Kageyana/robotrace_v2/doc/path-yaw-feedforward-hardware.md

# 制御版20・旋回FF版2の実機反映

検証済みFF2を書込み、全254564Bを読み戻して凍結ELFと一致確認した。ELFのSHA256は`4c9a376ca9f8788f30481bd3117974df9bbea6451c0957483be44c477bb11c31`。初実走13896と追加の同一一次10走で板外逸脱なしをユーザーが確認した。一方、別一次13897の13898では実際の逸脱があり、原因と対処の物理的効果は未確定で、コースアウト防止の目標完了とはしていない。

最初の起動ではSD0・バッテリーAD180/無効電圧だった。ユーザーのSD挿入・バッテリー電源確認・再起動後に、再書込みせず次を確認した。

- IMU/SD初期化成功、バッテリー7.620595V（AD1944、有効）。
- pattern/start/auto/log/PWM/負荷/IPSR0、TIM2比較出力0、PRIMASK/CFSR/HFSR0。
- TIM6/TIM3/ADC1/ADC2の実優先度48/16/32/32（格納値）。
- 13894の記録設定22項目と一致。直線3.4m/s・加減速20m/s²、先読み40+20v、横/方位ゲイン10/20、位置係数5・追加方位勾配0。
- デバッガ解除・所有サーバー終了。実機へのモーター指令注入とGDB関数直接呼出しは行っていない。

証跡は`build/path-yaw-ff-validation/validation.json`と`boot-20261028T220420Z/hardware_validation.json`。初回の無効電源/SD状態は`boot-20261028T220150Z`へ別に保持した。フォルダ時刻はUTC。

初回はST-Linkを外し、同じ設定で新しい一次走行からPATH_CURVEの動画とログを取得する手順とした。今後の反復も走行後は電源・リセットを保持して停止後にST-Linkへ再接続し、RAMを回収する。カーブ出口の板外張出し、過渡横偏差、周回ずれ、新FFの飽和とIRQ/ADC周期を確認する。撮影高さは直近740mmだが、次の動画も実際の高さを確認して解析する。初回だけで採用や増速を判断しない。

## 初実走13896の確認（初回時点の記録）

一次13895・動画VID_20261029_071042_00_002、高さ740mm。走行後の全Flash/RAM、全CRC・全CSV再変換、RAM/SD終了メタデータの全項目を照合した。ユーザーの実機観察は「はみ出さず完走した」。動画は左カーブ出口の板端でぼけ・小さい余裕があるため、独立動画での断定とユーザー申告を分けて保持している。

最大記録横偏差25.345→17.515mm、5通過の相対Y変位は最終2.775mm（途中最大7.059mm）。PATH_CURVE12777周期、IRQ最大664.833µs、1ms超過0、取得間隔最大1ms、鮮度切れ/スキップ/ADCエラー0。取得/制御設定は前回と一致するが、別一次・低い走行電圧を伴う1走であり、効果の因果や再現性は未確認。5周を5本へ数えず、変更後のPATH_CURVEは1本、反復確認はあと9本以上とする。

詳細は[解析報告](../analysis/path_yaw_ff_20261029_071042/report.md)と同フォルダのvalidation.json。FF2の現設定を維持し、増速・ゲイン追加変更は行わない。走行後RAMを回収してGDB解除・所有サーバー終了まで確認済み。今回は再書込みとSD設定変更を行っていない。

## 追加10走と別一次の逸脱13898

一次13900の13901～13910は全10走通常終了し、ユーザーも全10走はみ出さず完走と確認した。走行時間12.896～12.925秒、最大記録横偏差16.523～18.390mm。依頼した10走の収集は満たしており、未変更の版20へさらに9本を求める状態ではない。700mmで再校正した9対応動画の最終相対Y変位は1.998～6.216mm、途中を含む最大は13.604mm。002～009は13901～13908、011は13910、13909は動画なし、010はユーザー確認済みの別記録として除外した。

リセットなしRAM/全Flash照合は版20/FF2と一致。今回の累積PATH_CURVE129111周期は更新間隔最大1ms・鮮度切れ/ADCエラー0、IRQ最大669.589µs・1ms超過0。ただしこのRAMを以前の13898へ帰属させない。13898は一次13897を使い、8.085秒で未照合150ms・停止7となり、ユーザーは板外逸脱を確認した。動画はない。未照合初期に保存速度目標が1.50→2.31m/sへ増えた事実と、その加速を保留するPC専用12走比較を保持した。対処の物理的効果は未検証で、SD設定・実機像はこの解析中に変更していない。

全14ログのCRC/全CSV/56列、24凍結再生、動画レビューと申告、PC候補の制限は[追加解析報告](../analysis/path_yaw_ff_20261029_repeat9/report.md)とvalidation.jsonに保存した。失敗13898を成功10走から除いて解決扱いにせず、未照合中の再加速を抑える次版を検証する。
