Kageyana/robotrace_v2/analysis/imu_init_runs_12895_12897/report.md

# BMI088初期化修正後の12895～12897

3本ともCW、目標0.5 m/sの一次走行、正常終了。buildTime=21:59:39。校正100サンプル、読出しエラー0、温度異常行0。加速度Z平均0.986～0.996 g。修正済みコードの初期化成功にはIDと設定読戻し照合が必要だが、レジスタの実値や走行中SPIエラー数はログにない。

|ログ|実速度平均[m/s]|Xずれ[mm/周]|Yずれ[mm/周]|閉路残差平均[mm]|IMUとラインの旋回角差[deg/周]|
|---|---:|---:|---:|---:|---:|
|12895|0.420|−4.57|−2.93|6.68|+0.065|
|12896|0.411|−2.76|−1.99|6.87|+0.196|
|12897|0.406|−2.46|−2.45|6.65|+0.098|

6回の独立したラインCROSS検出から、5つの完全な周回区間を比較した。左右累積エンコーダ平均の距離と保存済みimuAngle_Zの中点方位でXYを再構成。各区間の開始点へ座標をリセットせず、累積した位置のずれを示す。旋回角差はラインの通過姿勢変化を差し引いた値であり、真の方位誤差そのものとは断定できない。

SPI速度のみ修正した0.5 m/s走行12891・12894はX平均−3.76 mm/周、閉路残差7.13 mm。今回3本のX平均−3.26 mm/周、閉路残差6.74 mmで、推定ずれは残る。バッテリーも前回7.42～7.49 Vから今回8.20～8.32 Vに変化しており、初期化修正の改善効果は分離できない。

## ログ時刻の折り返しと距離検証

cntlogはlog_schema.hでU16として保存され、65.536秒で折り返す。今回の終了時刻は折り返し補正後65.671、67.185、68.030秒。各1回の折り返しを確認した。解析スクリプトは明示的に65536 msを加算し、補正後の時刻と距離間隔を確認した。生ログは変更していない。

SDcard.c endLog()のcorrectedPulseTotal += correctedPulse * (time - beforeTime)は折り返し時に負の時間差を使う。生ログから再計算した距離検証誤差はメタデータと完全一致する。

|ログ|元の検証誤差[pulse]|時間差を折り返し補正した検証誤差[pulse]|
|---|---:|---:|
|12895|1636020|−2380|
|12896|1503990|−3338|
|12897|1502976|−4352|

補正後誤差は距離の0.15～0.27%で、現行5%許容内。元ログはdistanceScaleVerified=0、closureReason=10で経路元として無効。これはタイヤの距離換算係数の異常を示す結果ではない。XY再構成は累積距離と方位を使うため、この時刻折り返しから独立して評価できる。各ログの距離間隔は4.55～5.45 mm、期待行数一致、全必要値有限、入力SHA256不変。

ファームウェアは今回変更していない。時刻保存の32bit化または全利用箇所の折り返し対応が次の修正対象。走行中の通信成功率・割り込み処理時間、実位置の正解は未測定。

再実行: `python analysis/script/check_imu_init_runs_12895_12897.py`。詳細はper_log.csv、lap_intervals.csv、validation.json、courses.png。
