Kageyana/robotrace_v2/doc/path-confidence-fusion.md

# 白線観測による自己位置補正と信頼度（経路制御版19）

2026-10-27。PATH_CURVEの周回ずれを抑えるための検証実装。変更後の実走行の完走性・制動距離・位置精度は未確認。

## 位置観測と走行地図

左右生エンコーダとジャイロによる1 msの位置伝播を維持する。PATH_CURVEでは、一次走行の車軸付近のXY経路と、前方のラインセンサーが実際に観測した白線位置を分ける。一次の10素子値から背景400を除いた重心を計算し、800以上の明部が1群・幅1～4個・重み合計1200以上の場合だけ、一次の保存方位・位置と素子座標で白線観測点を生成する。一次で白線が不明瞭な点を有効な観測で補完しない。

車軸経路点から20 mm以内の最も近い一次観測を保持する。白線対応は車軸の最近傍位相を基準に後方2点・前方4点に限定し、方位差60 deg以内、白線残差30 mm以内を受理する。車軸経路自体を前方白線の地図とみなすと、小Rカーブで正常な白線にも大きな残差が生じることを実制御の再生で確認した。

一次のCROSS間に300～420 degの旋回があり、間隔2～8個、周期1～10 m、中央値からの差5%以内なら周回周期を決める。一次の1周目だけを使い、50 mm以内の並進閉じずれを弧長へ分配した同じ地図を各周へ繰り返す。車軸経路と白線観測地図に同じ変換を適用する。周期が検証できない一次では元の非周期経路・白線観測を使い、マーカー補正を無効にする。周期は開始時に固定し`pathLoopPeriod_mm`へ保存する。変換に失敗した経路は開始しない。

走行中は白線地図への法線残差を、位置・方位・残留ジャイロずれの4状態の共分散で扱う。位置補正gainを観測方向へ投影し、白線の相関だけで進行位相を動かさない。方位は直接更新せず、推定したずれを次のジャイロ伝播から引く（上限±5 deg/s）。白線・マーカーを合わせた位置補正は毎1 msに0.2 mmまでに制限し、gainの制限を共分散にも反映する。白線分散は5ms基準25/(品質×lineAlpha/5) mm²を1msの観測頻度へ換算して5倍とする。移動距離に対応する伝播分散も同じ5ms基準へ合わせる。従来PATH/SHORTCUTの係数の意味を維持し、PATH_CURVEではlineAlpha=5を基準強度1、0を無効として使用する。スリップ残差は相関した独立位置観測として重ねず、最大リスクの品質重みとして用いる。スリップ診断無効時の重みは0.25。方位補正は既存SD係数を使用し毎回±0.02 degまでとする。係数0は無効のままであり、SDの有効値をコードの既定値で上書きしない。

マーカーは種類、経路点差±8点、方位差±20 deg、接線残差150 mm以内が一致する新規イベントだけ採用する。接線方向の位置観測分散100 mm²で融合し、マーカーではジャイロずれを更新しない。1イベントでも0.2 mm/1 msの合計上限を守る。CROSSを無条件に周回や原点とみなさない。

## 白線未観測と自己位置の信頼度

PATH/SHORTCUT/PATH_CURVEは、新鮮な明部の存在と有効な地図照合を独立に監視する。取得電源ON・更新件数非ゼロ・取得後3 ms未満の値だけを新鮮とする。

|状態|減速の条件（どちらか）|自己位置喪失の条件（どちらか）|
|---|---|---|
|新鮮な800以上の明部なし|20 ms / 40 mm|60 ms / 120 mm|
|有効な白線地図照合なし|60 ms / 120 mm|150 ms / 300 mm|

信頼度0～1000は、上記の停止閾値に対する未観測時間・距離の最大割合から求める運用上の指標であり、正解位置に対する確率や誤差上限ではない。古い明部の保持では回復しない。有効な白線照合が100 ms連続してから通常速度へ復帰する。喪失は走行リセットまで保持する。

減速時の速度上限は1.0 m/sとSDのsearchの低い方とし、SDの加減速度（最大20 m/s²）で目標を変える。減速度0の場合も信頼度低下時は20 m/s²で減速する。曲率FFも減速後の目標速度へ合わせる。照合不成立中に単一白線が見える場合は既存ライン追従へ退避する。喪失時は目標速度・角速度0、既存の`STOP_LOCALIZATION`（emcStop=7）を要求する。

全10素子100未満20 msの完全逸脱停止（emcStop=5）は継続する。20/60/150 msは判定時間で、物理的な停止完了時間ではない。

## 記録と資源

`routeControllerVersion=19`、`pathObservationPolicyVersion=1`、`pathWhiteMapVersion=1`。既存`pathState`へ5（注意・減速）を追加する。2（ライン退避）、3（再合流）でも注意による速度制限が有効な場合がある。0～4の意味は維持する。ログ列・レコード長・CRC契約は変更しない。終端の信頼度と照合経過時間を`pathConfidenceAtEnd`、`pathObservationAgeAtEnd_ms`へ保存する。1 msごとの信頼度履歴・センサー更新時刻はログへ追加していない。

白線観測点と128個のマーカーをPATH側の静的unionへ追加し、既存DISTANCE側より小さいことをstatic assertする。共有RAM総量を増やさず、動的確保を使わない。経路生成は停止中・非記録中・FatFsロック下、制御中は固定長の算術のみとする。地図種別をキャッシュキーに含め、周期化した地図が従来PATHへ流用されないことを確認する。

## 解析と検証の区別

一次13809と動画対応のPATH_CURVE13810～13816を使用し、通常56列全部と詳細時だけの6列を棚卸しした。実際に記録されていない6列を推定して融合しない。9要素のON/OFF全512通り×CF/PI/EKF×抽出3種類×補正強度3段階×地図2種類＝27,648候補を比較する。有限の定義済み候補の全組み合わせであり、任意の推定方式・実数ゲインすべての網羅ではない。

初回モデルの固定候補では映像との相対Y誤差が減ったが、実制御へ移す際に車軸と白線の地図の混同を検出した。旧結果を保全し、白線観測地図に修正した第2版でも全候補を再計算する。第2版の確認用ログは既に結果を参照した系列の再利用であり、新しい未見データではない。解析原本・全候補・監査は`analysis/path_fusion_13810_13816/`、再計算は`white_revision/`へ置く。

`validation/path_observation/run.py`と`validation/path_fusion/run.py`はO0/O2・厳密警告で境界・欠測・補正上限・周期変換を検証する。`validation/log_storage/run.py --converter C:/tool/AutoCopyCsvFromSd/RlogToCsv.exe`は実コードの状態遷移と両保存形式・CRC・PC変換を検証する。原本binの実生成と再生では1 msの入力が未保存のため、保存区間のパルス・積算角度と保持センサー値から再構成した。これは移植と停止条件の感度検証であり、実機の閉ループ挙動を再現するものではない。

位置補正を制御へ入れた同条件10走以上、動画との対応、最初の実ログの版・設定・参照・停止理由、最長TIM6時間とADC更新欠落を確認してから採否を判断する。

### 第2版の完了結果

修正した白線観測地図でも27,648候補×7本の全193,536組を完了し、非有限値・欠落・重複キーなし。最良ID26601の確認用4本の相対Y RMSEは10.3/9.1/15.6/10.5 mm（補正なし52.6/72.7/64.9/66.7 mm）。ただし診断用車輪Yaw換算などを含み、そのまま実機へ採用していない。可搬な観測だけに限定した候補ID24808（EKF、白線位置・bias・マーカー・スリップ品質、背景400、強度1）を実機用の出発点とした。位置補正0.2mm/1ms・観測方向制限・時間換算・実際の最近傍選択がPC比較と異なるため、同じRMSEを実機用へ転記しない。

PC比較は保存済みoptimalIndexを対応探索の種に使う条件付き診断であり、推定器単独の進行位相を保証しない。実制御では独立に最近傍を選び、白線では法線、マーカーでは接線の観測方向へ補正を制限する。1ms再生では全7本の初期カーブを通過し、その後の未観測・照合不成立で停止する。保存操舵を変更しないため、実際の減速後の完走性は検証していない。

既知の±0.2deg/sのジャイロずれと左右旋回を与えた20秒の合成試験では、補正なし約222～241mmに対して位置誤差約11～22mm。推定biasの絶対誤差は約0.079～0.111deg/s残り、当初の0.1deg/s以内という探索的な期待は全件で満たさなかった。この期待を満たしたとせず、位置誤差減少・符号・有限性・上限の検証と、bias自体の精度を分けて記録する。白線のみから真の方位やbiasを厳密に確定したとは扱わない。

pathFusionEstimator=2とpathGyroBiasAtEnd_dps（温度補正後の追加推定ずれ）をメタデータへ保存する。既存のCSV x/yとimuAngle_Zは従来の生エンコーダ・IMUによる再構成のままで、融合後の機体位置そのものではない。新しいpathError/State/操舵診断と動画も併せて評価する。

## 最終ビルド・静止実機確認

Debug/Release/DebugMarkerの全体ビルドと通常・詳細の実ログ保存/CRC/PC変換が成功。既存全体ログとの診断比較で新規warning 0。DebugはRAM79528 B・Flash249152 B、ReleaseはRAM79080 B・Flash163956 B。スタック8 KiBの予約を維持する。

最終Debug ELFのSHA256は280294a6b8eda3cb075d68a4bd87dafff0af273f13f55f45b66e02e8143b1771。Device ID0x421、100kHz・Under Resetで書込み、照合、リセット、起動に成功した。初回は60秒打切り後USB通信エラーがあり、ユーザーのUSB挿し直し後にFlash全248792 Bの一致を読出しで確認した。その後の最終版はダウンロード約40.2秒・照合約31.2秒で正常終了した。

最終版で通常LOG処理を実行し、実SDの一次13829から1181点・周期4758.218750mm・マーカー33個を生成。白線観測の有効点1156/1181。GDBで開始要求0・autoStart0・patternTrace0・PWM/CCR左右0を確認した。純算術の20ms注意・60ms未観測喪失・150ms照合不能喪失と0.2mmの補正上限を確認し、注入値・割込み状態を復元した。

停止中の実経路更新（位置伝播を除く）をDWTで測った1例は21902cycles、180MHzで約122µs。予測11829cycles・補正5607cyclesの単体測定も実施した。デバッガ呼出しの影響を含む単発の静止測定であり、TIM6全体の走行中最大時間を保証しない。3ms経過した白線を無効にし、位置補正0・未観測カウンタ増加を確認した。実ADCの更新count415・age1ms・stale0も観測した（最大age3msはデバッガ停止の影響を分離していない）。最後はマスク0、開始要求0、autoStart0、PWM/CCR左右0、CFSR/HFSR0でdetachし、自分のGDBサーバーを終了した。

開始時設定固定の関数が実制御から呼ばれていなかったため、control.cの走行開始処理でSD有無に関係なく、initLogより前に呼び出すよう接続した。これにより実機の周期メタデータと制御係数を同じ開始状態へ固定する。

実SDには位置補正100・方位補正0が保存されていた。今回の試験用はRAMを位置補正5・方位補正0へ変更し、SDはデバッガから直接書き換えていない。通常の手動走行/自動1走目前に保存される。保存前に電源を切るとSD値100へ戻るので、再起動後はNo.8 ShortcutのLine alphaを画面表示0.005（内部・SD・ログ値5）へ設定し直す。速度表は変更していない（実機の直線設定は3.4m/s）。初回の実走行は低速で確認し、その後に同条件10走の比較を行う。元の高速設定での完走保証・停止距離保証はしていない。

最初の新しい実ログの版19/推定器2、設定5/0、一次参照、周期、emcStop、pathStateと動画の照合が残る。静止検証とコースアウト抑制の採否を区別する。証跡はbuild/path-fusion-stlink/final_validation.json、flash.log、route.log、fullpath.log、analysis/path_fusion_13810_13816/white_revision/report.md。

## 2026-10-27の実走13843～13846

動画VID_20261027_215718_00_002から005を指定順に照合し、旋回タイミングの相関でも全4本の対応を確認。レンズ高さ700mm・床配置据置はユーザー確認済み。一次13842を含む原本bin6本の全CRC・行数・長さ・CSVメタデータ一致と、原本SHAの前後一致を確認した。実機接続・ファーム書込み・SD書換えはこの解析では行っていない。

全4本が版19・推定器2・一次13842・位置補正100（画面0.100）・方位補正0であり、試験候補5（画面0.005）の実走評価ではない。9.458～10.020秒でemcStop7、終端信頼度0・未照合123～148ms。終端未照合期間の生距離は301～303mm、白線明部は残る。実コード再生も補正100で300mm未照合停止にほぼ一致するが、保存されない全1ms入力と鮮度を仮定するため実機の個別判定そのものとは区別する。補正5では記録範囲内でこの停止はない。保存済み運動を固定した感度であり、閉ループ完走の証明ではない。

固定床X400mm・同方向4通過の初回からの外形中心概算Y変位は6.4/14.5/15.7/16.3mm。生XYは逆向きで、保存経路偏差による法線投影の派生値も進行方向位置を欠き、完全な融合自己位置ではない。全16通過と停止前後16枚の原フレームを目視した。13846は白線から板内側へ外れ、ログ終端相当位置から0.6秒後の外形中心変位が約394mm残る。厳密な車軸制動距離・通電状態は未測定。撮影窓内で板外への逸脱は確認していない。

次の比較ではNo.8 ShortcutのLine alphaを表示0.005、Line theta gainを0とし、他の条件は同時変更しない。従来の「5」は内部値だったため表示単位を訂正した。初回ログで保存値5を確認してから同条件の本数を増やす。途中停止4本を成功10本へ数えず、停止閾値は緩和しない。校正と図の再発防止は2026-10-17-video-color-marker-identity.mdの10/27節へ記録。証跡はanalysis/path_fusion_13843_13846/report.mdとvalidation.json。

### 停止要求とモーター出力の時刻は別

追加のコード監査では、TIM6がemcStopを設定する一方、実際の出力はメインloopSystemとemergencyStopで行うことを確認した。emergencyStopは速度目標0、平均エンコーダが5pulse/msを超える間は速度PIDのみの出力、その後ゼロ出力という順序である。走行中のメインループはlogWriteTask→writeLogPuts→f_writeも実行し、SD_WaitReadyには1呼出し500msの待機上限がある。停止要求からメイン処理へ戻るまでの実遅延は今回の記録にはない。500msを実際の待機時間、全停止処理の上限、13846の原因とはしない。

検出・速度目標・PID計算・PWM反映・機体の停止完了を別々の時刻として確認する必要がある。既存ログは減速完了後までの指令履歴を保存せず、終端からの映像移動だけでは通電状態も判断できない。今後の時間検証では停止要求時刻と初回制動/ゼロ出力時刻、停止完了までの左右速度、SD待機、TIM6全体時間を同じ時間基準で測る。停止閾値の緩和や、原因未確定の出力処理変更はこの監査では行っていない。ソースSHA・参照位置・確認済み事項と未確認事項はanalysis/path_fusion_13843_13846/stop_output_audit.jsonへ保存する。

## 同日22時32分以降：候補5の実走13848～13849

動画VID_20261027_223239_00_002と223315_00_003、一次13847を含む原本bin3本・CSV3本を照合した。全CRC・行数・長さ・メタデータ一致、動画2本を含む原本SHAの前後一致を確認。動画は直前のユーザー確認に基づく高さ700mmと同じ床点配置で独立校正し、fit最大4.97mm・留保最大5.67mm。全編追跡し、10直線通過・停止前後8枚・全周代表34枚を原フレームで目視した。13849の2追跡点は床確認誤差3mm超過として棄却し、通過点へ使っていない。

版19・推定器2、Line alpha表示0.005（保存5）・Line theta gain0、直線3.4m/s。2本とも設定経路のゴール後に停止し、板外逸脱は確認しなかった。emcStop0、記録時間12.717/12.706秒、同方向直線5通過の初回→5回目の外形重心概算Y変位は+8.9/+7.2mm。測定線X350/400/450mmの感度でも約6.4～8.9mmであり、以前の補正0系列の約54～85mmより小さい。ただし一次13842→13847に加え、減速度acceleDも8.10→15.00m/s²へ変わっている。補正単独の効果・異なる減速度への一般化とはしない。今回は補正5・減速度15の組合せの2/2完走として数える。

終端信頼度395/394、未照合58/58ms、追加bias-0.812394/-0.755605deg/s。最後の19msがCAUTIONで、照合の低下は残る。白線明部は全保存行で観測されており、白線存在だけを位置信頼度としない。既存生XYは逆方向へ約167/138mm変化する一方、完全な融合位置ではない法線投影は約+5.3/+5.1mm。CSVのXYを制御中自己位置へ読み替えない。

実コード再生では補正5で両走とも記録末尾まで喪失なし、終端biasは実機値と約0.011/0.013deg/sの差。補正0/25/100は同じ記録運動の途中で照合不能となるが、別設定の実走結果の予測とはしない。全56列の監査・状態遷移・メタデータ差分・感度と制約をanalysis/path_fusion_13848_13849/report.mdとvalidation.jsonへ保存した。

今回の通常ゴール後の外形移動は最終走行行から0.6秒まで約277/272mmで、板上に停止した。緊急停止の制動試験ではなく、停止要求→出力の遅延・厳密な車軸制動距離・走行中全TIM6最大時間は未検証のまま。解析中のファーム・SD設定・実機接続は変更していない。次は補正表示0.005・方位0・減速度15.00、その他も同条件で8本以上追加して再現性を確認する。一次変更は別条件として保存する。2本の完走を最終採用・目標完了へ置き換えない。

## 同日23時01分以降：13853～13861、13854は未確定tmp

動画002～010の9本を確認。確定ログ13853と13855～13861の8本は、版19・推定器2、一次13852、補正5・方位0・減速度15・直線3.4m/s。速度表・Shortcut・PID/FFのメタデータは前回13848と一致し、正常ゴールと板上停止を動画でも確認した。初回→5回目の固定床Y変位は概算11.3/10.9/9.0/5.4/7.3/2.7/5.9/4.3mm。13854も動画で5回通過後に板上で停止しているが、終了理由・設定は確定できない。保存失敗を正常保存や正常ゴールへ置換していない。

前回2本と今回8本で補正5・減速度15の正常ログによる完走確認は計10本となった。ただし一次13847の2本と13852の8本、停止保持ビルドの違いを分けて記録し、同一一次10本や補正単独効果とはしない。終了信頼度394～407、未照合57～58msでゴール付近の照合低下は残る。今回8本×0/5/25/100の実コード再生32条件でも、5はすべて記録末尾まで自己位置喪失なし。保存運動固定の感度であり、実走予測ではない。

13854.tmpは2MiB・ゼロヘッダで、内部に過去13599ヘッダと13849の全CRC合格コンテナが残る。隣接一次13852の形式を仮定し、保守的な512B境界除外後の984行・2.703秒を診断用に抽出した。元CRC・期待件数・メタデータは未記録で、完全復旧はしていない。保存53列の再パックが元バイトと一致することだけを検証。元tmpは保全し、部分物はpartial/へ隔離した。保存失敗の原因は未確定で、再発時は次走・再起動前にwriter/FatFs/SPI状態の採取が必要。

停止保持のソースは速度0検出後2秒の速度PID継続版で、現在Debug ELFと確定ログのビルド時刻22:58:50は一致するが、Flash照合・保持中の実指令は未検証。動画では大きな停止後再移動は見られず、13861は長く撮影されているが、多くは最終走行行から約1.1～1.8秒で終わる。既存ログは停止保持中のPWM/電流を保存しないため、実出力2秒継続を映像だけで検証済みとしない。

全9bin（一次含む）のCRC/行数/実長/CSV一致、全原本SHA、9動画の復号・追跡、床点9枚・直線45枚・停止45枚・全周代表73枚を検証した。fit最大5.01mm・留保最大6.13mm、前回確認の高さ700mmを使用。証跡はanalysis/path_fusion_13853_13861/report.md、validation.json。今回の解析ではファーム・SD設定・実機操作を変更していない。保存再現性、実停止出力、全TIM6時間・ADC欠落、別条件への一般化は残る。

## 追加13862～13867と2026-10-28の計測準備

追加6本の元binを全CRC・長さ・CSV一致まで検証した。13864/13866についてユーザーは動画なしと明示。一次13862・補正5のPATH_CURVEでは、直線3.6/減速度20の同一速度表で13864が自己位置喪失停止7、13866は停止なしとなった。直線以外も曲率別12項目を13863より増やした設定であり、高速条件の再現性は未確立。13864ではライン退避・約1m/sへの減速と、終端の未照合150ms・信頼度0を確認。実コード再生も停止時刻10.997秒・未照合距離243.524mmで一致したが、1ms鮮度等の仮定を含む。13863/13867は直線3.4/減速度20で停止なし。13867の曲率速度表は13863とも異なる。動画付き完走確認10本の集計へ追加しない。詳細はanalysis/path_fusion_13853_13861/additional/report.md。

停止・接続済みのユーザー確認後、リセットなしで実機RAM128KiBとFlash249304Bを保存。保存済み停止保持版ELFのSHA976a866b…由来binaryと全バイト一致した。これにより書込み直前の像は確認できたが、過去走行時の像や実出力2秒継続を直接測定したものではない。開始要求・PWM/CCR・PRIMASK・Faultは0。writer失敗フラグ0は13854の原因否定には使用しない。

既存ROBOTRACE_ISR_TIMING=ONを独立構成でビルドしたSHA6cfddb68…の計測版を、Device ID0x421へ100kHzで書込み、照合・起動まで成功。通常setupでIMU/SD初期化成功、開始要求0、PWM/CCR左右0、PRIMASK0、Fault0を確認しdetach、所有サーバーを終了した。通常Debugの計測OFFは維持。実走行はしていない。

計測範囲はInterrupt1msのDWTリセット後から最後の読取までの主要区間で、HAL/IRQ前後・初期前処理・集計を含む全TIM6時間ではない。走行サンプルは全モード0件、ラインセンサー電源OFFで更新0件。バッテリーADC182、電圧有効フラグfalseで走行電圧を確認できていない。RAMの速度表は直線3.4/減速度20で、以前の動画確認群と異なる。設定注入はしていない。実走後に電源・リセットを保ってRAM採取が必要。証跡はbuild/path-timing-validation/hardware_validation.jsonとreport.md。

## 2026-10-28：再接続後の実走統計

再接続のユーザー連絡後、リセット・書込み・注入なしでRAM128KiBとFlash249640Bを保全。計測版ELF由来binaryとFlash全バイト一致。取得時の左右CCR/PWM0、PRIMASK0、CFSR/HFSR0を確認してdetach、所有サーバーを終了した。

一次の集計22,660回は平均172.454µs・最大238.306µs、PATH_CURVE12,798回は平均381.905µs・最大501.061µs、計測区間の1ms超過はともに0回。対象は前節の主要区間であり、全TIM6時間の証明には拡張しない。他方式は0件で未測定。

白線更新19,428回、最大age6ms、StaleCount0、ADC取得要求の棄却66,409、HAL開始/転送エラー・Fault0。棄却は位相・取得窓・占有などによる要求数で、失った制御周期数や白線の完全消失回数ではない。最大ageと棄却は起動後の校正/一次/PATHを分けておらず、6msがPATH中かは不明。StaleCountの操舵使用条件があるため、0でPATH鮮度正常とはしない。既存の位置補正ゲートはage3ms以上を除外する。現在の長時間haltから再開する前のRAMを保存したため、今回detach後の影響は元スナップショットへ含めていない。

最終RAMはログ13870・一次13869、版19/推定器2、補正5/方位0、直線3.4・減速度20、周期4761.213mm。終端信頼度403・未照合57ms・追加bias-0.500444deg/s・emcStop0、終了画面pattern103。保存エラー取得値0、取得時バッテリー7.624V。RAM残留メタデータは回収できたが、SD実ログ全データ/CRC・物理完走・周回変位・停止保持中の2秒実出力は未検証。ログ13869/13870と実走結果・動画を照合する。証跡はbuild/path-timing-validation/after-run-20261028T094441Z/report.md、validation.json。

その後、13870についてユーザーから「完走しました 動画なしです」と直接確認を受けた。コースアウトせず完走したユーザー確認として記録し、未確認としていた物理完走情報を更新する。周回Y変位や停止出力の動画計測はなく、従来の動画付き10本と今回のユーザー確認1本を区別する。SDの13869/13870はまだPCへ取り込まれておらず、全CRC・走行中状態推移の照合は残る。回答原文は同証跡フォルダのuser_confirmation.json。

### 13869/13870取込み後の照合完了

同日19時02分台にPC取込みを確認し、元bin2本の全CRC・実長・4679/4728行・再変換CSV全56列とRAM残留メタデータの一致を検証した。13870は12.797秒、TRACKING12.779秒・CAUTION0.018秒、LINE_FALLBACK/REJOINなし。全保存行に明部800以上がある。終端信頼度403・未照合57ms・bias-0.500444deg/sはRAMと一致。元データと実測処理時間の対応を確定した。CSVの距離基準記録の最大間隔6msと、RAMのセンサー更新age6msを同じ欠測と扱わない。

今回の速度表/PID/Shortcutは13867と一致し、過去動画群13853からは減速度15→20と曲率速度3項目が異なる。実速度最大3.395m/s、走行中平均電圧7.455V・最低7.183V。全56列の範囲/有限性を監査し、原本bin/CSVのSHAを保持した。

実ソースを専用ホスト実行ファイルへ新規ビルドして今回の一次13869で再生した。補正5は末尾まで喪失なし、未照合57ms、上限200µm/1ms。bias-0.590998deg/sは実機との差約0.090554deg/sを残す。補正0/25/100の感度では途中喪失するが、保存運動・保持センサー・平均角速度と仮定した鮮度による結果で、別設定の物理走行予測や補正5の最適性証明には使わない。

ユーザー完走確認1本として追加記録し、動画付き10本の物理Y計測とは分ける。今回の原始XYのCROSS間Y変化約-212.9mmは融合後の位置でも実物のズレでもない。全TIM6時間・ADC最大ageの発生区間・2秒実出力は引き続き未確定。解析では実機接続・ファーム・SD設定変更なし。証跡はanalysis/path_fusion_13869_13870/report.md、validation.json。RAM側のsd_log_followup.jsonからも関連付けた。

## 追加計測の準備：HAL区間とモード別白線更新

既存の計測ON時だけ、TIM6入口/出口フック、連続DWTによる経過時間、モード別の白線更新age/間隔分布/棄却差分を追加した。計測OFFの対象4モジュールは変更前と全命令・参照先が一致。通常3構成と独立計測ONのビルド、実関数O0/O2の時刻周回・モード/電源境界・飽和試験が成功し、新規warning0。計測ONのRAM80376B・Flash250588B、スタック8KiBを維持する。

ST-Link本体は検出したが、MCUはNo device found on targetで接続できず、追加版は未書込み。機体電源/SWDと停止接続状態の連絡を待つ。既存の実測と追加計測のビルド結果を混ぜず、実走IRQ時間・6msのモード別発生区間は未検証のままとする。計測区間にも出口統計・CPU例外入出は含まれない。詳細は[追加計測](path-isr-diagnostics.md)、証跡はbuild/isr-interval-validation/validation.json。

### 追加版の書込み・通常起動確認

ユーザーの停止・電源/接続確認後、リセットなしで旧計測版Flash/RAMを保全し、旧ELFと全バイト一致・開始要求/ログ非記録/PWM0を確認した。追加版SHA0ae5b57a…をDevice ID0x421へ書込み・照合・起動まで成功。setupでIMU初期化成功、pattern/start/autoStart0、PWM/CCR左右0、PRIMASK/CFSR/HFSR0を確認してdetach、所有サーバーを終了した。

取得時のSD初期化とバッテリー電圧有効フラグはfalse。走行前にSDと機体バッテリーで通常起動する必要がある。主要/IRQ時間と白線の走行モード別区分は全て0件で、追加版の実走結果はまだない。停止中区分6の標本20590を走行データへ混ぜない。設定値の注入は行っていない。証跡はbuild/isr-interval-validation/hardware_validation.json、pre-flash-20261028T104701Z/。次はST-Linkを外した一次→PATH_CURVE各1走後、電源・リセットを保ってRAMを採取する。

## 2026-10-28夜：13872～13875の動画確認とRAM消失

一次13871からのPATH_CURVE4本を動画002～005の申告順で照合した。同じ速度表/PID/FF/Shortcut、補正5/1000・方位0・直線3.4m/s・減速度20m/s²。13872/13874/13875は正常終了し、固定床X400mmで初回→5回目の外形中心Y変位は約6.63/8.90/10.90mm。13873は2.931s、約1周後の次の左下コーナーで逸脱しemcStop7、停止時に機体の一部が板左端を越えた。コースアウト防止は未達で、過去の成功10本へ今回の失敗を隠して集計しない。

13873の最後の保存明部800以上は2.873sの右端sensor9。その後58ms・車輪換算約80.1mm、終了noMatch67ms/信頼度0。全10個100未満にはならず、emcStop5ではない。新鮮な明部なし60msと整合するが、1ms状態は未保存。実ソース16条件再生の補正5ではnoLine58msで停止を再現せず、鮮度有効などの再生仮定が残る。原因をADCに断定せず、停止閾値も変更しない。

ユーザーから走行後に電源を切った/リセットしたと回答があり、追加IRQ/ADC計測のRAMは取得不可。保存ログから今回のIRQ時間を復元したり、起動時の0件を実走結果へ転用したりしない。全5binの全CRC/再変換CSV全セル/全56列と原本SHA、4動画の個別床校正、採用16通過・停止前後20・全周代表/不合格35フレームを確認した。撮影高さ700mmは直近条件の仮定で、今回未再確認。正常3本の同期は類似し番号の一意同定はできず、申告順を保持した。

解析のみで実機接続・ファーム/SD設定変更なし。次の計測は走行後の電源/リセットを保って停止接続し、全IRQ区間とモード別ADC鮮度/欠落を回収する。診断の電源断耐性は未実装。詳細はanalysis/path_fusion_13872_13875/report.md・validation.json。

## 2026-10-28 20:30走行：RAM回収と取得鮮度の問題

一次13876とPATH_CURVE13877/13878を全CRCで検証し、ユーザー指定動画203011_00_003＝13878を独立に確認した。走行後RAM/Flashをリセットなしで回収し、計測版0ae5b57a…全Flash一致・SD13878との保持メタデータ全一致を確認。IRQ区間PATH累積40,134標本、最大502.09µs、1ms超過0、次tick保留0。一方、白線更新は最大6ms、鮮度3ms以上23.94%。一次では最大2ms・鮮度切れ0で、6msがPATH走行中に発生したことを初めて区分できた。各走行や停止直前の1ms履歴へは分解できない。

13877/13878とも設定は直前と同じだが一次を取り直している。約4.3/3.2sから減速が継続し、19.691/20.437sに照合なし150msで自己位置喪失停止。13878は約1周後に機体の一部が左端を越え、その後復帰し板上で停止した。固定床X400mmの初回→5回目Y変位は約-8.2mm（X350/450感度-11.6/-4.5mm）。大半が約1m/sで、早期の張出しもあるため高速安定化や完走には数えない。

実関数のO0/O2試験で、3ms新鮮/1ms鮮度切れの繰返しは100ms連続の回復を妨げることを確認した。鮮度有効を仮定する実ソース再生では長時間CAUTIONを再現せず、終端は未照合149/147msと近いが完全一致しない。優先度0のTIM6がTIM3/ADCを阻害して取得窓を失効させる構造は原因候補で、棄却理由別の実測は未了。今回ファーム/設定変更なし。詳細はanalysis/path_fusion_13876_13878/report.md、未解決事例はdoc/失敗事例/2026-10-28-path-sensor-cadence-prevents-recovery.md。

## 取得競合の修正を実装・書込みし静止比較で確認

取得版2としてTIM6の運転時優先度3と、制御中の公開センサーフレーム固定/末尾公開を実装した。平均化・光学タイミング・鮮度3ms・停止/回復条件・PID/速度設定は維持。全4構成・O0/O2のADC/校正/診断/2秒出力保持・保存両プロファイルのCRC/PC変換が成功し、新規warning0。SHA886669cc…の計測版を書込み、通常起動と全Flash一致を確認した。

同一450µsの非走行負荷で0→3→0→3を交互比較し、旧0は2回とも更新0、新3は5119/5106観測中5118/5105更新・最大間隔1ms・age3ms以上0。IRQ区間最大約606µs、1ms超過/次tick保留0。旧の初回公開なしをstale0/gap0の正常値へ置換しない。GDB直接関数呼出し後の例外状態とUSB不安定を切り分け、採用比較ではcallを禁止し、通常UI/単一サーバーで実行した。負荷0・優先度3・凍結0・センサーOFF・出力0・IPSR0への復元、detach/サーバー終了、後続Flash/RAM保全まで成功した。

最終RAMはIMU/SD初期化成功・電圧約7.40V・開始要求/ログ/出力0。実走の計測標本は全0であり、静止比較を走行へ数えない。コースアウト防止の目標は未達。新しい一次とPATH_CURVEの最初の実ログ/動画、実走IRQ/ADC、新条件10本の採否確認が必要。詳細は[取得優先度の修正](line-acquisition-priority.md)、証跡はbuild/adc-priority-validation/hardware_validation.json。

## 取得版2の実走13879～13881：取得改善と物理ずれの分離

新一次13879・PATH_CURVE13880/13881を全CRC/全列・Flash/RAM保持メタデータ全一致で検証した。実PATH累積25,589標本で最大更新間隔1ms、age3ms以上0、取得要求棄却0、IRQ最大652.81µs/1ms以上0。13880/13881は12.718/12.870秒で通常終了し、13881の途中退避も通常追従へ復帰した。取得競合の対策を実走で確認できた。

一方、ユーザー指定動画220117_00_002＝13881は、同じ床位置5通過でY+16.57mm、測定線感度+14.17～+18.02mm。原フレーム1182ではログ約5.514秒に機体の一部が左板端を越える。近似再生自己位置の変位+1.92mmと食い違い、正常終了や小さい内部偏差だけでコースアウト防止と判断できない。

有効観測を使った位置/方位49組×2走＝98感度再生も完了。59条件は喪失状態に入り、動画に対する最小変位差の1/0も保存運動を固定した学習内結果なので未採用。現在の実機設定5/0とファームは維持した。白線地図が無効なゴール延長11点で終端の未照合が生じることも4走の実C再生で確認した。補正モデルの物理整合・延長地図の修正と実走確認を次の対象とし、単純な停止緩和は行わない。詳細は[13879～13881実走報告](../analysis/path_acquisition_220117/report.md)。
