Kageyana/robotrace_v2/doc/video-slip-marker-geometry.md

# スリップ評価動画の実測寸法

2026-10-18のユーザー確認値。動画校正・機体基準点の復元に使用する。

- カメラのレンズ中心から床：**680 mm**。以前の710 mm申告を訂正。
- 機体の赤マーカー：前63 mm、左右0 mm、床上10 mm。
- 機体の黄マーカー：後65 mm、左右0 mm、床上5 mm。
- 赤・黄の中心間：128 mm。赤側が前。
- マーカー直径：18 mm。
- 床マーカーは移動なし。床の実測座標は `analysis/camera_xy/12678/calibration_points.csv`。

高さの訂正は現行13472～13479の動画校正から反映する。今回の再解析前の710 mm結果は `analysis/video_slip_13472_13479_height710` へ保全。過去の別系列は当時の入力条件を保持し、680 mmで再解析していない結果を訂正済みとして扱わない。

以降の解析は上記の高さを明示し、共通関数の旧デフォルト710 mmを暗黙に使わない。撮影条件が変わった場合は実画像の床点対応と床校正をやり直す。高さの変更は機体ログの生距離XY・検出器の記録ON時間を変更しない。動画の位置・速度・同期・品質判定・抽出窓への影響は再計算で確認する。

## 2026-10-26：PATH_CURVEの動画002～008

今回のユーザー確認値はレンズ中心から床まで**700 mm**。対象は訂正後の`VID_20261026_220114_00_002`以降、ログ13810～13816。10/18の680 mmという履歴は変更しない。

各動画で今回の実画像の床点所属を確認し、可視ピンク8点または7点で校正、緑4点で留保検証を行った。床の既存実測座標を使用し、独立の再実測は未実施。fit最大4.83 mm、留保最大4.98 mm。今回画像では機体の赤黄を識別できず、背景差分による機体外形中心を床上0 mmへ投影した。同じ進行方向・同じ床Xでの相対移動だけを概算に使用し、車軸・赤黄中心の絶対位置、真の機体方位、厳密な滑り量には使わない。

全31通過のフレーム指定再復号で、固定背景と機体の所属を確認した。証跡と制約は`analysis/video_path_curve_13810_13816/report.md`、`calibration.json`、`passage_frame_checks.json`。
