Kageyana/robotrace_v2/doc/失敗事例/2026-10-13-line-sensor-periodic-skip-starvation.md

---
type: codex-failure
date: 2026-10-13
task: "ADC位相変更後に実走行でラインを追従しない"
status: resolved
severity: high
tags: [codex/failure, adc, interrupt, regression]
---

# 周期的な取得欠測で平均化を毎回破棄しセンサー公開が停止した

## 確認した事実

ユーザー指定13187/13188（ADC変更版、Oct 13 2026 22:31:29）は、194行/132行の全10センサー値が完全に一定。先頭5msから959ms/654msまで954ms/649msの固定を確認した。校正有効、IMU校正成功、期待行数一致、数値有限。終了理由はemcStop=3（エンコーダ停止）。失敗走行なので完走率・タイム改善の比較には使わない。

変更直前13185/13186は193/196行中188/192種類のセンサーベクトルを持ち、全期間固定ではない。完走した一次走行13172は4684行すべて別のベクトル。電圧・ゲイン・校正が異なるため、13172との性能比較は行わない。

ユーザーが再起動後に再走行してST-Linkへ接続した状態（logFileNumber=13189）をリセットせず回収した。ADC開始/転送エラー0、fault=false、HAL/DMA正常、スキップ1628、公開3507、最大更新停止691ms、停止診断5回。停止後は電源OFFのため現在age=0だった。RAM全体を保存済み。

## 原因と再現

初回のADC修正は、スキップごとに世代を進め、次回完了時に両位相の積算・平均・準備済み状態を全て破棄していた。これでは4取得に1回の欠測が周期的に続くと、2サンプル×2位相が一度も揃わない。取得自体やHALは正常でも、公開配列は永久に更新されなくなる。

PCの実ソーステストにこの条件を追加すると、100周期で公開増分0として失敗した。修正前の実機でも、モーター出力ゼロ・デバッグ停止時TIM3/TIM6/TIM7凍結下で100取得要求に周期的なHALロック競合を注入し、公開増分0、スキップ増分30を再現した。

走行中の欠測の具体的な割込み時間・位相・理由は未測定。TIM6の走行処理で取得窓が失効することは候補だが、実ログには取得診断列がなく、個別欠測原因を断定しない。周期的欠測で平均化が公開不能になる不備自体はPC/実機で確認済み。

## 対処

未完成のON/OFFペアだけを欠測時に破棄し、同じ欠測世代で取得し終えたペアは保持する。完成ペア2組の各位相平均から差分を算出し、従来の整数丸めを維持する。保持できる完成ペアはHAL tickで3ms以内に制限し、電源世代が変わればすべて破棄する。後続要求の欠測は、既に取得済みの完成フレームを無効化しない。

PID・ADC/PWMタイミング・割込み優先度・SD設定・ログ形式・既存停止条件は変更しない。欠測なしは従来の1ms公開。1msに1ペアだけ取得できる欠測条件では、2ペア平均のため約2ms公開となる。これは欠測を隠して1サンプル値を使う処理ではない。

## 再発防止・確認方法

- 単発欠測→完全復帰だけでなく、4スロットすべての周期的欠測を100周期以上継続させ、更新回数に下限を設ける。
- 完成ペアと未完成ペア、電源世代、後続欠測を別々に検証する。期限切れ・電源切替で過去のペアを平均に混ぜない。
- 変更前との4000取得/1000フレームのraw・正規化・PID比較を維持する。
- 取得が正常に動くことと、公開が継続することを区別する。静止の更新周期だけで走行中の更新を保証しない。
- 実機検証では停止中のタイマーを凍結し、モーターゼロで欠測を継続注入して更新停止を再現・防止する。走行要求を解除し、終了時にロック・凍結・電源・出力を復元する。
- 実走行の採用判断は修正版の新ログでセンサー変化と追従を確認し、同条件で最低10本の再現性を見る。

PCのC11 O0/O2・Wall/Wextra/Werror、欠測4位置と期限切れ、既存回帰が成功。Debug/Releaseビルド成功、修正版Debug書込み・Verify成功。実機修正版の比較結果は`doc/line-sensor-adc-freeze-fix.md`へ記録する。実走行の追従回復は未確認のためopen。

## 検証範囲の見落とし

前回の静止検証は未校正・走行分岐外であり、通常1ms更新と一度の長いロック後の復帰は確認したが、周期的欠測の間に平均化が完成するかを確認していなかった。新しい再現テストを同じ修正単位で追加した。

解析: `analysis/script/analyze_line_sensor_freeze_13187_13188.py`。原本SHA256を解析前後で照合し変更なし。Matplotlibの既定ユーザーキャッシュは書込権限がなかったため、MPLCONFIGDIRをanalysis配下へ設定して再実行成功。

## 2026-10-14 実走行での追従再開

ユーザーから追従再開の報告あり。修正版23:32:35の一次13191～13194で、異なる10chベクトルは277/277、274/274、284/284、275/279種類。全期間固定だった13187/13188の症状は再現せず、角速度指令もセンサー変化に追従した。実公開周期・欠測率はCSV未記録のため不明。4本とも約1.2mのカーブで旋回不足・白線消失となり、走行用PID2/0/0を完走参考5/0/12へSD上で変更した。これは別の調査・試行であり、ADC修正による完走改善の証拠として扱わない。最低10本の同条件再現性確認は未完了のため、この記録の採用確認はopenを維持する。詳細は`doc/line-sensor-curve-understeer-13191-13194.md`。

## 追加17走で公開停止の再発なし

続く13195～13211は全17本正常終了し、オートスタート2組も全5走完了。一次6本の全行で10chベクトルが異なり、他モードも多数変化し、以前の全期間固定が再発していない。ユーザーも完走を報告。PC周期欠測試験・実機注入試験・実走行で更新飢餓の修正を検証できたため、本記録のADC公開停止はresolvedとする。実走行の正確な公開周期・欠測率はCSV未記録で未確定。17走はゲイン/モードが混在しており、最新PIDの同条件10本による採用確認とは別。旋回ゲイン調整の再現性は別記録をopenで継続する。
