Kageyana/robotrace_v2/doc/失敗事例/2026-10-11-yaw-fusion-reference-and-convergence.md

---
type: codex-failure
date: 2026-10-11
task: "符号修正後13074～13088によるYaw融合再評価"
status: open
severity: medium
tags: [codex/failure, analysis, sensor-fusion]
---

# Y符号修正後も参照依存と数値最適化の打切りが残る

## 確認した事実

前回固定設定と、新学習13074～13083で校正・参照だけ更新した設定の2条件で、IMU/EKF/CF/PI/MHE/FG/PFを15本ずつ再生した。13084～13088を融合モデル更新に未使用の留保系列として扱った。新校正のCFは平均参照では13084/13086に改善したが、両学習PRIMARYの単独地図でも改善したのは13086だけだった。学習PRIMARY2本の地図差はRMS60.16mm。

MHEは新校正の学習13075/13076/13082/13083で合計7窓、旧固定の13083/13085で各1窓が反復打切り。FGは両条件の13077で反復打切り。有限値・Jacobian・XY/RMS独立検算は成功したが、全件収束ではない。

## 原因・未確定事項

Y修正で前後加速度の符号不一致は解消したが、今回のYaw観測は横Xを使う。X取付方向、接線位置補正、センサー遅れ、距離位相とライン拘束の交絡は未確定。参照地図はgyro由来で独立の位置・姿勢真値ではない。最適化の到着事前と状態制約の影響も残る。

## 対処・確認

- 既存推定器の重み・状態制約・反復条件を変更せず、打切りを暫定曲線として表示。評価結果に合わせて係数や参照を選び直さなかった。
- 同じ保存推定を平均地図と各単独PRIMARY地図で再採点して、参照依存性を保存した。
- 加速度を外したEKF/CF/PIの比較を保存。現在のCFは留保5本全てで加速度なしの地図距離が小さく、加速度の追加効果を確認できなかった。
- 別スクリプトで元CSVからXY・Yaw・地図距離を再計算し、最大差3.11e-15m・7.11e-15rad・9.67e-13mm。接頭辞因果性、保留ラインの残差混入0、原本・旧モデル・ソースのハッシュ不変を確認。
- 図の再作成時、CSV由来の数値が文字列のままで数値フォーマットに失敗した。数値列を明示変換し、ログ番号と地図RMSの型を検査して再描画を完了。CSVを図へ渡す際は、列名・単位だけでなく数値型を境界で確定する。

## 具体的な再発防止・次の検証

1. 学習側の全モードで反復打切りと状態制約到達を集計し、留保側へ進める試行の前提と未解決点を凍結する。固定条件の再生では、失敗を隠さず全ログを残す。
2. 数値検算成功、有限値、ソルバーの終了理由、物理モデルの妥当性を別項目で報告する。反復上限を増やすだけで成立と判断しない。
3. 参照地図の再採点感度を必ず併記し、gyro由来地図への整合を真のYaw精度と呼ばない。
4. X軸方向・接線補正・時間応答を実機または独立測定で確認し、前後距離位相の状態とYaw補正の寄与を分離する。新係数の評価には新しい独立系列を使う。

詳細：analysis/yaw_fusion_13074_13088/report.md。実行・独立検算・集計はanalysis/script/reevaluate_yaw_fusion_13074_13088.py、validate_yaw_fusion_13074_13088.py、summarize_yaw_fusion_13074_13088.py。Xの物理確認と安定した融合の改善が未検証のためopen。

## DXF設計形状での追加確認（2026-10-11）

ユーザー提供のMachine/Course_benchmark.DXFを読み、1図面単位=10mm・白線幅19mm・下側左マーカーから左へ進む条件をユーザーに確認した。中心線1周4,797.115mm、半径100/150/200/300mm。設計形状はgyro由来でないが、敷設された白線の測定真値ではない。

保存済み15本×7方式×2校正条件を、指定原点そのままと学習PRIMARYだけの共通剛体変換で再採点した。新校正CFは留保13084で保存IMUの20.72mmに対して26.80mmへ悪化し、改善が残ったのは13086のみ（48.08→29.49mm）。指定原点そのままでも改善は13086のみ。ログ由来参照での小さな改善を独立精度とみなさない対策の必要性を確認した。DXFは評価専用で、推定器の内部参照をDXFへ置き換えた試行は行っていない。

解析ユーティリティ再利用時、windows()の出力をそのままobservation_masks()へ渡したため、校正角速度encが未設定でKeyErrorとなった。正しい依存順序windows→attach→observation_masksへ修正し、全420採点とYaw/XY再構成・入力ハッシュ・幾何距離検算の完了を確認した。次回は呼出し側で必要キーと校正段階を確認し、この順序を維持する。これは解析コードのデータ契約の問題であり、元ログやファームウェア異常ではない。

再実行：python analysis/script/evaluate_course_benchmark_dxf.py。結果：analysis/course_benchmark_dxf/report.md、validation.json。DXFで参照形状の独立性は改善したが、物理モデルと数値収束は未解決のため全体ステータスはopenを維持する。
