Kageyana/robotrace_v2/analysis/multispeed_width_13006_13044/実機確認条件.md

# 独立した速度×曲率での実機確認案

本解析では新規実機走行を行っていない。既存ログでは速度計画と曲率が強く結び付いているため、下記は物理同定を確認するための収集条件案。既存の安全制約・室内環境・IMU校正・バッテリー運用を維持する。

- 外部動画または別の独立角度計測で機体Yawを記録する。CROSS姿勢は使わない。時計同期用の機体LED等のイベントを併記する。
- 直線区間で複数速度を個別に保持し、左右Encoder平均の距離換算、左右差の速度比例成分、gyro静止バイアスを別々に確認する。
- 同じ曲率を複数速度で、同じ速度を複数曲率で繰り返す。CW/CCWの両方向を含める。既存ログの速度上限約3.1m/sをそのまま全曲率へ適用せず、必要な旋回角速度・接地状態と既存安全制約から実行可能条件を決める。
- 同一条件で複数回繰り返し、電圧・温度・タイヤ・床・走行方式を記録する。係数選定用系列と確認用系列を別にする。
- 可能ならタイムスタンプ付き1msの左右累積Encoder、gyro Z、保存Yaw、加速度XYZ、IMU温度を記録し、全信号の読取時刻とログ蓄積時刻を確認する。現行の距離基準ログだけで1ms波形を復元できたとは扱わない。
- 13031の後半、13033の旋回ピークのような不一致を動画・車輪回転・機体旋回で照合し、滑りか計測側の問題かを判断する。
- ログ形式変更や実機パラメータ変更はこの案では行っていない。実施する場合は対応するAGENTS/Skillのビルド・ログ確認・実機制約に従う。
