Kageyana/robotrace_v2/doc/失敗事例/2026-10-03-yi-cross-anchor-phase-confounding.md

---
type: codex-failure
date: 2026-10-03
task: "12838～12848の自己位置推定yI独立検証"
status: resolved
severity: high
tags:
  - codex/failure
  - odometry
  - analysis
---

# CROSS確定アンカーの位相をIMUオフセットと誤認できる

## 要約

CW/CCWをCROSS確定行で切り、距離比で対応づけて最適化するとyI=-20.5 mmが非常に安定した。しかしこの安定性だけではIMU物理位置・自己位置推定補正を同定できない。アンカーの前後位置と追跡点のレバーアームが交絡する。

## 発生した状況

- タスク: 12838～12842 CW、12844～12848 CCW、各5周比較。
- 前提: GPIO左右反転、右U2のみ・左U1/U2 OR、取り付け位置同じ（ユーザー確認）。
- 既存CSVのx/y等は正解として使わず、左右累積エンコーダとgyroから再積分。

## 結果

- 確定マーカー: -20.5 mm / RMS7.758 mm。
- アンカーを20 mm先へ移す: -0.5 mm / RMS7.773 mm。
- 独立全幅ライン中点: -82.5 mm / RMS10.489 mm。
- STEPの各ライン素子位置を使って車軸中点通過へ補正: +3.5 mm / RMS7.663 mm。
- 台形gyro積分へ変更すると補正後+1 mm / RMS7.674 mm、yI=0でもRMS7.891 mm。

## 原因

連続時間で p_yI=p_0-yI*(f(theta)-f(theta_start)), f=(sin,cos)。yIは追跡点を機体前後にずらす変換でもある。CROSS確定は幅確認・距離遅延があり、ラインセンサーも車軸より前方にある。逆方向の車軸軌跡をイベント時点で直接対応づけると、同じ物理位置を比較していない。

## 対応と再発防止

1. まず独立センサーでイベントを検出し、各素子の機体基準点からの位置と検出遅延を分離する。
2. アンカーを前後に20 mmずらす感度解析を実行し、最適パラメータがほぼ同じ量動くか確認する。
3. coarseなgyroログでは右端/台形積分を比較し、探索刻みと同定精度を混同しない。
4. 端部除外・ペア別・ラップ別の安定性だけで物理定数を採用しない。
5. 物理IMU加速度補正とエンコーダ/gyro自己位置推定の追跡点を別パラメータとする。

解析スクリプト analyze_yi_12838_12848.py に独立イベント・幾何補正・位相感度・積分則感度を実装済み。入力列、6イベント、有限値、時刻/距離単調性、補間範囲も検証する。

## 確認方法とステータス

10ログで元の最小点を再現し、アンカー移動の1対1感度と独立幾何補正を検証した。方法上の誤認はresolved。床上の光学実効中心、微小残差の原因、SHORTCUT走行性能は未確定。今回は自己位置yI=0を推奨し、ファームを変更していない。

## 関連

- analysis/yi_12838_12848/report.md
- analysis/script/analyze_yi_12838_12848.py
- analysis/script/validate_yi_12838_12848.py
