Kageyana/robotrace_v2/doc/失敗事例/2026-08-11-low-voltage-logs-mixed-with-adoption-comparison.md

---
type: codex-failure
date: 2026-08-11
task: "電圧指令化後の走行性能採用判定"
status: open
severity: medium
tags:
  - codex/failure
  - robotrace
  - log-analysis
---

# 低電圧ストレスログを通常性能の採用比較へ混在させた

## 要約
電圧指令化の耐電圧低下性能を確認するため、7.3〜7.5 V付近のログも周回タイム比較へ含めた。低電圧ログは出力余裕の確認には有効だが、現行方針の通常性能採用判定条件`batteryVoltage_V >= 7.6 V`を満たさない。

## 発生した状況
- 11291以降のBOOST_DISTANCEログの平均走行中電圧は約7.47 V。
- 末尾セットでは平均約7.24 Vまで低下した。
- これらを周回タイム、PWM飽和、速度追従の比較に使用した。

## 何を確認したか
1. 低電圧ログを電圧低下時のPWM飽和確認として集計した。
2. 周回タイムが維持されることと、PWM飽和が増えることを確認した。
3. 低電圧ログと通常電圧の採用判定を分離する必要を確認した。

## 結果・エラー

```text
低電圧ログ: 電圧低下時の出力余裕確認には使用可能
採用判定:   batteryVoltage_V >= 7.6 Vの同一条件ログを優先すべき
```

## 原因または仮説
電圧指令化の目的が電圧低下への追従確認であったため、ストレス試験用ログと通常性能評価用ログの用途を明確に分けていなかった。

## 解決・回避策
低電圧ログは「電圧低下時の出力限界・飽和確認」として扱い、通常性能の採用判断には充電後の`batteryVoltage_V >= 7.6 V`ログを使用する。

## 今後の予防策
- 解析スクリプトに通常性能比較と低電圧ストレス比較のモードを分ける。
- 採用判定表に平均電圧、最小電圧、電圧適格フラグを必ず出す。
- 低電圧ログの良いタイムだけを根拠に速度設定を採用しない。

## 関連

- 比較サマリ: `D:\robotrace\robotrace_v2\analysis\log_11273_11371_compare_summary.csv`
