Kageyana/robotrace_v2/doc/path-unmatched-speed-hardware.md

# 版21の書込み・停止起動確認

白線未照合中の再加速を保留する制御版21/保留版1を書込み、全254652Bを読み戻して凍結ELFと一致確認した。SHA256は`bc7a3fca376fe10b9e2e42612812e0eccbf97eedacd9363269056c3a160eef87`。曲率FFは版2のまま、減速・信頼度・停止条件とSD設定を維持した。[実装と検証範囲](path-unmatched-speed.md)を参照する。

実CのO0/O2境界試験、失敗13898を含む12走×O0/O2全24再生、全4ビルド、両保存形式のCRC・PC変換・新メタデータを確認した。新規warning0、RAM増加0。固定運動再生の性質の検査であり、物理的な板外防止や実タイムを証明したものではない。

初回の停止起動ではIMU正常・8.012VだがSD0で、速度/追従設定が既定値となり、前回13910の設定と不一致だった。ユーザーのSD挿入・再起動後、再書込みせず次を確認した。

- IMU/SD初期化成功、7.946102V（AD2025、有効）。
- pattern/start/auto/log/PWM/負荷/IPSR0、TIM2比較出力0、PRIMASK/CFSR/HFSR0。
- IRQ優先度TIM6/TIM3/ADC1/ADC2は48/16/32/32（格納値）。
- 13910の記録設定22項目と一致。直線3.4m/s・加減速20m/s²、先読み40+20v、横/方位ゲイン10/20、位置係数5・追加方位勾配0。
- 新ELFの全Flash一致、RAM配置234項目の対象ELF一致、デバッガ解除・所有サーバー終了。

証跡は`build/path-unmatched-speed-validation/validation.json`、初回SD0は`boot-20261029T145442Z`、SD復帰後は`boot-20261029T145730Z/hardware_validation.json`。フォルダ時刻はUTC。全走行計測はまだ0で、停止起動を1ms実走負荷の測定へ読み替えない。GDB直接関数呼出し・モーター指令注入・実走行は行っていない。

次はST-Linkを外してPATH_CURVEをまず1本実走し、可能なら前回と同じ一次13900を使って、通常のSD設定のまま比較する。走行後は電源を切らず・リセットせず停止してST-Linkへ接続する。ログ/動画番号・撮影高さ・実際の板外有無を確認し、版21メタデータ、加速保留と復帰、タイム、1ms/ADC周期を検証する。版20の一次13900・10走の成功は収集済みで、既知の13898の失敗も保持する。新方針の板内走行は未確認で、目標完了や恒久採用とはしていない。

実装上の既知事項は[未照合中の再加速](失敗事例/2026-10-29-path-unmatched-reacceleration.md)へ記録し、robotrace-tuningとrobotrace-flash-debugの実行前手順も更新した。

## 2026-10-30：初回実走系列の確認

上記は書込み直後の履歴。現在は一次13911、確定二次13913～13922の10走と、保存失敗13912の動画を確認済み。ユーザーは動画002→13912、003→13913、…、012→13922、レンズ高さ700mm、全11走のはみ出しなしと、**13912走行後の電源再起動**を確認した。13912のRAMは今回の回収対象に含めない。

確定10走は全CRC・全CSV再変換・56列の有限性が正常で、版21/保留版1・FF2・一次13911を確認した。停止理由0、終了信頼度1000、未照合0ms、12.841～12.874秒（平均12.8579秒）。速度/制御22項目は前回13910と一致するが、経路元と電圧は前回系列と異なるため、単一変更の因果比較とは扱わない。各動画5通過を確認し、初回に対する相対Y変位は途中最大7.727mm。周回とともに数mm増える例が残り、ずれ解消や長周回の安定は未確認。可視外形の床投影であり、車軸や真方位、全フレームでの接地点包含は証明していない。

13922走行後、リセット/書込みなしでFlash全254652BとRAM全131072Bを回収した。凍結像と全Flash一致、保持メタデータはSD13922と全項目・順序・数値書式一致。停止/出力0/Fault0、IMU/SD正常を確認し、デバッガ解除・所有サーバー終了済み。保持PATH_CURVE集計は115719周期、IRQ平均515.323µs・最大650.272µs、1ms超過0、ADC最大間隔1ms・鮮度切れ/スキップ0。ただし有効計測の連続区間数は9で、再起動後の確定10走128579msに対して115719周期しかない。最後の9走の計115717msに近いが、帰属は未確定で、全10走や各走の最大時間へ転用しない。

13912.tmpはゼロヘッダで、仮定付き部分診断984行・2.711秒までを保持した。古い13900のレコードと13902のCRC合格コンテナが残っており、対象13912の経路元・停止理由・終了情報へ流用しない。動画002は左直線上での早い停止を示し、他10本と同じ5周完走には分類していない。停止の分類はユーザーへ確認中、保存失敗との因果は不明。

証跡と図は[今回の解析報告](../analysis/path_unmatched_20261030_first/report.md)、検証集約は`analysis/path_unmatched_20261030_first/validation.json`と`build/path-unmatched-speed-validation/validation.json`。C20/C21×O0/O2×10走の40固定入力再生も確認した。今回の10走収集要件は満たしており、同版の追加9走は要求しない。残る増加傾向、13912の早期停止・保存失敗、RAM計測範囲の不一致は未解決。旧版13898/13894の物理失敗も保持し、今回の成功のみで防止完了とはしない。解析中はファームウェアとSD設定を変更していない。
