Kageyana/robotrace_v2/analysis/normalized_yaw_20261031/report.md

# 10/31以降のDISTANCE：角速度正規化の検証

作業ブランチ: `codex/normalized-yaw-feedback`。ファームウェア・SD設定・実機への変更は行っていない。

## 判断

速度に応じて操舵指令を弱める案には検証する価値がある。ただし、目標と実測の単純な正規化が発振を解消するとは実ログから証明できない。高速直線では過大な目標振動、追従の位相差、左右輪目標の制限が共存する。目標生成側の速度依存を抑える案を、ジャイロFBの強さを保った候補として先に試す根拠が得られた。これは実機採用判断ではない。

## 対象と品質

- 選定: CSVのLastWriteTimeを日本時間で2026-10-31 00:00以降に限定し、optimalTrace=2かつslipSourceLogNumber=0をDISTANCEとした。ファイル保存日時は実走日時の完全な保証ではなく、buildDateは選定へ使っていない。
- 対象14本、参照一次9本。全23CSVのSHA256、全行幅、有限値、期待行数、cntlogの増加、58019 pulse/mを確認。除外・読込失敗0本。原binはこのフォルダに存在せず、全CRC再検証は未実施。
- 正常ログ終了10本、emcStop=5の停止4本（13936/13940/14025/14037）。正常ログ終了を板内完走確認済みとは扱わない。停止ログは各表で明示し、正常10本へ加えない。
- 実使用ゲインと左右輪目標を保存しているのは14034/14036/14037/14074の4本。その他10本の実ゲイン・輪制限率を終了ヘッダから確定しない。
- 対象期間内にSLIPログは0本。本結果をSLIPの実測検証済みとは扱わない。

## 方法

各二次走行のprimaryLogNumberで一次を特定し、一次の50mmごとのROC中央値を現行readLogDistanceProgressと同じ境界順で参考再構成した。二次optimalIndexの前後2区間が全てR>=2800mmの点を直線内部とし、そのうち実速度3m/s以上を高速直線とした。二次gyroの小ささで選別していない。一次形状は自己推定で、物理的な床上位置の保証ではない。

診断付き4本で再構成一次の先読みROCと保存先読みROCの一致率は97.7～99.7%。使用周期と保存時optimalIndexの差やCSV丸めがあるので全件の実計画再生とは呼ばない。前後1/2/4区間の境界感度をsensitivity.csvへ保存し、主要な高目標振動・実gyro振動・輪制限が残ることを確認した。

RMSと率は次の保存点までの保持による時間重み付き近似。隣接2点とも同じ選別条件を満たし、間隔20ms以内の区間のみ使用する。記録は距離間隔で、未記録の1ms履歴を復元したものではない。

## 全14本：一次形状で選んだ高速直線

|ログ|終了|一次|対象秒|平均速度 m/s|目標角速度RMS deg/s|実角速度RMS deg/s|輪目標制限率|
|---|---|---|---:|---:|---:|---:|---:|
|13935|正常ログ終了|13934|1.472|3.32|373.6|75.7|未記録|
|13936|停止5|13934|1.430|3.33|371.3|74.4|未記録|
|13938|正常ログ終了|13937|1.563|3.34|280.5|56.0|未記録|
|13939|正常ログ終了|13937|1.544|3.33|397.4|87.2|未記録|
|13940|停止5|13937|1.460|3.33|341.5|70.3|未記録|
|13941|正常ログ終了|13937|1.552|3.34|218.1|37.0|未記録|
|14025|停止5|14023|0.484|3.52|930.4|163.2|未記録|
|14027|正常ログ終了|14026|1.483|3.52|963.1|155.4|未記録|
|14029|正常ログ終了|14028|1.258|3.74|1137.3|198.2|未記録|
|14032|正常ログ終了|14031|1.403|3.81|972.4|177.1|未記録|
|14034|正常ログ終了|14033|1.394|3.83|986.2|188.5|40.0%|
|14036|正常ログ終了|14035|1.514|3.75|1242.6|222.7|47.0%|
|14037|停止5|14035|1.348|3.74|1243.6|216.5|47.3%|
|14074|正常ログ終了|14072|1.872|3.50|662.2|136.8|11.1%|

速度設定、参照一次、ゲイン、電圧、制限値が期間内で変わっているため、ログ番号間のRMS差を正規化や単一変更の効果とは解釈しない。14074はbstStraight=3.7m/s、14036は4.2m/sであり、直線の位置も異なる。

## 発振と乖離の実態

- 診断付き4本の高速直線ではセンサー合成差×encCurrentN/512と目標角速度が全対象時間で1deg/s以内に一致。高速直線の目標値増大は現在の速度乗算式に整合する。低速小R向けFFや目標上限制限の影響を、この高速区間の説明に混入しない。
- 14036/14037/14074の高速直線は実記録でP2/D0が100%。14034は約92%がP2/D0、残りがカーブ用P5/D12。計画ROCだけで切り替える版2でも振動は残っており、直線内のゲイン切替だけでは説明できない。
- 14036の最初の一次形状直線内部（約4.66～8.15m）では目標/実gyro/ライン操舵/輪速度差の卓越周波数が約10.75Hz。目標→gyroの相互相関は+24msで最大（r=0.951）、輪目標差→実輪差は+6msで最大（r=0.935）。14074の長い直線でも約13.43Hz、目標→gyroは+21ms（r=0.961）、輪目標差→実輪差は+6ms（r=0.933）。
- 上記は疎な保存点を1ms格子へ線形補間した閉ループ波形の時間対応診断。約20msをIMU単体の遅延、約6msをモーター単体の純遅延と断定しない。周期波形の別ピークや位相折返しもある。
- 目標と実測の同時刻相関は14036で-0.171、14074で-0.281。大きさを揃えるだけでなく、振動と位相の検討が必要。両者を共通固定値で割る操作はゲインの変更に相当し、遅れを補償するものではない。

## 速度正規化の固定入力比較

比較用に rho=min(1, 2/max(v,0.5))（vはm/s）を使用した。2m/sは比較用の任意基準で、最適化・実機採用した設定ではない。2m/s以下では変更しない例である。

```text
現行:             delta = floor(2*(target - trunc(gyro))/32)
目標・実測を共通縮小: delta = floor(2*rho*(target - trunc(gyro))/32)
目標側だけ縮小:     delta = floor(2*(rho*target - trunc(gyro))/32)
```

deltaは片輪へ加算/反対輪から減算する速度差指令[pulse/ms]。実記録P2/D0・非マーカー点・高速直線に限定し、現行deltaとの一致を確認。両輪非飽和または片輪の自由側から使用した平均輪目標を復元し、±290pulse/msで候補制限率を計算した。Dが有効な周期は、未保存1ms差分が必要なので候補計算へ含めていない。

|ログ|方式|対象秒|差分指令RMS pulse/ms|現行比|輪目標制限率|ジャイロP項RMS pulse/ms|
|---|---|---:|---:|---:|---:|---:|
|14034|現行|1.236|59.60|+0.0%|35.0%|9.89|
|14034|両方を縮小|1.236|31.45|-47.2%|13.2%|5.12|
|14034|目標のみ縮小|1.236|32.74|-45.1%|15.8%|9.89|
|14036|現行|1.475|81.68|+0.0%|47.4%|13.98|
|14036|両方を縮小|1.475|45.72|-44.0%|23.7%|7.59|
|14036|目標のみ縮小|1.475|48.13|-41.1%|26.1%|13.98|
|14037（停止）|現行|1.312|80.92|+0.0%|47.1%|13.61|
|14037（停止）|両方を縮小|1.312|45.40|-43.9%|21.8%|7.47|
|14037（停止）|目標のみ縮小|1.312|47.58|-41.2%|23.7%|13.61|
|14074|現行|1.868|44.52|+0.0%|11.1%|8.51|
|14074|両方を縮小|1.868|25.97|-41.7%|1.1%|4.93|
|14074|目標のみ縮小|1.868|27.75|-37.7%|2.1%|8.51|

14036では共通縮小で差分指令RMSが81.68→45.72pulse/ms、候補輪制限率が47.4→23.7%へ低下する。一方、ジャイロからのP項RMSも13.98→7.59pulse/msへ弱まる。目標側だけの縮小では差分指令RMS48.13pulse/ms、候補輪制限率26.1%、ジャイロP項13.98pulse/msを保持する。

**指令が小さくなることは演算上確認できたが、実gyroや蛇行が減ることは確認していない。** 表の候補制限率は元走行の速度・gyro・ライン偏差を固定した指令感度である。変更後は軌跡・センサー偏差・速度・フラグが変わるため、そのまま実走の改善率へ変換できない。

## 次の実装・実機確認の方針

1. 共通固定値による正規化を発振対策として採用しない。倍率調整として扱う。
2. まず直線P2/D0区間の目標生成だけに速度依存の上限/緩和を設け、gyro FB、カーブ制御、輪速度PID、緊急停止を同時に変えない案を試す。速度正規化の全速度域・全モードへの一括適用は未検証。
3. 同じ一次・速度設定で変更前後を比較し、目標とgyroの振動、輪制限、ライン偏差、完走・ラップを評価する。最初の1走でカーブ移行と停止条件を確認後、同条件10本以上で再現性を判定する。
4. SLIPは今回の対象にないので別に実走検証する。候補方式の順位・安全性・最適基準速度は今回の固定入力比較だけでは確定しない。

## 再実行と成果物

```powershell
& 'C:/Users/ucawa/.cache/codex-runtimes/codex-primary-runtime/dependencies/python/python.exe' analysis/script/analyze_normalized_yaw_20261031.py
& 'C:/Users/ucawa/.cache/codex-runtimes/codex-primary-runtime/dependencies/python/python.exe' analysis/script/report_normalized_yaw_20261031.py
```

summary.jsonに全メタデータ・原本SHA・全区間・相互相関候補を保存。inventory.csvは対象期間内全CSVの分類、bands.csvは速度帯、sensitivity.csvは直線境界の感度、candidate_comparison.csvは固定入力候補、各chart_signal.csvは図の全保存点。validation.jsonは再計算と原本不変照合の結果。
