Kageyana/robotrace_v2/doc/失敗事例/2026-10-03-bmi088-initialization-spec-mismatch.md

---
type: codex-failure
date: 2026-10-03
task: BMI088の取得周期・初期化レジスタ・SPI設定のレビュー
status: open
severity: high
tags: [codex/failure, imu]
---

# BMI088の設定意図と実レジスタ状態を区別する

## 確認結果

角速度取得はTIM6の1 ms周期。GYRO_BANDWIDTHへの0x02はODR1000 Hz・帯域116 Hzなので設定意図は一致する。ただし現行コードは初期化書込み成功・読戻しを検証しておらず、実センサーで設定が維持されていることは未確認。以前の解析でODR1 kHzと記載したのはコードの設定意図であり、レジスタ実測ではなかった。

## 仕様とコードの不一致

- BMI088.c:123～126はジャイロのソフトリセット後に10 msで設定を書き込む。Bosch公式APIは30 ms待つ。設定を書き込む時点が早い。
- main.c:487とiocはSPI2をAPB1=45 MHzの4分周、11.25 MHzにする。センサー仕様の最大10 MHzを超過する。SPI Mode 0自体は対応。
- BMI088.c:16の単一レジスタ読出しはアドレス＋1バイトの2バイト転送でrxData[1]を返す。加速度側はアドレス後にダミー1バイトが必要で、CHIP_IDとして採用している値は仕様上ダミーに当たる。連続したダミー読出しを繰り返しても各トランザクション内のダミーは省けない。一方、加速度6軸データ・温度の既存バースト読出しは呼出し側でダミーを除去している。
- 加速度ACC_PWR_CTRL=0x04のみを書込み、ACC_PWR_CONF=0x00を明示していない。公式APIは双方を設定する。電源投入・ウォームリセット条件を含めActive状態を保証する初期化と読戻しが必要。加速度が実際に停止しているとは本レビューから断定しない。
- レジスタ読書きHAL戻り値・設定読戻しの確認がない。CHIP_ID一致だけで初期化成功としており、設定不成立を検出できない。

## 問題を確認していない設定

GYRO_RANGE=0x00は±2000 deg/sでGYROLSB=16.384と整合。ACC_RANGE=0x01は±6 gでACCELELSB=5460と整合。ACC_CONF=0xACは1600 Hz・Normalで、1 kHzポーリングより更新が速い設定として矛盾しない。ただし加速度とジャイロの同時取得は保証しない。ジャイロは6データバイトのバースト読出しでダミー不要。温度読出しは5 ms周期でもセンサー内の新温度更新周期は別。

## 未確定事項

リセット待ち不足が実機でGYRO_BANDWIDTHを初期値へ戻しているか、SPI超過が読出し誤りを起こすか、これらが周回ドリフトを引き起こすかは未測定。正常に走れていることや校正時エラー0だけで仕様適合は確認できない。

## 対処・次の検証

今回の依頼はレビューのためファームウェア・iocを変更していない。修正対象は次の順で具体化する。

1. SPI2の8分周=5.625 MHzへioc・生成コードの双方を揃える。
2. ジャイロリセット後30 ms以上待ってからレンジ・帯域を設定する。
3. 単一加速度レジスタ読出しに追加ダミーを含め、CHIP_IDが正しく取得されることを確認する。
4. ACC_PWR_CONF=0x00とACC_PWR_CTRL=0x04を仕様に沿う待機付きで設定する。
5. 初期化時の通信成否と設定読戻しを検証する。GYRO_BANDWIDTHはbit7が読出し専用で1になるため、下位7bitまたは対象設定bitを比較する。

## 再発防止・確認方法

- BMI088.c、BMI088.h、main.c、iocの周波数・分周・レジスタ・換算をセットでレビューする。
- 初期化成功はID・通信成否・設定読戻しで判断し、ログの設定意図を実レジスタ測定と混同しない。
- 修正後はビルド、実機電源投入、ウォーム再初期化、静止ジャイロ、取得周期、既存校正、最初のログを確認する。
- 実機で少なくともGYRO_RANGE下位設定0、GYRO_BANDWIDTH下位7bit=2、GYRO_LPM1=0、ACC_CONF=0xAC、ACC_RANGE=1、ACC_PWR_CONF=0、ACC_PWR_CTRL=4を検証する。
- 接続していない実機の設定が正しいと報告しない。

## 参照

- [Bosch BMI088 datasheet Rev1.9](https://www.bosch-sensortec.com/media/boschsensortec/downloads/datasheets/bst-bmi088-ds001.pdf)：5.3.20/21、5.5.5/6/8、6.1。
- [Bosch公式ジャイロAPI](https://github.com/boschsensortec/BMI08x_SensorAPI/blob/master/bmi08g.c)：bmi08g_soft_reset。
- [Bosch公式加速度API](https://github.com/boschsensortec/BMI08x_SensorAPI/blob/master/bmi08a.c)：bmi08a_init、bmi08a_set_power_mode、set_get_regs。

仕様不一致はコードと一次資料で確認済み。実装修正・実機確認は未実施のためopen。

## SPI速度の修正

ユーザーの了承を受け、SPI2の分周を8へ変更し、main.cとiocの双方を5.625 MHzへ揃えた。リセット待機・加速度ID読出し・電源設定・読戻しの問題はこの変更には含めていない。実機の通信と割り込み時間は未確認で、全体のステータスはopenを維持する。

`cmake --preset Debug`と`cmake --build --preset Debug`が成功。main.cに新規warningなし。control.cの既存ADCポインタ型・未使用変数warningは残る。差分はSPI分周とiocの表示速度のみで、GPIO・SPIモード・1ms周期は変更していない。CubeMX再生成は未実施だが、対応する生成コードを直接同期した。書き込み・実機での通信と制御時間測定は未実施。

## 変更後の走行確認

ユーザーが12891～12894すべてを変更後の走行と確認。4本とも正常終了、校正読出しエラー0、無効温度なし、必要IMU列有限。距離基準ログ間隔も正常範囲。従来の一貫したX＋ドリフトは今回見られないが、実速度・電圧の差がありSPIだけの因果は未確定。走行中通信エラー数・割り込み時間・実レジスタは未測定。残る初期化問題の修正も未実施でopen維持。詳細はanalysis/spi_runs_12891_12894/report.md。

## 初期化4項目の修正とローカル検証

ユーザーの修正依頼によりBMI088.cとBMI088.hを変更。起動待機30ms、ジャイロリセット後30ms、加速度単一読出しの追加ダミー、ACC_PWR_CONF=0とACC_PWR_CTRL=4、書込み成否とID・設定読戻し照合を実装した。初期化開始時にInitializedを0へ戻し、途中の通信失敗・ID不一致・設定不一致ではfalseのまま終了する。書込み後の1ms待機は初期化専用であり、走行中のバースト読出し処理は変更していない。

`tests/run_bmi088_tests.ps1`は実際のBMI088.cを模擬HALとリンクし、リセット完了前の設定アクセス禁止、加速度ダミーがIDと異なる応答、読出し専用bit7、全19通信箇所の個別失敗、全9読戻し項目の不一致、異常ID、再初期化、既存3軸・温度バースト取得を確認してPASS。Debugビルド成功、BMI088変更箇所に新規warningなし。既存warningは残る。

実機の電源投入・再初期化・最初の校正と走行ログはまだ未検証でありopenを維持する。次の実機確認ではIMU初期化成功、静止Z角速度、温度有効値、校正100サンプル、1ms取得、正常終了を確認する。初期化失敗を無視して走行させない。
