Kageyana/robotrace_v2/doc/self-describing-log.md

# 自己記述RLOG v2

## 2026-11-03 フィルタ済み計画ROC

全形式の末尾に`filteredROC_mm`（U16・mm）を追加する。DISTANCE/SLIPは現在の`optimalIndex`のPPAD半径、PATH系は同じ点のフィルタ済み一次半径とし、一次・計画なし・PATH延長部は0を記録する。既存`ROC`と全既存列の位置・型・意味を維持する。一次/DISTANCE/SLIPは通常65列/168B・詳細71列/177B、PATH系は通常64列/179B・詳細70列/188B。計算版2を維持し、スキーマCRCを自動更新する。機体の解析元には新しい一次ログが必要である。意味と確認は[フィルタ済みROCログ](filtered-roc-log.md)を参照する。以下の列数は変更当時の履歴。

## 2026-11-02 PATH系の停止後XY列

PATH/SHORTCUT/PATH_CURVE/SHORTCUT_CURVEは既存末尾へ`pathPlanX_mm`、`pathPlanY_mm`（F32・mm）の2列を追加する。通常63列/177 B、詳細69列/186 B。ユーザー指定により一次XYの2列と`pathXYFlags`は記録しない。既存`x/y`を含む全既存列の位置と一次/DISTANCE/SLIP形式を維持する。走行中は0の予約欄とし、停止後にRAM上の実計画を`optimalIndex`で参照し、同じtmpの計画XYだけを書き換えてから通常のCRC確定を行う。停止後の一次原本再読込・補間・専用16,000 B配列を削除した。`pathXYVersion=2`で識別する。付属CSVは作成しない。仕様と検証は[停止後XYログ](path-xy-log.md)を参照する。以下の旧列数・列順に関する記述は各変更当時の履歴。

## 2026-11-01 計画ROCによるゲイン切替の識別

`lineGainPolicyVersion=2`をメタデータへ追加する。DISTANCE/SLIPの切替は計画ROCだけとし、`lineGainReason` bit0は予約・常に0、`lineGainRocNow_mm`は観測用の実測ROCとする。列・型・順序・スキーマCRCは維持する。キーのない従来ログと区別し、詳細は[計画ROCによる切替](plan-roc-gain.md)を参照。

## 2026-11-01 走行方式別のライン診断

一次・DISTANCE・SLIPはPATH専用11列を除き、使用周期のラインゲイン・切替判定・P/D項・制限後の左右輪目標など14列を追加した。通常64列/166 B、詳細70列/175 B。PATH/SHORTCUT/PATH_CURVEは従来の通常61列/169 B、詳細67列/178 Bを維持する。開始時に形式を固定し、停止時全件検証と型付き読込は各ファイルの形式を使う。5 mm距離間隔を維持し、1 ms短区間記録は追加しない。列の意味と検証は[ライン制御ログ](line-control-log.md)を参照。以下の全方式共通の列数・経路外ゼロ保存の記述は当時の履歴である。

## 2026-11-01 速度目標の16bit化

`targetSpeed`の保存型をU8からU16へ変更した。列名・順序・単位[pulse/ms]は維持し、通常61列/169 B、詳細67列/178 Bとなる。制御変数と読込側の範囲もuint16_tへ揃え、4.6m/sの266pulse/msと10m/sの580pulse/msを保持する。自己記述スキーマとCRCは自動更新されるため、機体の解析元には新しい一次ログを取得する。過去ログは変更しない。

`validation/target_speed_u16/run.py`は実setter・実writer/reader・SLIP行受入を通常/詳細×O0/O2で検証する。0/255/256/266/580の往復、バッファ境界、全CRC、列順一致を確認する。`build.py`は通常ログのDebug/ReleaseとARMの2byte配置・STRHを確認する。証跡は`build/target-speed-u16-20261101/`。現在の環境にPC変換器が無いため、PC変換器そのものと初回実機ログは未確認である。

> 2026-10-24: 機体側CSV変換API・旧CSV読込・CSV行バッファを削除した。現行bin専用の型付き読込と`validation/log_storage/run.py`を使用する。以下の機体CSV変換や旧テストの説明は当時の履歴。現行仕様は[整理後の構成](main-code-cleanup.md)を参照する。

2026-10-16のユーザー指示により、保存列の追加・削除・順序変更でPC変換器を更新しない自己記述方式へ移行する。旧RLOG v1の固定6形式は読まない。既存CSVの直接取込は維持する。

## mainへの選択統合（2026-10-16時点）

2026-10-16、ユーザーの指示によりログ保存関連の12コミット（12b87dfから682c9a6まで）をmainへ選択統合する。元コミット番号は各取り込みコミットのcherry-pick記録に保持する。スリップ診断・Fast単独化・校正速度変更は対象外とし、mainのログ列は通常43列/108 B、詳細58列/145 Bを維持する。保存メタデータの走行別ライン校正スナップショットと長い列名を切らない処理は、前段コミット6e76ed9に含まれた保存関連部分だけを補完する。旧6形式の定義はmainには追加しない。

統合前mainの同一合成ログと比較し、通常/詳細それぞれでCSV列名・全データ行とDISTANCE/SLIP/PATH/SHORTCUT計画のバイト一致を確認する。配備済みPC変換器を変更せず、mainの43列/58列ログから機体変換処理のホスト出力と同一CSVを生成できることも確認する。結果は`robotrace_v2/build/log-main-integration/validation.json`。以下の72列・実カード10本の記録は元のスリップ診断ブランチでの検証であり、main統合後の実機試験とは区別する。

2026-10-24に`codex/slip-detector-v2`全体をmainへ統合した時点では通常66列/170 B、詳細72列/179 Bだった。2026-10-25のユーザー指定で有効性・無効理由・区間統計16列を削除して通常50列/135 B、詳細56列/144 Bとし、その後の経路診断6列追加時点では通常56列/154 B、詳細62列/163 B。2026-11-01の補正診断5列追加後は通常61列/168 B、詳細67列/177 B。SLIP計画は瞬時フラグの記録件数を使う版3へ変更した。上記の43列/58列維持は選択統合当時の記録である。更新時の旧ログの扱いは[正式採用とSLIP走行](slip-v2-active.md)を参照する。

## 2026-10-25 経路診断6列

PATH/SHORTCUTの調整用として、以下を両プロファイルの末尾へ追加する。既存列の型・順序と派生XY計算版は維持する。PC変換器は更新せず、保存スキーマに従ってCSV化する。

|列名|保存型・単位|意味|
|---|---|---|
|`pathErrorY_mm`|F32、mm|最近傍走行経路接線に対する横偏差。右側が正|
|`pathErrorHeading_cdeg`|S16、0.01deg|最近傍走行経路の接線方位−機体方位。先読み方位との差ではない|
|`pathState`|U8|0無効、1経路追従、2ライン退避、3再合流、4自己位置喪失|
|`pathYawFF_dps`|F32、deg/s|先読み曲率と目標速度から求めた角速度FF|
|`pathYawLateralFB_dps`|F32、deg/s|`-Klateral×横偏差`の符号付き角速度FB|
|`pathYawHeadingFB_dps`|F32、deg/s|`Kheading×最近傍方位偏差`の符号付き角速度FB|

操舵3列は合計を±1800deg/sへ制限する前の成分であり、飽和後の目標は既存`targetAngularvelo`へ記録する。経路制御は1ms更新で、ログは従来の距離間隔による最新値を保持する。ログ周期を1msへ変更しない。経路モード以外は6列すべて0。経路初期化・無効化時は保持値もクリアする。操舵式・横/方位ゲインは維持する。`routeControllerVersion=18`から自己位置積分→経路更新→PIDの順で1msごとに実行する。補正係数と状態遷移時間の扱いは[1ms経路更新](path-follower-1ms.md)を参照する。

最初の新形式実機ログとPATH/SHORTCUTでの追従確認は別途必要。機体は保存スキーマ一致を要求するため、更新後は新しい一次ログを取得する。

## 2026-11-01 白線・マーカー補正の分離記録

PATH/SHORTCUT/PATH_CURVE共通で次の5列を通常・詳細の末尾へ追加する。通常61列/168 B、詳細67列/177 B。既存列の型・順序・意味、位置補正上限と制御演算は維持する。

|列名|保存型・単位|意味|
|---|---|---|
|`pathWhiteCorrectionApplied`|U8、0/1|区間内に白線による非ゼロの位置または方位補正を適用した|
|`pathWhiteCorrection_mm`|F32、mm|白線の各1ms位置補正ベクトル長の和（非負）|
|`pathWhiteCorrectionHeading_deg`|F32、deg|白線の各1ms方位補正の符号付き和。CW正、CCW負|
|`pathMarkerCorrectionApplied`|U8、0/1|区間内にマーカーによる非ゼロの位置補正を適用した|
|`pathMarkerCorrection_mm`|F32、mm|マーカーの各1ms位置補正ベクトル長の和（非負）|

区間は前回のログバッファ保存成功後から今回の保存まで。1msの短いマーカー補正もフラグと量を保持する。最初の行は走行初期化・ログ開始後からの集計。保存成功後だけクリアし、保存失敗・記録しない周期では保持する。再走行・経路無効化でもクリアする。最後の保存行より後で終了した未記録区間は含まれない。経路モード以外の保存値は全5列0。

白線・マーカーが同じ1msに成立した場合は、既存の合成位置上限0.2mmによる共通縮小率をそれぞれの位置寄与へ適用してから集計する。位置2列の和は経路長としての補正量であり、ベクトル和の大きさとは異なるため、1msでも和が0.2mmを超え得る。方位量は位置の縮小率では縮めず、既存の方位上限0.02deg/1msを適用した値を集計する。マーカーは方位/biasを補正しない。白線方位量は符号が相殺して0になる場合もあるため、適用有無はフラグを見る。位置変化なしの方位だけの補正も白線適用1となる。

既存の`pathLogPoseCorrection_um`は白線・マーカー合成後の内部診断値として維持し、新しい列へ流用しない。既存の偏差・操舵6列は最新1ms値であり、新しい5列と集計範囲が異なる。CSVの`x/y`と`imuAngle_Z`は融合後の位置・方位ではない。

PCは自己記述スキーマに従って変換するため、固定列一覧の更新は不要。機体の解析元は現行スキーマ一致が必要なので、更新後は新しい一次から取得する。検証入口は`validation/path_correction_log/run.py`（実Cの補正/保存、通常・詳細、O0/O2、独立復号と全CRC）と`build.py before/after`（全4構成）。実機の最初のbinと配備済みPC変換器でのCSV確認は別途必要。

## ファイル構成

`512 Bヘッダ → バイナリ記録 → 列定義 → 走行メタデータ`とする。記録部の開始位置とビッグエンディアン保存、レコード内の値、CRC32/IEEEは維持する。列定義を各レコードへ繰り返し保存しない。

ヘッダ整数はリトルエンディアン。magicはRLOG、versionは2。従来の番号・profile・recordBytes・rows・metadataBytes・dataCrc・metadataCrc・schemaの位置は同じ。schemaは列定義そのもののCRCへ変更し、offset 44/48/52へschemaBytes/columns/derivedVersionを追加した。offset 40のヘッダCRCは、その4 Bを除く512 B全体を対象にする。実長は512＋recordBytes×rows＋schemaBytes＋metadataBytesと一致させる。

列定義はUTF-8のASCII部分で、1列1行の`種別,型,列名,書式\n`。

```text
S,U16,cntlog,%d
S,F32,gyroVal_Z,%f
D,F32,ROC,%f
```

Sは保存列、Dは計算列。型はU8/U16/S16/U32/S32/F32。列名は63文字以内のC識別子、同名列は禁止。書式は型別の許可リストで制限し、任意printf指定は実行しない。現在の`%d`・`%ld`・`%f`と符号の扱いを保持し、U32の`%u`/`%lu`、F32の`%.0f`～`%.9f`にも対応する。

上限は256列、列定義4095 B、記録2048 B。実機ではログバッファに1記録が収まることをstatic_assertで確認する。上限を超える列追加や新しい保存型の追加は形式・変換器の更新が必要。

## 保存列と計算列

機体は`log_schema.h`から列定義を自動生成してFlashへ置く。保存列を既存の型で追加・削除・並替する際、PCの列一覧やoffset表の編集・再ビルドは不要。

PCはファイルの列定義から保存位置とCSV列順を復元する。計算版はderivedVersion=2で、ROCの処理は維持し、x/yの距離をマーカー補正前の左右生エンコーダ累積値の平均へ変更した。計算に必要なcntlog/encCurrentN/courseMarker/gyroVal_Z/encTotalL/encTotalR/imuAngle_Z、および計算列ROC/x/yは名前・型・S/D種別を検証する。encTotalL/RはS32で、int64の左右和を差分化してから0.5倍し、半パルス・後退を保持する。角度はimuAngle_Zの両端平均を使う。これらの削除や意味・型の変更、未知の計算列は変換を失敗させ、原本を残す。計算列変更時はPC変換器を更新する。

CSVメタデータにもlogDerivedVersion=2、logXYDistance=raw_wheel_averageを記録する。列数・保存レコード配置は変更しない。encTotalOptimalのマーカー補正は走行制御・次走計画に引き続き使用するが、ログXYへ加えない。新規保存時のゴール閉路Xも同じ生エンコーダ距離を使い、閉路Xの許容値・減速区間・制御中自己位置は変更しない。ユーザー指定により旧計算版1の互換処理は追加せず、旧binは原本を保持して拒否する。以下の計算版1での検証・実機確認は過去記録であり、計算版2の初回実機確認とは区別する。

機体の走行間解析は同じビルドのレコード定義を使い、列定義の完全一致を要求する。PC側の汎用変換とは用途が異なる。新しいビルドで過去の異なる列構成を機体解析元として使うことは保証しない。

## 検証

- 通常・詳細とも、変更前後のCSV列名・全データ行、DISTANCE/SLIP/PATH/SHORTCUTの全計画がバイト一致。メタデータのbinarySchemaは列定義CRCへの仕様変更により変わる。
- 同一のPC変換器exeで、保存列の追加・診断列削除・全列逆順・削除と追加と並替の組合せを変換できた。既存の計算列値は一致した。全6保存型の非ゼロ値、符号、丸めも検証した。
- ヘッダ・記録・列定義・メタデータのCRC、短い入力、重複列名、未知型・計算列・危険な書式、必須列欠落、旧v1を拒否した。失敗時に完成CSVを出力しない。
- 保存・故障注入・原本保持・走行計画・自動走行の既存回帰を通常/詳細で確認した。旧6形式の互換テストは対象外。

ローカル検証は`robotrace_v2/build/rlog-v2/validate.py`、結果は`validation.json`、比較前のコード・PC変換器は`baseline/`へ保全する。既存のtests/build管理対象外方針を維持する。

## 配備と実機確認の状態

`C:\tool\AutoCopyCsvFromSd`の変換器をv2へ更新し、監視を再開した。隔離フォルダから実PowerShellスクリプトを実行し、通常・列順変更・列追加のコピー／変換／保存、原本保持オプション、旧v1・破損列定義の拒否と原本保持を確認した。結果は`build/rlog-v2/import-validation.json`。

Debug/Release×通常/詳細とDebugMarkerの全5構成がビルド成功。新規warningはなく、既存warningは残る。ログI/O共有RAMは6144 B、スタック予約8192 Bを維持した。通常Debugの列定義は終端NUL込み1687 BでFlashへ配置される。

初回のCodexによる書込みは未実施。2026-10-16の接続確認でST-LinkのSN/FWと3.24 Vは取得できたが、`Unable to get core ID`／`No STM32 target found`で停止した。Device ID/Core IDを確認できるまで書込みへ進まない。以後のユーザーによる書込み・実走行と新形式の確認結果は以下のとおり。

## 2026-10-16 実走行ログと実カード取込

ユーザーが新ファームを書込み、走行後にSDをPCへ挿入した。G:のRT_LOG（exFAT）から13288～13297の10本を常駐監視が自動変換・保存した。5走×2セットで、各セットの順はPRIMARY/PATH/SHORTCUT/DISTANCE/SLIP。全ログはRLOG v2、通常プロファイル、183 B/記録、72列、列定義1686 B、derivedVersion=1。ヘッダ・記録・列定義・メタデータの全CRC、temp原本SHA256とディレクトリ名、CSVの全行列数・有限値・CRLF、tempと正式CSVの全バイト一致、期待行数一致を独立に確認した。

行数は順に4675/4742/4741/4738/4717、4670/4741/4738/4720/4715。全ログのemcStop=0、両一次ログのclosureValid=1・closureReason=0。build情報はgitCommit=b809f51、Oct 16 2026 01:09:36。後続ログの一次参照番号も各セットに一致する。これは新形式での保存と機体内解析後の5走進行・PC取込の確認であり、ラップタイム改善や経路精度の評価ではない。

正式CSVは`F:\Dropbox\Document\robotrace\Log\v2`へ保存された。SD上の該当bin/CSVは取り込み後に存在せず、tempの原本binとCSVは保持されている。変換器stderrは全10本とも空。確認スクリプトは`robotrace_v2/build/rlog-v2/verify_actual_card.py`、全CRC・ハッシュ・メタデータの結果は同フォルダの`actual-card-import-13288-13297.json`へ保存した。CodexによるSWD照合・再起動復旧と実測速度比較は今回実施していない。
