Kageyana/robotrace_v2/doc/skill-execution-preflight.md

# Skill実行前の共通確認

ロボトレース用Skillの最初のコマンドを組み立てる前に読む。対象分野の事例も検索し、本文の最新追記まで確認する。過去の成功は現在の接続・権限・設定を保証しない。

ツールの呼出し入口も宣言と照合する。`functions.request_user_input_async`等のトップレベル確認ツールは直接呼び、`functions.exec`内の`tools.*`へ推測して送らない。execは公開された入れ子ツールのみを使う。セル途中で失敗した場合は、先行変更を読み戻し、未実行部分だけを再開する。[確認ツールの入口](失敗事例/2026-10-30-orchestration-tool-entrypoint.md)参照。

## 1. パスを確定してから実行する

- リポジトリルートは `D:\robotrace\robotrace_v2`、ファームウェアルートは `D:\robotrace\robotrace_v2\robotrace_v2`。ビルドの `workdir` は後者、文書・fixture生成は前者を明示する。文書更新とビルドは別の呼出しにする。
- ファームと`C:\tool\AutoCopyCsvFromSd`を同時に扱う場合、呼出しのworkdirを確定してからパスを組み立てる。複数リポジトリの読取は絶対パスに限定し、Gitは`git -C <対象ルート>`で対象を明示する。外側のworkdirだけを後からPCツール側へ変えて、ファームの相対パスを残さない。実行前に対象ファイルの`Test-Path -LiteralPath`を確認し、不一致ならその呼出しを開始しない。
- 初回の検索は実在ディレクトリを `Test-Path -LiteralPath ... -PathType Container` で確認し、ディレクトリ＋`-g`へ限定する。未確認のファイル名やディレクトリ（`.agents`等）を検索パスへ指定しない。
- 文書の参照先も名称から構成しない。関連Skillから読む設計文書は先に`rg --files doc -g '*fusion*' -g '*observ*'`等で実在一覧を取得し、選んだ全ファイルに`Test-Path -LiteralPath <path> -PathType Leaf`を通す。1件でも不在ならその検索呼出しを開始せず、実在一覧へ戻る。複数パスのrgは終了コード2以上を直ちに拒否する。2026-11-03の距離補正検討での再発は[コースアウト解析の入口検査](失敗事例/2026-11-02-courseout-analysis-preflight.md)参照。
- VS Codeの設定ファイルもルートとファーム直下で同じ構成と仮定しない。まず `rg --files .vscode robotrace_v2/.vscode -g '*.json'` の実在一覧で所在を確定する。このチェックアウトのtasks.jsonはファーム直下だけにある。PowerShellのErrorActionPreference=Stopだけではnativeコマンドの非0終了を停止できないため、rgの終了コード2以上はその場で例外にし、後続処理へ進まない。
- 外部コマンドのパス引数へ `*`、`?`、Bashの `{a,b}` を渡さない。ファイルを絞るのは `rg --files` または以下の検索結果に実在パスが出てからとする。

```powershell
rg -n 'Interrupt1ms|wheelClick' 'D:\robotrace\robotrace_v2\robotrace_v2\Core\Src' -g '*.c'
powershell.exe -NoProfile -ExecutionPolicy Bypass -File 'D:\robotrace\robotrace_v2\analysis\script\search_failure_notes.ps1' -Pattern '権限|パス|ログ' -FileGlob '*.md'
```

- 日本語を含むWindows PowerShell 5.1用ps1はUTF-8 BOM付き保存を維持し、実行前にEF BB BFを確認する。`search_failure_notes.ps1`だけでなく取込・配布用スクリプトも対象。変更時は実際の `powershell.exe -NoProfile -File` で対象処理を確認する。
- ログの標準パスは `F:\Dropbox\Document\robotrace\Log\v2`。無ければ現在のDropboxルートを確認し、旧ユーザー名の `C:\Users\ucawa\...` を推測で使わない。
- CrossDevice動画は存在・`ffprobe`成功を確認してから抽出する。生成失敗後に古い画像や一時成果物を開かない。

## 2. 権限を初回から選ぶ

ビルドログの出力先もworkdirと同時に絶対パスへ解決してから親の実在を確認する。ファーム直下からリポジトリ直下のbuildへ保存する相対パスは`../build/`であり、`../../build/`ではない。PowerShellのリダイレクト失敗はbuild未実行として扱い、`$ErrorActionPreference='Stop'`とnative終了コードで後続処理を止める。[出力先の階層誤り](失敗事例/2026-11-03-mode-gains-build-output-path.md)参照。

- 現在のセッションのpermission profileを確認する。作業ツリーのwrite許可は、`.git`、`.agents`、個人Skill、リムーバブルSDへのwrite許可を意味しない。
- 対象がreadのみと分かっている場合、承認済み作業は**最初の書込みから** `exec_command(sandbox_permissions="require_escalated")` へ送る。`git add/commit/restore/switch/branch/merge/rm --cached` 等のindex・refs更新を通常権限で試さない。対象パスと操作を限定する。昇格はCodexのサンドボックス権限要求であり、OS管理者実行やACL変更とは別。
- workspace内の`git status/diff/log`の読取は通常権限を使う。管理worktreeがworkspace外に作られた場合は、Gitのread操作もサンドボックスの対象パス制限を受ける。作成先をpermission profileと照合し、対象外なら初回のGit読取から必要権限で実行する。Git更新前は既存差分・対象・ロックの有無を確認し、ステージ成功後に `git diff --cached --check` と対象差分を確認してからコミットする。失敗後に後続commitへ進まない。
- ロック作成のPermission deniedを、残留ロックと決めつけて削除しない。Git内部ファイル、ACL、グローバル設定を変更して権限制限を迂回しない。
- 権限要求が拒否されたら同じ変更を別ツールから強行しない。安全に進められる作業を完了し、拒否された操作と理由をユーザーへ報告する。
- `helper_unknown_error: setup refresh had errors` はソースの診断と分ける。同じ失敗をパス表記やシェルだけ変えて反復せず、必要最小限の同一処理を許可された環境で実行する。編集の代替には一時コピーのunified diffを使い、`git apply --check`、適用後diffを確認する。
- Start-Processの出力リダイレクト先は親フォルダを先に作成する。ErrorActionPreference=Stopで失敗後の成功表示・後続処理を止め、PIDの生存は起動時と同じ権限で確認する。
- 自分で開始した長時間処理は返されたsession_id/PIDを保持して対象だけ停止する。CIM照会の権限を前提にせず、全Python・MATLABプロセスを名前で終了しない。

## 3. ランタイム・引用符・文字コード

- Pythonは `Get-Command python.exe` で実体を確認する。Storeエイリアスなら `load_workspace_dependencies` で取得した絶対パスを使う。必要モジュールを `importlib.util.find_spec` で先に検査し、その後importを確認する。同梱PythonにもMatplotlib/SciPy/PyYAMLがあるとは仮定しない。
- この環境ではGNUツールとGCC生成host exeにDLL再配置エラーが繰り返されている。該当するARM/hostビルド・nm/objdump/size・planner exeは、最初から許可された制限外環境で実行する。環境が変わった場合は版表示等で再確認する。ソース変更やテスト閾値緩和で起動エラーを回避しない。
- 日本語テキストの読書きは `encoding='utf-8'`、BOM混在入力は `utf-8-sig` を明示する。Python標準出力も `PYTHONIOENCODING=utf-8` とする。
- Matplotlibはimport前に `MPLCONFIGDIR` を今回の書込可能な解析出力内へ設定する。
- 複数行Pythonやコード置換を、引用符の複雑な `python -c` に押し込まない。スクリプトか範囲の小さいパッチを使う。`$skill-name` をPowerShellで保存するときは単一引用符または単一引用符here-stringでリテラルを保持し、生成後に読み戻す。
- PowerShellの `foreach` 文は結果を配列に格納してからパイプへ渡す。
- 文字化けコメントをパッチアンカーにしない。ASCIIコード行と関数範囲・出現数を確認して編集し、dot-all＋貪欲な `.*` で関数間を横断しない。
- 複数ファイルの一括編集は、全件の編集案と挿入目印の一意性を検査してから書き込む。同じ条件分岐が複数ある場合は対象の宣言まで含めて位置を特定する。関数宣言の位置は引数と末尾セミコロンまで含め、関数定義との重複を避ける。前回の検証記録だけを現状とみなさず、読込時と書込直前の内容一致を確認する。コメント整理ではコード・マクロ継続行・USER CODE境界の一致を編集前後で確認する。[見出し挿入位置の重複](失敗事例/2026-10-25-core-section-insertion-anchor.md)参照。

## 4. 依存操作の完了を確認する

- `exec_command` の戻り値全体を保持する。session_idが返ったら `write_stdin` で終了コードと最終出力を取得する。待機を呼んだだけでは完了にならない。
- generator→ビルド、書込み→GDB、一時MLAPP生成→起動検証は逐次実行し、前段の成功と新しい成果物を確認してから進む。失敗時はそこで止め、部分成功はdiffで確認する。
- Git履歴変更は実際のHEADと依頼対象を照合する。「今後日本語で」は既存コミットamendの依頼に変換しない。
- 失敗記録の古い36 B上限、電圧7.3/7.6 V、旧ゴール回数、過去のベンチAPIを現行ルールへ戻さない。`AGENTS.md`、現行ソース、ユーザーの最新指定を優先する。未確認の物理原因はopenのままとし、Skill更新だけで解決済みにしない。

複数exec間で共有する一時成果物はworkspace内の明示した作業領域へ保存する。sandboxのTEMPが呼出し間で同じとは仮定せず、次段で存在とハッシュを確認する。

## Git連携と変更範囲

- 通常の`git diff --check`は未追跡ファイルを検査しない。新規ファイルはステージ前に`git diff --no-index --check -- NUL <実在ファイル>`で個別検査し、終了コード0/1かつエラー出力なしを確認する。末尾の余分な空行も対象とし、ステージ後の`git diff --cached --check`を省略しない。[新規ファイルの検査漏れ](失敗事例/2026-10-25-staged-snapshot-whitespace.md)参照。
- 空白検査を集計する補助スクリプトは、LF→CRLFの既知の予告行を実エラーと分けて保存する。stderr全体の空を要求せず、予告以外のstderr・空白診断のstdout・終了コード0/1以外を失敗にする。リポジトリの正規化設定を変えて警告を消さない。
- 作業ツリーの空白検査では既存の改行正規化設定を維持する。`-c core.autocrlf=false`はLF正規化済みの比較用コピーに限り、LF/CRLFの予告警告を抑える目的で作業ツリーへ指定しない。CRLFを保持した未追跡ファイルの個別検査では`git -c core.whitespace=cr-at-eol diff --no-index --check -- NUL <実在ファイル>`でCRを改行として扱い、実際の空白エラー出力と終了コードを確認する。[正規化設定の誤用](失敗事例/2026-10-25-staged-snapshot-whitespace.md)参照。
- 段階的コミットでは、最初のindex更新前に全段階の隣接ソースを`git diff --no-index --check`で比較する。最終状態だけの空白チェックや中間ビルド成功で代用しない。no-indexの終了コード1は通常の差分でも返るため、0/1かつ空白エラー出力なしを成功条件とする。空白エラーがあれば中間ペイロードだけを修正し、全段階の成功を確認してから対象パスを限定してステージする。中間内容の修正後はGitの改行正規化後のオブジェクトを親と比較し、変更のない対象を予定一覧から除く。開始HEAD・元のステージ状態・作業ファイルのハッシュを記録し、失敗後は自分が追加したステージだけを戻す。詳細は[分割スナップショットの空白検証](失敗事例/2026-10-25-staged-snapshot-whitespace.md)。
- pushが依頼されたときはstatus/branch/remoteと送信差分を確認する。既知のsandbox HTTPS制限下では初回から必要なネットワーク権限で実行する。port 443接続失敗と認証拒否を分ける。workflow更新を含む場合は使用認証の権限を確認し、without workflow scope拒否はサンドボックス昇格で直ると仮定しない。認可変更や秘密の提示を自動実行せず、必要な認証の更新を案内する。
- 制御API・ログ・設定を統合するときはmotor/PID/FF/保存形式の境界を照合する。競合で片側を丸ごと採用せず、旧PWM出力APIの残存、ログ既存列の意味・順序、両構成ビルドと初回実ログを確認する。
- 文書・候補調査の依頼を無関係な命名正規化や制御実装へ広げない。ユーザーが別タスクと指定した変更は現在の作業へ含めない。

- 特定コミットだけをmainへ取り込む場合は、対象コミットの親とmainの差を先に確認する。Skill競合で周辺節に未導入機能の説明が含まれても、その節全体を持ち込まない。指定コミットの変更意図だけを反映し、ファームウェアソースの差分がないことを確認する。事例対応表にmain未収録の原本がある場合は、調査元のコミットを明示して参照を保つ。

## 2026-10-27：存在検査の実行点

長い作業やコンテキスト復帰後も、記憶から短縮したフォルダ・失敗記録名をそのまま検索パスへ渡さない。検索コマンドを作る呼出しの直前にTest-Pathで対象ディレクトリを確認し、未知のファイルはrg --files <存在する親> -g '<分類>'の結果から選ぶ。rgへワイルドカードを含むパスは渡さず、-gへ置く。

2026-11-01追記: Test-PathのFalseを表示しただけで後続rgを実行しない。必須パスはFalseならthrow、任意パスは存在するものだけを配列へ集めてから渡す。検索後はrgの終了コード2以上を直ちに拒否する。apply_patchは同じパスへの操作を1つにまとめ、複数hunkで扱う。拒否された場合は差分を確認して部分適用の有無を確定してから再構成する。[補正ログ追加時の事例](失敗事例/2026-11-01-path-correction-log-preflight.md)。
