Kageyana/robotrace_v2/doc/plan-roc-gain.md

# DISTANCE/SLIPの計画ROCによるゲイン切替（版2）

14034では、両計画ROCが3000 mmの箇所でも実測ROCが500 mm以下になるとP2/D0からP5/D12へ切り替わった。機体の揺れをゲイン上昇へ戻す経路を外すため、DISTANCE/SLIPの切替を速度計画`PPAD`のROCだけで判定する。

- 進入は`optimalIndex+4`の計画ROCが500 mm以下。カーブ用の設定ゲインへ切り替える。
- 復帰は`optimalIndex+2`の計画ROCが600 mm以上で、`encChangeGain > encMM(20)`となったとき。直線用P2/D0へ戻す。
- 先読みは配列終端へ制限する。計画なしの動作、ソフトリセット、設定ゲインの保存・復元は従来どおり。
- 閾値、先読み点数、20 mm保持、PID計算後に次周期のゲインを決める順序を維持する。
- 一次の通常/クロス切替、PATH/SHORTCUT/PATH_CURVE、速度計画生成、速度表、PID本体、左右輪上限約5 m/s、緊急停止は変更しない。SLIPは内部的にBOOST_DISTANCE=2なので同じ切替を使う。

実速度そのものでは切り替えない。直線の加減速やSLIP計画による速度低下を、カーブという条件へ変換しないためである。既存の4点先・2点先を保持するので、速度目標が変わる周期と完全に同時の切替ではない。

進入と復帰の計画条件は、参照する位置が違うため同時に成立し得る。今回も既存の保持処理を維持し、この場合の理由bit1/2/3も保存する。実機での進入前後の切替回数は新ログで確認する。

## ログの識別

ヘッダに`lineGainPolicyVersion=2`を追加する。14033/14034など、このキーがない過去ログは旧方式（実測ROCと計画ROCの小さい方）。この版はDISTANCE/SLIPの方式を示し、一次・PATH系の切替変更を意味しない。

- `lineGainReason` bit0は旧実測ROC進入理由として予約し、版2では常に0。
- bit1は計画ROCによる進入条件、bit2～6は従来の保持・復帰・クロス・距離計画なしの意味を維持する。
- `lineGainRocNow_mm`は判定時の実測ROCを観測用に残す。版2の切替判定には使用しない。
- 記録列・型・順序・スキーマCRCは変更しない。一次/DISTANCE/SLIPは通常64列/166 B、PATH系は通常61列/169 B。5 mm距離ログを維持し、短区間1 ms記録を追加しない。

一次の計画生成とバイナリ列定義は同じなので、この変更だけを理由に旧一次の取り直しは要求しない。比較では14034と同じ一次・速度設定を使用し、実使用ゲインと理由、左右目標制限、gyro、速度偏差、完走・再現性を確認する。低速カーブでのD項急増は今回の変更では対処しない。

## 検証

`validation/plan_roc_gain/run.py`は実Cの`changeGain()`を抽出し、O0/O2で500/600 mm、20 mm厳密境界、先読み終端・1点/計画なし、一次クロス・PATH系、ソフトリセットを確認する。旧処理へ十分大きい実測ROCを与えた基準と、任意の実測ROCを与える新版の4万判定を照合する。実測には小値、閾値付近、非有限値も含め、観測ログ以外の切替結果に影響しないことを調べる。

14034で保存された実測単独進入31件は、各判定時入力を独立に与えると旧版はカーブ、新版は直線となる。これは固定入力の判定検証であり、走行全体の再生や物理的な振動低減の証明ではない。通常/詳細の実writer/reader・全CRC・6走行ケースも確認する。

Debug/Releaseの全体ビルド、既存warningとの差分、I/O 6144 B・スタック8192 B、IRQ・PID・速度計画ソースの不変を`finalize.py`で確認し、証跡とELFは`build/plan-roc-gain-20261101/`へ保存する。実機未書込。初回ログの`lineGainPolicyVersion=2`、切替位置・カーブ追従・周期余裕と、同条件10本の再現性は別途確認する。
