Kageyana/robotrace_v2/doc/line-acquisition-priority.md

# 白線取得を制御計算より優先する修正

13877/13878では、TIM6のIRQ区間最大約502µs・1ms超過0でも、白線更新間隔が最大6ms、鮮度3ms以上が23.94%だった。100ms連続の有効照合が回復条件であり、この間欠欠測は減速を解除できなくする条件になり得る。今回は取得側を修正し、鮮度/停止/回復の閾値は緩めていない。

## 変更内容

- `initSystem()`でタイマー開始前にTIM6優先度を3へ変更する。TIM3=1・ADC DMA=2を先に処理し、LED位相/ADC完了を制御計算中にも進める。CubeMXの初期値0・`.ioc`・生成ピン設定・500µs PWM周期は変更しない。運転時の優先度3はアプリ側の明示設定とする。
- 制御/停止判定/ログが読むraw10個・正規化10個・更新件数を1ms処理の入口から末尾まで固定する。ADCは2サンプル×ON/OFF平均化を継続し、最新の完成値と件数を末尾で一括公開する。途中の電源世代変更は保留値を破棄し、重複ONでは保持する。
- 校正の位置判定も短い割込み禁止区間で10個をコピーする。マーカーの1byte公開値をvolatileとし、既存の判定内1回読取りを維持する。
- 保存列56/154B・62/163Bと既存の単位は維持し、メタデータに`lineAcquisitionPolicyVersion=2`と設定上の`lineControlIrqPriority=3`を追加する。保存テストのShortcut境界3ケースは3603～3618B/4096Bに収まった。
- 120µs安定待ち・50µs走査余裕・鮮度3ms未満・全暗100未満20ms停止・白線信頼度の停止/回復・速度0検出後のPID出力2秒保持を維持する。PID/FF・SDの速度表・補正率は変更していない。

## 静止実機比較

計測版SHA256 `886669cced5e53e6d87f3e9bd8ec02ddbb910d101f8a644021cd53d207e80cd2`をSTM32F446へ書込み、CLIの照合と起動、GDBでの全Flash読戻し一致を確認した。計測ON版だけの上限付き負荷（既定0、上限600µs/1ms）を使い、非走行のセンサーテスト画面で同じ450µs負荷を与え、優先度だけを0→3→0→3と交互に変えた。開始要求/autoStart/ログ記録/モーター出力0、各停止点のIPSR0を維持した。

|区間|TIM6優先度|1ms観測標本|完成フレーム更新|更新間隔最大|age3ms以上|IRQ区間最大[µs]|
|---|---:|---:|---:|---|---|---:|
|1|旧0|5133|0|測定不可|初回公開なし|559.73|
|2|新3|5119|5118|1ms|0%|605.94|
|3|旧0|5124|0|測定不可|100%|561.06|
|4|新3|5106|5105|1ms|0%|605.49|

全区間で1ms以上のIRQ区間と次tick保留は0。区間1はvalidSamples0なので、age超過0やmaxGap0を正常と解釈しない。区間3は前の完成値が残り、更新が止まったままageが増えた。旧優先度はCPU処理全体が1ms以内でもLED取得窓を失効させ、新優先度で公開が復旧することを静止条件で実証した。IRQ出口の統計処理・CPU例外入出は区間外であり、実PATH_CURVEの最悪時間や光学追従をこの試験で保証しない。

終了時に負荷0・優先度3・凍結0・センサーOFF・PWM/CCR0・IPSR0へ復元し、開始画面へ戻してdetach、所有サーバーを終了した。その後もリセット/再書込みなしでFlash/RAMを保存し、全Flash一致とIMU/SD初期化成功・開始/ログ/出力0を確認した。実走モードの計測標本は全て0であり、静止試験を走行データへ混ぜない。

GDBの関数直接呼出しを使った初回手順では、setup/mainでIPSR/VECTACTIVE32・NVIC active0となり、負荷投入前の安全ガードで中止した。通常起動へ復旧し、採用した比較ではcallを禁止、通常UI経路と単一サーバーを使用した。USB通信不安定もあったが、ガードを緩めたり失敗値を比較へ混ぜたりしていない。[手順の失敗と復旧](失敗事例/2026-10-28-gdb-call-exception-state.md)参照。

## 確認範囲と次の実走

ADCの4スロット周期欠測100周期、平均化4000取得/1000フレームのraw/正規化/PID一致、保留中の公開固定/件数周回/電源切替、校正のIRQマスク復元、DWT周回/負荷ガードを実関数のO0/O2・Wall/Wextra/Werrorで確認した。通常/緊急停止の0/1999/2000ms・周回・可変PID出力の回帰も成功。保存2プロファイルの全CRC・故障注入・PC再変換・経路解析が成功した。

Debug/Release/DebugMarker/独立PathAcquisitionTimingの4構成が成功し、既存全体ログとの差で新規warning0。計測OFFには試験負荷/統計のシンボルがなく、通常Debug RAM79528Bを維持。計測ONはRAM80408B・Flash251412B、スタック予約8KiB。追加IRQネストの実走最大スタック/時間は未測定。

今後は新しい一次→PATH_CURVEを取得し、取得版2/優先度3のメタデータ、センサー更新と減速解除、コーナーの張出し、周回ずれ、終了理由を動画と照合する。まず1組でログ形式/実走計測を確認し、その後同条件10本で採否を判断する。確認時の電圧は約7.40Vだったため、高速確認前は7.5V以上を運用確認する。コースアウト防止と実2秒保持の出力履歴は未検証のままである。

証跡は`build/adc-priority-validation/validation.json`、`hardware_validation.json`、不変ELF、`installed-source/`、`bench-v3/bench_validation.json`、`after-run-20261028T124541Z/`。次の走行後RAMは電源/リセットを保ち、`hardware.py capture-run`→`analysis/script/read_adc_priority_snapshot.py decode`で回収する。走行中は接続しない。

## 取得版2の初回実走：13879～13881

新しい一次13879とPATH_CURVE13880/13881を全CRC/全CSV値で検証し、取得版2/優先度3を全ログで確認した。電源保持後のRAMと全Flashをリセットなしで回収し、保持メタデータ全内容をSD13881と照合した。実PATH2走累積25,589標本で完成更新25,589回、最大間隔1ms、age3ms以上0、取得要求棄却0、ADC開始/転送/fault0。IRQ区間最大652.81µs、1ms以上/次tick保留0。静止計測だけだった取得改善を実走でも確認できた。

2本は12.718/12.870秒で正常終了し、13881では途中退避後に通常追従へ復帰した。一方、ユーザー指定動画220117_00_002＝13881では約5.514秒に機体の一部が左板端を越え、同じ床位置5通過のY変位は+16.57mmだった。内部近似再生の変位は+1.92mmで、物理ずれが残っている。取得改善をコースアウト防止の達成と同一視しない。末尾の未照合61/62msは延長経路の白線地図不足と再生で一致し、別の修正対象として記録した。

今回ファーム/SD設定は変更していない。詳細は[実走報告](../analysis/path_acquisition_220117/report.md)、証跡は同フォルダのvalidation.json。新条件での正常ログ終了は2本、動画確認は1本だが板外張出しがあり、コースアウトのない再現性10本の条件は未達。
