Kageyana/robotrace_v2/doc/light-log-43-columns.md

# 通常ログを43列へ整理

> この文書は43列整理期間の履歴。2026-10-14のユーザー指示で通常72列・183 Bへ戻した。現行仕様は[通常ログ72列への復帰](log-72-restored.md)。詳細87列と閉路X・減速処理は維持する。

2026-10-13、通常ログから初回SHADOW診断19列と横接線補正候補診断10列を外した。通常は43列・108 B/レコード、詳細は87列・220 B/レコードとする。CSV末尾の空列は列数に含めない。通常の記録部は183 Bから108 Bへ約41%減り、1行目のメタデータとコンテナ512 Bは別途必要となる。

通常ログには従来の43列を型・列順・意味を変えずに残す。左右エンコーダ、加速度XYZ、角速度XYZ、姿勢角XYZ、IMU温度、ラインセンサー10個、マーカー、目標速度・角速度、従来スリップフラグ、電圧電流、距離補正とXYを維持する。DISTANCE／SLIP／PATH／SHORTCUTの次走解析に必要な列は失わない。

新検出器と横補正候補の計算はSHADOWで続ける。IMU・制御・割り込みソースは前回ビルドのSHA256と一致する。判定の制御適用や閾値、ログ間隔、SD実書込みの責務を変更していない。新診断の区間カウンタの更新・保存成功後のリセットも既存どおり。

通常ログには`slipV2*`、`imuYawAlphaFiltered`、`imuLatTangentialApplied`を記録しない。検出器設定がメタデータにあっても、診断結果は「未記録」であり正常値0とは扱わない。新検出器を比較するときだけ`ROBOTRACE_LOG_SCHEMA_PROFILE_LIGHT=0`の詳細ビルドを使用する。

## 読込互換性

|世代|通常 列/B|詳細 列/B|固定列定義|
|---|---:|---:|---|
|診断追加前|43/108|58/145|`log_schema_legacy.h`|
|初回SHADOW|62/157|77/194|`log_schema_shadow_v2.h`|
|横補正候補追加|72/183|87/220|`log_schema_candidate_v1.h`|

これら6形式を現在の通常／詳細いずれのビルドからも読む。現行通常43列は診断追加前の通常、現行詳細87列は候補付き詳細と同一スキーマなので識別CRCも同じ。プロファイル・CRC・レコード長の組で厳密識別し、レコード長だけでは判断しない。読込バッファは通常108 Bのビルドでも最大220 Bを確保する。

保存済み72列ログを43列に変換し直すことはせず、元の列を保持してCSV化する。旧CSVも列名から読む。未知形式・不正サイズ・CRC不正は拒否し、CSV確定まで原本を保持する。

## ローカル確認

- `run_log_schema_tests.ps1`：通常43列/108 B・詳細87列/220 B、ヘッダと数値行・IMU/電流保存を確認。
- `run_slip_log_compat_tests.ps1`：通常／詳細の各読込ビルドで3世代6形式の非ゼロ診断値・元の列数・完全ヘッダ・CSV末尾値、DISTANCE/SLIP/PATH/SHORTCUT解析、CRC/サイズ/未知形式拒否、保存失敗、起動復旧、CSV確定失敗時の原本保持を確認。既存保存テストも内包する。
- 実際の`logBuildColumns()`で全列名と区切りを比較し、通常には新診断列がないことを確認。
- Debug／Release×通常／詳細の4構成ビルド成功。新規warningなし、予約スタック8 KiB、検出器状態1640 Bを維持。

|構成|RAM（予約領域込み）[B]|FLASH [B]|
|---|---:|---:|
|Debug通常|88,056|267,944|
|Debug詳細|88,056|271,600|
|Release通常|87,776|175,376|
|Release詳細|87,776|176,744|

ビルド・警告・ソースSHA256は`analysis/light_log_43_columns/build-validation.json`。DWT計測・書込み・実走行は行っていない。新形式の最初の実機ログでは43列、末尾電流、期待行数、cntlog、overflow、連続走行時の次走解析と終了時CSV変換を確認する。詳細87列の実機確認は詳細ログ取得時に別途行う。

## 2026-10-14 実機CSV確認

ユーザー指定13212～13227の全16本で、正規43列・全行43値・期待行数一致・有限値・cntlog単調・末尾左右電流を確認した。メタデータのスキーマCRC1504213192は43列/108 Bと一致し、5走連続3組の次走解析とCSV生成完了を確認した。元binのCRCと起動時復旧はCSVから独立には再検証できず、overflow診断値もCSVにないため有無を断定しない。詳細は`analysis/runs_13212_13227/report.md`。通常43列の実機形式確認は完了、詳細87列は未取得。
