Kageyana/robotrace_v2/doc/slip-turn-residuals.md

# 旋回時の縦・旋回残差の確認

2026-10-14、ユーザーから`slipV2YawDps`、`slipV2LongFast`、`slipV2LongSlow`が旋回中に変化するとの指摘を受け、13228～13247（各方式4本）を再評価した。ファームウェア・閾値・遅延・IMU補正・制御接続は変更していない。閉路Xと減速区間は対象外。

## 確認結果

DISTANCE4本のログ別RMS平均は以下。旋回区分は疎な記録から近似し、統計的有意差検定や無滑り真値の比較ではない。

|残差|単位|直進|旋回全体|定常旋回に近い区間|旋回過渡|
|---|---|---:|---:|---:|---:|
|LongFast|m/s²|2.73|3.66|2.12|5.29|
|LongSlow|m/s²|0.92|1.88|0.95|2.06|
|YawDps|deg/s|5.77|32.03|4.99|46.50|

- Yawは旋回過渡で増大し、DISTANCE4本の整列角加速度との相関は+0.558～+0.743。固定モデル・8ms整列・センサー内部帯域・タイヤの過渡が調査候補。相関値を遅延の実測としない。
- 縦10msは短い正負ピークへ強く反応し、30msで平滑化・相殺される。窓長・実効時刻が違うため、過渡で両者の波形一致を要求しない。
- DISTANCEの縦30msの符号付き平均は旋回全体約−1.09m/s²、直進約−0.09m/s²。既存のY位置補正は既に適用済みで、現在は`ω²×−0.03168m`。追加補正を新検出器へ重ねない。
- 定常に近い区間はDISTANCE4本合計546msと短い。姿勢変化、入力時間応答、左右車輪平均と機体速度の違い、実滑りを分離できていない。
- 区間ON時間から得る同時ONの境界は、DISTANCEで縦245ms・Yaw4722msのうち同時140～141ms、SLIPで縦114ms・Yaw1706msのうち同時81ms。各残差を同一現象の独立した確証として数えない。

## 評価上の制約

区分は30msへ整列した近似角速度と角加速度絶対値平均を使用し、符号相殺で過渡を定常と分類しない。直進は|ω|<50deg/sかつ活動<20rad/s²、旋回は|ω|>200deg/s、定常に近い区間は旋回かつ活動<20rad/s²、過渡は活動≥100rad/s²。区分は重複あり。無効行と開始・終端150msを除外する。区間ON時間の同時成立境界だけは全記録期間で集計する。

RMS・回帰・分類は疎な瞬時値の近似で、実1ms検出器の再生ではない。多数の相関した行を独立標本とするp値は計算しない。残差にも予測子にも同じセンサーを使うため、回帰だけで原因を確定したり係数を校正値へ転記したりしない。`events.csv`はONを含む隣接記録区間のまとまりで、1msの完全なイベント分割ではない。

Yawの時間整列・帯域と、縦のY位置補正・入力時間整列をそれぞれ確認する価値がある。実滑りとモデル誤差が未分離のためSHADOWを継続する。今回、新たな記録項目・実走行・DWT計測は要求しない。

解析結果は`analysis/turn_residuals_13228_13247/report.md`、図・状態別集計・回帰・イベント・同時ON境界・検証結果も同フォルダ。再実行は`python analysis/script/analyze_turn_residuals_13228_13247.py`。元CSV20本のSHA256は不変。

## 直線上のぶれと加速空転を分けた追加確認

ユーザー仮説は「直線減速時のYaw残差は機体のぶれ」「直線加速時のLongFastは縦滑り」であり、上記3列を同じ現象と見なすものではない。上記の直進区分は実角速度・角加速度が静かな区間を選んでおり、直線上でぶれた区間も旋回・過渡側へ入る。したがって、上記結果だけで物理コースの直線と曲線の原因差を論じない。

一次基準の実C計画ROCと二次ログのoptimalIndexから直線を選び直し、目標速度の増減で加速・減速を分けた。前後50mmの計画点も直線である内部を選んでも、13241の1.832～1.961秒では実角速度と操舵出力が左右へ4回反転、積算Yaw幅5.15deg、Yaw残差最大絶対値261.97deg/sを確認。減速時の車体ぶれを反映するという仮説と整合する。

同ログ7.549～7.567秒の直線加速ではLongFast正ピーク27.86m/s²、LongSlow正ピーク9.30m/s²、縦フラグ0・区間縦ON時間0ms。車輪加速度がIMU前後加速度を上回る短い縦空転候補として、減速Yawとは別に評価する。未記録の対地速度真値がないため滑りを確定せず、Fastだけの現象を現行両窓ANDと区別する。

詳細は`analysis/straight_accel_brake_13228_13247/report.md`。再実行は`python analysis/script/analyze_straight_accel_brake_13228_13247.py`。Windowsの既知DLL配置エラーはGCCで作ったホストexeの起動にも発生し、許可された制限外の同一コマンドで解析できた。今回の解析・分類手順以外の変更は行わない。

## 旋回進入Latと減速LongFastの時期

同じ二次8本でイベント境界へ整列した。初回`slipV2Lat`の進入後60ms／中央60ms／退出後60msの平均RMSは、DISTANCE39旋回で16.60／10.27／2.35m/s²、SLIP39旋回で9.43／7.55／2.06m/s²。走行単位でも8/8本で進入平均が中央・退出より大きい。横接線補正候補では特にSLIPの進入・中央の差が縮み、物理横滑りの確定とは区別する。

LongFastの時期は減速の定義で変わる。指令下降群を3等分すると最後1/3が強く見えるが、指令が平坦でも車輪速度は下がり続け、その後に指令がさらに下がる例がある。車輪平均速度の対称41ms平均から速度低下区間を取り直すと、DISTANCE56減速の開始側／中央／終了側のRMSは3.89／6.32／4.24m/s²、SLIP47減速では3.16／3.73／1.85m/s²。最大絶対ピークはDISTANCEで中盤に34/56、SLIPで開始側22/47・中央20/47に分布する。8/8走行で中央の平均RMSが開始側・終了側より大きい。

したがって「減速終了の瞬間に特に強い」とは扱わず、DISTANCEは減速中盤、SLIPは開始側～中盤を重視する。車輪速度の平滑化31/61msでも平均RMS最大は中央だった。終了時刻は車輪速度包絡による近似で対地減速真値ではなく、短いLongFastの応答窓や位相も含む。減速中の最大ピークは負側が多く、加速時の正側残差とは分ける。

詳細・イベント表・区分感度・原本と計画のハッシュは`analysis/slip_transition_timing_13228_13247/`、再実行は`python analysis/script/analyze_slip_transition_timing_13228_13247.py`。今回は前回生成した一次基準計画を再利用し、元CSV・計画・ファームウェア・閾値を変更していない。

## 低速一次13531～13533の曲線部：接線補正と時間応答

2026-10-18、ユーザー確認の横滑りなし一次3走を使用した。定常円コースは作成できないという条件に従い、既存コースの上側左右2曲線を全5通過、計30区間で比較した。CROSSの保存位置とraw左右平均距離をアンカーにし、一次13531の初回保存XYから共通の幾何窓を固定して前後50mmを含めた。残差・ON・角加速度の小ささで区間を選ばない。位置は推定であり、境界±20mmの感度も確認した。電圧差のみでは除外せず、目標約1m/sの13531/13533と約0.689m/sの13532を別に保持する。

実記録の初回横残差R0と候補残差Rcは同じvω・重力基準・5/30ms窓を使うので、接線項の同窓値Tbar=(R0-Rc)/2、接線補正除去の窓残差Rn=(R0+Rc)/2を代数算出できる。未記録の静止重力基準やバイアスを当てはめていない。これは生ADC値ではなく、浮動小数点加算順の丸めを除く線形関係であり、新しいフラグの1ms履歴を復元したものでもない。

全30区間で、候補補正は接線補正除去より残差RMSが小さく、境界±20mmでも90/90で同じ関係だった。例として13531右上は共通6.680、接線補正除去4.540、候補3.172m/s²（各5通過の時間重み付きRMSの平均）。補正を外すだけの対処は支持されない。一方、大きなXピークは接線項を取り除いた段階でも残る。13531の最大X記録行は41.287m/s²、適用Tは1.597、接線補正前Xは39.690m/s²だった。静止重力基準減算前の瞬時値を30ms残差と直接比較しない。

13531の左右最初の2通過ずつ計4区間で、Rn(t)-Tbar(t+delta)のRMSをdelta=-40～+40msから選び、残る26区間には選定値を固定した。線形近似は+9ms、前値/後値保持は+10msで、確認26/26区間のRMSが低下した。線形近似の平均は2.245→1.669m/s²、約25.7%低下。3補間×3境界×30区間の270/270でも低下した。これは適用接線項が加速度側に対して後ろへずれている可能性を支持するが、先の値を参照する非因果比較であり、そのまま実装できる補正ではない。

シフト後も線形近似の絶対残差最大7.141m/s²、30区間中10区間で6m/s²超が残る。閾値超過を実1msの継続ONとは同一視せず、時間だけで全誤検出が解消したとはしない。9～10msは疎な記録の近似から得た合成応答の診断値で、物理遅延の真値・採用定数ではない。IMU内部応答・取得位相・角加速度LPF・機械応答は未分離である。軸の物理方向も未確認。

ソースでは1ms内にgyro取得→accel取得→calcDegreesでオフセット/回転中心補正→検出器入力の順で、calcVelocityからの補正二重適用はない。αのLPFは0.8/0.2の一次式なので、1ms更新の極からの時定数は約4.48ms、95%応答は約13.4ms。既存ヘッダコメントの「約20ms」を厳密な時定数として使用しない。これを今回の有効な9～10ms差の単独原因とはしない。

元CSVの前回SHA一致、bin3本の全CRC、全ON815msの幾何窓への包含、代数関係、CSV有限値、図を確認。ファームウェア・設定・閾値・窓・遅延定数は変更していない。調査は`analysis/primary_turn_compensation_13531_13533/report.md`、図・表・protocol.json・validation.json・independent-validation.json。再実行は`analysis/script/analyze_primary_turn_compensation_13531_13533.py`と`report_primary_turn_compensation_13531_13533.py`。

### 補正項の遅れの原因別確認

続くユーザー依頼により、Xピークの大きさや閾値超過の解消ではなく、接線補正項の遅れを調査した。補正側はジャイロ内部フィルタ→1ms後退差分→alphaF=0.8*前回+0.2*今回→rY倍、加速度側には同じ追加LPFがない。追加LPF単体の低周波遅れは4ms、後退差分は連続微分に対して0.5ms。10/20HzではLPF単体の位相遅れ3.89/3.60msで、固定遅延ではない。正弦入力の時間領域演算と伝達関数の数値一致を検算した。時定数4.48ms・95%応答13.4msとは別の指標である。

前回と同じ30区間でgyroから接線項を再構成し、追加LPFあり/なしを同じ入力で比較した。線形近似の再構成接線項と実記録分離TbarのRMS誤差は各走0.023～0.026m/s²。最初の4区間で選ぶ必要シフトは、3補間ともLPFあり9ms→追加LPFなし5msとなった。残る26区間は再選定していない。線形近似の確認用平均RMSは時間シフトなしでも2.245→1.831m/s²。これにより観測された遅れの約4ms分を追加LPFへ切り分けられたが、実1ms入力の完全再現や実装修正の採用確認ではない。

現在コードはGYRO_BANDWIDTH=0x02（1000Hz/116Hz）、ACC_CONF=0xAC（1600Hz/Normal、X/Y280Hz）。[Boschデータ同期資料](https://www.bosch-sensortec.com/media/boschsensortec/downloads/application_notes_1/bst-mis-an006.pdf)p.3の典型群遅延は、ジャイロ1000Hzで2.5ms、BMI088加速度1600Hzで1.1ms、差1.4msで補正側が遅れる。個体の実測値ではない。ソフト低周波4.5msとこの典型差を足す約5.9msは目安であり、観測9～10msの厳密な収支ではない。

追加LPFなしでも残る約5msの全内訳は未確定。現行は1msポーリングでDRDY・sensor time同期なしのため、SPI読取完了時刻を内部測定時刻とはしない。共通5/30ms窓の16.5msを相対遅れへ重ねて数えない。同じ周期内の取得・演算経路に余分な1周期待ち・キュー・補正二重呼出しはなく、SPI5.625MHzのワイヤ転送はgyro約9.96µs/accel約11.38µsで、これだけで9ms差は説明しない。HAL実行時間・内部サンプル更新位相は未測定。BMI088のHAL_Delayは初期化経路のみである。

ファームウェア・設定は変更していない。ソース・ioc・メイン基板KiCad U8とBosch一次資料を確認し、入力SHA・全数値表・図・ソフト位相計算を検算した。詳細は`analysis/tangential_delay_sources_13531_13533/report.md`、delay_budget.json、references.json、reconstruction_quality.csv、lag_train_sweep.csv、lag_validation.csv、summary.json、validation.json、independent-validation.json。再実行は`analysis/script/analyze_tangential_delay_sources_13531_13533.py`と`report_tangential_delay_sources_13531_13533.py`。
