Kageyana/robotrace_v2/doc/line-sensor-curve-understeer-13191-13194.md

# センサー更新復旧後の旋回不足とPID試行

2026-10-14。対象ブランチは`codex/line-sensor-adc-phase`。ユーザーから「ラインをトレースするようになったが、カーブで曲がりきれずコースアウト」と報告あり。最新の一次走行13191～13194を診断した。

## 確認結果

| ログ | 行数 | 異なる10chベクトル数 | 電圧[V] | 終了理由 | 最初に全chが100未満となる位置※[mm] |
|---|---:|---:|---:|---|---:|
| 13191 | 277 | 277 | 7.15 | 3: エンコーダ停止 | 1230 |
| 13192 | 274 | 274 | 7.07 | 3: エンコーダ停止 | 1245 |
| 13193 | 284 | 284 | 8.32 | 3: エンコーダ停止 | 1235 |
| 13194 | 279 | 275 | 8.32 | 5: 暗部継続 | 1240 |

※距離1000mm以後の最初の該当サンプル。コースアウトの厳密な瞬間を測定する指標ではない。13194の同一ベクトルの連続は白線消失後の低い値を含む。全期間固定だった13187/13188とは異なる。CSVからADC公開周期や取得スキップ数は判定できない。

すべて一次・手動走行、修正版23:32:35ビルド、ライン/IMU校正有効。43列、行数はlogExpectedRowsと一致、数値有限、時刻と距離単調。距離刻みは4.05～5.48mmで5mm要求の1ms量子化に整合し、停止付近の時間間隔拡大だけを欠落と扱わない。失敗ログは完走性能の採用比較から除外し、診断に使う。

1050～1170mmのカーブ区間の中央値:

| ログ | 走行用P/I/D | 目標角速度[deg/s] | 実角速度[deg/s] | 左右目標速度への差分[pulse/ms] |
|---|---|---:|---:|---:|
| 13172（完走参考） | 5/0/12 | 821.5 | 499.0 | 51.0 |
| 13191 | 2/0/0 | 943.0 | 381.7 | 35.0 |
| 13192 | 2/0/0 | 907.0 | 349.9 | 35.0 |
| 13193 | 2/0/0 | 902.0 | 359.6 | 36.0 |
| 13194 | 2/0/0 | 943.5 | 368.6 | 36.5 |

全ログの目標速度はこの区間で58pulse/ms（約1.00m/s）。最新の実平均速度は約1.03m/s。13193/13194の最大絶対モーター電圧指令はこの区間で2.946/3.017V、ヘッダ電圧8.32V。少なくとも記録サンプル上、電圧指令の上限張り付きで旋回が不足した形ではない。記録間の飽和や物理的なタイヤ限界は否定できない。

約1170～1220mmで白線の最大反応が右端sensor[9]へ移り、その後全chが暗くなる。白線消失に伴い目標角速度も下がり、左右速度が揃う。これはセンサー配列が固定した結果ではなく、白線が受光範囲から抜けたときの現在の制御式の挙動。

13193/13194は満充電でも同じ位置で失敗したため、13191/13192の低電圧だけでは説明できない。旧完走13172は電圧8.29Vだが、校正値とファームウェアが異なる。ゲイン不足を優先調査する根拠はあるが、P/Dだけを原因として確定しない。従来slipFlag/slipFlagLatは最新2本で0。SHADOW診断列は未記録であり、無滑りの証明にはならない。

## SDカードへ反映した試行

ユーザーがSDカードをPCへ接続したと回答。G:/settingの実設定を確認し、走行用`lineomega.txt`だけを変更した。

```text
変更前: 002,000,000
変更後: 005,000,012
```

変更したのはP=2→5、D=0→12の2項目。I=0、開始前PID`line.txt`の14/0/60、速度PID12/0/3、速度表、校正値は維持した。コード既定値のKP6を変えてもSD設定が優先されるため、実機の設定を直接変更した。

変更前ファイルを解析フォルダへバックアップし、変更後を11byte・改行なしで再読込した。setting内の全ファイルをSHA256比較し、lineomega.txt以外の変更がないこととファイル数不変を確認した。SDの未確定ログや他のデータは操作していない。

制御式・割込み・ログ形式・緊急停止条件のコード変更はないため、本作業でのファームウェア再ビルド/書込みは実施していない。解析スクリプトは実行成功、入力CSVの解析前後SHA256一致、図を目視確認した。これは実機の新設定による改善確認ではない。

## 次の確認

SDカードを安全に取り外して機体へ戻し、再起動して設定を読み込む。まず同じ一次・手動走行、約1m/sで1本確認する。P=5/I=0/D=12が適用され、約1.2mのカーブを通過できるか、直線振動が増えないかを次のログで確認する。開始前PIDは調整しない。

まずカーブ通過を確認し、その後同じ条件で最低10本の完走率・停止位置・追従・タイムを比較して採否を判断する。新設定の実走行は未取得であり、完走や再現性の改善はまだ保証しない。

再実行: `python analysis/script/analyze_curve_understeer_13191_13194.py`

出力: `analysis/curve_understeer_13191_13194/`。summary.csv、curve-intervals.csv、validation.json、13193/13194-diagnosis.png、primary-comparison.png、lineomega-before/after.txt、sd-setting-change.json。

## 2026-10-14 完走結果

ユーザーから「現在のゲインで完走できた」と報告。新ログ13195～13211の17本すべてemcStop=0。13195～13199、13207～13211のオートスタート2組はそれぞれ1～5走が揃い、全走正常終了した。43列・期待行数一致・有限・時刻単調を確認。センサーベクトルは全走で多数変化し、一次6本は各行すべて異なる。入力ハッシュは解析前後不変。

一次走行のゲインは途中で変更されているため、17本を同じゲインの再現性検証とは扱わない。

| 一次ログ | P/I/D（終了時ヘッダ） | 記録最終時刻[s] | 電圧[V] | 閉路有効 |
|---|---|---:|---:|---|
| 13195 | 5/0/12 | 22.801 | 8.26 | 1 |
| 13200 | 5/0/0 | 22.863 | 8.05 | 1 |
| 13201 | 10/0/0 | 22.714 | 7.93 | 0（理由8） |
| 13204 | 5/0/5 | 22.813 | 7.80 | 1 |
| 13205 | 5/0/1 | 22.816 | 7.77 | 1 |
| 13207 | 5/0/1 | 22.762 | 7.63 | 1 |

表はCSV最終サンプルのcntlogで、ゴール瞬間の精密計測値とは区別する。13201は正常終了しているが閉路X誤差の判定に失敗し、PATH用経路元としては無効。最新オートスタートの一次13207は閉路有効。

以前失敗した1050～1170mmで、実角速度中央値は13194の368.6deg/sから13195の510.0、13207の513.6へ増え、カーブ通過と全周完走を確認できた。条件差があるのでD=12とD=1の優劣やゲイン単独の効果量は断定しない。

二次DISTANCE/SLIPのヘッダは2/0/0だが、control.cのchangeGain()に直線用P2/D0と保存ゲインへの切替がある。終了時ヘッダだけで全周ゲインが固定2/0/0だったと判断しない。PATH系と一次の角速度制御も同一として比較しない。

DISTANCE/SLIPの補正済みencTotalOptimalには各5回の後退段差がある。全てcourseMarker=0→非0と一致し、最大約48.5mmでCORR_STEP_MAX_MM=200以内。既存マーカー距離補正と整合し、CSV時刻逆行・欠落とは区別した。正方向刻みは現在速度の1ms量子化範囲に整合。SHADOW診断は未記録。

今回、実機設定・コードの追加変更は行わない。追従復旧・カーブ通過・完走は確認できたが、最新5/0/1の一次走行は2本のため、同条件最低10本の再現性確認と最適ゲイン採用は引き続き未完了。電圧が下がっており、タイム差をゲイン差だけに帰属させない。

再実行: `python analysis/script/check_completed_runs_13195_13211.py`。全走表・ハッシュ・XY/速度/角速度/センサー/従来スリップ図は`analysis/completed_runs_13195_13211/`。
