Kageyana/robotrace_v2/doc/失敗事例/2026-11-02-courseout-analysis-preflight.md

# 14061～14066解析での入口と閾値補間の検査

- 対象: コースアウト調査。status: resolved（解析手順）、open（物理原因の切分け）。
- 事実: Skill／過去記録に記載されたanalyze_path_curve_y_drift_detail.py、finalize_heading_002102.py、verify_shortcut_speed_20261101.pyを現在の実在一覧で照合せず読もうとし、不在で失敗した。資料に実在と書かれていても、このチェックアウトでは存在しなかった。ファーム／原ログは未変更。
- 原因: 文書上の過去の成功を現在の所在確認の代用にした。既存の実行前ルールが読み取りコマンドの作成時に適用されなかった再発。
- 対処: 実在するanalysis/scriptをrg --filesで列挙し、今回の独立CSV解析入口を作成した。ファイル不在の後にホスト実行・ビルドへ進んでいない。
- 別の事実: 最初の旋回閾値比較で符号反転した系列へ負の閾値を渡し、補間結果が全て区間先頭の約11202 mmとなった。標本出力の最初の閾値通過距離と矛盾して検出し、最初の交差を挟む2点だけの補間へ修正した。誤値を結論へ使用していない。
- 再発防止: 文書記載名にもPath.is_file/Test-Pathのゲートを適用し、不在なら既知親の実在一覧から選ぶ。閾値補間は単調性や符号を仮定せず、交差両端の不等式と出力範囲をassertする。今回のcrossingは5度/15度の合成入力と実9走で検査する。
- 確認: diagnose_courseout_14061_14066.pyの通常実行とquantifyが終了0。補間後の差は一次比約-9.4～+10.6 mmとなり、大きな共通先行がないという実標本と整合した。inputs.json/entry_metrics.jsonで全原本SHA・行数・実値を保全した。
- record-failures Skillは利用可能一覧および個人/repoのSKILL.md検索で見つからず、指定されたdoc/失敗事例へ直接記録した。ログ解析Skillにも今回の実行前ゲートを追加する。

## 2026-11-03：設計文書の検索先でも再発

- 対象：14084を起点としたマーカーなし距離補正の設計検討。
- 事実：未確認のdoc/path-fusion-white-observation.mdを複数パスのrgへ含め、不在エラーとなった。既存のpath-confidence-fusion.md等は読めたが、不在の文書を読めたとは扱っていない。ファーム・設定・原ログは未変更。
- 原因：実在確認を解析スクリプトには適用した一方、設計文書の名称を機能から推測した。従来の対策を文書の検索引数へ適用できなかった再発。
- 対処：rg --files docで設計文書を列挙し、実在するpath-confidence-fusion.mdと関連失敗記録・製品ソースから設計を確認した。record-failuresは個人/repoのSKILL.md一覧にも存在しなかったため、本記録へ直接追記した。
- 追加対策：両ロボトレースSkillが参照するdoc/skill-execution-preflight.mdの最初の検索手順へ、設計文書の実在一覧取得・全パスLeaf検査・不在時の呼出し禁止・rg終了コード検査を具体化した。
- 確認：既知の不在参照1件をLeaf検査が拒否し、実在する製品ソース2件・設計文書1件の全件検査が通ることを確認した。不在パスはrgへ渡していない。追跡文書のgit diff --checkと新規設計案のno-index空白検査も成功。status: resolved（今回追加した入口検査）、open（14084の物理原因と補正の実機効果）。
