Kageyana/robotrace_v2/doc/失敗事例/2026-11-03-planning-roc-preflight-and-edges.md

# ROC図面比較の入口、ホスト依存、経路端の検証

- 対象: 11/2・3の一次ROCと2026中部大会図面の比較、計画ROC平滑化。
- status: resolved（下記の手順失敗と経路端処理）。実機の形状差は未解決であり、`doc/planning-roc-filter.md`へ分離する。

## 確認した事実と対処

1. 過去のSkillにある`build/video-analysis-runtime`を存在確認せず列挙し、不在で失敗した。バンドルPythonではMatplotlib不在を事前確認済みだったが、旧配置を現環境にも仮定した。実在するPython3.14でNumPy/Matplotlibを検査し、グラフを生成した。
2. 複数ファイルの大きなパッチへ余分な空行を含め、pathFollower.cの照合で拒否された。git diffとシンボル検索で全ファイル未適用を確認し、小さいパッチに分割した。部分適用を仮定して後続を実行しなかった。
3. 既存path_commonホスト生成器に現在の`analysisDisplayPoll()`スタブがなく、Werrorで停止した。加えて、実距離解析の既存numStraight未使用がWextraで検出された。表示だけを無処理スタブにし、既存warningの種類だけ`-Wno-error=unused-but-set-variable`に限定した。製品式は変更していない。
4. 最終集計の不変確認が、PATHの延長点に既存の未設定半径0があることを考慮せず失敗した。0は新旧同位置であることを確認し、全点正数の仮定を「全点非負・0の位置一致」へ修正した。
5. PATHの平均窓を11点へ拡大した合成円試験で、端から5点目の半径誤差が失敗した。局所曲率自体が前後2点を使うのに、広い窓の半幅5点しか保護せず、端点の片側推定を平均に含めていた。製品の保護幅を`halfWindow+2`へ修正し、端では従来半径を使うようにした。閾値を緩めず、同じ円試験で成功を確認した。
6. CW/CCWを追加したfixtureで、符号intと半径unsignedの乗算がunsignedへ変換され、負方向だけ座標が巨大になった。変更前の製品でも同じ合成円が失敗し、fixtureの演算型が原因と確認した。乗算前に両方をfloatへ明示変換した。製品式や試験閾値は変更していない。

## 次回の実行前手順

- 過去のPythonや依存配置を使う前にTest-Path/is_dirを通す。今回確認したPython実体でも必要モジュールを検査する。
- パッチは直前に読んだASCIIコードをアンカーにし、拒否後はdiffで全対象の適用状態を確定する。
- ホスト化前に実ソースの呼出APIとfixture宣言を照合し、表示ポーリングの更新も確認する。既存warningは変更前にも存在する種類だけ限定して扱う。
- 半径0などの値域は生成元と延長部の契約を読み、新旧出力を別々に確認してからassertを作る。
- 複合窓の端保護は、広い窓の半幅に局所推定の半幅を加算する。定常円の端から内側まで、直線、符号反転、短い経路、非有限入力を試す。
- 合成幾何のCW/CCW生成では、負の方向符号とunsigned半径の乗算前に型を揃える。新旧双方の既知円で座標範囲と半径を確認する。

## 検証

`validation/planning_roc/run.py`で実Cの80再生・O0/O2一致・制御トレース一致・合成境界を確認。`report_roc_layout_20261103.py`で10原本SHA・実CソースSHA・形状と小Rの不変性を最終照合した。Debug/Releaseのビルド成功。Skillの実行前参照にも本記録を追加する。

record-failures Skillは個人Skill・プラグインの実在一覧に無かったため、プロジェクト指定先へこの形式で手動記録した。
