Kageyana/robotrace_v2/doc/失敗事例/2026-11-02-pathcurve-early-turn-false-goal.md

# 実白線より手前の旋回と約11.6 mでの誤ゴール

- status: open（物理原因・対処の実走確認待ち）。
- 対象: 14061、14064～14066。ユーザーは白線カーブより手前で旋回し、先にラインから外れてから減速・停止したと確認した。
- 事実: 14061はSHORTCUT_CURVE/一次14055、残り3本はPATH_CURVE/一次14063。右マーカー入口が11.519～11.536 m、SG終値2、emcStop0で11.647～11.661 mに記録終了。一次のゴール入口35.925/35.951 mと不整合。
- 事実: 4本ともpathLoopPeriod_mm=0で、全行のマーカー補正成立・補正距離が0。現行pathApplyMarkerCorrectionは周期0なら処理しない。旋回入口の操舵主成分は曲率FF。約11.5 mで明部がほぼ消えても内部偏差は約7～9 mm・TRACKINGだった。
- 原因候補: 実白線と推定自己位置／経路位相のずれを保持したまま仮想経路で旋回した可能性。直線方向を白線だけで拘束しにくく、今回マーカー補正も働かない。車輪距離基準の旋回開始は一次とほぼ同じで、先読みFF単独の過大先行や空転を確定したものではない。
- 停止の直接原因: コース途中の右マーカー判定をゴールとして数え、通常停止へ移る構造。誤ゴールは最初の逸脱の原因とは扱わない。何の反射を右マーカーとしたかは未確定。
- 次の調査: 独立位置基準／映像と融合自己位置・白線対応点を同期する。周期0での進行方向位置補正、FF先行量と窓幅、入口減速を分けて検証し、真のゴール付近との整合判定を別に検討する。停止閾値は緩和しない。
- 再発防止: SG2/emcStop0を物理完走とみなさず、一次ゴール距離・原本番号・ユーザー観測順序を照合する。マーカー補正は設定だけでなく周期と全行の適用実績を確認する。ログ解析Skillへ反映済み。
- 確認: 12 CSVの全行幅・有限性・期待件数・時刻・SHA一致、4対象61列と補正全0を確認。analysis/script/diagnose_courseout_14061_14066.pyの通常実行→quantify→evidence。詳細は[解析報告](../../analysis/courseout_14061_14066/report.md)。bin全CRC、全1 ms入力、実位置誤差量、実機効果は未確認。ファーム・SDは未変更。
