Kageyana/robotrace_v2/doc/失敗事例/2026-11-02-analysis-display-transfer-lifetime.md

---
type: codex-failure
date: 2026-11-02
task: 解析開始・終了時の画面転送競合対策
status: open
---

# 単発画面だけを保護し、解析切替時の連続DMAを見落とした

## 確認した事実

コミット8d12cd9は解析中の単発DMAをスナップショットから送っていたが、連続DMAは描画バッファを直接参照していた。`analysisDisplayBegin()`は停止要求の直後に描画バッファを消去・描画するため、最後のページが転送中ならDMA参照範囲を書き換える。また手動・自動の両呼出元は、結果画面を描く前に`analysisDisplayEnd()`を呼び、連続転送を再開していた。

保存した変更前Coreを新しいホスト試験へ渡すと、O0/O2とも送信開始時から完了時までのDMA参照データの一致検査と、結果描画完了後の再開検査に失敗した。これは意図した負例で、製品実機の画面の乱れを観測した結果ではない。

## 原因

前回試験は全画面スナップショットの不変性と終了時に待機しないことを確認したが、開始時に残る連続DMAの実ポインタ・範囲と、再開前の結果描画順序を確認しなかった。既知のDMAバッファ所有権の観点を切替境界まで適用できていなかった。

## 対処

- 連続転送の各ページも既存1KiBスナップショットへコピーしてから送信する。単発画面と同時使用しないため追加RAMは不要。転送完了後にだけ次のコピーを書き込む。
- 手動・自動とも、結果・カウントダウン画面の描画完了後へ終了処理を移す。転送待ちやdelayは追加しない。
- ホストのHAL模擬は、実際にDMAへ渡したポインタと長さを保持し、開始時と完了時の全バイトを照合する。異なる解析前画面を置き、全8ページ×コマンド/データ両段階で検証する。呼出元は成功・0件・エラーで最終表示内容の描画後にだけ終了できるよう検査する。

## 再発防止・確認方法

`validation/analysis_display/run.py`をリポジトリルートの明示workdir・既知のGNU実行権限で実行する。転送中に見えるソースの不変性を確認し、フラグの状態だけで合格にしない。変更前Coreを保存した場合は`--core build/analysis-loading-transitions/before/Core --expect-old-tearing`でも問題検出を確認する。AGENTS.mdの現行転送方式と書込み・デバッグSkillの検証前手順も更新する。

現行コードの全試験はO0/O2・Wall/Wextra/Werrorで成功し、同じ試験で変更前の2問題を検出した。コードの競合と検証漏れの対処はホスト確認済み。実機の切替表示と総解析時間の比較は未実施のためopenとする。

## 2026-11-02：実起動時の表示有効条件の検証漏れ

ユーザーから、解析開始後も画面が変わらないと報告があった。実コードの`initLCD`はfalseから更新されず、描画・DMAの検証以前に解析画面が無効になっていた。上記の試験成功を実機の表示成功へ拡張しない。現在のチェックアウトでは旧ハーネスが欠落していたため、`validation/analysis_display/run.py`を実起動フラグ・実描画・実DMAで再作成した。今回の入口には上記の旧`--core`/`--expect-old-tearing`オプションはなく、保存した変更前コードを使う負例も標準実行で確認する。原因と修正結果は[未更新フラグによる無表示](2026-11-02-analysis-display-inactive-initlcd.md)を参照する。
