Kageyana/robotrace_v2/doc/失敗事例/2026-10-04-shared-ram-host-harness-dependencies.md

---
type: codex-failure
date: 2026-10-04
task: DISTANCE・SLIP・PATHのRAM共有化とPC回帰検証
status: resolved
severity: low
tags:
  - codex/failure
---

# RAM共通化後のPCテスト依存と模擬ログを修正した

## 要約・発生状況

Windows MinGWで新しい回帰テストを追加し、既存バイナリログテストも再実行した。ファームウェアの全構成ビルドは成功したが、PC検証側の依存・モックに不備があった。

## 確認した結果と原因

- `sd_diskio_spi.h`の直接読込でDiskio_drvTypeDefが未定義。先にfatfs.hを読む必要があった。
- 模擬f_lseekの引数をDWORDにしてff.hのFSIZE_tと不一致。encMMもヘッダのint16_t宣言との不一致を修正した。
- MinGWは未使用関数にも未解決参照を報告した。新しい比較テストでは実際の計画関数を抽出して不要なMCU/UI依存を除いた。
- 模擬CSVに距離解析の必須列が足りず、SLIP最終indexも距離計画要素数を超えていた。列名を実際のパーサーに合わせ、SLIPを計画範囲内に収めた。
- MinGWのassertがダイアログ待ちになった。テスト固有の検証マクロでstderr出力後exit(1)するようにした。
- 既存run_log_deferred_tests.ps1のリンク対象に新規runMemory.cがなく、共有変数・関数が未定義だった。実装ソースをリンク対象へ追加した。

以上はPC検証用ハーネスの問題であり、実機でRAM破壊や走行異常を確認した事例ではない。

## 対処・再発防止

モックの型は対象ヘッダを参照して一致させる。FatFsドライバ宣言は必要な生成ヘッダを含めてから使用する。新規モジュール導入時はCMakeだけでなくローカルtestsの全リンク対象を検索する。CSVの必須列・計画要素数・optimalIndexの依存条件も事前確認する。Windowsの自動テストでは失敗時にGUIダイアログを待たない検証処理とする。

## 確認とステータス

run_distance_slip_memory_tests.pyで変更前後のDISTANCE/SLIP計画一致、run_pc_tests.ps1でPATH切替、run_log_deferred_tests.ps1で通常・詳細の保存/復旧と全方式の読込結果一致を確認した。ハーネス修正を同じ作業で反映済みのためresolved。testsは既存方針によりGit管理対象外。

## 2026-10-04 再発: SSD1306非同期DMAのホストテスト

CSV進捗表示の非同期化を検証する際、MinGWは未使用のssd1306_InitからのHAL_Delay参照も要求し、リンクが失敗した。未使用関数の除去だけに依存する対策では再発を防げなかった。HAL_Delayのモックを追加し、呼ばれた場合は検証失敗にすることで、非同期送信経路にdelayが入らないことも確認する。assertは標準エラーへ出力してexit(1)するマクロに置換した。

追加対策: 実装ソース全体を含むMinGWハーネスでは、リンク時に要求されるHAL関数を明示的に模擬し、検証対象で禁止する同期処理は呼出回数0または即失敗で確認する。run_ssd1306_dma_tests.ps1で単発DMAのコマンド→全画面送信、転送中のバッファ保持、開始失敗、他I2Cの完了無視、連続更新への復帰が成功した。対処・検証済み、resolved。

## 2026-10-04 再発: ラインセンサー校正のホストテスト

lineSensor.c全体のPCリンクで、未使用のSD処理とTIM3/ADC変数も未定義参照になった。セクション除去に依存したため、既存の再発防止策を初回ハーネスへ適用できなかった。対処として実ヘッダと型を合わせたTIM3/ADC変数とFatFs関数モックを追加した。SD関数が呼ばれたらstderr出力後exit(1)とし、校正完了処理のSD非依存も検証する。今後は実装全体をリンクするハーネスの作成前に、同一ソース中の外部変数と外部関数を洗い出し、未使用経路を含めてモックを用意する。run_line_calibration_tests.ps1成功によりハーネスの対処はresolved。

## 2026-10-12 再発: 旧SHADOWログ生成フィクスチャ

旧SHADOWスキーマへの変換テストでグローバル`slipShadow.result`に非ゼロ診断値を設定したが、読込後の有効値が0で検証失敗した。原因は保存補助`appendRecord()`がローカルのゼロ初期化`LogRecord`を作る契約であり、実際の`writeLogBufferPuts()`と異なってグローバル診断値を参照しないことだった。デコーダの欠損ではない。

従来の型・リンク依存チェックだけではフィクスチャの値の供給元を確認できず、仮定の再発を防げなかった。追加対策として、旧形式生成関数でパックする直前のレコードへ既知の非ゼロ診断値を明示的に設定した。実書込関数のスナップショット検証は別の`testShadowRecord()`で維持する。新しい検証では「実関数経由で取得する値」と「合成レコードへ直接設定する値」の供給元を事前に区別し、非ゼロ値の読戻しまで確認する。

`run_slip_log_compat_tests.ps1`の通常・詳細両ビルドで旧2世代/両プロファイルの非ゼロ診断読戻し、元のCSV列保持、計画・復旧・破損拒否・原本保持が成功したためresolved。ファームウェアの演算変更は不要だった。

同日のCSV列名修正テストでは、`resetMock()`だけで列生成バッファも初期化されると仮定して全列一致が失敗した。実際の呼出側が行う`columnTitle[0]=formatLog[0]=0`をテストにも追加して両プロファイル成功。呼出元が担う初期化契約もフィクスチャ事前確認へ含める。製品側ヘッダ切詰めとは別のテスト前提の問題で、対処検証済み。

## 2026-10-26：完全逸脱停止の単体試験へ無関係な既存関数を含めた

emergencyStop.c全体をMinGWのWall/Wextra/Werrorで取り込む初期ハーネスが、変更していないjudgeOverSpeedの符号比較で停止した。さらにモックのencCurrentN/targetSpeedをint/floatと仮置きしており、実際のヘッダint16_t/uint8_tに一致していなかった。実機停止ロジックの失敗と混同しない。

対処は単体試験の責務を変更した明暗判定・リセットの実関数と実ISR条件へ限定し、ソースから抽出すること。無関係な速度・経路ロスト判定は発火しないモックと明示し、製品の比較式やwarningオプションを緩めて通さない。全モード・19/20ms・各センサー境界・交差部・端だけライン・飽和・既存明部仕様のO0/O2試験が成功した。ARM全3構成も新規warning0。

次回は生成前に対象関数・実グローバル型・ISR統合の試験範囲を表にし、既存の「単体は実関数抽出」の対策を初回から適用する。全モジュールの厳密警告整理は別作業にする。証跡はvalidation/emergency_line_loss/run.pyとbuild/emergency-line-loss/host-validation.json。今回のハーネス修正はresolved。

## 2026-11-02：全一次ログの経路生成で未使用依存をGCへ任せた再発

ショートカット高速化前後を11/1の全一次ログで比較するため、pathFollower.c全体を取り込んだ。初回は`-ffunction-sections/-fdata-sections`と`--gc-sections`で未使用の走行制御・設定保存を除けると見込み、ラインセンサー・slipV2・setTargetAngularVelocity・FatFs・sdRepairSparseSettingsのリンク依存を残した。MinGWのO0リンクは未定義参照で停止し、再生成は始まらなかった。既存の「未使用経路も明示的に模擬する」対策を初回へ適用できなかった再発で、製品や原本の破損ではない。

実ヘッダでvolatile・構造体・FatFs引数・size_tの宣言を照合し、未使用の実機/設定APIには呼ばれたらCHECKで終了するスタブ、必要なグローバルには実型の定義を追加した。実経路生成・白線地図・曲率・延長処理は変更していない。解析側でだけ型付きCSV読込を提供し、原本bin CRCの検証と区別した。

再発防止は、全ソースをホスト化する入口で未使用公開関数の外部依存まで先に列挙し、型付きスタブの表を作ること。リンカGCを未定義参照の対処と見なさない。今回の入口は`analysis/script/verify_shortcut_speed_20261101.py run`。O0/O2の33一次×2方式×初回/キャッシュ再利用を完走し、旧新全264比較の一致、呼出禁止スタブの非実行、84原本SHAの不変を確認したため、ハーネス依存の対処はresolved。実機・bin CRCの検証は今回の範囲外。
