Kageyana/robotrace_v2/doc/失敗事例/2026-08-11-windows-rg-glob-not-expanded.md

---
type: codex-failure
date: 2026-08-11
task: "Skill frontmatter の確認"
status: resolved
severity: low
tags:
  - codex/failure
  - windows
  - shell
---

# PowerShellでUnix風globを前提にしたrg確認が失敗した

## 2026-10-18 手動一次参照メタデータ調査での再発

`Core/Src/path*.c`と`Core/Inc/path*.h`をrgのパス引数へ渡し、os error 123が再発した。既存の事前確認を読んでいたが、検索コマンドへ適用できなかった。同じシェル内の後続読込が成功して呼出し全体の終了コードは0となったため、検索自体の失敗を終了コードだけでは判別できなかった。原本・ファームウェアへの影響はない。

ディレクトリを検索ルート、パターンを`-g`へ分けて所属ソースを取得した。再発防止として`analysis/script/search_firmware_sources.ps1`を追加した。検索ルートは実在するCore/SrcとCore/Incに固定し、パターンは常に`-g`へ渡す。rgの終了コード2以上は後続処理へ進まず例外にする。PowerShell用ファイルはUTF-8 BOM付きで保存する。

確認は`powershell.exe -NoProfile -ExecutionPolicy Bypass -File analysis/script/search_firmware_sources.ps1 -Pattern 'routeBuildFromLog|pathRouteSourceLog' -FileGlob 'path*.c'`。実ソースの一致行と終了コード0、BOMを確認した。ビルド・デバッグSkillの調査前手順にもこの固定ルート検索を追加し、今回の回避策はresolved。全ソース検索の一般化やファームウェア変更はこの記録へ含めない。

## 2026-10-15 CSV変換中のモーター指令調査での再発

`Core/Src/interrupt*`をrgのパスに渡してos error 123、存在未確認の`buzzer.c/.h`を指定してos error 2が発生した。既存の事前列挙対策を適用できていなかった。実在する`Core/Src`全体を検索し、1ms処理が`timer.c`、ホイールクリック出力が`setup.c`にあることを確認した。追加の予防手順として、モジュール名が不明な初回検索は必ず`rg -n '検索語' robotrace_v2/Core/Src -g '*.c'`とし、個別ファイルへ絞るのはその結果に実在パスが出た後だけとする。同形式で`void wheelClick`の検索と終了成功を確認したためresolvedを維持する。ファームウェアの変更・実機操作は行っていない。

同日のSD高速化案調査でも、存在を確認せず`FATFS/App/ffconf.h`、`Core/Src/log.c`、`Core/Inc/log_buffer_writer.h`、直下`.vscode/tasks.json`を指定して読込・検索が失敗した。初回の事前列挙が徹底できていなかった。`rg --files`で実在する`FATFS/Target/ffconf.h`、`Core/Inc/logBufferWriter.h`を確認し、ログ実装は実在ディレクトリの検索から`SDcard.c`と特定、タスクは存在するファームウェア側`.vscode/tasks.json`を確認した。次回はツール呼出しを「一覧取得」「取得結果の実在パスによる読込」の2段階に分け、同一呼出し内で一覧を待たず推測パスを追加しない。実在パスでの設定・ログ実装取得に成功し、resolvedを維持する。

## 2026-10-15 Fast単独版の実走確認での再発

13248～13256の事例検索で`doc/失敗事例/2026-10-14-*.md`をパス引数へ渡し、os error 123が再発した。前回の注意事項だけでは初回呼出しへの反映が不十分だった。実在ルートと`-g '2026-10-14-*.md'`へ分離して関連記録を取得した。走行CSVの解析・原本には影響していない。

追加対策として`analysis/script/search_failure_notes.ps1`を作成した。検索ルートを実在する失敗事例フォルダへ固定し、絞込み文字列を常に`-g`へ渡す。次回の事例検索は`powershell.exe -NoProfile -ExecutionPolicy Bypass -File analysis/script/search_failure_notes.ps1 -Pattern 'metadata|cntlog|直線' -FileGlob '2026-10-14-*.md'`を使う。上記コマンドで関連記録の取得と終了成功を確認し、resolvedを維持する。

同補助スクリプトの初回実行は、日本語文字列を含むUTF-8 BOMなしの`.ps1`をWindows PowerShell 5.1が既定コードページで解釈し、引用符終端のParserErrorになった。UTF-8 BOM付きへ保存し直すと同じコマンドが成功した。このWindows PowerShell用補助はBOM付き保存を維持し、変更後は実際の`powershell.exe -File`で日本語パターンとワイルドカード絞込みの組合せを検証する。ファームウェアのCソースの文字コード規約は変更しない。

## 2026-10-14 追加ログ解析での再発

過去事例検索へ`doc/失敗事例/2026-10-14*`をパスとして渡し、os error 123が再発した。既存対策を初回呼出しへ適用できていなかった。`rg -n -g '2026-10-14*.md' 'メタデータ|小数|時刻|区間|閉路' doc/失敗事例`へ修正し、整数メタデータ・補正距離・マーカーの関連事例を取得できた。対処検証済みでresolvedを維持する。検索コマンドのパス引数は実在ルートだけとし、`*`を含む場合は実行前に必ず`-g`へ移す。同時に走行CSV探索は数値ファイル名だけを列挙する`check_additional_logs_13238_13247.py`の`discover()`へまとめ、型変換前に対象を選別する。

## 2026-10-12 次作業提案時の再発

SLIP関連の過去事例検索で、`doc/失敗事例/2026-10-*-*log*`等をrgのパス引数へ渡し、os error 123が再発した。既存対策を検索呼出しへ適用できていなかった。検索ルートを`doc/失敗事例`、絞込みを`-g '*log*.md' -g '*slip*.md'`へ変更し、関連事例を取得できた。対処検証済み、resolvedを維持する。次回はrg呼出し前にパス引数の`*`有無を確認し、存在するディレクトリと`-g`へ分離する。

## 2026-10-04 自動開始前校正調査での再発

同日の復帰再調査でCore/Inc/BMI088*を検索パスへ渡してos error 123が再発した。再発防止策が適用されていなかった。Core/Incをパスとし-g 'BMI088*.h'へ切り替えてジャイロ定義の検索成功を確認した。今後、検索パスは実在ディレクトリまたは実在ファイルのみとし、パターンは必ず-gへ渡す。

`Src/{setup,control,lineSensor,interrupt}.c` のBash形式の波括弧展開をPowerShellへ渡してParserErrorとなった。また、推測したinterrupt.cは存在しなかった。Srcディレクトリを検索してInterrupt1msの実装がtimer.cにあることを確認した。既存対策の適用漏れであり、今後はrgの検索パスを実在ディレクトリ＋-gへ限定し、対象ファイル名を推測しない。ディレクトリ検索で対処確認済み、resolvedを維持する。

## 要約

Skill frontmatter を確認するために `rg -n "^name:|^description:" .agents/skills/*/SKILL.md` のような Unix シェル前提の glob 指定を使い、Windows PowerShell では期待通り展開されず確認コマンドが失敗した。後続で検索対象をディレクトリにする方法へ切り替えて確認した。

## 発生した状況

- タスク: `.agents/skills/*/SKILL.md` の frontmatter 検証
- 実行環境: Windows PowerShell
- 前提条件: Unix 系シェルのように `*` がファイルパスへ展開される想定だった

## 何を試したか

1. `rg` に `.agents/skills/*/SKILL.md` を渡して frontmatter を検索した。
2. パス glob が期待通り処理されず、確認に失敗した。
3. `rg ... .agents/skills` のようにディレクトリを対象にする形へ変更した。

## 結果・エラー

具体的なログは保存していないが、Windows のパス glob 前提違いにより確認コマンドを再実行する必要があった。

## 原因

PowerShell と Unix シェルでワイルドカード展開の挙動が異なる。特に外部コマンドへ渡すパス glob は、期待通りに展開されない場合がある。

## 解決・回避策

`rg` には glob 付きファイルパスではなく、検索ルートディレクトリ `.agents/skills` を渡して確認した。必要な場合は `Get-ChildItem -Recurse -Filter SKILL.md` で対象ファイルを列挙する。

## 今後の予防策

- Windows PowerShell では Unix 風のパス glob を前提にしない。
- `rg` は検索対象ディレクトリを渡し、必要なら `-g` オプションを使う。
- ファイル一覧を厳密に作る場合は `Get-ChildItem` を使う。

## 関連

- 関連ノート:
- 参考リンク:

## 2026-10-13 ADC位相調査での再発

KiCad検索で`Circuit/.../*.kicad_sch`をパス引数へ渡し、os error 123が再発した。ディレクトリを対象に`-g '*.kicad_sch'`へ変更し、部品値・TIM3_CH3・左右マーカーと電源ラベルを取得できた。既存対策を初回コマンドへ適用できなかったため、次回は検索実行前にパス引数に`*`や`{}`がないことを確認し、パターンを必ず`-g`に分離する。対処検証済み、resolvedを維持する。

## 2026-10-03 再発と追加確認

yI検証で `rg ... robotrace_v2/Core/Inc/*h` を渡してos error 123が再発した。既存の対策がそのコマンドで適用されなかった。検索を `rg ... robotrace_v2/Core/Inc -g '*.h'` へ変更し、main.hとmarkerSensor.hのGPIO定義を取得できた。今後の検索はファイル列挙後に実在パスを使うか、ディレクトリ＋-gに限定する。存在を推測したlocalization.cも使わず、rg --filesで実装の所在を確認する。対処を検証したのでresolvedを維持する。

## 2026-10-03 周回ドリフト調査での再発

周回ドリフト調査でもSrc/*.cを検索パスに渡してos error 123が再発し、推測したsystem.cも存在しなかった。ディレクトリと-g '*.c'による検索でcalcXYcieの呼び出しがSDcard.cにあることを確認した。検索コマンドを組み立てる際は実在ファイルかディレクトリだけをパスとして渡す。対処を確認済み、resolved。

## 2026-10-03 IMU・距離・時刻切り分けでの再発

Src/log*をパスに渡した検索でos error 123、推測したtim.cで存在しないエラーが再発した。既存対策が適用されていなかった。ディレクトリ＋-gによる検索でwriteLogBufferPutsがSDcard.c、割り込み優先度がstm32f4xx_hal_msp.c、TIM6呼出しがmain.cにあることを確認。ファイル名を推測する前に`rg --files robotrace_v2/Core/Src`で一覧を取得し、検索呼出しのパス引数にワイルドカードを含めないことを再確認した。対処検証済み。

## 2026-10-13 ログ項目整理での推測ファイル名の再発

ログ読込処理を調べる際、存在を確認せずlogReader.c/.hを検索対象へ指定し、os error 2となった。既存の事前列挙を適用できていなかった。`rg --files robotrace_v2/Core`で実在するcourseLogCsv.c/.h、logSource.h、logBinary.hを確認し、実読込がSDcard.cにあることも検索で確認した。次回は新しいモジュール名を検索パスへ追加する前に、必ずrg --filesの結果と照合する。対処検証済み、resolvedを維持する。

## 2026-10-18 閾値再選定時の推測名の再発

`reevaluate_xy_yband20_13472_13479.py`、`check_slip_lat_threshold_parity.py`、`reviewed_labels.json`等の推測名をGet-Contentへ渡し、存在しないエラーとなった。既存の事前列挙を適用できなかった。実在する`reevaluate_xy_y_band_13472_13479.py`、`run_slip_lat_video_threshold_tests.py`、`video_label_review.json`はrg --files/Get-ChildItemで確認してから読み直した。過去の解析フォルダごとに成果物名が異なり、別系列の同名ファイルを仮定しない。再発防止参照へ、履歴のパスも列挙結果と照合してから読む手順を追加した。正規パスでの読取と41走の解析・実C検証で対処確認済み、resolvedを維持する。

## 2026-10-19 縦時間応答調査でのspi.c推測の再発

対象タスクは縦スリップ残差のセンサー時間応答切り分け。未確認のrobotrace_v2/Core/Src/spi.cをrgの対象へ指定し、os error 2となった。iocの検索自体は成功したが、生成先の分割形式を名前から推測した点で既存対策を再適用できていなかった。解析値やファームウェアへの影響はない。

対処はSrcディレクトリ＋-gへ限定した検索で、main.c:469のMX_SPI2_Init、同487の8分周とiocの5.625MHzを確認した。ペリフェラル初期化の調査では、CubeMXの分割生成を仮定してspi.c/tim.cを検索パスへ指定しない。最初に `rg -n "MX_SPI2_Init|BaudRatePrescaler" robotrace_v2/Core/Src -g "*.c"` のように実在ディレクトリを検索し、結果に出たファイルだけを読む。このプロジェクトのSPI2初期化はmain.cに存在する。

ログ解析Skillの実行前確認と再発防止参照へ同じ入口を追加する。指定した正規検索は終了コード0、main.cの実在と定義・分周行を確認済み。Skill/参照の既存内容を保持した追記を検証する。検索手順の対処はresolved。内部センサー応答・実縦滑りの未確定事項とは別である。

## 2026-10-21 V2移行調査での過去スキーマ名の再発

旧資料の`Core/Inc/log_schema_candidate_v1.h`を現チェックアウトにあると仮定してrgへ渡し、os error 2となった。現行の`log_schema.h`, `logBinary.h`, `logSource.h`は`rg --files robotrace_v2/Core/Inc -g "log*"`で列挙して存在を確認できた。ファームウェアや解析値への影響はない。

過去資料に記載された凍結スキーマ名も存在確認の対象とし、ログ解析Skillの再発防止参照へ入口の列挙コマンドを追記した。新しいV2のみのコードは現行スキーマを正とする。列挙成功と現行ファイルの参照、全構成ビルド・通常/詳細ホスト計画検証を確認し、検索手順の修正はresolvedとする。

## 2026-10-25 ショートカット設定メタデータ調査での再発

7項目追加の調査でも、実在未確認のrobotrace_v2/validationを検索パスへ含めos error 2となった。既存の存在確認策を適用できなかった。Test-Pathでリポジトリ直下のvalidationを確認し、実在ルートの検索からvalidation/log_storage/run.pyとcheck.cを取得した。次回はファームのCoreと検証ディレクトリが同階層だと仮定せず、検索ルートごとに存在確認する。修正検索成功、対処確認済み。

対象タスクはPATH_DEFAULT_MAX_LEVEL～PATH_DEFAULT_LINE_THETA_GAIN_X1E9のログ保存有無の確認。検索パスにCore/Src/log*とCore/Inc/log*を渡し、os error 123が再発した。既存のglob分離対策をコマンドへ適用できなかった。後続読込の成功で呼出し全体の終了コードは0となったが、検索の標準エラーで失敗を確認した。

対処は実在するCore/Srcを検索ルートにし、-g '*.c'へ分離した検索で設定参照と保存処理を確認すること。修正検索は終了コード0で成功し、SDcard.cのlogBuildMetadataを直接読んで7設定の出力がないことを確認した。予防は検索前に全パス引数のワイルドカードを点検し、検索結果と標準エラーを個別に確認すること。一般ソース調査での失敗であり、ファームウェア・設定・ログ原本の変更、関連Skillの変更はない。検索手順の対処確認済みにつきresolved。

## 2026-10-24 main整理候補調査での再発

対象タスクはmainの不要機能・統合候補の静的調査。共通事前確認を読んだ後にも、`robotrace_v2/tests/run*`と`robotrace_v2/tests/slip*`をrgのパス引数へ渡し、os error 123が発生した。また、最初の一覧取得では存在未確認の`shared`を検索パスへ追加し、os error 2が発生した。原因は既存のディレクトリ確認・glob分離ルールを初回コマンドへ適用できなかったこと。ファームウェア・設定・ログ原本の変更はない。

対処は実在する`robotrace_v2/tests`をルートとし、`-g 'run*' -g 'slip*'`へ分離して検索した。終了コード0と旧検出器テストの一致行を確認した。再発防止は、複数検索を組み立てる前にすべての検索ルートへ`Test-Path -LiteralPath ... -PathType Container`を実行し、パス引数の`*`・`?`を除去して`-g`へ渡すこと。再検索の実行結果を個別に確認し、後続の成功で検索失敗を見落とさない。今回の修正コマンドは検証済みのためresolvedを維持する。Skill実行中の失敗ではなく一般のソース調査で発生したため、無関係なSkillへの手順追加は行わない。

## 2026-10-25 PATH_CURVE調査での再発

対象は新走行モードとLOG画面の実装調査。PowerShellへ`Core/Inc/{courseAnalysis,pathFollower,...}.h`を渡し、シェルの構文解析でMissing argumentとなり検索は実行されなかった。共通事前確認のBash展開禁止をコマンドへ反映できなかった再発である。修正は実在する`robotrace_v2/Core/Inc`を検索ルートにして`rg -n 'PATH|SHORTCUT|curvature|BOOST_' robotrace_v2/Core/Inc -g '*.h'`を使った。終了コード0と該当ヘッダの一致を確認した。今後は検索パスに`*`・`?`だけでなく波括弧もないことを組立時に確認し、ディレクトリと`-g`へ分ける。一般のソース調査で発生したため分野Skillへの変更は行わない。対処確認済み、resolvedを維持する。

## 2026-10-28 動画ユーティリティ名の推測

13872～13875の解析で、既存ラッパーから基本関数を探す際にtrack_video_path_curve_13810_13816.pyという存在しない名前を推測して読込に失敗した。既存の存在確認策を適用できなかった。ラッパーの実importを読み、実在するanalyze_video_path_curve_13810_13816.pyへ切り替え、4動画の校正・追跡が終了コード0で成功した。今後は対象ラッパーのimportから実体を解決し、Test-PathまたはPath.is_fileを確認してから読む。ログ解析Skillの実行前へ反映した。status: resolved（参照手順）。

## 2026-10-28 ADC取得調査での再発

13878の計測後に取得実装を探す際、存在しないCore/Src/sensor.cを複数ファイル検索へ混ぜ、os error 2が再発した。既存の存在確認策を検索組立へ適用できなかった。Core/Srcディレクトリだけを渡す検索へ修正し、lineSensor.c内の取得状態・棄却・HAL開始処理を確認した。再発防止としてsearch_sensor_acquisition.ps1を作り、入口で実在ディレクトリを確認し、-gへファイル形式を分離する。ログ解析Skillにこの実行点を追加した。修正検索とスクリプト実行で終了コード0を確認し、参照手順はresolved。取得遅延の実機原因は別途open。

## 2026-10-28 終端照合調査での再発

解析器名analyze_path_timing_13876_13878.py、ヘッダ名pathPolicy.hを推測して検索パスへ渡し、存在しない対象でos error2となった。実在ディレクトリへのrg --filesとシンボル検索へ戻し、replay_path_fusion_13876_13878.pyとpathFollower.c内のstatic関数を確認した。以後の今回解析はprepare_analysis_path_acquisition_220117.pyで実在する生成元の読込・構文/名前検査を行い、終了コード0を確認してから起動した。ログ解析Skillの入口へシンボルのヘッダ分離を仮定しない条件を追記する。status: resolved（参照経路）。

## 2026-10-30：RAM計測の確認で下位モジュールフォルダを推測

対象はRAM計測の理由幅の確認。Core/Inc/slipを推測してrgへ渡し、存在しないためos error2となった。実在Core/IncをTest-Pathで確認して検索へ戻し、slipDetection.hの実理由フィールドがuint16_tであることを確認した。製品や成果物は未変更。既存の存在確認が手組み検索の実行点に適用されなかった再発である。次回は実在する親と-gから検索し、下位名を機能名から構成しない。今回の機械検証はrecord_path_input_capture_search_preflight.pyで既知親のis_dirと実宣言検索の終了0を先にassertする。ログ解析Skillの実行前にも追加。status: resolved（参照と理由幅）。実機原因は別途open。

## 2026-10-31：ルートにもtasks.jsonがあると仮定した

版21の最終採用確認で、ルートの.vscode/tasks.jsonを存在確認せずrgの複数パスへ含め、os error2となった。ErrorActionPreference=Stopでもnativeコマンドの非0終了は停止せず、その呼出し内の後続読取りも実行された。製品・実機は未変更。既存の実在一覧取得とnative終了コード確認を実行点へ適用しなかった再発。

rg --files .vscode robotrace_v2/.vscode -g '*.json'で再取得し、tasks.jsonはファーム直下だけにあることを確認してから実ファイルを読んだ。ルートsettings.jsonの古いsourceDirectoryも発見し、実在するワークスペース相対パスへ修正した。共通事前確認へVS Code階層の実在一覧とrg終了2以上での停止を追加した。一般の設定確認であり、無関係な分野Skillは変更しない。status: resolved（参照先と事前手順）。

## 2026-11-01：経路モードの先読み減速調査での再発

対象タスクはPATH・SHORTCUT・PATH_CURVEの先読み減速の静的確認。rgのパス引数へCore/Src/path*.cとCore/Inc/path*.hを渡し、os error 123が再発した。既存のglob分離ルールを初回検索へ適用できなかった。実在するCore/Src・Core/Incを検索ルートとし、-g 'path*.c' -g 'path*.h'へ分離して再検索し、終了コード0とpathBuildSpeedProfileの一致を確認した。再発防止は初回検索をディレクトリ＋-gで組み立て、パス引数に*・?があれば実行前に除くこと。製品コード・実機・設定値は未変更。record-failures Skillはローカル個人・repo Skill一覧で見つからなかったため既存記録へ直接追記した。一般のコード調査であり分野Skillの変更は行わない。status: resolved（検索手順の修正を確認）。

## 2026-11-01：先行減速実装の検証器参照での再発

対象タスクは経路3方式へのdecelLeadMm適用。過去のビルド記録からvalidation/stop_motor_hold/run.pyの存在を仮定して読込み、さらに同ディレクトリへのrgでos error 2となった。直前のrg --files validationの実在一覧には対象がなく、一覧を後続読込の必須条件へ使わなかったことが原因。製品ソースの変更前に起きた調査失敗で、既に終了した変更前ビルドは反復していない。実在一覧からpath_common/build.pyとgoal_marker_stop/build.pyを読み、新しい検証器をvalidation/path_decel_leadへ作成した。入口でコンパイラ・Ninja・変更前Coreの存在と実モード宣言を検査し、変更前後4構成と実CのO0/O2テストを終了0で確認した。再発防止は過去文書の検証器パスを実在一覧へ照合してから別呼出しで読み、一覧にない対象は読まないこと。flash-debugの再発防止参照へこの実行点を追記する。record-failures Skillは本セッションの既確認一覧に存在しないため既存記録へ直接追記。status: resolved（参照経路と検証器の実行確認）。実機の制動・再現性は未確認。

## 2026-10-31：ショートカット設定調査で補助ファイル名を推測

対象は13950～13954の失敗に対するShortcut設定の改善余地の確認。実在一覧を得ずにpathGeometry.h/cをrgのパス引数へ指定し、両方でos error 2が発生した。実装はpathFollower.c内にあり、既存のファイル名推測禁止を今回の任意追加検索へ適用できなかった。後続の別検索が成功したためシェル全体は終了0だったが、当該検索は失敗である。

対処は実在するCore/Src・Core/Incを検索ルートにしてpathCurvatureAtArcWindowとPATH_CURVE_YAW_PREVIEW_TIME_MSを検索し、pathFollower.c/hに定義があることを確認したこと。再発防止はtuning Skillの実行前へ、補助ファイル名を構成しないこと、シンボルから実在ファイルを確定する具体的なコマンド、rg終了2以上で後続を止める条件を追加する。修正検索の終了0と定義箇所を確認したため検索手順の対処はresolved。ファームウェア・設定は未変更で、走行改善の実機効果は未検証。

## 2026-11-01 PATH_CURVE直線内減速調査での再発

共通事前確認を読んだ後にも、rgのパスへCore/Src/path*を渡してos error123。続く検索ではルートにないCMakeLists.txtと未確認の解析スクリプト名を含めos error2。既存のglob分離・存在確認をコマンドへ適用できなかった再発。原本・製品コードへの変更はない。

対処は実在Core/Srcへ-g 'path*.c'を付けた検索。pathBuildSpeedProfile等の定義を終了0で確認した。再発防止としてanalysis/script/search_pathcurve_sources.ps1に既知ルート存在検査・glob分離・native終了2以上で停止を固定し、ログ解析Skillの実行点へこの入口を追加。初回wrapper実行は共通手順の-ExecutionPolicy Bypassを落としてAuthorizationManagerで停止したため、共通手順と同じpowershell.exe -NoProfile -ExecutionPolicy Bypass -Fileで確認する。端末のポリシーやACLは変更しない。status: resolved（修正検索・入口確認）。
