Kageyana/robotrace_v2/doc/失敗事例/2026-11-01-pathcurve-diagnostic-capacity-contract.md

# PATH_CURVE診断用C再生成の容量契約

- 対象: 10/31の直線内減速調査（13942/13949/13955）。
- 確認結果: 初回PC再生成は終了5（pathAppendRouteSample容量判定）で停止。現行容量1514点に対し、一次CSVの長さ約33.9mは20mm間隔で約1700点となる。13965の実保存index最大1705も現行容量を超える。実走時ビルドの配列容量と配置は未照合。
- 原因: 実走対象の入力長・最大indexと抽出先ヘッダ容量をコンパイル前に照合していなかった。また予約点を推測64で記述したが、現行定義は13。実定義の抽出へ修正した。
- 対処: PC解析配列だけ4096点へ拡張し、容量変更をpreparation.jsonと報告に明記。4組が終了0で1720～1724点を生成した。幾何・速度の実関数は変更せず、13965の対象制限2.8m/sと保存2.792m/sを確認。これは実機計画の全ビット一致や機体の開始可否の証明ではない。
- 再発防止: 原本長、間隔、予約点、実保存最大index、抽出ヘッダ容量を先に比較する。予約数やマクロを推測しない。実走と現行ソースが合わない場合はビルド同一性を未確認と保持し、PC容量拡大を実機修正・完全再現と呼ばない。ログ解析Skill実行前へ追記。
- 確認: analysis/pathcurve_straight_20261101/preparation.json、*_run.log、findings.json。全4実行が終了0。原本SHA・全行数/有限性確認。
- status: resolved（PC診断手順）、open（実走ビルドの容量/配置照合）。
