Kageyana/robotrace_v2/doc/失敗事例/2026-11-01-pull-stash-document-conflicts.md

---
type: codex-failure
date: 2026-11-01
task: "現在のブランチをプルする"
status: resolved
severity: low
tags:
  - codex/failure
  - git
---

# プル後の未コミット文書復元で追記が競合

## 確認した結果と原因

ブランチcodex/path-curvature-speedには変更済み文書5件と未追跡文書1件があった。git stash push --include-untrackedで保全し、git pull --ff-onlyは4749f5dから67af5e5への16コミットの早送りに成功した。git stash applyは終了1となり、ログ解析Skill本体・再発防止参照、チューニングSkill、検索失敗記録の4件が競合した。競合箇所を読むと、上流とローカルの別内容の追記が同じ挿入位置を使っていた。プル自体の失敗ではない。

## 対処と確認

競合5ブロックで双方の追記を残し、対象だけgit addで解消済みにした後、元どおり未ステージへ戻した。上流HEADの非空行と退避差分の全追加非空行が作業ファイルに存在すること、未追跡文書が退避内容と改行正規化後に一致することを検査した。git ls-files -uは空、git diff --checkは成功し、現在のブランチはoriginと一致した。

復旧用stash 57f6dae9029606802848fbe83ec577c3ad3be7f5（codex-before-pull-20261101）は保持した。内容は既に作業ツリーへ復元済みのため、再度applyしない。

## 次回の具体的な手順

プル前にstatusと上流差分の対象を照合する。同一文書に変更がある場合、未追跡も含めて退避し、stashの識別子を保持する。復元はapplyを使い、終了1なら後続の通常作業を止めて競合を確認する。文書の独立した追記は双方を保持し、上流内容・ローカル追加内容・未追跡ファイル・未解消index・diff --checkを検証する。stashを安全な復元と同一視せず、確認前に削除しない。Gitと.agentsが読み取り専用のセッションでは、最初の書込みから対象を絞った昇格実行を使う。

今回の競合解消と内容保全の確認はresolved。ファームウェアのビルド・書込み・走行はこのGit同期作業の対象外。
