Kageyana/robotrace_v2/doc/失敗事例/2026-11-01-shortcut-host-assert-disabled.md

# ショートカット解析ハーネスでassert依存が最適化時に消えた

- 対象: 一次14038から生成するショートカットと14039の追従比較。
- 事実: 初回Zigホストコンパイルでargc未使用warningがWerrorとなり停止。assert内に入力読込も置いていたため、assert無効の構成では検査だけでなくfgets/fscanfも消える構造だった。実行前の停止で、原本・ファーム・設定への影響はない。
- 原因: 既存fixtureを流用し、2026-11-01-target-speed-u16-validation-preflight.mdにあるNDEBUG対策をログ解析の新しい入口へ適用できなかった。record-failures Skillは公開一覧と個人・repo Skill検索に見つからず、プロジェクト指定先へ手動記録した。
- 対処: 生成元analysis/script/analyze_shortcut_14038_14039.pyで、検査失敗時に常に終了するREQUIREを定義し、入力操作・検査がNDEBUGに依存しないようにした。
- 再発防止: ホスト解析を生成する前にassert内の副作用とNDEBUGを確認する。読込・検査は常時有効な条件分岐へ置き、O0/O2の両方で実入力件数と全出力を比較する。ログ解析Skillの実行前参照にも同じ確認を追加した。
- 確認: Wall/Wextra/WerrorでO0/O2とも成功。6794行の一次入力から1724点・短縮1区間・10.390625mm短縮を生成し、全経路CSVがバイト一致。実Cで再計算した一次XYとCSVの最大差0.000015259mm。異常入力のファイル欠落・列不足もO0/O2で終了2となり、常時検査の実行を確認。
- status: resolved（解析ハーネス）。実機RAM経路CRCとbin全CRC、床上の実位置は今回未検証。

## 同日：条件探索で正しい不採用をハーネス失敗とした

- 事実: 追加候補の端点方位制限をPC上で45度に広げると、製品は新規交差status=6で正しく不採用とした。初回ハーネスがlevel=1のみを期待して停止し、探索結果の保存を妨げた。先行完了済みの34mm・反転条件緩和2条件の成果物は保全した。
- 対処: 経路読込自体の成功と短縮採否を分け、level=0/status=6も正常な探索結果として保存する。拒否結果を採用済み候補へ数えない。探索条件から期待される拒否を事前に結果スキーマへ含める。
- 確認: 当該条件のO0/O2で全経路とstatus=6が一致。80mm探索でも製品の合法性拒否status=3と、PC上の幾何候補を別フィールドへ保存した。解析Skillにも探索の採否を別記録とする手順を追加。
- status: resolved（探索ハーネスの結果契約）。製品の検査を緩和していない。
