Kageyana/robotrace_v2/doc/失敗事例/2026-11-01-line-log-real-sample-boundary.md

# ライン診断実ログの使用周期と終了ヘッダ

- 対象: 14033・14034の初回ライン診断付きログ確認。
- 確認した事実: 解析の途中説明で一次14033の終了Kd=2をDISTANCE14034へ適用し、実使用値を集計する前にKd=2と説明した。追加列の全件集計では14034は直線P2/D0、カーブP5/D12だった。また、共通targetSpeedとlineTraceCtrlから全行の左右目標を再構成できると仮定したassertは、14034の12行で失敗した。
- 原因: 終了メタデータと使用周期の診断を混同したこと、およびPID計算後のprocessMarkerEventが速度目標を更新してから保存する順序を検査前提に含めなかったこと。
- 対処: 途中説明を訂正し、各ログのlineKpUsed/lineKdUsed/lineGainStateを全件集計する。左右目標は新しい実記録を正とする。異なる12行はすべてマーカー行で、非飽和輪から実使用の平均目標を復元すると左右・制限フラグが全行一致した。
- 再発防止: ゲインの説明前に保存行ごとの使用ゲイン組合せと状態を列挙する。共通列と診断列の一致を要求する前に、PID→ゲイン切替→マーカー処理→保存の順序と変数の更新点を確認する。実目標と後段の計画目標の差を原本破損とせず、件数・マーカーとの一致・復元可能性を保存する。診断列がない過去ログは再構成として区別する。
- 確認方法: `python -W error analysis/script/diagnose_line_log_14033_14034.py`。通常一次・DISTANCEの両方で、P項全件、D項の1ms連続1017件、P/D合成、左右輪目標・制限フラグが一致。一次は1ms連続0件を未観測として保存。
- 証跡: `analysis/line_diagnostics_14033_14034/summary.json`と`report.md`。
- ステータス: resolved（解析前提と説明の訂正。実機の振動原因・対策の検証は別途）。
