Kageyana/robotrace_v2/doc/失敗事例/2026-11-01-path-correction-log-preflight.md

# 補正ログ追加時の検索ガードとパッチ入力

- status: resolved（検索とパッチ手順）。実機ログ検証は対象外。
- 対象タスク: PATH/SHORTCUT/PATH_CURVEの白線・マーカー補正ログ分離。
- 事実: Test-Pathでrobotrace_v2/testsがFalseと表示された後も、同じ呼出しのrgへそのパスを渡しos error 2となった。後続コマンドは実行された。加えて、単一apply_patch内に同じpathFollower.cのUpdate Fileを2回置き、multiple operations targetとして拒否された。
- 原因: 存在確認を表示だけで済ませ、nativeコマンドの入口ガードへしていなかった。パッチもファイル単位で統合していなかった。製品差分を再確認し、拒否されたパッチの部分適用がないことを確認した。
- 対処: 実在するvalidationのみで一覧取得し、検索終了コードを個別に確認した。パッチは同じファイルの変更を1つのUpdate Fileへまとめ、再適用成功と差分を確認した。
- 再発防止: 必須検索先が存在しなければthrowで停止し、任意の検索先は存在するパスだけを配列へ集めてrgへ渡す。Test-Pathの結果表示後に固定リストを使い直さない。rg終了コード2以上で停止する。パッチ作成時は操作対象パスの重複を除き、同じファイルのhunkを1操作へまとめる。共通事前確認とビルドSkillの実行前参照へ反映する。
- 確認方法: validationを起点としたrg終了0、拒否直後のgit diffに製品差分なし、統合したパッチの適用成功と4製品ファイルの差分を確認。record-failures Skillは公開一覧・個人Skill・プラグイン配下検索に存在しなかったため、このリポジトリ規定の保存先へ手動記録した。

## ホストCRC試験のポインター型

- 事実: 実logBinaryCrcUpdateの引数はconst uint8_t *だが、合成schema/metadataのconst char *をそのまま渡し、ホスト検証がWpointer-sign（Werror）で停止した。変更前ホストのコンパイル・制御トレースは完了済みだった。製品のビルド不良ではない。
- 対処: 合成バイト列をconst uint8_t *へ明示変換した。警告条件は維持し、実Cの補正/保存試験と通常・詳細×O0/O2の全4組で成功。全ヘッダ・データ・スキーマ・メタデータCRCと独立復号を確認した。
- 再発防止: CRCフィクスチャ作成前に実APIのポインター型と符号を照合し、テキスト表現とバイト列への変換を呼出し側で明示する。ビルドSkillの実行前参照へ反映する。
- status: resolved（合成試験の型と検証）。実機保存・PC変換器での確認は別途。

## 左右速度PID同期修正時の再発

- 事実: 2026-11-01の同期修正で、Skill参照を読む呼出しに続けて未配置robotrace_v2/testsをrgへ渡し、再びos error 2。終了2で後続は停止し、変更前の読取段階であった。参照の末尾には既に同パスを除外する指示があった。
- 原因: 参照読込と依存する検索を同じ呼出しへ詰め、返り値を読んでから実行する順序を守れなかった。
- 追加対策: Skillと再発防止参照の読込は専用呼出しへ分離する。出力を読んだ次の呼出しで、存在する検索先だけを選ぶ。build Skillの入口と参照を同時更新する。
- 確認: 次の呼出しは実在validationだけで一覧取得に成功し、左右PIDの実C回帰O0/O2・Debug/Releaseが完了。同期修正やユーザー差分を戻していない。ステータスresolved（入口の再発防止）。

## ビルド警告集計の正規表現グループ

- 事実: finalize.pyがre.Match[0]をファイル名と扱い、警告行全体をパスへ変換してコンパイル単位の被覆assertで停止した。ホスト試験と両ARMビルドは既に成功していた。
- 対処: file/line/messageの名前付きグループへ変更し、拡張子と行番号の形を検査。完成済みELF・原ログ・ソースSHAを保全し、集計だけを再開した。
- 確認: 各構成の変更前全体ログが全警告発生単位を含むこと、警告6件の完全一致、新規0、SHA付きELFコピーの一致を確認。今後の新集計器も捕捉値の型・形と最小出力を先に検証する。ステータスresolved。
