Kageyana/robotrace_v2/doc/失敗事例/2026-11-01-wheel-speed-pid-gains-not-synchronized.md

# 左右速度PIDへSD設定が起動時に反映されない

- 対象タスク: DISTANCE14025/14027/14029の追従振動調査と同期漏れ修正。
- ステータス: resolved（コード上の同期漏れ、ホスト回帰、14032の設定反映を支持する実走出力）。高速追従の解消と複数走の再現性は未確認。

## 確認した事実

速度PIDはveloCtrl、veloCtrlL、veloCtrlRの3組が存在する。SD起動読込はveloCtrlだけを更新し、左右へのコピーは速度PID調整画面を開いた場合にしか実行されなかった。左右独立速度制御はveloCtrlL/Rを使うため、起動後の画面操作によって実ゲインが異なりうる。

14029の電圧出力は初期値P10/I0/D0に強く整合し、ログヘッダはveloCtrlのP12/I0/D4を記録していた。14027ではP12/I0/D4に整合する。これは保存値からの推定であり、実RAMの直接読取ではない。高速振動の全原因を同期漏れだけに帰属するものではない。

## 対処

- PIDcontrol.cにsyncSpeedPIDGainsを追加。P/I/Dだけを左右へ同時反映し、name・積分値・出力値は保持する。
- initSystemのSD処理後に無条件で同期する。SDあり・なし・初期化失敗・設定既定値のいずれでもRAM上の確定ゲインを使用する。
- setup_pidの速度UIでは編集処理後に同期する。最後の編集直後に画面を離れても未反映にならない。
- コピー中だけPRIMASKを保存してIRQを禁止し、終了時に元の禁止状態へ戻す。1ms割り込みの制御処理や周期は変更しない。

## 確認・再発防止

validation/speed_pid_sync/run.pyは実CのSD初期化区間、setup_pid、同期関数を抽出して検証する。SDと表示は境界モックとし、SD保存形式の検証とは分ける。SDなし・設定取得・既定値・SD初期化失敗・ソフト再初期化、P/I/D/FFのUI最終操作、0/12/255のゲイン、積分/出力/名前保持、PRIMASK0/1の復元をO0/O2・Wall/Wextra/Werrorで確認した。

Debug/Releaseの通常ビルド成功。既存の変更前全体ログと警告発生単位の被覆を確認し、既存警告6件一致・新規0件。ユーザーによるtimer.cの5m/s制限変更はスナップショットとバイト一致を確認した。証跡はbuild/speed-pid-sync-20261101/validation.jsonとSHA付きELFコピー。

今後、制御値に基準・左右別・経路別の複数構造体がある場合は、保存対象・実使用対象・起動反映・UI反映を確認する。新しいゲイン変更箇所では同じ同期関数を使用する。実機では書込み後、速度PID画面を開かずに起動・走行し、設定値と応答を確認する。同条件の複数走で振動・飽和・完走を比較し、直線D0やゲイン切替の課題とは別に評価する。

## 修正後14032の実走出力確認

ユーザーが修正後実走として指定した14032（dd6798d、17:09:02）はDISTANCE・emcStop0・SG2・ゴール記録あり。電圧出力1032点はP12/D4候補が76.8%で10mV以内・中央値0.5mV、旧P10/D0候補は5.8%・中央値340.8mVとなり、設定反映を支持した。実RAM直接確認・Flash全バイト照合とは区別する。

共通の生距離4.7～8.0mでは14029に対し平均実速度3.112→3.497m/s、速度追従誤差RMS0.846→0.378m/s、角速度RMS301.3→205.9deg/s。直線D0と振動時ゲイン切替は残り、全体飽和時間率は増えている。一次参照と電圧帯も異なる単発比較のため、高速追従の解消や再現性採用とは判断しない。証跡はanalysis/speed_pid_sync_14032/report.mdとsummary.json。
