Kageyana/robotrace_v2/doc/失敗事例/2026-10-28-path-white-map-goal-extension.md

# ゴール延長区間に白線地図がなく、明部が見えていても照合できない

## 2026-11-01：周期未確定の13989～13991・13993

同日のユーザー指定により、制御版26は全方式でゴールマーカー規定回数を確認したら通常ライン追従の停止処理へ移るよう変更した。延長地図不足を補間で隠さず、ゴール後に延長点まで走り続ける終了仕様を変更した。ホストの実状態遷移・IRQ分岐を旧新×O0/O2で確認し、Debug/Release成功・新規warningなし。詳細はdoc/path-goal-marker-stop.md、証跡はbuild/goal-marker-stop-20261101/。ゴール前の緊急停止と保存順は維持する。statusはopen（未書込み・実走未検証）を維持し、周期0での白線地図生成を修正済みとは扱わない。

- status: open（診断済み、period=0時の修正と実機検証は未実施）。以前のperiod>0向け修正の検証済み事実は保持する。
- 対象: ユーザーがコース完走を確認したPATH_CURVE4走。全走SG終値2、emcStop=7、pathLoopPeriod_mm=0、未照合150ms。
- 事実: ゴール立上りから約187～192ms・297.5～315.7mm後に最終保存行。通過後の全保存行に800以上の明部がある。最終白線補正から末尾まで145～149ms。現行の白線延長生成はperiod>0内だけで、period=0でも走行経路は延長される。
- 原因候補: 周期未確定の延長区間で照合用地図がなく、明部が見えても未照合150msの停止となる。CSV参考再構成で一次終端index約1693、補正末尾1693～1694、最終1705～1706。実bin/C完全再生と物理逸脱の確定は未実施。
- 対処: コース完走ラベルとログ緊急停止を分離して保存。証拠と修正候補はanalysis/goal_tail_13989_13993/report.md。ファーム変更なし。
- 再発防止: 終端検証をperiod>0だけで完了とせず、period=0・単独PRIMARY元でも延長区間の地図と正常終了到達を確認する。欠測有効化や停止時間緩和で隠さない。
- 確認方法: analysis/script/diagnose_goal_tail_13989_13993.pyで6原CSVの行列・有限性・時刻・SHA不変と4走のゴール・明部・未照合時間を検査。一次bin全CRC、実C再生、修正後実走は別途必要。

- status: resolved（修正・欠測保持・キャッシュ・PC再生）、open（未書込み・実走検証）。
- 対象: PATH_CURVE13877/13878、取得版2の13880/13881。
- 確認結果: `pathExtendDriveRouteTowardOrigin()`はdriveRoute/lineRouteを11点延長するが、whiteRouteは無効のまま。`pathFindLineMatch()`は探索窓の各区間の両端に有効な白線観測を要求する。実C再生の末尾149/147/60/62msは、全探索候補でこの条件を満たせず、白線検出が有効でも照合できない。今回の実機13880/13881の未照合末尾61/62msとほぼ一致した。低速だった前回は実機の未照合150msで停止し、今回は先に通常ゴールへ達した。
- 原因/未確定: 延長経路と観測地図の範囲が異なることは確認済み。距離基準ログからの再構成であり、前回の実機全1ms履歴の完全再現や、すべての未照合原因の特定ではない。13881の途中の板外張出しは終端より前に起きており、この不足だけで説明しない。
- 対処: 白線地図版2として、正規化前の一次観測と元の弧長位相から延長点の周期観測を生成した。補間の両端が有効な場合だけ採用し、欠測は無効のまま残す。元地図・走行形状・キャッシュ再利用/設定変更による再生成/モード切替を検証した。停止閾値は変更していない。
- 再発防止: 明部が見える終端の未照合では、センサー鮮度と別に地図valid・探索窓・延長終点の範囲を確認する。今後の経路生成回帰には延長区間の白線被覆と、元観測欠測の伝播を含める。ログ解析Skillの実行前へ追加する。
- 確認方法: `analysis/script/check_path_white_tail.py`。実Cと再生manifestのSHA一致、4走の末尾探索窓に有効な白線区間が0であることを確認。証跡は`analysis/path_acquisition_220117/white_tail_validation.json`。修正後は同試験、実C再生、キャッシュ試験、ビルドと実走を確認する。

修正後の検証は`validation/path_white_extension/run.py`。同じ最適化条件の保存済み旧ソースと現行ソースを対にし、4走×O0/O2の8再生で、延長11点の有効化・元白線と全走行形状の一致・終端窓より前の全セル一致を確認した。末尾未照合149/147/60/62msはすべて0、最終状態は通常追従。RAM内の一次コピーの白線全件を欠測へ変え、CRCを更新した陰性試験では延長も全無効となり、原本を復元するとキャッシュを再生成して元の地図へ戻る。元のbinは変更していない。

単独APIの不正入力・欠測・元配列不変・補正上限はO0/O2/Wall/Wextra/Werrorで成功し、Debug/Release/DebugMarker/WhiteExtensionTimingの4構成と通常/詳細ログの全CRC・PC再変換も成功、新規warning0・RAM増加0。証跡はbuild/white-extension-validation/final_validation.json。未書込みであり、途中の物理ずれや板外張出しを直した証明ではない。
