Kageyana/robotrace_v2/doc/失敗事例/2026-11-01-log-analysis-external-tool-path.md

# 13980解析：旧環境の外部ツール配置を存在確認せず検索

- 対象タスク: PATH_CURVE13980の直線途中減速の調査。
- 事実: C:/tool/AutoCopyCsvFromSdを存在確認せずrgへ渡し、os error 3となった。CSV13980/13977は現在のユーザー提供workspace内で確認できた。後にレポート追加と既存記録への更新を同じパッチへまとめ、既存記録の未確認アンカーで検証拒否となった。追加予定report.mdが存在しないことを確認し、新規ファイルの独立パッチで再開した。
- 原因: 旧環境の標準配置と現在の実在配置を区別する事前確認を、外部ツール検索に適用しなかった。パッチでも完全行の事前読込を適用しなかった。
- 対処: 現在存在するLog配下へ探索を限定した。Python実体はload_workspace_dependenciesで取得し、存在・numpy/matplotlibのspecを検査した。原CSVのみで実保存値を解析し、一次binの全CRC再検証を実施済みとは報告しない。
- 再発防止: 既定外部ツールパスも初回検索前に存在確認する。任意ツールが無ければ親全体へ無差別探索せず、確認できるCSVの解析とbin未検証の範囲を明記する。変更パッチは実在する完全行をアンカーとし、無関係な追加と更新を混在させない。拒否後は対象の部分適用を確認する。
- 確認方法: diagnose_13980_straight.pyは終了0。両CSVの期待行数・列数・有限性・時刻順を検査し、SHA256と結果をanalysis/log_13980_straightへ保存。report.md不在確認後に独立追加成功。
- record-failures Skillは個人SkillとプラグインのSKILL.md一覧で見つからず、このプロジェクトの指定保存先へ手動記録した。
- ステータス: resolved（現在の入力配置とレポート生成）。外部ツールの新配置と一次binのCRCは未確認。
