Kageyana/robotrace_v2/doc/失敗事例/2026-11-01-path-cross-straight-preflight.md

# クロス前後の直線化：検索とパッチの入口

- 対象タスク: PATH/SHORTCUT/PATH_CURVEのクロス検出区間と前後100mmを直線扱いする変更。
- 事実: Core/Src/path*等をrgのパスへ渡しos error 123となった。さらに存在しないrobotrace_v2/testsを検索に混ぜos error 2となった。Skill参照に記載されたanalysis/script/search_firmware_sources.ps1も現チェックアウトには無かった。製品変更前後の検索・参照失敗であり実機操作は行っていない。
- 原因: 既存の存在確認・glob分離策を各呼出しの実行点で適用できていなかった。Skillに記載された補助ファイルも現在の実在確認が必要。
- 対処: 実在するCore/SrcとCore/Incを親に、-g 'path*'等へ分離した検索に戻した。検証先は実在するvalidation/path_commonから取得した。
- 追加事実: AGENTS.mdの段落の一部分を完全行としてパッチへ渡し検証失敗となった。同じパッチに含めた新規検証ファイル2本が存在しないことを確認し、実段落を読み直して完全行で再適用した。
- 再発防止: 各検索の必須パスはFalseならthrow、任意パスは実在するものだけを渡す。参照文書から得た補助スクリプトも実在一覧で確認する。rg終了コード2以上で止める。段落を変更するパッチには読込済みの完全行を使い、拒否後は全対象の部分適用有無を確認する。ビルドSkillの実行前参照へ現チェックアウトでの入口確認を追加した。
- 確認: 修正後の検索終了0と対象ソースの一致、拒否後の2新規ファイル不在、その後の適用成功を確認。実Cホスト試験O0/O2とDebug/Releaseビルドが成功した。
- record-failures Skillは個人Skillとプラグイン配下の実在一覧にも無かったため、プロジェクト規定の保存先へ手動記録した。
- status: resolved（検索・パッチ手順）。実機の通過挙動と加減速は別途確認。
