Kageyana/robotrace_v2/doc/失敗事例/2026-10-12-host-float-snapshot-comparison.md

---
type: codex-failure
date: 2026-10-12
task: "IMU接線項スナップショットのホスト比較"
status: resolved
severity: low
tags: [codex/failure, test, float]
---

# float保存値とホストの拡張精度式を比較してテストが失敗した

## 確認した結果

MinGWホストで、floatへ保存した適用済み接線項と`alpha*IMU_OFFSET_Y_M`を直接完全一致比較したところ、最初の非ゼロ入力で失敗した。表示値は約0.592607439と0.592607433。実装変更前後のIMU出力比較では差を確認していない。

## 原因と対処

ホストの式評価にfloat保存値より余分な精度が残り、比較側の丸め契約が異なった。期待値を`volatile float expectedTerm=alpha*IMU_OFFSET_Y_M`として保存型へ実体化してから比較した。許容誤差を拡大して回避せず、ファームウェアの演算も変更していない。

## 再発防止と確認

組み込みfloatスナップショットの厳密ホスト比較では、期待値も同じ保存型へ書き出してから比較する。演算式同士の比較と保存ビット列比較を分ける。`robotrace_v2/tests/check_slip_candidate_parity.py`へ反映し、改修前後の実IMUと既存SHADOWをそれぞれ8000入力でバイト比較して一致、スナップショット・校正/リセット・物理合成入力の検証も成功。結果は`analysis/slip-lateral-candidate/parity.json`。対処・検証済みのためresolved。

## 2026-10-18：横候補版5の期待残差で再発

横候補の時間応答整合を実装し、変更前後を比較したホスト検査で`c->result.residual==expected-tangent`が停止した。期待値を`volatile float expectedResidual`へ保存してからmemcmpで比較すると、16,000周期すべてが一致した。製品コードや許容誤差を変更せずに検査が通過し、角加速度から作った両方向・5/20/50Hzの合成入力、継続・無効復帰・区間保持、従来判定・計画回帰も成功した。

既存の事前手順は読んでいたが、新設テストの最終減算式に適用できていなかった。期待LPF状態だけをfloat変数へ置いても、最後の減算の保存契約までは保証しない。実Cの保存値と式を完全一致させる新設検査では、コンパイル前に各CHECKの比較右辺を確認し、**最終演算結果**をvolatile floatへ実体化してmemcmpする。中間値の宣言だけで済ませない。書込み・ビルドSkillのホスト検証入口にも追記する。

証跡は`analysis/slip_lateral_v5/host-validation.json`と`matched-paired-and-response.log`。期待値保存の修正と実C回帰は検証済みのためresolvedを維持する。実機の検出精度を解決済みとする意味ではない。

## 2026-10-25：SD保存速度と1.6Fの直接比較

bst500の初期値を1.5へ変更する検証で、SDに保存済みの1.6が優先されることを`bst500 == 1.6F && writes == 0`で確認したところ、O0のホスト検証が停止した。比較期待値を`volatile float savedSpeed = 1.6F`へ保存し、再書込み回数と保存ビット列を別々に検査すると両方が一致した。製品の読込式や許容誤差は変更していない。CPU命令単位の評価精度は今回調査していない。

既存の保存型比較の予防策を読んでいたが、新規の小数リテラル比較へ適用できていなかった。今後は期待値が式だけでなく1.6F等の小数定数の場合もfloatへ明示保存し、保存値を比較する。SD設定Skillの実行前参照へ追加する。

O0/O2で速度設定180ケース、既定値1.5と欠落時0150保存、既存SD値1.6の保持と再書込みなし、PID画面・メタデータが成功した。Debug/Releaseビルドも成功。この比較契約の対処は検証済みとしてresolved。実SDへの書込み・実機走行は未実施。

## 2026-10-27：補正上限の関数戻り値比較

新しい白線位置補正関数の飽和値を`pathFusionLineStep(...) == -.2f`で比較したホスト検証が停止した。関数戻り値と期待リテラルの両方をvolatile floatへ保存してから比較するとO0/O2で一致した。製品の飽和式・許容誤差は変更していない。既存の予防は読んでいたが、新規の関数呼出し比較にも適用する必要があった。すべての厳密な小数比較で最終結果と期待値を保存型へ実体化してから照合する。証跡はbuild/path-fusion-port/validation.json。保存契約の対処は検証済みとしてresolved。

## 2026-10-28：O2の再生をO0の履歴へ厳密比較

終端白線地図の旧新再生で、O2の修正版をO0の履歴CSVと全セル比較し、終端より前の完全一致条件が停止した。最初の差は4msのXで1µm未満の表示最小桁だったが、反復後には最近傍選択などへ差が伝播した。許容誤差を広げて対処せず、Flash886669cc…に対応する保存済み旧Core全体を同じO0/O2・同じホストフィクスチャで各々ビルドした。最適化条件を揃えた旧新では、4走×O0/O2すべて終端窓より前の全セルが一致し、元地図・形状・欠測保持・キャッシュも一致した。status: resolved（比較条件）。検証はvalidation/path_white_extension/run.py、証跡はbuild/white-extension-validation/replay_validation.json。実機の物理改善とは分ける。

## 2026-10-29：同じO2でもモデルの保存丸め条件が異なった

FF2の正式CとPC候補をモデル全行バイト比較したところ、最初の理想応答で停止した。最大差は座標約0.000061mm・角速度約0.0011deg/sで、同じO2でも演算と保存の丸め契約を固定できていなかった。コンパイラ定義を取得し、MinGWが__i386__・__FLT_EVAL_METHOD__=2であることを確認した。失敗時のmodel/ideal.csvとログは保持した。

許容差や製品式を変更せず、候補と正式Cの両方を-fexcess-precision=standard -ffloat-storeでコンパイルした。8応答条件の全CSVがバイト一致した。標準手順build/path-yaw-ff-validation/model.pyも、最初から両側を同じfloat保存条件で生成するよう変更した。コンパイラ定義・両コマンド・ELFではなくホストexeのSHA・両出力をmodel/precisionへ保存した。ARMのビルドフラグは変更していない。

再発防止は、同じ最適化だけで厳密比較条件が揃うとせず、保存型・FLT_EVAL_METHOD・比較側の式評価も確認すること。再帰的なモデル/再生の全行バイト比較では双方の保存精度を同じにし、許容差の拡大で処理しない。flash-debug Skillの旧新比較前へ追加した。status: resolved（ホスト比較条件）。モデルが実機の物理応答を保証する意味ではない。

## 2026-10-30：初期共分散の定数式を実行時式へ置き換えた比較

- 対象: 制御版21のPC専用コピーで、初期方位/bias共分散の9組を比較する試作。
- 確認結果: 既定1deg²/0.04(deg/s)²でも、13898の449行目のbias表示が0.082939/0.082940となり、凍結基準との全バイト一致が停止した。同じ精度オプションを使用済み。実機/製品ソース/SD設定への変更はない。
- 原因/未確定: 定数の初期化式を変数による実行時式へ変えたことに伴う演算・保存条件差が疑われる。CPU命令単位の差は調査しておらず、丸めの詳細原因を確定していない。
- 対処: 失敗したソース・exe・合成結果・13898トレース・ログをanalysis/path_initialization_probe/before-baseline-precision-fixへ保全した。既定値は保存floatのビット列で識別し、元の定数式をそのまま実行する分岐へ変更した。許容差を広げず、全22走の基準一致とO0/O2比較を再検証中。
- 再発防止: PC候補で定数を可変化した場合も、候補評価前に既定設定の全入力トレースを凍結版へ完全一致させる。最適化・float保存条件だけで一致を仮定せず、差が出たら評価を止め、最初の差と失敗一式を保全する。既定分岐の元式を維持し、可変側と既定側の演算契約を区別する。
- 確認方法: analysis/script/probe_path_initialization.py、同.inc、同出力のvalidation.jsonと基準22走全バイト比較。
- 検証結果: 既定22走×O0/O2で凍結基準へ全バイト一致し、9組×22走×O0/O2の396再生も最適化間で全バイト一致した。既知真値の243条件×O0/O2も一致。製品の式・許容差・実機設定は変更していない。Skillの比較前手順へ定数/可変式の基準再現を追加した。
- status: resolved（PC比較の基準再現）。物理的な共分散調整の効果と最初の丸め差の命令単位原因は未検証。

## 2026-10-30：5状態試作の設定境界0.8秒

PC専用の横速度時定数setterでtau>0.8fを直接比較し、保存floatの0.8秒を指定した既知状態試験が拒否された。0.2秒までの21行は出力済みで、0.8秒の最初の設定で停止。実機・製品は未変更。失敗したprivateソース/O0 exe/合成CSV/ログ/テンプレートをlateral_state_probe/before-stored-bound-fixへ保持した。

境界の最小0.05秒・最大0.8秒をvolatile floatへ実体化して引数と同じ保存精度で比較するよう修正し、範囲は変更しなかった。修正後は0.8秒を含む30既知状態×O0/O2と460再生が完了し、全最適化間一致・基準23走一致。詳細なCPU命令ごとの差は未調査だが、保存型を揃える対処は実入力で検証できた。

再発防止は厳密な期待値だけでなく、小数パラメータの上下限も同じ保存精度で比較し、端点を実型で試すこと。ホストfloatオプションだけで端点比較の一致を仮定しない。確認はprobe_lateral_state_model.incとlateral_state_probe/final_validation.json。status: resolved（今回の端点判定）、open（物理推定）。
