Kageyana/robotrace_v2/doc/失敗事例/2026-10-17-shared-header-line-ending-check.md

---
status: resolved
task: XY距離をマーカー補正前へ変更
---

# 同内容の共有ヘッダにバイト一致を仮定した

通常/詳細の実CとPC変換器のCSV一致、補正距離変更へのXY不変、旧版・必須列欠落の拒否は成功したが、最後の共有ヘッダのread_bytes()一致検査で停止した。

git diff --no-indexではソース差がなく、改行形式の差が残っていた。文書で「同じヘッダ」としていても、配布済みコピーのバイト一致は保証されていなかった。ファームのlogBinary.hを正としてPCツールへCopy-Itemで配布し、両SHA256の一致と検証スクリプト終了コード0を確認した。実装の計算不具合ではない。

再発防止として、共有ヘッダを更新する際は正のファームヘッダから配布し、ビルド前に配布物のSHA256を照合する。意味の同一性と配布物のバイト同一性を別契約として扱う。書込み・ビルドSkillの成果物事前確認へ追加した。

確認: analysis/xy_raw_distance/validation.json。両ヘッダSHA256=6ded40c90164977d90d7bf66107b0671d9ea9833488841fc23e02461c1c073dc。通常・詳細の機体C/PC CSVバイト一致を含む全検証が成功した。計算版2の初回実機ログは未確認。

## 2026-10-25：binとPC変換CSVのメタデータ比較

タスクはショートカット設定7項目のメタデータ追加。保存済みbinの末尾とPC変換CSVの1行目へバイト一致を仮定した追加assertが停止した。実保存・7項目の開始時保持・CRC検証は既に成功していた。実バイトでCSVの末尾はCRLF、binはLFと確認でき、行末差を試験の比較契約へ含めていなかったことが原因だった。製品の値欠落やCRC不一致ではない。

validation/log_storage/run.pyの比較はCSV側の行末CR/LFだけを除いてLFを付け直し、他の内容は変換せず全メタデータを照合する。次回は文字列の内容一致を要求する前に両形式の改行規約と実バイトを確認し、ヘッダ無変換コピーのバイト一致契約と区別する。書込み・デバッグSkillのPC変換器検証前にも同じ入口を追加する。

確認はリポジトリルート・必要権限で `python validation/log_storage/run.py --converter C:/tool/AutoCopyCsvFromSd/RlogToCsv.exe` を再実行し、通常・詳細両方の全CRC、3種類の設定値の開始後変更からの分離、50行のPC変換値と全メタデータ内容一致が成功した。各プロファイルの結果はbuild/log-storage-validation以下へ保存した。4構成ARMビルドも成功。比較契約の修正はresolved、最初の実機ログは未確認。

## 2026-10-28：RAM残留ヘッダと保存binの照合で再発

対象は実走13870とリセットなしRAM採取の対応確認。binメタデータ側だけrstripした一方、RAMのcolumnTitle由来文字列には終端LFが残っていたため、新規assertが停止した。両ログの全CRCとPC再変換CSVの一致は成功しており、メタデータ内容の不一致ではなかった。

compare_retained_header.pyで差分を実バイト由来の文字列へ限定して確認した結果、RAM3663B・bin3662B、差は末尾1文字LFのみだった。既存の改行契約をRAM由来文字列へ適用できていなかった再発である。両側の終端CR/LFだけを正規化し、項目名・順序・値・数値表記・他の文字は変更せず比較する。辞書としても全項目一致を独立に検査する。

再発防止としてログ解析Skillのメタデータ比較前にRAM/bin/CSVの終端改行確認を追加した。実行はリポジトリルート・必要権限でpython analysis/script/analyze_path_timing_13869_13870.py。原本bin/CSV/RAMは変更しない。

検証はanalysis/path_fusion_13869_13870/ram_metadata_byte_differences.jsonとvalidation.json。13869/13870の全CRC・全56列の再変換CSV一致・13870のRAMメタデータ全内容一致が成功した。status: resolved（比較契約の修正）。ADC最大age6msの発生区間や物理Y変位の精度とは別件。

## 2026-10-18：横候補版4のホストテストコピーで再発

最終検査で、paired.c/metadata.cと元テストのバイト同一性assertが失敗した。文字列としては一致しており、生成コピーはCRLF63/34行、元はLF63/34行、差は改行バイトだけだった。実C比較16000周期・回帰・4構成ビルドは既に成功していた。既存対策は配布する共有ヘッダに限定され、検証用の無変換コピーにも同じ契約が必要な点を実行前に適用できていなかった。

無変換のテストコピーをread_text/write_textからread_bytes/write_bytesへ変更し、コンパイル前にバイト一致を確認する。内容変換が必要なコピーは変換内容と改行方針を明示し、原本バイト一致の契約と混ぜない。書き込み・ビルドSkillの成果物事前確認にも対象を拡張した。証跡はanalysis/slip_lateral_v4/host-validation.jsonとtest-copy-validation.json。改行差の修復・同一コピーの再コンパイルと実行を確認してresolvedとし、物理スリップ検出精度とは分ける。
