Kageyana/robotrace_v2/doc/失敗事例/2026-10-17-video-color-marker-identity.md

---
type: codex-failure
date: 2026-10-17
task: "赤・黄マーカー動画と実走ログ13323～13337の照合"
status: resolved
severity: medium
tags: [codex/failure, analysis, video]
---

# 中心間距離だけで色マーカーの所属を保証できなかった

## 確認した結果

床8点による校正と既知中心間128mmの範囲検査だけでは、白線の黄色味を黄マーカーへ、機体上の別の赤系領域を赤マーカーへ誤対応する孤立フレームが残った。初期図に映像角速度の数千deg/sの飛びやPRIMARYの大きな速度スパイクが出た。3本目のPRIMARY同期相関は0.35となり、0.8の受理条件で停止した。ログを滑りの正解として追跡を修正していない。

## 原因と対処

色域・面積・2点間距離が合っても物体の同一性は保証されない。角度だけでも、同じ向きで2点が誤対応する位置飛びを除けない。独立にシークした実フレームを重ねた`marker_identity_check.jpg`と`marker_position_check.jpg`で誤対応を確認した。

近傍2フレームの円周平均から25度超の角度不連続、前後フレームの位置平均から15mm超の位置不連続を品質不足として除外した。境界値は今回の撮影条件の品質ゲートであり、普遍的な物理滑り閾値ではない。元追跡CSVと除外根拠を保持し、速度比較には窓内全フレームの有効性を要求する。同期・表示用の補間と、判定に使う有効観測を分離した。

## 検証・状態

修正後の映像/gyro相関は9走で0.969～0.989程度、角度RMSは約0.8～1.4度。初期の偽スパイクを実画像と品質除外で確認した。12時刻の独立シーク画像は全て追跡フレームのずれ0で対応し、全3動画・15ログの前後SHA256が一致した。幾何の合成144配置の射影往復も確認した。

本記録の観測済み誤対応への対処はresolved。全ての誤対応が検出できた保証、校正誤差・露光・姿勢・短い実滑りの識別精度は未確定。特に3本目は有効な100ms窓が約19～28%に限られ、全走の陰性判定には使わない。

## 次回の事前確認

1. 生画像の色・面積・形状・2点の距離・時間的連続性を調べ、速度・角速度の外れ値の前後実フレームを確認してから滑りと解釈する。
2. 校正に使用しない床点、既知マーカー寸法、静止区間で幾何と追跡品質を検査する。低品質を0へ置換しない。
3. 全フレームの有効率だけでなく、各走・各評価窓の被覆率を保存する。欠測を線でつながない。
4. PTSはパケットから取得し提示順・件数を照合する。全復号するframeプローブを必要なく実行しない。長時間処理は開始したsession/PIDを保持し、PowerShellリダイレクトの未更新だけで停止と判断しない。今回、初期全復号プローブを中断したほか、通常環境のCIM照会はアクセス拒否となった。必要権限で対象コマンドと親PIDを確認した。FFmpeg本処理は全期待フレームを取得して終了コード0で完了した。

関連: `analysis/video_slip_13323_13337/report.md`、`validation.json`、`frame_alignment_checks.json`、`tracking_quality.json`。

## 22時台の13438～13442評価での再発：床点の所属

4本目の初期画像で、床の左下ピンク点が色域条件から外れ、機体上の赤系領域を4個目の床点として選択した。初期実測点の再投影・床面復元の残差はfit最大321.84mm、留保点最大307.63mmであり、実機の滑りではなく校正の所属不良と判断した。他の4動画の留保残差は約4.2～4.6mmだった。既存の外周選別はbottom候補が4個のときに追加選別を省略しており、今回の条件を防げなかった。

当該校正では追跡を開始せず、実画像の色域を広げた候補から、直前動画の各床点位置の25px以内にある実測中心を一対一に対応付けた。ログの位置・gyroは使わない。8点で再推定し、留保4点の最大残差4.03mmを確認した。原本は変更しない。`analysis/video_slip_13438_13442/repair_calibration3.py`と校正JSONへ手順・実測中心を残した。

追加対策は、点数が揃ったことや最適化のsuccessだけで校正を受理しないこと。prepare・track・analyzeの実行前にfit/留保点の残差を検査し、今回の品質ゲート10mm以上なら停止する。既知の1本のみ実画像による所属修復へ進み、他の未解決校正を自動で通さない。この10mmは校正品質のゲートであり、物理位置誤差の保証や滑り閾値ではない。修復画像と独立留保点の確認まで完了したため、今回の観測済み床点誤対応への対処はresolved。検出精度・実滑りの識別は別途評価する。

## 13444～13448：有効窓が0本の場合の集計契約

横滑りなしの4走では、13444の追跡姿勢は99%以上取得できたが、撮影中の留保床点変化量が中央値3.25mmで既存3mmゲートを超えるフレームが多かった。全元フレーム有効を満たす100/200ms窓は0本。既存analyze()の「各走に必ず有効窓がある」というassertが停止し、他3走の集計も未出力となった。初期のfit/留保点残差ゲート10mmとは異なる撮影中の変化量であり、3mmを静的な校正残差や物理滑り閾値と混同しない。

対処はゲートを緩めず、0本の走行をstatus=unavailable、有効窓数・被覆率は0、速度や角度の指標は未記録（空セル/JSONキーなし）として保存すること。他の走行の有効窓とログ診断集計は継続する。図にも品質を満たす窓なしと表示する。13447も100ms窓の被覆率4.51%に限られる。床点残差が生じた物理原因は未確定であり、カメラの実移動と断定していない。

`analysis/script/analyze_video_slip_13444_13448.py --analyze`で、13444を未記録のまま4走の集計・図生成が完了し、13445/13448の6フレームの独立シーク画像で赤黄中心の差3px未満を確認した。finalizeスクリプトで有限値・ON時間範囲・入力ハッシュを確認した。空区間の取扱いはresolved、撮影中の床点変化量の原因と全フレームでの定量評価は未解決。Skillの動画集計前手順に0窓の取扱いを追加した。

## 2026-10-18：校正と追跡の復号・HSV・重心条件の不一致

対象は13454～13457と1080p/120fpsの4動画。モード変更後の床点は旧動画の探索中心から最初の点で約34pxずれており、旧25pxゲートで停止した。旧点の所属を強制せず、今回の実画像で床8点・留保4点を再対応付けした。点の数やfit成功だけで通さない既存の品質ゲートは機能した。

一方、既存の校正はOpenCV復号＋ピンクH140～175の連結成分中心、追跡はFFmpeg復号＋H150～169の局所重心だった。実際の追跡経路で同じ先頭画像を評価すると13454の留保床点変化量が3.317mmとなり、実移動がなくても3mmゲートを超えた。同じ色域へ合わせた検算では0.344mm（4本は0.321～0.524mm）。両復号経路には8bit色値の差も観測した。色領域中心の不一致が品質低下を作り得ることを確認したが、過去全動画の床点変化量の原因を全て確定したわけではない。

今回の解析だけで校正と追跡をFFmpeg BGR・同一スケーリング・同一HSV・41px局所重心・35画素超の可視条件へ統一した。撮影中3mm/8pxと校正残差10mmの品質ゲートは維持。13456の先頭画像では左下床点が28画素で不可視扱い、0.1秒の65画素で初期校正を実行した。この点は断片化しており、総色画素数と単一連結成分面積を混同すると別の床点を選びかけるため、校正と追跡の重心条件も一致させた。所属は実画像で確認し、ログの姿勢・位置・速度を校正へ使っていない。

修正前の結果を `analysis/video_slip_13454_13457/baseline_mixed_floor_extraction/` へ保全。最終手法はanalysis_method.jsonのversion=2。動画全体の有効取得率は13454:42.71→100%、13455:96.80→100%、13456:9.47→100%、13457:63.84→100%。全4本の評価対象100/200ms窓の被覆率も100%。これはマーカー追跡の品質条件を満たした割合で、滑り判定精度100%ではない。原本動画/CSVとログ診断カウンタは不変、元bin全CRC一致。独立シーク12フレームの赤黄中心差は最大約0.58pxで、実画像の所属も確認した。

再発防止は撮影モード変更時の実画像による再校正と、追跡開始前に同じ静止フレームを校正/追跡の両経路へ通す一致確認。復号・色域・重心・可視条件の差があれば閾値を緩めずに解消する。不可視点を近傍の別点で置換せず、参照時刻・理由を残す。解析Skillの追跡前手順へ同じ確認を追加した。

検証コマンドは `analysis/script/analyze_video_slip_13454_13457.py --prepare`、`--track 0～3`、`--analyze`、`review_video_slip_13454_13457.py`、`finalize_video_slip_13454_13457.py`。色域の検算はinspect_floor_hsv_13454_13457.py、可視性はinspect_floor_visibility_13456.py。既存の検算JSONは旧基準の証跡なので再実行値と基準時刻を混同しない。今回の抽出条件不一致への対処はresolved。過去60fps動画の再追跡、全誤対応の検出保証、実機の横判定の不要ON原因と採用確認は未解決。

## 2026-10-18：動画正例の件数を固定した

閾値選定で左下旋回の正例を抽出する際、実画像を確認する前に1走3イベントと仮定してassertし、13454で実際に4候補が見つかって停止した。判定器の残差やONを使ってイベントを削除したり、想定件数へ切り詰めていない。各候補は約3.07/5.81/8.60/11.33秒の別通過で、全4走の各4窓を前後50msの実画像で確認した。16窓・48フレームの再シークでマーカー所属と横流れを確認した後に実装へ進んだ。

対処は時間的分離で観測候補を列挙してから実画像で所属・ラベルを確定し、マーカー回数や想定周回数から正例数を固定しないこと。選定用と確認用は走行単位で固定し、確認用を使って閾値を選び直さない。今回の閾値選定条件は20ms以上のON重なりを保つことであり、実機の継続時間を20msへ変えることではない。

陰性動画は当初指定フォルダに存在せず、既存スクリプトのffprobe呼出しで停止した。ユーザーが原本を復元後、以前の保存SHA256との一致を確認し、同一画像解析条件で全4本を再追跡した。動画集合を流用するときは全入力の存在・ハッシュを集計前に検査し、欠落を正常な観測へ置換しない。

確認は `analysis/script/fit_lateral_video_threshold.py`、`review_lateral_threshold_labels.py`、`report_lateral_video_threshold.py`。16窓の全画像確認、陰性4本の再追跡、原本SHA256、独立した確認用評価を `analysis/slip_lat_threshold_20261018/validation.json` に保存した。件数・入力集合の固定前提への対処はresolved。閾値の実機精度、逆方向旋回・別コース・微小滑りへの一般化は未確認。

## 2026-10-18午前の13472～13479：画角変化と画像生成の完了確認

旧動画の床点探索中心を新しい初期画像へ適用したprepareは、12点中の複数が可視性条件35画素を満たさず、追跡前に停止した。床上座標の据置と画像上の画素位置の据置は別。今回画像の色領域一覧と全8本の初期実画像を照合し、外周ピンク8点・緑4点の所属を再確認した探索中心へ更新した。校正は実測局所重心で実行し、全8本でfit/留保残差10mm未満、留保最大4.25～6.18mmを確認した。品質ゲートは変更していない。この観測済み対処はresolved。撮影中の全誤対応や物理計測誤差を保証しない。

同作業でシーク画像生成execがsession_idを返した直後に画像を開き、ファイル未生成で失敗した。返却sessionの終了コード0をwrite_stdinで確認してから開き直して成功した。再発防止は、依存する画像生成と表示を別段にし、全生成処理の終了コード0・実在・新規時刻を確認すること。13472の動画未記録はユーザー確認済みのデータ欠測であり、校正・追跡の失敗とは分ける。証跡はanalysis/video_slip_13472_13479のfirst_frames.jpg、calibration.json、floor_association_checks.json、video002_static_check.jpg。

## 2026-10-18午後13481～13498：可視6点校正の初期値依存

右下床点が画面外、左下床点の色可視面積が条件未満の動画は、見えているピンク6点をfit、緑4点を留保した。動画index8で焦点初期値1100pxの単一初期化は最適化successでも床逆投影の残差が約48/108mmとなり、既存10mmゲートで追跡前に停止した。画像の点所属は別途実画像と全点座標で確認し、未観測点を補完していない。原因は非線形解・逆投影の初期値依存が疑われるが、レンズ物理モデルの一意性は未確認。

初期焦点800/1100/1400pxで各々PnPから最適化し、fit点と実測高さだけのコストが最小の解を選んだ。留保点・走行ログ・滑りラベルは解の選択に使わない。index8のコストは6.68956/16.91825/16.91825で最小解を採用、全17動画の最大fit逆投影3.424mm未満・留保5.503mm未満を確認した。撮影中3mm/8pxと校正10mmゲートは変更しない。既知データでの数値処理はresolved。別撮影や物理計測精度の一般化は未確認。

再発防止：校正品質ゲートで停止した場合、点所属・可視性と最適化の初期値依存を分けて確認する。数値再探索ではfit側のコストだけで選び、全候補と採用コストを保存し、独立留保点の合格まで追跡を開始しない。可視点数に依存する配列境界もfit_pointsへ統一する。証跡はanalysis/video_slip_13481_13498/calibration.json、analysis_method.jsonとanalysis/script/analyze_video_slip_13481_13498.py。

## 2026-10-18午後：ROIで色領域を切断して重心が偏った（open）

13481～13498の独立シーク207フレームのうち14フレームで原追跡と全色領域中心の差が3px以上、最大7.670pxとなった。13481 frame609と13482 frame1507をフレーム番号指定で可逆BGR再抽出した。前者の黄領域は全403画素・ROI後108画素で中心差6.703px、後者の赤は全337画素・ROI後56画素で中心差6.450pxだった。ROI後の中心は元追跡と双方0px一致し、シーク時刻/JPEGだけを原因とする説明を否定した。床点の凸包は機体マーカーの全色領域を囲むとは限らず、画面外の床点を射影してROIを作るだけでも切断を防げなかった。

今回の対処は3pxゲートを緩めず、全17走の動画位置・横速度・矢印を物理滑りの正解から取り下げること。暫定CSV/画像を残し、採用版video_metrics_accepted.csvは0窓・速度未記録とした。ログXYと検出器カウンタは影響なし。元画像20窓60フレームを点検しても滑り有無を明確に分離できず、指定の動画不確定→XYルールで走行単位の17ラベルを保存する。finalizeスクリプトはログ品質と動画幾何の合否を別に保存するよう修正した。

次回の具体策：追跡のROIをマーカー成分の候補中心フィルターに使い、成分自体を切り抜いてから重心を求めない。変更前にROI近傍の走行中フレームで全色領域面積とROI後面積を比較し、部分切断を検出する。修正後は原動画の全走再追跡、独立シーク、窓被覆率、外れ値と目視で検証する。現在は再追跡未実施で動画定量は不採用のためopen。数値を使った閾値調整は行わない。証跡：analysis/video_slip_13481_13498/seek_roi_diagnostic.json、video_geometry_rejection.json、frame_seek_checks.json、exact_frame_roi_diagnostic_0_609.png、exact_frame_roi_diagnostic_1_1507.png。

### 13500～13503：今回撮影へのROI修復と初期化範囲の追加

新4動画の解析用スクリプトで、ROIを色マスクへ掛ける処理と床点周囲を塗り潰す処理を廃止した。全色連結成分の中心・面積を求め、その中心がROI内か・床点近傍かで候補を選ぶ。既知の13481 frame609の黄等は全成分中心がROI外となるため欠測として除外し、ROIに残った断片の中心を採用しない。元画像の6.703/6.450pxの偏りを事前に再現した。今回16枚の走行中フレームで採用中心・面積が全成分と一致することを確認した。事前検算も本体と同じ中心ROI・床点近傍の条件を適用し、木床等の全色成分の中から機体らしい距離だけで選ばない。

また、新撮影の6点校正では既存の800/1100/1400px初期化が同じ別解へ収束し、動画1のfit逆投影約23.985mm・留保11.535mmで10mmゲートが停止した。動画2/3にも同じ初期値依存を確認。点の所属を実画像で検査後、500/650/800/1100/1400/2000pxから初期化し、fit点と実測高さだけのコストで選ぶと最大fit2.59mm未満・留保5.934mm未満となった。動画1のコストは旧初期化12.992に対し低初期化7.573、動画2は14.927に対し8.455。留保点・ログ・滑りラベルで解を選んでいない。3つの初期値だけでは別解を避けられないことを再発防止へ追記した。校正10mm・撮影中3mm/8px・独立中心3pxゲートは維持する。

新4動画を全編追跡し、独立シークの横移動候補12窓36フレームで中心差最大0.741px未満を確認した。証跡は`analysis/video_slip_13500_13503/`のroi_component_preflight.json、calibration_initialization_diagnostic.json、calibration.json、tracking_v*_validation.json、frame_seek_checks.json。今回撮影での対処は検証できたが、前回17走は再追跡しておらず定量不採用のまま。過去系列のopenと物理滑り精度の未確認は維持する。ファームウェア・検出閾値をこの動画修復のために変更していない。

## 2026-10-26：新規スクリプトで床点数8を固定した

対象はPATH_CURVE動画002～008とログ13810～13816、今回レンズ高700 mm。新規校正の初期処理がピンク8点固定をassertし、動画004の左下点が画像端で観測できないため追跡前に停止した。既存の「可視点だけをfitへ使う」対策が新規スクリプトの候補選別・配列境界へ反映されていなかった再発。未観測点を予測で補完した校正結果は採用していない。

可視の床点IDを明示して8点または7点だけをfitへ使用し、留保4点と配列境界をfit_pointsで分けた。独立留保最大4.98 mm、fit最大4.83 mmで全7本が既存10 mmゲートを満たした。校正実画像の所属を確認し、追跡は同じ復号・色域・局所重心条件を使用した。未観測点を別点へ置換せず、校正へログを使用していない。

次回は校正スクリプトを書き始める前に全動画の初期画像で可視点ID・数を棚卸しし、固定8点のassertや先頭8個の切り分けが残っていないことをコード検索する。床点数と機体基準点は別契約として確認する。今回の機体は赤黄マーカーを識別できないため、全外形の中心を同じ直線・同じ方向の通過間の概算変位に限定した。車軸中心・真の方位・精密な滑り速度に読み替えない。全31通過の原フレーム指定再復号で固定背景と所属を目視確認し、測定線X=350/400/450 mmでも外側変位を確認した。

今回の点数固定と適用範囲の対処はresolved。過去17走の不採用と物理精度の未確認は維持する。証跡は`analysis/video_path_curve_13810_13816/`のreport.md、calibration.json、sensitivity.json、validation.json。ログ解析Skillの校正実装前へ可視点の棚卸しと基準点契約を追加した。

## 2026-10-27：下端の色候補選択が機体反射を床点へ誤対応

対象は実走13843～13846と動画002～005。下端の広いX区間ごとに最大画像Yのピンク候補を選ぶ処理が、動画003/004で機体側の反射（画像X約1021/964）を床点ID6（約1213）へ誤対応させた。fit残差約125mmで既存品質ゲートが追跡前に停止し、不合格校正による追跡は採用していない。前回の可視点数対策だけでは候補の所属を保証できなかった再発。

全初期画像で床点IDを確認し、点ごとに観測済み中心の±20px内で色成分の実測重心を取得する方式へ変更した。可視面積不足のID4を2動画で除外し、fit8/7/7/8点・独立留保4点とした。位置ずれ8px以内・色面積と残差10mmのゲートを維持し、全動画でfit最大4.779mm・留保最大6.893mm、校正画像の点所属を確認した。予測位置を実測点へ置換していない。この系列の誤対応対処はresolved、物理位置精度と別撮影への一般化は未確認。

同じ解析で周回比較の切抜き中心を機体の画像Xへ追従させ、固定床Y方向の比較を図で隠す不備も確認した。床座標と画像座標の軸は一致しないため、最初の通過から切抜き中心の画像X/Yを両方固定した。原動画SHA・フレーム番号の証跡を確認して全4図を再生成し、16通過で白線・床背景が固定されることを目視した。この図示対処はresolved。数値の床座標変位計算は変更なし。

再発防止は校正前の全点ラベル目視、IDごとの局所探索・欠測除外・独立留保検証と、相対変位図を生成する前の両画像軸固定である。ログ解析Skillの実行前へ追加する。画像表示時も生成器のmanifestまたはrg実在一覧から名前を取得し、連番を推測しない。今回pass_review_0.jpgという存在しない名を開いた後はmanifestのログ番号へ修正した。証跡はanalysis/path_fusion_13843_13846のcalibration.json、seed_inventory_v*.jpg、pass_review_13843～13846.jpg、frame_review.json、validation.jsonとanalysis/script/track_path_fusion_13843_13846.py。

### 同日23時の13853～13861：同じ床配置でも画像上の位置は変わる

旧系列の探索中心から床ID3の新実測中心までの差が8pxを超え、初回校正の位置ゲートが停止した。同じ高さ・床配置という確認を画素位置の据置と混同しかけた。全9初期画像でID別の候補・面積をラベル表示し、所属を確認した実測重心群の中央値へ探索中心を更新した。実fitには各動画の観測重心を渡し、面積不足のID4は除外。全9本でfit7点・留保4点、fit最大5.008mm・留保最大6.125mmで既存ゲートが通った。品質ゲートは緩和していない。この系列の探索中心修正はresolved、物理位置精度の一般化は未検証。

次回は校正起動前に今回フレームの全点をラベル表示し、旧中心との差と可視面積を検査する。旧画素位置は候補探索の手掛かりに留める。証跡はanalysis/path_fusion_13853_13861のfloor_inventory.json、floor_inventory_0～8.jpg、calibration.jsonとfloor_path_fusion_13853_13861.py。

## 2026-10-30：13924の床点欠測と機体探索ROIの混同

現画像の床ID4は白飛びしており、ピンクの候補重心が探索中心から12.6pxずれ初回ゲートが停止。ID6の粗い初期Yも1039に対して実測1007だった。元画像と全点パッチを目視し、ID4は欠測として除外、ID6は今回の実測へ修正した。before-floor-seed-refinementへ旧証跡を保持。fit7/留保4、最大3.501/4.272mmで従来ゲートを通過した。

機体追跡の初版は採用床点の凸包を板のROIに流用し、ID4欠測で左下の板内まで探索外とした。784/1578枚しか受理されなかったが、原解像度frame350/990で赤黄が板内に見えていた。before-board-roi-fixへ初版を保持し、現画像で確認した板外周[[69,119],[1815,134],[1844,998],[47,1057]]へROIだけを修正した。色・面積・基線長・カメラ品質ゲートは変更せず、1577/1578枚、走行区間99.85%を受理。

再発防止は全床点inventoryをassert前に保存し、欠測を推測で埋めず除外すること。校正採用点の凸包と実板外周を別契約にし、追跡欠測の代表原フレームを確認してから品質不足を宣言する。確認はanalysis/path_marked_20261030_071234のfloor_inventory.json、tracking_v0_validation.json、invalid_native_01/03.png、floor_white_skeleton_review.png。status: resolved（床点所属/探索範囲）、物理測定精度は未確定。
