Kageyana/robotrace_v2/doc/失敗事例/2026-10-18-unsealed-tmp-partial-recovery.md

---
type: codex-failure
date: 2026-10-18
task: RT_LOGのtmpからCSVへの復旧
status: open
severity: high
---

# tmpの確定情報欠落と過去データ混在により完全変換できない

## 事実

RT_LOGは今回G:のexFAT、空き約63.9 GB。13516～13520.tmpは各2097152 B、全5本の先頭512 Bが0だった。現行の通常取込はbin/CSVだけを対象としtmpを保持するため、自動変換されないのは仕様どおり。拡張子変更だけではヘッダ・全CRC・自己記述列の検証を満たさない。

各予約領域内には別番号の過去RLOGヘッダや列定義・メタデータ・CSV断片が残っていた。例: 13516.tmp内に13417の有効ヘッダ、13493等のメタデータが存在。これらは対象13516の確定情報ではない。古い領域内容から対象走行の終了情報や件数を確定できない。

## 対処と確認

analysis/sd-tmp-recovery-20261018/originalへ全5本をコピーし、SDとの前後SHA256一致を確認した。SDへrename/write/deleteは行っていない。

直前の13515.binの全CRC・実長・列定義を検証し、同じ72列/183 B形式を仮定して連続先頭部だけを抽出した。13516=1936行/5214 ms、13518=146行/405 ms、13519=526行/1581 ms、13520=526行/1587 ms。13517は先頭から整合を確認できず抽出しなかった。判定条件と停止位置は同フォルダREADME.mdとpartial-recovery.jsonに記録した。

抽出物はPARTIAL_UNVERIFIEDの診断用CSVとしてpartial/に隔離。正常な走行ログ・機体の経路元・自動取込へ公開していない。合成binは変換器用アダプタであり、原本CRC検証済みという意味を持たない。CSV全行の保存値は元バイトと対応することを検証したが、列形式仮定と元CRC欠落の制約は残る。

## 原因と次の確認

直接の変換不能条件は、確定ヘッダ・元CRC・対象走行の列定義/メタデータの欠落。保存が確定しなかった原因は未確定。現在のendLogはキュー書込失敗・logOverflow・markerOverflowや後続I/O失敗でtmpを残す。これらの実機状態、最終書込要求長/実長、truncate/scan/sync/close/renameの成否を取得してから原因を判断する。今回ファームに既存ユーザー変更があるため、根拠のない保存処理変更は行わない。

## 再発防止

- マウント文字は初回ドライブ列挙の結果を読んだ後に決定し、ラベルRT_LOGを照合する。過去H:を使わない。今回、列挙と同時に古いH:へ照会して失敗したため、参照手順へ依存順序を追記する。
- tmpは全ファイル保全とハッシュ照合を先に行い、予約サイズ・ヘッダ・別番号断片を調べる。別走行の終了メタデータを再利用しない。
- 正常変換と仮定付き部分復旧を区別し、部分物は別名・別フォルダ、元CRC未検証を明記する。元tmpをbinへ単純改名しない。
- Pythonの診断出力は起動前からPYTHONIOENCODING=utf-8を設定する。今回inspect_details.pyの初回出力はcp932で置換文字を表示できず停止した。設定後の再実行に成功しdetails.txtへ保存した。

実機での保存失敗原因と対策は未検証のためopen。部分復旧の保存値対応検証と原本保持は完了。

## 2026-10-27：13854の予約領域とレコード境界

13854.tmpも2MiB・ゼロヘッダ。全CRCを検証した一次13852の56列/154Bを仮定した。985行は時刻・値域が連続して見えたが、末尾1行は直前の完全512B境界をまたぐため保守的に除外し、984行・2.703秒までをPARTIAL_UNVERIFIEDへ抽出した。保存53列のCSV再パックが元バイトと全件一致することを確認。元CRC・期待件数・設定・終了理由は未記録であり、完全復旧にはしていない。連続性だけでは、書込み境界で新旧バイトが混じった1行を正常と見分けられない。

予約領域には13599の有効ヘッダと13849の全CRC合格コンテナが残っていた。後者のCRC合格は13854の整合性を意味しない。不整合直後の3.774秒の行と隣接キャッシュの完全行一致は見つからず、今回/過去の帰属は未確定。現writerはoverflow/writeFailed後の追記を拒否するため、時刻飛びだけで一時あふれからの復帰と推測しない。保存失敗原因はRAMフラグ・FatFs/SPI結果なしでは特定できずopenを維持する。

次回は連続性の条件に加え、採用末尾が512B/実書込単位をまたぐかを先に確認し、境界感度と除外行数を保存する。仮定付きCSVを正式ログへ公開しない。証跡はanalysis/path_fusion_13853_13861のtmp_recovery.json、tmp_forensics.json、validation.json、partial/13854.partial.csv。追跡/原フレーム生成の別ジョブも完了してからmanifestを読む。今回、生成ハンドルが実行中の段階でframe_review.jsonを読んで未生成エラーとなった後、同じハンドルの終了コード0を確認して90枚を検証した。

## 2026-10-30：13912の保存失敗と符号付き車輪変化

13912.tmpも2MiB・ゼロヘッダ。原本を無変換で保全し、同版の確定一次13911の56列/154Bを明示的な仮定にして解析した。初回は各車輪を単調増加とする条件により0.991秒で停止した。個々の車輪の逆回転を表現できる符号規約なので、新診断では経過時間に対する符号付き絶対変化幅を使う。これは逆回転の物理的正しさや元CRCを証明する変更ではない。

修正後も境界除外を維持し、984行・2.711秒までをPARTIAL_UNVERIFIEDへ抽出した。全984行の再パックが元バイトと一致し、同じ絶対変化幅条件が確定11ログを通ることを確認した。境界直後の3行は13900.binの同じ位置へ全154B一致し、予約領域には13902の全CRC合格コンテナも残る。これらを13912のデータ/終了情報へ転用しない。

ユーザーは13912を保存失敗・tmpのみと確認し、走行後に電源再起動した。13912のキュー/FatFs/SPI状態は失われており、保存失敗原因は未確定。原本CRC・期待件数・設定・停止理由・完走時刻は復旧できていない。確定10走のCRC合格や後の正常RAMでこの欠落を補わない。証跡はanalysis/path_unmatched_20261030_firstのtmp_recovery.json、tmp_forensics.json、tmp_continuity_gate_validation.json。status: open（保存失敗原因）、resolved（原本保持と診断の符号/境界契約）。
