Kageyana/robotrace_v2/doc/失敗事例/2026-10-25-staged-snapshot-whitespace.md

---
type: codex-failure
date: 2026-10-25
task: 現在の変更を8段階に分割してコミット
status: resolved
severity: low
---

# 分割した中間ソースの末尾空行でコミット前チェックが停止

隔離コピーで7段階すべてのDebugビルドと最終状態のホスト検証を実行した後、1段階目の`git diff --cached --check`が`sd_functions.c:142: new blank line at EOF`を検出した。コミット作成前に停止した。最終差分のチェックだけでは、中間状態だけに生じる余分な空行を検出できなかった。

中間ペイロードの末尾を改行1個へ整え、全段階の隣接状態を`git diff --no-index --check`で確認する。作業ツリーのCソースは変更せず、自分が追加したステージだけを元のHEADへ戻して分割を再実行する。ビルド成功と差分の空白検証を別の確認項目として扱う。

今後は最初のindex更新前に、全段階の隣接差分について空白チェックを実行し、全件成功した場合だけステージとコミットへ進む。index更新は既定の制限外権限を初回から使用し、対象パス、開始HEAD、元のステージ状態、作業ファイルのハッシュを確認する。実行前手順にも反映する。

全8段階の空白チェックが成功し、`build/commit-staging-20261025/whitespace.json`へ記録した。`--no-index --check`は空白エラーがなくても通常の差分で終了コード1となるため、0/1の終了コードと標準出力・標準エラーが空であることを併せて確認した。LFへ正規化した比較用コピーに限り`git -c core.autocrlf=false`を指定し、リポジトリ設定は変更していない。

末尾空行を修正した結果、3段階目の同ファイルは親と同一になったが、予定ファイル一覧には残っていた。このため2件作成後のステージ対象一致チェックが停止した。内容が親と同一であることを確認し、3段階目の不要な対象指定を除いた。中間内容を直した後は空白チェックだけでなく、Gitの改行正規化後のオブジェクトと親を比較し、変更のない対象を予定一覧から除く。既存コミットは書き換えず、作成済みの列とHEADを確認して残りから再開する。

この中間空白と確認ツールの判定修正は検証済みとしてresolved。後続のコミット結果は`commits.json`で別途確認し、全8件の完了・作業ツリーのクリーン状態・Cソース保全を終了条件とする。

## 新規ファイルが通常の差分検査から漏れた（同日）

ログ読込の所属整理をコミットする際、通常の`git diff --check`は成功したが、ステージ後の検査で新規`logSource.c`末尾の空行を検出した。未追跡ファイルは通常の差分検査に含まれず、行末の空白だけを調べる独自検査も末尾空行を検出していなかった。前回の中間差分対策だけでは、新規ファイルの事前検査を網羅できていなかった。

自分が追加したステージを解除し、末尾改行を1個に整えた。新規ソースと内部ヘッダを`git diff --no-index --check -- NUL <ファイル>`で検査し、エラー出力なしを確認した。共通事前確認へ未追跡ファイルの個別検査を追加し、ステージ後の全差分検査も維持する。この末尾空行の修正は検証済みとしてresolved。制御処理の変更はない。

## 作業ツリーの空白検査で改行正規化を無効にした（同日）

パラメータのヘッダ集約後、改行警告を抑える目的で作業ツリーの検査へ`-c core.autocrlf=false`を付けた。この指定はLF正規化済みの比較用コピーに限るという条件に反し、既存CRLFを行末空白として全行検出した。ソースの空白破損ではなく検査条件の誤りだった。

通常の`git diff --check`へ戻すと終了コード0となった。未追跡の記録も`git -c core.whitespace=cr-at-eol diff --no-index --check -- NUL <実在ファイル>`でエラー出力なしを確認した。作業ツリーでは既存の改行正規化設定を維持し、LF/CRLFの予告警告だけを理由にcore.autocrlfを無効化しない。共通事前確認へ追記した。検査条件の修正は検証済みのためresolved。リポジトリ設定・ソースの改行形式はこの誤判定対策では変更していない。

## 2026-10-29：改行の予告警告を空白エラーと誤判定した

新規文書のno-index検査で終了コード1・stdout空・stderrにLF→CRLF予告だけが出たが、stderr完全空を要求した補助スクリプトが停止した。空白エラーやNULはなかった。予告を抑える設定変更は行わず、既知形式の予告行だけを別項目へ保存し、それ以外のstderrまたはstdoutは失敗とするよう修正した。共通事前確認も同じ判定を明記する。check_records.pyで新規文書と融合C/Hの0/1・実エラーなしを確認した。status: resolved（検査の分類修正）。
