Kageyana/robotrace_v2/doc/失敗事例/2026-10-27-path-white-observation-reference.md

---
type: codex-failure
date: 2026-10-27
task: PATH_CURVEの周回ずれ補正と信頼度停止
status: open
severity: medium
---

# 前方白線の観測を車軸の軌跡へ直接照合した

## 事実と影響

一次13809の車軸XYから作った経路へ、約95 mm前方のラインセンサー点を直接照合したPC融合候補を27,648通り評価した。映像の同方向直線通過点の相対Y誤差は減ったが、同じ候補を実制御へ移し、白線照合なし150 msの信頼度停止を加えると13810～13816の全7本で0.740～0.847秒に停止した。白線の明部は見えており、初期カーブで残差が30 mmを超えていた。数値検算や直線の評価点の改善だけでは観測モデルを検証できていなかった。

## 原因と対処

車軸経路と前方で観測する白線は、小Rの旋回中に同じ位置列ではない。一次の10素子と保存方位・XYから白線観測の地図を別に作り、同じ周回変換を適用した。一次に観測がない点は欠測として保持する。全7本の初期カーブの停止は解消し、以後の欠測・照合不成立時に停止した。保存制御を固定した再生なので、実機で減速・ライン退避した結果の停止時刻や完走性とは異なる。

## 再発防止

融合実験の前に、観測する物理点・伝播する車体基準点・地図の基準点を明記する。前方センサーを用いる場合、一次自身の観測を車軸経路へ投影した残差と小R区間を確認する。全候補評価の後も、実制御の最近傍選択・ゲート・補正上限・周期・欠測停止を含む原本bin再生を実行し、評価点だけの改善で書込みへ進めない。方法を変えた再試験では旧プロトコルと結果を保全し、確認用ログの再利用を新しい未見評価と呼ばない。

## 確認と残件

`analysis/script/replay_path_fusion_port.py`で原本binを実型付き読込・実経路生成へ通し、補正上限200 µmと地図キャッシュ分離を確認。白線周期変換はO0/O2の境界検査を実施。全候補の第2版と実機検証は`doc/path-confidence-fusion.md`に記録する。新しい同条件走行での完走性と定量精度が未確認のためopen。

## その他の検証入口で検出した問題

原本のCROSS立上り抽出で前後比較の添字が誤り、イベントが空になって周期算出がNaNになった。既に画像・ログ対応を監査した一次のcrossingsを使い、2件以上・区間の旋回300～420deg・JSONの非有限値禁止を確認してから比較入力を確定した。旧不正出力は候補評価へ使用していない。次回はイベント件数・時刻・方向・最小区間を比較開始前の受入条件へ置く。

追加した停止出力テストで、ホストに定義していない製品のtargetAngularVelocityを直接参照しリンクが停止した。既存setTargetAngularVelocityモックが値を破棄していたため、受信値を記録するモックへ変更し、停止時のゼロを検査した。実コードの依存を増やしてテストの不足を隠さず、既存のモック境界と依存シンボルを新しいCHECKの前に照合する。

調査中に実在未確認の解析フォルダ・失敗記録やワイルドカードをrgのパスへ渡す既知の失敗が再発した。実ファイルはrg --filesで列挙してから選択し、検索対象は存在確認したディレクトリと-gに限定する。今回の再発を受け、共通事前確認の命令生成時にも存在検査を置く。

## 1ms移植時の観測頻度と位相

記録間隔で更新したEKFの観測分散をそのまま1msへ移すと、白線の情報を過大に数えた。XYの共分散相関で接線方向まで補正し、実制御の最近傍位相が先行して7本とも約2.58～3.73秒で照合不能停止した。PCモデルは保存optimalIndexを種にしており、この位相誤りを同じ条件では評価していなかった。

5ms基準から1msへの観測・伝播雑音換算と、単一白線で観測できる方向へのgain投影を導入した。全7本の初期カーブの誤停止は解消し、以後の未観測・照合不能で停止。任意gainに整合するJoseph等価形の共分散更新、O0/O2で2万周期の有限性・対称性・方向別二次形式、原本bin再生を確認した。数学的・移植検証と実機性能の採否は区別する。

独立の円軌道合成試験では位置誤差は減ったが、±0.2deg/sの真biasとの誤差0.1deg/s以内という当初の探索的期待は一部で未達（約0.111deg/s）。精度基準を達成済みにせず診断を残し、位置改善・符号・上限とbias精度を別に記録した。実物での収束・位相との分離は未確認でopen。

一括編集でUTF-8を明示しなかったPython読込が失敗し、先行する別ファイルの更新だけが完了した。全ファイルの読込・置換目印を先に検査してから書き込み、異常後は現状を読み直して残りだけを適用した。読書き両方のencoding指定と、前段成功後だけ依存する処理へ進むルールを命令生成時に確認する。
