Kageyana/robotrace_v2/doc/失敗事例/2026-10-27-stop-hold-output-vs-delay.md

---
type: codex-failure
date: 2026-10-27
task: 停止後2秒間のモーター停止制御保持
status: open
severity: medium
---

# 停止制御の継続をゼロ出力後の待機へ置き換えた

## 確認した事実

停止後の時間延長に対して、通常ゴールと緊急停止でモーター出力を0にしてからHAL_Delay(2000)を挿入した。ユーザーの意図は速度0になった後も停止用モーター制御を2秒継続することであり、この実装では割り込みがPIDを更新してもモーターへ反映しなかった。前の変更はビルド確認のみで、実機へ書き込んでいない。

## 原因と対処

停止を検出する条件、保持すべき制御出力、次の処理へ進む時刻を分けず、「待ち時間」を出力停止後の単純待機と解釈した。ユーザー訂正に従いHAL_Delayを外し、平均エンコーダ速度0の初回検出を起点にRUN_STOP_HOLD_MS=2000Uの間、速度目標0のPID出力を反映し続けるよう変更した。保持中は操舵0、保持終了後にモーター出力0とし、ログ確定・次走準備へ進む。

通常ゴールは既存case101を継続し、保持中に前進目標へ戻さない。緊急停止は速度0到達と保持終了まで速度PID出力を繰り返す。PID計算は既存の1ms割り込みを維持し、割り込みへ待機・SD処理を追加していない。保持中の再移動では起点を更新せず、目標0のPIDで停止へ戻す。真の物理速度と平均エンコーダ速度は同義と断定しない。

## 再発防止と確認

停止の時間を変更する前に、速度0検出→制御を保持→出力を切る→次処理の順序を確認する。保持中にPID値を変える試験で実出力APIへその値が渡ることを検査し、ビルド成功やタイマー境界の試験だけで保持を確認済みとしない。実停止経路を抽出したvalidation/stop_motor_hold/run.pyで、O0/O2、Wall/Wextra/Werror、0/1999/2000ms、時刻周回、通常/緊急の出力継続と終了、再走行リセット、HAL_Delayなしを確認した。結果はbuild/stop-motor-hold/validation.json。

意味の取り違えとホスト検証による対処はresolved。実機の停止保持時間・微振動・制動挙動は未確認で、本記録全体はopen。ビルド・デバッグSkillの実行前参照へ停止出力の順序確認とPID出力反映試験を追加する。
