Kageyana/robotrace_v2/doc/失敗事例/2026-10-28-path-sensor-cadence-prevents-recovery.md

# PATHの白線更新間隔と減速解除条件が合わない

- status: resolved（取得周期改善は13880/13881で実走確認）、open（周回ずれ・板外張出し）
- 対象: 一次13876・PATH_CURVE13877/13878、動画VID_20261028_203011_00_003、追加計測版SHA0ae5b57a…。
- 確認結果: PATH2走は19.691/20.437sで自己位置喪失停止。IRQ計測区間40,134標本の最大502.09µs、1ms超過/次tick保留0。白線更新間隔は最大6msで、age3ms以上が9,608標本（23.94%）。一次では最大2ms・鮮度切れ0。13878は3.238sから退避/復帰/減速状態が続き、大半を約1m/sで走った。約3.01sに機体の一部が板左端を越え、その後復帰した。末尾は明部が見えるまま未照合150msで停止。
- 原因として確認した点: 実pathObservationStep1msのO0/O2試験で、20ms未観測後に3ms新鮮/1ms鮮度切れを繰り返すと、回復カウンタは最大3msで100ms連続の解除条件を満たせない。1000ms後もCAUTIONが残る。これは合成入力による現行実装の性質で、実走の最初のCAUTION発生原因を確定するものではない。
- 原因候補/未確定: 優先度0のTIM6が、優先度1のTIM3・2のADC DMAを遅延させる。約250µsのLED半位相に対し120µs待ち/50µs走査余裕があり、取得窓を失効させ得る。取得要求棄却98,711件の理由別内訳や1msの履歴は未保存で、個々の棄却や停止原因の断定はできない。ADC開始/転送エラー0を取得品質の正常と同一視しない。
- 対処: リセットなしでFlash/RAMを保全し全Flash一致・RAMメタデータとSD全内容一致を確認。全3binの全CRC、動画全編/26確認フレーム、再生8条件、実関数の回復条件試験を保存した。ファーム/SD設定は変更していない。
- 再発防止: 1ms超過0だけで取得周期が正常と結論しない。モード別更新間隔・age・棄却と減速状態を同時に確認し、実観測間隔に対する回復条件を試験する。優先度/取得方式を変える場合はセンサー共有値の一貫性、割込み競合、IRQ最大時間を再検証する。鮮度/停止閾値だけの緩和で症状を隠さない。ログ解析Skillの実行前へ反映した。
- 確認方法: `analysis/script/check_path_interval_recovery_13878.py`、`finalize_path_interval_13876_13878.py`。証跡は`analysis/path_fusion_13876_13878/validation.json`と`build/isr-interval-validation/after-run-20261028T113242Z/`。改善後は同条件の走行と原本・動画・モード別取得計測を比較する。

## 取得優先度修正と静止450µs負荷比較

initSystemでTIM6を優先度3へ変更し、TIM3=1/ADC DMA=2を先に処理する。制御1ms中は公開raw/正規化/件数を固定し、ADCは平均化を継続して最新完成値を保留、処理末尾で一括公開する。2サンプル平均、安定待ち120µs、鮮度3ms、停止/回復条件は維持した。メタデータへ取得版2と設定優先度3を追加した。

Flash886669cc…を照合・起動確認し、直接GDB関数呼出しを使わない通常UIの静止試験で同一450µs負荷を旧0→新3→旧0→新3と交互比較した。旧は5133/5124標本で更新0、新は5119/5106標本で5118/5105更新・最大間隔1ms・鮮度切れ0。新のIRQ最大605.94/605.49µs、1ms以上0、次tick保留0。旧1回目はvalidSamples0なのでage超過0/最大gap0を正常と解釈しない。旧2回目は前の公開値が残りage超過100%だった。負荷/優先度/凍結/センサー/出力の復元とIPSR0、detachまで確認した。

静止負荷に対する取得停止と優先度による復旧は実証した。実PATH_CURVEの全原因や改善後完走を証明したものではない。100ms連続回復の条件は緩和しておらず、新しい一次と走行ログ/動画で復帰と周回ずれを確認する。status: open（実走検証）。証跡はbuild/adc-priority-validation/bench-v3/bench_validation.json。

## 取得版2の実走で更新回復を確認

13879～13881の全CRC/メタデータと、リセットなしで保全した全Flash/RAMを照合した。PATH_CURVE2走累積25,589標本で完成更新25,589回、最大間隔1ms、鮮度切れ0、棄却0、IRQ最大652.81µs/1ms以上0だった。2本は通常終了し、13881の途中退避は通常追従へ復帰した。取得遅延と長いCAUTIONの対策は実走確認済み。ただし動画13881では約5.514秒に板外張出し、5通過Y+16.57mmが残る。取得競合の修正と物理目標の達成を分ける。status: resolved（取得周期の改善）、open（周回ずれ・コースアウト防止）。analysis/path_acquisition_220117/validation.json参照。
