Kageyana/robotrace_v2/doc/失敗事例/2026-10-29-path-transient-board-protrusion.md

# 周回の相対ずれが小さくても、過渡横偏差で板外へ張り出す

- status: open
- 対象: 融合版3・白線地図版2、一次13893/走行13894、動画VID_20261029_002102_00_002。
- 確認結果: 740mmで今回画像を再校正し、同方向・同床位置5通過の外形中心の最終Y変位は+1.362mm。前回13881の+16.572mmより小さく、凍結した融合再生は+1.283mmだった。しかし元解像度frame1192、動画9.943267秒/ログ約5.470800秒で、左直線の機体外形が木床側へ張り出す。最初の発生時刻を特定したものではない。
- 整合するログ: 近傍5.469秒は横偏差-22.51mm、方位偏差+0.54deg、角速度指令343deg/s・実測365.8deg/s、右端8/9の白線値3489/3786。終了まで記録状態はTRACKING、emcStop0、終了信頼度1000。全暗部100未満とは異なり、完全逸脱停止5は発動対象ではない。
- 原因/未確定: 累積する自己位置ずれと、曲線から直線への過渡追従偏差を分ける必要がある。取得12784周期は最大間隔1ms・鮮度切れ0・IRQ最大600.372µsなので、今回の張出しを取得周期問題の再発と扱わない。近傍の白線は右端へ移動し、横偏差は約-25mmまで増える。一次経路/白線地図の形状と先読み曲率FF・方位/横FB・速度変化の因果は未確定。
- 次の調査: 現行FFは最近傍から先読み先までの平均方位差/弦長で、現在位置の局所曲率とは異なる。先読み幅40+20vの曲率、局所曲率、予定/実測角速度と横偏差を同じ進捗で比較する。local_curvature_diagnostic.jsonは凍結再生地図からの中央差分を保存した診断であり、新指令の採用や閉ループ改善の証拠ではない。ゲイン・速度・停止閾値を同時に変更しない。
- 再発防止: 小さい周回間変位や通常終了を板内走行の証拠にしない。全通過・全周の代表画像に加え、追跡bboxの端への最接近フレームを元解像度で確認する。可視外形中心は車軸中心/真の方位ではない。現在の全10素子の明暗、保存偏差、操舵成分、取得/RAM統計を別の証拠として照合する。
- 確認方法: analysis/path_heading_20261029_002102のreport.md、manual_review.json、full_frame1192.png、validation.json。13本の全CRC・全CSV再変換・56列全有限値、RAMメタデータ全項目一致を確認済み。修正後の板内走行と同条件10走の再現性は未達で、解決扱いにしない。

## FF2初実走13896

制御版20/FF2を実装・書込み後、一次13895/二次13896、動画VID_20261029_071042_00_002を740mmで照合した。最大記録横偏差は25.345→17.515mm、取得12777周期は間隔最大1ms/鮮度切れ0/IRQ最大664.833µs。ユーザーは「はみ出さず完走した」と確認した。元解像度916/1214/1524/1828などの板端画像はぼけ・小さい余裕があり、今回の動画単独では板外有無を断定せず、申告と独立観測を区別する。

相対Y変位は最終+2.775mm、途中最大+7.059mmで、1走を5周ぶんの成功本数へ加算しない。ログ同期の最良スコアは類似走行13894だったため、対応を自動スコアだけで変更せず、ユーザーの13896指定とRAM/SD全メタデータ一致で確定した。別一次・平均電圧が低い条件であり、過渡偏差改善の因果・同条件10走の再現性は未検証。analysis/path_yaw_ff_20261029_071042/validation.jsonへ全原本・O0/O2凍結再生・目視対象・申告を保持した。status: open（1走の実機申告は確認、再現性と独立動画の板端余裕は未確定）。

## FF2追加10走と13898

一次13900の13901～13910は全10走の板外なしをユーザーが確認し、10走の収集は満たした。しかし同じFF2の一次13897・13898は実際の逸脱と停止7が確認され、成功系列だけでは解決にしない。13898は動画なしで、未照合初期の速度目標増加を確認したが、直接の物理原因は未確定。詳細は[未照合中の再加速](2026-10-29-path-unmatched-reacceleration.md)。status: open。
