Kageyana/robotrace_v2/doc/失敗事例/2026-10-29-path-unmatched-reacceleration.md

# 白線照合を失った初期区間でもPATH_CURVEが再加速する

- status: open
- 対象: 周回ずれとコースアウト防止、制御版20/FF2、一次13897・走行13898。
- 確認結果: ユーザーは逸脱・板外へのはみ出しを確認し、場所を「長い直線のカーブを曲がって次のカーブを曲がろうとしたとき」と説明した。動画なし。8.085秒で自己位置喪失停止7、未照合150ms、終了信頼度0。未照合初期7.937～7.996秒の実保存速度目標は約1.50→2.31m/sへ増えた。
- コード上の条件: 有効照合がなくてもCAUTION閾値へ届く前は計画目標へ加速できる。単一の明部があることは地図との有効照合を意味しない。30mmの照合残差上限や全暗部20ms停止を緩めて対処しない。
- 原因/未確定: 端点保持白線・区間平均運動・鮮度正常を仮定した凍結再生でも未照合末尾149msが再現した。保存実入力の全1ms履歴はなく、差を1ms追加して合わせていない。照合幾何と運動で説明できる可能性があるが、物理原因や対処の因果は確定していない。後の13900～13910のADC正常RAMを13898へ転用しない。
- 対処: PC専用Cコピーで有効照合なしの周期は目標の増加を保留し、予定減速は許す案を12走へ比較した。失敗区間の再生目標最大2.34→1.50m/s、全12走で未照合中の正加速なし、有限値と固定運動での推定/照合列同一を確認。正常ログにも0.56～1.08m/sの目標低下があり、実タイムと板内走行の効果は未検証。現時点ではPC案で、実機版20は未変更。
- 再発防止: 新しい速度方針は、失敗13898と同一次の正常13899、別一次の成功13901～13910を含め、未照合の初回周期・継続・回復、計画減速、PATH/SHORTCUT分離、緊急停止を実Cで検証する。全4ビルド・両ログ形式・新規メタデータ・1ms経路の責務を確認してから書込む。成功10本の収集を満たしたことと、既知の物理失敗を解決したことを分ける。
- 確認方法: analysis/path_yaw_ff_20261029_repeat9/validation.json、failure_13898.json、unmatched_acceleration/validation.json。全14原本CRC/CSV/56列、24凍結再生、PC12比較をSHAとともに保存した。実機対処後の初回ログと物理確認が得られるまでopenとする。

## 版21の実機用実装とPC検証

加速保留を実機用のpathFollower.cへ反映し、制御版21/保留版1のメタデータを追加した。実センサー判定を通した境界・減速・100ms回復・方式分離・喪失停止をO0/O2で検証し、12走×O0/O2全24トレースが凍結PC案と全バイト一致した。全4構成で新規warning0、RAM増加0、両ログ形式のCRC/全メタデータ/PC変換を確認した。証跡はbuild/path-unmatched-speed-validation/validation.json。ここでの実機像はまだ版20で、新版の書込み/実走・板内走行・処理時間は未検証。status: open（物理的効果）。

## 版21の書込みとSD復帰後の停止確認

版21 ELF bc7a3fca…を書込み、全254652Bを読み戻して一致した。初回SD0の既定値状態を保存し、ユーザーのSD挿入・再起動後に再書込みせずIMU/SD正常・7.946102V・停止/出力0/Fault0・前回設定22項目一致を確認した。デバッガ解除と所有サーバー終了済み。証跡はbuild/path-unmatched-speed-validation/validation.json、手順はdoc/path-unmatched-speed-hardware.md。書込みと停止起動は確認済みだが、版21の実走、板内走行、走行時間、実1ms負荷は未確認。status: open（物理的効果）。

## 2026-10-30：版21の実走10本と未確定事項

一次13911、確定13913～13922は停止理由0で全10走通常終了し、全CRC/CSV/56列を確認した。ユーザーは保存失敗13912を含む動画002～012の11走すべてのはみ出しなしと、13912直後の電源再起動を確認。確定10本は各5通過を動画で照合した。12.841～12.874秒、相対Y変位は途中最大7.727mmだが、周回ごとの増加傾向が残る。前回系列と一次・電圧が異なるため、加速保留単独による物理的改善とは断定しない。

13922の保持RAM/Flashは凍結像・SDメタデータと一致。115719周期でIRQ最大650.272µs/1ms超過0、ADC最大間隔1ms/鮮度切れ0。ただし連続計測9区間で、再起動後の確定10走の計128579msと不一致。後9走に近い量という推測を個別帰属へ昇格させない。13912は今回のRAM範囲外で、正常な後続ADCを同走へ転用しない。

13912はtmp984行の仮定付き診断のみで終了情報は不明。動画の左直線上の早期停止は5周通常完走に混ぜず、分類を確認中。証跡はanalysis/path_unmatched_20261030_first/validation.json、報告は同report.md。固定運動40再生の指令方針確認と、実際の閉ループ挙動・自己位置精度を分ける。同版の10走収集は達成済みで追加9走を要求しない。次の判断では全通過の傾向と実Cの白線重心、内部方位、地図・計測範囲を参照し、停止条件や照合残差を緩めない。status: open（残留増加・13912・計測範囲・過去失敗への物理因果）。
