Kageyana/robotrace_v2/doc/失敗事例/2026-10-30-circular-heading-interpolation.md

# wrap済み方位角の線形補間が偽の大角度誤差を作った

- 対象タスク: 13924の実C再生と赤黄マーカー方位の比較。
- 確認結果: +180/-180境界を通常の数値として補間し、途中の比較図に約170度の偽スパイクが発生した。元の動画方位・実Cトレース・実機は変更していない。
- 原因: 循環角を連続量へ戻さずnp.interpへ渡した。
- 対処: 再生方位をradへ変換しunwrap後に補間、差だけを[-180,180)へ戻す。修正後の比較最大4.821度。
- 再発防止: 179→-179度の中点が180度付近になる合成確認を比較開始前へ置く。実測欠測の埋合せと角度の表現変換を区別する。
- 確認方法: analysis/script/compare_marked_071234.pyとoptical_comparison.json/png。
- ステータス: resolved（角度補間）。カメラ/マーカーの物理精度は未確定。
