Kageyana/robotrace_v2/doc/失敗事例/2026-10-30-marker-synthetic-projection-contract.md

# 色点方位検証のぼけ長と逆投影の数値契約

- 対象: 周回ずれを横位置/方位へ分けるための前赤・後黄2点測定器。実機へ接続せず、合成画像と保存動画で検査した。
- 確認結果1: 31pxのぼけを作るつもりで、対角線のX/Y幅を各31pxにしたため、実支持長が約sqrt(2)倍になった。既知角-179degの2番目のぼけ条件で赤/黄候補0となり、正常採用を要求した検証が停止した。失敗したソース・プロトコル・画像・詳細結果をbefore-blur-support-fixへ保全した。
- 対処1: ぼけ長を対角線のユークリッド長で構成し、両点の支持領域が分離する条件を量子化幅込みで定義した。検出器のHSV閾値・面積・間隔・感度のゲートは緩めていない。修正後の0/15/31px・3位置・10角度の90条件が通過した。
- 確認結果2: 同高点の逆投影角を1e-7deg以内で検算したところ、既存共有関数の既定レンズ逆補正に最大8.07984e-6degの差があり停止した。物理的な画像精度の評価ではなく、合成投影/逆投影の数値契約の問題。before-projection-inverse-fixへ36条件を保全した。
- 対処2: 新しい測定器内だけで逆補正の反復収束条件を明示し、再投影画素とも照合するようにした。共有の過去校正・追跡関数と既存証跡は変更していない。同高36条件が元の1e-7deg条件を通過した。極小の数値差の解消を実機の方位精度向上とは扱わない。
- 再発防止: 合成入力の長さはカーネルのX/Y幅でなく実支持長・平均化・色の明るさとして確認する。合成の正常条件と過大露光/欠測の棄却条件を分ける。投影の理論精度とレンズ逆計算の収束、実画像の画素/露光/高さ差を混ぜない。数値不一致の解消のために色/幾何品質ゲートを緩めない。ログ解析Skillの検証前手順へ追記した。
- 確認方法: analysis/script/validate_body_marker_heading.py、finalize_body_marker_heading.py、analysis/body_marker_heading_preflight/validation.jsonとreadiness_validation.json。90既知角、10不採用、同高36条件、追加高さ差36条件、未確認参照のCLI棄却を確認した。
- status: resolved（合成入力・数値契約）。新しいマーカー付き実動画の識別/精度と、実機のずれ抑制は未検証。
