Kageyana/robotrace_v2/doc/失敗事例/2026-10-30-normal-log-physical-scope.md

# ログ正常終了と物理完走の確認範囲

- 対象: path_arm_trial_20261030と入力復帰の比較に使った23走。
- 事実: 過去報告の「完走済み21本」はemcStop=0の21ログを指していた。実際にユーザーが板内完走を確認したのは13901～13910と13913～13922の20本。13899はmode5/emcStop0/一次13897を確認できるが板内完走の明示確認はない。
- 原因: リプレイ集合から失敗2本を除いた集合を正常と呼び、プログラム上の正常終了と物理的な板内完走を区別しなかった。
- 対処: 元CSVのSHAとmetadataを再照合し、classification.jsonにログ終了コードと人間の確認を別々に保存した。過去の不変成果物と数値は保持し、別の訂正文書を付した。13899を未完走と断定しない。
- 再発防止: 評価集合を作る際にmetadata_normal/physical_confirmed/physical_unknownを明示する。emcStop0を板外はみ出しなしの根拠にしない。方式の採用や10走の物理確認は実物・対応動画・ユーザー回答で別に検証する。
- 検証: path_input_handover_20261030/classification.jsonで23走、ログ正常21、ユーザー確認20、未確認13899を照合。元の周期欠落14件はすべてユーザー確認20本の中にあり数値結論は変わらない。保持9方式の採用候補なしも両集合で同じ。
- ステータス: resolved（分類・表現・手順の訂正）。open（13899の板内完走、実機の欠落履歴、新方式の実走）。
