Kageyana/robotrace_v2/doc/失敗事例/2026-10-30-path-trend-overstatement.md

# 最大変位が小さいことを、周回の増加傾向がないことへ読み替えた

- status: resolved（説明・報告・診断手順の訂正）。残留ずれの物理原因と対処はopen。
- 対象: 版21、13913～13922の10走・各5通過、レンズ高700mm。
- 確認結果: 相対Y変位の最大7.727mmを確認した段階で「周回ごとに増え続ける変位は見えない」と説明・報告した。しかし全通過の図には13914などの増加傾向があり、この説明は過大だった。元の数値・原本・追跡結果は変更していない。
- 原因: 最大幅と最終値の範囲から、系列の傾向を十分に確認せず結論を広げた。5周以内で板外なしという申告と、ずれ解消・長周回安定は別の要件である。
- 対処: 訂正前の報告・検証JSON・ソース・図・対応先をbefore-trend-correctionへ保全した。全5通過と後半4通過の傾き・単調性を算出し、全5点の傾き0.479～1.584mm/通過、後半でも増える例を明記した。ユーザーへの説明も訂正した。
- 追加確認: 50通過を近い保存行へ対応させ、全56列、センサー重心、方位偏差、車体姿勢、速度、スリップを保持した。実Cの白線抽出器をO0/O2で実行して全出力一致を確認した。これは前方約95mmのセンサー座標であり、映像の外形投影や世界Yと同一視しない。保存されていない鮮度・地図照合履歴は復元していない。
- 再発防止: 最大値・最終値だけで増加傾向なしを宣言しない。全通過図を確認し、全点/初回を除いた傾向・単調性・数値を保存する。5点の傾きを真のバイアスや長周回予測へ読み替えず、並進・方位・スリップ・車体基準点と前方観測点の差を分ける。残る増加を無視して採用・増速・目標完了にしない。
- 確認方法: pass_diagnostics_unmatched_first.py、per_run_trends.json、pass_sensor_diagnostics.csv、per_pass_diagnostics.png、更新したreport.mdとvalidation.json。訂正前はbefore-trend-correction/relocations.jsonから参照する。
