Kageyana/robotrace_v2/doc/失敗事例/2026-10-30-video-post-run-coverage.md

# 走行後に機体を取り除いた映像を走行中の欠測へ混ぜた

- status: resolved（品質評価の区間）、物理的な板端余裕の精度は未確定。
- 対象: 版21の13922、VID_20261030_000915_00_012、レンズ高700mm。
- 確認結果: 動画30.472秒のうち追跡有効1197/1827点、全体65.52%のため、最初の比較器は80%基準で定量解析を除外した。元動画の中間では走行中、末尾では機体が取り除かれていることを確認した。同期した実ログ区間は4.422～17.294秒で、その区間の有効率は100%だった。
- 原因: 通常より長い走行後映像を、制御ログが記録した実走区間の追跡品質へ混ぜた。走行後の不在を走行中の欠測とする区間定義の不備で、追跡器の失敗や位置の補完とは別である。
- 対処: 初回の除外結果・比較図・ソースをanalysis/path_unmatched_20261030_first/before-run-window-qualityへ保持した。元追跡の全体有効率と全欠測点は保持し、ユーザー指定対応とgyro/運動同期を確認した実ログ区間へ同じ80%閾値を適用した。方位誤差12deg未満・相関0.8超・校正誤差10mm以下などのゲートは維持した。
- 再発防止: 品質評価前に録画全体と実走区間を区別し、同期根拠、両区間の有効率、境界、除外理由を別々に保存する。都合のよい部分区間を選ばず、元ログの先頭～末尾全体で判定する。欠測を正常へ補完せず、区間内不合格点も元画像で確認する。
- 確認方法: compare_unmatched_first.py、matched_runs.json、body_v10_validation.json、before-run-window-quality、qa_manifest.json。修正後は13913～13922の10対応動画・50通過を定量比較し、走行後の空の板の元画像と区間内の元画像を別に確認した。可視外形の床投影であり、全接地点の包含や数mmの板端余裕を証明していない。

## 2026-10-31：録画開始遅れと保持RAM時刻の欠測

- 対象: 実験版22の13928、VID_20261031_070745_00_002、700mm。
- 確認結果: 旧比較器は非負offsetだけを探索し、相関0.167・角速度RMSE369.6deg/sで停止した。先頭画像では既に移動中。負offsetを含めると-0.159030秒、相関0.999225・角速度RMSE12.247deg/s・全ログに対する角速度被覆95.208%で同期した。冒頭0.159秒は未撮影で、全期間の開始位置は独立に観測できない。
- 対処: 旧比較worker/producerと失敗値を保全した。最初の実観測0.004171秒を一度だけ位置/方位の基準とする相対比較を別成果物へ保存し、SG開始時の絶対測定と呼ばない。全時間fitや未観測軌跡の補完はしていない。事前指定の冒頭基準5件で位置誤差の感度も保存した。
- 追加境界: 保持RAMの最後の実制御14.257秒に対応する映像時刻14.097970秒の前後点は41.709ms離れていた。最初の実装は25ms上限assertで停止。上限を緩めずavailable=falseとし、17ms前の映像や物理停止後へ置換しない。失敗時の部分CSVはbefore-native-endpoint-gapへ保持した。
- 精度限界: frame1569のHSV方位感度1.997°は従来1°基準に不合格。5通過幅2.839mmは床校正最大4.517mm程度の診断に留め、第五通過と全点方位の精度合格を宣言しない。左下の外形が板端へ重なる投影も、視差/ぼけのある接地部包含証明とは扱わない。
- 再発防止/確認: Skill入口に負offset、未観測先頭、同時刻補間上限、HSV不合格の保持を追加。diagnose_curve22_sync.py、compare_curve22_partial_reference.py、qa_curve22_070745.pyで同期・相対比較・44原画像/12姿勢の9条件感度・非単調な全5点傾向を確認。物理停止時刻と未観測先頭は復元していない。
- status: resolved（同期/測定範囲の扱い）。open（全点方位精度、接地部余裕、自己位置と映像の残差原因）。
