Kageyana/robotrace_v2/doc/失敗事例/2026-10-30-white-only-lateral-state.md

# 白線からの横速度学習が合成試験と実ログで一致しなかった

- 対象タスク: PATH_CURVEの周回ずれ対策、13924の独立色点測定に基づく5状態推定の試作。
- 確認結果: 位置・方位・gyroずれに横速度を加えた9設定を作成。真値既知の横速度振幅300mm/sの合成では位置RMSE112.68→最良11.99mmへ減少した。一方、13924の初周選択で最良の設定も後半RMSE49.60→51.40mmへ悪化。全9組が2種類の固定座標整合で悪化し、一部は初周途中で照合を喪失した。
- 原因/未確定事項: 白線残差を横速度・方位・gyroずれへ配分するトレードオフがある。横移動なしの合成でも、モデルの一部で方位誤差が0.029→約1.38degとなる。実機の主原因、撮影誤差、一次地図・初期姿勢の影響や、保存間隔内の未記録入力は分離未完了で、単一の原因と断定しない。
- 対処: PCコピーだけで試し、製品は変更していない。全23走×10設定×O0/O2の460再生と30既知状態×O0/O2を完了。横速度無効の基準23走は旧C21と全バイト一致、全最適化間一致、位置/方位補正上限と未照合中の増速禁止を維持した。白線照合回数の増加だけでは採用しない。
- 再発防止: 車体基準点の独立測定と白線地図の点を区別し、合成真値、白線照合量、独立映像の方位/位置、過去走の退行を別に保存する。残差への状態追加ではゼロ横移動の対照も含める。保存間隔から実際の1ms履歴・診断有効性を復元できると仮定しない。
- 確認方法: analysis/path_marked_20261030_071234/lateral_state_probe/final_validation.jsonとreport.md。次は依頼済みの右下げ静止状態で加速度Xの物理符号を確認し、独立慣性入力を併用する候補を検証する。
- ステータス: open（物理原因・採用可能な推定モデル）。今回の9候補を採用しない判断とホスト検証は完了。
