Kageyana/robotrace_v2/doc/失敗事例/2026-10-26-path-curve-odometry-hides-physical-drift.md

---
type: codex-failure
date: 2026-10-26
task: PATH_CURVEの周回YずれとログXYの不一致調査
status: open
severity: high
tags: [robotrace, path-curve, odometry, observability]
---

# 実位置が外れてもPATH_CURVEの内部推定とログXYが仮想ライン付近に残る

## 確認した事実

ユーザーは10/25深夜～10/26の全PATH_CURVE走行で、1走行中の周回ごとにY方向へずれ、高速時はコース板から外れたと報告した。この観測を物理走行の正とし、低速PATH_CURVEやemcStop=0を正常例にしない。

CSV保存時刻23:00以降の13742～13808は66本（13798は未観測）。新モードは13782～13808の20本。全20本で明部閾値800以上のラインセンサーが0個の記録区間があり、位置補正係数lineAlphaは全20本で0。13783を除き、保存状態は全行TRACKINGのままだった。

13808では明部0の近似合計4.031秒、同状態の最長記録区間10.053～10.696秒（0.643秒）。その最長区間の推定横偏差は14.49mm以下、全走行の最大でも15.79mmで、pathState=1のまま終了した。白線観測は後半の周回で悪化している。

全66本の元binについてヘッダ・データ・列定義・メタデータのCRCと実長、CSVとの識別・メタデータ一致を確認した。raw左右積算平均と保存積算角度から再計算したXYはCSVと最大0.003268mm未満の差。変換による閉路強制や整列を原因とする証拠はない。

## 原因として確認した実装と未確定事項

- 制御のpathPoseとCSVのXYは、どちらも車輪距離＋ジャイロを使う。実位置の独立な測定ではない。車輪空転、横移動、方位誤差等の影響を共有し得る。
- pathErrorY_mmは推定位置の経路接線に対する横偏差で、世界座標Yの実偏差ではない。
- TRACKINGでの白線未観測だけでは退避・停止へ移らない。白線消失100msのロスト条件はLINE_FALLBACKに入った後に適用される。通常の明暗停止はPATH系では使用しない。
- PATH系のゴールは推定弧長であり、DISTANCEのマーカー距離補正はPATH_CURVEには適用されない。
- リセットは走行開始時。1走行内の周回ずれを開始時リセットだけで説明できない。

以上は「物理ずれが内部XYへ現れない」観測限界を説明する。実Yずれを発生させた物理原因と各誤差の割合、実移動量は未確定。滑りだけと断定しない。

## 対処・次の調査

原本を保持し、analysis/path_curve_y_drift_13742_13808/report.mdと各表・図へ結果を保存した。今回は解析のみでファームウェア・SD設定・機体書込は変更していない。

次の制御変更では、PATH_CURVEの白線観測欠落を自己位置の信頼度に反映する条件と減速・停止を検証する。通常のクロスや短い欠落と区別する。位置補正の検討では残差・有効性・適用拒否理由を確認し、直線の接線方向には独立したマーカー等の位置情報が必要な点を維持する。多数の不整合CROSSを無条件に補正へ使わない。実Y位置の復元と原因分離には動画または実測基準との照合が必要。

## 再発防止・確認方法

PATH系のXY・推定偏差が小さいことを物理追従成功の根拠にしない。実機観測を先に保持し、lSensorCari0～9、pathState、位置/方位補正設定を照合する。解析手順にPATH_CURVEとこの検査を追加する。

リポジトリルートから以下を実行し、対象本数・全CRC・入力ハッシュ・記録間隔・列数・ユーザー異常ラベル・図を確認する。

```powershell
python analysis/script/check_path_curve_y_drift_13742_13808.py
python analysis/script/validate_path_curve_drift_bins.py
python analysis/script/analyze_path_curve_y_drift_detail.py
python analysis/script/report_path_curve_y_drift.py
```

観測限界の診断と解析は検証済みだが、実Yずれの原因分離・制御修正・実走行再現性は未確認のためopen。

## 22時台の動画002～008／ログ13810～13816での確認

ユーザー訂正の動画`VID_20261026_220114_00_002`以降をログ13810以降へ対応付けた。今回のレンズ高は700 mm。旋回タイミングでも7本の対応が一致し、映像の移動方向変化とgyroの相関0.959～0.976。機体の赤黄点は識別できず、外形中心の床投影を同じ直線・同じ方向の通過間だけで概算比較した。真の車軸位置・機体方位・滑り量としては扱わない。

13811・13812・13814の初回～5回目通過で、機体外形基準点は板の外側へ約56.8/53.7/84.8 mm移動した。固定の原点・方位対応をしたログXYは同じ通過間で逆向きに約24.8/27.3/27.4 mm変化。全31通過の原フレーム指定再復号と固定背景で所属を確認した。測定線X=350/400/450 mmでも同じ外側変位を示した。全7走でずれを確認したが、13810は途中で内側へ戻り単調でなく、13813・13816の5回目は品質条件付き定量値なしとして4回目まで保存した。

全7走が全記録TRACKING、位置・方位補正係数0。13811は明部800以上なしの最長記録スパン0.485秒、内部横偏差最大15.73 mm、emcStop=0。物理的追従成功へ置き換えない。対応する一次13809を含む元bin8本の全CRC、CSV識別、実長を確認し、左右生積算＋保存積算方位からのXY再計算差は最大0.002473 mm。原本動画7本とCSV8本の前後SHA256一致。

これで物理的な周回ずれと内部XYとの不一致は動画でも裏付けられた。校正留保残差は最大4.98 mmだが機体位置の精度保証ではない。直線以外の速度表も走行間で変わっており、直線速度だけの因果比較や滑り／方位誤差の寄与は未確定。制御・SD設定・実機書込は今回追加変更していない。解析は`analysis/video_path_curve_13810_13816/report.md`、再監査は`analysis/script/finalize_video_path_curve_13810_13816.py`。物理原因分離・制御修正が残るためopenを維持する。

## 同日：ユーザー依頼による完全逸脱停止の追加

全10センサーの正規化値100未満が20ms連続したら、PATH系のTRACKINGを含む全走行モードでemcStop=5を要求するよう変更した。1個でも100以上でカウント解除する。これまでの中央4個・151ms・PATH系除外を改めたもので、解析で用いた明部800以上なしと停止条件を混同しない。

実関数・ISR条件のO0/O2境界試験、Debug/Release/DebugMarkerビルド、新規warning0、Flash書込照合、モーター出力0の実機での19/20回と各10センサー境界を確認した。値と割込み設定を復元してdetach・自分のGDBサーバー終了まで確認済み。詳細は`doc/path-line-loss-stop.md`。新制御による実走行は未実施で、誤停止・センサー実応答・制動距離の確認は残る。

完全逸脱停止の実装と静止検証は完了したが、ずれを生じさせる物理原因と自己位置の観測限界は解決していないため本件はopenのまま。

同日、ユーザーから「実走行でも確認できました」と報告を受け、完全逸脱時の緊急停止の動作確認を実走行確認済みへ更新した。ログ番号・試験回数・停止時間・制動距離は未特定であり、定量検証済みとはしない。完全逸脱停止の動作確認と、周回ずれの原因・自己位置の観測限界は分け、本件全体のopenは維持する。
