Kageyana/robotrace_v2/doc/失敗事例/2026-10-24-cleanup-host-fixture-contract.md

---
type: codex-failure
date: 2026-10-24
task: mainの未使用コード・旧CSV処理整理
status: resolved
severity: low
tags: [codex/failure, host-test, fixture]
---

# 抽出依存と故障注入段階の前提を確認した

## 2026-10-25：1ms経路更新試験の白線前提

経路更新を5ms→1msへ変更する試験で、白線を模した中央2センサーの値だけを設定した初回は、100ms後にライン退避するとしたアサートが失敗した。`resetMock()`が校正有効フラグをfalseにしており、実`pathSenseLine()`は明部があっても白線観測を拒否していた。校正済み・クロスライン外を明示し、状態遷移試験の前に実白線観測が成功することを確認するように修正した。

次の補正換算試験では、中央2センサーの重心が横0mmと仮定した期待値0.998mmが失敗した。取得した実値は位置0.997990012mm、残差1.005mmであり、定義済み相対配置から求めた重心の横0.005mmを期待値から落としていた。実`pathSenseLine()`の観測位置を使って既知の1/5係数に対する期待値を求め、閾値や許容誤差は緩めていない。これらはホスト入力の前提誤りで、製品の制御バグではない。

再発防止として、白線を使う新規ハーネスでは校正・クロスライン除外・明部の連続性・取得観測の成否を初回から明示する。センサー重心は配列から取得し、中央素子の対称性を仮定しない。書込み・デバッグSkillの実行前参照へ追記する。

リポジトリルート・必要権限の`python validation/log_storage/run.py --converter C:/tool/AutoCopyCsvFromSd/RlogToCsv.exe`がexit=0。両プロファイルで100/200/100msの状態遷移、1/5の位置/方位補正、上限超過拒否、保存・CRC・PC変換が成功した。ホスト前提の対処はresolved。実機の最長割り込み時間と走行応答は未検証。

## 確認した結果

センサー角度の実関数を既存ADCハーネスへ追加した初回コンパイルは、`angleSensor`の未宣言で停止した。抽出済み変数範囲にこの公開変数が含まれると仮定していたが、実際は範囲外だった。製品コードのビルドエラーではない。

bin専用ハーネスでは、close故障を設定してopenが失敗すると期待し、アサートが停止した。正常openはファイルを保持するのでcloseは呼ばれず、テスト側の段階指定が誤っていた。

## 対処と再発防止

ADC抽出へ実ソースの`angleSensor`宣言と`IMU_PI_F`を追加した。抽出する関数の公開値・定数を追加前に列挙し、製品側をモック不足へ合わせない。

open/read/closeの故障注入を分け、close故障は正常open後の実close呼出しで確認する。bin保持と戻り値も同時に確認する。Skillの実行前参照へ、抽出依存と故障注入段階の確認手順を反映した。

## 検証

`python validation/line_sensor_adc/run.py`のO0/O2・Wall/Wextra/Werrorが成功。両端、内側8位置、全ゼロ、全最大値、1000以上の入力を確認した。

`python validation/log_storage/run.py --converter C:/tool/AutoCopyCsvFromSd/RlogToCsv.exe`で通常/詳細の保存・故障注入・CRC・計画生成・PC数値一致と現行V2が成功。このホスト側の前提修正はresolvedとする。実SDや実走行の検証結果を示すものではない。

## 2026-10-25：変更前参照コードの既存warning

速度設定の共通化で変更前の実writerを比較ハーネスへ取り込んだ際、旧writer内の`int16_t`と`sizeof`の比較が`-Wextra -Werror`で停止した。現行writerの問題ではなく、変更前ソースを厳格設定でコンパイルした際の既存診断だった。比較用コードにも現行と同じ警告契約が成立すると仮定していた。

変更前参照ブロックだけを`#pragma GCC diagnostic push/ignored "-Wsign-compare"/pop`で囲み、対象の既存診断を局所的に許容した。現行実関数・共通ヘッダのWerrorは維持し、製品側の警告設定は変更していない。比較参照を追加する前に、既存診断と新規診断を識別し、許容対象と範囲をテストソース内へ記載する。

O0/O2で速度設定178ケースの初期値・保存バイト・部分反映・範囲外・旧18項目修復が変更前と一致した。`validation/control_refactor/run.py`の参照ブロックには局所的なpush/popと理由を残した。検証済みのテスト契約修正としてresolved。旧writer自体の修正を示すものではない。

## 2026-10-25：校正基準の拒否理由コード

校正定数の集約で実機換算だけを58020へ変えた隔離コピーを検証した際、テストが`closureReason=7`を期待して停止した。実際には`distanceScaleVerified=0`となって正常に拒否されており、実装の距離換算検証失敗は理由10だった。テスト作成前に`primaryRouteValidation.reason`の分岐と代入値を最後まで確認せず、別の番号を前提としたことが原因。製品側の拒否条件に問題は確認していない。

実`SDcard.c`の該当分岐を読み、期待を理由10へ修正した。理由の不一致を理由検査の削除や製品コード変更で回避していない。今後の故障注入では、入力条件・先行分岐・出力フラグ・理由コードの対応を実装から確認してから期待値を作る。sd-settingsの実行前参照へ反映する。

`python validation/constants_metadata/run.py --baseline build/constants-metadata-20261025/before`で通常/詳細の換算58020→理由10、校正101サンプル→理由9の拒否、および各128ケースのメタデータ全バイト一致が成功した。20,001通りの距離換算もO0/O2で変更前の保存ビット列と一致した。試験側の前提修正と拒否検証はresolved。新しい物理校正値を実測検証した意味ではない。

## 2026-10-25：比較元の横統計が統合済みだった

校正定数集約の回帰で新しい作業前Coreを渡したところ、比較ハーネスが`BeforeSlipLateralCandidateInterval`の`peak/onMs`未定義でコンパイル停止した。今回の比較元は横統計統合後であり、試験は統合前の二重保持を前提にしていた。変更前の関数・構造体の版を確認せず、任意のスナップショットに同じ参照欄があると仮定したことが原因。製品コードのビルドエラーではない。

参照ヘッダの該当構造体を読んで両フィールドの有無を判定し、両方ある版だけで二重保持の一致も確認するようにした。片方だけの未知の構造は停止する。共通の出力・フラグ・区間統計の前後比較は両版で常に実行する。製品に削除済みフィールドを戻していない。

統合前の`build/remaining-cleanup-20261025/before`と統合後の`build/constants-metadata-20261025/before`の双方で、左右PID64,000周期、スリップ104,000周期、全256モードのO0/O2比較が成功した。書き込み・デバッグSkillの抽出前手順へ構造体版の確認を追加する。試験の参照契約修正はresolved。実機確認の代替ではない。
