Kageyana/robotrace_v2/doc/失敗事例/2026-10-25-core-section-insertion-anchor.md

---
type: codex-failure
date: 2026-10-25
task: Core/Inc・Core/Srcのセクション見出し統一
status: resolved
severity: low
tags: [codex/failure, batch-edit, insertion-anchor]
---

# フォント配列と記述子で同じ挿入目印が重複していた

## 確認した結果と原因

71ファイルのコメント見出しを追加する初回スクリプトで、`ssd1306_fonts.c`の`#ifdef SSD1306_INCLUDE_FONT_7x10`が2箇所あり、一意性検査が停止した。フォント配列と記述子の両方が同じ条件で囲まれていた。既に62ファイルを更新しており、編集箇所ごとの検査だけでは一括処理の途中停止を防げなかった。Cコード自体の変更はなかった。

## 対処と再発防止

挿入位置を条件行と`static const uint16_t Font7x10 [] = {`の組へ限定した。作業開始時の保存コピーを基準に全71ファイルの編集案をメモリ上へ生成し、全件の目印の一意性、コメントを除いた論理行の一致、マクロ継続行、USER CODE境界の一致を検査した後にだけファイルへ書き込む方式へ変更した。途中まで更新されたファイルも、同じ開始時コピーから再生成した。

共通事前確認へ「一括編集では全件の編集案を検査してから書く」を追記する。単一の条件行や汎用的なコメントが一意とは仮定せず、対象の宣言まで含めて位置を特定する。未知の一致数は編集前に停止し、対象の取り違えを置換件数の緩和で回避しない。

## 確認方法とステータス

修正後の`build/unify_core_sections.py`が全71件の事前検査を通過し、各ファイルへ両見出しを追加した。`build/core-sections-20261025/verification.json`に全件のコードとUSER CODE境界の一致を保存した。差分の空白検査も成功した。一括編集の挿入位置と書込順序の修正は検証済みのためresolvedとする。

## プロトタイプ見出し追加時の事前検査（同日）

後続のプロトタイプ見出し追加では、前回の見出しが残っているという前提で現在の`main.h`を検査し、英語区分のみの状態で停止した。また、関数名と開き括弧だけの目印は`courseAnalysis.c`と`lineSensor.c`の宣言・定義へ各2件一致し、一意性検査が停止した。いずれも全件の編集案を検査する段階であり、ファイルの書込み前だった。

前回の見出しの存在を必須とせず、現在読み込んだ見出しとコードを保全する検査へ変更した。宣言位置は引数と末尾セミコロンまで含む完全なプロトタイプで特定し、全目印の件数を読取のみで再確認した。全71件の編集案と書込直前の元内容一致を検証してから適用し、54件の見出し追加・表記統一が成功した。生成ファイルの状態が前回と異なっていた理由は未調査であり、ユーザー変更と断定していない。今回の挿入位置・現状保全の検査修正は検証済みでresolved。
