Kageyana/robotrace_v2/doc/失敗事例/2026-09-26-git-index-permission-recurrence.md

---
type: codex-failure
date: 2026-09-26
task: "PATH追従機能のmain移植"
status: resolved
severity: low
tags:
  - codex/failure
  - git
  - sandbox
---

# Git index 権限拒否の再発

## 要約

通常権限の `git restore` が `.git/index.lock` の作成権限拒否で失敗した。対象を指定した同じ操作を `require_escalated` で再実行すると成功した。

## 発生した状況

- 作業: PATH追従モジュールを参照ブランチから作業ツリーへ移植。
- 実行環境: `D:\robotrace\robotrace_v2`、workspace-write。
- `.git/index` は存在し、`.git/index.lock` は残っていなかった。

## 結果

通常権限では `fatal: Unable to create '.../.git/index.lock': Permission denied`。`git restore --source=codex/imu-distance-kalman --worktree -- robotrace_v2/Core/Src/pathFollower.c robotrace_v2/Core/Inc/pathFollower.h` を権限昇格付きで再実行し、両ファイルの変更を確認した。

## 原因

既存の `2026-08-11-git-index-lock-sandbox-permission.md` と同じく、サンドボックスで `.git` への書き込みが制限されていた。今回は既存の対策を最初の index 更新時に適用しなかった。

## 再発防止策

`.git/index` を変更する `git add`、`git restore`、`git commit` 等は、初回から `sandbox_permissions: require_escalated` を使う。コマンドは対象パスを限定し、昇格後に `git status` で結果を確認する。

## 確認方法

昇格付き `git restore` の後、`git status --short` に指定した2ファイルだけが変更として表示された。

## 関連

## 2026-10-04の再発

RAM共通化ブランチのコミット依頼で、通常権限のgit addとgit commitがindex.lock作成権限拒否で失敗した。既存の「初回からrequire_escalated」の対策を適用しなかったため再発した。対象11ファイルを限定した昇格付きgit addで索引更新成功を確認した。索引更新に失敗した場合は後続のcommitを実行せず、まず昇格付きaddの成功を確認してからcommitする。次回のコミット作業では、索引更新前に本記録を確認し、環境の.gitが読取専用なら初回から昇格付きで実行する。

- `doc/失敗事例/2026-08-11-git-index-lock-sandbox-permission.md`

## 2026-10-12のブランチ作成での再発

新規ブランチ作成を通常権限で試し、.git/refs/heads/codex/slip-detector-v2.lockの作成が拒否された。対象を限定した同じgit switch -cをrequire_escalatedで実行して成功した。対策の対象はindex更新だけでなくrefs更新（switch -c、branch等）も含む。次回は.gitへの書込みを伴う操作を分類して初回から適切な権限で実行する。git branch --show-currentでcodex/slip-detector-v2を確認済み。
