Kageyana/robotrace_v2/doc/失敗事例/2026-10-12-csv-long-column-name-truncation.md

---
type: codex-failure
date: 2026-10-12
task: "横接線補正候補の初回実機ログ確認"
status: resolved
severity: medium
tags: [codex/failure, log, schema]
---

# 長いCSV列名の切詰めで区切りが消え隣の列名と連結した

## 確認した結果

新形式13130～13144の15本すべてで、CSV列名は71個、各データ行は72値。`slipV2LatCandidateIntervalReason`が29文字で切れ、次の`imuYawAlphaFiltered`と連結した。候補残差など先行列は保存されているが、通常のDictReaderで末尾を読むとずれる。前回のホスト確認はスキーマを直接展開した列数確認と一部列の存在確認に留まり、実ヘッダ生成の全列一致を検証していなかった。

## 原因

SDcard.cの`setLogStr()`は30 Bの一時バッファへ列名をコピーしてからカンマを追加する。33文字の名前は29文字で切れ、終端NULのほかにカンマを追加する空間がない。そのまま全体ヘッダへ連結され、1列減った。全体ヘッダ4096 Bの不足やバイナリ保存値の欠損ではない。

## 対処

一時バッファを除いて全体ヘッダへ列名とカンマを独立して追加する実装へ修正した。実際の`logBuildColumns()`出力全体と、スキーマから作った全列名＋区切りを比較する回帰を追加した。保存型・列順・CRC・レコードサイズは変更しない。

原本20本は変更せずSHA256を確認した。スキーマCRC−1299980178、対応ソースの正規列順、切詰め再現、期待行数と全行72値を検証できた既知15本に限定して、解析用コピーの2行目を復元した。不明スキーマの推測復元は許可しない。保存先は`analysis/slip_candidate_13125_13144/header_repaired/`、再現スクリプトは`analysis/script/check_slip_candidate_13125_13144.py`。

## 再発防止と確認

列追加時はスキーマ定義だけでなく、実際のCSVヘッダ生成を通し、全列名・各区切り・データ行の列数一致を通常/詳細で確認する。最長列名も確認し、一時バッファの固定長へ依存しない。AGENTS.mdとログ解析/SD設定Skillへ反映した。

通常・詳細のログ保存/互換/復旧回帰、旧実バイナリ4本のCSVバイト一致、Debug/Release×通常/詳細の全4ビルドが成功。新規warningなし。

修正後の実機ログ13145～13155（22:28:09ビルド）全11本で、正規ヘッダ72列、全行72値、期待行数一致、末尾3列の完全な列名・有限値を確認した。ヘッダ修復は不要で、原本SHA256も不変。ホスト回帰と実機確認が揃ったためresolvedへ更新する。詳細は`analysis/slip_candidate_13145_13155/report.md`と`validation.json`。13145～13150はユーザー確認済みの手持ち・空転試験であり、形式確認には使うが通常走行の完走率には含めない。詳細87列の実機CSVは今回未取得で、ホスト回帰の確認範囲とする。

13156～13160の校正確認で旧13130・13135・13140も候補へ入れたところ、解析前の列数一致検査が停止した。末尾空セルの差ではなく、上記の既知の列名連結だった。今回の目的では修復コピーを作らず、同じビルド・正規ヘッダの一次走行13151対13156を数値比較し、旧3本はメタデータだけ参照した。製品修正後の再発ではなく、保存済み旧CSVへの解析事前確認不足。`analysis/script/check_calibration_13156_13160.py`へ対象と除外理由を明記し、末尾空セルを除いた実列数一致・全数値有限・期待行数一致を維持した。再実行成功、13151と13156～13160の全行検証・原本ハッシュ不変を確認。次回は解析対象の列名と既知不整合番号を先に確認し、末尾空セルと列名欠損を混同しない。
