Kageyana/robotrace_v2/doc/失敗事例/2026-10-12-slip-lateral-tangential-contamination.md

---
type: codex-failure
date: 2026-10-12
task: "スリップSHADOW版の初回実機ログ確認"
status: open
severity: medium
tags: [codex/failure, slip, imu]
---

# 横残差に角加速度と強く連動する成分が残る

## 確認した結果

13094～13124の利用可能CSV30本を解析。新診断保存の整合性は確認できたが、正常ログでも横判定ONがPRIMARY16.73%、DISTANCE42.35%と多い。13115/13118で記録横残差と記録gyroの30ms差分による角加速度の相関は−0.982/−0.968、回帰係数−0.07489/−0.07400m。独立真値はなく、横スリップがこの割合で発生したと解釈できない。

## 原因・未確定事項

現行IMU.cのX接線補正はalpha(CW正)×Yオフセット(−0.03168m)。右X・前Y・CW正を前提とした座標導出では符号不整合が候補となる。約2×後方オフセットの混入方向と整合するが、遅れ・姿勢・振動・実滑りは未分離。以前から残るX補正の不確かさが、新横残差でも明瞭に現れた。静止バイアスだけでは角加速度依存成分を除去できない。

## 対処と次の確認

SHADOWを継続し、新判定を制御へ接続しない。回帰係数をそのまま補正値に採用しない。座標変換からCW/CCWの接線項を導出し、取付方向と照合した上で、定常旋回と正負角加速度の合成入力で車軸中心加速度が復元されるテストを追加する。

## 2026-10-12 診断専用候補の実装

承認済み計画に従い、共通IMU出力と既存SHADOWを維持したまま、`currentLinearX−2×appliedTangentialX`の候補残差・独立判定を追加した。位置・座標導出・ログ10列・互換性・実機手順は`doc/slip-lateral-candidate.md`。実在するv3 STEPとKiCadでは後方31.675 mmを確認したが、実機との一致と生Xの右正は未確認。

実CのCW/CCW・定常/過渡・無効復帰・窓・継続・区間統計テスト、改修前後の実IMUと既存SHADOWそれぞれ8000入力のビット一致、旧ログ変換/復旧、4構成ビルドを確認した。実IMUの角加速度LPFを通すと`rY*(α−αFiltered)`が残るため、候補による横残差の完全除去を保証しない。実機新形式ログと最低10本の比較は未実施。物理原因と効果が未確定のためstatusはopenを維持する。

## 再発防止・検証方法

2026-10-12追記: 候補付き実機CSV13130～13144を確認。ヘッダ切詰めは別記録の条件付きコピー復元で対応した。正常DISTANCE3本の横ON率は同じ入力の基準39.37%→候補6.93%、横RMS近似6.52→2.15 m/s²。13138の整列αへの回帰係数−0.07659→−0.01302 mで、依存は減ったが残る。各方式3本（SLIP正常1本）、生X方向・独立真値・同程度電圧10本の確認は不足。制御は従来のまま。実機効果の限定的な裏付けは得たが採用条件未達のためopenを継続する。詳細は`analysis/slip_candidate_13125_13144/report.md`。

閾値調整や融合推定の前に、横残差対角加速度の回帰係数・相関と速度/定常旋回別の残差を出す。実機採用は修正後の同方式・近い電圧10本以上で判定し、通信成功を新サンプル生成や無滑り真値と混同しない。解析は `python analysis/script/check_slip_shadow_13094_13124.py` で再実行でき、原本SHA256不変・列/区間統計の整合性を確認する。補正修正と実機確認が未実施のためopen。

## 関連

- `analysis/slip_shadow_13094_13124/report.md`
- `analysis/script/complete_yaw_motor_13059_13073.py` の加速度座標整合性診断
- `doc/失敗事例/2026-10-11-yaw-fusion-reference-and-convergence.md`
