Kageyana/robotrace_v2/doc/失敗事例/2026-10-18-slip-replay-validity-segments.md

---
type: codex-failure
date: 2026-10-18
task: 既存ログによるSHADOW横候補の閾値修正
status: resolved
severity: low
tags: [codex/failure, analysis, slip]
---

# 開始42msだけ無効という仮定を別走行へ流用した

## 確認した結果・原因

`analysis/script/fit_slip_v2_existing_20261018.py`の初版は、直近17走で確認済みだった「開始42msのみ無効」を過去ログにも適用し、有効時間一致assertで確認用13479の評価を停止した。13479は記録12808ms、有効12720msで、開始42msに加え途中46msの低速・再充填がある。10629msの記録区間は11ms中4msだけ有効で、瞬時reason=64・区間reason=96。疎なログでは、その区間内の4msの位置は特定できない。

ファームウェア障害ではなく解析側の入力仮定の誤り。assertで停止しており、この仮定を使った確認用結果は採用していない。選定用の閾値計算は既に終えていたが、修復後も選定値5.7/4.5は変わらない。

## 対処・具体的な再発防止

全走のTotalMs/ValidMs/IntervalReasonと瞬時Validを先に検査する。部分有効区間を1msへ任意に配置せず、全有効・無効理由なし・両端とも瞬時有効の区間だけを近似再判定へ採用する。混合区間と有効境界を評価対象外として保持し、実記録有効時間と近似の採用時間を別に保存する。無効区間を跨ぐ継続カウンタをリセットする。ログ解析Skillの閾値リプレイ入口にもこの検査を追加した。

## 確認方法・状態

41走を同じ方針で再実行し、原本SHA256不変、選定5.7/4.5維持、確認用の局所陽性最小重なり25msを確認した。最適化したヒステリシス計算を欠測・等号・正負を含む40組のランダム時系列で逐次モデルと一致検算した。実Cとは別の近似再判定であり、物理滑り精度を検証したものではない。解析修正はresolved。

証跡：`analysis/slip_v2_existing_20261018/protocol.json`、`summary.json`、`replay_before.csv`、`replay_after.csv`。原本の途中低速・再充填自体は変更しない。
