Kageyana/robotrace_v2/doc/失敗事例/2026-10-14-line-omega-low-gain-curve-understeer.md

---
type: codex-failure
date: 2026-10-14
task: "ラインセンサー更新修復後のカーブでのコースアウト"
status: open
severity: high
tags: [codex/failure, line-sensor, pid, tuning]
---

# 追従再開後も走行用角速度PIDの弱い指令で旋回不足が継続

## 確認した事実

ユーザーは追従再開とカーブでのコースアウトを報告。最新一次ログ13191～13194のセンサーベクトルは277/277、274/274、284/284、275/279種類で、以前の全期間固定は解消した。全ログが約1.23～1.25mで白線反応を失う。終了理由3/3/3/5、校正有効、行数一致、有限、距離刻み正常。失敗走行は診断専用。

1050～1170mmで走行用PIDはP2/I0/D0、目標角速度中央値902～944deg/sに対し実角速度350～382deg/s、左右速度目標への差分35～36.5pulse/ms。満充電8.32Vの13193/13194でも同位置で失敗。記録電圧指令は同区間で最大約3V。完走参考13172はP5/I0/D12・実499deg/s・差分51pulse/msだが、校正とビルドが異なる。

## 原因または未確定事項

旋回不足は確認できる。低い走行用PIDゲインを優先候補とするが、ゲイン単独の因果は未確定。センサーADC公開周期・割込み時間・物理的スリップは現行43列CSVから確定できない。開始前lineTraceCtrlと走行用lineTraceOmegaFBCtrlを混同しない。CSV列lineTraceCtrlは後者の出力。

## 対処と確認

ユーザーがPCに接続したSDカードG:/setting/lineomega.txtの実値002,000,000を確認。完走参考の005,000,012へ変更した。変更前をバックアップ、11byte・改行なしの再読込とsetting全ファイルSHA256比較で、対象だけ変更したことを確認。速度・開始前PID・安全条件を維持。新設定の実走行が未取得なのでopen。

## 再発防止

- ADC更新復旧だけで追従・完走も回復したと判断せず、センサー変化→角速度目標→実角速度→左右速度・電圧指令を順に確認する。
- SD設定優先を確認し、実設定と比較ログのP/I/D・速度・電圧・校正・ビルドを記録する。完走参考ログとの条件差を残す。
- 一度に変更するのは2項目以内。まず同じ一次走行を1本でカーブ通過確認し、その後最低10本で再現性・完走率を確認する。
- 5mm距離ログの刻みには残余持越しと1ms量子化がある。解析初版の固定4mm下限は完走13172の正常3.964mm刻みを誤って拒否した。timer.cの残余持越しを確認し、今回の1m/s近傍では3～7mm範囲と実最小/最大を確認する方式に修正して再実行成功。速度が異なるログへこの範囲を無条件流用しない。
- SDドライブGは通常サンドボックスからアクセス拒否になる。Get-PSDriveで候補確認後、許可されたSD作業として昇格して直接settingを読む。Get-VolumeはCIMアクセス不可だったため再試行せず、設定ファイルの存在・内容で対象を確認した。

## 関連

[解析・変更・次の実走行条件](../line-sensor-curve-understeer-13191-13194.md)。解析スクリプトと入力ハッシュはanalysis配下。CSV原本不変を確認済み。

## 完走の確認

ユーザー報告と13195～13211の全17本emcStop=0で完走を確認。オートスタート2組とも5走完了。変更直後一次13195は5/0/12で完走し、該当カーブの実角速度中央値は368.6→510.0deg/s。途中でゲインが変更され、最新一次13207は5/0/1、同ゲイン一次13205も完走。17本はゲイン・モード・電圧が混在しており、最新同条件10本の採用確認が未完了なのでopenを維持する。二次の終了時ヘッダ2/0/0は既存changeGain()の直線用切替値と区別し、全周固定設定と断定しない。今回は設定の追加変更なし。
