Kageyana/robotrace_v2/doc/失敗事例/2026-10-11-sd-pending-csv-recovery.md

---
type: codex-failure
date: 2026-10-11
task: RT_LOGの未変換bin・partからCSV復旧
status: open
severity: high
---

# 正常なbinが機体のCSV変換でFailedとなる

## 確認した事実

- ユーザー報告: RT_LOGを機体へ挿して起動してもCSV変換がFailedとなる。
- H:直下に13085～13088.binと13085.partが存在した。4本とも108 B通常プロファイル、schema=1504213192。ファイル長、ヘッダ・記録・メタデータのCRCはすべて正常。
- 記録数は順に4740、4742、4718、4714行。保存ファーム情報はgitCommit=9d3f451、2026-10-11 19:08:09。
- 13085.partは677888 Bで、2617データ行の後、次の行の途中で終わっていた。
- BOOTEX.LOGにFATのlost chain cross-link、bad links修復と3本のCHK回収履歴が存在した。今回実行したchkdsk H:（修復オプションなし）は前後とも問題なしと報告した。冒頭にAccess is deniedも表示されたため、ディスクの排他アクセスや物理状態の保証には使わない。
- 容量は33435648 B。復旧反映後の空きは8650752 B。

## 原因・未確定事項

bin破損と現行スキーマ不一致は今回の検証では否定できた。既存ホストテストのRAM FatFsへ実データを読み込み、現行SDcard.cのlogConvertPendingを実行すると4本とも成功した。機体での失敗がSD通信、媒体、電源、FAT、その他の状態に起因するかは未確定。過去のFAT破損履歴だけから現在の失敗原因を断定しない。

## 対処・確認

- analysis/sd-recovery-20261011/originalへbin・part・BOOTEXを保全。card-backupへ設定、ground_load、FOUND.000もコピーした。
- recover.cは既存log_deferred_test.cのRAM FatFsと実際の変換実装を利用。元のbinには変更を加えずCSVを生成した。
- 全CSVの期待行数、列数（末尾空列込み44）、cntlog単調性、全数値の有限性、メタデータ一致を確認。validation.jsonへ行数・容量・SHA-256を保存した。
- partに残った2617行の保存値はCSVと文字列一致。派生値のPC/ARM差は最大ROC=0.000488、x/y=0.000428 mm（part-comparison.json）。
- H:直下へCSV4本を書き戻し、PCとのSHA-256一致後、元の5ファイルをH:/recovery_20261011へ移動した。ファームは変更していない。
- 起動時の列挙はルートのみなので、保管フォルダ内binは再変換対象にならない。機体の起動確認は未実施。

## 次回の具体的な確認・再発防止

1. 機体でSD復旧完了と通常UIへの復帰を確認する。
2. 再発時は再起動・修復前にbin・partと設定を保全し、CRC、実長、schema、空き容量を検査する。
3. 実機でlogConvertOneの失敗段階、FatFs結果、SDドライバ状態を取得して原因を絞る。PC成功だけで実機修正済みとしない。
4. カード着脱はSD処理完了・機体電源断後、PCでは安全な取り外しを使用する。媒体や電源起因は実機情報で検証する。
5. 32 MBボリュームのため、変換元binに加えて全CSVの生成余地を確保する。保管データの削除・フォーマットは今回行っていない。

## 調査ツールの失敗と回避

- Get-VolumeはCIMリソースアクセス取得に失敗。Get-PSDriveとchkdskの容量情報で代替した。
- 制限環境でH:読取が拒否されたため、承認レビューを通したSD限定操作で保全・反映した。
- 制限環境の32bit MinGW gccがシステムDLL再配置エラーで起動失敗。外側で同一コンパイル・復旧処理が成功した。再発時もコード原因と判断する前に実行環境を確認する。
- 最初の検証スクリプトはヘッダtupleのrows/metadataBytes添字を取り違えてassert失敗。名前付き変数への展開に直し、全4本の検証に成功した。validate.pyに修正版を保存した。

機体での変換再発原因と再発防止策が未検証のためopen。
