Kageyana/robotrace_v2/doc/失敗事例/2026-10-04-git-index-sandbox-write.md

---
type: codex-failure
date: 2026-10-04
task: 校正・復帰変更のコミット
status: resolved
severity: low
---

# Gitインデックスへの書き込み制限

確認事実: ユーザーのコミット依頼を受けてgit addを実行したが、.git/index.lockの作成がPermission deniedで失敗した。ブランチ作成は成功していたが、インデックス更新は許可されなかった。現在の権限設定では.gitは読取対象であり、通常実行の制限と一致する。OSのACL要因は未検証。

対処: ステージされていないこととコミット未作成を確認し、ユーザーが依頼したgit addとgit commitを必要権限付きで再実行する。ロックファイルの削除やGit設定変更は行わない。

再発防止: git add失敗時は処理を止め、ステージ内容を確認してからコミットする。管理領域の書き込み制限の場合は、承認済み操作の必要権限付き実行を使う。成功後にコミット番号、対象ファイル、残る変更を確認する。

確認方法: git diff --cached --check、git commit、git log -1、git status。必要権限付きgit addとgit commitが成功し、git logで作成を確認。対象変更は保存され、別作業のログ分類ファイルのみ未追跡として残る。権限付き実行の対処は検証済み。
