Kageyana/robotrace_v2/doc/失敗事例/2026-10-03-analysis-mm-ms-speed-conversion.md

---
type: codex-failure
date: 2026-10-03
task: 最小ログ12872～12878の比較
status: resolved
---

# mm/msからm/sへの変換で1000倍した

## 結果と原因

解析スクリプト初回実行のactual_distance_mpsが538～540となった。距離[mm]/時間[ms]は数値がそのまま[m/s]になるが、余分に1000倍していた。周回XY差、ラップ時間、速度追従RMSEにはこの係数を使っておらず、影響は平均速度列だけだった。

## 対処・再発防止

係数1000を削除し、今回の0.5m/s走行に対して距離/時間が0.45～0.6m/s以内という検証をスクリプトへ追加した。単位変換は分子・分母を別々に確認する。analyze_minimal_12872_12878.pyを再実行し全13ログで検証成功、health.csvとvalidation.jsonの平均速度が約0.538～0.542m/sとなった。修正前のファイルは再生成済み。
