Kageyana/robotrace_v2/doc/失敗事例/2026-10-03-cross-fit-insufficient-channels.md

---
status: resolved
---

# CROSS姿勢の有効素子不足でログ比較全体が停止

対象: 12901～12909の周回比較。

確認結果: 全ログで独立CROSS検出5回だが、12906の2回目は姿勢推定用の幅・閾値条件を満たす素子が5個、12907の1/4/5回目は4/5/5個だった。既存axleanchors()の6素子以上というassertで解析全体が停止した。

原因: CROSS存在検出と姿勢フィット品質が同じではない。一次走行で成立した全イベント有効の前提をPATH REPLAYへ適用した。実機の通過姿勢・ラインの見え方の要因は未確定。

対処: check_imu_init_runs_12895_12897.pyをイベント単位の判定に変更し、品質不成立をanchor_rejections.csvへ保存。6素子基準を維持し、有効な通過間のみ比較。飛ばしたイベントを跨ぐ区間は元イベント番号差で周回数を数え、1周と誤認しない。

再発防止: 全ログ共通のモード・速度を仮定せずメタデータで分離する。CROSS検出回数と有効フィット回数を別項目で保存し、実際に比較できた周回数を表へ出す。比較ログの速度依存する距離間隔も確認する。

検証: analysis/runs_12901_12909の再実行成功。12906は4有効通過・計4周、12907は2有効通過・1周のみ。その他ログ5有効通過・4周で、12898～12900の既存結果も保持。入力SHA256不変、出力のイベント除外を確認済み。
