Kageyana/robotrace_v2/doc/失敗事例/2026-10-03-distance-log-fixed-time-gap-assumption.md

---
type: codex-failure
date: 2026-10-03
task: SPI変更後12891～12894のログ確認
status: resolved
severity: low
tags: [codex/failure, analysis]
---

# 距離基準ログへ固定の時刻間隔上限を適用した

## 結果と原因

過去の0.5m/sログの実測に合わせた11ms上限assertを新ログへ流用し、12891の最大22msで解析が停止した。ログは距離基準のため、速度が低下すると時刻間隔は増える。速度変更を考慮せず、特定ログの観測上限を全ログの健全性条件にしていた。

## 対処と予防

時刻は単調性を検証し、隣接raw左右積算平均の距離差と合わせて欠落を判断する。今回4本の距離間隔4.21～5.75mmは5mm目標と整合する。check_spi_runs_12891_12894.pyは時刻の最大値を報告し、距離上限7mmを当該走行の確認条件とした。速度・記録間隔変更時には距離条件も見直す。再実行が成功し、正常終了・期待行数・6CROSS・入力ハッシュ維持を確認した。

## 未確定事項

この検証で1ms割り込みの実行時間が証明されたわけではない。走行中SPIエラー数・割り込み実行時間はログにない。
