Kageyana/robotrace_v2/doc/失敗事例/2026-10-03-sparse-yaw-course-distortion.md

---
type: codex-failure
date: 2026-10-03
task: 12879以降のコースプロット崩れ
status: open
severity: high
---

# 疎な瞬時角速度の再積分がコースを大きく変形させた

## 確認した事実

12879～12884のCSV生成はログ間隔9～11msで瞬時角速度gyroVal_Zをホールドして再積分していた。記録済み1ms積算角度imuAngle_Zと終了角度が約66～79deg異なり、元CSVの座標崩れをこの処理で再現できた。累積距離とimuAngle_Zで再計算すると大きな変形が消えた。左右累積エンコーダが走行中にリセットされた証拠はない。

## 原因と未確定事項

直接の座標変形原因は保存後の疎な角速度積分。以前のログよりサンプリング誤差が大きくなった背景は未確定。周期振動との位相や負荷変化は候補で、リセット変更の因果は確認できていない。実位置の正解測定もない。

## 対処と再発防止

CSVのx/yとゴール閉路判定を、累積encTotalOptimal差分とimuAngle_Zの区間両端平均から計算するよう変更。1ms制御は変更しない。元ログは保持し、analysis/xy_recovery_12879_12884へ復元結果を別保存した。

形式・負荷を変更した最初のログでは、疎なgyro積分と記録済み積算角度を必ず比較する。run_log_xy_tests.ps1で実装の直進、距離増分0、6周閉路、走行間初期化を検証する。recover_xy_12879_12884.pyは元CSV再現誤差も検証する。実機で修正後のCSV・閉路Xを確認するまでopen。
