Kageyana/robotrace_v2/doc/失敗事例/2026-08-11-ambiguous-commit-message-amend-target.md

---
type: codex-failure
date: 2026-08-11
task: "コミットメッセージの日本語化"
status: resolved
severity: low
tags:
  - codex/failure
  - git
  - communication
---

# コミットメッセージ修正で対象コミットが曖昧なまま最新コミットをamendした

## 要約

ユーザーから「コミットメッセージは日本語にしてください」と指示された際、直前に作成した英語メッセージの docs コミットを修正する意図とも、現在の最新コミットを修正する意図とも解釈できた。確認時点の最新コミットは別の英語メッセージ `Normalize typo-derived names` であり、それを日本語へ amend したが、過去の `docs: add AGENTS and robotrace skills` は英語のまま残った。

## 発生した状況

- タスク: コミットメッセージの日本語化
- 実行環境: `D:\robotrace\robotrace_v2`, Git
- 前提条件: 履歴上に複数の英語コミットメッセージが存在し、最新コミットが会話上の直前コミットと一致していなかった

## 何を試したか

1. `git log -1 --oneline` で最新コミットを確認した。
2. 最新コミットが `Normalize typo-derived names` であることを確認した。
3. `git commit --amend -m "typo由来の命名を正規化"` を実行した。
4. その後、ユーザーの希望を AGENTS.md に「コミットメッセージは日本語で記述する」として追記した。

## 結果・エラー

```
20cf41b Normalize typo-derived names
6f4d236 docs: add AGENTS and robotrace skills
```

最新コミットは日本語化したが、過去に残る英語コミットをどう扱うかは確認していなかった。

## 原因

「コミットメッセージは日本語にしてください」が、最新コミットだけを amend する依頼なのか、直近に作った docs コミットを修正する依頼なのか、今後の方針なのかを切り分けなかった。履歴が会話中の想定から変わっていたため、対象コミットの確認だけでは不十分だった。

## 解決・回避策

最新コミットを日本語化し、その後の方針として AGENTS.md に「コミットメッセージは日本語で記述する」と追記した。

## 今後の予防策

- コミットメッセージ修正依頼では、`git log --oneline -5` を提示し、対象コミットが曖昧なら確認する。
- 直前に自分が作ったコミットと現在の `HEAD` が一致しない場合は、勝手に amend しない。
- 「以後」「今後」の方針指定と、既存履歴の書き換え依頼を分けて扱う。

## 関連

- 関連ノート:
- 参考リンク:
