Kageyana/robotrace_v2/doc/失敗事例/2026-08-11-revert-confirmation-overtested.md

---
type: codex-failure
date: 2026-08-11
task: "不採用パラメータの基準値復帰"
status: resolved
severity: low
tags:
  - codex/failure
  - robotrace/tuning
  - process
---

# 不採用パラメータを戻すだけの操作に実走行確認を重ねた

## 要約

比較試験で不採用となったパラメータを基準値へ戻す際、復帰後の実走行をテスト計画へ含めるケースが続いた。ユーザーから、パラメータまたは定数を既知の基準値へ戻すだけなら、原則として実走行確認は不要であり、値確認で十分との運用が明示された。

## 発生状況

- lineomega、角速度cap、局所scale、速度計画定数などを不採用後に戻した。
- 復帰だけの変更にも、追加のautoStart走行を計画することがあった。

## 原因

「変更後は実機確認」という一般ルールを、既知の基準値への単純な復帰にも一律適用した。復帰操作のリスクと、新しい挙動を導入する変更のリスクを分けていなかった。

## 解決

不採用値を既知の基準値へ戻す場合は、コード定数確認、SD読み戻し、必要に応じたビルド確認で完了とする運用へ更新した。

## 再発防止

計画作成時に新規挙動、既知値への復帰、ログのみの変更を分類する。復帰タスクでは実走行を必須にせず、値確認だけをテスト条件にする。

## 関連

- AGENTS.md: D:/robotrace/robotrace_v2/AGENTS.md
