Kageyana/robotrace_v2/doc/失敗事例/2026-08-11-scope-creep-naming-normalization.md

---
type: codex-failure
date: 2026-08-11
task: "AGENTS.md 作成中の命名正規化"
status: resolved
severity: medium
tags:
  - codex/failure
  - robotrace
  - scope-control
---

# AGENTS.md作成タスク中に命名正規化まで進めてしまった

## 要約

AGENTS.md の作成・整理を中心に進めるタスク中に、誤字由来の命名正規化まで実施してしまった。その後、ユーザーから「命名の正規化は別タスクで実施します」「今回の命名の正規化変更を破棄してください」と指示され、範囲外変更として戻すことになった。

## 発生した状況

- タスク: AGENTS.md 作成とプロジェクト方針整理
- 実行環境: `D:\robotrace\robotrace_v2`, PowerShell
- 前提条件: AGENTS.md に主要方針を記録している途中で、コード上の命名候補も確認していた

## 何を試したか

1. コードから typo 由来の名前を推定した。
2. 命名の正規化候補を実装対象として扱った。
3. ユーザーが別タスク化を指定したため、実施済み変更を破棄した。

## 結果・エラー

```
ユーザー: 別タスクを作成してそこで命名の正規化を実施します。
ユーザー: 今回の命名の正規化変更を破棄してください。
```

## 原因

ドキュメント整備中の「候補表示」や「実態確認」を、現在タスク内で実装してよい変更と解釈した。ユーザーがタスクの中心を AGENTS.md としていたため、コード変更は明示依頼があるまで実施しないべきだった。

## 解決・回避策

命名正規化の実装変更を戻し、AGENTS.md 作成に作業範囲を戻した。命名正規化は別タスクで扱う方針にした。

## 今後の予防策

- 「候補を表示」「現在コードから推定」「AGENTS.md に追記」といった文脈では、コード編集ではなく調査・文書化に留める。
- ユーザーが「別タスク」と言った作業は、その場で実装せず、計画やチェックリストだけ作る。
- ドキュメントタスク中にコード変更が必要に見えた場合は、編集前に「このタスクで実装するか」を確認する。

## 関連

- 関連ノート:
- 参考リンク:
