Kageyana/robotrace_v2/doc/失敗事例/2026-08-16-autostart-11966-11970-emcstop3.md

---
type: codex-failure
date: 2026-08-16
task: "autoStartセット11966〜11970の走行"
status: open
severity: high
tags:
  - codex/failure
  - robotrace/hardware
  - emergency-stop
---

# autoStartセット11966〜11970でemcStop=3

## 要約
speed_ff=160の最初のautoStart 5走セットで、最終走行11970がemcStop=3となった。セット全体を速度FFの採用比較から除外した。

## 発生した状況

- タスク: speed_ff=160の実走行比較
- 実行環境: robotrace_v2、開始電圧は最終走行7.58V
- 前提条件: autoStart 1〜5の連続走行

## 何を試したか

1. 11966〜11970を1つのautoStartセットとして取得した。
2. 5走すべてを完走セットとして採用判定しようとした。

## 結果・エラー

- 11970: emcStop=3
- rows=129、last_cnt_ms=1864ms
- max cntlog gap=69ms
- optimalIndex_max=10
- 完走セット条件を満たさないため、11966〜11970全体を除外した。

## 原因

停止直前の詳細な停止要因データがなく、原因は未確定。速度FF変更との因果関係は確認できない。ログ欠落を伴うため、まずセット無効として扱う。

## 解決・回避策

同セットを採用比較から除外し、後続の完走セット11971〜11990で比較を継続した。緊急停止条件は変更していない。

## 今後の予防策

emcStopが再発した場合は、停止直前のlineTraceCtrl、gyroVal_Z、targetSpeed、encCurrentN、courseMarkerを確認し、原因が確定するまで速度パラメータの採否と混ぜない。5走すべてが完走していないセットは全体除外する。

## 関連

- ログ: F:/Dropbox/Document/robotrace/Log/v2/11970.csv
- 解析: D:/robotrace/robotrace_v2/analysis/log_11966_11990_speed_ff160_excluded_sets.csv
