Kageyana/robotrace_v2/analysis/imu_init_runs_12895_12897/courses.png

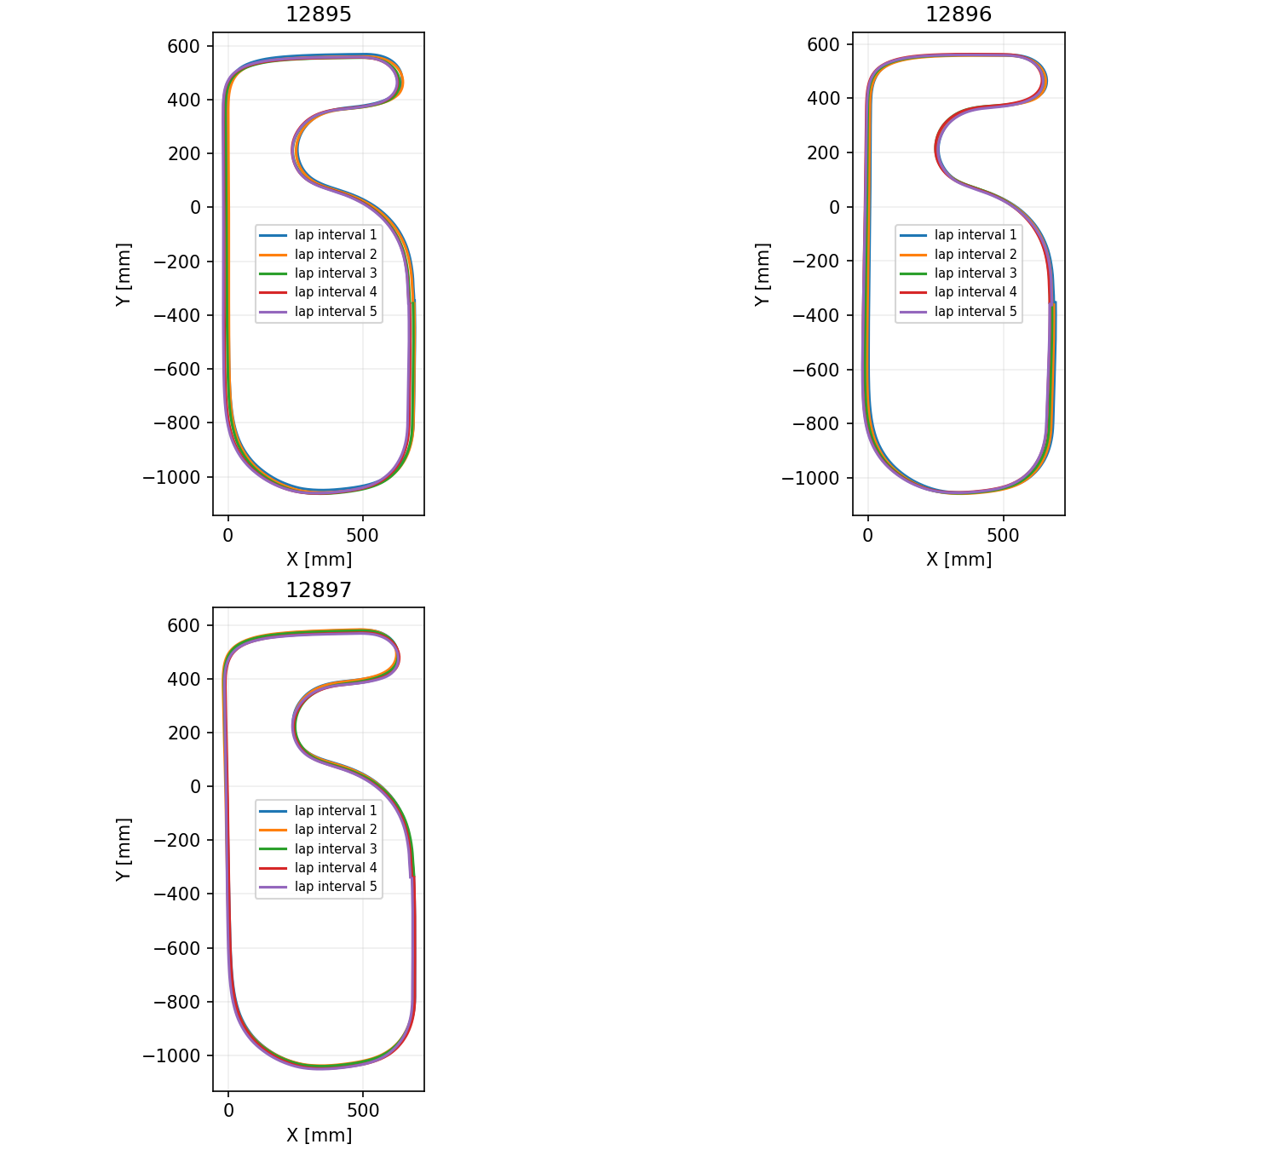
analysis/imu_init_runs_12895_12897/courses.png
