Kageyana/robotrace_v2/analysis/lap_drift_12830_12848/shape_onset.png

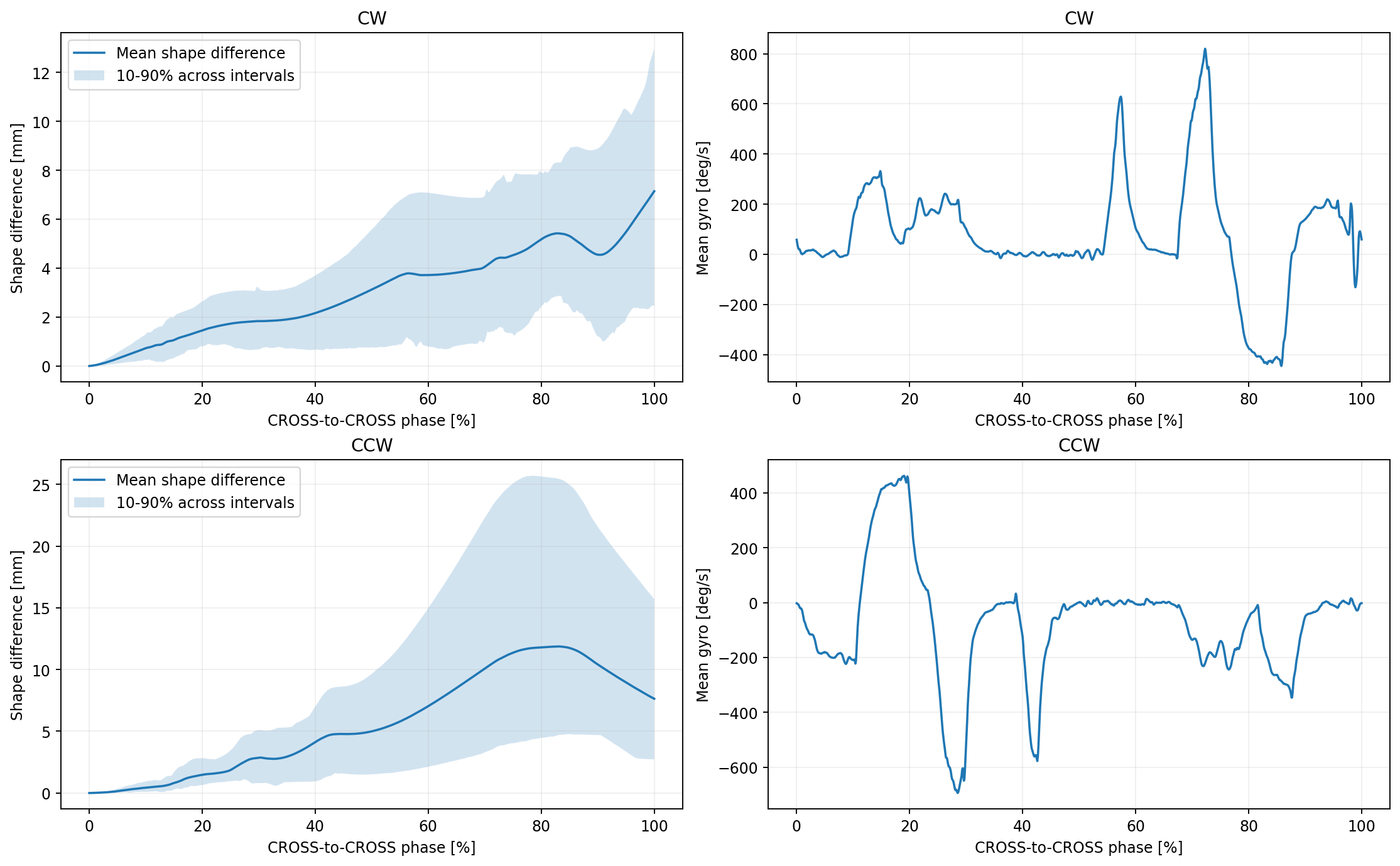
analysis/lap_drift_12830_12848/shape_onset.png
