Kageyana/robotrace_v2/analysis/normalized_yaw_20261031/chart-360.png

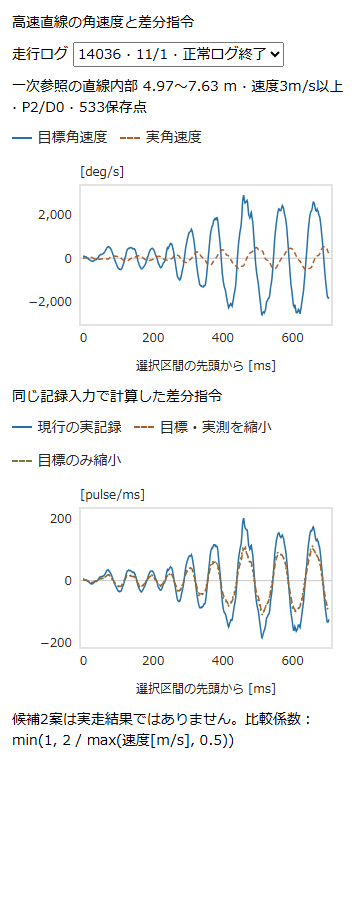
analysis/normalized_yaw_20261031/chart-360.png
