Kageyana/robotrace_v2/analysis/normalized_yaw_20261031/chart-736.png

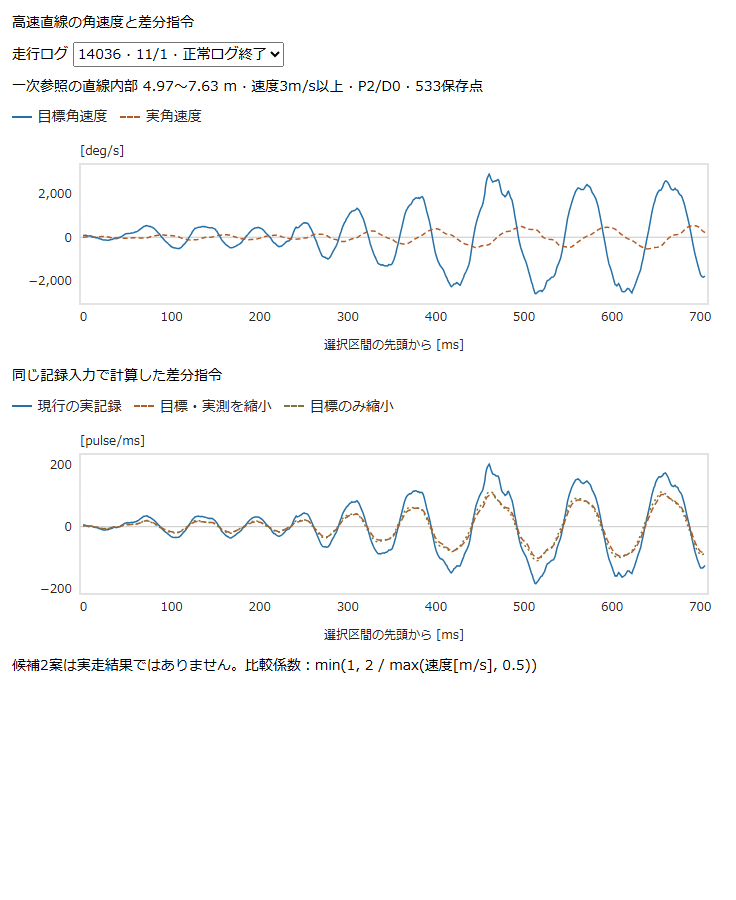
analysis/normalized_yaw_20261031/chart-736.png
