Kageyana/robotrace_v2/analysis/pose_error_sources_12866_12890/sensitivity.png

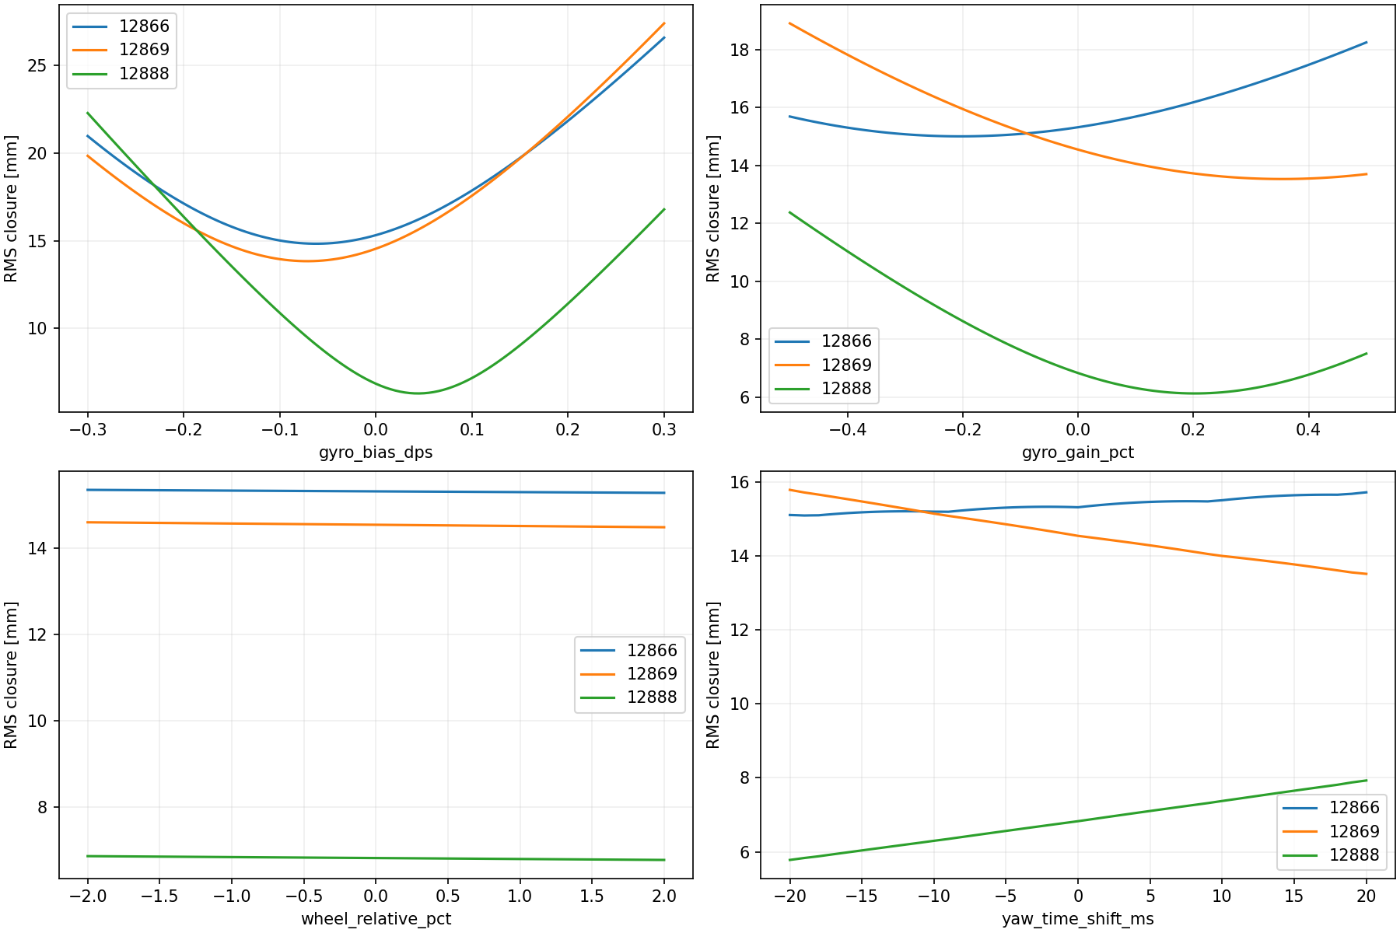
analysis/pose_error_sources_12866_12890/sensitivity.png
