Kageyana/robotrace_v2/analysis/spi_runs_12891_12894/courses.png

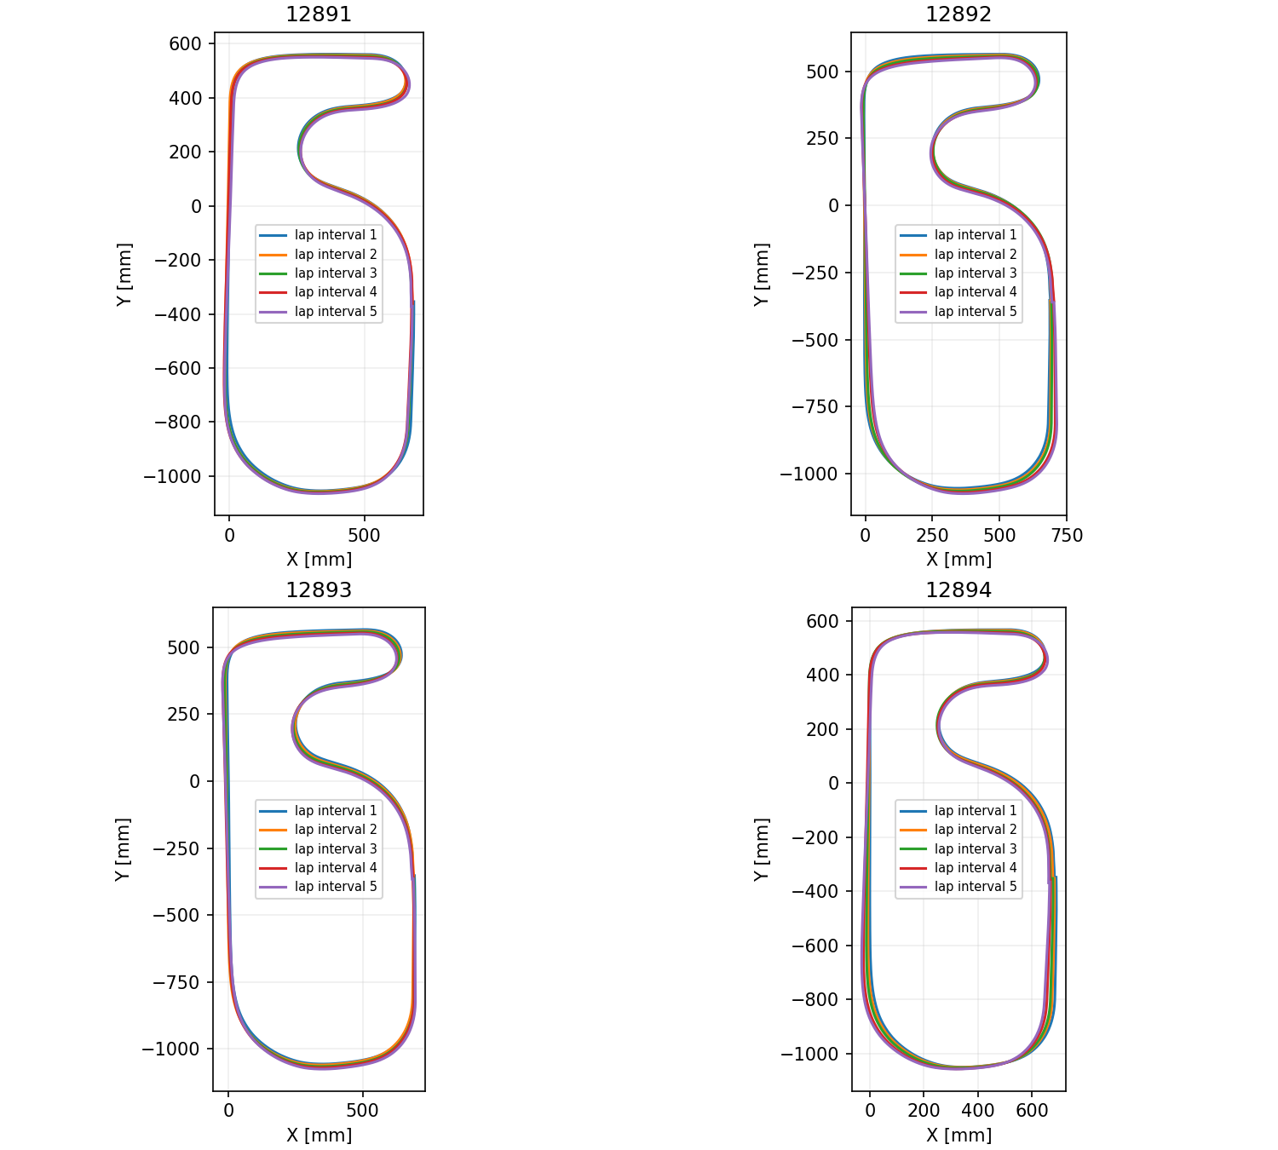
analysis/spi_runs_12891_12894/courses.png
