Kageyana/robotrace_v2/analysis/tire_ground_speed_12888/first_corner_speeds.png

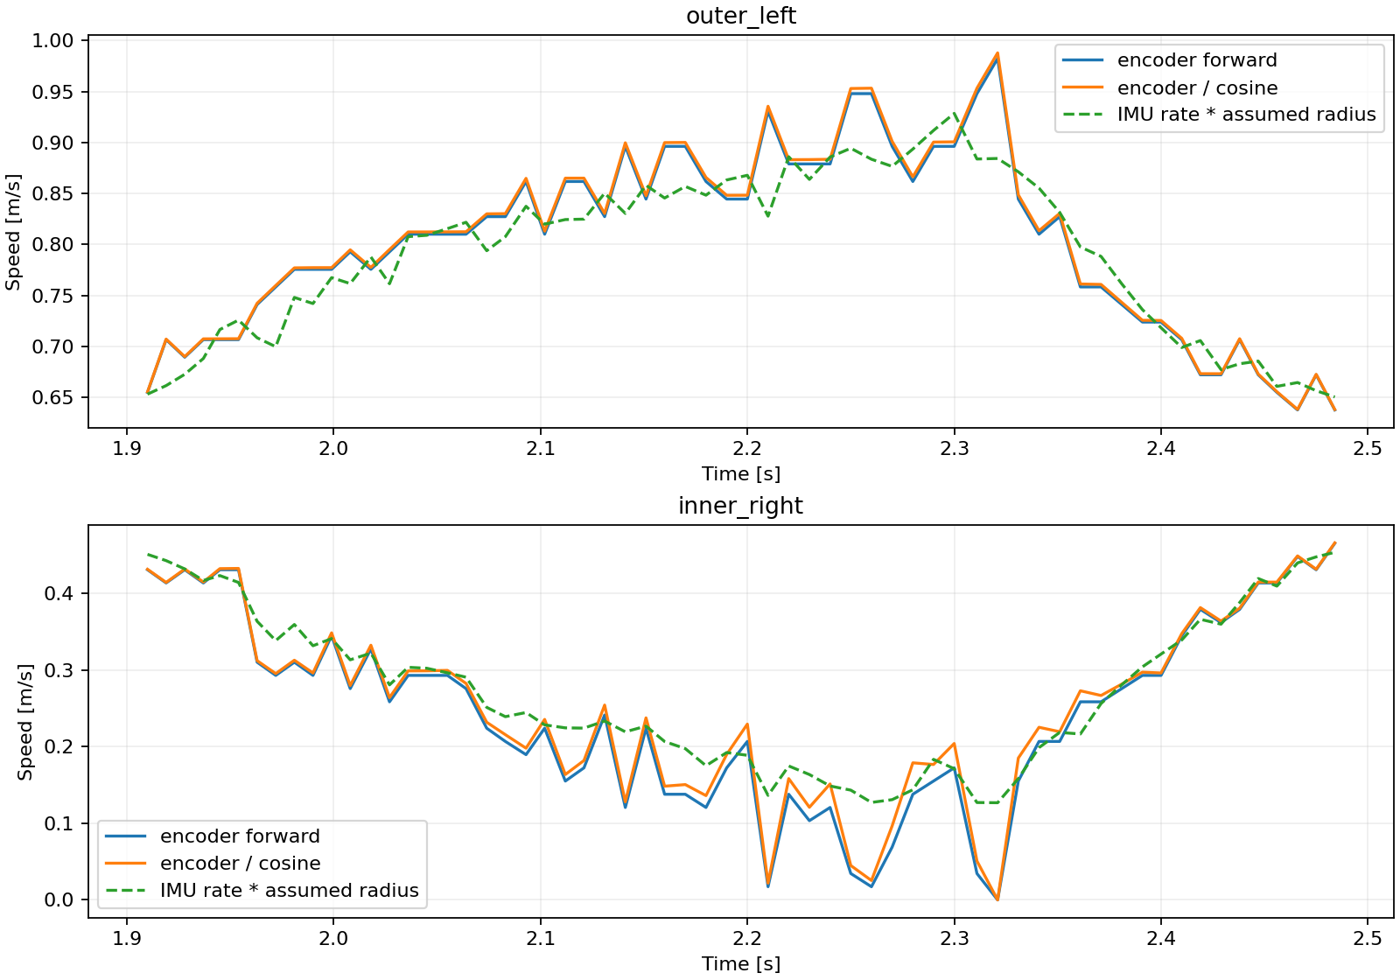
analysis/tire_ground_speed_12888/first_corner_speeds.png
