Kageyana/robotrace_v2/analysis/wheel_projection_12866_12890/drift_comparison.png

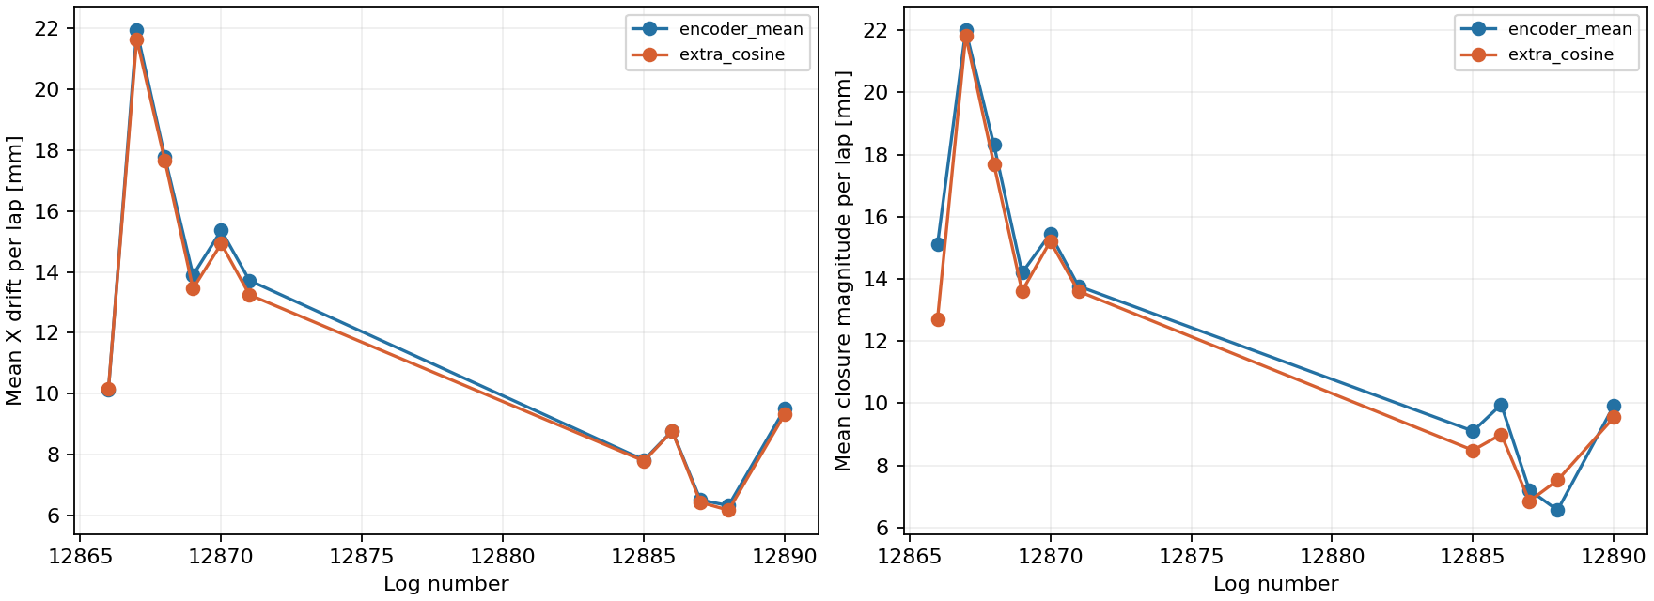
analysis/wheel_projection_12866_12890/drift_comparison.png
