Kageyana/robotrace_v2/analysis/yi_12838_12848/full_trajectories.png

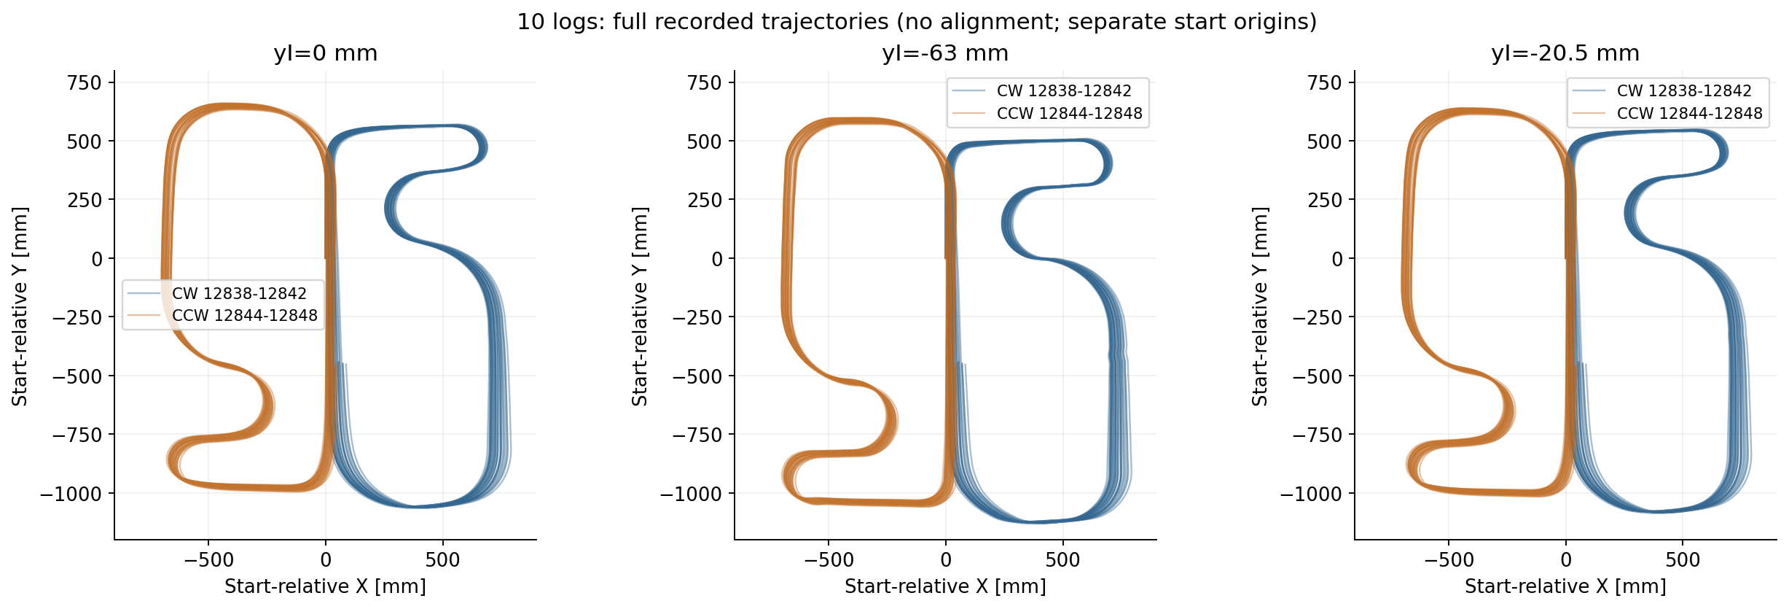
analysis/yi_12838_12848/full_trajectories.png
