Kageyana/robotrace_v2/analysis/yi_12838_12848/gyro_sensitivity.png

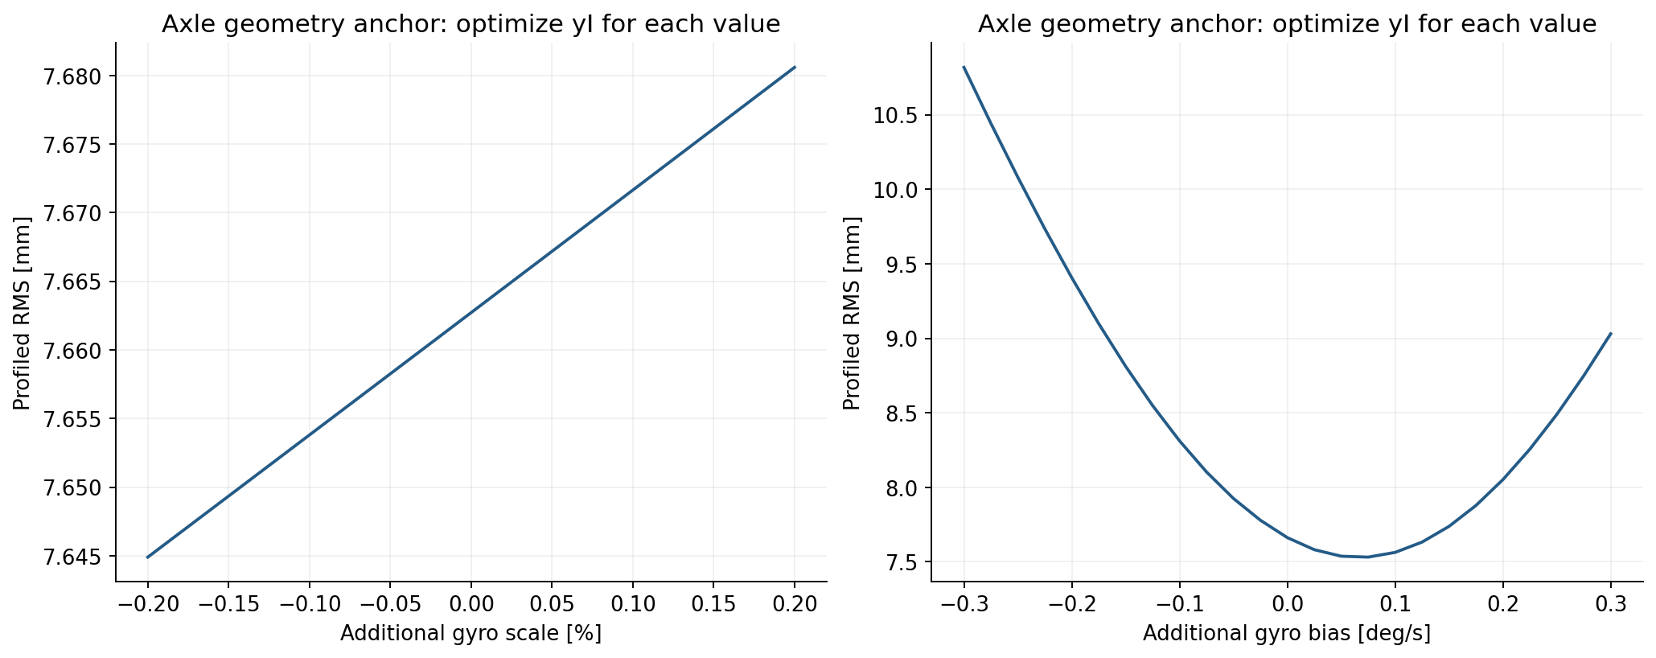
analysis/yi_12838_12848/gyro_sensitivity.png
