Kageyana/robotrace_v2/analysis/yi_12838_12848/line_cross_profiles.png

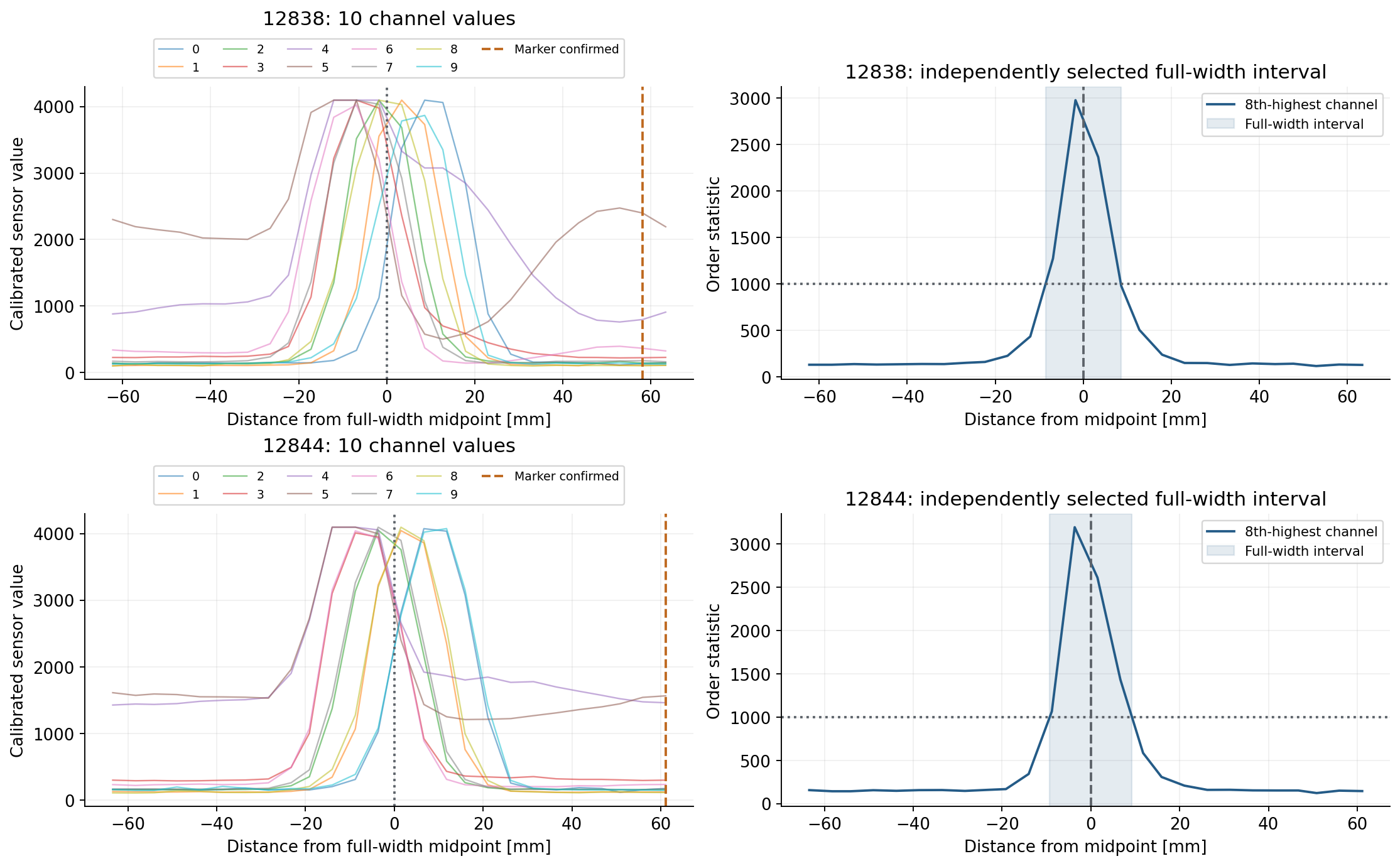
analysis/yi_12838_12848/line_cross_profiles.png
