Kageyana/robotrace_v2/analysis/yi_12838_12848/phase_confounding.png

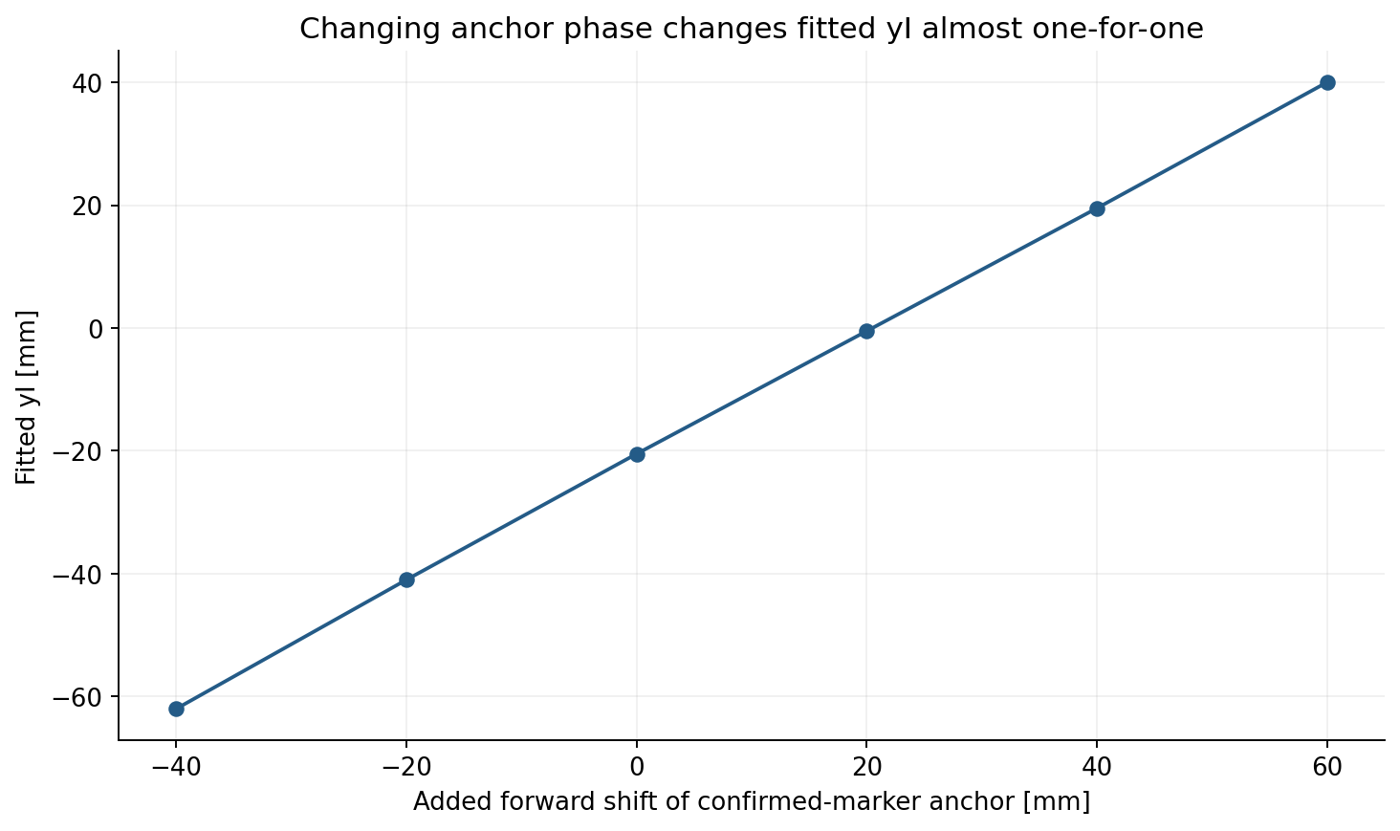
analysis/yi_12838_12848/phase_confounding.png
