Kageyana/robotrace_v2/analysis/yi_12838_12848/residual_distribution.png

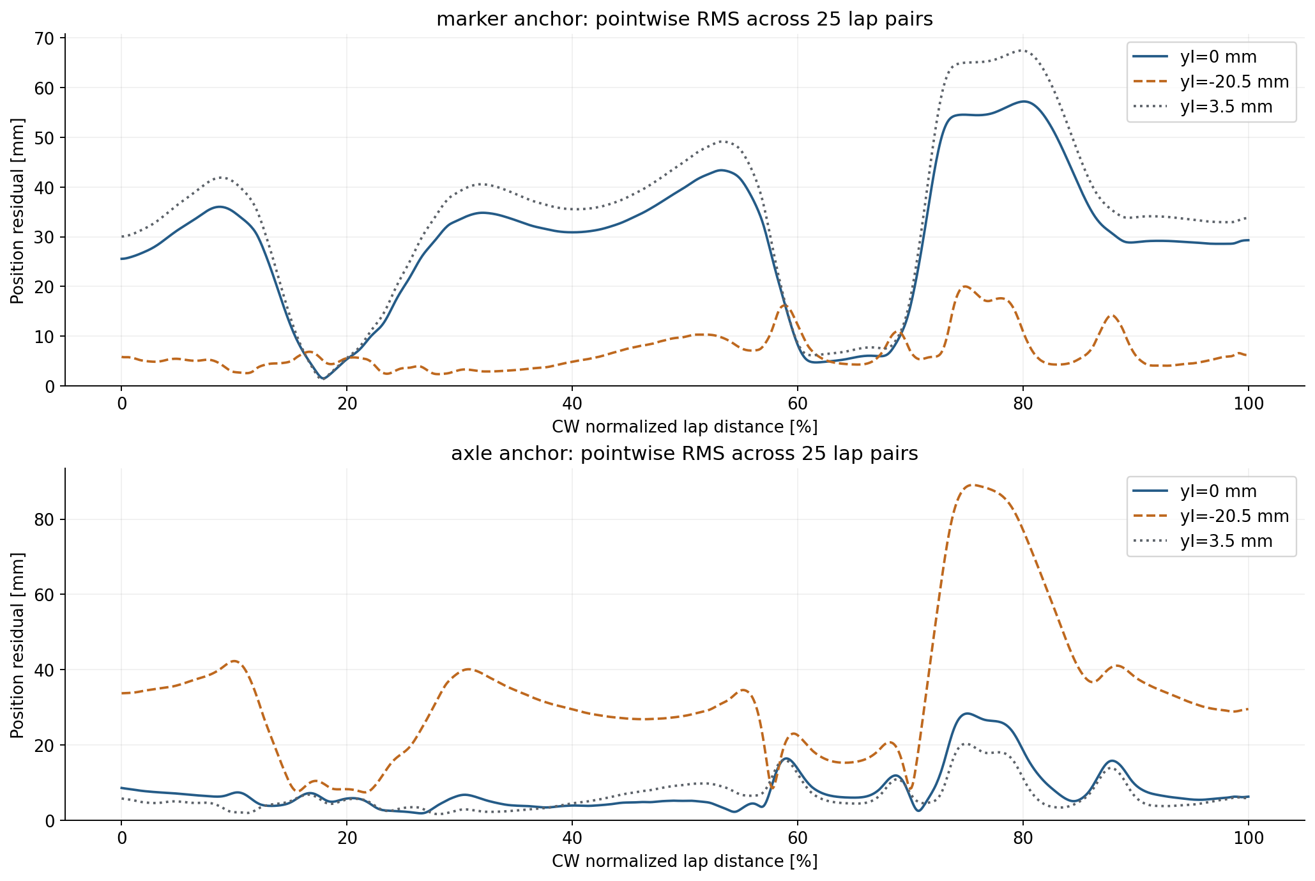
analysis/yi_12838_12848/residual_distribution.png
