Kageyana/robotrace_v2/analysis/yi_12838_12848/residual_map.png

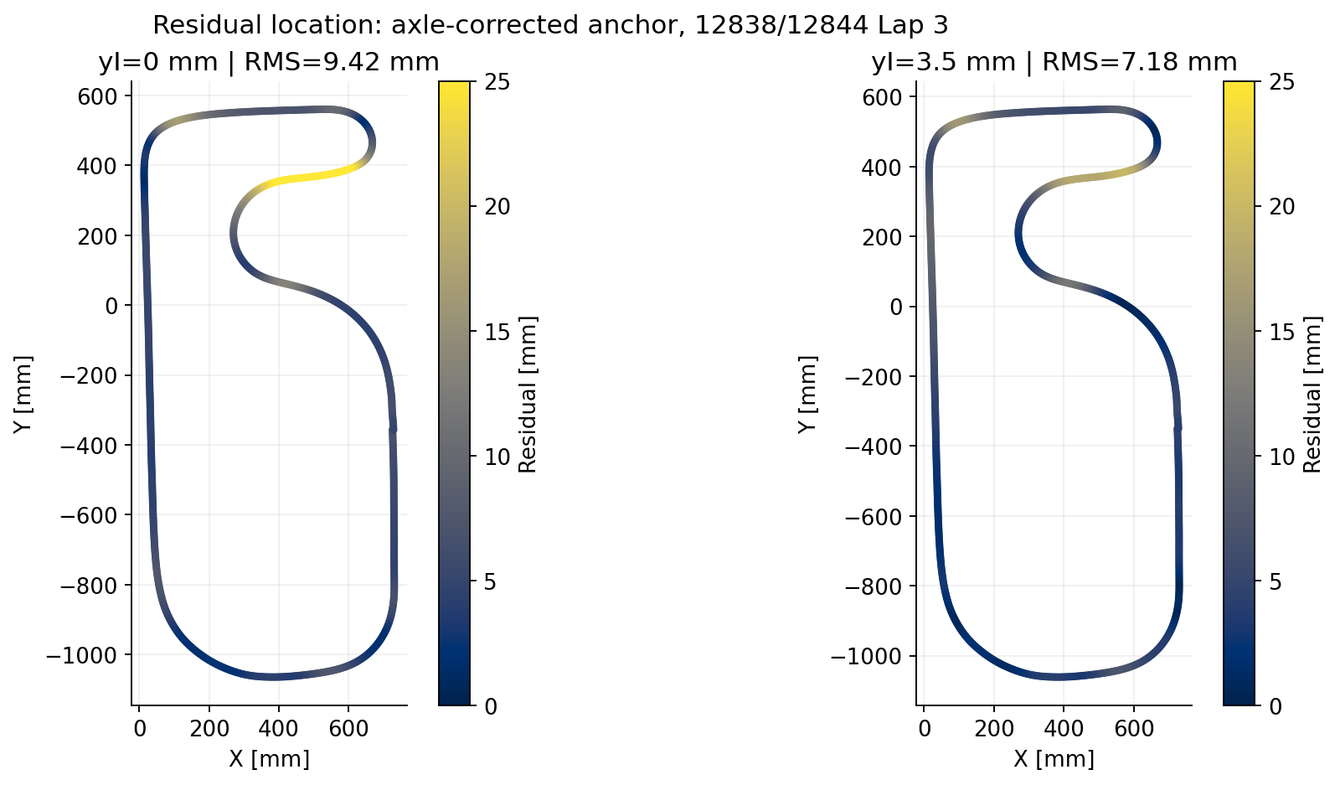
analysis/yi_12838_12848/residual_map.png
