Kageyana/robotrace_v2/analysis/yi_12838_12848/rms_vs_yi.png

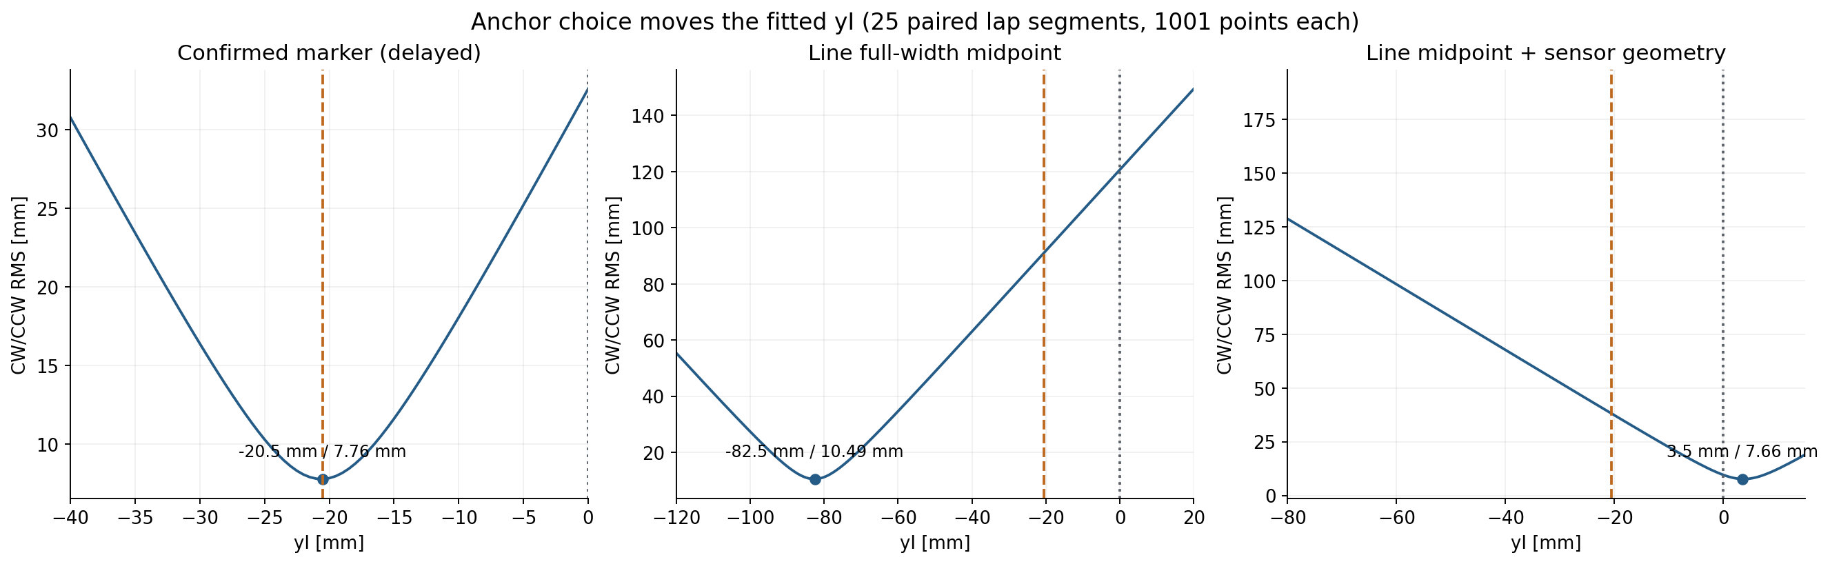
analysis/yi_12838_12848/rms_vs_yi.png
