Kageyana/robotrace_v2/analysis/yi_12838_12848/sensor_geometry.png

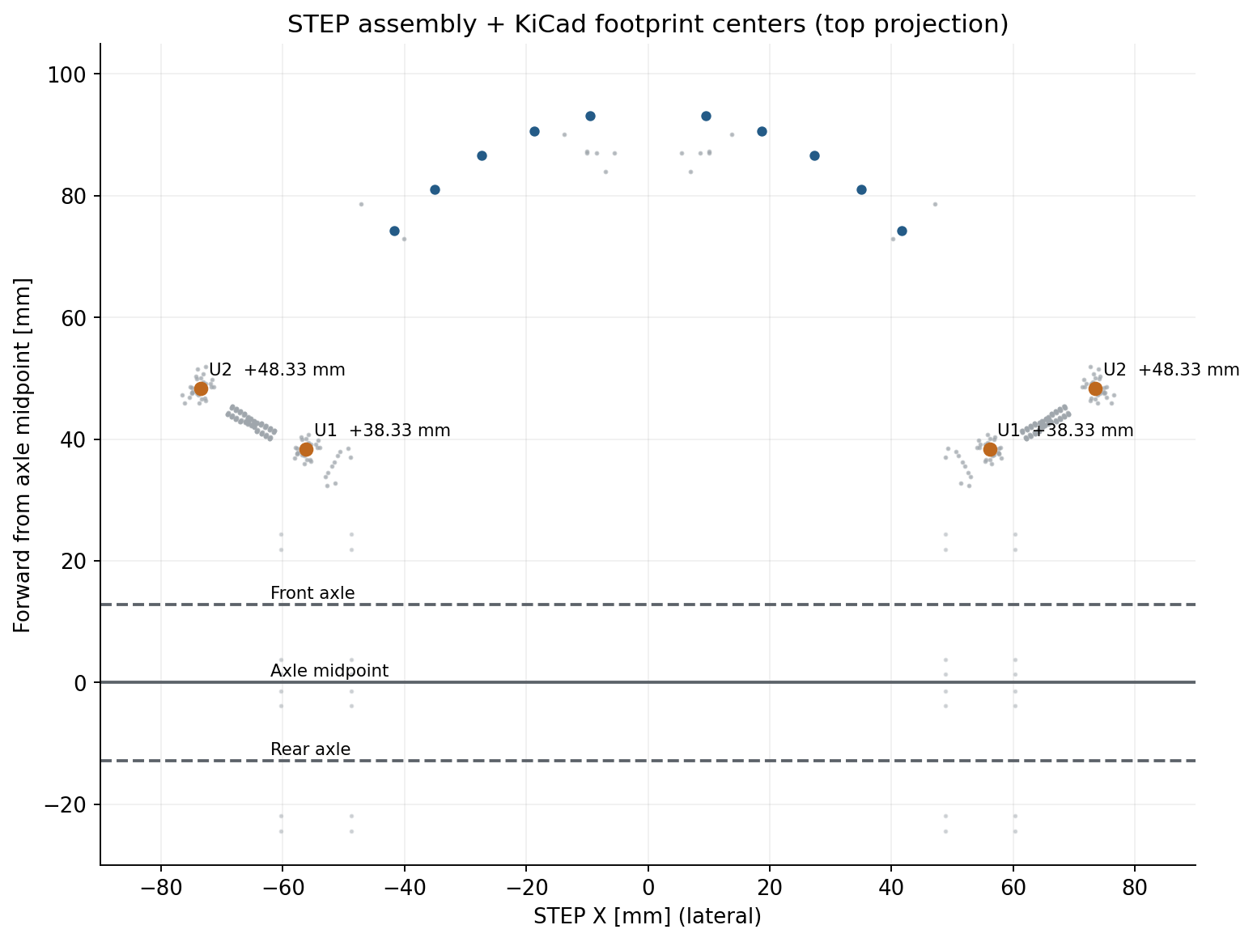
analysis/yi_12838_12848/sensor_geometry.png
