Kageyana/robotrace_v2/analysis/yi_12838_12848/trajectory_comparison.png

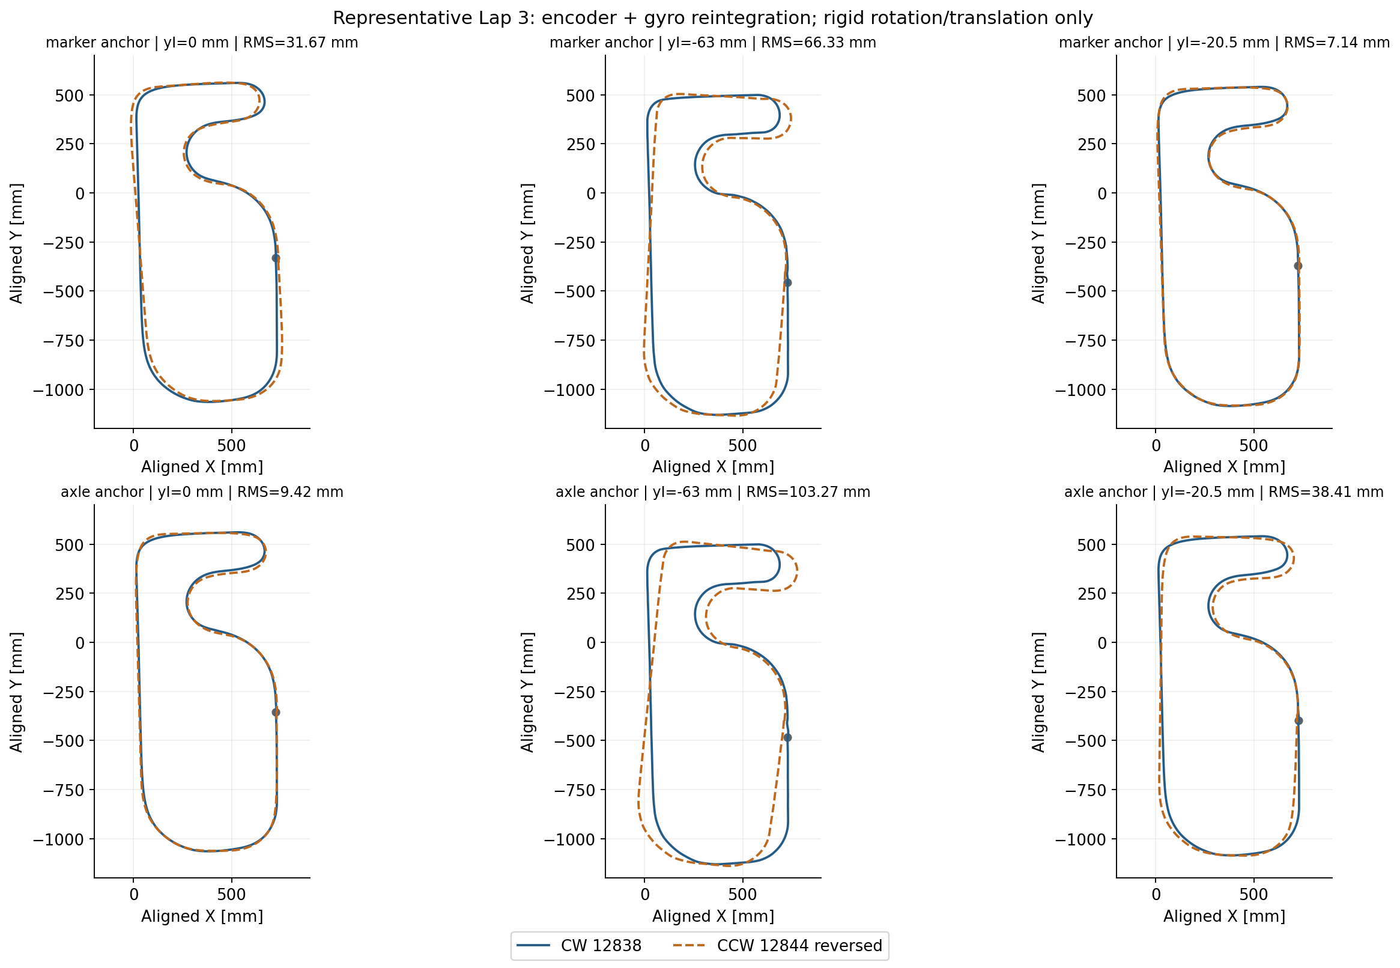
analysis/yi_12838_12848/trajectory_comparison.png
