Kageyana/robotrace_v2/Circuit/robotrace_v2_main_v2/robotrace_v2_main_v2.step

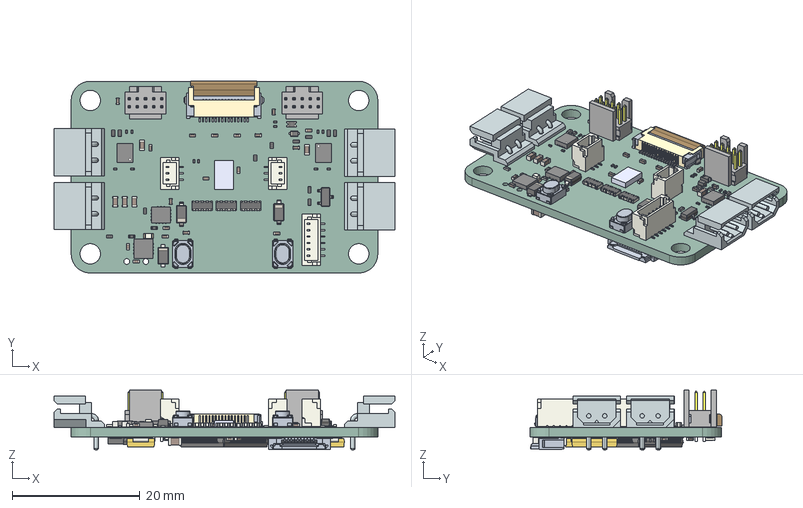
[picture p40: CAD file, 2026-10-03]
Circuit/robotrace_v2_main_v2/robotrace_v2_main_v2.step
53.4 x 30.0 x 9.31 mm
C_0402_1005Metric x 27
R_0402_1005Metric x 15
R_0201_0603Metric x 12
C_0603_1608Metric x 5
D_SOD-123F
BMI088
LED_0603_1608Metric
MP6551 (QFN-14, 2.5x3) x 2
D_SOD-523
D_SOD-123 x 2
FTSH-105-01-F-D-K_pins2 x 2
FTSH-105-01-F-D-K_pins1 x 2
FTSH-105-01-F-D-K_body x 2
R_Array_Concave_4x0603 x 3
SOT-23
ADM7172
D_0603_1608Metric
robotrace_v2_main_v2 1.44 x 2
lock
pins
TPS63070
JST_SH_BM06B-SRSS-TB_1x06-1MP_P1.00mm_Vertical
JST_SH_BM03B-SRSS-TB_1x03-1MP_P1.00mm_Vertical x 2
SOT-363_SC-70-6 x 2
R_0603_1608Metric x 10
C_0805_2012Metric x 3
CP_EIA-7343-15_Kemet-W x 2
LQFP-64_10x10mm_P0.5mm
D_SOD-128
robotrace_v2_main_v2_PCB
