Kageyana/robotrace_v2/Circuit/robotrace_v2_Extended_UI/robotrace_v2_Extended_UI.step

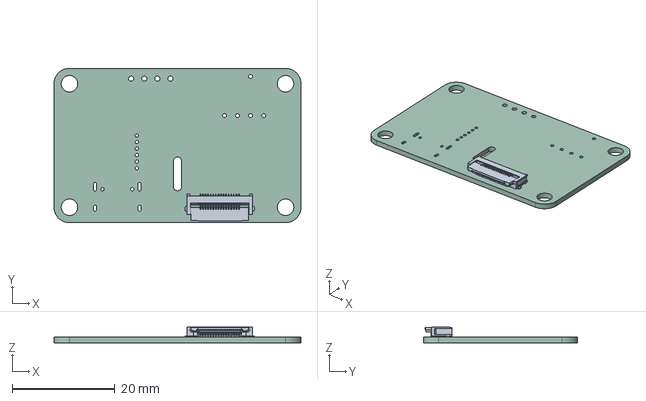
[picture p41: CAD file, 2026-08-19]
Circuit/robotrace_v2_Extended_UI/robotrace_v2_Extended_UI.step
48.0 x 30.0 x 3.08 mm
robotrace_v2_Extended_UI_PCB
