Kageyana/robotrace_v2/Circuit/robotrace_v2_Linesensor/robotrace_v2_Linesensor.step

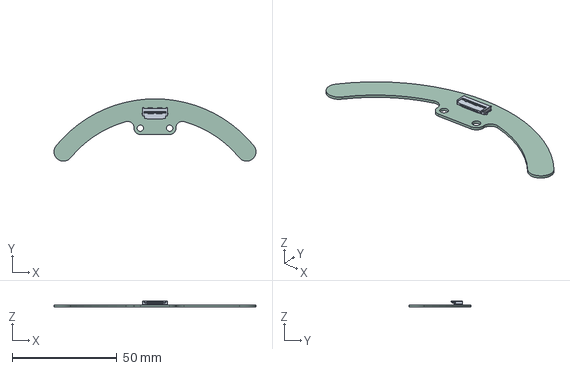
[picture p42: CAD file, 2026-08-19]
Circuit/robotrace_v2_Linesensor/robotrace_v2_Linesensor.step
96.3 x 29.7 x 2.88 mm
robotrace_v2_Linesensor_PCB
