Kageyana/robotrace_v2/Circuit/robotrace_v2_Sidemarker/robotrace_v2_Sidemarker.step

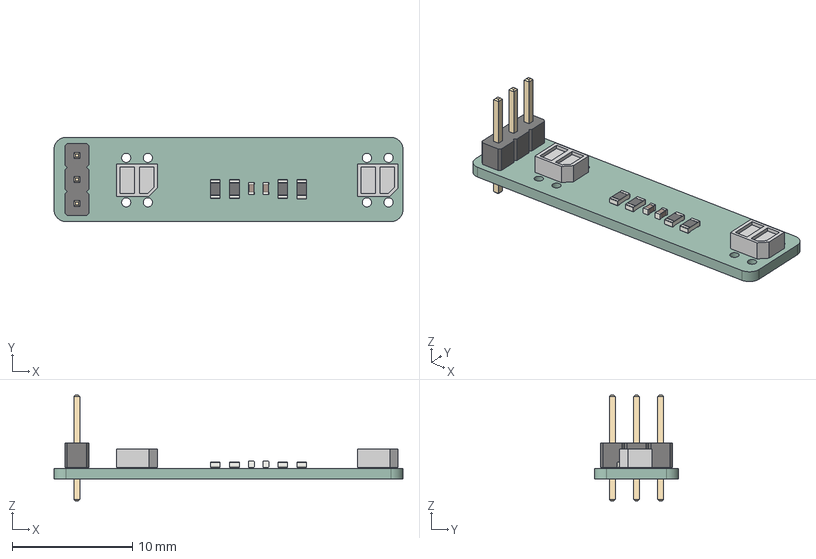
[picture p43: CAD file, 2026-10-03]
Circuit/robotrace_v2_Sidemarker/robotrace_v2_Sidemarker.step
29.0 x 7.00 x 8.80 mm
LBR-123F v1 x 2
R_0603_1608Metric x 4
PinHeader_1x03_P2.00mm_Vertical
C_0402_1005Metric x 2
robotrace_v2_Sidemarker_PCB
