Kageyana/robotrace_v2/Machine/Course_benchmark.DXF

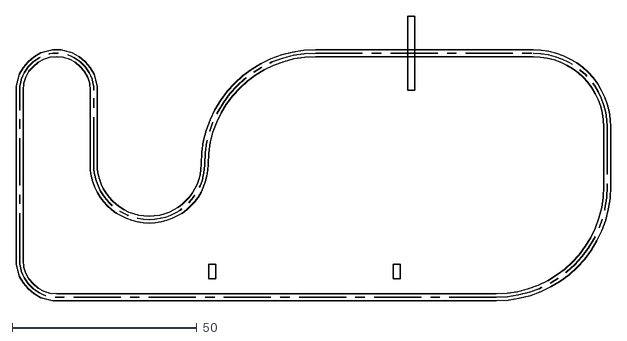
[picture p44: CAD file, 2026-10-12]
Machine/Course_benchmark.DXF
160.8 x 77.0
