Kageyana/robotrace_v2/Machine/robotrace_v3.STEP

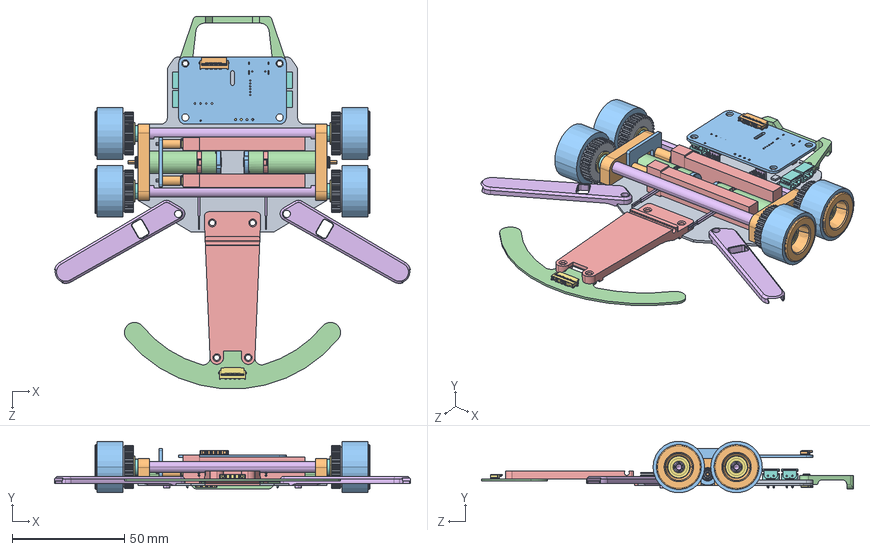
[picture p45: CAD file, 2026-10-01]
Machine/robotrace_v3.STEP
158.6 x 22.8 x 165.8 mm
base_v2
mount_motor2 x 2
0-0.stp x 2
0-1.stp x 2
0-2.stp x 2
0-3.stp x 2
0-4.stp x 2
0-5.stp x 2
0-6.stp x 2
0-7.stp x 2
sensorbar_v2
sidemarkermount
ﾐﾗｰsidemarkermount
SMF85 x 8
spacer_wheel_14 x 4
wheel_gear x 4
wheel_end x 4
tire_miniZ x 4
FTSH-105-01-F-D-K_pins2_1.step x 2
FTSH-105-01-F-D-K_pins1_1.step x 2
FTSH-105-01-F-D-K_body_1.step x 2
SOLID_1.step
0022057025.step x 4
MP6551 (QFN-14, 2.5x3)_1.step x 2
ADM7172_1.step
robotrace_v2_main_v2 1.7.step x 2
5051101492_1.step
TPS63070_1.step
robotrace_v2_main_v2_PCB_1.step
5051101692.step
robotrace_v2_Extended_UI_PCB.step
5051101492_2.step
robotrace_v2_Linesensor_PCB.step
battery_BETAFPV x 2
axial_wheelLR x 2
BT2.0 Connector_male x 2
robotrace_v2_batteryjoint2
stay_rear
