Kageyana/robotrace_v2/doc/失敗事例/2026-08-22-shell-helper-setup-refresh-error.md

---
type: codex-failure
date: 2026-08-22
task: ST-Link接続確認とSTM32CubeCLTデバッグ環境確認
status: resolved
severity: low
tags:
  - codex/failure
---

# シェル実行時のhelper setup refreshエラー

## 要約

通常のサンドボックス実行ではPowerShell/cmdの起動に失敗したが、`require_escalated` の読み取り実行で回避できた。

## 発生した状況

- タスク: ST-Link接続確認とプロジェクトのデバッグ設定確認
- 実行環境: Codex desktop、Windows、D:\\robotrace\\robotrace_v2
- 前提条件: 通常権限でリポジトリ内Skillを読み取り、CLIを確認する

## 何を試したか

1. PowerShellでSkillファイルを読み取った。
2. cmd経由の簡単なコマンドも実行した。
3. `require_escalated` で同じ読み取りとSTM32ツール確認を行った。

## 結果・エラー

通常権限では次のエラーでプロセスが起動しなかった。

```text
Rejected("Failed to create unified exec process: helper_unknown_error: setup refresh had errors")
```

`require_escalated` では正常に実行でき、STM32_Programmer_CLIによるST-Link接続確認も成功した。

## 原因

実行ヘルパーのsetup refreshで一時的な起動エラーが発生したと考えられる。根本原因は未確認。

## 解決・回避策

読み取り専用の確認で同じエラーが再発した場合は、必要最小限のコマンドについて`require_escalated`を使う。

## 今後の予防策

実機確認タスクでは、最初に単純なシェル起動またはツール検出を行い、通常権限でhelper起動に失敗した場合は同じコマンドを繰り返さず、承認付き実行へ切り替える。

## 関連

- 関連ノート:
- 参考リンク:
