Kageyana/robotrace_v2/doc/log-processing-performance.md

# ログ変換・走行間解析の高速化（2026-10-15）

> 2026-10-24: 機体側CSV変換API・旧CSV読込・CSV行バッファを削除した。現行bin専用の型付き読込と`validation/log_storage/run.py`を使用する。以下の機体CSV変換や旧テストの説明は当時の履歴。現行仕様は[整理後の構成](main-code-cleanup.md)を参照する。

> 同日、5走分の待ち時間をなくすため、機体側CSV変換を通常経路から外し、PC側へ移した。[現行手順](pc-binary-log-import.md)を参照。以下のCSV時間は移行前の高速化効果の記録で、現行運用の走行終了待ち時間ではない。

## 実装

- ログI/O用6 KiBをunionで共用する。走行中は既存2 KiB×3本、停止中は4 KiB先読み＋2 KiB出力。キュー排出・最終書込完了後に切り替え、FatFsロックを保持する。
- バイナリの事前検証・解析をブロック読込へ変更。レコード境界をまたぐ復元、記録部の終端制限、短い読込、seek/reopen/closeでの先読み失効を扱う。
- CRC32/IEEEを定数テーブルへ変更。保存形式・多項式・初期値・終了XORは同じ。
- CSVは従来と同じsnprintf書式とCRLFでブロック書込。partへ連続領域を確保し、実長へtruncateしてsync/close/rename後だけbinを削除する。FR_DENIEDだけ通常割当へ戻す。
- DISTANCE/SLIPの不要なXY計算を省く。PATHはCRC・クロス抽出と経路検証・生成の2走査。再利用時も元binの全件CRCを検証する。
- キャッシュは同一連続走行内の延長前基準経路のみ。元ログ情報、設定、系列世代、RAM所有者で照合する。共有RAM切替・初期化・失敗で失効し、速度計画とゴール延長は毎回生成する。

`logSource.h`に用途付きopenと検証済みバイナリ情報取得を追加した。既存openは従来用途のラッパー。FatFs型をmain経由のSDcard.hへ追加していない。SPIクロック、PID、1 ms割込み、ログスキーマ、CSV数値書式、ビルド最適化は変更していない。

## 同一実機・実カードでの5回比較

STM32F446、既存exFATカード（fs_type=4、512 Bセクター、128 KiBクラスタ）、Debug通常プロファイルで測定した。入力は同じ370行・183 B/行の円弧バイナリ、ファイル長70,971 B。各試行で専用32760番をアップロードし、DISTANCE→SLIP→PATH→SHORTCUT→CSVの順に停止状態で実行した。アップロード・GDB停止・成果物取得時間は各処理の計測外。ファイル・計画は試行ごとに初期化した。

| 処理 | 変更前中央値[ms] | 変更後中央値[ms] | 短縮率 | 前/後の最大[ms] |
|---|---:|---:|---:|---:|
| DISTANCE | 2639 | 551 | 79.1% | 2640 / 557 |
| SLIP（一次計画を再利用） | 2640 | 551 | 79.1% | 2641 / 552 |
| PATH（初回生成） | 5283 | 561 | 89.4% | 5284 / 561 |
| SHORTCUT（基準経路を再利用） | 5320 | 154 | 97.1% | 5322 / 154 |
| CSV変換 | 8721 | 1952 | 77.6% | 8729 / 1967 |

PATHのSD読込要求は単一542＋複数2回から、単一6＋複数35回へ変化した。SHORTCUTは変更後に単一6＋複数18回。CSV書込は単一270＋複数0回から、単一8＋複数66回となり、既存ドライバの複数ブロック転送を活用できた。

これは短い合成ログによる停止中処理の実測であり、全コース・全ログサイズ・全カードの短縮率を保証しない。実機は計測用コードをビルド領域のコピーへだけ追加した。設定ファイルanalysis.txtの保存を止め、専用番号との衝突を確認してから作成し、毎回片付けた。終了時PWM=0/0、SDロックなし、読込ハンドルなし、initMSD/initIMU/recovery成功、CFSR/HFSR=0を確認した。

## 互換性・異常系

- PCの変更前スナップショット対現行で両プロファイルを5回比較し、CSV・バイナリ・DISTANCE/SLIP計画・PATH/SHORTCUTの基準経路と走行経路がバイト一致した。
- 同じ機体上でDISTANCE/SLIP/PATH/SHORTCUTの計画がバイト一致した。CSV出力は旧新とも134,333 B、CRC32/IEEE=3812729655で一致し、変更後の5回すべて同じ値だった。PCとARMの異なる実行環境間のCRC一致を、変更前後の互換性条件には使わない。
- 実FatFs R0.12cのexFAT RAMディスクで旧f_puts対新出力の全バイト一致を検証。CRLFが64/512/2048 B境界をまたぐ場合、事前確保・truncate・複数セクター書込も確認した。
- CRC既知値・空入力・全バイト値・分割更新、全6バイナリ形式、短い転送、CRC/形式不正、確保失敗、truncate/sync/close/rename/unlink失敗、中断後の再変換を検証した。
- キャッシュの有無、設定変更、系列の開始/中止、共有RAM切替、元bin破損で、結果一致・失効・開始禁止を確認した。

性能集計は`-DROBOTRACE_LOG_PERFORMANCE=ON`で有効化する。`logPerformanceStats`はRAMのみで、通常版では除外する。各時間はHAL tickによる割込み待ち込みの経過msで、内訳には包含関係と1 ms分解能がある。`fullScans`は全走査開始回数、disk転送カウンタは要求数・要求バイト数である。

## ビルドと残る確認

| 構成 | RAM（予約込み）[B] | Flash[B] |
|---|---:|---:|
| Debug通常 | 88096 | 274836 |
| Release通常 | 88288 | 179436 |
| Debug詳細 | 88096 | 276204 |
| Release詳細 | 88288 | 179956 |
| DebugMarker | 88096 | 276204 |

全5構成で共有バッファ0x1800 B、スタック予約0x2000 B、RAM終端0x20020000を確認した。DebugのCSV変換関数自体のフレームは約2.6 KiBで、呼出先・割込み込みの最大スタック実測は未実施。最終差分による新規warningは解消済みで、既存のwarningは残る。

既存の保存・形式互換・スキーマ・XY・経路・自動走行・共有メモリ回帰は成功。2026-10-15、変更後にユーザーが実走行し、「書き込み速度は明確に速くなっています」と報告した。実走後の体感改善として記録し、上記の静止試験による実測時間とは区別する。今回の報告では走行本数・方式・CSV内容は未確認であり、オートスタート5走の一連動作、緊急停止、電源断を伴う実カード復旧試験の確認は引き続き残る。PCの故障注入テストと混同しない。

再実行はローカル検証用`robotrace_v2/tests/run_log_performance_tests.py`、`run_fatfs_csv_writer_tests.py`、既存各runnerを使用する。tests/とbuild/は既存.gitignoreに従う管理対象外。変更前スナップショット・5回の生出力・計画ダンプ・ビルドログ・Flashバックアップは`robotrace_v2/build/sd-performance/`に保持する。実機診断は`prepare_log_device_bench.py`と`run_log_device_bench.py`で準備し、通常ファームウェアへ診断タスクを組み込まない。

最終Debug通常版（性能診断OFF）をSWDで書込み・全照合・起動した。ELF SHA256は`56507e5589169aab3c763645eb71cb0e3d7503fe4d6e882961ed6a10c8a23d58`。最終起動後はinitMSD=1、initIMU=1、logRecoveryReady=1、modeLOG=0、logTempOpen=0、FatFsロック=0、入力ハンドルなし、PWM=0/0、start=0、autoStart=0、patternTrace=0、CFSR/HFSR=0、タイマー凍結=0を確認し、GDB・自分のサーバーを終了した。通常版のELFに診断タスク・アップロード用領域・性能統計のシンボルはない。

検証時のヘッダ順序・抽出依存・クロスCPU比較の再発防止は[失敗記録](失敗事例/2026-10-15-log-performance-harness-contract.md)と[書込・デバッグSkillの参照手順](../.agents/skills/robotrace-flash-debug/references/failure-prevention.md)へ反映した。
