Kageyana/robotrace_v2/analysis/debug-bench-results-2026-09-29.md

# 空転負荷ベンチ結果（2026-09-29）

## 実行条件

- ブランチ: `codex/sd-log-sector-write`
- 通常プロファイル: `Debug`、56 Bレコード（`LOG_SCHEMA_PROFILE_LIGHT=1`）
- 詳細プロファイル: `DebugMarker`、109 Bレコード（`LOG_SCHEMA_PROFILE_LIGHT=0`）
- 専用CSV: `NPRIM.CSV` / `NPATH.CSV` / `NSHORT.CSV`、詳細版は`DPRIM.CSV` / `DPATH.CSV` / `DSHORT.CSV`。書込計測CSVは各ファイル名に`W`を付加。
- 機体を固定し、車輪を浮かせ、モーター電源・SDカード・ST-Linkを接続。各ケースはMCUをリセットし、GDBからモードを指定。
- 走行中はコアを停止せず、`debugBenchCompletedBreakpoint`で結果を取得。

## 6ケース結果

| プロファイル / モード | 終了 / 時間 | CSV行数（実/期待）・列数 | `f_write` / SD書込 / 複数セクタ | 最大セクタ数 / 最大待ち | 最終位置 / 長さ / 実書込 [B] | 最大割込 / 擬似処理 / 走行相当 [cycle] | 最大周期 / 超過 | PATHロスト | CSV検証 / 成功 |
|---|---:|---:|---:|---:|---:|---:|---:|---:|---:|
| 56 B / PRIMARY | TRACE_END / 36,483 ms | 3,281 / 3,281・28列 | 90 / 91 / 89 | 4 / 7 ms | 182,272 / 1,536 / 1,536 | 26,644 / 0 / 26,644 | 179,871 / 0 | 0 | 成功 / 成功 |
| 56 B / PATH REPLAY | TRACE_END / 36,734 ms | 3,314 / 3,314・28列 | 91 / 92 / 90 | 4 / 32 ms | 184,320 / 1,536 / 1,536 | 39,754 / 1,446 / 38,385 | 179,871 / 0 | 0 | 成功 / 成功 |
| 56 B / SHORTCUT | TRACE_END / 36,734 ms | 3,318 / 3,318・28列 | 91 / 92 / 90 | 4 / 7 ms | 184,320 / 1,536 / 1,536 | 39,650 / 1,452 / 38,242 | 179,850 / 0 | 0 | 成功 / 成功 |
| 109 B / PRIMARY | TRACE_END / 36,483 ms | 3,286 / 3,286・47列 | 175 / 176 / 174 | 4 / 8 ms | 356,352 / 2,048 / 2,048 | 30,221 / 0 / 30,221 | 179,846 / 0 | 0 | 成功 / 成功 |
| 109 B / PATH REPLAY | TRACE_END / 36,734 ms | 3,317 / 3,317・47列 | 177 / 178 / 176 | 4 / 32 ms | 360,448 / 1,536 / 1,536 | 43,231 / 1,463 / 41,819 | 179,866 / 0 | 0 | 成功 / 成功 |
| 109 B / SHORTCUT | TRACE_END / 36,734 ms | 3,322 / 3,322・47列 | 177 / 178 / 176 | 4 / 31 ms | 360,448 / 2,048 / 2,048 | 43,597 / 1,453 / 42,185 | 179,846 / 0 | 0 | 成功 / 成功 |

## 判定

- 全ケースで`debugBenchResult.success=1`、停止理由`TRACE_END`、CSV行数が期待件数と一致。CSV列数不一致0、`cntlogMonotonic=1`。
- CSV列数は、既存形式の末尾カンマが表す空欄列を含むファームウェア検査値。
- 全走行中書込について`writeAlignmentErrors=0`、書込失敗0、短い書込0。最終書込位置・長さも512 B境界／倍数で一致。
- 全ケースで複数セクタ書込がSDドライバへ到達。最大4セクタ要求を確認。
- バッファオーバーフロー0、1 ms周期超過0、PATHロスト0、実速度10 m/s超過判定0。
- 全ケースで停止後の左右PWM変数とTIM2左右比較値は0。
- 実行中の最大割込時間は26,644～43,597 cycles（180 MHz換算で約148～242 µs）。PATH系の最大擬似姿勢処理は1,446～1,463 cycles（約8.0～8.1 µs）。
- 専用走行CSVは機体上で再読込して行数・列数・`cntlog`を検証。カードは取り外していない。

## IWDG開始前停止試験

通常DebugのPRIMARY開始直前ブレークでコアを停止し、IWDGによるリセットを確認した。リセット後の結果は`state=RESET`、`stopReason=WATCHDOG_RESET`、対象モードPRIMARY、`resetCauseFlags=0x24000000`（IWDGRSTFを含む）。要求モードは0に戻り、左右PWM変数とTIM2左右比較値は0で、ベンチは自動再開しなかった。

## HAL初期化後のリセット復旧回帰

`debugBenchCaptureResetCause()`を`HAL_Init()`直後へ移した後、IWDGリセット記録を保持した状態で通常リセットし、Debug PRIMARYを1ケース実行した。結果は`TRACE_END`、36,483 ms、CSV 3,265行（期待3,265行）・28列で検証成功。`cntlog`は36～36,479で単調増加し、512 B整列エラー0、SD書込失敗0、バッファオーバーフロー0、1 ms周期超過0、PATHロスト0だった。走行中SD書込91回のうち複数セクタ要求は89回、最大4セクタ、最大待ち時間7 ms。終了後の左右PWM変数とTIM2左右比較値は0。`debugBenchResult.resetCauseFlags=0`で、通常起動時に古いIWDG要因を再記録しなかった。

修正版を書き込んだ状態で開始直前にデバッガを停止してIWDGリセットを発生させ、`state=RESET`、`stopReason=WATCHDOG_RESET`、`resetCauseFlags=0x24000000`（IWDGRSTFを含む）、結果に記録されたウォッチドッグ設定6/255を確認した。要求モードは0、左右PWM変数とTIM2左右比較値は0で、自動再開しなかった。

## Debugログへのダミー42 B追加

Debugビルドでは各バイナリレコード末尾へゼロ42 Bを追加し、CSV列・実データ項目は変えていない。元の軽量56 Bは98 B、詳細109 Bは151 Bとなる。`ROBOTRACE_LOG_DUMMY_BYTES`で値を変えられ、Releaseは常に0 B。

| プロファイル / レコード長 | 終了 / 時間 | CSV行数（実/期待）・列数 | SD書込 / 複数セクタ / 最大セクタ | 最大待ち | 最大割込 / 最大周期 / 超過 | PATHロスト / overflow / SD失敗 | CSV検証 / 成功 |
|---|---:|---:|---:|---:|---:|---:|---:|
| 56+42 = 98 B / PRIMARY | TRACE_END / 36,483 ms | 3,086 / 3,086・28列 | 149 / 147 / 4 | 11 ms | 27,239 / 179,879 / 0 cycle | 0 / 0 / 0 | 成功 / 成功 |
| 109+42 = 151 B / PRIMARY | TRACE_END / 36,483 ms | 3,145 / 3,145・47列 | 233 / 231 / 4 | 9 ms | 30,681 / 179,871 / 0 cycle | 0 / 0 / 0 | 成功 / 成功 |

両方で`cntlog`単調性、512 B整列、短い書込なしを確認した。終了後の左右PWM変数とTIM2比較値は0。最大書込待ちは11 ms、最大1 ms割込時間は30,681 cyclesで、周期超過はなかった。これは車輪を浮かせたDebug固定PWMベンチの結果で、コース走行の安定性までは判定していない。

初回のDebug書込後はカード検出が挿入状態でも起動時`SD_SPI_Init()`に失敗し、`initMSD=0`でケース開始前に`SD_OPEN`となった。ログ書込みは行っていない。Under Resetのハードウェアリセット後は`SD_SPI_Init()`が`SD_OK`、マウント成功となり、上記2ケースを完走した。初回失敗の原因は未特定。

## ビルド・テスト

| 構成 | RAM | FLASH |
|---|---:|---:|
| Debug | 118,456 / 131,056 B（90.39%） | 280,356 / 524,288 B（53.47%） |
| DebugMarker | 118,456 / 131,056 B（90.39%） | 282,196 / 524,288 B（53.82%） |
| Release | 115,872 / 131,056 B（88.41%） | 152,648 / 524,288 B（29.12%） |

今回の42 B追加後に3構成を再ビルドできた。`tests/run_pc_tests.ps1`は以前のログバッファ変更時に成功しているが、今回のパディング追加後は再実行していない。ビルド出力には既存箇所のwarningが残るが、今回のダミー書込み変更箇所に新規warningは確認されなかった。
