Kageyana/robotrace_v2/doc/失敗事例/2026-11-01-target-speed-u16-validation-preflight.md

# targetSpeed型変更時の検証器入口と最適化・改行

- 対象: uint16_t化のビルド・ホスト検証。
- 事実: Skillの過去参照validation/log_storage/run.pyを実在一覧に無いまま読取り、ファイル欠落で停止した。製品変更前で、原本・ファームへの影響は無かった。以後は実在validation配下を列挙し、今回の検証をvalidation/target_speed_u16へ追加した。
- 事実: 新規ホスト試験のZig O2でNDEBUGが有効となりassertが消え、expected/fが未使用warningでコンパイル失敗。O0は成功済みで、O2成功とは報告しなかった。
- 対処: 生成Cのassert.hより前に#undef NDEBUGを置き、O0/O2とも実検査を保持した。実setter・保存/読込・受入・CRC・境界試験が両profileで成功した。
- 事実: Debugビルドは成功したが、nm出力のCRLFに対する行末正規表現でシンボル集計だけが停止。実出力にはtargetSpeedの2byte整列配置が存在していた。既知の行末正規化対策をnmへ適用できなかった再発。
- 対処: nmの解析前にsplitlinesで行末正規化。実ソースSHAと完成済みDebug ELFを照合し、build.py --resume-debugで集計のみ再開、未実行Releaseをビルドした。両構成2byte・STRHを確認した。
- 再発防止: 過去文書の検証器も実在一覧から選ぶ。assert依存ハーネスでは最適化前後でNDEBUGを明示制御する。外部コマンドの行単位解析はsplitlines/stripを先に適用し、集計失敗で成功済みビルドを反復しない。ビルドSkillの実行前参照へ同時追記する。
- 確認: validation.jsonとbuild-validation.jsonが成立。以前のDebug/Releaseの全体警告6種類と一致し、新規warningなし。製品の型不具合の実機確認は別記録でopen。
- status: resolved（検証器手順）。record-failures Skillが無いためプロジェクト指定先へ手動記録。
