Kageyana/robotrace_v2/doc/失敗事例/2026-10-16-self-describing-header-test-contract.md

---
status: resolved
task: 自己記述RLOG v2への移行
---

# ヘッダ形式変更時のテスト定数とCMake実行場所

## 2026-10-25：1ms化の警告集計で増分ログを基準にした

PATH/SHORTCUTの1ms化後の4構成ビルドは成功したが、追加した集計`build/path-1ms-validation/finalize.py`が直前の`path-log-validation`の増分ログだけを警告基準にし、Debugの既存`ssd1306.c`のvsprintf宣言不足を新規と誤判定して停止した。既存の対策は「初回全体ログを併用する」としていたが、新しい集計スクリプトを作る段階で比較対象翻訳単位の被覆確認が抜けた。製品ソースのssd1306.cに今回の変更はない。

変更前の`slip-flag-validation`の全体ログと直前増分ログの両方を基準へ含め、現在ビルドでコンパイルされたCore/Srcの翻訳単位が基準でもコンパイルされていることを集計前にassertするよう修正した。単に警告名を許可リストへ追加したり製品を変更して回避していない。ビルドSkillの事前手順へ、集計スクリプトを新設する場合にも基準の翻訳単位被覆を検査する条件を追記する。

同じ集計を再実行して、4構成の翻訳単位被覆と新規warningなし、1msの呼出順、ログ列定義不変、通常/詳細の保存・PC変換を確認した。集計側の対処はresolved。実機の最長割り込み時間・走行安定性とは別問題である。

確認結果: 初回ホスト回帰で、v1の8項目だけを初期化した合成ヘッダのdecode期待が失敗した。v2ではschemaBytes/columns/derivedVersionが必須で、実長にも列定義長が加わるため、古いフィクスチャは意図どおり不正として拒否されていた。v2の値と実長を明示し、追加欄の破損もCRCで拒否するテストへ更新した。

また、PC変換器のコンパイルと同じリポジトリルートworkdirでcmake --build --preset Debugを実行し、CMakePresets.jsonがないため構成前に停止した。共通事前確認にあるファームウェアルートを同一呼出しのCMakeへ反映できていなかった。CMakeは独立した呼出しでファームウェアルートを指定し、全5構成のビルドを確認した。

再発防止: 形式変更時はヘッダの全必須項目・CRC対象範囲・実長式を合成フィクスチャへ同時反映する。旧形式の拒否をテスト失敗と混同しない。PCツールのビルドとCMakeは実行場所が異なるため、ツール呼出しを分けて各workdirを明示する。既存の数値計算は同条件のv1スナップショットと比較し、互換廃止する形式の読込テストを新形式の要件へ戻さない。

検証: 保存・CRC・故障注入・計画生成の通常/詳細回帰、5構成ビルド、通常/詳細の変更前後計画・CSVデータのバイト一致に成功。同一PC変換器で保存列の追加・削除・並替を検証した。

## 2026-10-17 XY距離変更での再発

ファームの相対パスを含む読取とPCツールのGit状態確認を同じ呼出しへまとめ、workdirをPCツール側へ指定したため、Get-Content/rgが存在しないパスとして失敗した。同じ取り違えが最終確認でも再発した。ファイル変更は発生していない。既存の「各workdirを明示する」だけでは、コマンド本文と外側のworkdirの不一致を防げなかった。

読取をファームのルートで再実行して実在ソースを取得し、以後の複数リポジトリ読取は絶対パス、Gitは`git -C`へ限定する。共通事前確認と書込み・ビルドSkillの実行前手順へ、workdir確定後のパス組立て・Test-Pathによる照合を追加する。ビルドは別呼出しで正しいファームルートを使い、Debug/Release×通常/詳細の4構成が成功した。対象ソース読取と別リポジトリGit状態の再確認をもってこの対処はresolved。実機精度の確認とは分ける。

## 2026-10-21 実ログ解析でのprofile値の取り違え

正式V2初回ログ13571〜13577の読取解析で、軽量ログをprofile=0と仮定したassertが停止した。実ヘッダはprofile=1、181 B/行、70列で、現行log_schema.hのLOG_SCHEMA_PROFILE_LIGHT=1と一致していた。CSV・元bin・製品ソースは変更していない。解析側のprofile定義確認不足が原因であり、ログ破損ではない。

解析スクリプトの期待値を現行定義のprofile=1へ修正。7本でヘッダ・データ・列定義・メタデータのCRC、実長、行数、CSVとの番号/データCRC/スキーマCRC対応に成功した。軽量/詳細の名前から数値を推測せず、解析前にlog_schema.hの定義、ヘッダ実値、列数・recordBytesを同時照合する手順をログ解析Skillの実行前へ追加した。

検証: analysis/script/evaluate_active_v2_13571_13577.py再実行がexit=0。analysis/slip_active_v2_13571_13577/validation.jsonに7本の検証値とハッシュを保存した。この解析側の前提修正はresolved。13574の終端不整合や物理滑りの検証は別問題であり、解決済みとはしない。

## 2026-10-21 増分ログだけによる新規warning誤判定

横ログ重複整理の4構成ビルドは成功したが、集計スクリプトが変更前のfinal-buildログだけを警告基準にしたため、Release詳細の既存vsprintf宣言不足を新規warningと判定して停止した。final-buildは増分で、該当SSD1306ソースが再コンパイルされておらず、以前の全体build-Release/DebugMarkerログには同じ診断が存在した。ssd1306.c自体の差分はない。

基準を変更前の初回ビルド記録も含む警告集合へ修正し、同じ検証を再実行して成功した。警告を消す目的で製品コードを変更せず、既存警告の内容と構成をvalidation.jsonへ保存した。新規warning検査を最終増分ログだけで行わず、比較元の翻訳単位/構成の被覆を先に確認する手順をflash-debug Skillへ追加した。対処と再実行確認はresolved。既存警告自体の修正は今回の対象外。

## 2026-10-24 V2のmainマージ検証：手動参照テストの旧契約

対象は`codex/slip-detector-v2`のmainへのマージ。4構成ARMビルド、V2判定、通常/詳細スキーマ、保存・CRC・故障注入・計画一致、XY回帰は成功したが、追加した`run_manual_primary_metadata_tests.py`が`h.recordBytes == (LOG_SCHEMA_PROFILE_LIGHT ? 183U : 220U)`で停止した。製品は現行の170/179 Bで保存しており、補助テストだけが旧SHADOW形式を期待していた。テストのSLIP保存後の参照番号も旧期待0のままだった。

原因は形式変更時の既存対策が主要な保存回帰までに限られ、今回追加実行した手動参照テストの固定値とメタデータ契約を事前照合しなかったこと。製品ソースにマージ元ブランチからの差分はなく、製品を旧形式へ戻していない。

対処はローカルの`tests/manual_primary_metadata_test.c`でレコード長を`LOG_RECORD_SIZE_BYTES`と照合し、元DISTANCEログ2から作ったSLIPの`slipSourceLogNumber`を2と検証すること。形式の固定サイズ66列/170 B・72列/179 Bは独立した`run_log_schema_tests.ps1`で検証する。テストは既存Git除外方針を維持し、変更箇所を本記録へ残す。

再発防止としてflash-debug Skillの実行前へ、追加する補助テストの固定サイズ・必須列・参照番号を現行ソースと照合し、旧契約なら製品ではなくテスト入力・期待を修正する手順を追加した。

確認はファームウェアルートの明示workdir・必要権限付きで`python tests/run_manual_primary_metadata_tests.py`を再実行し、通常/詳細とも実DISTANCE/SLIP/PATH解析、開始時スナップショット、欠落・失敗計画、全自動方式がPASS。ログは`robotrace_v2/build/merge-slip-v2-validation/manual-primary.log`。今回のテスト契約修正はresolved。実走行・割り込み最大時間・検出精度は今回未確認。

## 2026-10-28：追加診断の集計でwarningゼロを仮定

TIM6/ADC計測拡張の4構成ビルドは成功したが、新設finalize.pyが既存warningを含むログへassert not warningsを置き、Debugの5件で停止した。変更前の全体ログbuild/path-timing-validation/build.logには同じ診断を含む既存6種類があり、今回の新規警告ではなかった。コードを警告対処のために変更していない。

判定を基準全体ログの診断集合との差分へ修正した。行番号だけを正規化し、ファイルと診断メッセージを維持する。観測warningの翻訳単位が基準のコンパイル記録に含まれることも確認した。初回全体ログを保持し、再確認の増分ログは別ファイルへ保存した。

再発防止は、生成した集計コードを実行する前にwarning判定を検査し、既存ゼロを証明していないassert not warningsを拒否すること。flash-debug Skillのビルド集計前にも追記した。build/isr-interval-validation/preflight_helpers.pyで対象スクリプトのASTを確認する。

検証はbuild/isr-interval-validation/validation.json。通常3構成と独立計測ONの4構成成功、新規診断0、計測OFFの対象4モジュールの全命令/シンボル参照先一致を確認した。status: resolved（警告比較の前提修正）。MCU未検出による未書込みと、実走の計測未了は別件。
