Kageyana/robotrace_v2/doc/失敗事例/2026-10-04-start-calibration-yaw-pid-not-updated.md

---
type: codex-failure
date: 2026-10-04
task: オートスタート1走目前の超信地旋回校正
status: open
severity: medium
tags: [codex/failure, calibration]
---

# 開始前の旋回校正で角速度PIDが更新されない

確認事実: setup_startの旋回処理はyawRateCtrl.pwmを使うが、Interrupt1ms内のmotorControlYawRate呼出しは走行中のPATH系だけだった。開始前の呼出しはコメントアウトされていた。既存処理を呼ぶだけで旋回できるという仮定は成立しない。実機で停止または古いPWMによる旋回が起きるかは未測定。

対処: 自動開始の旋回校正中だけvolatileフラグを立て、patternTrace==0・IMU初期化済み・IMU非校正中に1ms割り込みで角速度PIDを更新する。ライン復帰または5秒タイムアウトでフラグを解除する。全センサーの有効性確認前に開始要求を立てない。既存の手動開始経路は変更しない。

再発防止: モーター制御処理を再利用する前に、PWM生成関数の全呼出し箇所と対象状態・周期をrgで確認する。開始前校正と走行中制御の同時実行がないこと、SD保存がメインループ内であることを確認する。

確認方法: run_autostart_calibration_tests.pyで保存済み校正値あり・なし、無効値、旋回とライン復帰のタイムアウト、停止待ち、手動開始・IMU異常を検証する。既存のrun_line_calibration_tests.ps1とDebug/Releaseビルドも実行する。実機では右ボタン→左旋回→ライン復帰→停止→カウントダウン→1走目、2～5走目の校正省略とlsval.txt保存を確認する。旋回速度・復帰姿勢・割り込み最大時間は未検証のためopen。

PCで開始順序テストと既存の校正値テストが成功し、Debug/Releaseビルドも成功した。割り込みでは開始前校正のフラグとpatternTrace条件により走行中のPATH制御と排他的に角速度PIDを呼ぶ。SD保存と校正値配列の初期化はメインループ側に置き、配列初期化はmodeCalLinesensorsを立てる前に行う。実機検証待ち。

## 実機動画でライン復帰後の停止姿勢が外れた

ユーザーから「ライン復帰から停止までが遅く、開始時にラインを外れる」と報告あり。PXL_20261004_094844136.mp4では旋回後にラインから大きく外れた向きで停止している。修正前コードは-340degまで-1500deg/sを指令し、復帰条件に生AD値lSensor[5]<1000を使っていた。正規化処理とクロスライン検出は高い値を白として扱うため、この条件は現行の白線検出と逆。最初のPCテストも旧条件を模擬しており、この誤りを検出できなかった。機械的な惰性とメインループ待ちの寄与は未測定。

対処: 自動校正だけ-270degから-150deg/sに減速する。中央センサーの正規化値2000以上を白線復帰とし、目標更新・PID・モーター出力・復帰検出と停止を1ms処理にまとめる。メインループは自動旋回中にモーター出力を行わず、復帰検出後に古い旋回PWMを再出力しない。500msは停止出力後の待機時間とする。

再発防止と確認: センサー閾値を再利用する際は生AD・正規化値・白黒の大小を現行取得処理と既存白検出で照合する。PCテストに反対側白線では停止しないこと、黒相当では復帰しないこと、白線検出のISRで停止しメイン処理でも旋回再出力しないことを追加する。実機ではライン上で停止できるかを再確認する。未確認のためopenを維持する。

追加テストと既存校正テスト、Debug/Releaseビルドは成功。校正1ms処理は開始前だけで、走行中PATH制御と排他的。ログ形式・SD保存時点は変更していない。停止命令後の機械的惰性と最終姿勢は実機確認待ち。

## 再確認で白線の端側に停止

PXL_20261004_095513200.mp4とユーザー報告で、旋回後に白線の外側寄りで停止する状況を確認した。前回の「中央2センサーのどちらかが白なら停止」は白線の端も許可する条件であり、中央への位置合わせを保証しなかった。動画のみでは停止後の惰性量や各センサー値は測定できない。

対処: センサー4と5が両方2000以上、かつ正規化値差が400以内のときだけ停止する。回転速度と待機時間は維持する。中央に到達しない場合は既存5秒タイムアウトで自動開始しない。

再発防止: 白線検出と中央位置判定を区別する。テストに左右それぞれ片方だけ白の場合、両方白でも値が不均等の場合は停止しないこと、両方白で値が近い場合は同じ1ms周期で停止することを追加した。PCテストは成功。最終停止姿勢の実機再確認までopenとする。

## コース縁で停止する再発

PXL_20261004_100907346.mp4では開始時の向き付近を通過して旋回を継続し、コース縁方向で停止した。ユーザーもコース縁での停止を報告。各センサー値・角度ログはないため、両中央センサー条件が元の白線では成立せずコース縁で成立したことは仮説だが、明るさだけでは元の白線と縁を識別できないこと、条件を厳しくすると白線を見逃して旋回継続できることはコード上の問題だった。

対処: 明るさで旋回の終了を決める方法を廃止。開始時にゼロ化したジャイロ角度の-360degを目標に、-270deg以降は角度偏差×5[1/s]を±150deg/sに制限した角速度を指令する。±2deg以内では目標角速度0で制動し、実角速度±20deg/s以内が50ms続いたら出力を停止する。行き過ぎは逆方向へ補正する。停止500ms後に中央センサーの白線を確認し、不成立なら再探索せず開始禁止にする。IMU非有限値でも出力を停止し開始しない。初期設置時に白線へ合わせていることが前提。滑りで車軸位置が移動した場合は角度だけでは位置を戻せない。

再発防止: 復帰の基準に初期姿勢を持ち、白線見逃し時に次の明るい領域まで無制限に探さない。テストに任意の明るい領域で早期停止しないこと、角度に応じた減速・行き過ぎの補正・静止確認・停止後の白線不成立による開始禁止・IMU非有限値を追加。PCテストとDebug/Releaseビルドを確認し、実機の元姿勢への復帰・開始可否・惰性・位置移動の確認までopenを維持する。

## 角度だけの復帰で白線の手前に停止

PXL_20261004_102152507.mp4とユーザー報告では白線手前に停止して復帰できなかった。角度・センサーの実測ログはないため、車軸位置の移動、積分角度誤差、制動姿勢の寄与は未確定。角度条件だけで復帰完了にしていたことは事実で、角度を戻せば白線へ戻れるという仮定は実機結果に合わなかった。

対処: -360deg前後30degに探索を限定し、その範囲では最大60deg/sで白線を探す。白検出が1～4個の場合だけ、10センサーの背景除去後の重心を使って中央へ向ける。片側中央センサーだけの白検出でも位置合わせを続け、中央に近い重心・中央白検出・低角速度が50ms連続したら完了する。ラインを見つけられない場合は探索範囲の端で折り返し、5秒タイムアウトで停止する。

再発防止: 元姿勢への角度復帰と実ライン復帰を別々に確認する。PCテストに360degでも黒なら探索継続、範囲端で折返し、広い白領域を除外、左右それぞれ片側の白から中央へ向ける指令を追加。センサー重心の符号は既存motorControlTraceOmegaFBの右側白→正角速度に合わせる。実機で白線復帰とコース縁除外が成立するかは未確認、openを維持する。

追加テスト・既存校正テストとDebug/Releaseビルドが成功。元の向きから±10degずれた仮想白線のセンサーモデルと一次遅れの角速度モデルでも、両方向とも局所収束して停止することを確認した。これは制御方向と状態遷移の検証であり、実機の滑り・センサー配置・光学特性・制動性能を保証するものではない。1ms内の追加処理は10要素の整数積和と位置計算で、SDアクセス・表示・待機は行わない。実機の最大割り込み時間と最終停止姿勢は未測定。

## 左端だけがラインに乗った位置で停止

PXL_20261004_103527313.mp4の停止後表示はCalib NGであり、ユーザーは左端センサーだけがラインに乗った位置での停止を報告した。復帰成功とは確認できない。旧表示はタイムアウトと停止後の校正値・ライン確認失敗を区別できず、動画だけで停止原因を特定できなかった。

コード上では、端で白線を捕捉した後も元の角度の±30deg制限を位置合わせへ適用していた。元の探索範囲の端で端センサーが白線を見つけるケースでは、中央へ向ける回転指令が制限で反転する。これが今回の実機停止原因かは角度・PWM・センサー実測がなく未確定。低角速度指令で静止摩擦に負ける可能性も未測定。

対処: 初期探索は元の角度±30degを維持し、狭い白線候補を捕捉した角度を固定して、その角度±60degで中央への位置合わせを許可する。タイムアウト5秒は維持する。失敗表示をCalib T/O、No line、LS invalidへ分け、タイムアウト時にA=角度、G=角速度、P=角速度PIDの指令、W=白検出数、I=最大値センサー番号を表示する。表示処理はメインループの停止後だけ行う。

再発防止: 探索時の角度制限と白線捕捉後の中央への移動余裕を区別する。PCテストに元範囲端で左端センサーが白線を捉えても中央へ向けて旋回継続することと、捕捉位置基準の±60deg制限を追加する。元の向きから50degずれた仮想白線の収束も検証する。実機の復帰と、失敗時は画面の理由・A/G/P/W/Iを確認するまでopen。

追加テストとDebug/Releaseビルドが成功。±10degと-50degずれの仮想白線へ収束すること、元探索範囲端で左端検出後も旋回継続できることを確認。実機の測定値がないため原因確定・実機での解消確認は未完了。

## 診断値で低速旋回指令中の停止を確認

PXL_20261004_104458892.mp4の画面はCalib T/O、A=-330、G=0、P=-156、W=1、I=0と読めた。タイムアウトであり、左端の白検出と非ゼロの旋回正規化指令が存在するのに角速度0で停止していた。前回の探索範囲拡張だけでは改善しなかった。低速の出力が静止摩擦に負ける仮説を支持するが、左右実DUTY・電流・ギヤ抵抗は未測定。表示Pはこの動画では角速度PIDの正規化指令であり、補償済み実DUTYではない。

対処: 自動校正中だけ、非ゼロの旋回指令で角速度5deg/s未満なら始動補償を有効化し、目標角速度まで立ち上がる間は旋回正規化指令の絶対値250を下限にする。5deg/sを越えた瞬間に切ると再び失速するため、目標への立ち上がりまで維持する。中央合わせで目標0になった時点で即解除し、PIDの制動出力を維持する。既に動いている通常走行のPID・ゲインには変更を加えない。診断表示Pは補償後の旋回正規化指令へ変更した。

再発防止: 低速位置合わせのPCモデルに摩擦・始動できない出力域を含める。テストに±156から±250への補償、始動中の保持、目標角速度到達時の解除、目標0では制動を上書きしないことを追加した。156では始動せず250で始動する仮想摩擦モデルでも、左右±10degずれの白線へ収束することを確認した。250の実機での始動余裕・停止精度は未確認でopenを維持する。

## 中央付近でも固定閾値未満で復帰判定が成立しない

PXL_20261004_105523968.mp4では白線上へ戻った後も復帰せず、停止表示はCalib T/O、A:-360 G:-33、P:-250 W:0 I:5。W:0は正規化値2000以上のセンサーがないこと、I:5は最大反応がセンサー5であることを示す。ピークの実値・全センサー値は記録されておらず、反応低下の物理的原因は未確定。コードは捕捉後も2000以上を毎回要求していたため、この状態では位置合わせから探索へ戻る。

対処: 初回捕捉の2000閾値は維持し、捕捉後は10センサーの最大・最小差500以上と半値を超える連続1～4個の明部で位置を求める。半値以下を重心から除き、弱い中央反応でも静止指令を維持する。停止後の再確認にも同じ判定を使い、追従成功後に固定閾値で開始を拒否しない。タイムアウト画面には中央2個の正規化値Cを追加する。

再発防止・確認: 強い左端反応で捕捉した後、中央1400/1500へ弱まる入力で50ms静止と500ms後の開始を検証する。低コントラスト・広い明部・離れた明部の除外もPCで確認する。制御判定は1ms側、停止後再確認は旋回終了後のメイン側で行い、表示・SD処理を割り込みへ追加しない。実機の明暗差500の妥当性・復帰成功・割り込み処理時間の確認までopenを維持する。

## 中央付近で往復し静止確認が続かない

対象: PXL_20261004_110619118.mp4、自動校正後の中央復帰。動画ではライン付近を往復してタイムアウト。停止表示はC:2142/1392、A:-376 G:24、P:-50 W:1 I:4と読める。今回は中央センサーの反応が2000を超えており、固定閾値未満だけでは説明できない。全10値や制動状態の時系列はなく、厳密な原因は未確定。コードは偏差0.35を外れた周期で停止指令を解除し、静止摩擦補償付きの位置合わせを再開するため、制動中の位置変化で往復が継続する可能性がある。

対処: 偏差0.35以内で制動状態へ移り、偏差0.65以内で白線候補が有効な間は角速度0を維持する。角速度20以内の50ms連続確認を維持し、白線消失・偏差0.65超過・探索角度逸脱では制動状態を解除する。停止後の位置確認も0.65を使う。端センサーだけの反応では偏差4.5となり、完了にはならない。表示P行をS=0探索/1捕捉後追従/2制動、X=位置偏差(99は候補なし)へ変更する。

再発防止: 中央2142/1392で制動を開始し、惰性中に中央片側のみへ移って角速度24が続く入力をPCテストへ追加する。制動・補償解除を維持し、角速度0が50ms続いてから完了すること、停止後の開始許可、範囲逸脱と白線消失で再探索することを確認した。開始テストはメイン側の状態4→5→6を順に通す必要があるため、初回の呼び出し不足によるテスト失敗を修正した。PCテスト・既存ライン校正テスト・Debug/Releaseビルド成功。1ms内にブロッキング処理や表示・SD処理を追加していない。

ステータス: open。実機の制動後位置・静止・復帰成功と割り込み時間は未検証。前回までのPCモデルだけでは実機の往復を検出できなかったため、成功とみなさず実機確認を継続する。

## 実機調整後のパラメータ削減

ユーザー報告: 目標速度を上げることで静止摩擦を超えたケースがある。現在のsetup.hは校正-800、復帰-300、位置ゲイン70、失速閾値150、復帰角速度上限250へ調整済み。これらを以前の値へ戻さず、独立調整項目を18から9へ削減した。

対処: PWM下限と失速閾値の補償を削除し、位置合わせの角速度下限と探索速度は復帰速度の半分(150)から算出する。角度ゲイン5と位置ゲイン約66.7を速度と探索幅・センサー数から算出し、捕捉後角度範囲は探索幅の2倍、制動解除偏差は1-中央許容偏差とする。一回転と3/4回転は手順として固定する。復帰角速度上限250は維持し、静止を保証しないことを定義コメントとAGENTSへ明記した。

再発防止・確認: PCテストはCALIBRATIONSPEEDも実ヘッダから読み、速度上限から算出した下限でPWM180の仮想摩擦域を超えることと、中央では0指令に戻ることを左右で確認する。角速度判定テストは設定上限より大きい値を使い、設定変更で高角速度テストが無効になるのを防ぐ。既存の弱い白線、制動の保持、ロスト、角度制限、開始許可・禁止を確認する。実機の150 deg/s下限で始動できる範囲・往復と停止位置は未検証のためopenを維持する。

## 2026-10-04 実機確認結果

ユーザーによる実機確認: 現在の9項目のパラメータで始動・停止に問題なし(PXL_20261004_120453547.mp4を添付した報告)。続いて、オートスタートで校正後に1走目へ進み、2～5走目は再校正せず連続走行できたとの報告あり。開始前校正、ライン復帰・停止、1走目への遷移、連続走行中の校正省略について、報告された実機試行で期待する動作を確認した。現在のパラメータとコードを維持する。

確認範囲: Codexによる実機操作・新規ビルド・計測は行っていない。今回の報告でSD上のlsval.txt保存内容、割り込み最大処理時間、繰り返し試行回数までは確認できていない。これらの未確認事項を残すため記録全体のstatusはopenとし、上記の機能確認済み項目と区別する。過去の各節にある「実機未確認」はその時点の履歴であり、本節が最新結果となる。

## 3/4回転で校正を固定し既存ラインPIDで復帰する変更

ユーザーの追加方針: 3/4回転で校正終了、元姿勢へ戻る途中で中央左センサーが白線を捉えたら校正値を使用するライン追従へ切り替える。従来方式の始動・停止・5走連続はユーザー確認済みだが、今回の方式は別途実機確認が必要。

実装: -270 degでfinishLineSensorCalibrationを1回呼び、無効なら停止する。元姿勢±30 degでセンサー4が2000以上かつ細い白線として有効なとき、motorControlTraceの既存ラインPIDへ切り替える。平均速度0を維持し、ラインPIDの左右差出力で向きを合わせる。中央では角速度0のPIDで制動する。専用重心位置ゲイン・角速度下限による追従を削除した。重心判定は白線候補と停止の確認だけに使用する。

割り込み競合への対策: TIM6は優先度0、ADC1のDMA2_Stream0は優先度2。TIM6で校正終了する際にADC側の極値更新を途中で中断し、終了後に極値を書き換える競合を避けるため、10センサーの極値更新のみ短い割り込み禁止区間とした。元のPRIMASKを復元し、正規化計算は区間外とする。校正モードはvolatileで共有する。SD・画面更新は追加していない。

確認・再発防止: 実際のmotorControlTrace関数を抽出してPCテストへ組み込み、中央左での切り替え、左端と中央右だけでは切り替えないこと、PIDの左右修正符号、角速度PIDとの排他、校正値無効・白線ロスト・角度逸脱での停止、弱い中央反応での制動、手動開始経路を確認する。既存ライン校正テストへ校正終了後の極値固定と正規化値更新を追加し成功。実機では3/4回転で全センサーの有効範囲が得られること、通常ラインPIDで始動・中央復帰・停止できること、2～5走目の校正省略を再確認する。ステータスopen。

## ラインPID復帰方式で停止したがタイムアウトとの報告

ユーザー報告: PXL_20261004_130534459.mp4の試行で停止後タイムアウトした。指定されたCrossDevice配下の動画はffprobe/ffmpegでNo such file or directoryとなり、動画と停止表示は確認できなかった。同名ファイルを別のPixel 10のCamera、デスクトップ、ダウンロードでも確認したが見つからない。同期・接続状態は未確定。

調査状況: 現行コードでは、校正無効、捕捉後の白線候補消失・角度逸脱、ラインPID出力不足による中央未到達を区別する必要がある。ユーザーへタイムアウト画面のC/A/G/P/S/Xの値を問い合わせた。今回の実機原因は未確定のため、速度や閾値、ラインPIDを推測で変更していない。

再発防止: CrossDeviceの参照動画は存在とffprobeの成否を確認してから画像抽出を行い、失敗した場合は生成画像を開かない。動画取得不能時は停止画面の診断値を読み取ってもらい、S=探索/追従/制動、X=位置候補、P=旋回出力に基づいて修正対象を決める。ステータスopen。

## 診断値とライン追従ゲイン調整による復帰成功

ユーザーの診断値: C=3473/304、A=-354、G=2、P=-105、S=1、X=-0.(小数部の続きは未取得)。S=1なのでライン追従へ移行済み、非ゼロ指令-105に対して角速度2でほぼ停止していた。静止摩擦を越えられない出力不足を示唆する。その後ユーザーがライン追従ゲインを変更し、ライン復帰したとの報告あり。変更したゲイン値自体は未取得で、記録へ推測値は載せない。

対処: 既存ラインPIDを直接使う方式とユーザーが調整したゲインを維持する。Codexが試作したラインPID指令から角速度指令への変換・角速度下限の追加は採用せず、今回の追加部分のみ取り消した。3/4回転で校正値固定、中央左検出で追従、中央で制動、既存の停止後判定・タイムアウトは維持する。

再発防止: 平均前進速度0で既存ラインPIDを使う場合、通常走行のゲインで同じ始動余裕があるとは仮定しない。停止した場合はPとGを確認してゲインの出力不足を切り分ける。ユーザー調整で解消した場合は追加補償を重ねない。PCテストには実際のラインPIDに加えて角速度PIDも組み込み、追従中はラインPIDのみ、制動中は角速度PIDのみを使う排他を確認する。実機の復帰成功はユーザー報告で確認済み。調整後のゲイン値・繰り返し再現性・新方式での5走連続確認は未取得のため記録全体はopenを維持する。

## 12987のコースアウトと校正値の確認

ユーザーが12987とデスクトップのlsval.txtを指定。20項目は全て範囲内、最大最小差1983～2929で全10センサー有効。直進区間の中央反応も同方式の完走12971・12976と概ね同等。明確な校正異常は見つからず、SD設定は変更しなかった。12987は1234行で期待行数と一致、cntlog単調・値有限。emcStop=5、6028 mm付近から中央反応消失、右端へ白線が移っている。

調査: 同じ距離帯5900～6020 mmで実角速度中央値が完走619～633に対し494 deg/s、左右輪速度差も小さい。旋回不足の挙動は確認できるが原因は未確定。復帰用lineTraceCtrlの変更と、通常走行用lineTraceOmegaFBCtrl(5/0/12で共通)を区別する。電圧差もあり、校正やゲイン単独の因果を断定しない。

再発防止・確認: 正規化値だけで校正の極値を確定せず、lsvalと生AD確認を併用する。今回のlsvalは現時点のSDコピーで、ログに極値がないため走行時の同一性は未検証。結果はanalysis/line_calibration_12987/report.mdに保存。次は校正値を維持して走行側応答を切り分ける。実機原因未確定のためopen。

## lineSensor.cの変更を一旦取り消し

ユーザーの明示指示により、3/4回転校正へ切り替えた際に追加したlineSensor.cのvolatile指定、極値更新の割り込み禁止区間、更新と正規化の処理分離を変更前へ戻した。対応するlineSensor.hの宣言も戻した。校正終了関数、3/4回転での校正終了、既存ラインPIDによる復帰、調整済みゲインは維持する。今回のコースアウトと割り込み対策の因果は未確定であり、取り消しで改善したとはまだ扱わない。実機で同条件の走行結果を比較するまでopen。
