Kageyana/robotrace_v2/doc/失敗事例/2026-10-04-no-sd-line-calibration-start-block.md

---
type: codex-failure
date: 2026-10-04
task: "SDなしでの手動走行可否の確認"
status: resolved
severity: medium
tags:
  - codex/failure
---

# SDなし起動では校正有効フラグが更新されず手動開始を禁止する

## 要約

SD未挿入でも走行可能という方針と、修正前コードの校正判定に不整合があった。修正後はPC検証・ビルド確認に加え、ユーザーから実機書き込み・動作確認完了の報告を受けた。

## 発生した状況

- 対象: SDなしで起動後の手動走行（autoStartを除く）。
- 調査: control.c、setup.c、lineSensor.cの初期化・校正・開始判定を確認。

## 結果・原因

- lineSensorCalibrationValidは起動時false。
- 更新箇所はreadLinesenval()とwriteLinesenval()のみ。
- SDなしでは初期化中のreadLinesenval()を呼ばない。
- 手動校正メニューのwriteLinesenval()もinitMSD条件により呼ばない。
- 開始画面の自動旋回校正は測定値を更新するが、有効フラグを更新しない。
- control.cのgetRunStartBlockReason()が無効フラグによりLS calibを返す。

## 対処・次の調査

ユーザーの修正依頼により、finishLineSensorCalibration()を追加した。SD処理なしで校正を終了し、全センサーのRAM内校正値を検証する。手動校正メニュー、表示あり・表示なしの開始時旋回校正の3箇所で呼ぶ。校正操作なしでのSD設定読込・破損判定は変更しない。

## 再発防止・確認方法

SD有無と保存成否から独立してRAM内の校正値の有効性を検証する。SDなし起動→校正→手動開始、無効な校正値→開始禁止、SDあり正常値、破損lsval.txtの開始禁止を検証する。ビルドと実機での表示・開始動作確認が完了するまでopen。

## 修正後の確認

run_line_calibration_tests.ps1で、未校正は無効、有効な10センサー値は有効、1センサーでも同値または範囲外なら無効、再校正で有効へ復帰することを確認した。校正終了処理がSD関数を呼ぶと即失敗するモックでSD依存がないことも確認。Debug/Releaseビルド成功。周期割り込みの処理追加はなく、校正終了のメインループで10要素を検証する。

2026-10-04: ユーザーから「実機書き込みして動作確認しました」と報告あり。今回のUI校正後の走行開始修正について実機確認完了としてresolvedへ更新した。各校正経路・異常条件の個別実機試験結果は報告されていないため、全条件の実機検証済みとは扱わない。
