Kageyana/robotrace_v2/doc/失敗事例/2026-10-03-log-time-u16-wrap-distance-validation.md

---
status: open
---

# 65.536秒超のログ時刻折り返しで距離検証が失敗

対象: BMI088初期化修正後12895～12897の走行確認。

確認結果: 3本とも正常終了・期待行数一致だがcntlogが1回折り返し、distanceScaleVerified=0、closureReason=10。終了時刻は補正後65.671～68.030秒。

原因: log_schema.hはcntRun(uint32_t)をU16に変換して記録。SDcard.c endLog()はuint16_tのtimeとbeforeTimeの減算を符号付きintへ昇格したままcorrectedPulseTotalへ積算し、折り返しで負の時間差となる。CSVから計算した誤差1636020/1503990/1502976 pulseがメタデータと完全一致。

対処: 今回は解析に限り65536 msを明示加算した。補正後の距離検証誤差は−2380/−3338/−4352 pulseで現行許容内。XYは累積距離と保存方位から独立に評価。生ログ・ファームウェアを変更していない。

次の修正・再発防止: cntlogを32bitで保存し、保存サイズ・全読取側・CSV・AGENTS/Skillを一緒に更新するか、全時刻利用箇所で明示的な折り返し対応を行う。65.535→0 msを跨ぐ記録について時間差正値、距離検証、CSV、既存ビューワ互換をテストする。固定時間ギャップ閾値でなく距離基準の欠落検証を使う。

確認: analysis/script/check_imu_init_runs_12895_12897.py、analysis/imu_init_runs_12895_12897/report.md。解析補正は検証済みだが実機ログの修正未実施のためopen。

## ユーザー方針と後続ログ

ユーザーは時刻処理の修正不要と指定。ファームウェアは変更せず、解析側で折り返しを補正する。12898～12900は43.440～43.601秒で終了し折り返しなし、距離検証成功。未修正の原因は残るためopenを維持する。
