Kageyana/robotrace_v2/doc/失敗事例/2026-08-11-index-local-tuning-overfit.md

---
type: codex-failure
date: 2026-08-11
task: "横スリップと角速度目標の局所調整"
status: resolved
severity: medium
tags:
  - codex/failure
  - robotrace/tuning
  - control
---

# 特定optimalIndexへの局所対策が指標の両立に失敗した

## 要約

idx10/11/23/24 を対象に、横スリップを減らすための局所速度cap、局所角速度cap、局所角速度scale、保持ヒステリシスを順番に比較した。しかし横スリップが下がる候補でもlap、直線指標、PWM、完走安定性が悪化し、採用できなかった。

## 発生状況

- 局所速度cap 0.85、保持2走、保持1走を比較した。
- 局所ライン角速度cap 1200 deg/s、局所scale 0.90 も比較した。
- 横スリップ率だけは一部改善したが、走行全体の指標を満たさなかった。

## 原因または仮説

特定indexだけ目標を下げると、前後区間との速度・角速度連続性が崩れ、別区間のライン負荷やlapへ副作用が伝播した可能性がある。個別区間の実残差を全体制御の原因とみなした点にも不確実性が残った。

## 解決

局所対応を無効化し、今後はラインセンサー目標生成やカーブ全体に効く連続的な制御式・パラメータを優先する方針へ変更した。

## 再発防止

index限定の変更は最後の手段とし、先に非局所のセンサー正規化、曲率ベース制御、全体ゲイン、速度プロファイル生成を比較する。局所案を試す場合も、対象区間だけでなく前後区間、lap、完走率を採用条件に含める。

## 関連

- AGENTS.md: D:/robotrace/robotrace_v2/AGENTS.md
