Kageyana/robotrace_v2/doc/失敗事例/2026-08-11-skill-validator-missing-pyyaml.md

---
type: codex-failure
date: 2026-08-11
task: "ObsidianとCodexの失敗記録スキルを作成・検証する"
status: resolved
severity: low
tags:
  - codex/failure
  - python/dependency
  - validation
---

# スキル検証時にPyYAMLが未導入で標準バリデーターを実行できない

## 要約

`quick_validate.py` による個人用スキルの検証は、Python環境に `PyYAML` がないため失敗した。追加パッケージを導入せず、必要な構造とYAMLの基本形式を手動で確認した。

## 発生した状況

- タスク: Codexの個人用スキル `record-failures` の作成と検証
- 実行環境: Windows / Python
- 前提条件: `skill-creator` 付属の `quick_validate.py` を実行

## 何を試したか

1. `python quick_validate.py C:\\Users\\Natsuki\\.codex\\skills\\record-failures` を実行した。

## 結果・エラー

```
ModuleNotFoundError: No module named 'yaml'
```

## 原因

Python環境に、バリデーターが読み込む `PyYAML` パッケージが導入されていない。

## 解決・回避策

スキルは小規模で、YAMLフロントマター・必須ファイル・参照先を目視で確認できるため、今回は追加インストールを行わず手動確認した。

## 今後の予防策

スキル作成を頻繁に行う場合は、専用のPython環境に `PyYAML` を導入して標準バリデーターを使う。

## 関連

- 関連ノート: [[README]]
- 参考リンク:
