Kageyana/robotrace_v2/analysis/calibration_12857_12862/health.csv

log | group | rows | max_gap_ms | target_mps | actual_mean_mps | battery_V | buildDate | buildTime | gyro_offset_dps | temp_start_C | temp_mean_C | temp_cal_end_C | temp_run_end_C | cal_samples | cal_errors | temp_samples | temp_errors | courseMarker_cross | independent_cross | slip_rows | slip_lat_rows | sha256
12854 | CW_before | 5554 | 11.0 | 0.49983626053534186 | 0.5397797244628991 | 7.79 | Oct 3 2026 | 14:26:17 | 0.043 | 29.000 | 29.138 | 29.250 | 33.500 | 100 | 0 | 20 | 0 | 3 | 6 | 0 | 0 | f491aeb0163650f720c3b66be2974b7612c2d6774e98ef6a3b9182f041e442ec
12855 | CW_before | 5545 | 11.0 | 0.49983626053534186 | 0.541244781193641 | 7.76 | Oct 3 2026 | 14:26:17 | 0.020 | 34.375 | 34.469 | 34.500 | 35.000 | 100 | 0 | 20 | 0 | 5 | 6 | 0 | 0 | f39dcf920df4dbb2ac55d264d2610a64bcc0b6a7e903b3731186d4e7ae1376b7
12856 | CW_before | 5555 | 11.0 | 0.49983626053534186 | 0.5405085537115085 | 7.73 | Oct 3 2026 | 14:26:17 | 0.043 | 35.625 | 35.625 | 35.625 | 35.750 | 100 | 0 | 20 | 0 | 4 | 6 | 0 | 0 | 943470c7ddffe12cd25906db82fcdd9c84f721d57f1d1bd676a035e00c494334
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
