Kageyana/robotrace_v2/analysis/calibration_12857_12862/lap_intervals.csv

log | group | method | interval | delta_X_mm | delta_Y_mm | heading_error_deg | lap_time_s | lap_distance_mm
12854 | CW_before | logged | 1 | 10.07433223940427 | -1.813577496914661 | -0.5454073822779151 | 8.710500791066984 | 4697.7144184861345
12854 | CW_before | logged | 2 | 7.953661871433155 | 0.24243021085868577 | -0.27879570575402113 | 8.713172443039157 | 4700.074308863611
12854 | CW_before | logged | 3 | 6.608079898442725 | -2.256454049994659 | 0.19554374586329004 | 8.721977383414066 | 4700.949911815849
12854 | CW_before | logged | 4 | 9.79923862512203 | -9.828883071360849 | 0.6545935247005445 | 8.692530528874638 | 4696.338349510446
12854 | CW_before | logged | 5 | 19.833435203509453 | -5.746635377922132 | 0.07459674330232247 | 8.673601502540594 | 4691.675779673351
12854 | CW_before | right | 1 | 10.609423043679726 | 2.8611216456864668 | -0.5454073822779151 | 8.710500791066984 | 4697.7144184861345
12854 | CW_before | right | 2 | 7.144122241713717 | 1.7921987913697421 | -0.27879570575402113 | 8.713172443039157 | 4700.074308863611
12854 | CW_before | right | 3 | 3.6239906153284664 | -3.955044546004615 | 0.19554374586329004 | 8.721977383414066 | 4700.949911815849
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
