Kageyana/robotrace_v2/analysis/calibration_12857_12862/onsets.csv

group | threshold_mm | onset_pct | end_shape_mm | max_shape_mm
CW_before | 2 | 22.900000000000002 | 7.20102054939647 | 7.20102054939647
CW_before | 5 | 72.1 | 7.20102054939647 | 7.20102054939647
CCW_before | 2 | 36.7 | 8.120444225640714 | 13.93569783281618
CCW_before | 5 | 49.7 | 8.120444225640714 | 13.93569783281618
CW_after | 2 | 37.6 | 8.066290248657003 | 8.066290248657003
CW_after | 5 | 72.39999999999999 | 8.066290248657003 | 8.066290248657003
CCW_after | 2 | 28.999999999999996 | 7.543765155017035 | 10.205326424470371
CCW_after | 5 | 53.6 | 7.543765155017035 | 10.205326424470371
