Kageyana/robotrace_v2/analysis/calibration_12857_12862/per_log.csv

log | group | method | mean_X_mm | mean_Y_mm | mean_heading_error_deg
12854 | CW_before | logged | 10.853749567582327 | -3.880623957066723 | 0.02010618516684417
12855 | CW_before | logged | 10.828832197770794 | -5.844293498490936 | 0.5312896142570708
12856 | CW_before | logged | 10.848246317925032 | -0.502503729416037 | -0.11051594109492272
12854 | CW_before | right | 9.669584982292736 | -3.0532852158652872 | 0.02010618516684417
12855 | CW_before | right | 11.480229310458549 | -4.753556233674976 | 0.5312896142570708
12856 | CW_before | right | 9.650479974222367 | -0.24168407806223513 | -0.11051594109492272
12854 | CW_before | trapezoid | 8.676521319309973 | -3.440703779745604 | 0.08772504979057202
12855 | CW_before | trapezoid | 10.842418617151134 | -5.205936332238184 | 0.5518213374285438
12856 | CW_before | trapezoid | 8.176035735778418 | -0.7199897925343294 | 0.013032204507749157
12850 | CCW_before | logged | 21.393030959336603 | 0.9558015942412978 | 1.012087497155744
12851 | CCW_before | logged | 17.9007873165177 | 3.1338912309940055 | 0.9727792999533336
12852 | CCW_before | logged | 18.793667996836824 | -2.187357953431517 | -0.036827223962325205
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
