Kageyana/robotrace_v2/doc/line-sensor-adc-freeze-fix.md

# ADC変更後のラインセンサー更新停止と修正

2026-10-13、`codex/line-sensor-adc-phase`。13187/13188で追従しなかったとのユーザー報告を調査し、平均化処理の更新停止不備を修正した。修正版Debugは接続されたSTM32F446へ書込み・Verify済み。実走行はユーザーが行い、Codexから走行・空転は行っていない。

## ログで確認したこと

| ログ | 方式 | 行数/期待行数 | センサーベクトル種類 | 末尾の値固定時間 | emcStop |
|---|---|---:|---:|---:|---:|
| 13172 | 一次 | 4684/4684 | 4684 | 0ms | 0 |
| 13185 | 一次 | 193/193 | 188 | 0ms | 3 |
| 13186 | 一次 | 196/196 | 192 | 0ms | 3 |
| **13187** | 一次 | **194/194** | **1** | **954ms** | 3 |
| **13188** | 一次 | **132/132** | **1** | **649ms** | 3 |

13187/13188はユーザー確認済み対象で、Oct 13 2026 22:31:29のADC変更版。全10chが先頭5msから最終959ms/654msまで固定だった。校正有効、IMU校正成功、43列・全数値有限・期待行数一致・時刻単調を確認した。CSVは距離基準の疎な記録で、最大行間隔10ms/9msであり、全1ms時系列を復元できるログではない。ADCスキップ/更新診断は通常CSVに未記録。

比較ログも列名で解決し、13172の72列と新43列を混同していない。13185/13186も失敗しているため、「以前は完走していた」とは扱わない。13172との電圧・ゲイン・校正条件は異なり、性能やラップタイムの優劣を比較しない。今回の直接所見は、ADC変更後の2本だけ全センサーが完全固定していることである。emcStop=3はエンコーダ停止であり、停止理由そのものから取得停止原因を断定しない。

センサーと制御応答

推定XY、速度追従、角速度、モーター電圧指令、スリップフラグも解析保存した。失敗走行を完走率・ラップタイム改善の根拠には使用しない。

## 走行後RAMの回収

ユーザーは一度電源を切った後、再走行してST-Linkへ接続した。この新しい走行後状態（logFileNumber=13189）を、リセット・書込み前に回収した。13187/13188そのもののRAMとは区別する。

- 走行終了・PWM/左右比較値0、emcStop=3。
- ADC開始エラー0、転送エラー0、異常ラッチfalse、HAL/DMA正常状態。
- スキップ1628、有効更新3507、最大更新停止691ms、更新停止診断5回。
- 既にセンサー電源OFFのため、現在ageは0。これを「走行中も正常」とは解釈しない。
- 全RAM128KiBと取得コマンド・結果を保存してから再現試験へ進んだ。

## 不備と修正

初回実装では、取得を1回スキップするたびに積算・準備済み平均を全破棄していた。このため、4取得に1回欠測する条件が毎1ms繰り返されると、各位相2サンプルが一度も揃わず、HALエラーなしでも公開配列が固定されたままになる。

実ソースを使うPCテストへ周期的欠測を追加すると100周期で更新0として失敗した。モーターを停止した実機でも同じ不備を再現できた。走行中に欠測が発生する詳細な位相・割込み時間は未測定だが、周期的欠測で平均化が停止する不備はPC/実機で確認した。

修正は以下に限定した。

- `Core/Src/lineSensor.c`: 欠測では**未完成のON/OFFペアだけ**を捨て、完成済みペアを保持する。2組の完成ペアの各位相平均から差分を計算する。
- `Core/Inc/lineSensor.h`: 完成ペアの有効期限`LS_AVERAGE_MAX_PAIR_AGE_MS=3`を追加。HAL tickで期限を確認し、期限切れや電源切替の前のペアを混ぜない。
- 後続の要求がスキップされても、既に取得済みの完成フレームは公開できる。電源世代は公開前に再確認する。
- `validation/line_sensor_adc/check.c`: 単一スロット欠測4位置・隣接2スロット欠測4位置の継続、片位相完全欠測、期限切れを追加。

欠測なしは従来どおり4取得で1公開、1ms周期。周期的欠測で1msあたり1ペアしか取得できない場合は、2ペアを使うため約2ms公開となる。各位相2サンプル、OFF平均−ON平均、整数丸め、正規化、PID式・ゲイン、ADCサンプリング、PWM/120us待ち、割込み優先度、SD設定、通常/バイナリログ形式、既存停止条件は変更していない。

積算計算・差分・正規化は割込み禁止の外で行う。完成ペアの80 B状態確定と、公開配列40 Bの転送だけを短いPRIMASK区間で扱い、元値を復元する。TIM3は作業配列を直接リセットしない。

## 検証結果

PC: `python validation/line_sensor_adc/run.py`、C11、O0/O2、Wall/Wextra/Werrorで成功。

- 要求10ケース、電源重複ON・完了中競合・期限切れ・公開配列保護を維持。
- 周期的欠測8パターンを各100周期継続して有効更新が続く。
- ONまたはOFFが完全に欠落する場合は偽の差分を作らず、更新停止診断を維持。
- 欠測なし4000取得/1000フレームのraw・正規化と通常ラインPID出力は元実装と一致。

Debug/Releaseビルド成功。DebugはRAM88056 B/FLASH269804 B、ReleaseはRAM87776 B/FLASH176572 B。追加処理に新規警告なし。既存の未使用変数・getAngleSensorの未初期化index等の警告は残る。

実機ではGDB停止時だけTIM3/TIM6/TIM7を凍結し、取得開始関数で4回に1回のHALロック競合を100要求継続した。

| 条件 | 有効更新増分 | スキップ増分 | 最大更新間隔 | PWM |
|---|---:|---:|---:|---|
| 修正前 | **0** | 30 | 691ms（走行後からの累積） | 左右0 |
| 修正後 | **12** | 25 | **2ms**（試験開始時リセット） | 左右0 |

計画した欠測は両方25回で、修正前の追加スキップにはGDB操作・位相再同期の影響を含む。最大値の元集計区間は異なるため、691ms→2msを同一条件の性能倍率として比較しない。重要な結果は、周期的欠測が継続しても修正後は公開が続いたこと。

通常の静止連続実行（SD初期化済み・保存校正値あり・走行分岐外）では、116621制御msで116620回更新、平均1.000009ms、最大1ms、スキップ増分0、ADC開始/転送エラー0、異常ラッチなしを確認した。開始直後の端数1更新を含む。1ms監視による値であり、物理ADC波形の直接計測ではない。

書込みはDownload verified successfully/Start operation achieved successfullyを回収した。Debug ELF SHA256:

`d2a681026b763b38363c7078f2d42f673fde157521fde5ca02c83471eefcf5cf`

終了時は電源OFF、占有/異常ラッチfalse、HALロック解除、左右PWM/比較値0、凍結設定0、開始要求0、通常待機に復元。Faultレジスタ0を確認し、GDBと今回のサーバーを終了してST-Linkを解放した。

## 次の実走行で確認すること

修正版の実走行で追従が回復したかは未確認。新ログで全10chに変化があり、長時間固定せず、ライン偏差・角速度指令が動くことをまず確認する。直前版13185/13186にも別の失敗があるため、今回の更新停止修正だけで全ての追従問題が解決したとは断定しない。採用判断は同条件で最低10本の再現性比較を行う。

今回、速度・ゲイン・緊急停止条件は変更していない。新しい強制停止も有効化していない。

解析スクリプトは`analysis/script/analyze_line_sensor_freeze_13187_13188.py`、原本ハッシュ・表・グラフ・RAM・再現コマンド・実機結果は`analysis/line_sensor_freeze_13187_13188/`。解析前後で原本ハッシュ一致。失敗記録は[周期的欠測による平均化停止](失敗事例/2026-10-13-line-sensor-periodic-skip-starvation.md)。

## 2026-10-14 実走行結果の追記

修正版13191～13194で全期間固定が解消し、ユーザーもライン追従の再開を確認した。カーブでの旋回不足は継続したため、走行用PIDのSD設定を2/0/0から完走参考5/0/12へ変更する別試行を行った。ADC更新周期と走行安定性の採用確認は別に扱う。最新の解析と変更条件は[旋回不足の調査](line-sensor-curve-understeer-13191-13194.md)に記載。
