Kageyana/robotrace_v2/.agents/skills/robotrace-flash-debug/references/failure-prevention.md

# ビルド・デバッグの追加再発防止

## 2026-10-29：新しい検証フェーズの入力を確定する前

過去の補助ファイル名を推測して開かず、実在するbuild/<既存フェーズ>へrg --filesを実行し、check.cのincludeとmanifestのsource_snapshotから依存を確定する。新しいprepare器は全入力のis_file/SHAを最初に検査し、旧ソースを別領域へ保全してから編集する。パッチは直前に読んだ完全な行か一意なASCIIコード行を使い、未読の見出しを追加のアンカーにしない。失敗した複数ファイルパッチの後は実ファイルを読み戻して適用状況を確認し、未完の生成物で後段を動かさない。今回の入口はanalysis/script/prepare_path_unmatched_speed.py。詳細は[補助ファイル名の再発](../../../../doc/失敗事例/2026-10-28-derived-analysis-helper-dependency.md)。

## 2026-10-29：段階別検証と実機像の不一致を扱う前

後続のホスト試験を起動する前に、過去manifestが参照するJSON・実行ファイル・生成フィクスチャを含む全artifactを列挙し、段階別保存先とSHAを確定する。今回の実行はリポジトリルート・必要権限でbuild/heading-fusion-validation/host.py。path_fusionはROBOTRACE_PATH_FUSION_OUT、log_storageは--outputで別出力へ送り、過去の汎用出力を上書きしない。参照先を移す場合は変更前manifestと同一SHAの原本を残し、後続版の結果を旧版の試験として扱わない。[可変成果物の10/29節](../../../../doc/失敗事例/2026-10-27-mutable-elf-provenance.md)を参照する。

想定ELFと実Flashが不一致なら、リセットなしの生RAM/Flashを保存し、型付きデコードと書込みを止める。サイズ・ビルド時刻から配置を推定しない。保存ソースから再構築する場合も、別フォルダで行いプログラム領域の全バイト一致後にだけDWARFを使用する。計測ONの234項目を計測OFFの像へ流用しない。今回のidentify.pyは一致像・保存ソースSHA・14項目の配置自己試験・新しい実Flash一致・停止/出力0を順に確認する。USB復旧後も同じ停止/像確認を経てからflashへ進む。

融合単独試験の前に、実呼出元のenable条件とPredict/Correctの実行条件を照合する。alpha=0では予測しない契約を、常時予測する試験へ変えない。保持契約と有効な連続予測の数値安定性は別試験にする。確認はリポジトリルート・必要権限のvalidation/path_heading_fusion/run.pyで25設定×O0/O2、実出力gainからの独立Joseph形とPSDを含める。[フィクスチャ契約の10/29節](../../../../doc/失敗事例/2026-10-13-adc-host-fixture-contract.md)参照。

## ホスト再生の旧新比較前（2026-10-28）

2026-10-29追記: 同じO2でもx87の拡張評価とfloat保存の丸めが異なるため、再帰モデルの全行バイト比較前に__FLT_EVAL_METHOD__と保存精度条件を確認する。今回の標準入口build/path-yaw-ff-validation/model.pyは候補/正式Cの双方を-fexcess-precision=standard -ffloat-storeでコンパイルし、8モデルの全バイト一致を検証する。片側だけへ適用せず、差を許容誤差で隠さない。ARMのビルドフラグへ機械的に追加しない。[同精度比較の10/29節](../../../../doc/失敗事例/2026-10-12-host-float-snapshot-comparison.md)参照。

旧新を厳密比較する前に、コンパイラ・最適化・ホストフィクスチャを揃える。O2をO0の履歴CSVへ直接比較しない。保存済み旧Core全体と現行Coreを同じ条件でビルドし、差が意図した終端窓の外へ出たら、許容差を広げず比較条件とソースを調べる。今回の確認はvalidation/path_white_extension/run.py。新しい標準識別子（NULL等）は使用元のstddef.h等を実Cへ直接includeし、HALに依存しない単独O0/O2/Wall/Wextra/Werrorを先に通す。[比較条件の記録](../../../../doc/失敗事例/2026-10-12-host-float-snapshot-comparison.md)、[ヘッダ依存](../../../../doc/失敗事例/2026-10-28-derived-analysis-helper-dependency.md)参照。

## ビルド成果物の証跡を確定する前（2026-10-27）

通常build/Debug等のELFは可変パスで、過去のハッシュを後続ビルド後の同じパスへ要求しない。ビルド完了直後に今回の証跡フォルダへ構成名とSHAを含む名前でコピーし、コピーのSHA一致を確認してから成果物として記録する。過去の検証JSONは保持し、現在像の不一致をFlash異常と判断しない。ビルド時刻一致・ソース一致と実機Flash全バイト一致を分ける。[可変ELFの事例](../../../../doc/失敗事例/2026-10-27-mutable-elf-provenance.md)。

## 停止制御保持の変更前確認（2026-10-27）

停止後の時間を変更するときは、速度0検出→速度目標0のPID出力を保持→モーター出力0→ログ保存/次走準備の順序を実コードで確認する。出力保持をHAL_Delayへ置換しない。保持中にPID値を変化させ、実停止経路から出力APIへ反映されることを検査する。2秒の境界、タイマー周回、通常/緊急停止、再走行リセットをリポジトリルート・必要権限の`python validation/stop_motor_hold/run.py`でO0/O2検証し、1ms内のブロッキング追加なしを確認してからビルドする。実機の制動・微振動の検証とは分ける。[停止保持と単純待機の取り違え](../../../../doc/失敗事例/2026-10-27-stop-hold-output-vs-delay.md)参照。

## PC変換フィクスチャ名の事前確認（2026-10-25）

PC変換器へ渡すbinは初回からASCII連番名とヘッダ番号の一致を確認する。検証ケース名は親ディレクトリへ付け、例は`profile1/path-diagnostics/1.bin`とする。生成前に親フォルダを作り、古いCSVを除いてから変換する。必要権限・リポジトリルートで`python validation/log_storage/run.py --converter C:/tool/AutoCopyCsvFromSd/RlogToCsv.exe`を実行し、両構成の全6値まで照合する。[番号照合の失敗記録](../../../../doc/失敗事例/2026-10-25-pc-converter-fixture-filename.md)参照。

## 成果物・PC検証

- 新しいビルド集計スクリプトを作るときも、警告比較前に現在のCore/Srcコンパイル単位が比較元のログで被覆されることをassertする。直前増分だけを基準にせず、変更前の全体ログと必要な増分を併用する。今回のコマンドは`python build/path-1ms-validation/finalize.py`、実行はリポジトリルート。未被覆なら新規警告の判定前に停止する。[増分基準の再発](../../../../doc/失敗事例/2026-10-16-self-describing-header-test-contract.md)参照。

- 白線を使う単独ハーネスは初回から校正有効・クロスライン外・連続明部を明示し、実pathSenseLineの成功を状態遷移の前に確認する。中央素子の重心を0mmと仮定せず、実観測のlateral/forwardから期待値を求める。必要権限・リポジトリルートの`python validation/log_storage/run.py --converter C:/tool/AutoCopyCsvFromSd/RlogToCsv.exe`で1msの待ち時間・補正換算と保存を両構成で検証する。[白線入力前提の事例](../../../../doc/失敗事例/2026-10-24-cleanup-host-fixture-contract.md)参照。

- 公開ヘッダだけを読む単独ホスト試験でも、初回コンパイル前にFatFs→Windows→CMSISの推移依存を確認する。ファイルAPIが不要な行検証は、実ヘッダの型と実ソースの関数だけを一意性検査付きで抽出する。警告を緩めたり製品ヘッダを変更して回避しない。必要権限・リポジトリルートで`python validation/log_storage/run.py --converter C:/tool/AutoCopyCsvFromSd/RlogToCsv.exe`を実行し、O0/O2・Wall/Wextra/Werror、通常/詳細の統合保存・PC変換まで通す。[単独ヘッダ読込の再発](../../../../doc/失敗事例/2026-10-04-fatfs-log-reader-header-cycle.md)参照。

- このWindows制限環境ではST-LINK_gdbserver、Programmer CLI、GDB等のCubeCLT同梱exeにもDLL再配置エラーがある。GNUツールだけに限定せず、help/版表示を含め初回から許可された制限外環境で実行する。再発記録は[2026-10-11事例の2026-10-21追記](../../../../doc/失敗事例/2026-10-11-bmi088-forward-y-sign.md)を確認する。
- PowerShellでファイルパスを含むCMakeの-Dを使う場合、引数全体を単一引用符で囲む。独自構成では存在確認したツールチェーン/Ninja絶対パスを使用し、configure終了コード0を確認してからbuildする。通常は既存presetを使う。[分割失敗](../../../../doc/失敗事例/2026-10-21-cmake-toolchain-argument-split.md)を参照。
- 計測ラッパーの挿入では、ネストするCの関数呼出しを正規表現の最短一致で置換しない。既知の完全な式を個別パッチし、変更した全式とコンパイル成功を確認してからFlashへ進む。[括弧破損](../../../../doc/失敗事例/2026-10-21-diagnostic-wrapper-parentheses.md)を参照。
- 再起動で失敗時RAMが失われた場合、後から取得したSPIエラー0やoverflow=falseで当時の原因を否定しない。既存tmpは読み取りで保全し、静止中の合成保存と実走行時の非同期I/Oを区別する。メインの通常経路からFA_READ/f_lseek/f_readを使い、GDBでFILのfptr/clustや読取ポインタを組み替えない。[Write failed調査](../../../../doc/失敗事例/2026-10-21-post-run-write-failed.md)を参照。

- ホストテスト等の無変換コピーもコンパイル前にバイト契約を確認する。原本同一を要求する場合はread_bytes/write_bytesまたはCopy-Itemで改行を保存し、SHA256一致を確認してから実行する。read_text/write_textで生成したコピーへ原本バイト一致を仮定しない。内容変換コピーは変換・改行規則を別に保存する。詳細は[改行差の再発](../../../../doc/失敗事例/2026-10-17-shared-header-line-ending-check.md)。

- ファームウェアのソース所在を調べるときは、リポジトリルートから`powershell.exe -NoProfile -ExecutionPolicy Bypass -File analysis/script/search_firmware_sources.ps1 -Pattern 'routeBuildFromLog|pathRouteSourceLog' -FileGlob 'path*.c'`のように固定ルート補助を使う。検索パターンをパスへ渡さず、rg終了コード2以上で停止する。本文中の既知の実在ファイルを読む場合は個別パスを使用できる。詳細は[ソース検索での再発](../../../../doc/失敗事例/2026-08-11-windows-rg-glob-not-expanded.md)。

- 複数リポジトリを扱う読取は絶対パス、Gitはgit -Cで対象を指定する。workdir確定後に対象のTest-Pathを確認し、ファームの相対パスを含む呼出しをPCツールworkdirへ変えない。共有logBinary.hはファーム側から配布し、ビルド前に両SHA256を照合する。詳しくは[workdir再発](../../../../doc/失敗事例/2026-10-16-self-describing-header-test-contract.md)と[共有ヘッダ改行](../../../../doc/失敗事例/2026-10-17-shared-header-line-ending-check.md)。

- 共通事前確認に従い、ビルドはファームウェアルートの明示workdir、generatorはリポジトリルートまたは絶対パスで実行する。PC変換器のビルドとCMakeは呼出しを分け、各workdirを初回から指定する。生成失敗ならビルドせず、件数・型・マクロ・生成時刻を確認する。
- 書込み前にHEAD/branch、構成、build日時、ELF絶対パスとSHA256を確認する。コミット後は再configure/buildして識別情報を更新する。実機初回ログのgitCommit/build情報が一致しなければ新変更の性能評価へ進まない。
- 計測が依頼された場合は、対象ELFのnmでisrTimingStats等の必要シンボルを先に確認する。計測OFF版にない集計を回収できるとは仮定しない。
- ビルド結果のRAM/FLASH表示はB固定で解析しない。リンカのKB表示は丸めを含み得るため、正確なRAM使用端はELFの実RAMセクション配置から集計する。増分ビルドでリンク表示がない場合も成功/失敗と混同しない。単位・セクション・構成名を確認してから検証JSONを確定する。詳細は[メモリ表示単位の解析](../../../../doc/失敗事例/2026-10-18-build-memory-unit-parser.md)。

- 定数のヘッダ移動で生成命令の同一性を比較するときは、変更前のソース・オブジェクトを保存し、まず定義式と実装・宣言トークンを照合する。命令はSHF_EXECINSTR付きセクションで比較し、.rel.textの生バイト差だけで動作変更と判定しない。再配置先も検証する場合はシンボル番号を名前・所属セクションへ解決してから種別・位置・加数を照合する。定義式・トークン・命令に差があれば完了扱いせず原因を調べる。詳細は[再配置情報の誤判定](../../../../doc/失敗事例/2026-10-25-object-relocation-comparison.md)。
- 変数追加は既存スコープとの重複を確認し、必要なDebug/Releaseと変更に関係するprofile/構成をビルドする。RAM/スタック・ログ形式の変更は全構成を確認する。
- PCハーネスは実ヘッダの型(FSIZE_t等)、デバイス定義、include順序、全リンク依存を確認する。新モジュールはCMakeだけでなく全該当テストランナーへ追加する。MinGWで未使用関数の参照が消えるとは仮定しない。
- 単体計算は既存extract方式で実装を取り出し、式をテストへ複製しない。ソース全体をリンクする場合は未使用経路を含む外部依存を明示的にmockし、禁止SD/delayが呼ばれたら失敗にする。
- フィクスチャはstatic/公開値/積算値/リセット/呼出元初期化を区別する。合成LogRecordへの値設定と実writeLogBufferPutsのスナップショットは別契約。既知の非ゼロ値の読戻しまで確認する。
- float保存値の完全一致では、コンパイル前に新設CHECKの比較右辺を確認し、最終演算結果をvolatile floatへ実体化してmemcmpする。中間LPF値のfloat宣言だけでは、その後の減算式の保存契約を保証しない。ホストの拡張精度式との直接比較を避け、許容誤差や製品コードを変更して通さない。候補版5では初回から必要権限でanalysis/script/validate_slip_lateral_v5.pyを実行する。詳細は[最終減算式での再発](../../../../doc/失敗事例/2026-10-12-host-float-snapshot-comparison.md)。
- 選択統合ではmain側の関数引数・レコード生成マクロ・任意ソースの存在を先に照合し、他ブランチ専用のハーネス依存を持ち込まない。CMakeの`-D`指定は引数全体を引用し、キャッシュのツールチェーンパスとprofileを確認する。詳細: `doc/失敗事例/2026-10-16-selective-log-main-integration-contract.md`。
- Windows hostテストはassert失敗でGUI待ちにならない構成を使う。Pythonは構文確認だけで成功とせず対象unittest/実処理も実行する。

- 実FatFsのff.c・ccsbcs.cをMinGWで直接検証するときは、全翻訳単位へ`-include`で実在するCore/Inc/main.hの絶対パスを渡し、WindowsのLPTR/ERRORよりCMSISを先に評価する。テスト本体のinclude順序だけでは不十分。実FatFs/exFATのCRLF・事前確保・ブロック書込回帰を確認する。
- 実装抽出ハーネスは、計測ラッパーや内部実装を分けた変更後に公開APIの定義・依存が抽出結果へ含まれることを確認する。ファイル上の固定終端だけに依存せず、必要なラッパーを関数名で抽出し、実際にリンク・実行する。

## ST-Linkの操作順序

- この機体の既知の不安定接続を避け、書込み時の初回ターゲット接続から `port=SWD mode=UR reset=HWrst freq=100` を使う。プローブ列挙・電圧だけで成功としない。Device ID 0x421/Core IDが取れなければ書込みへ進まない。
- Programmerのsession_idが残る間は別のST-Link接続やGDBサーバー起動をしない。exit_code=0と照合/起動の最終メッセージを回収してから進む。非昇格Get-Processに見えないことは昇格Programmer終了の証拠ではない。
- サーバーは発見済みの絶対パスと毎回の-cp、ポート、SWD指定を使い、PID・stdout/stderrを保持する。待受と生存を確認してからGDBを接続する。
- 現CubeCLT ARM GDBはPython非対応。集計/コマンド生成は外部Python/PowerShell、GDB内は標準コマンドを使う。別版へ替えた場合はshow configurationで確認する。
- monitor reset haltを使わない。起動経路の再現が必要ならmonitor helpで対応を確認し、ブレーク設定後のmonitor reset等を選ぶ。CLIでhaltしてもGDB接続まで停止が維持されるとは仮定しない。
- 走行後RAMの回収は**リセットなしattach**を使う。接続復旧目的のUnder Reset・再書込み・機体再起動を行わない。USBエラーはサーバーログから確認し、機体電源を保ったST-Link側USB復旧を選ぶ。
- compare-sectionsのMIS-MATCHEDや単独verify接続失敗をFlash不一致と断定しない。読取可能ならリセットなしでFlashをdumpし、objcopy binaryとロード領域の全バイトを比較する。一致するELFだけでRAMを解釈する。
- 取得周期測定では停止中TIM3/TIM6/TIM7の進行による観測影響を分ける。DBGMCU元値を保存し、必要な凍結設定と計測区間を管理し、最後に復元する。注入件数・停止区間を通常実行統計へ混ぜない。
- 古いDebugベンチAPIは現行mainの存在を検索/nmで確認するまで呼ばない。再生XYは別ソース経路と一致するとは限らず、fixtureの距離進捗を対象driveRouteの弧長へ写像する。
- 開始要求はアプリ初期化後。IWDG初期化順序とHAL tickの開始順を確認し、リセット後の要求0/PWM0・自動再開なしを確認する。PRIMARYの保存/CSV検証が失敗したら残りケースへ進まない。

- レコードごと等の頻回関数へ、ホスト評価の条件付きGDBブレークを置いて大量ヒットさせない。観測が遅延する場合は中断し、通常メイン処理で必要な境界値をRAMへ一度保存する計測へ置き換える。モーター停止を確認し、再利用するブレークは対象関数と実際の停止回数を先に限定する。

- 新規パーサー・整数範囲チェックはARMビルドだけでなくMinGWの`-Wall -Wextra -Werror`でもコンパイル・実行する。int32_tとUINT8_MAX/UINT16_MAXを比べる際は、上限がint32_t内であることを確認し同符号へ明示変換する。検証例は`tests/slip_v2_active_test.c`、詳細は[整数境界の型差](../../../../doc/失敗事例/2026-10-21-slip-v2-host-signed-bounds.md)。

## 現行ログと抽出テスト（2026-10-24）

- 機体CSV変換・旧CSV解析と対応する旧テストは廃止済み。現行binの検証はリポジトリルートから`python validation/log_storage/run.py`。PC変換確認時だけ`--converter C:/tool/AutoCopyCsvFromSd/RlogToCsv.exe`を付け、最初から必要な実行権限を使用する。
- センサー角度関数の抽出では実関数だけでなく`angleSensor`の公開変数定義と`IMU_PI_F`も実ソースから取り込む。抽出対象を追加したら依存する公開値・定数を先に列挙し、O0/O2のWall/Wextra/Werrorでコンパイルする。未宣言のテスト依存を製品コードの変更で回避しない。
- 保存故障は実際のopen/read/closeの段階に注入する。正常openがcloseを呼ぶと仮定しない。詳細は`doc/失敗事例/2026-10-24-cleanup-host-fixture-contract.md`。

## 共通UI・設定定義のホスト比較（2026-10-25）

- UI変更のホスト検証前に、実ssd1306の描画バッファとDMA開始・停止・完了処理、同期転送の呼出元を確認する。表示文字列だけでなく、無変更1000周期で再描画ゼロ・値変更時に本文全消去なし・再入場時の再描画・DMA中の同期転送ゼロと停止中の転送を模擬する。リポジトリルートの明示workdir・初回から必要権限で `python validation/shortcut_ui/run.py` を実行し、O0/O2・Wall/Wextra/Werrorと全条件が通るまで確認完了にしない。ホスト成功と修正後の実機ちらつき確認は分ける。[Shortcut画面のちらつき](../../../../doc/失敗事例/2026-10-25-shortcut-ui-continuous-redraw.md)を参照。

- 共通ループの追加前に、UI選択値・配列添字・sizeof・unsigned接尾辞を含む比較式の型を確認する。整数上限マクロだけを対象にしない。変換値が対象型の範囲に収まることを確かめて同符号へ明示変換し、実関数をO0/O2・Wall/Wextra/Werrorでコンパイルする。詳細は[符号比較の再発追記](../../../../doc/失敗事例/2026-10-21-slip-v2-host-signed-bounds.md)。
- 変更前スナップショットを比較参照へ追加する場合は、参照側の既存warningを先に識別する。許容が必要な既存診断だけを参照ブロック内のdiagnostic push/popで囲み、理由を記載する。現行コードのWerrorを弱めない。詳細は[参照実装の警告契約](../../../../doc/失敗事例/2026-10-24-cleanup-host-fixture-contract.md)。
- リポジトリルートを明示workdirとして、最初から必要権限で`python validation/control_refactor/run.py`を実行する。任意の作業前Coreがある場合のみ`--baseline build/main-refactor-20261025/before`を付ける。通常実行にスナップショットを必須としない。失敗時は実機検証へ進めず、ビルド診断とアサートを区別して対処する。

## 作業前スナップショットの構造体版（2026-10-25）

- 比較元を切り替える前に、参照する実関数・構造体のフィールド・マクロ依存を読む。旧フィールドが任意の作業前Coreへ残っていると仮定しない。横統計の比較は`peak/onMs`が両方ある版でだけ二重保持を検査し、片方だけの未知の版では停止する。共通の出力・保存統計の比較は省略しない。
- 共通定数へ移した値の抽出検証では、実`calibrationConstants.h`と必要なincludeパスを最初から含める。未宣言の別名を避けるため製品へ数値の重複定義を戻さない。
- リポジトリルートを明示workdirとし、必要権限で`python validation/control_cleanup/run.py --baseline <実在する作業前フォルダ>`を実行する。統合前と統合後をサポートするとした場合は両方を実際にO0/O2でコンパイル・実行し、失敗時は実機確認へ進めない。詳細は[参照構造体版の追記](../../../../doc/失敗事例/2026-10-24-cleanup-host-fixture-contract.md)。validationはローカル専用・Git管理対象外とする。

## 非同期ビルドの集計前確認（2026-10-25）

- `exec_command`/`write_stdin`が`session_id`を返したら、ビルドは継続中として扱う。同じ呼出し内でも依存する集計読込へ進まず、同じセッションを待って終了コード0とセッション終了を確認する。途中構成のPASS表示を全体終了の代わりにしない。
- 終了後に対象構成がすべて含まれることと今回の集計ファイルの存在・更新を確認し、警告比較を実行する。並列化するのは依存しない処理だけとする。
- 初回全体ビルドと後続増分ビルドは別フォルダへ記録し、警告比較に用いた全体ログを上書きしない。詳細は[集計読込の先行](../../../../doc/失敗事例/2026-10-25-build-summary-before-completion.md)を参照。

- 単体停止判定のハーネス生成前に、対象関数・実グローバル型・ISR統合の範囲を確定する。変更していない全モジュールの厳密警告を単体試験へ混ぜず、対象は実関数抽出で検証する。既存警告へ合わせて製品の演算やWerrorを緩めない。[完全逸脱停止の試験範囲](../../../../doc/失敗事例/2026-10-04-shared-ram-host-harness-dependencies.md)参照。
- GDBの子プロセス出力は初回からバイナリPIPEと原バイト保存を使用する。Windows既定text=TrueでUTF-8ソース行を復号しない。出力喪失時は最初にリセットなしでPWM/CCR・開始要求・割込みマスク等を読み取り、復元状態を確認してから再試験する。[GDB出力復号](../../../../doc/失敗事例/2026-10-04-fpu-audit-log-encoding.md)参照。

## 2026-10-27：新規白線モジュールのホスト検証

- O0/O2の厳密警告を実モジュールで実行し、uint16_t同士の減算も整数拡張後の符号で検査する。float関数戻り値と小数定数の完全一致では両方の最終値をvolatile floatへ保存する。関連事例は2026-10-21-slip-v2-host-signed-bounds.mdと2026-10-12-host-float-snapshot-comparison.md。
- 新しいCHECKが製品グローバルを直接参照する前に、既存モックとリンク依存を確認する。出力関数が値を捨てるモックなら受信値を記録し、製品の他モジュールを無関係に追加しない。
- 白線地図を含む制御変更では、単体式だけでなく実型付き原本bin読込・実経路生成・地図キャッシュ種別・実1ms状態遷移をホスト再生してから書き込む。保存区間からの1ms再構成は実機入力の完全復元ではない。版19の条件はdoc/path-confidence-fusion.mdを参照する。

## 2026-10-27：書込み全体時間とELF存在確認

- 100kHzで約249KBのダウンロード約40秒＋照合約31秒を確認した。全体60秒のPython timeoutで切らない。CLIは進捗付き非同期セッションで短く待機を分割して終了を回収し、Pythonで包む場合は全体180秒等を確保してTimeoutExpiredの部分stdout/stderrも原バイト保存する。USBエラー後の盲目的な再書込みを避け、再接続・Device ID・Flash読出し一致を先に確認する。[書込み中断と復旧](../../../../doc/失敗事例/2026-10-27-stlink-usb-during-flash.md)。
- 注入前に実ELFのnmでスクリプトの全関数・全グローバルを確認する。ヘッダ宣言やソース定義だけでは未リンクの関数を検出できない。設定固定等の関数が未リンクなら、製品の呼出し経路が本当にあるか確認する。試験都合のused属性を付けず、必要な製品接続とテストの責務を分ける。
- 割込みマスクや入力を書き換える前に復元用の値を原ログ/ファイルへ保存する。途中エラーでは最初にリセットなしでPWM/CCR・開始要求・マスクを読み、元の状態を復元してから再試行する。最終detachと自分のサーバー終了を必ず確認する。

## 2026-10-31：走行後のBIN storage failedを読む前

再起動せず生RAM/Flashを先に保全し、実Flashと全ロード領域が一致するELFだけで読む。接続前に全照会式の根シンボルをfile-only GDBのinfo variables/addressまたはnmで検査する。USERFatFSは宣言があっても未リンクで、実マウントはsd_functions.cのfsだった。ログ列cntlogと実変数cntRunも区別する。補助ファイル名は今回の実在一覧から確定し、logBufferWriterの定義はSDcard.c内を検索する。

GDB出力を原バイトで保存するだけでなく、表示するPythonのstdout/stderrをsys.stdout.reconfigure/sys.stderr.reconfigureでUTF-8にし、初回呼出し側もPYTHONIOENCODING=utf-8とする。生ログの読取で置換文字が出てもCP932へ再エンコードしない。解析ではRAM/コンテナのLEと実AppendU16/U32が保存するレコードのBEを個別確認し、スキーマ長・バイト収支・正の時刻差で誤復号を拒否する。

13959のoverflow=true/writeFailed=falseはendLogが保存検証前に拒否する直接原因を示した。終了後はキューが排出済みなので空キューを根拠にoverflowを否定しない。SPI/err0は過去の一時遅延を否定しない。OLED割り込み待ちはデバッガの停止影響も分離し、走行時の原因と断定しない。根本原因の分離にはf_write最長時間・書込タスク最大間隔・キュー最大占有・初発時刻のRAM診断を別途検討する。詳細は[13959の回収と補助修正](../../../../doc/失敗事例/2026-10-31-bin-storage-overflow-13959.md)。
診断プロセスのstdoutへSelect-Object -First等を直接つないで途中で閉じない。終了コード判定が必要な実行は全出力をファイルへ保存するかそのまま完了を待ち、表示量はツールのmax_output_tokensで制限する。13959の最終解析はパイプなしでexit0を確認した。

## 2026-10-31：PATH共通化の状態遷移試験

白線照合回復後の加速を検査する前に、信頼度の100ms回復と、白線退避後の200ms再合流確認・100ms操舵混合を別条件として確認する。100ms直後の加速だけを期待して製品条件を緩めない。短縮回廊と前後の予約区間は補正・白線退避を禁止し、照合監視・加速保留・減速・喪失停止を別々に検査する。入口は実在するリポジトリルートのvalidation/path_common/run.py。検索は共通事前確認を読み終えてから実在するCore親と-gへ組み立て、旧D:や未配置の過去validationを前提にしない。詳細はdoc/失敗事例/2026-10-31-path-common-validation-contract.md。

ビルド集計用の保存ログも、拡張子やPowerShellの版からUTF-16と決めず先頭BOMと実バイトを確認する。BOMが無ければ保存時の規約とUTF-8厳密復号を照合し、復号だけ失敗した完了ビルドを再実行しない。path_common/build.pyは保存済み基準ログをBOM判別してから未実行のビルドへ進む。

## 2026-11-01：補正ログ検証前の入口確認

検索先はTest-Pathの結果を表示するだけでなく、必須パスならFalseでthrowし、任意パスなら実在するものだけを配列化してrgへ渡す。robotrace_v2/testsが無いチェックアウトではvalidationのみを検索する。rg終了コード2以上では後続へ進まない。同じapply_patch内で同一パスを複数操作に分けず、1つのUpdate File内へhunkをまとめる。

CRCフィクスチャではlogBinaryCrcUpdateの実引数const uint8_t *と照合し、const char *のschema/metadataからのバイト変換を明示する。Wpointer-sign等の警告を緩めない。補正ログはvalidation/path_correction_log/run.pyで通常/詳細×O0/O2の分離・区間保持・実writer・独立復号・全CRCを確認する。現行は通常61列/168 B・詳細67列/177 B。既存ログの列数を期待値へ流用しない。配備済みPC変換器が無い場合は、独立復号の成功と実変換器未確認を分けて報告する。[実例と検証結果](../../../../doc/失敗事例/2026-11-01-path-correction-log-preflight.md)。

## 2026-11-01：クロス直線化の調査入口

Skillに記載された補助スクリプトも現在のチェックアウトで実在確認する。search_firmware_sources.ps1が無い場合は実在するCore/Src・Core/Incと-g 'path*'へ分離して検索し、未確認のrobotrace_v2/tests等を加えない。必須パスはFalseでthrow、rg終了コード2以上で停止する。段落パッチは読込済みの完全行を使用し、拒否時は同じパッチの新規ファイルを含む全対象を再確認する。検証入口はvalidation/path_cross_straight/run.py。変更前Coreがbuild/path-cross-straight-20261101/before/Coreにあれば旧新制御トレースも照合し、無ければ現行試験だけ実行して旧新未比較を明示する。[事例](../../../../doc/失敗事例/2026-11-01-path-cross-straight-preflight.md)参照。

## 2026-11-01：ゴールマーカー停止への移行検証

制御版26はPATH/SHORTCUT/PATH_CURVEもSGmarker>=COUNT_GOALでcase101へ移る。リポジトリルートから必要権限でvalidation/goal_marker_stop/run.pyを実行し、実Cのゴール判定・通常ラインPIDへの切替・50mm/2秒境界・緊急停止優先を旧新×O0/O2で確認する。build.py before/afterはDebug/Releaseの原ログとELFを保全する。実機の制動・初回ログは別途確認する。詳細はdoc/path-goal-marker-stop.md。

ソース呼出元の探索も未確認のsystem.c等を渡さず、Test-PathでCore/Srcを確認してからrg -n 'loopSystem|emcStop' robotrace_v2/Core/Src -g '*.c'を使い、終了2以上で停止する。警告比較は行正規表現のCR残存を避け、splitlines/stripで両側の行末を揃える。集計だけの失敗では実ELF/コピーSHA・実CのSHA・原ログを照合し、完了Debugはbuild.py after --resume-debugで集計のみ再開して未実行Releaseへ進む。事例はdoc/失敗事例/2026-11-01-goal-tail-investigation-preflight.md。

## 2026-11-01：過去文書の検証器パスを読む実行点

過去のbuild記録や説明にあるvalidation配下のパスも、現チェックアウトにあるとは仮定しない。最初の呼出しでrg --files validation -g '*.py'の実在一覧を取得し、結果を読んだ後の別呼出しで掲載されたファイルだけを読む。一覧にないディレクトリをGet-Contentやrgへ追加しない。新しい検証器は入口で参照Core・コンパイラ・実モード宣言を検査し、変更前ビルド成功後だけ製品編集へ進む。今回の入口はvalidation/path_decel_lead/run.pyとbuild.py。[先行減速実装時の参照失敗](../../../../doc/失敗事例/2026-08-11-windows-rg-glob-not-expanded.md)参照。
## 2026-11-01：uint16速度目標の検証

過去のvalidation/log_storage/run.pyは現チェックアウトに無い。検証器はrg --files validation -g '*.py'の実在一覧から選び、型変更はvalidation/target_speed_u16/run.pyとbuild.pyを入口にする。通常/詳細の169/178 B、targetSpeedのU16、255/256/266/580の実writer/readerとCRCを確認する。PC変換器未配置時は独立スキーマ復号の成功と、PC変換器・初回実機ログ未確認を分けて報告する。

assertを使うZigホスト検証は、生成Cのassert.hより前でNDEBUGを解除し、O2でもassertが実行されることを保証する。nm等の行末正規表現も解析前にsplitlinesでCRLFを正規化する。集計失敗では実ソースSHA・保存ELFを照合し、build.py --resume-debugで完了済みDebugを再ビルドせず未実行Releaseだけを進める。[実際の失敗と検証](../../../../doc/失敗事例/2026-11-01-target-speed-u16-validation-preflight.md)。

## 2026-11-01：同期設定の回帰と検証器の入口

Skill/再発防止参照を読む呼出しと、その内容に依存する検索・ビルドを分離する。返り値を読んでから実在するvalidationだけを検索し、未配置robotrace_v2/testsを固定リストへ戻さない。新しい警告集計器は正規表現のfile/line/messageを名前付きグループで取り、ファイル拡張子・行番号の形を集計前に検査する。完成済みARM/ホスト結果で集計だけが失敗した場合は、原ログ・ソースSHA・ELFを照合して集計だけ再開する。[同期修正時の再発](../../../../doc/失敗事例/2026-11-01-path-correction-log-preflight.md)参照。

複数PID構造体を使う制御では、SD保存対象と実IRQで使用する対象、起動後とUI最終編集の反映を照合する。左右速度PIDの入口はvalidation/speed_pid_sync/run.py。実C起動区間・UI・状態保持・PRIMASK復元をO0/O2で検査し、Debug/Releaseの警告比較とユーザーのtimer.c差分保持をfinalize.pyで確定する。[同期漏れの修正](../../../../doc/失敗事例/2026-11-01-wheel-speed-pid-gains-not-synchronized.md)参照。

## 2026-11-01：nm原本の改行と配置照合

nm出力をbytesで保存した場合、行末アンカーの正規表現へ渡す前にsplitlinesで改行を正規化する。原本・対象ELFのSHAを保存し、同じELFの原本から配置検証を再開する。パーサ失敗のため成功済みビルドをやり直さない。[走行別ログの配置検証](../../../../doc/失敗事例/2026-11-01-mode-log-diagnostics-preflight.md)、`validation/mode_log_diagnostics/finalize.py`を参照。

## SHORTCUT_CURVE追加時の検証入口

このチェックアウトの新モード検証はvalidation/shortcut_curve/run.py、entries.py、build.py、check_timing.pyを使う。存在しないrobotrace_v2/testsを過去参照から構成しない。追加検索は実在validationの一覧から選ぶ。[再発と確認](../../../../doc/失敗事例/2026-10-31-path-common-validation-contract.md)。

## 2026-11-02：停止後XYログの検証前

未知の子フォルダ・設定ファイルは、親が存在しても個別のTest-Pathまたはrg --filesの実在結果で所在を確定する。FatFs設定はFATFS/Target/ffconf.h、現在利用可能な実writer/reader検証の生成器はvalidation/mode_log_diagnostics/run.py。停止時APIを常時成功モックから実実装へ切り替える前に、modeLOG・キュー・ファイルopen/close・共有RAM所有者・FatFsロックの遷移をfixtureへ明記する。記録中の拒否はI/O回数が変わらないことまで確認する。実endLogと型付き一次読込を使う入口はリポジトリルート・必要権限のvalidation/path_xy_columns/run.py。詳細は[停止後XY検証の事例](../../../../doc/失敗事例/2026-11-02-path-xy-host-preflight.md)を参照する。

ログ追加の出力先は通常の番号.binとし、付属CSVを別方式として導入しない。既存x/yを含む全既存列の位置と保存値を維持し、新しい列は既存末尾へ置く。出力先・行対応・欠測表現を固定し、全既存スキーマのprefix一致と全既存保存値の一致を検証する。ユーザー訂正後に古い末尾XY化を再導入しない。上記事例の保存契約修正を参照する。

## 2026-11-02：停止後保存の高速化を比較する前

旧新の実ソースで専用グローバル宣言の有無を確認し、版固有のRAM宣言を両側へ一律に生成しない。入力件数を拡張するときは生成ループ・cntSendアサート・ヘッダ行数・コピー長・固定件数検査を同時に照合する。入口はリポジトリルート・必要権限のvalidation/path_xy_speed/run.py。全bin/seed/一次のバイト一致とFatFs APIの呼出/バイト量を通常/詳細×O0/O2で比較し、API計数を実SDの時間と混同しない。詳細は[保存高速化フィクスチャ](../../../../doc/失敗事例/2026-11-02-path-xy-speed-fixture.md)。
