Kageyana/robotrace_v2/.agents/skills/robotrace-sd-settings/references/failure-prevention.md

# SD・保存形式の再発防止

## PC変換フィクスチャ名の事前確認（2026-10-25）

PC変換器へ渡すbinは初回からASCII連番名とヘッダ番号の一致を確認する。検証ケース名は親ディレクトリへ付け、例は`profile1/path-diagnostics/1.bin`とする。生成前に親フォルダを作り、古いCSVを除いてから変換する。必要権限・リポジトリルートで`python validation/log_storage/run.py --converter C:/tool/AutoCopyCsvFromSd/RlogToCsv.exe`を実行し、両構成の全6値まで照合する。[番号照合の失敗記録](../../../../doc/失敗事例/2026-10-25-pc-converter-fixture-filename.md)参照。

## SD接続・設定

- PCのドライブ文字G:/H:を固定しない。Get-PSDriveで候補を列挙し、setting内の実ファイルでカードを確認する。現permission profileで対象ドライブが未許可なら、初回の読書きからカード限定の昇格を使う。Get-Volume/CIMが拒否済みなら同じ照会を反復しない。
- 対象設定をバックアップし、保存形式・byte数・改行有無を再読込する。他設定のSHA256と比較し、対象だけ変更したことを確認する。
- lsvalのRAM有効性判定はSD保存成否から独立させる。SDなし起動→有効校正→手動開始、未校正/不正値→開始禁止、SDあり破損lsvalを分けて確認する。保存済みコピーだけで走行時の極値を確定しない。
- auto_runの2走目SLIPは拒否、DISTANCE直後のSLIPは受理する。全スロット・重複run・途中欠落・範囲外・I/Oエラーを区別し、I/Oエラーを破損とみなして上書きしない。

## 保存・復旧

- 現行は機体でbinを保持し、PCのAutoCopyCsvFromSdでCSV化する。再起動や修復前にbin/part/tmp・設定・失敗段階を保全する。PCのtempとCSV保存先の空きを確認し、temp原本・保存先CSVの照合と永続化成功後だけSD原本を削除する。機体の起動時CSV復旧を前提にしない。
- FR_OKだけで書込成功にしない。要求長と実書込長、fptr、free_clstを確認する。機体のbinはsync/close/renameで確定し、自動削除しない。機体CSV変換APIは削除済み。保存失敗はbin/tmpの各段階で注入し、PC出力は別工程として照合する。
- 容量確保後も失敗したら媒体の種別・空き・失敗段階・戻り値を取り直す。前回の原因を当てはめない。CRC/実長/スキーマ/メタデータを名前付きフィールドで確認し、tuple添字を推測しない。
- CubeMX/FatFs更新後はff.cのexFAT通常f_openにobj.n_frag=0の初期化が保持されているか確認する。RAM FatFsのモック成功では実FatFsを検証できない。現行は実機のbin確定・再起動時ヘッダ確認とPC取込を検証する。旧機体CSV変換や再起動時CSV復旧の試験は再導入しない。
- SD初期化はカード検出・SPI初期化・mountを分ける。リセットで一度直ったことだけで根本解決としない。再発時はCMD0/CMD8/ACMD41、電源・接触を観測する。
- 解析の通常経路で再mount/全容量走査を増やさない。I/O再試行は既存の有限回数・有限待機とし、自動formatを行わない。読込エラーの診断を同じSDへ書き続けない。Base read/plan、Slip open/read/plan等の段階を記録する。
- PC上の正常CSVは機体が読んだファイルと同一とは限らない。解析対象番号と実カードのファイル長・ハッシュ・ヘッダを照合する。

## 形式・メモリ

- 読取側を列挙し、既存列の順序/型を保つ。機体の解析元は現行binだけを型付きAPIで読み、列追加時はPC変換器出力の全名前・区切り・データ列数を通常/詳細で検証する。文字列長はstrlen/sizeofから求める。
- snprintf戻り値で切詰めを検出する。行末改行・全行列数・最大行長・期待行数を検査し、連結行を経路解析へ渡さない。現行バッファ容量をソースで確認し、旧1024 Bの検査値を固定ルールにしない。
- FIL、行バッファ、配列を増やすときはGET_SECTOR_SIZEと_MAX_SS、使用中リンカの8 KiB予約、_sbrk上限を確認する。全構成のmap/nm/objdumpでRAMと呼出しを含むスタックを点検し、実機最大値は別検証とする。
- FatFs型のAPIをmain.h経由のSDcard.hへ追加しない。logSource.hの分離とinclude順序を維持し、ARMビルドとPCテストの両方を確認する。
- binの整理前後の計画比較は毎回一次DISTANCE計画を再生成し、optimalTrace/analyzedNumber/PPAD/設定を同じ初期状態へ戻す。前のSLIP補正済みキャッシュを再補正しない。

## PC変換の検証

- 現行は自己記述RLOG v2。保存列を増減・並替してもPC変換器を更新せず、同じexeで各変種を検証する。列定義CRC・型・重複名・書式・実長・計算必須列を確認し、旧v1の6形式は拒否する。PCとARM、x87とSSE、別時点のメタデータを同一条件とみなさない。
- ps1は配布前にUTF-8 BOMと実際のWindows PowerShell 5.1実行を確認する。SHA256・ドライブ検出をモジュール自動読込へ依存させず、.NET実装で取込と監視起動の両方を確認する。失敗時・同名衝突時のSD原本保持を検証する。詳細: `doc/失敗事例/2026-10-15-pc-binary-import-runtime-contract.md`。

- 数値整形は機体と同じsnprintfを使用し、fprintfとの丸め差を前提にしない。丁度半分のfloatと実ログでもバイト比較する。参考RAMモックのf_expand上限を実ログ長と照合し、必要なら参考変換だけ通常割当フォールバックで比較する。

- ヘッダ形式変更では全必須欄・CRC範囲・実長式を合成フィクスチャにも反映する。旧v1拒否は現行要件。詳細: `doc/失敗事例/2026-10-16-self-describing-header-test-contract.md`。

- PC取込でbinが残る場合は変換器stderr・temp CSV・保存先copyingと失敗段階を照合する。CSV確定の共有違反32/33は同じ作業ファイルを有限時間再試行し、同名衝突・権限エラーとは分ける。原本削除は正式CSVの照合成功後に限る。日本語を含む試験用ps1も実行前にUTF-8 BOMを確認する。詳細: `doc/失敗事例/2026-10-15-pc-binary-import-runtime-contract.md`。

## 未確定tmpの個別復旧（2026-10-18）

- ドライブ候補の列挙結果を読み取ってから、次の呼出しでラベルRT_LOGとルート内ファイルを確認する。列挙と同時に過去のG:/H:を照会しない。Get-Volume/CIMを使わず、必要権限付きの.NET DriveInfo.GetDrives()で現在のラベルを確認できる。
- tmpは全体コピーと前後SHA256照合を先に行う。先頭512 Bが0、予約サイズのままの場合は未確定であり、後方の有効RLOG/列定義/メタデータが別番号の過去データでないか確認する。元tmpを単純にbinへ改名しない。
- 自己記述情報やCRCがない対象を、隣接番号の列形式だけで正常ログへ昇格しない。ユーザー依頼で診断用の部分抽出を行う場合は、形式仮定・元CRC未検証・停止条件・対象byte範囲を記録し、別フォルダの*_partial.csvへ隔離する。終了時設定・終了理由・正常完走を推測で補わず、機体経路元や通常取込へ公開しない。変換器用の合成コンテナCRCは元記録の検証にならない。
- Pythonで任意バイト列や置換文字を表示するときは、実行前にPYTHONIOENCODING=utf-8を設定し、保存テキストにもencodingを明示する。
- 事例と検証条件: doc/失敗事例/2026-10-18-unsealed-tmp-partial-recovery.md、analysis/sd-tmp-recovery-20261018/README.md。保存失敗の実機原因は別途取得する。

## 型付き読込の回帰契約（2026-10-24）

- 正常openはハンドルを保持し、closeは呼出側が実行する。close故障をopenの失敗と期待せず、open/read/closeと起動時ヘッダ検証の各段階へ個別に故障を注入する。
- スキーマが変わらないAPI整理でも、通常/詳細の実保存レコード・列定義・DISTANCE/SLIP/PATH/SHORTCUT計画を作業前と照合する。旧CSVを機体へ戻して比較しない。現行回帰は`validation/log_storage/run.py`。

## 校正基準とメタデータ共通化の事前確認（2026-10-25）

- `calibrationConstants.h`を実機既定換算とログ受入条件の共通基準とする。実機設定だけを変更した不一致コピーで拒否を検証し、未検証の値を受け付けるため基準値や条件を緩めない。抽出ハーネスも実共通ヘッダを取り込み、旧ファイルに数値定義が残ると仮定しない。
- 故障注入の期待値を作る前に、実`SDcard.c`の`primaryRouteValidation.reason`について先行分岐と値を確認する。現行は距離換算検証失敗が10、IMU校正条件不成立が9。出力フラグと理由を併せて確認し、期待違いを製品側の変更で回避しない。詳細は[理由コードの前提追記](../../../../doc/失敗事例/2026-10-24-cleanup-host-fixture-contract.md)。
- メタデータ変更前に既存キー・順序・数値書式を記録し、実`logBuildMetadata()`の全出力を固定したビルド日時で前後比較する。`SPEED_PARAM_FIELDS`の出力フラグは既存15項目だけを1とし、SD設定19項目の保存順と初期値を変えない。
- リポジトリルートをworkdirとし、最初から必要権限で`python validation/constants_metadata/run.py`を実行する。変更前Coreがある場合だけ`--baseline build/constants-metadata-20261025/before`を加える。通常/詳細・換算不一致・校正サンプル不一致が全件成功するまで実機検証へ進めない。validationはローカル専用・Git管理対象外とする。

- SD数値の読込結果をホストで比較する新規CHECKでは、1.6F等の小数リテラルも期待値としてvolatile floatへ保存し、保存ビット列を比較する。再書込み回数・文字列一致とは別に検査し、許容誤差や製品側の読込式を変更して回避しない。既存の最終演算結果の保存ルールを定数比較にも適用する。詳細は[SD速度の直接比較の追記](../../../../doc/失敗事例/2026-10-12-host-float-snapshot-comparison.md)。
## 2026-11-02：停止後XYログの検証前

未知の子フォルダ・設定ファイルは、親が存在しても個別のTest-Pathまたはrg --filesの実在結果で所在を確定する。FatFs設定はFATFS/Target/ffconf.h、現在利用可能な実writer/reader検証の生成器はvalidation/mode_log_diagnostics/run.py。停止時APIを常時成功モックから実実装へ切り替える前に、modeLOG・キュー・ファイルopen/close・共有RAM所有者・FatFsロックの遷移をfixtureへ明記する。記録中の拒否はI/O回数が変わらないことまで確認する。実endLogと型付き一次読込を使う入口はリポジトリルート・必要権限のvalidation/path_xy_columns/run.py。詳細は[停止後XY検証の事例](../../../../doc/失敗事例/2026-11-02-path-xy-host-preflight.md)を参照する。

ログ追加の出力先は通常の番号.binとし、付属CSVを別方式として導入しない。既存x/yを含む全既存列の位置と保存値を維持し、新しい列は既存末尾へ置く。出力先・行対応・欠測表現を固定し、全既存スキーマのprefix一致と全既存保存値の一致を検証する。ユーザー訂正後に古い末尾XY化を再導入しない。上記事例の保存契約修正を参照する。

## 2026-11-02：停止後保存の高速化を比較する前

旧新の実ソースで専用グローバル宣言の有無を確認し、版固有のRAM宣言を両側へ一律に生成しない。入力件数を拡張するときは生成ループ・cntSendアサート・ヘッダ行数・コピー長・固定件数検査を同時に照合する。入口はリポジトリルート・必要権限のvalidation/path_xy_speed/run.py。全bin/seed/一次のバイト一致とFatFs APIの呼出/バイト量を通常/詳細×O0/O2で比較し、API計数を実SDの時間と混同しない。詳細は[保存高速化フィクスチャ](../../../../doc/失敗事例/2026-11-02-path-xy-speed-fixture.md)。
