Kageyana/robotrace_v2/.agents/skills/robotrace-log-analysis/references/failure-prevention.md

# ログ解析の再発防止

ハッシュ検証の対象をPath.parts等で選び、検証前に期待件数と名前を確認する。空集合を全件一致として成功にせず、Windows/forward slashの両表記で対象選択を検査する。[ソース照合の空集合](../../../../doc/失敗事例/2026-11-01-source-hash-path-normalization.md)。

14026以降の棚卸しはanalysis/script/compare_shortcut_primaries_14026.py prepareへ固定する。共通手順を読んだだけで即席foreach文を再作成せず、別のPowerShell入口ではParser検査を先行する。[棚卸しの再発](../../../../doc/失敗事例/2026-11-01-powershell-foreach-pipeline.md)。

条件探索では、読込成功と短縮採否を分け、status=3/6等の正しい拒否も結果に残す。成功候補だけを期待して探索を止めない。PCの幾何候補は製品の合法性判定と別に保存する。[候補探索の結果契約](../../../../doc/失敗事例/2026-11-01-shortcut-host-assert-disabled.md)。

ホストC解析の生成前に、assert内の読込・状態更新とNDEBUGを確認する。最適化で消えるassertに入力操作を置かず、常時有効な検査を使う。O0/O2の実入力全出力一致と異常入力拒否も確認する。[14038/14039の再発](../../../../doc/失敗事例/2026-11-01-shortcut-host-assert-disabled.md)。

対象CSVを数値計算へ渡す前に以下を確認する。原本を変更せず、除外番号・理由・入力SHA256を成果物へ残す。

## 入力境界

- ペリフェラル初期化の調査では、CubeMXの分割生成を仮定してspi.c/tim.cを検索パスへ指定しない。最初に `rg -n "MX_SPI2_Init|BaudRatePrescaler" robotrace_v2/Core/Src -g "*.c"` のように実在ディレクトリを検索し、結果に出たファイルだけを読む。このプロジェクトのSPI2初期化はmain.cに存在する。

- 過去の解析成果物やテストを読む前に、rg --filesまたはGet-ChildItemの実在名と照合する。系列ごとの成果物名を推測しない。詳細は[推測パスの再発](../../../../doc/失敗事例/2026-08-11-windows-rg-glob-not-expanded.md)。

- CSVは拡張子だけで選ばない。basenameがASCIIの `^[0-9]+$` に一致するものだけを整数化し、数値の範囲・件数・欠落番号を照合する。`imu_temp_*.csv`、boost、bin/part/tmpは別形式。
- 既存の `analysis/script/check_additional_logs_13238_13247.py` の `discover()` を参照する。新しい処理へ流用するときも呼出契約を読む。
- メタデータ・ヘッダ・全データ行の列数を検査する。末尾空セルは仕様として別に数え、欠損列名とは区別する。固定長読込なら物理行末まで読む。派生列も含む実CSVの列数を使う。
- 整数相当メタデータはfloatへ変換後、有限・整数相当・範囲を検証してint化する。`2`/`2.00`は受理、`2.5`/`nan`/`inf`は拒否し、端数を切り捨てない。
- 短い行・非数値・NUL・改行不整合は番号と理由を記録する。全件分類では個別例外で全体を止めずABNORMALへ分ける。NUL除去は読込コピー内に限り、破損フラグを残す。有限値なしでnanmaxや平均を呼ばない。
- CSVイテレータはファイルのwith内で消費する。描画へ渡すCSV数値列は文字列のままにしない。新規標準ライブラリ参照はimport一覧と実行の両方で確認する。

## 時刻・距離・単位

- U16 cntlogの65535→0の既知折返しは、対応形式と連続性を確認して解析側だけ65536 msを加算する。任意の逆行を折返しとして救済しない。時間重みを作る前に正差分を確認する。ユーザー方針により、この対策のためファームの時刻形式は変更しない。
- 距離基準ログに固定の11ms上限や特定速度の3～7mm範囲を流用しない。logDistanceTargetMm、速度、1ms量子化、残余持越し、期待行数、raw左右積算平均の距離差を合わせて欠落を調べる。大きな時刻間隔だけで処理落ちと断定しない。
- load境界でraw積算と補正座標を区別する。DISTANCE/SLIPのencTotalOptimal後退は、マーカー遷移と当該コード・設定の補正上限を照合する。後退を一律拒否も無条件許可もしない。物理進捗・記録間隔の健全性はraw左右平均の差分とlogDistanceTargetMmで確認する。補正座標は正差分だけ抽出しても小さいマーカー補正を含むため、記録間隔の検査へ使わない。新規解析の図生成前に一次・DISTANCEを含む代表ログでload/metricsを実行する。詳細は[補正距離の正差分での再発](../../../../doc/失敗事例/2026-10-04-corrected-log-distance-backsteps.md)。
- XY再計算では計算版を先に確認する。現行版2はraw左右累積値の平均距離差と保存済みimuAngle_Zの両端平均を使い、負差分・半パルスを保持する。encTotalOptimalのマーカー補正を混入させない。旧版1のXYは補正距離から計算された過去値として区別し、新版のXYと同じ意味に読み替えない。疎なgyro再積分は旧形式の近似として明示する。
- mm/msの数値はそのままm/s。encCurrent[pulse/ms] / PULSE_MILLIMETERでm/s、加速度gにはGRAVITY_MPS2を掛ける。速度の既知範囲と距離/時間の独立計算で換算を確認する。

## 完走・比較条件

- PATH_CURVEの実機逸脱が報告されたときは、内部XY・pathErrorY・emcStopだけを採否に使わない。物理観測ラベルを先に保存し、保存センサーの明部0区間とpathStateを照合する。センサーの距離基準記録から得た時間は近似として記載し、1msでの連続消失時間とは区別する。TRACE内の同一推定器による自己整合と独立な物理追従を区別する。詳細と検証コマンドは[PATH_CURVEの観測限界](../../../../doc/失敗事例/2026-10-26-path-curve-odometry-hides-physical-drift.md)。

- 新判定の実走対象・書込境界は、ユーザー指定、実機書込証跡、保存メタデータ、原本ハッシュを別々に保持して照合する。同じ版・閾値・ビルド時刻が旧新対象に共存する場合、記録一致だけで初回新判定・変更後本数を断定しない。2026-10-18の訂正では新二次13505以降、一次13504を横誤検出の陰性対照とし、13500～13503は新評価件数へ含めない。詳細は[対象所属の訂正](../../../../doc/失敗事例/2026-10-18-slip-cohort-metadata-ambiguity.md)。

- XYずれを許容幅に使う比較では、ログ自体の健全性・ユーザー指定基準・PATH経路元の適格性を分ける。一次のclosureValid=0/reason=8を、正常終了した指定XY基準の一律拒否へ流用しない。閉路値/理由を別に残し、PATHの±60mm制限は変更しない。詳細は[比較基準と経路元の混同](../../../../doc/失敗事例/2026-10-18-xy-reference-route-eligibility.md)。

- 連番やemcStop=0だけで完走としない。モード、終了メタデータ、期待行数、経路終端または当時のゴール条件を確認する。右マーカー数はSG加算数ではない。PATH系は経路弧長終端を使い、旧ログへ現在のSG回数を押し付けない。
- autoStartは系列・一次参照・run番号1～5と全走の完走を確認する。1本でも欠落・失敗・未完了ならセット全体を採用比較から除外し、診断用として残す。
- 中断を含む系列の集計前にprimaryLogNumberで所属を作り、観測run・欠落run・停止ログを確認する。一次番号からの5連番で次系列を補わない。正常PRIMARYの単独診断と完了系列の性能比較を分ける。確認例は[中断系列の所属](../../../../doc/失敗事例/2026-10-16-interrupted-series-log-membership.md)。
- 性能の計算前に、方式、要求方式、run番号、一次/SLIP参照、速度表全体、加減速/lead、PID、FF、電圧、校正、スキーマ、ビルドを比較表へ出す。同一gitCommitでもSD設定は違う。終了ヘッダのPIDはchangeGain()による動的切替値の場合がある。
- 通常性能と低電圧ストレス・手持ち/空転を分ける。平均・最小電圧と比較適格理由を出し、過去の電圧しきい値を固定ルールへ戻さない。
- PWM/電圧飽和とlapの相関を因果や改善と呼ばない。速度追従、スリップ、完走、出力余裕を同じ条件内で評価する。

## イベント・推定・集計

- 閾値の疎な残差リプレイ前に全走のTotalMs/ValidMs/IntervalReasonと瞬時Validを検査する。開始42msのみ無効を他走へ流用しない。区間内の有効位置が分からない混合区間は任意配置せず除外し、全有効かつ両端有効な区間だけで近似する。実記録有効時間と近似採用時間を分け、無効境界で継続状態をリセットする。詳細は[途中低速・再充填](../../../../doc/失敗事例/2026-10-18-slip-replay-validity-segments.md)。

- 最新の正解ラベルの決め方は[XY→動画→最終ラベル](../../../../doc/slip-evaluation-policy.md)を参照する。先に基準一次とのXY差を判定し、その後動画を確認する。動画不確定時はXYを正として閾値調整に使い、動画が明確な場合は動画を採用する。基準一次の未特定・欠測を正常ゼロで埋めない。

- 横補正候補版2は候補専用ON 5.0/OFF 4.2m/s²をslipLatCandidateOn_mps2/Off_mps2へ記録する。既存slipLatOn_mps2/Off_mps2は初回SHADOW横4.6/3.8の意味を維持する。版1の過去比較と版2を同じ閾値として混ぜない。正解窓は動画の動きと実画像で確定し、想定周回数で件数を固定しない。詳細は[候補閾値版2](../../../../doc/slip-lateral-candidate.md)。

- 6点校正の初期化を800/1100/1400pxだけで十分と仮定しない。13500～13503では500/650/800/1100/1400/2000pxの開始値を確認し、fit点と実測高さのコストだけで解を選んだ。候補コスト・画素所属・独立留保残差を保存し、同じ別解に収束した場合も品質ゲートを緩めない。

- 動画の床校正では可視点数を明示し、未観測点をfitデータへ補完しない。可視点が少ない場合はfit_pointsで追跡の配列境界も揃える。数値初期値を再探索するときはfit点と実測高さだけのコストで解を選び、候補・採用コストを保存して独立留保点で検証する。留保点・走行ログ・滑りラベルで解を選ばない。

- 動画の床校正は、点数一致・ソルバーsuccessだけで受理しない。機体上の赤系領域を床点と混同していないか実画像で確認し、fit点と未使用の留保点の残差をprepare/track/analyzeの各入口で検査する。品質ゲート超過は追跡前に停止し、修復は実測画像の対応付けだけで行う。13438～13442では10mm以上を停止条件とし、これを物理位置誤差上限や滑り閾値へ読み替えない。詳細は[床点所属の再発](../../../../doc/失敗事例/2026-10-17-video-color-marker-identity.md)。

- 撮影モード/解像度/fps変更時は実ファイルのPTS・寸法と実画像の床点所属を再確認し、旧動画の画素座標をそのまま使わない。追跡開始前に、校正と追跡で同一の復号/スケーリング/HSV/重心/可視条件を使用しているか、同じ静止フレームを両経路へ通して検査する。床点変化量が初期画像でも大きい場合は、品質ゲートを緩めず抽出条件の差を調べる。不可視点を近傍の別マーカーで補わず、可視性が確認できた参照時刻と根拠を保存する。手法修正前の中間物を保全し、方法版・元画像ハッシュ・旧新有効率・独立シーク中心照合を出す。詳細は[復号と床色域の不一致](../../../../doc/失敗事例/2026-10-17-video-color-marker-identity.md)。

- 13500～13503では、全連結成分を抽出した後に中心のROI内外・床点近傍で候補を絞り、色マスク自体の切抜き・床点周囲塗潰しをしない方式を検証した。ROI外の成分は欠測とし、残った断片へ中心を寄せない。事前検算にも本体と同じ候補選別条件を適用する。旧17走の定量不採用は再追跡するまで維持する。

- 全動画の追跡に進む前に、ROI境界に近い走行中の実フレームで全色成分とROI後の面積・中心を照合する。床点凸包は機体マーカー全体を囲むとは限らない。ROIで色成分を切断した重心を真の中心とせず、ROIは候補中心の絞込みに使う。独立中心検算が不合格なら動画の定量採用を止め、ログの健全性とは分けて不採用を記録する。正常なゼロへ置換せず、動画不確定なら指定XY基準へ戻す。詳細は[ROI切断の追記](../../../../doc/失敗事例/2026-10-17-video-color-marker-identity.md)。

- 動画照合では、色・面積・既知の中心間距離だけでマーカー所属を確定しない。校正の留保床点、時間的連続性、外れ値の前後実画像を確認し、ログのgyroに合わせて追跡値を修正しない。補間表示と有効観測を分け、各走・評価窓の被覆率と欠測を保存する。集計前に各走・各窓幅の有効窓件数を確認し、0窓なら品質未達として速度指標は未記録、窓数・被覆率は0で保存し、他走の集計を継続する。0窓のassert停止や品質ゲート緩和、正常ゼロへの置換は行わない。PTSはパケットの提示順・件数を照合する。詳しくは[動画色マーカーの所属](../../../../doc/失敗事例/2026-10-17-video-color-marker-identity.md)。

- 周回照合前にCROSS全件の時刻・保存積算方位を出す。13514の開始4ms/方位約0.05度の追加CROSSのように位相照合できない場合、そのログだけXY未判定として保持し、他ログの数値・ON位置集計は継続する。原本の先頭イベントを0へ置換して検査を通さない。詳細は[先頭CROSS照合](../../../../doc/失敗事例/2026-10-18-initial-cross-lap-validation.md)。

- CROSS存在と姿勢フィット品質は別に検証する。品質不足イベントだけ理由付きで除外し、有効通過数と実際の比較周回数を出す。飛ばしたイベント間を1周と数えない。
- CROSS確定には検出位置と幅確認の遅延がある。IMU位置同定では独立ラインイベント・素子位置・アンカー±20mm感度・積分則感度を確認する。最適値の安定だけで物理レバーアームを採用しない。
- Yaw融合では学習/留保を固定し、ソルバー終了理由・制約到達・数値検算・物理妥当性を分けて出す。gyro地図や設計DXFへの距離を真のYaw精度と呼ばない。平均地図/各一次地図/独立形状で参照依存性を確認し、評価結果で係数を選び直さない。
- 解析ユーティリティは必要キーと前処理を読む。既存Yaw解析の依存順はwindows→attach→observation_masks。
- 直線形状・指令加減速・観測Yawは別ラベル。ぶれの解析で実gyroの小ささを直線選別に使わない。
- 空の方式/区間は集計行を作らず標本数を残す。主表だけでなくログ別・感度表・全図入力も有限値検査し、JSONはallow_nan=Falseで保存する。欠測を0や正常値へ置換しない。
- 曲線は同一系列内のxを昇順・重複なしにしてから結ぶ。数値誤差上限は離散式・保存型から導き、assert失敗に合わせて恣意的に緩めない。全グラフを保存後に確認する。

- 校正prepareを組み立てる前に、新動画の初期像と旧床点探索中心の重なりを確認する。床マーカー据置・同解像度でも画角の据置とは限らない。ずれた旧画素を可視点として扱わず、今回実画像で所属を確認した床点の実測中心を使う。シーク画像生成execがsession_idを返したら、write_stdinで終了コード0・新画像の実在を確認してからview_imageへ進む。詳細は[午前動画での追記](../../../../doc/失敗事例/2026-10-17-video-color-marker-identity.md)。

- 過去文書に凍結スキーマ名が記載されていても現チェックアウトの存在を保証しない。`rg --files robotrace_v2/Core/Inc -g "log*"`で現行のlog_schema.h/logBinary.h/logSource.hを列挙してから読む。V2正式採用後は旧凍結ファイルを解析の前提にしない。

- 新規動画の校正コードを書く前に全初期画像で可視床点ID・数を棚卸しし、固定8点assert/切出し/配列境界を禁止する。2026-10-26の動画004では左下点が観測できず、7点fit＋4点留保で検証した。赤黄未観測時の機体外形中心は同一方向・固定床位置の相対変位だけに限定し、全採用通過の原フレームと測定線感度を確認する。詳細は[点数固定の再発](../../../../doc/失敗事例/2026-10-17-video-color-marker-identity.md)。
- Pythonのバージョン名フォルダの存在をpython.exeの実在とみなさない。Get-Commandと実体のTest-Path Leaf後、その実体で必要モジュールのspec/import/版を検査する。依存導入前に既存解析のsys.pathと局所depsを確認する。詳細は[動画ランタイムの再発](../../../../doc/失敗事例/2026-10-04-noise-analysis-input-preflight.md)。

## 2026-10-30：固定C再生と未確定tmpの入力契約

凍結exeのコマンド名だけから入力を推測しない。実ハーネスのfscanf/出力ヘッダと既存生成器を先に読み、real_replayには元CSVではなく15速度値・6整数設定値・19列の区間テキストを渡す。全原本SHAと全入力の有限性・列数・時刻差をコンパイル/再生より前に検査する。今回の入口はanalysis/script/replay_unmatched_first.py（C20/C21×O0/O2×10走）。[入力契約の再発](../../../../doc/失敗事例/2026-10-28-derived-analysis-helper-dependency.md)参照。

仮定付きtmpでは、左右それぞれの累積値を単調増加と仮定しない。逆回転を表現できる符号規約と時間に対する絶対変化幅を照合し、保存値の符号を保持する。元CRCなしの帰属限界、完全512B境界による除外、過去レコードの全バイト照合を維持する。今回の入口はanalysis/script/recover_tmp_13912.py、diagnose_tmp_13912.py。[13912の部分診断](../../../../doc/失敗事例/2026-10-18-unsealed-tmp-partial-recovery.md)参照。

## 2026-10-30：録画全体と実走区間の品質を分ける

長い停止後映像を含む動画では、元追跡の全体有効率を残し、ユーザー指定対応とgyro/運動同期で求めた実ログ先頭～末尾の全区間にも同じ有効率閾値を適用する。欠測を正常へ補完せず、両区間の有効率・境界・元画像を保存する。都合のよい部分区間を選ばない。入口はanalysis/script/compare_unmatched_first.py、13922の全体65.52%/実走100%と停止後の機体不在を確認済み。[走行後映像の品質区間](../../../../doc/失敗事例/2026-10-30-video-post-run-coverage.md)参照。

## 2026-10-30：周回の増加傾向を結論づける前

最大変位・最終変位の範囲だけで、周回の増加傾向がないと判断しない。全通過の図を確認し、全点と初回を除く傾き・単調性・数値を保持する。5点の傾きは診断であり真のバイアスや長周回予測ではない。映像の外形投影と、前方約95mmの白線観測・内部方位・車体基準点を同一視しない。入口はanalysis/script/pass_diagnostics_unmatched_first.py（50通過の全56保存列、実Cの重心O0/O2一致）。残留増加を無視した完了判断をしない。[周回傾向の説明訂正](../../../../doc/失敗事例/2026-10-30-path-trend-overstatement.md)参照。

## 2026-10-30：色点方位の合成入力と投影契約

前後点の測定器を合成検証するときは、ぼけ長をX/Yカーネル幅と混同せず、実支持長・色の平均化・点間隔・量子化による正常/棄却条件を実行前に決める。投影の理論精度、レンズ逆補正の反復収束、実画像の画素/露光/高さ差は別に検証する。不一致に合わせて色/幾何ゲートを緩めない。新しい測定器では再投影一致も確認し、既存の共有校正と過去証跡は保持する。入口はanalysis/script/validate_body_marker_heading.pyとfinalize_body_marker_heading.py。合成90条件の0.733degを実機精度へ転用せず、高さ差1mmでも今回最大1.221degとなる感度を示す。完成済み検証は凍結されているため、仕様変更時は新フェーズへ保全してから実行する。[合成入力と逆投影](../../../../doc/失敗事例/2026-10-30-marker-synthetic-projection-contract.md)参照。

## 2026-11-01：PowerShellメタデータ棚卸しの構文

foreach文を直接パイプへ接続せず、`$items = foreach (...) { ... }; $items | ConvertTo-Csv`のように結果を配列へ保持する。同種のゲイン比較では`analysis/script/read_braking_metadata.ps1`を入口とし、明示したリポジトリworkdirから`powershell.exe -NoProfile -ExecutionPolicy Bypass -File analysis/script/read_braking_metadata.ps1`を実行する。入口はPowerShell Parserで直接接続の拒否と配列経由の受理を先に検査し、CSVの存在確認後に読み込む。[再発と検証](../../../../doc/失敗事例/2026-11-01-powershell-foreach-pipeline.md)参照。

HTML属性や複雑な引用符を含むNode検証はPowerShellのnode -eへ埋め込まず、analysis/script/validate_braking_13993_13994.cjsのようなファイル入口を使う。Node実体とファイルパスだけを渡し、入力SHA・埋込み対象・JavaScript構文を検証する。CLI引用符だけの失敗では完了済み集計やHTMLを再生成しない。

## 2026-11-01：ゴール後の未照合停止と周期未確定

ゴール後の停止は、SG終値・emcStop・pathLoopPeriod_mm・終了時未照合時間・保存明部を分けて確認する。period>0向け白線延長の検証成功をperiod=0へ流用しない。13989～13991・13993はユーザー完走確認済みだが、周期0・白線可視のまま未照合150msで停止7。入口はanalysis/script/diagnose_goal_tail_13989_13993.py、証拠はanalysis/goal_tail_13989_13993/report.md。物理逸脱は疎な保存値から確定しない。

ログ実装の検索もCore/Srcの実在親と-g '*.c'から始め、logBinary.c等のファイル分割を推測しない。rg終了2以上で後続へ進まない。新規文書追加は単独パッチで確定し、既存文書更新は直前に読んだ完全行だけをアンカーにする。拒否後は全対象の部分適用を確認し、完了済み解析を保全する。失敗記録はdoc/失敗事例/2026-11-01-goal-tail-investigation-preflight.md。周期未確定の実機終端問題はdoc/失敗事例/2026-10-28-path-white-map-goal-extension.mdの11/1追記を参照する。

## 2026-11-01：空区間を含むCSVの出力列

速度フェーズ等で空区間を残すとき、CSVのfieldnamesを先頭行だけから決めない。全行のキー和集合または固定スキーマを保存前に確定し、空→有効の最小例と実CSVの全行列幅を確認する。rows=0/seconds=0を保持し、未観測指標は空欄としてゼロへ置換しない。集計JSON保存後の出力失敗では原本と完成済みJSONを保全する。[速度フェーズの空区間](../../../../doc/失敗事例/2026-11-01-speed-phase-empty-csv-schema.md)参照。

## 2026-11-01：直線減速は速度目標の型も確認する

速度異常調査の初回検索はCore/Src親と-g '*.c'へ固定し、interrupt.c等の分割を仮定しない。TIM処理は現チェックアウトではtimer.c。rg終了コード2以上なら同じ呼出しの後続を停止する。新規診断のdictと**展開のキー重複を生成前に照合する。実関数抽出Cは製品とホストのwarning設定差を先に確認し、既存符号比較warningを回避するために製品式を変更しない。必要な例外はwarning種類を限定し、原診断を保存する。[調査入口の再発](../../../../doc/失敗事例/2026-11-01-primary-roc-investigation-preflight.md)。

ROCが小さいという申告でも、一次保存ROC・経路生成半径・計画速度・PIDへ渡る速度目標・停止理由を分離する。最大速度×PULSE_MILLIMETERを算出し、制御変数とログ型の表現範囲を検査する。14008/14010/14011/14013は4.6m/sの266pulse/msがuint8_tの10へ折り返し、停止6。入口はanalysis/script/verify_speed_wrap_14012.py、証拠はanalysis/primary_roc_14012/report.md。約4.41235m/sが境界で、実機とログの型を揃えるまで原因記録はopen。[速度目標の8bit折返し](../../../../doc/失敗事例/2026-11-01-target-speed-u8-overflow.md)。

## 2026-11-01：比較補助の標準スカラーと描画環境

NumPy配列から既存の標準statistics使用補助へ行辞書を渡す前に、値をPythonのfloat/int/boolへ変換する。NumPyのbool比較結果はstatistics.meanで受理されると仮定しない。ランタイムworkdirの依存調査とファーム読取を別呼出しにし、跨ぐ読取は絶対パス、Gitはgit -Cで対象を固定する。Playwrightはライブラリとブラウザ実体を別々に存在確認し、このWindowsのheadless Edge描画検証は初回から必要な実行権限を選ぶ。sandbox一時プロファイルのJSON置換error=-5後は同条件で反復せず、許可された実行環境で表示検証だけ再開する。入口はanalysis/script/compare_distance_wobble_14025_14027.pyとverify_distance_wobble_chart.cjs。実一次2本の参考区間生成・736/360px描画に成功。[14025/14027解析の事例](../../../../doc/失敗事例/2026-11-01-distance-wobble-analysis-preflight.md)参照。
## 2026-11-01：1ms証拠が空のゲイン推定

全ログの行数が十分でも、ゲイン推定の1ms連続3点等の証拠マスクは0件になりうる。median/mean/FFT等の前に採用件数を検査し、0件はsamples=0と未観測指標の省略で保存する。NaN生成や正常0への置換をしない。低速一次と高速二次を同じ入口へ通し、Python -W errorで空・有効の両方を検証する。入口はanalysis/script/diagnose_speed_wobble_14029.py。実一次2本の0件と二次542/786点・有限JSON保存を確認。[14029の空証拠](../../../../doc/失敗事例/2026-11-01-speed-wobble-empty-gain-evidence.md)参照。

## 2026-11-01：走行別ログ検証器の生成

生成前に[走行別ログの前提](../../../../doc/失敗事例/2026-11-01-mode-log-diagnostics-preflight.md)を読む。展開前DEBUG/CURRENTの同名列を実列重複と混同しない。宣言の併合は型・書式・式の一致を確認し、実列の一意性・サイズは通常/詳細×走行方式ごとの展開済みスキーマで調べる。C抽出は戻り値型と関数名に限定し、if内呼出を採用しない。テンプレートのFFなどを逐次str.replaceせず、単語境界付き単一パスで置換する。subprocess出力はbytesで保存してから復号し、CRLFは解析時だけsplitlinesで正規化する。Markdownの見出し差替えも改行を正規化して照合し、元の改行形式で保存する。匿名enum同士のstatic_assert比較は同じ整数型へ変換し、ARM全体ビルドの新規warningを照合する。入口は`validation/mode_log_diagnostics/run.py`と`finalize.py`。

## 2026-11-01：ライン診断の使用周期と保存周期

ゲインの説明前に、対象番号ごとのlineKpUsed/lineKdUsed/lineGainStateの全組合せを出す。14033の終了Kd2を14034へ転用しない。14034はP2/D0とP5/D12で、終了値はP2/D0。左右目標は実記録を優先し、共通targetSpeedからの再構成はPID後のprocessMarkerEvent更新点を確認する。実14034の12不一致行は全てマーカー行で、非飽和輪から復元した使用目標で左右とフラグが整合した。一次の1ms連続証拠0件も未観測として保持する。入口はanalysis/script/diagnose_line_log_14033_14034.py、[周期境界の訂正](../../../../doc/失敗事例/2026-11-01-line-log-real-sample-boundary.md)。

## 2026-11-01：PATH_CURVEの曲率・速度計画を調べる前

ソース検索はリポジトリルートから`powershell.exe -NoProfile -ExecutionPolicy Bypass -File analysis/script/search_pathcurve_sources.ps1`を入口とする。実在Core/Srcの存在検査後、`rg -n <pattern> <directory> -g 'path*.c'`を使い、パス引数へpath*を置かない。未知ファイルは実在親のrg --filesで確定し、native終了2以上なら後続へ進まない。[11/1の検索再発](../../../../doc/失敗事例/2026-08-11-windows-rg-glob-not-expanded.md)。

PC再生成の前に一次の長さ/経路間隔/予約点/保存最大optimalIndex/実ヘッダ容量を照合する。マクロ値を推測しない。現行容量と実走記録が不一致ならビルド同一性を未確認とし、診断専用容量拡大を機体計画の完全再現と呼ばない。bin全CRC・保存RAM・実ビルドを未照合なら、その限界を報告へ残す。[診断容量の契約](../../../../doc/失敗事例/2026-11-01-pathcurve-diagnostic-capacity-contract.md)。
