Kageyana/robotrace_v2/.agents/skills/robotrace-tuning/references/failure-prevention.md

# 制御調整の再発防止

## 試行の設計と採否

- 実機変更後の対象番号はユーザー指定と実機書込証跡を保存メタデータと別に確認する。13505以降が新二次、一次13504は横滑りの誤検出という2026-10-18訂正を保持し、13500～13503を新判定件数へ再加算しない。一次だから常に陰性と一般化せず、13504はユーザー確認の陰性として使う。詳細は[対象所属](../../../../doc/失敗事例/2026-10-18-slip-cohort-metadata-ambiguity.md)。

- 2026-10-18のユーザー指定によるV2改修では同じモータ指令電圧上限を同条件として扱い、電圧差のみで拒否しない。現行XY±20mmで系列別ラベルを固定し、明確な既存動画ラベルを保持する。XY陰性のON率は局所横誤検出率と同一視しない。疎な近似の有効境界はログ解析Skillの混合有効区間除外手順に従う。

- スリップの閾値選定は[XY→動画→最終ラベル](../../../../doc/slip-evaluation-policy.md)の順を守る。動画不確定時はXY判定を調整用の正として採用し、既存の明確な動画ラベルを消さない。走行全体のラベルと局所イベントを区別し、判定器出力を正解ラベルの根拠にしない。

- 解析Skillの入力・比較条件の確認を先に行う。1試行は原則1パラメータ、最大2個。基準・試験値・電圧帯・比較run番号・採否条件を解析出力へ記録する。
- autoStartの2～5走を混ぜた平均だけで採用しない。各run番号でlap、速度誤差p95、縦横判定、ライン/gyro指標、完走率とばらつきを比較する。前走スリップによる適応計画も条件に含める。
- speed_ff=160、EXPAND_1=0.40、EXPAND_2=0.20、LAT_EXTRA=0.25、LAT_RISK=0.15、LONG_RISK=0.03は過去条件で安定改善が得られなかった。新仮説・新しい観測なしに同じ試行を繰り返さない。これらを現行基準値の指定として使わない。
- 一部lapやスリップ率だけの改善で採用しない。RMSは数値と基準差を出し、ユーザーが許容した範囲内の小差を単独の不採用理由にしない。
- index限定cap/scaleは前後区間の連続性とlap/完走への副作用を確認する。まずセンサー正規化、曲率式、全体ゲイン、速度計画等の連続的な対策を調べる。
- 既知の基準値へ戻すだけなら値・SD再読込・必要なビルドで確認し、追加走行を一律必須にしない。新しい制御の採用には同条件10本以上が必要。
- 物理最大電圧8.4 Vや高速前7.5 Vを、測定値クリップや新たな自動走行禁止へ勝手に変換しない。現行定義と依頼された挙動の差だけを変更する。
- 診断追加前に既存ログ・静止読取で判別できるか確認する。一時列/APIが必要なら目的・終了条件・残すものを定める。過去36 B上限を復活させず、現行スキーマで負荷と互換性を検証する。不要な診断を常設しない。
- 安全ゲート・緊急停止・速度上限の変更はユーザーの依頼範囲を確認する。寸法測定完了だけを別のリスク境界変更への承認と解釈しない。既に明示承認された操作は再確認しない。

## 呼出し・センサー・実機の切分け

- PWM生成や品質フラグを再利用する前に全呼出し・全代入・状態・周期を検索する。未更新initCurrentのような名前だけの状態フラグを信頼しない。取得アダプターと検出器単体を分けて確認する。
- 開始前lineTraceCtrlと走行用lineTraceOmegaFBCtrlを区別する。CSV列lineTraceCtrlは後者の出力。センサー更新→目標角速度→実角速度→左右速度/電圧を順に確認し、ADC修復成功を完走回復と同一視しない。
- ライン校正では生AD/正規化・白黒の大小・検出と中央合わせを照合する。既存PIDの開始前呼出周期、ライン/角速度PIDの排他、停止後の古いPWM再出力がないことを確認する。
- 平均速度0の位置合わせで通常走行と同じ始動余裕があるとは仮定しない。P/G/S/X等の実診断値で出力不足・捕捉・制動・ロストを分け、ユーザー調整で復帰したら未依頼のPWM補償や角速度下限を重ねない。
- PCモデルは符号・状態遷移の検証であり、実機摩擦・惰性・白線幅・光学応答の保証ではない。現在の9調整項目とユーザー調整値を過去試作値へ戻さない。
- 動画を正解として閾値を選ぶときは、全入力動画の存在・保存SHA256を確認し、同じ画像解析条件でラベルを検証する。正例数を想定周回数へ固定せず、観測候補の全画像を確認する。走行単位で選定用/確認用を先に固定し、検出器出力をラベル抽出へ使わない。正例走行の未ラベル区間を陰性へ変換しない。疎な残差の補間再判定は近似と明示し、実記録旧ON時間と近似新ON時間を直接差し引かない。動画閾値版は候補専用定数と版・メタデータで区別し、制御採用・変更後同条件10走は別に確認する。詳細は[動画ラベルの件数前提](../../../../doc/失敗事例/2026-10-17-video-color-marker-identity.md)。

- 横残差の角加速度依存は、軸・位置・接線項・LPF/遅れを先に照合する。回帰係数を物理補正へ直結せず、候補ON率低下だけで採用しない。保存された適用済み項を使い、二重補正しない。
- PATHのロスト判定は最近傍接線誤差と先読み操舵誤差を分ける。ヘアピンの目標飽和、実gyro、横/方位誤差、fallback、正常終端を同条件で確認する。kHeading低下を常に安定化と仮定しない。

## 2026-10-30：定数を可変にしたPC候補の基準一致

実Cの定数をPC試験用の実行時パラメータへ置換した場合も、候補の数値や順位を読む前に、既定値の全入力トレースを凍結版へ同じO0/O2で全バイト一致させる。-fexcess-precision=standard/-ffloat-storeだけで定数式と実行時式の保存条件が同じとは仮定しない。差が出たら候補評価を止めて最初の差・ソース・exe・ログを保全する。既定分岐の元式を維持し、保存floatの識別と最終出力の一致を検査する。入口はanalysis/script/probe_path_initialization.py（共分散9組、基準22走、O0/O2）。[初期共分散での再発](../../../../doc/失敗事例/2026-10-12-host-float-snapshot-comparison.md)参照。

## 2026-11-01：計画ROCの先読み条件

4点先が500mm以下でも2点先は3000mmになり得る。進入と復帰のROC条件を排他的と仮定せず、保持中の理由bit3が進入直後にも立つことを境界fixtureへ含める。実測独立性と旧方式へ十分大きい実測を与えた基準との一致はvalidation/plan_roc_gain/run.pyで確認する。固定入力31件の判定差を、実機閉ループの改善へ転用しない。[fixtureの事例](../../../../doc/失敗事例/2026-11-01-plan-roc-gain-fixture.md)。
