Kageyana/robotrace_v2/Circuit/robotrace_v2_Extended_UI/robotrace_v2_Extended_UI.pdf

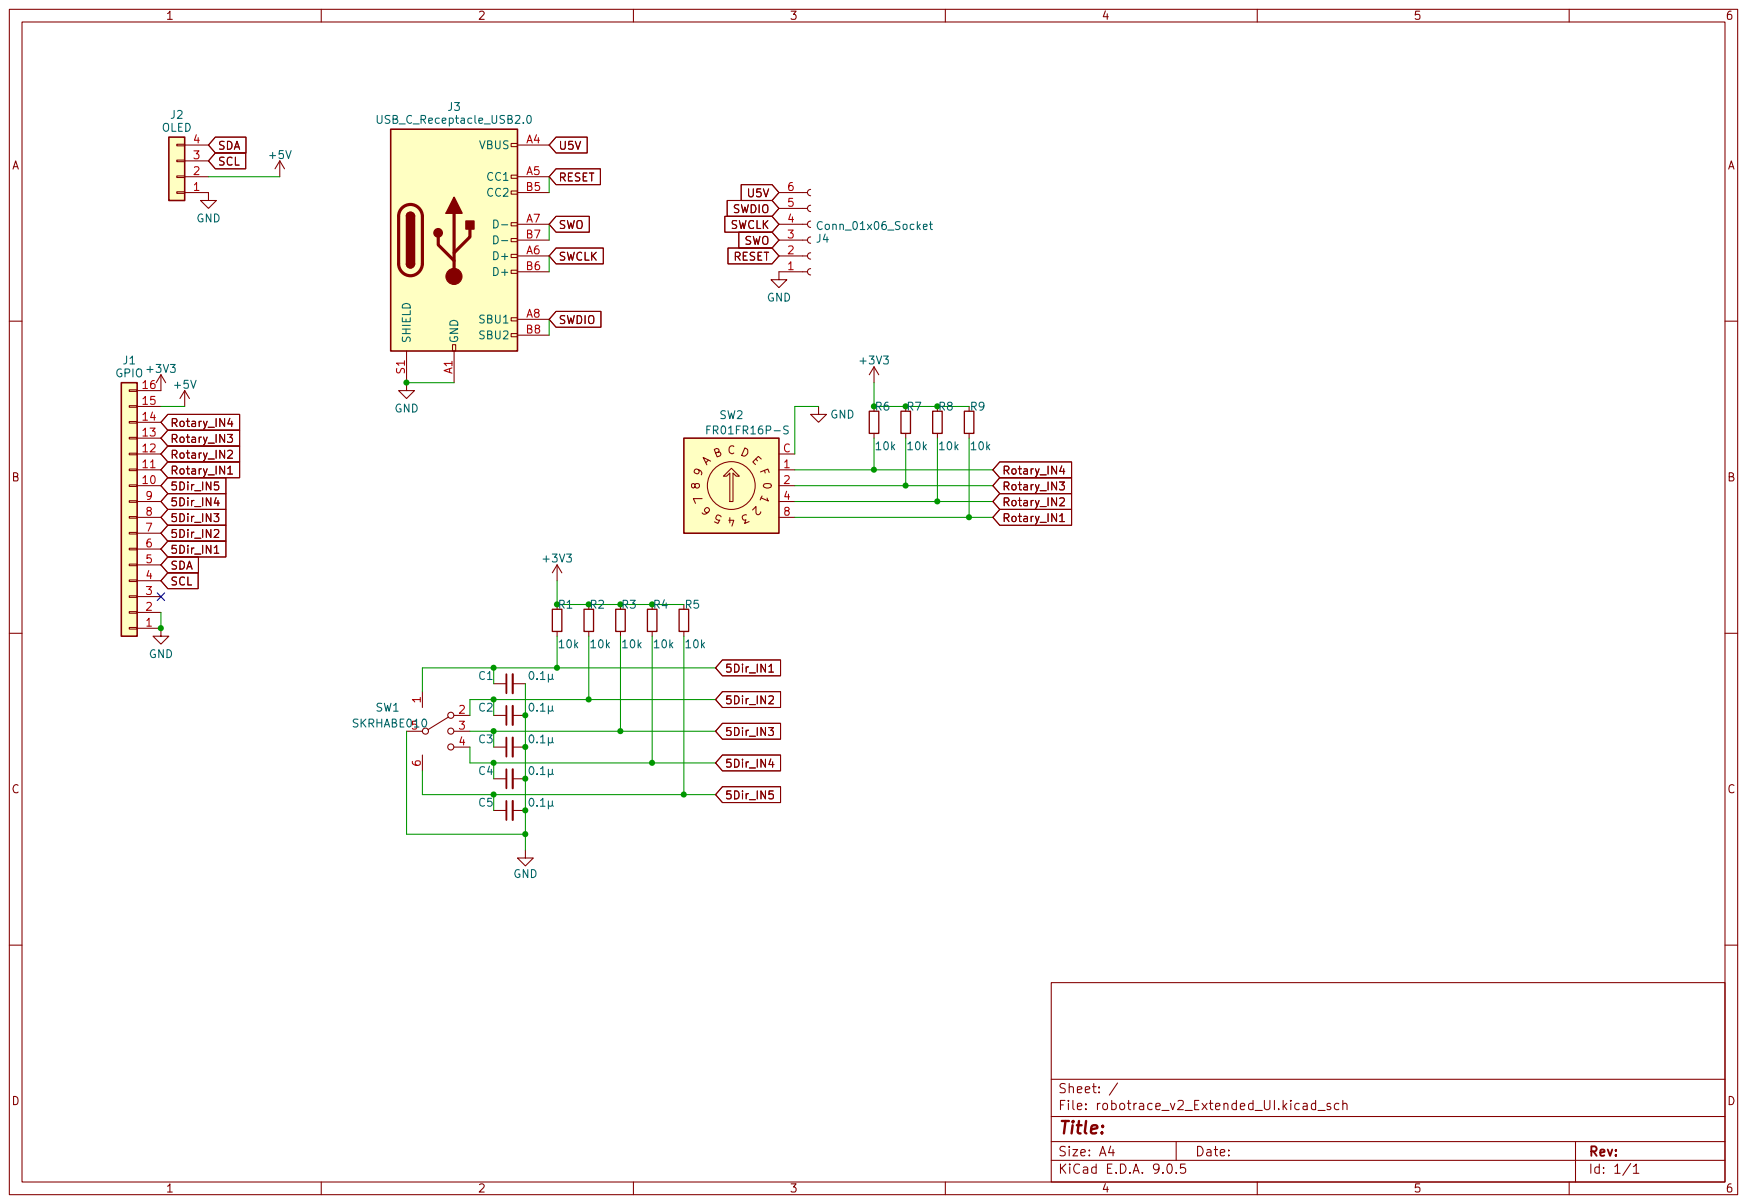
[picture p46: page 1]
