Kageyana/robotrace_v2/Circuit/robotrace_v2_Linesensor/robotrace_v2_Linesensor.pdf

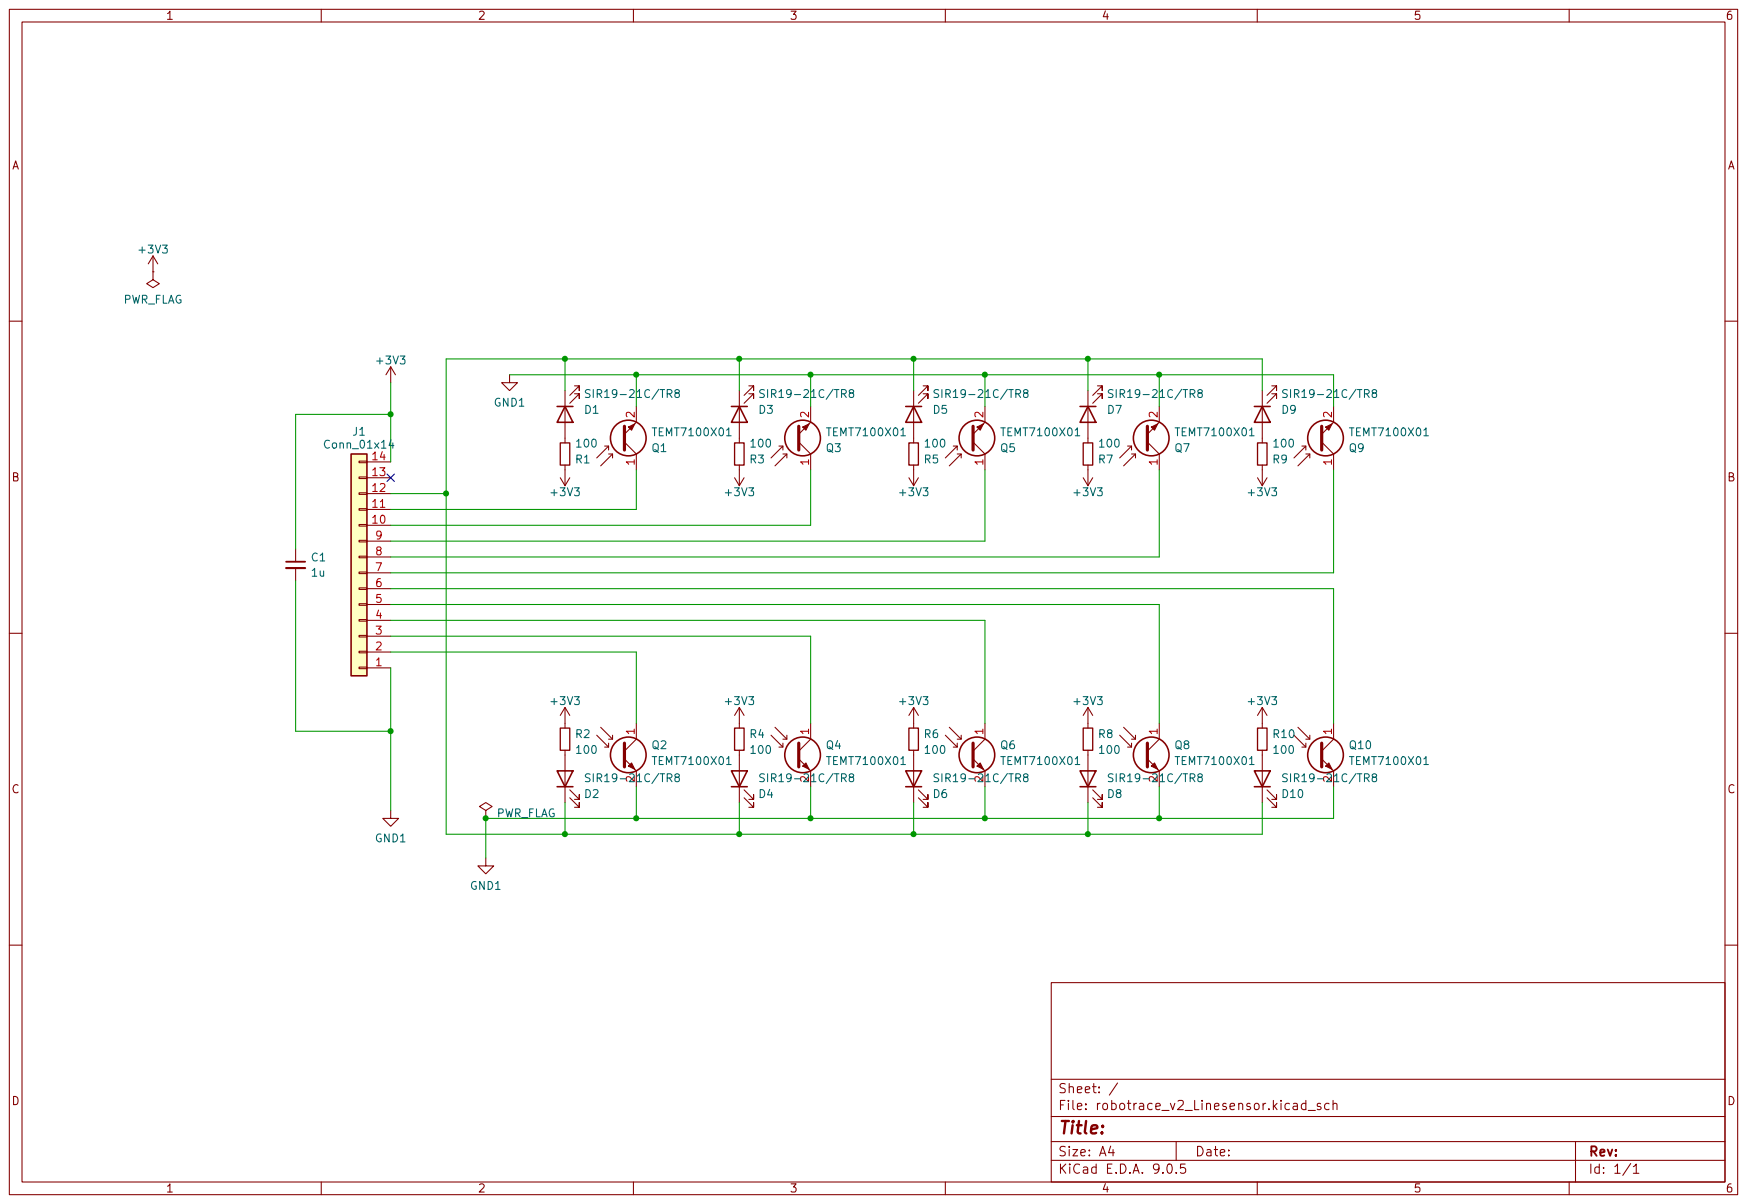
[picture p47: page 1]
