Kageyana/robotrace_v2/Circuit/robotrace_v2_main_v2/robotrace_v2_main_v2.pdf

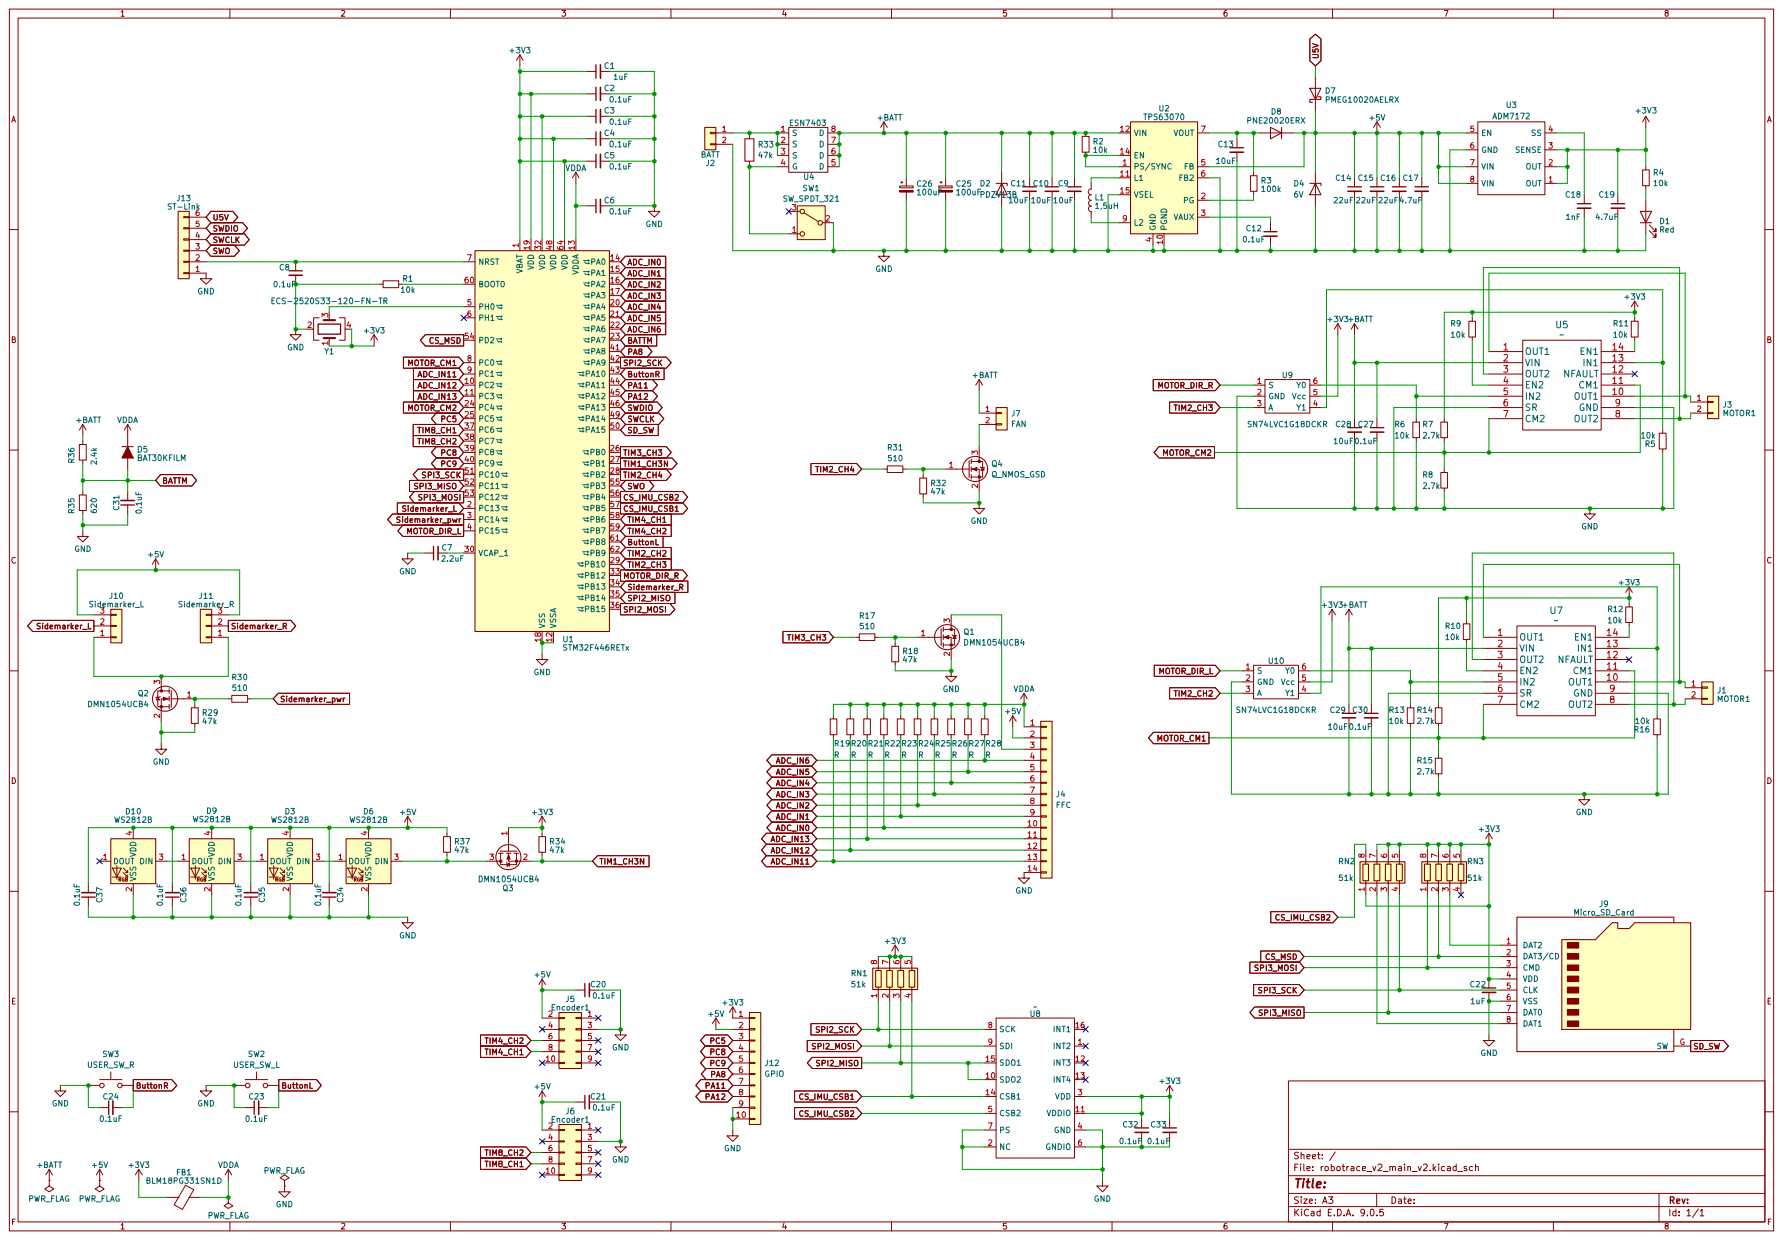
[picture p48: page 1]
