Kageyana/robotrace_v2/Circuit/robotrace_v2_Sidemarker/robotrace_v2_Sidemarker.pdf

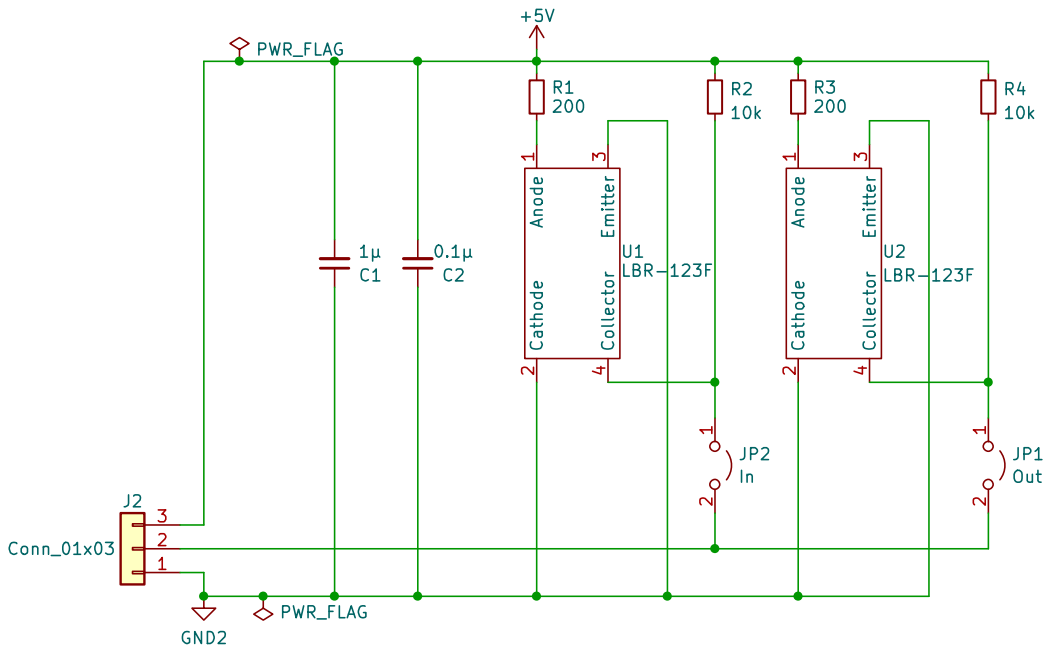
[picture p49: page 1]
