Kageyana/robotrace_v2/Circuit/robotrace_v2_main_v2/robotrace_v2_main_v2.kicad_pcb

## KiCad design Circuit/robotrace_v2_main_v2/robotrace_v2_main_v2.kicad_pcb (2026-10-03)

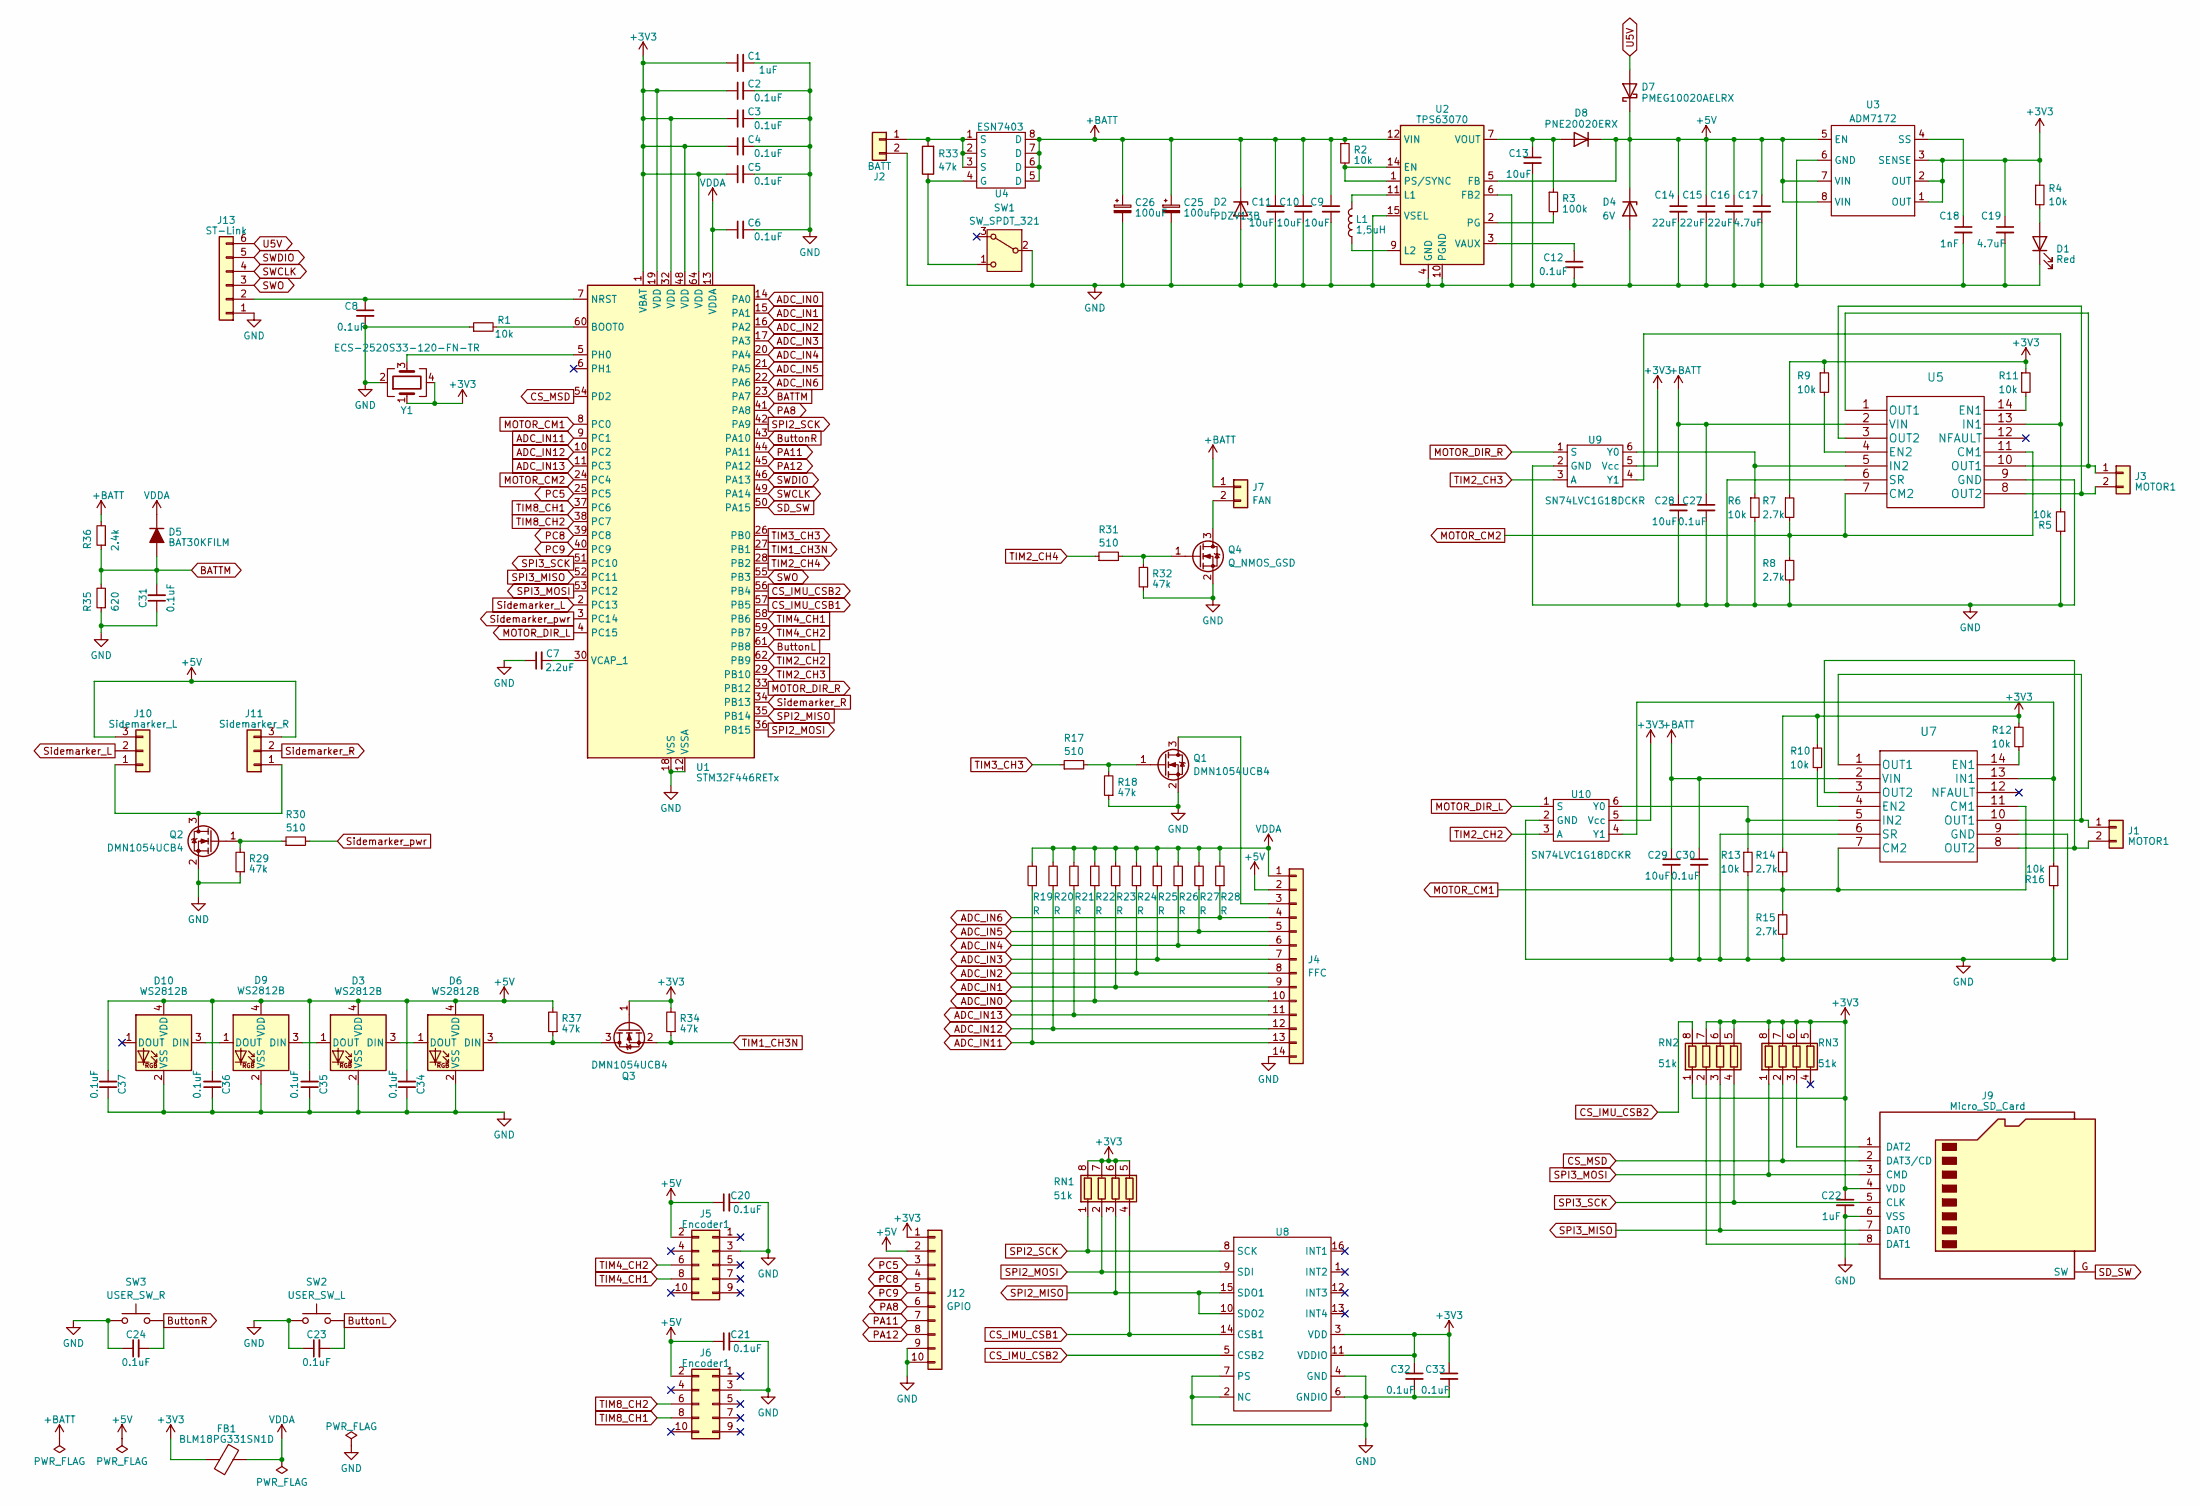
[picture p50: schematic robotrace_v2_main_v2.kicad_sch]

Parts:
C1, C22: 1uF; C_0402_1005Metric
C2, C3, C4, C5, C6, C8, C12, C20, C21, C23, C24, C27, C30, C31, C32, C33, C34, C35, C36, C37: 0.1uF; C_0402_1005Metric
C7: 2.2uF; C_0402_1005Metric_Pad0.74x0.62mm_HandSolder
C9, C10, C11: 10uF; C_0603_1608Metric_Pad1.08x0.95mm_HandSolder
C13: 10uF; C_0402_1005Metric
C14, C15, C16: 22uF; C_0805_2012Metric
C17, C19: 4.7uF; C_0402_1005Metric
C18: 1nF; C_0402_1005Metric
C25, C26: 100uF; CP_EIA-7343-15_Kemet-W
C28, C29: 10uF; C_0603_1608Metric
D1: Red; LED_0603_1608Metric_Pad1.05x0.95mm_HandSolder
D2: PDZV13B; D_SOD-128
D3, D6, D9, D10: WS2812B; WS2812C-2020
D4: 6V; D_SOD-123F
D5: BAT30KFILM; D_SOD-523
D7: PMEG10020AELRX; D_SOD-123W
D8: PNE20020ERX; D_SOD-123W
FB1: BLM18PG331SN1D; D_0603_1608Metric_Pad1.05x0.95mm_HandSolder
J1, J3: MOTOR1; Molex_mini-SPOX_1x02_P2.54mm_Horizontal
J2: BATT; Molex_mini-SPOX_1x02_P2.54mm_Horizontal
J4: FFC; Molex_FFC_1x14_P0.50mm_Horizontal
J5, J6: Encoder1; FTSH-105-01-F-D-K
J7: FAN; Molex_mini-SPOX_1x02_P2.54mm_Horizontal
J9: Micro_SD_Card; TF-SMD_TF-06A
J10: Sidemarker_L; JST_SH_BM03B-SRSS-TB_1x03-1MP_P1.00mm_Vertical
J11: Sidemarker_R; JST_SH_BM03B-SRSS-TB_1x03-1MP_P1.00mm_Vertical
J12: GPIO; Molex_FFC_1x10_P0.50mm_Horizontal
J13: ST-Link; JST_SH_BM06B-SRSS-TB_1x06-1MP_P1.00mm_Vertical
L1: 1,5uH; DFE252012P
Q1, Q2, Q3: DMN1054UCB4
Q4: Q_NMOS_GSD; SOT-23
R1, R2, R4: 10k; R_0402_1005Metric
R3: 100k; R_0402_1005Metric
R5, R6, R9, R10, R11, R12, R13, R16: 10k; R_0201_0603Metric
R7, R8, R14, R15: 2.7k; R_0402_1005Metric
R17, R30: 510; R_0201_0603Metric
R18, R29: 47k; R_0201_0603Metric
R19, R20, R21, R22, R23, R24, R25, R26, R27, R28: R; R_0603_1608Metric
R31: 510; R_0402_1005Metric
R32, R33, R34, R37: 47k; R_0402_1005Metric
R35: 620; R_0402_1005Metric
R36: 2.4k; R_0402_1005Metric
RN1, RN2, RN3: 51k; R_Array_Concave_4x0603
SW1: SW_SPDT_321; SS-1290
SW2: USER_SW_L; SKRPABE010
SW3: USER_SW_R; SKRPABE010
U1: STM32F446RETx; LQFP-64_10x10mm_P0.5mm
U2: TPS63070; Texas_TPS63070RNMR_EP2.6x3.1mm
U3: ADM7172; DFN-8_L3.0-W3.0-P0.50-BL-EP
U4: ESN7403; PDFN3x3-8L
U5, U7: MP6551GQB-P
U8: BMI088
U9, U10: SN74LVC1G18DCKR; Texas_R-PDSO-G6
Y1: ECS-2520S33-120-FN-TR; Oscillators_SMD_2.0x1.6

Connections:
+3V3: C1.1, C2.1, C3.1, C4.1, C5.1, C19.1, C22.1, C32.1, C33.1, FB1.2, J9.4 (VDD), J12.1, Q3.1 (G), R4.1, R7.1, R9.1, R10.1, R11.1, R12.1, R14.1, R34.2, RN1.5 (R4.2), RN1.6 (R3.2), RN1.7 (R2.2), RN1.8 (R1.2), RN2.1 (R1.1), RN2.5 (R4.2), RN2.6 (R3.2), RN2.7 (R2.2), RN3.5 (R4.2), RN3.6 (R3.2), RN3.7 (R2.2), RN3.8 (R1.2), U1.1 (VBAT), U1.19 (VDD), U1.32 (VDD), U1.48 (VDD), U1.64 (VDD), U3.1 (OUT), U3.2 (OUT), U3.3 (SENSE), U8.3 (VDD), U8.11 (VDDIO), U9.5 (Vcc), U10.5 (Vcc), Y1.1, Y1.4
+5V: C14.1, C15.1, C16.1, C17.1, C20.1, C21.1, C34.2, C35.2, C36.2, C37.2, D3.4 (VDD), D4.1 (K), D6.4 (VDD), D7.1 (K), D8.1 (K), D9.4 (VDD), D10.4 (VDD), J4.2, J5.2, J6.2, J10.3, J11.3, J12.2, R37.2, U2.5 (FB), U3.5 (EN), U3.7 (VIN), U3.8 (VIN)
+BATT: C9.1, C10.1, C11.1, C25.1, C26.1, C27.1, C28.1, C29.1, C30.1, D2.1 (K), J7.1, R2.1, R36.2, U2.12 (VIN), U2.13, U4.5 (D), U4.6 (D), U4.7 (D), U4.8 (D), U5.2 (VIN), U7.2 (VIN)
ADC_IN0: J4.10, R22.1, U1.14 (PA0)
ADC_IN1: J4.9, R23.1, U1.15 (PA1)
ADC_IN2: J4.8, R24.1, U1.16 (PA2)
ADC_IN3: J4.7, R25.1, U1.17 (PA3)
ADC_IN4: J4.6, R26.1, U1.20 (PA4)
ADC_IN5: J4.5, R27.1, U1.21 (PA5)
ADC_IN6: J4.4, R28.1, U1.22 (PA6)
ADC_IN11: J4.13, R19.1, U1.9 (PC1)
ADC_IN12: J4.12, R20.1, U1.10 (PC2)
ADC_IN13: J4.11, R21.1, U1.11 (PC3)
BATTM: C31.2, D5.2 (A), R35.2, R36.1, U1.23 (PA7)
ButtonL: C23.2, SW2.2, U1.61 (PB8)
ButtonR: C24.2, SW3.2, U1.43 (PA10)
CS_IMU_CSB1: RN1.4 (R4.1), U1.57 (PB5), U8.14 (CSB1)
CS_IMU_CSB2: RN2.8 (R1.2), U1.56 (PB4), U8.5 (CSB2)
CS_MSD: J9.2 (DAT3/CD), RN3.2 (R2.1), U1.54 (PD2)
GND: C1.2, C2.2, C3.2, C4.2, C5.2, C6.2, C7.1, C8.2, C9.2, C10.2, C11.2, C12.2, C13.2, C14.2, C15.2, C16.2, C17.2, C18.2, C19.2, C20.2, C21.2, C22.2, C23.1, C24.1, C25.2, C26.2, C27.2, C28.2, C29.2, C30.2, C31.1, C32.2, C33.2, C34.1, C35.1, C36.1, C37.1, D1.1 (K), D2.2 (A), D3.2 (VSS), D4.2 (A), D6.2 (VSS), D9.2 (VSS), D10.2 (VSS), J2.2, J4.14, J5.3, J6.3, J9.6 (VSS), J12.9, J12.10, J13.1, Q1.2 (S), Q2.2 (S), Q4.2 (S), R1.1, R5.1, R6.2, R8.2, R13.2, R15.2, R16.1, R18.1, R29.1, R32.1, R35.1, SW1.2 (B), SW2.1, SW3.1, U1.12 (VSSA), U1.18 (VSS), U1.31 (VSS), U1.47 (VSS), U1.63 (VSS), U2.4 (GND), U2.6 (FB2), U2.10 (PGND), U2.15 (VSEL), U3.6 (GND), U3.9, U5.6 (SR), U5.9 (GND), U7.6 (SR), U7.9 (GND), U8.2 (NC), U8.4 (GND), U8.6 (GNDIO), U8.7 (PS), U9.2 (GND), U10.2 (GND), Y1.2
MOTOR_CM1: R14.2, R15.1, U1.8 (PC0), U7.7 (CM2), U7.11 (CM1)
MOTOR_CM2: R7.2, R8.1, U1.24 (PC4), U5.7 (CM2), U5.11 (CM1)
MOTOR_DIR_L: U1.4 (PC15), U10.1 (S)
MOTOR_DIR_R: U1.33 (PB12), U9.1 (S)
unnamed: D1.2 (A), R4.2
unnamed: D3.3 (DIN), D6.1 (DOUT)
unnamed: D3.1 (DOUT), D9.3 (DIN)
unnamed: D6.3 (DIN), Q3.3 (D), R37.1
unnamed: C13.1, D8.2 (A), R3.1, U2.7 (VOUT), U2.8
unnamed: D9.1 (DOUT), D10.3 (DIN)
unnamed: J1.1, U7.1 (OUT1), U7.10 (OUT1)
unnamed: J1.2, U7.3 (OUT2), U7.8 (OUT2)
unnamed: J2.1, R33.2, U4.1 (S), U4.2 (S), U4.3 (S)
unnamed: J3.1, U5.1 (OUT1), U5.10 (OUT1)
unnamed: J3.2, U5.3 (OUT2), U5.8 (OUT2)
unnamed: J4.3, Q1.3 (D)
unnamed: J7.2, Q4.3 (D)
unnamed: J9.8 (DAT1), RN2.2 (R2.1)
unnamed: J9.1 (DAT2), RN3.3 (R3.1)
unnamed: J10.1, J11.1, Q2.3 (D)
unnamed: C8.1, J13.2, U1.7 (NRST)
unnamed: Q1.1 (G), R17.2, R18.2
unnamed: Q2.1 (G), R29.2, R30.1
unnamed: Q4.1 (G), R31.2, R32.2
unnamed: R33.1, SW1.1 (C), U4.4 (G)
unnamed: R1.2, U1.60 (BOOT0)
unnamed: U1.5 (PH0), Y1.3
unnamed: C7.2, U1.30 (VCAP_1)
unnamed: R2.2, U2.1 (PS/SYNC), U2.14 (EN)
unnamed: L1.2, U2.11 (L1)
unnamed: L1.1, U2.9 (L2)
unnamed: R3.2, U2.2 (PG)
unnamed: C12.1, U2.3 (VAUX)
unnamed: C18.1, U3.4 (SS)
unnamed: R11.2, U5.14 (EN1)
unnamed: R9.2, U5.4 (EN2)
unnamed: R5.2, U5.13 (IN1), U9.4 (Y1)
unnamed: R6.1, U5.5 (IN2), U9.6 (Y0)
unnamed: R12.2, U7.14 (EN1)
unnamed: R10.2, U7.4 (EN2)
unnamed: R13.1, U7.5 (IN2), U10.6 (Y0)
unnamed: R16.2, U7.13 (IN1), U10.4 (Y1)
PA8: J12.6, U1.41 (PA8)
PA11: J12.7, U1.44 (PA11)
PA12: J12.8, U1.45 (PA12)
PC5: J12.3, U1.25 (PC5)
PC8: J12.4, U1.39 (PC8)
PC9: J12.5, U1.40 (PC9)
SD_SW: J9.G (SW), U1.50 (PA15)
SPI2_MISO: RN1.3 (R3.1), U1.35 (PB14), U8.10 (SDO2), U8.15 (SDO1)
SPI2_MOSI: RN1.2 (R2.1), U1.36 (PB15), U8.9 (SDI)
SPI2_SCK: RN1.1 (R1.1), U1.42 (PA9), U8.8 (SCK)
SPI3_MISO: J9.7 (DAT0), RN2.3 (R3.1), U1.52 (PC11)
SPI3_MOSI: J9.3 (CMD), RN3.1 (R1.1), U1.53 (PC12)
SPI3_SCK: J9.5 (CLK), RN2.4 (R4.1), U1.51 (PC10)
SWCLK: J13.4, U1.49 (PA14)
SWDIO: J13.5, U1.46 (PA13)
SWO: J13.3, U1.55 (PB3)
Sidemarker_L: J10.2, U1.2 (PC13)
Sidemarker_R: J11.2, U1.34 (PB13)
Sidemarker_pwr: R30.2, U1.3 (PC14)
TIM1_CH3N: Q3.2 (S), R34.1, U1.27 (PB1)
TIM2_CH2: U1.62 (PB9), U10.3 (A)
TIM2_CH3: U1.29 (PB10), U9.3 (A)
TIM2_CH4: R31.1, U1.28 (PB2)
TIM3_CH3: R17.1, U1.26 (PB0)
TIM4_CH1: J5.8, U1.58 (PB6)
TIM4_CH2: J5.6, U1.59 (PB7)
TIM8_CH1: J6.8, U1.37 (PC6)
TIM8_CH2: J6.6, U1.38 (PC7)
U5V: D7.2 (A), J13.6
VDDA: C6.1, D5.1 (K), FB1.1, J4.1, R19.2, R20.2, R21.2, R22.2, R23.2, R24.2, R25.2, R26.2, R27.2, R28.2, U1.13 (VDDA)

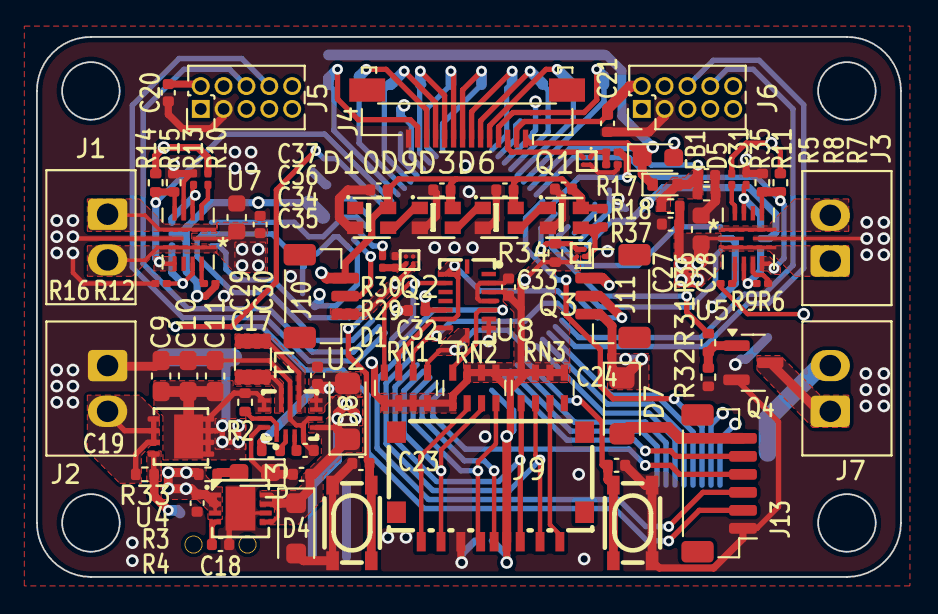
[picture p51: board robotrace_v2_main_v2.kicad_pcb from above]

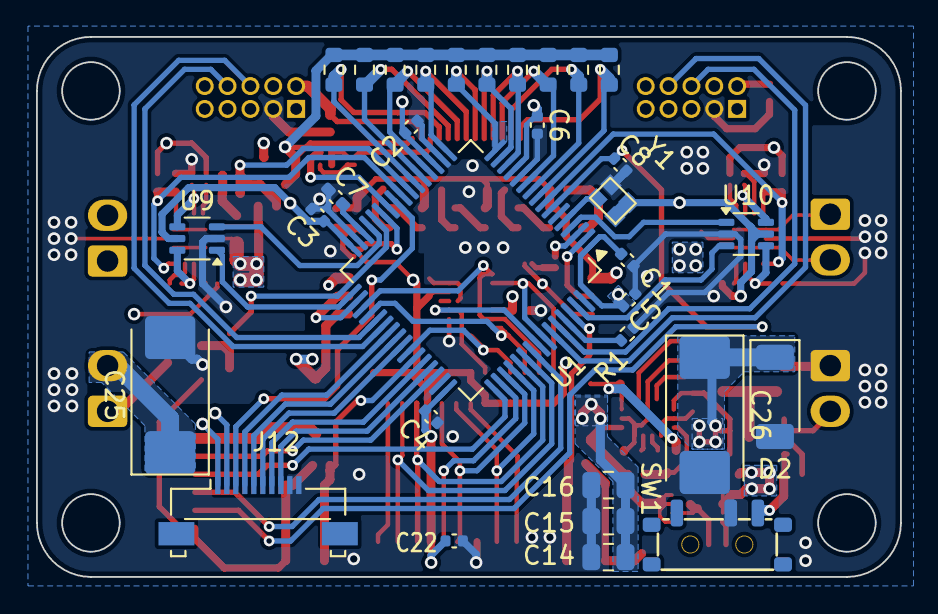
[picture p52: board robotrace_v2_main_v2.kicad_pcb from below]

Board: 4 copper layers, 48.0 x 30.0 mm, 118 parts (32 on the bottom side), 92 nets.
