Kageyana/robotrace_v2/Circuit/robotrace_v2_Sidemarker/robotrace_v2_Sidemarker.kicad_pcb

## KiCad design Circuit/robotrace_v2_Sidemarker/robotrace_v2_Sidemarker.kicad_pcb (2025-12-05)

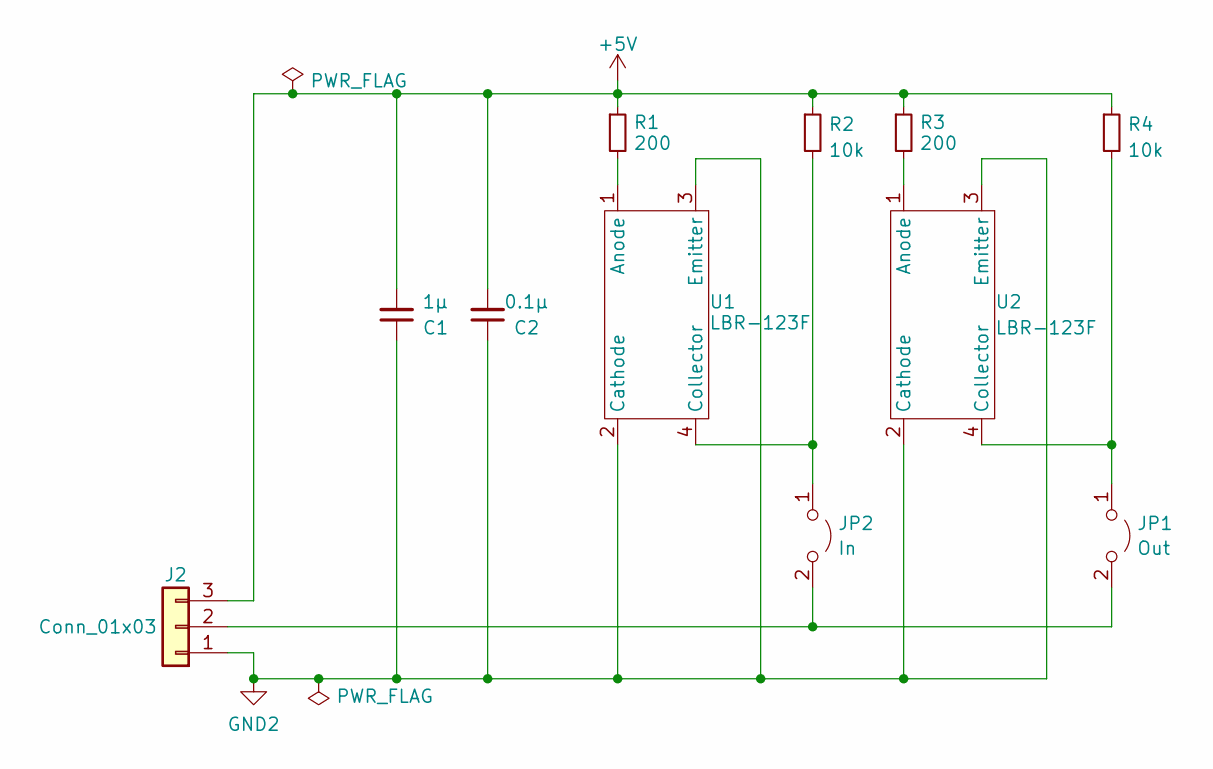
[picture p53: schematic robotrace_v2_Sidemarker.kicad_sch]

Parts:
C1: 1μ; C_0402_1005Metric_Pad0.74x0.62mm_HandSolder
C2: 0.1μ; C_0402_1005Metric_Pad0.74x0.62mm_HandSolder
J2: Conn_01x03; PinHeader_1x03_P2.00mm_Vertical
JP1: Out; SolderJumper-2_P1.3mm_Open_TrianglePad1.0x1.5mm
JP2: In; SolderJumper-2_P1.3mm_Open_TrianglePad1.0x1.5mm
R1, R3: 200; R_0603_1608Metric_Pad0.98x0.95mm_HandSolder
R2, R4: 10k; R_0603_1608Metric_Pad0.98x0.95mm_HandSolder
U1, U2: LBR-123F

Connections:
+5V: C1.2, C2.2, J2.3, R1.1, R2.1, R3.1, R4.1
GND2: C1.1, C2.1, J2.1, U1.2 (Cathode), U1.3 (Emitter), U2.2 (Cathode), U2.3 (Emitter)
unnamed: J2.2, JP1.2 (B), JP2.2 (B)
unnamed: JP1.1 (A), R4.2, U2.4 (Collector)
unnamed: JP2.1 (A), R2.2, U1.4 (Collector)
unnamed: R1.2, U1.1 (Anode)
unnamed: R3.2, U2.1 (Anode)

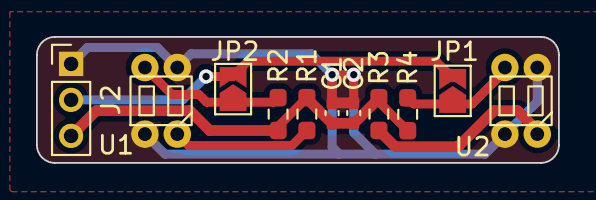
[picture p54: board robotrace_v2_Sidemarker.kicad_pcb from above]

Board: 2 copper layers, 29.0 x 7.0 mm, 11 parts (0 on the bottom side), 7 nets.
