Kageyana/robotrace_v2/Circuit/robotrace_v2_Extended_UI/robotrace_v2_Extended_UI.kicad_pcb

## KiCad design Circuit/robotrace_v2_Extended_UI/robotrace_v2_Extended_UI.kicad_pcb (2025-12-05)

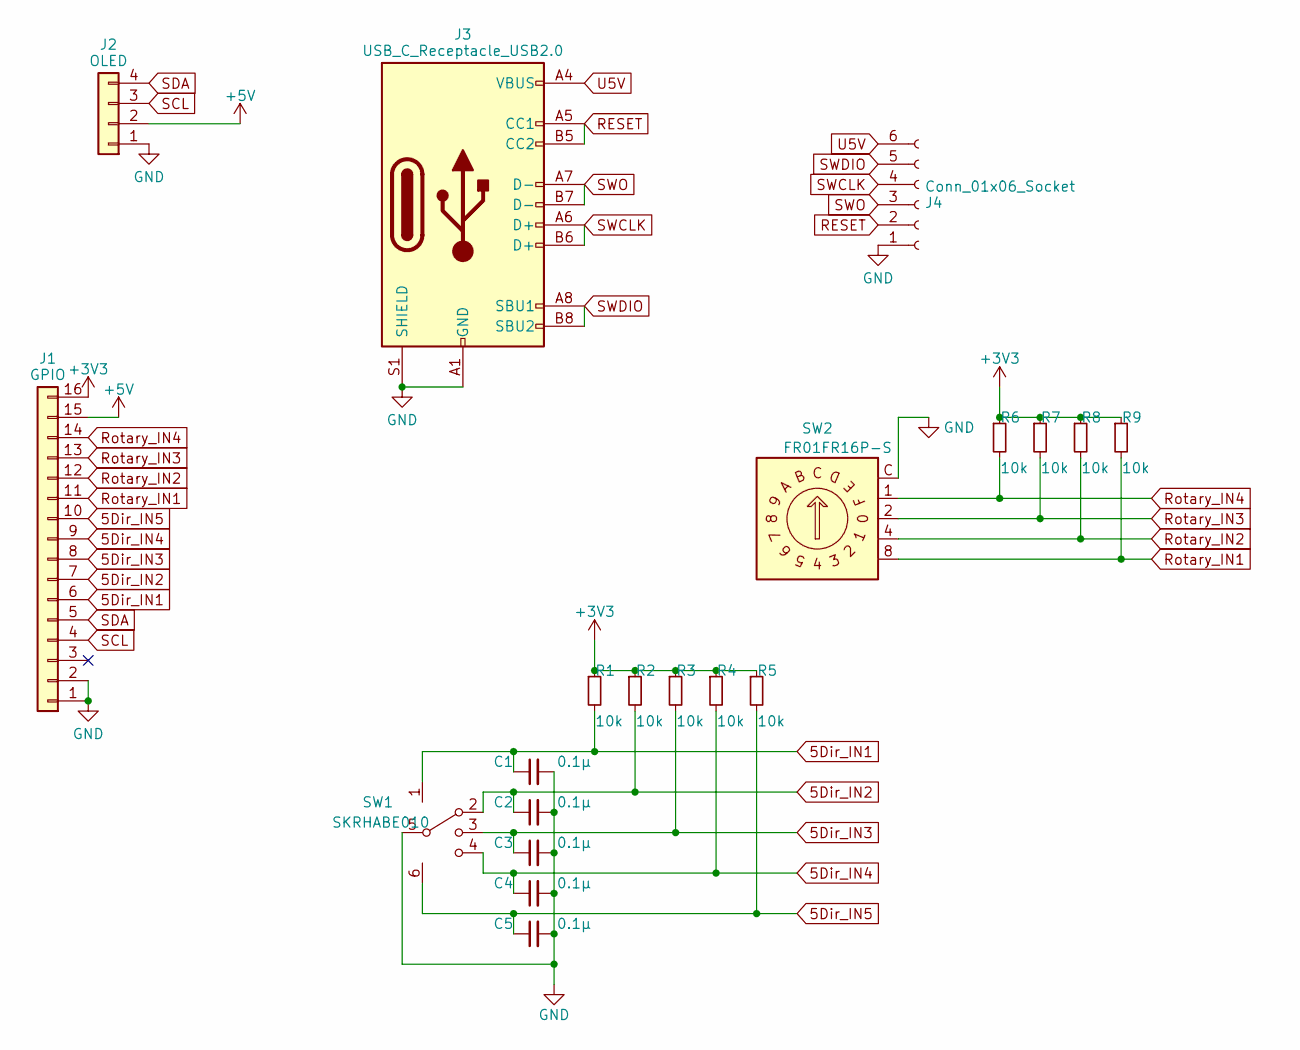
[picture p55: schematic robotrace_v2_Extended_UI.kicad_sch]

Parts:
C1, C2, C3, C4, C5: 0.1μ; C_0402_1005Metric_Pad0.74x0.62mm_HandSolder
J1: GPIO; Molex_FFC_1x16_P0.50mm_Horizontal
J2: OLED; PinHeader_1x04_P2.54mm_Vertical
J3: USB_C_Receptacle_USB2.0; USB_C_Receptacle_XKB_U262-16XN-4BVC11
J4: Conn_01x06_Socket; PinHeader_1x06_P1.27mm_Vertical
R1, R2, R3, R4, R5, R6, R7, R8, R9: 10k; R_0603_1608Metric_Pad0.98x0.95mm_HandSolder
SW1: SKRHABE010; SKRHAAE010
SW2: FR01FR16P-S

Connections:
5Dir_IN1: C1.1, J1.6, R1.2, SW1.1
5Dir_IN2: C2.1, J1.7, R2.2, SW1.2
5Dir_IN3: C3.1, J1.8, R3.2, SW1.3
5Dir_IN4: C4.1, J1.9, R4.2, SW1.4
5Dir_IN5: C5.1, J1.10, R5.2, SW1.6
+3V3: J1.16, R1.1, R2.1, R3.1, R4.1, R5.1, R6.1, R7.1, R8.1, R9.1
+5V: J1.15, J2.2
GND: C1.2, C2.2, C3.2, C4.2, C5.2, J1.1, J1.2, J2.1, J3.A1 (GND), J3.A12 (GND), J3.B1 (GND), J3.B12 (GND), J3.S1 (SHIELD), J4.1, SW1.5, SW2.C
RESET: J3.A5 (CC1), J3.B5 (CC2), J4.2
Rotary_IN1: J1.11, R9.2, SW2.8
Rotary_IN2: J1.12, R8.2, SW2.4
Rotary_IN3: J1.13, R7.2, SW2.2
Rotary_IN4: J1.14, R6.2, SW2.1
SCL: J1.4, J2.3
SDA: J1.5, J2.4
SWCLK: J3.A6 (D+), J3.B6 (D+), J4.4
SWDIO: J3.A8 (SBU1), J3.B8 (SBU2), J4.5
SWO: J3.A7 (D-), J3.B7 (D-), J4.3
U5V: J3.A4 (VBUS), J3.A9 (VBUS), J3.B4 (VBUS), J3.B9 (VBUS), J4.6

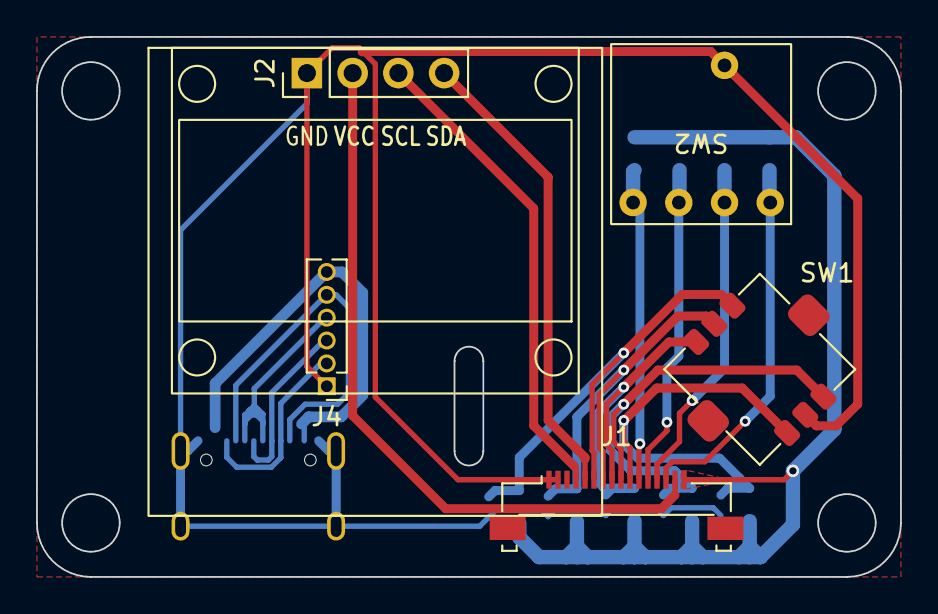
[picture p56: board robotrace_v2_Extended_UI.kicad_pcb from above]

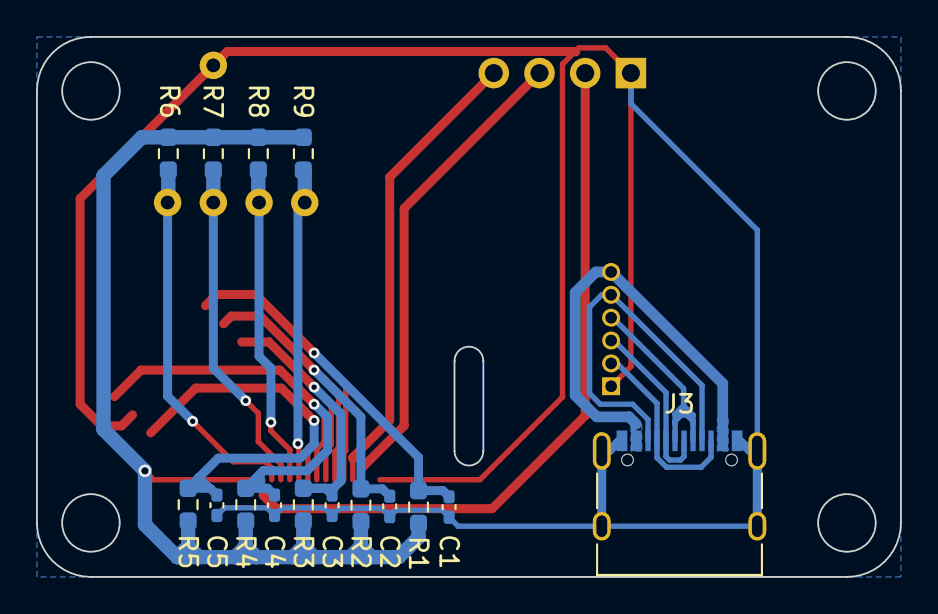
[picture p57: board robotrace_v2_Extended_UI.kicad_pcb from below]

Board: 2 copper layers, 48.0 x 30.0 mm, 20 parts (15 on the bottom side), 19 nets.
