Kageyana/robotrace_v2/Circuit/robotrace_v2_Linesensor/robotrace_v2_Linesensor.kicad_pcb

## KiCad design Circuit/robotrace_v2_Linesensor/robotrace_v2_Linesensor.kicad_pcb (2023-08-02)

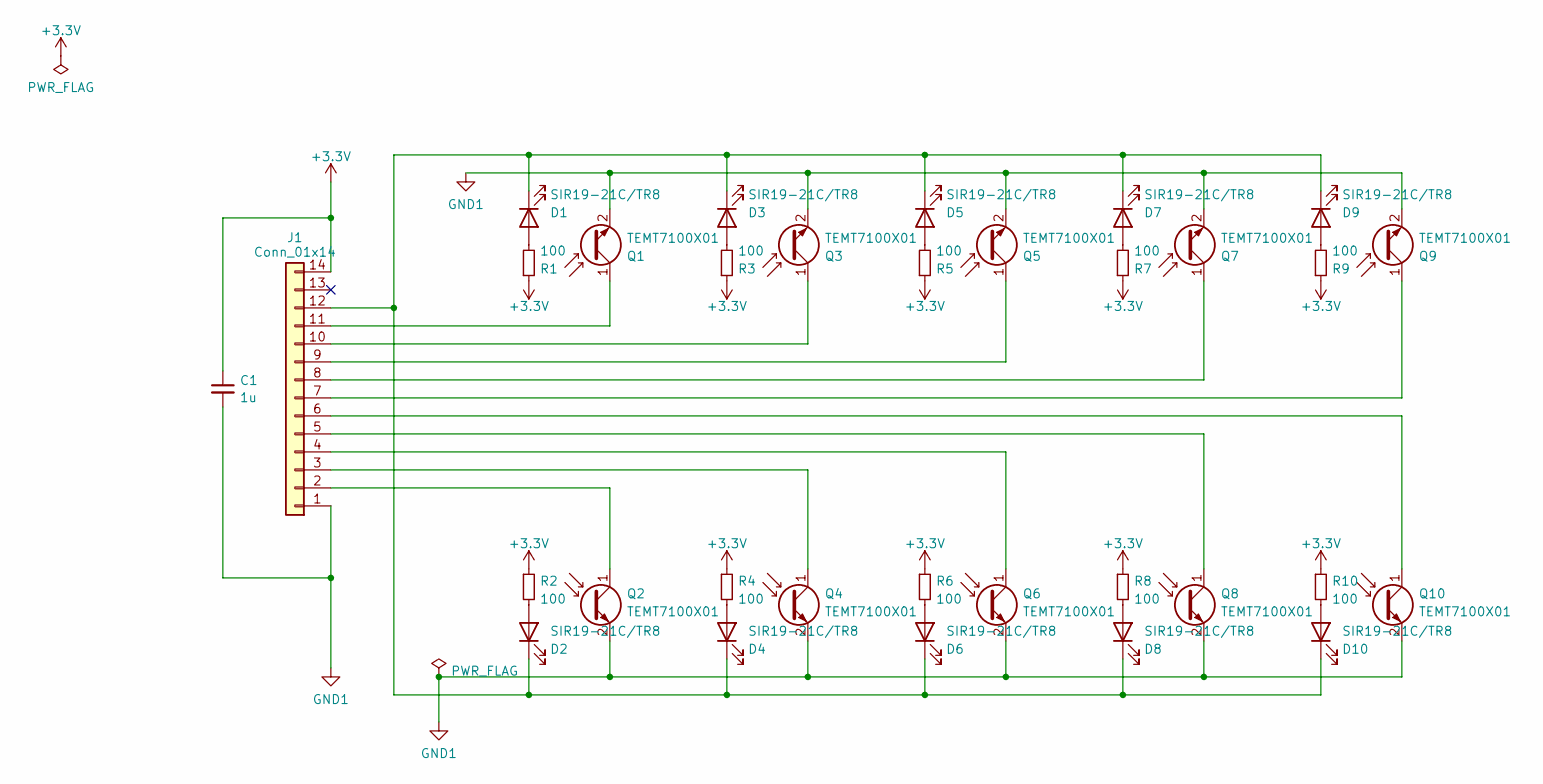
[picture p58: schematic robotrace_v2_Linesensor.kicad_sch]

Parts:
C1: 1u; C_0402_1005Metric_Pad0.74x0.62mm_HandSolder
D1, D2, D3, D4, D5, D6, D7, D8, D9, D10: SIR19-21C/TR8; LED_0603_1608Metric_Pad1.05x0.95mm_HandSolder
J1: Conn_01x14; Molex_FFC_1x14_P0.50mm_Horizontal
Q1, Q2, Q3, Q4, Q5, Q6, Q7, Q8, Q9, Q10: TEMT7100X01; LED_0805_2012Metric_Pad1.15x1.40mm_HandSolder
R1, R2, R3, R4, R5, R6, R7, R8, R9, R10: 100; R_0603_1608Metric_Pad0.98x0.95mm_HandSolder

Connections:
+3V3: C1.1, J1.14, R1.1, R2.1, R3.1, R4.1, R5.1, R6.1, R7.1, R8.1, R9.1, R10.1
GND1: C1.2, J1.1, Q1.2 (E), Q2.2 (E), Q3.2 (E), Q4.2 (E), Q5.2 (E), Q6.2 (E), Q7.2 (E), Q8.2 (E), Q9.2 (E), Q10.2 (E)
unnamed: D1.2 (A), R1.2
unnamed: D1.1 (K), D2.1 (K), D3.1 (K), D4.1 (K), D5.1 (K), D6.1 (K), D7.1 (K), D8.1 (K), D9.1 (K), D10.1 (K), J1.12
unnamed: D2.2 (A), R2.2
unnamed: D3.2 (A), R3.2
unnamed: D4.2 (A), R4.2
unnamed: D5.2 (A), R5.2
unnamed: D6.2 (A), R6.2
unnamed: D7.2 (A), R7.2
unnamed: D8.2 (A), R8.2
unnamed: D9.2 (A), R9.2
unnamed: D10.2 (A), R10.2
unnamed: J1.2, Q2.1 (C)
unnamed: J1.3, Q4.1 (C)
unnamed: J1.4, Q6.1 (C)
unnamed: J1.5, Q8.1 (C)
unnamed: J1.6, Q10.1 (C)
unnamed: J1.7, Q9.1 (C)
unnamed: J1.8, Q7.1 (C)
unnamed: J1.9, Q5.1 (C)
unnamed: J1.10, Q3.1 (C)
unnamed: J1.11, Q1.1 (C)

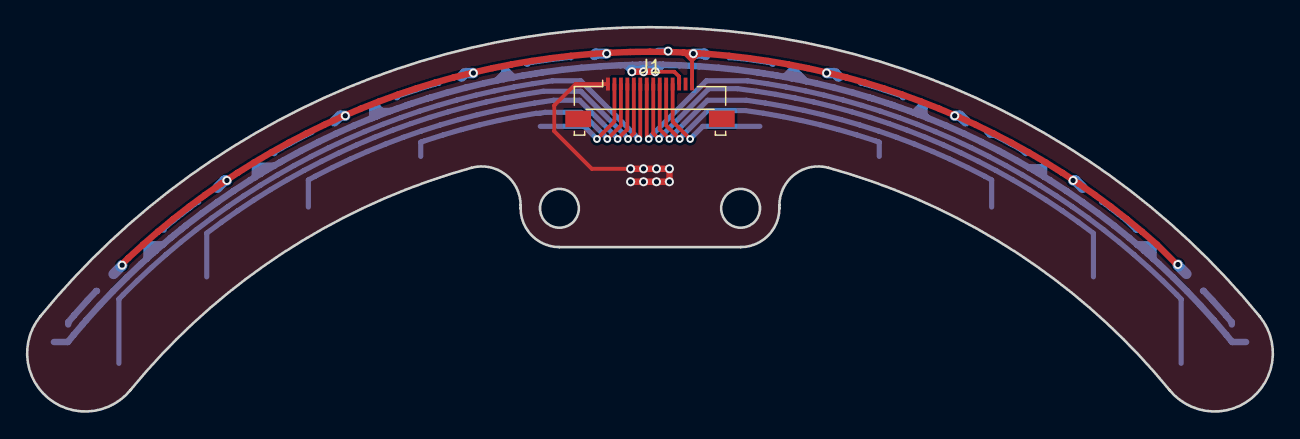
[picture p59: board robotrace_v2_Linesensor.kicad_pcb from above]

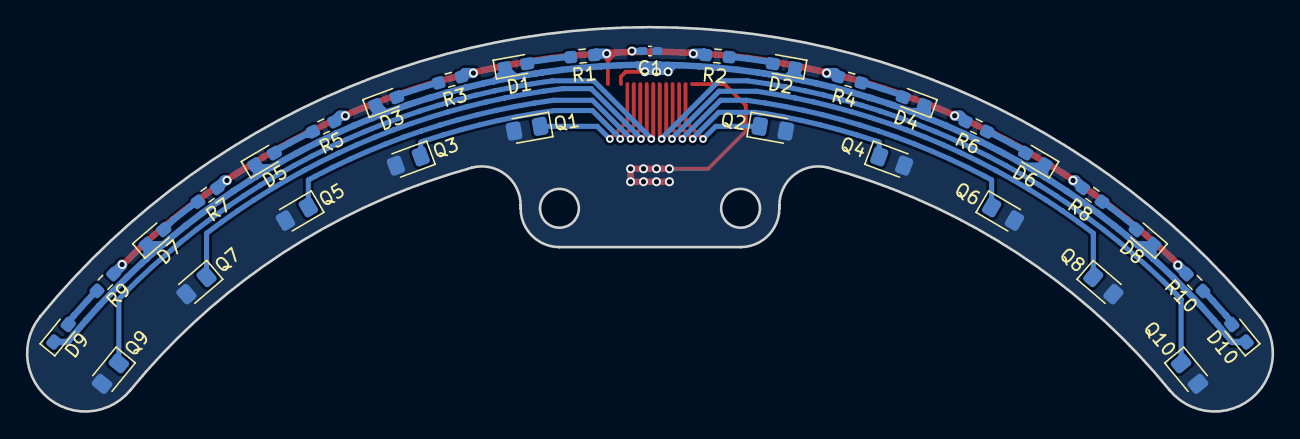
[picture p60: board robotrace_v2_Linesensor.kicad_pcb from below]

Board: 2 copper layers, 96.3 x 29.7 mm, 32 parts (31 on the bottom side), 23 nets.
