Kageyana/robotrace_v2/robotrace_v2/Core/Src/main.c

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
/* Includes ------------------------------------------------------------------*/
#include "main.h"
#include "fatfs.h"

ADC_HandleTypeDef hadc1;
ADC_HandleTypeDef hadc2;
DMA_HandleTypeDef hdma_adc1;
DMA_HandleTypeDef hdma_adc2;

I2C_HandleTypeDef hi2c3;
DMA_HandleTypeDef hdma_i2c3_tx;

SPI_HandleTypeDef hspi2;
SPI_HandleTypeDef hspi3;
DMA_HandleTypeDef hdma_spi3_rx;
DMA_HandleTypeDef hdma_spi3_tx;

TIM_HandleTypeDef htim1;
TIM_HandleTypeDef htim2;
TIM_HandleTypeDef htim3;
TIM_HandleTypeDef htim4;
TIM_HandleTypeDef htim6;
TIM_HandleTypeDef htim7;
TIM_HandleTypeDef htim8;
TIM_HandleTypeDef htim13;
DMA_HandleTypeDef hdma_tim1_ch3;

void SystemClock_Config(void);
static void MX_GPIO_Init(void);
static void MX_DMA_Init(void);
static void MX_ADC1_Init(void);
static void MX_TIM6_Init(void);
static void MX_SPI3_Init(void);
static void MX_TIM3_Init(void);
static void MX_TIM2_Init(void);
static void MX_TIM8_Init(void);
static void MX_TIM13_Init(void);
static void MX_TIM7_Init(void);
static void MX_ADC2_Init(void);
static void MX_SPI2_Init(void);
static void MX_TIM1_Init(void);
static void MX_TIM4_Init(void);
static void MX_I2C3_Init(void);
/* USER CODE BEGIN PFP */
uint8_t bufr[80];
UINT br;
/* USER CODE END PFP */

/**
  * @brief  The application entry point.
  * @retval int
  */
int main(void)
{

  /* MCU Configuration--------------------------------------------------------*/

  /* Reset of all peripherals, Initializes the Flash interface and the Systick. */
  HAL_Init();

  /* Configure the system clock */
  SystemClock_Config();

  /* Initialize all configured peripherals */
  MX_GPIO_Init();
  MX_DMA_Init();
  MX_ADC1_Init();
  MX_TIM6_Init();
  MX_SPI3_Init();
  MX_TIM3_Init();
  MX_TIM2_Init();
  MX_TIM8_Init();
  MX_TIM13_Init();
  MX_TIM7_Init();
  MX_ADC2_Init();
  MX_SPI2_Init();
  MX_TIM1_Init();
  MX_TIM4_Init();
  MX_I2C3_Init();
  /* USER CODE BEGIN 2 */
	initSystem();
  /* USER CODE END 2 */

  /* Infinite loop */
  /* USER CODE BEGIN WHILE */
	while (1)
	{
		loopSystem();
    /* USER CODE END WHILE */

    /* USER CODE BEGIN 3 */
	}
  /* USER CODE END 3 */
}

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
/* USER CODE BEGIN 4 */
void HAL_ADC_ConvCpltCallback(ADC_HandleTypeDef *AdcHandle)
{
	if (AdcHandle->Instance == ADC1)
	{
		completeLineSensorAcquisition();
	}
	if (AdcHandle->Instance == ADC2)
	{
		getADC2();
	}
}

void HAL_TIM_PWM_PulseFinishedCallback(TIM_HandleTypeDef *htim)
{
	// PWM送信完了割り込み

	if(htim->Instance==TIM1){
		datasentflag = false;
	}
	if(htim->Instance==TIM3 && htim->Channel==HAL_TIM_ACTIVE_CHANNEL_3){
		lineSensorPhaseChanged(false);

	}
}

void HAL_TIM_PeriodElapsedCallback(TIM_HandleTypeDef *htim)
{
	// タイマ割り込み処理 更新イベント

	if(htim->Instance==TIM3)
	{
		lineSensorPhaseChanged(true);
  	}
	if (htim->Instance == TIM6)
	{
		Interrupt1ms();
	}
	if (htim->Instance == TIM7)
	{
		Interrupt500us();
	}
	
}

void HAL_TIM_OC_DelayElapsedCallback(TIM_HandleTypeDef *htim){
	// タイマ割り込み処理 比較一致イベント
    if(htim->Instance==TIM3 && htim->Channel==HAL_TIM_ACTIVE_CHANNEL_1){
		startLineSensorAcquisition();
    }
}
/////////////////////////////////////////////////////////////////////
// モジュール名 HAL_ADC_ErrorCallback
// 処理概要     ADC1の転送異常を記録し、古い取得結果の処理を禁止する
// 引数         hadc:異常が発生したADC
// 戻り値       なし
/////////////////////////////////////////////////////////////////////
void HAL_ADC_ErrorCallback(ADC_HandleTypeDef *hadc)
{
	if (hadc->Instance == ADC1) failLineSensorAcquisition();
}
/* I2Cメモリ転送完了割り込み */
void HAL_I2C_MemTxCpltCallback(I2C_HandleTypeDef *hi2c)
{
	ssd1306_I2C_MemTxCpltCallback(hi2c); // SSD1306のDMA完了処理へ委譲
}

int _write(int file, char *ptr, int len)
{
	int DataIdx;
	for (DataIdx = 0; DataIdx < len; DataIdx++)
	{
		ITM_SendChar(*ptr++);
	}
	return len;
}
/* USER CODE END 4 */
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
