Kageyana/robotrace_v2/robotrace_v2/robotrace_v2.ioc

Mcu.UserName=STM32F446RETx
PA0-WKUP.Signal=ADCx_IN0
PA1.Signal=ADCx_IN1
PA10.GPIO_Label=ButtonR
PA10.Signal=GPIO_Input
PA11.Signal=GPIO_Output
PA12.Signal=GPIO_Output
PA13.Signal=SYS_JTMS-SWDIO
PA14.Signal=SYS_JTCK-SWCLK
PA15.GPIO_Label=SD_SW
PA15.Signal=GPIO_Input
PA2.Signal=ADCx_IN2
PA3.Signal=ADCx_IN3
PA4.Signal=ADCx_IN4
PA5.Signal=ADCx_IN5
PA6.Signal=ADCx_IN6
PA7.GPIO_Label=BATTM
PA7.Signal=ADCx_IN7
PA8.Signal=I2C3_SCL
PA9.Signal=SPI2_SCK
PB0.Signal=S_TIM3_CH3
PB1.Signal=TIM1_CH3N
PB10.Signal=S_TIM2_CH3
PB12.GPIO_Label=MOTOR_DIR_R
PB12.Signal=GPIO_Output
PB13.GPIO_Label=SIDEMARKER_R
PB13.Signal=GPIO_Input
PB14.Signal=SPI2_MISO
PB15.Signal=SPI2_MOSI
PB2.Signal=S_TIM2_CH4
PB3.Signal=SYS_JTDO-SWO
PB4.GPIO_Label=IMU_CSB2
PB4.Signal=GPIO_Output
PB5.GPIO_Label=IMU_CSB1
PB5.Signal=GPIO_Output
PB6.Signal=S_TIM4_CH1
PB7.Signal=S_TIM4_CH2
PB8.GPIO_Label=ButtonL
PB8.Signal=GPIO_Input
PB9.Signal=S_TIM2_CH2
PC0.GPIO_Label=MOTOR_CM1
PC0.Signal=ADCx_IN10
PC1.Signal=ADCx_IN11
PC10.Signal=SPI3_SCK
PC11.Signal=SPI3_MISO
PC12.Signal=SPI3_MOSI
PC13.GPIO_Label=SIDEMARKER_L
PC13.Signal=GPIO_Input
PC14-OSC32_IN.GPIO_Label=SidemarkerPWR
PC14-OSC32_IN.Signal=GPIO_Output
PC15-OSC32_OUT.GPIO_Label=MOTOR_DIR_L
PC15-OSC32_OUT.Signal=GPIO_Output
PC2.Signal=ADCx_IN12
PC3.Signal=ADCx_IN13
PC4.GPIO_Label=MOTOR_CM2
PC4.Signal=ADCx_IN14
PC5.Signal=ADCx_IN15
PC6.Signal=S_TIM8_CH1
PC7.Signal=S_TIM8_CH2
PC8.Signal=GPIO_Output
PC9.Signal=I2C3_SDA
PD2.GPIO_Label=CS_MSD
PD2.Signal=GPIO_Output
PH0-OSC_IN.Signal=RCC_OSC_IN
PH1-OSC_OUT.Signal=RCC_OSC_OUT
