Kageyana/robotrace_v2/robotrace_v2/Core/Inc/encoder.h

#ifndef ENCODER_H_
#define ENCODER_H_

//====================================//
// インクルード
//====================================//
#include "main.h"
#include "calibrationConstants.h"
//====================================//
// シンボル定義
//====================================//
#define PULSE_METER CALIBRATED_ENCODER_PULSE_PER_METER		 // 動力1m×5走で左右平均距離を検証。左右個別値は診断用[pulse/m]
#define PULSE_MILLIMETER (PULSE_METER / 1000.0F) // 1mmのカウント

#define ENC_TIM_HANDLER_R htim8
#define ENC_TIM_HANDLER_L htim4
#define ENC_TIM_R TIM8
#define ENC_TIM_L TIM4
//====================================//
// グローバル変数の宣言、定義
//====================================//
extern int16_t encCurrentR;
extern int16_t encCurrentL;
extern int16_t encCurrentN;
extern int32_t encTotalR;
extern int32_t encTotalL;
extern int32_t encTotalN;

extern uint16_t encRawR, encRawL;
extern uint16_t encBufR, encBufL;

// 外部変数
extern int32_t enc1;
extern int32_t encRightMarker;
extern int32_t encCurve;
extern int32_t encChangeGain;
//====================================//
// プロトタイプ宣言
//====================================//
void getEncoder(void);
int32_t encMM(int16_t mm);
float encPulse(int32_t pulse);
float calcDlMm(int16_t velo, float dt);


#endif // ENCODER_H_
