Kageyana/robotrace_v2/robotrace_v2/Core/Src/setup.c

//====================================//
// インクルード
//====================================//
#include "setup.h"
#include "analysisDisplay.h"
#include "battery.h"
#include "motor.h"
#include "pathFollower.h"
#include <stdint.h>
//====================================//
// グローバル変数の宣言、定義
//====================================//
SetupFlags setupFlags = {0}; // セットアップ状態を管理

// タイマ関連のカウンタをまとめた構造体
typedef struct
{
	uint16_t cntSetup1;           // セットアップで使用
	uint16_t cntSetup2;           // セットアップで使用
	uint16_t cntSwitchUD;         // スイッチ判定用右
	uint16_t cntSwitchLR;         // スイッチ判定用左
	uint16_t cntSwitchUDLong;     // スイッチ長押し判定用右
	uint16_t cntSwitchLRLong;     // スイッチ長押し判定用左
} SetupTimer; // タイマ関連構造体

static SetupTimer setupTimer = {0}; // タイマ関連変数


// スイッチ関連
int8_t pushLR = 0;
int8_t pushUD = 0;

// パターン関連
uint8_t push1 = 0;
Pattern pattern = {
	.display = 0,
	.sensors = TEST_MOTOR, // 初期選択:モータテスト
	.beforeSensors = 0,
	.beforeHex = 255,
	.sensorLine = 1,
	.sensorAccele = 1,
	.sensorGyro = 1,
	.parameter1 = 1,
	.parameter2 = 1,
	.parameter3 = 1,
	.parameter4 = 1,
	.gain = 3,
	.speedseting = 1,
	.log = 1,
	.calibration = 1,
	.click = 1
}; // パターンの状態を保持
// フラグ関連
TestFlags testFlags = {0};
volatile bool autoStartCalibrationTurning = false;
static volatile bool autoStartCalibrationReturning = false;
static volatile bool autoStartCalibrationReturned = false;
static uint16_t autoStartCalibrationSettledMs = 0; // 1ms処理内の復帰静止確認
static bool autoStartCalibrationAligning = false; // 元の向き付近での白線位置合わせ
static int8_t autoStartCalibrationSearchDirection = -1;
static bool autoStartCalibrationLineCaptured = false;
static float autoStartCalibrationLineAnchorDeg = 0.0F;
static bool autoStartCalibrationStopping = false; // 中央捕捉後は許容範囲内で制動を維持する

// パラメータ関連
int16_t motorTestPwm = 200;
int32_t encClick = 0;
//====================================//
// プロトタイプ宣言
//====================================//
static void setup_sensors(void); 		// センサ表示とテストメニューを制御する処理
static void setup_pid(pidParam *pid, bool speedTest);
static void setup_start(void);			// スタート待ち画面とキャリブレーションを制御する処理
static bool calibrationLinePosition(float *position);
static void setup_log(void);			// ログ解析と表示を制御
static void setup_calibration(void);	// キャリブレーション(ラインセンサ)
static void setup_speed_param(void);	// 速度パラメータ調整
static void setup_shortcut_param(void); // ショートカット設定調整
static void test_motor(void);			// モータテスト
static void test_imu_deg(void);			// IMU角度表示
static void test_imu_accel(void);		// IMU加速度表示
static void test_marker(void);			// マーカーセンサ
static void test_switch(void); 			// タクトスイッチ
static void test_battery(void);			// バッテリ電圧
static void test_linesensor(void); 		// ラインセンサ
static void test_rgbled(void); 			// RGBLED
static void init_sensor_test(const char* title, FontDef font, uint8_t x); // 表示初期化

// センサテストで使用する関数ポインタ型
typedef void (*SensorTestFunc)(void);
// テストIDと実行関数を保持する構造体
typedef struct
{
	SensorTestId id; // テスト種別
	SensorTestFunc func; // 実行関数
} SensorTest; // センサテスト情報

// センサテストのテーブル {列挙体, 関数ポインタ}
static const SensorTest sensorTestTable[] = {
	{TEST_MOTOR, test_motor}, // モータテスト
	{TEST_IMU_DEG, test_imu_deg}, // IMU角度表示
	{TEST_IMU_ACCEL, test_imu_accel}, // IMU加速度表示
	{TEST_MARKER, test_marker}, // マーカーセンサ
	{TEST_SWITCH, test_switch}, // タクトスイッチ
	{TEST_BATTERY, test_battery}, // バッテリ電圧
	{TEST_LINESENSOR, test_linesensor}, // ラインセンサ
	{TEST_RGBLED, test_rgbled} // RGBLED
}; // IDと処理の対応テーブル

// 速度パラメータの情報を保持する構造体
typedef struct
{
	const char* label; // 表示文字列
	float* value; // 対応する変数ポインタ
	float step; // 増分値
	float min; // 最小値
	float max; // 最大値
	const char* unit; // 表示単位
} SpeedParamInfo; // 速度パラメータ情報

// 速度パラメータの一覧テーブル
static const SpeedParamInfo speedParamTable[] = {
#define SPEED_PARAM_UI(member, initial, label, step, minimum, maximum, unit, metadata) \
    {label, &tgtParam.member, step, minimum, maximum, unit},
    SPEED_PARAM_FIELDS(SPEED_PARAM_UI)
#undef SPEED_PARAM_UI
}; // 速度パラメータの対応テーブル

// maxLevelだけuint8_tのためvalueをNULLとし、一時int16_tを介して編集する。
typedef struct
{
	const char *label; // 表示項目名
	uint16_t *value; // uint16_t設定値。maxLevelはNULL
	int16_t step; // SD保存整数での変更量
	int16_t min; // SD設定と共通の下限
	int16_t max; // SD設定と共通の上限
	float scale; // 表示値へ戻す倍率
	uint8_t decimals; // 表示小数桁数
	const char *unit; // 表示単位
} ShortcutParamInfo;

static const ShortcutParamInfo shortcutParamTable[] = {
	{"Max level", NULL, 1, 0, PATH_LEVEL_MAX, 1.0F, 0U, "level"},
	{"Lookahead base", &shortcutSettings.lookaheadBaseMm, SHORTCUT_UI_LOOKAHEAD_BASE_STEP_MM,
		PATH_LOOKAHEAD_BASE_MIN_MM, PATH_LOOKAHEAD_BASE_MAX_MM, 1.0F, 0U, "mm"},
	{"Lookahead speed", &shortcutSettings.lookaheadPerMpsMm, SHORTCUT_UI_LOOKAHEAD_SPEED_STEP_MM,
		0, PATH_LOOKAHEAD_SPEED_MAX_MM, 1.0F, 0U, "mm/(m/s)"},
	{"K lateral", &shortcutSettings.kLateral_x100, SHORTCUT_UI_GAIN_STEP_X100,
		0, PATH_KLATERAL_MAX_X100, 0.01F, 2U, "(deg/s)/mm"},
	{"K heading", &shortcutSettings.kHeading_x100, SHORTCUT_UI_GAIN_STEP_X100,
		0, PATH_KHEADING_MAX_X100, 0.01F, 2U, "(deg/s)/deg"},
	{"Line alpha", &shortcutSettings.lineAlpha_x1000, SHORTCUT_UI_LINE_ALPHA_STEP_X1000,
		0, PATH_LINE_ALPHA_MAX_X1000, 0.001F, 3U, "ratio"},
	{"Line theta gain", &shortcutSettings.lineThetaGain_x1e9, SHORTCUT_UI_LINE_THETA_STEP_X1E9,
		0, PATH_LINE_THETA_GAIN_MAX_X1E9, 1.0F, 0U, "x1e-9 /mm^2"}
};

/////////////////////////////////////////////////////////////////////
// モジュール名 setup_shortcut_param
// 処理概要     左右で7設定を選び、上下で許容範囲内の実設定値を調整する
// 引数         なし
// 戻り値       なし
/////////////////////////////////////////////////////////////////////
static void setup_shortcut_param(void)
{
	static int16_t previousItem = 0;
	static int16_t previousValue = 0;
	const bool pageChanged = pattern.display != pattern.beforeHex;
	const int16_t count = (int16_t)(sizeof(shortcutParamTable) / sizeof(shortcutParamTable[0]));
	if (pageChanged)
		ssd1306_printf(Font_6x8, "Shortcut");
	if (pattern.parameter2 < 1 || pattern.parameter2 > count) pattern.parameter2 = 1;
	dataTuningLR(&pattern.parameter2, 1, 1, count);
	const ShortcutParamInfo *info = &shortcutParamTable[pattern.parameter2 - 1];
	uint16_t raw = info->value != NULL ? *info->value : shortcutSettings.maxLevel;
	if (raw < (uint16_t)info->min) raw = (uint16_t)info->min;
	if (raw > (uint16_t)info->max) raw = (uint16_t)info->max;
	int16_t value = (int16_t)raw;
	dataTuningUD(&value, info->step, info->min, info->max);
	if (info->value != NULL)
		*info->value = (uint16_t)value;
	else
		shortcutSettings.maxLevel = (uint8_t)value;

	// 連続DMAはこのバッファを直接読むため、無変更時は消去も再描画もしない。
	const bool itemChanged = pageChanged || previousItem != pattern.parameter2;
	if (itemChanged)
	{
		ssd1306_FillRectangle(0, 16, 127, 63, Black);
		ssd1306_SetCursor(0, 18);
		ssd1306_printf(Font_6x8, "%d/%d %s", pattern.parameter2, count, info->label);
		ssd1306_SetCursor(0, 42);
		ssd1306_printf(Font_6x8, "%s", info->unit);
		ssd1306_SetCursor(0, 54);
		ssd1306_printf(Font_6x8, "L/R:item U/D:value");
	}
	if (itemChanged || previousValue != value)
	{
		// 短い数値へ変わった際の残像は空白で消し、本文全体を消去しない。
		ssd1306_SetCursor(0, 30);
		ssd1306_printf(Font_6x8, "%-21.*f", info->decimals, (double)((float)value * info->scale));
	}
	previousItem = pattern.parameter2;
	previousValue = value;
}
///////////////////////////////////////////////////////////////////////////////////////
// モジュール名 setup_speed_param
// 処理概要     速度パラメータ調整
// 引数         なし
// 戻り値       なし
///////////////////////////////////////////////////////////////////////////////////////
static void setup_speed_param(void)
{
	static uint8_t beforePparam = 0; // 前回のパラメータ項目を保持

	if (pattern.display != pattern.beforeHex)
	{
		// 切替時に実行
		ssd1306_printf(Font_6x8, "Parameter");
	}

	dataTuningLR(&pattern.parameter1, 1, 1, sizeof(speedParamTable) / sizeof(speedParamTable[0])); // パラメータ項目切替

	if (beforePparam != pattern.parameter1)
	{
		ssd1306_FillRectangle(0, 16, 127, 63, Black);
	}

	// 選択番号に対応する速度パラメータを処理
	for (uint8_t i = 0; i < sizeof(speedParamTable) / sizeof(speedParamTable[0]); i++)
	{
		if (pattern.parameter1 == i + 1)
		{
			dataTuningUDF(speedParamTable[i].value, speedParamTable[i].step, speedParamTable[i].min, speedParamTable[i].max);
			ssd1306_SetCursor(0, 24);
			ssd1306_printf(Font_6x8, "%s:%3g%s", speedParamTable[i].label, *speedParamTable[i].value, speedParamTable[i].unit);
			break;
		}
	}

	beforePparam = pattern.parameter1; // 選択項目を記録
}

///////////////////////////////////////////////////////////////////////////////////////
// モジュール名 init_sensor_test
// 処理概要     センサテスト画面の初期化
// 引数         title : 表示文字列
//              font  : 使用フォント
//              x     : タイトル表示位置
// 戻り値       なし
///////////////////////////////////////////////////////////////////////////////////////
static void init_sensor_test(const char* title, FontDef font, uint8_t x)
{
	ssd1306_FillRectangle(0, 16, 127, 63, Black); // 表示領域をクリア
	ssd1306_SetCursor(x, 16); // タイトルの位置設定
	ssd1306_printf(font, title); // タイトルを描画
}

///////////////////////////////////////////////////////////////////////////////////////
// モジュール名 test_motor
// 処理概要     モータテスト
// 引数         なし
// 戻り値       なし
///////////////////////////////////////////////////////////////////////////////////////
static void test_motor(void)
{
	if (pattern.sensors != pattern.beforeSensors)
	{
		// 切替時に実行
		init_sensor_test("Motor", Font_6x8, 47); // 画面クリアとタイトル表示
		testFlags.motor_test = 0;
	}
	// Duty表示
	ssd1306_SetCursor(35, 30);
	ssd1306_printf(Font_6x8, "Duty:%4d", motorTestPwm);

	// Left
	ssd1306_SetCursor(0, 42);
	ssd1306_printf(Font_6x8, "enc:%5.0f", encTotalL / PULSE_MILLIMETER); // Encoder
	ssd1306_SetCursor(0, 52);
	ssd1306_printf(Font_6x8, "Cur:%5.2f", motorCurrentL); // Current

	// // Right
	ssd1306_SetCursor(70, 42);
	ssd1306_printf(Font_6x8, "enc:%5.0f", encTotalR / PULSE_MILLIMETER); // Encoder
	ssd1306_SetCursor(70, 52);
	// ssd1306_printf(Font_6x8, "Cur:%f", motorCurrentR); // Current
	ssd1306_printf(Font_6x8, "Cur:%5.2f", motorCurrentR); // Current

	dataTuningUD(&motorTestPwm, 100, -500, 500); // PWM値を調整
	data_select(&testFlags.motor_test, SW_PUSH); // モータテストの開始/停止
	if (testFlags.motor_test == 1)
	{
		motorCommandOut(motorTestPwm, motorTestPwm);
	}
	else
	{
		motorCommandOut(0, 0);
	}

	// testFlags.motor_test 1→0のとき 2にする
	if (testFlags.motor_test != testFlags.beforeMotorTest && testFlags.motor_test == 0)
	{
		testFlags.motor_test = 2;
	}
	// 2のときホイールの回転が止まったらtestFlags.motor_test=0にする
	if (testFlags.motor_test == 2 && encCurrentL == 0)
	{
		testFlags.motor_test = 0;
	}
	testFlags.beforeMotorTest = testFlags.motor_test; // 次回比較用に状態を保存
}

///////////////////////////////////////////////////////////////////////////////////////
// モジュール名 test_imu_deg
// 処理概要     IMU角度表示
// 引数         なし
// 戻り値       なし
///////////////////////////////////////////////////////////////////////////////////////
static void test_imu_deg(void)
{
	if (pattern.sensors != pattern.beforeSensors)
	{
		// 切替時に実行
		init_sensor_test("IMU[deg]", Font_7x10, 36); // 画面クリアとタイトル表示
		testFlags.motor_test = 1;
	}

	if (!calibratIMU)
	{
		ssd1306_SetCursor(64, 30);
		ssd1306_printf(Font_7x10, "xd:%6.1f", imuVal.angle.x);
		ssd1306_SetCursor(64, 42);
		ssd1306_printf(Font_7x10, "yd:%6.1f", imuVal.angle.y);
		ssd1306_SetCursor(64, 54);
		ssd1306_printf(Font_7x10, "zd:%6.1f", imuVal.angle.z);
	}

	if (swValTact == SW_PUSH)
	{
		imuVal.angle.x = 0;
		imuVal.angle.y = 0;
		imuVal.angle.z = 0;
	}

	if (swValTact == SW_UP)
	{
		ssd1306_FillRectangle(0, 15, 127, 63, Black); // メイン表示空白埋め
		ssd1306_SetCursor(22, 28);
		ssd1306_printf(Font_7x10, "Calibration");
		ssd1306_SetCursor(53, 42);
		ssd1306_printf(Font_7x10, "Now");
		ssd1306_UpdateScreen();

		IMU_StartCalibration();
		calibrateMotorCurrent =true;
		HAL_Delay(1000);
	}
}

///////////////////////////////////////////////////////////////////////////////////////
// モジュール名 test_imu_accel
// 処理概要     IMU加速度表示
// 引数         なし
// 戻り値       なし
///////////////////////////////////////////////////////////////////////////////////////
static void test_imu_accel(void)
{
	if (pattern.sensors != pattern.beforeSensors)
	{
		// 切替時に実行
		init_sensor_test("IMU[g]", Font_7x10, 36); // 画面クリアとタイトル表示
	}

	ssd1306_SetCursor(0, 30);
	ssd1306_printf(Font_7x10, "xa:%6.1f", imuVal.accele.x);
	ssd1306_SetCursor(0, 42);
	ssd1306_printf(Font_7x10, "ya:%6.1f", imuVal.accele.y);
	ssd1306_SetCursor(0, 54);
	ssd1306_printf(Font_7x10, "za:%6.1f", imuVal.accele.z);

	ssd1306_SetCursor(64, 30);
	ssd1306_printf(Font_7x10, "T:%4.1f", imuVal.temp);
}

///////////////////////////////////////////////////////////////////////////////////////
// モジュール名 test_marker
// 処理概要     マーカーセンサ
// 引数         なし
// 戻り値       なし
///////////////////////////////////////////////////////////////////////////////////////
static void test_marker(void)
{
	if (pattern.sensors != pattern.beforeSensors)
	{
		// 切替時に実行
		init_sensor_test("Marker sensors", Font_7x10, 15); // 画面クリアとタイトル表示
	}
	ssd1306_SetCursor(0, 30);
	ssd1306_printf(Font_7x10, "sensors:%d", markerSensor);
	ssd1306_SetCursor(0, 45);
	ssd1306_printf(Font_7x10, "britght:%d", testFlags.motor_test);

	data_select(&testFlags.motor_test, SW_PUSH);
	if (testFlags.motor_test == 1)
	{
		powerLineSensors(1);
	}
	else
	{
		powerMarkerSensors(0);
		powerLineSensors(0);
	}
}

///////////////////////////////////////////////////////////////////////////////////////
// モジュール名 test_switch
// 処理概要     タクトスイッチ
// 引数         なし
// 戻り値       なし
///////////////////////////////////////////////////////////////////////////////////////
static void test_switch(void)
{
	if (pattern.sensors != pattern.beforeSensors)
	{
		// 切替時に実行
		init_sensor_test("Switches", Font_7x10, 32); // 画面クリアとタイトル表示
	}
	ssd1306_SetCursor(0, 30);
	ssd1306_printf(Font_7x10, "Board SW:%d", swValMainTact);

	ssd1306_SetCursor(0, 42);
	ssd1306_printf(Font_7x10, "5axis SW:%d", swValTact);
}

///////////////////////////////////////////////////////////////////////////////////////
// モジュール名 test_battery
// 処理概要     バッテリ電圧
// 引数         なし
// 戻り値       なし
///////////////////////////////////////////////////////////////////////////////////////
static void test_battery(void)
{
	if (pattern.sensors != pattern.beforeSensors)
	{
		// 切替時に実行
		init_sensor_test("Battery", Font_7x10, 32); // 画面クリアとタイトル表示
	}
	ssd1306_SetCursor(0, 30);
	ssd1306_printf(Font_7x10, "batteryAD:%d", batteryAD);

	ssd1306_SetCursor(0, 42);
	ssd1306_printf(Font_7x10, "batteryAD:%4.2f", AD2VOLTAGE(batteryAD));
	// ssd1306_printf(Font_7x10, "batteryAD:%4.2f", adcVref);

	ssd1306_SetCursor(0, 54);
	ssd1306_printf(Font_7x10, "BatteryLv:%d", batteryLevel);
}

///////////////////////////////////////////////////////////////////////////////////////
// モジュール名 test_linesensor
// 処理概要     ラインセンサ
// 引数         なし
// 戻り値       なし
///////////////////////////////////////////////////////////////////////////////////////
static void test_linesensor(void)
{
	if (pattern.sensors != pattern.beforeSensors)
	{
		// 切替時に実行
		init_sensor_test("", Font_6x8, 0); // 画面クリア
		// センサ基板形状
		ssd1306_DrawArc(64, 81, 66, 90, 270, White);
		ssd1306_DrawArc(64, 81, 35, 90, 270, White);
		ssd1306_Line(2, 63, 34, 63, White);
		ssd1306_Line(93, 63, 126, 63, White);
		testFlags.motor_test = 0;
	}

	if(testFlags.lineSensor_test == 0)
	{
		ssd1306_SetCursor(37, 22);
		ssd1306_printf(Font_6x8, "%4d", lSensor[4]);
		ssd1306_SetCursor(31, 30);
		ssd1306_printf(Font_6x8, "%4d", lSensor[3]);
		ssd1306_SetCursor(22, 38);
		ssd1306_printf(Font_6x8, "%4d", lSensor[2]);
		ssd1306_SetCursor(13, 46);
		ssd1306_printf(Font_6x8, "%4d", lSensor[1]);
		ssd1306_SetCursor(6, 54);
		ssd1306_printf(Font_6x8, "%4d", lSensor[0]);

		ssd1306_SetCursor(65, 22);
		ssd1306_printf(Font_6x8, "%4d", lSensor[5]);
		ssd1306_SetCursor(71, 30);
		ssd1306_printf(Font_6x8, "%4d", lSensor[6]);
		ssd1306_SetCursor(80, 38);
		ssd1306_printf(Font_6x8, "%4d", lSensor[7]);
		ssd1306_SetCursor(89, 46);
		ssd1306_printf(Font_6x8, "%4d", lSensor[8]);
		ssd1306_SetCursor(95, 54);
		ssd1306_printf(Font_6x8, "%4d", lSensor[9]);

		uint32_t senL, senR;
		senL = (lSensor[4] * TRACE_WEIGHT_CENTER) + (lSensor[3] * TRACE_WEIGHT_INNER) + (lSensor[2] * TRACE_WEIGHT_MIDDLE) + (lSensor[1] * TRACE_WEIGHT_OUTER) + (lSensor[0] * TRACE_WEIGHT_FAR);
		senR = (lSensor[5] * TRACE_WEIGHT_CENTER) + (lSensor[6] * TRACE_WEIGHT_INNER) + (lSensor[7] * TRACE_WEIGHT_MIDDLE) + (lSensor[8] * TRACE_WEIGHT_OUTER) + (lSensor[9] * TRACE_WEIGHT_FAR);
		
		ssd1306_SetCursor(40, 54);
		ssd1306_printf(Font_6x8, "%6d", senR-senL);
	}
	else
	{
		ssd1306_SetCursor(37, 22);
		ssd1306_printf(Font_6x8, "%4d", lSensorCari[4]);
		ssd1306_SetCursor(31, 30);
		ssd1306_printf(Font_6x8, "%4d", lSensorCari[3]);
		ssd1306_SetCursor(22, 38);
		ssd1306_printf(Font_6x8, "%4d", lSensorCari[2]);
		ssd1306_SetCursor(13, 46);
		ssd1306_printf(Font_6x8, "%4d", lSensorCari[1]);
		ssd1306_SetCursor(6, 54);
		ssd1306_printf(Font_6x8, "%4d", lSensorCari[0]);

		ssd1306_SetCursor(65, 22);
		ssd1306_printf(Font_6x8, "%4d", lSensorCari[5]);
		ssd1306_SetCursor(71, 30);
		ssd1306_printf(Font_6x8, "%4d", lSensorCari[6]);
		ssd1306_SetCursor(80, 38);
		ssd1306_printf(Font_6x8, "%4d", lSensorCari[7]);
		ssd1306_SetCursor(89, 46);
		ssd1306_printf(Font_6x8, "%4d", lSensorCari[8]);
		ssd1306_SetCursor(95, 54);
		ssd1306_printf(Font_6x8, "%4d", lSensorCari[9]);

		uint32_t senL, senR;
		senL = (lSensorCari[4] * TRACE_WEIGHT_CENTER) + (lSensorCari[3] * TRACE_WEIGHT_INNER) + (lSensorCari[2] * TRACE_WEIGHT_MIDDLE) + (lSensorCari[1] * TRACE_WEIGHT_OUTER) + (lSensorCari[0] * TRACE_WEIGHT_FAR);
		senR = (lSensorCari[5] * TRACE_WEIGHT_CENTER) + (lSensorCari[6] * TRACE_WEIGHT_INNER) + (lSensorCari[7] * TRACE_WEIGHT_MIDDLE) + (lSensorCari[8] * TRACE_WEIGHT_OUTER) + (lSensorCari[9] * TRACE_WEIGHT_FAR);
		
		ssd1306_SetCursor(40, 54);
		ssd1306_printf(Font_6x8, "%6d", senR-senL);
	}

	data_select(&testFlags.motor_test, SW_PUSH);
	data_select(&testFlags.lineSensor_test, SW_DOWN);
	if (testFlags.motor_test == 1)
	{
		powerLineSensors(1);
	}
	else
	{
		powerLineSensors(0);
	}
}

///////////////////////////////////////////////////////////////////////////////////////
// モジュール名 test_rgbled
// 処理概要     RGBLED
// 引数         なし
// 戻り値       なし
///////////////////////////////////////////////////////////////////////////////////////
static void test_rgbled(void)
{
	if (pattern.sensors != pattern.beforeSensors)
	{
		// 切替時に実行
		init_sensor_test("RGBLED", Font_7x10, 43); // 画面クリアとタイトル表示
	}

	data_select(&testFlags.motor_test, SW_PUSH);
	if (testFlags.motor_test == 1)
	{
		if (setupTimer.cntSetup2 > 50)
		{
			fullColorLED(10, 4);
			setupTimer.cntSetup2 = 0;
		}
	}

	if (testFlags.motor_test != testFlags.beforeMotorTest)
	{
		clearLED();
	}

	testFlags.beforeMotorTest = testFlags.motor_test;
}
/////////////////////////////////////////////////////////////////////////////////////
// モジュール名 setup_sensors
// 処理概要     センサ表示とテストメニューを制御
// 引数         なし
// 戻り値       なし
/////////////////////////////////////////////////////////////////////////////////////
static void setup_sensors(void)
{
	if (pattern.display != pattern.beforeHex)
	{
		// ページ切替時の初期処理
		ssd1306_printf(Font_6x8, "SENSORS  ");  // センサ画面表示
		pattern.beforeSensors = 100;    // 初期値
	}

        // センサメニューの項目切替（範囲は列挙体で指定）
        dataTuningLR(&pattern.sensors, 1, TEST_MOTOR, TEST_RGBLED); // センサメニュー項目切替
        // テーブルを走査して該当テストを探索
        for (uint8_t i = 0; i < sizeof(sensorTestTable) / sizeof(sensorTestTable[0]); i++)
        {
			// テーブルから選択IDに対応するテストを探索
			if (pattern.sensors == sensorTestTable[i].id)
			{
				sensorTestTable[i].func(); // 選択されたテストを実行
				break; // 一致したらループ終了
			}
        }
	pattern.beforeSensors = pattern.sensors;        // 選択状態の更新
}

///////////////////////////////////////////////////////////////////////////////////////
// モジュール名 setup_pid
// 処理概要     PIDゲインの表示・編集・試験状態を共通処理し方式ごとの出力を維持する
// 引数         pid: 調整対象, speedTest: trueなら速度PIDとFFの調整
// 戻り値       なし
///////////////////////////////////////////////////////////////////////////////////////
static void setup_pid(pidParam *pid, bool speedTest)
{
    const uint8_t lineRows[] = {18U, 32U, 44U, 0U};
    const uint8_t speedRows[] = {18U, 30U, 42U, 54U};
    const uint8_t *rows = speedTest ? speedRows : lineRows;
    const uint8_t count = speedTest ? 4U : 3U;
    FontDef gainFont = speedTest ? Font_6x8 : Font_7x10;
    int16_t *gains[] = {&pid->kp, &pid->ki, &pid->kd, &speedFeedForwardGain};
    char *labels[] = {"kp:", "ki:", "kd:", "ff:"};

    if (pattern.display != pattern.beforeHex)
    {
        ssd1306_printf(Font_6x8, speedTest ? "Speed PID" : "Trace PID");
        for (uint8_t i = 0U; i < count; i++)
        {
            ssd1306_SetCursor(0, rows[i]);
            ssd1306_printf(gainFont, labels[i]);
        }
        ssd1306_SetCursor(60, 30);
        ssd1306_printf(Font_7x10, "pwm:");
    }

    data_select(&testFlags.trace_test, SW_PUSH);
    if (testFlags.trace_test == 1)
    {
        if (speedTest)
        {
            // 速度試験の既存出力を維持する。通常走行の速度PID出力とは別の操作。
            powerLineSensors(1);
            setTargetSpeed(0.0F);
            motorCommandOutSynth(lineTraceCtrl.pwm, veloCtrl.kp, 0);
        }
        else
        {
            motorCommandOutSynth(pid->pwm, 0, 0);
            powerLineSensors(1);
        }
    }
    else
    {
        motorCommandOutSynth(0, 0, 0);
        powerLineSensors(0);
    }

    if (!speedTest)
    {
        if (testFlags.trace_test != testFlags.beforeMotorTest && testFlags.trace_test == 0)
            testFlags.trace_test = 2;
        if (testFlags.trace_test == 2 && encCurrentL == 0)
            testFlags.trace_test = 0;
        testFlags.beforeMotorTest = testFlags.trace_test;
    }

    dataTuningUD(&pattern.gain, 1, count, 1);
    if (testFlags.trace_test == 0)
    {
        for (uint8_t i = 0U; i < count; i++)
        {
            ssd1306_SetCursor(21, rows[i]);
            if (pattern.gain == (int16_t)(i + 1U))
                ssd1306_printfB(gainFont, "%3d", *gains[i]);
            else
                ssd1306_printf(gainFont, "%3d", *gains[i]);
        }
        ssd1306_SetCursor(88, 30);
        ssd1306_printf(Font_7x10, "%4d", pid->pwm);
        if (pattern.gain >= 1 && pattern.gain <= count)
            dataTuningLR(gains[pattern.gain - 1], 1, 0, 255);
    }
    if (speedTest)
    {
        // 値変更と同じUI処理内で反映し、画面を離れても旧ゲインを残さない。
        syncSpeedPIDGains();
    }
}
/////////////////////////////////////////////////////////////////////////////////////
// モジュール名 setup_calibration
// 処理概要     キャリブレーション(ラインセンサ)
// 引数         なし
// 戻り値       なし
/////////////////////////////////////////////////////////////////////////////////////
static void setup_calibration(void)
{
	if (pattern.display != pattern.beforeHex)
	{
		// 切替時に実行
		ssd1306_printf(Font_6x8, "Calibrate");
		pattern.calibration = 1;
	}

	switch (pattern.calibration)
	{
	case 1: // スイッチ入力待ち
	{
		setTargetSpeed(0); // 速度をゼロに設定
		ssd1306_SetCursor(65, 22);
	ssd1306_printf(Font_6x8, "%4d", lSensorCari[0]);

		data_select(&testFlags.trace_test, SW_PUSH); // SW_PUSH入力を監視
		if (testFlags.trace_test)
		{
				setupTimer.cntSetup1 = 0; // カウンタリセット
				pattern.calibration = 2; // 次のステップへ
		}
		break;
	}
	case 2: // 開始準備
	{
		if (setupTimer.cntSetup1 > 1000) // 一定時間待機
		{
			uint8_t i;
			ssd1306_FillRectangle(0, 15, 127, 63, Black); // メイン表示空白埋め
			ssd1306_SetCursor(22, 28);
			ssd1306_printf(Font_7x10, "Calibration");
			ssd1306_SetCursor(53, 42);
			ssd1306_printf(Font_7x10, "Now");
			ssd1306_UpdateScreen(); // グラフィック液晶更新

			// 配列初期化
			for (i = 0; i < NUM_SENSORS; i++)
			{
				lSensorMax[i] = 0;            // 最大値初期化
				lSensorMin[i] = UINT16_MAX;   // 最小値初期化
			}

			powerLineSensors(1);    // ラインセンサ点灯
			modeCalLinesensors = 1; // キャリブレーション開始

			// 手動で機体を動かしキャリブレーションする

			pattern.calibration = 3; // 次のステップへ
		}
		break;
    }
	case 3: // スイッチ押下で終了
	{
		data_select(&testFlags.trace_test, SW_PUSH); // SW_PUSH入力を監視
		if (!testFlags.trace_test) // スイッチが離されたら
		{
			finishLineSensorCalibration();                                    // SD保存前に校正値を検証
			powerLineSensors(0);                                              // ラインセンサ消灯
			ssd1306_FillRectangle(0, 15, 127, 63, Black); // メイン表示空白埋め
			ssd1306_UpdateScreen();                                           // グラフィック液晶更新

			if (initMSD)
			{
				writeLinesenval(); // オフセット値をSDカードに書き込み
			}
			pattern.calibration = 1; // 最初の状態に戻る
		}
		break;
	}

	default:
	    break;
	}
}
///////////////////////////////////////////////////////////////////////////////////////
// モジュール名 setup_log
// 処理概要     ログ解析表示と操作を制御
// 引数         なし
// 戻り値       なし
///////////////////////////////////////////////////////////////////////////////////////
static void setup_log(void)
{
    static const char *const modeNames[] = {"DISTANCE", "PATH", "SHORTCUT", "PATH_CURVE", "SHORTCUT_CURVE"};
    static int16_t selectedLog = 0, selectedMode = 0, result = 0;
    static bool pushHeld = false;
    bool redraw = (pattern.display != pattern.beforeHex);
    if (redraw)
    {
        ssd1306_printf(Font_6x8, "LOG");
        selectedLog = (fileIndexLog >= 0 && fileIndexLog <= endFileIndex) ? fileIndexLog : endFileIndex;
        result = 0;
        pushHeld = (swValTact == SW_PUSH);
    }

    // ログがない場合は配列を参照せず、解析も開始しない。
    if (endFileIndex < 0 || fileNumbers[0] <= 0)
    {
        if (redraw)
        {
            ssd1306_SetCursor(0, 25);
            ssd1306_printf(Font_6x8, "No logs");
        }
        pushHeld = (swValTact == SW_PUSH);
        return;
    }
    if (selectedLog < 0 || selectedLog > endFileIndex) selectedLog = endFileIndex;
    int16_t previousLog = selectedLog, previousMode = selectedMode;
    dataTuningUD(&selectedLog, 1, 0, endFileIndex);
    dataTuningLR(&selectedMode, 1, 0, (int16_t)(sizeof(modeNames) / sizeof(modeNames[0]) - 1U));
    if (selectedLog != previousLog || selectedMode != previousMode)
    {
        redraw = true;
        result = 0;
    }

    bool analyze = (swValTact == SW_PUSH && !pushHeld);
    pushHeld = (swValTact == SW_PUSH);
    if (analyze)
    {
        int16_t logNumber = fileNumbers[selectedLog];
        analysisDisplayBegin(modeNames[selectedMode], logNumber);
        switch (selectedMode)
        {
        case 0: result = readLogDistance(logNumber); break;
        case 1: result = routeBuildFromLog(logNumber, 0U); break;
        case 2: result = routeBuildFromLog(logNumber, shortcutSettings.maxLevel); break;
        case 3: result = routeBuildCurvatureFromLog(logNumber); break;
        case 4: result = routeBuildShortcutCurvatureFromLog(logNumber, shortcutSettings.maxLevel); break;
        default: result = -1; break;
        }
        if (result > 0)
        {
            optimalIndex = 0U;
            fileIndexLog = selectedLog;
        }
        redraw = true;
    }
    if (!redraw) return;

    ssd1306_FillRectangle(0, 16, 127, 63, Black);
    int16_t first = selectedLog + 2;
    if (first > endFileIndex) first = endFileIndex;
    for (int16_t row = 0; row < 5 && first - row >= 0; row++)
    {
        int16_t index = first - row;
        ssd1306_SetCursor(0, 16 + (8 * row));
        if (index == selectedLog) ssd1306_printfB(Font_6x8, "%05d", fileNumbers[index]);
        else ssd1306_printf(Font_6x8, "%05d", fileNumbers[index]);
    }
    ssd1306_SetCursor(32, 16);
    ssd1306_printf(Font_6x8, "%s", modeNames[selectedMode]);
    ssd1306_SetCursor(32, 28);
    ssd1306_printf(Font_6x8, "L/R:Mode");
    ssd1306_SetCursor(32, 40);
    ssd1306_printf(Font_6x8, "PUSH:Analyze");
    ssd1306_SetCursor(32, 52);
    if (result > 0) ssd1306_printf(Font_6x8, "OK:%4d", result);
    else if (result < 0) ssd1306_printf(Font_6x8, "Error:%d", result);
    // 結果画面を描き終えてから連続転送を再開する。
    if (analyze) analysisDisplayEnd();
}
///////////////////////////////////////////////////////////////////////////////////////
// モジュール名 setup_start
// 処理概要     スタート待ち画面とキャリブレーションを制御
// 引数         なし
// 戻り値       なし
///////////////////////////////////////////////////////////////////////////////////////
static void setup_start(void)
{
	static bool autoStartAfterCalibration = false;

	if (pattern.display != pattern.beforeHex)
	{
		// 切替時にスタート画面とブースト設定を表示
		ssd1306_printf(Font_6x8, "Start  ");
		ssd1306_SetCursor(30, 25);
		ssd1306_printf(Font_11x18, "Ready?");
		ssd1306_SetCursor(20, 50);
		switch (optimalTrace)
		{
		case BOOST_NONE:
			ssd1306_printf(Font_6x8, "BOOST NONE");
			break;
		case BOOST_DISTANCE:
			ssd1306_printf(Font_6x8, "BOOST DISTANCE");
			break;
		case BOOST_SHORTCUT:
			ssd1306_printf(Font_6x8, "BOOST SHORTCUT");
			break;
		case BOOST_PATH_REPLAY:
			ssd1306_printf(Font_6x8, "PATH REPLAY");
			break;
		case BOOST_PATH_CURVE:
			ssd1306_printf(Font_6x8, "PATH CURVE");
			break;
		case BOOST_SHORTCUT_CURVE:
			ssd1306_printf(Font_6x8, "SHORTCUT CURVE");
			break;
		}
		pattern.calibration = 1;
		autoStartAfterCalibration = false;
	}

	// 自動開始の旋回が完了しない場合は、走行へ進まず停止する。
	if (autoStartAfterCalibration && pattern.calibration >= 4 &&
		pattern.calibration <= 5 && setupTimer.cntSetup1 > 5000)
	{
		finishLineSensorCalibration();
		autoStartCalibrationTurning = false;
		setTargetAngularVelocity(0);
		motorCommandOut(0, 0);
		powerLineSensors(0);
		testFlags.trace_test = false;
		autoStartAfterCalibration = false;
		pattern.calibration = 1;
		ssd1306_FillRectangle(0, 15, 127, 63, Black);
		ssd1306_SetCursor(0, 16);
		ssd1306_printf(Font_11x18, "Calib T/O");
		ssd1306_SetCursor(0, 36);
		ssd1306_printf(Font_6x8, "C:%u/%u", (unsigned int)lSensorCari[4], (unsigned int)lSensorCari[5]);
		ssd1306_SetCursor(0, 46);
		ssd1306_printf(Font_6x8, "A:%.0f G:%.0f", imuVal.angle.z, imuVal.gyro.z);
		ssd1306_SetCursor(0, 56);
		ssd1306_printf(Font_6x8, "S:%u",
			(unsigned int)(autoStartCalibrationStopping ? 2 : autoStartCalibrationLineCaptured ? 1 : 0));
		ssd1306_UpdateScreen();
		return;
	}

	// キャリブレーションの進行状況に応じて処理を分岐
	switch (pattern.calibration)
	{
	case 1: // スイッチ入力待ち
	{
		// 停止状態を維持
		setTargetSpeed(0);

		if (!initIMU)
		{
			if (swValTact == SW_PUSH || swValTact == SW_RIGHT)
			{
				ssd1306_FillRectangle(0, 15, 127, 63, Black);
				ssd1306_SetCursor(15, 25);
				ssd1306_printf(Font_11x18, "Start NG");
				ssd1306_SetCursor(20, 50);
				ssd1306_printf(Font_6x8, "IMU failed");
				ssd1306_UpdateScreen();
			}
			break;
		}

		if (swValTact == SW_PUSH)
		{
			if (isLineSensorCalibrationValid())
			{
				// キャリブレーション実施済み
				setupFlags.start = 1;
			}
			else
			{
				pattern.calibration = 2;
			}
		}
		else if (swValTact == SW_RIGHT)
		{
			// オートスタートの1走目前は、保存済み校正値が有効でも再校正する。
			autoStartAfterCalibration = true;
			pattern.calibration = 2;
		}
		break;
	}
	case 2: // キャリブレーション準備
	{
		veloCtrl.Int = 0;                                                         // I成分リセット
		ssd1306_FillRectangle(0, 15, 127, 63, Black); // メイン表示空白埋め
		ssd1306_SetCursor(22, 28);
		ssd1306_printf(Font_7x10, "Calibration");
		ssd1306_SetCursor(53, 42);
		ssd1306_printf(Font_7x10, "Now");
		ssd1306_UpdateScreen(); // グラフィック液晶更新

		testFlags.trace_test = true;
		setupTimer.cntSetup1 = 0;
		enc1 = 0;
		powerLineSensors(1); // 先に点灯させて安定させる

		pattern.calibration = 3;
		break;
	}
	case 3: // 開始準備
	{
		if (setupTimer.cntSetup1 > 1000)
		{
			veloCtrl.Int = 0;                // I成分リセット
			imuVal.angle.z = 0.0f; // 角度リセット
			yawRateCtrl.Int = 0.0f;   // I成分リセット
			setTargetSpeed(0);               // 目標速度0[m/s]
			enc1 = 0;
			if (autoStartAfterCalibration)
			{
				// 過去の最大・最小値を引き継がず、今回の旋回だけで校正する。
				for (uint8_t i = 0; i < NUM_SENSORS; i++)
				{
					lSensorMax[i] = 0;
					lSensorMin[i] = UINT16_MAX;
				}
			}
			modeCalLinesensors = 1; // キャリブレーション開始
			if (autoStartAfterCalibration)
			{
				autoStartCalibrationReturning = false;
				autoStartCalibrationReturned = false;
				autoStartCalibrationSettledMs = 0;
				autoStartCalibrationAligning = false;
				autoStartCalibrationSearchDirection = -1;
				autoStartCalibrationLineCaptured = false;
				autoStartCalibrationLineAnchorDeg = 0.0F;
				autoStartCalibrationStopping = false;
				setTargetAngularVelocity(CALIBRATIONSPEED);
			}
			autoStartCalibrationTurning = autoStartAfterCalibration;
			pattern.calibration = 4;
		}
		break;
	}
	case 4: // 左旋回
	{
		if (autoStartAfterCalibration)
		{
			if (autoStartCalibrationReturning)
			{
				pattern.calibration = 5;
			}
			break; // 自動校正の目標更新と出力は1ms処理に任せる
		}
		setTargetAngularVelocity(CALIBRATIONSPEED);
		motorCommandOutSynth(0, veloCtrl.pwm, yawRateCtrl.pwm);
		if (imuVal.angle.z < -340.0f)
		{
			pattern.calibration = 5;
		}
		break;
	}
	case 5: // 初期位置に戻る
	{
		if (!autoStartAfterCalibration)
		{
			setTargetAngularVelocity(-400.0F);
			motorCommandOutSynth(0, veloCtrl.pwm, yawRateCtrl.pwm);
		}
		if (autoStartAfterCalibration ? autoStartCalibrationReturned : lSensor[5] < 1000)
		{
			if (autoStartAfterCalibration)
			{
				motorCommandOut(0, 0); // 復帰検出と同じ周期で停止済み。メイン側でも維持する
			}
			if (!autoStartAfterCalibration) finishLineSensorCalibration();
			autoStartCalibrationTurning = false;
			countdown = 500;
			pattern.calibration = 6;
		}
		break;
	}
	case 6: // 停止
	{
		if (autoStartAfterCalibration)
		{
			motorCommandOut(0, 0); // 校正値の有効性にかかわらず停止待ち中は出力しない
		}
		else
		{
			motorCommandOutSynth(lineTraceCtrl.pwm, veloCtrl.pwm, 0);
		}
		if (countdown <= 0)
		{
			powerLineSensors(0); // ラインセンサ消灯
			if (autoStartAfterCalibration)
			{
				setTargetAngularVelocity(0);
				motorCommandOut(0, 0);
				testFlags.trace_test = false;
				float position = 0.0F;
				if (isLineSensorCalibrationValid() && calibrationLinePosition(&position) &&
					fabsf(position) <= (1.0F - AUTO_CALIBRATION_POSITION_TOLERANCE))
				{
					autoStart = 1;
				}
				else
				{
					ssd1306_FillRectangle(0, 15, 127, 63, Black);
					ssd1306_SetCursor(15, 25);
					ssd1306_printf(Font_11x18, "%s",
						isLineSensorCalibrationValid() ? "No line" : "LS invalid");
					ssd1306_UpdateScreen();
				}
				autoStartAfterCalibration = false;
				pattern.calibration = 1;
			}
			else
			{
				setupFlags.start = 1;
			}
		}
		break;
	}
	default:
		break;
	}
}

/////////////////////////////////////////////////////////////////////
// モジュール名 calibrationLinePosition
// 処理概要     周囲との明暗差から細い白線の重心を求める
// 引数         position: 中央からの位置偏差の出力[センサー間隔]
// 戻り値       細い白線として有効ならtrue
/////////////////////////////////////////////////////////////////////
static bool calibrationLinePosition(float *position)
{
	// ADC割り込みで値が更新されるため、この判定で使う10個を一度だけ読む。
	uint16_t values[NUM_SENSORS];
	uint16_t minimum = UINT16_MAX;
	uint16_t maximum = 0;
	const uint32_t primask = __get_PRIMASK();
	__disable_irq();
	for (uint8_t i = 0; i < NUM_SENSORS; i++)
	{
		values[i] = lSensorCari[i];
	}
	__set_PRIMASK(primask);
	for (uint8_t i = 0; i < NUM_SENSORS; i++)
	{
		if (values[i] < minimum) minimum = values[i];
		if (values[i] > maximum) maximum = values[i];
	}
	const uint16_t contrast = maximum - minimum;
	if (contrast < AUTO_CALIBRATION_MIN_CONTRAST) return false;
	const uint16_t background = minimum + contrast / 2U;
	uint32_t sum = 0;
	int32_t moment = 0;
	uint8_t width = 0;
	int8_t previous = -1;
	for (uint8_t i = 0; i < NUM_SENSORS; i++)
	{
		if (values[i] <= background) continue;
		// 離れた複数の明部や広いコース縁は白線候補にしない。
		if (previous >= 0 && i != previous + 1) return false;
		previous = i;
		width++;
		const uint32_t weight = values[i] - background;
		sum += weight;
		moment += ((int32_t)i * 2 - (NUM_SENSORS - 1)) * (int32_t)weight;
	}
	if (width == 0 || width > AUTO_CALIBRATION_LINE_MAX_WIDTH) return false;
	*position = (float)moment / (2.0F * (float)sum);
	return true;
}

/////////////////////////////////////////////////////////////////////
// モジュール名 setupCalibrationTurn1ms
// 処理概要     3/4回転で校正を確定し、中央左の白検出からラインPIDで復帰する
// 引数         なし
// 戻り値       なし
/////////////////////////////////////////////////////////////////////
void setupCalibrationTurn1ms(void)
{
	if (!autoStartCalibrationTurning) return;
	if (!isfinite(imuVal.angle.z) || !isfinite(imuVal.gyro.z))
	{
		autoStartCalibrationSettledMs = 0;
		setTargetAngularVelocity(0);
		motorCommandOut(0, 0);
		return;
	}
	const float returnAngle = -360.0F;
	const float maxAngularVelocity = fabsf(AUTO_CALIBRATION_RETURN_SPEED);
	const float searchSpeed = maxAngularVelocity * 0.5F;
	if (!autoStartCalibrationReturning && imuVal.angle.z <= returnAngle * 0.75F)
	{
		// 3/4回転で校正値を確定する。復帰中は最大・最小値を更新しない。
		finishLineSensorCalibration();
		autoStartCalibrationReturning = true;
	}
	if (autoStartCalibrationReturning)
	{
		if (!isLineSensorCalibrationValid())
		{
			setTargetAngularVelocity(0);
			motorCommandOut(0, 0); // 校正無効では旋回・追従を行わない。
			return;
		}
		const float angleError = returnAngle - imuVal.angle.z;
		float position = 0.0F;
		const bool lineVisible = calibrationLinePosition(&position);
		if (!autoStartCalibrationLineCaptured &&
			fabsf(angleError) <= AUTO_CALIBRATION_SEARCH_WINDOW_DEG &&
			lSensorCari[4] >= AUTO_CALIBRATION_LINE_THRESHOLD && lineVisible)
		{
			// 中央左の白検出から、確定した校正値を使う既存ラインPIDへ切り替える。
			autoStartCalibrationLineCaptured = true;
			autoStartCalibrationLineAnchorDeg = imuVal.angle.z;
			lineTraceCtrl.Int = 0.0F;
		}
		if (autoStartCalibrationLineCaptured)
		{
			setTargetAngularVelocity(0);
			const bool inWindow = fabsf(autoStartCalibrationLineAnchorDeg - imuVal.angle.z) <=
				2.0F * AUTO_CALIBRATION_SEARCH_WINDOW_DEG;
			if (!lineVisible || !inWindow)
			{
				autoStartCalibrationStopping = false;
				autoStartCalibrationSettledMs = 0;
				motorCommandOut(0, 0); // ロスト・角度逸脱時は停止し、タイムアウトで中止する。
				return;
			}
			if (fabsf(position) > 1.0F - AUTO_CALIBRATION_POSITION_TOLERANCE)
				autoStartCalibrationStopping = false;
			if (fabsf(position) <= AUTO_CALIBRATION_POSITION_TOLERANCE)
				autoStartCalibrationStopping = true;
			if (!autoStartCalibrationStopping)
			{
				autoStartCalibrationSettledMs = 0;
				motorControlTrace();
				// 平均速度0のまま、通常ラインPIDの左右差で白線中央へ向ける。
				motorCommandOutSynth(lineTraceCtrl.pwm, veloCtrl.pwm, 0);
				return;
			}
			if (fabsf(imuVal.gyro.z) <= AUTO_CALIBRATION_STOP_RATE_DPS)
				autoStartCalibrationSettledMs++;
			else
				autoStartCalibrationSettledMs = 0;
			if (autoStartCalibrationSettledMs >= AUTO_CALIBRATION_SETTLE_MS)
			{
				autoStartCalibrationTurning = false;
				motorCommandOut(0, 0);
				autoStartCalibrationReturned = true;
				return;
			}
			// 中央へ入った後はラインPIDを外し、角速度0のPIDで制動する。
		}
		else
		{
			float angularVelocity = searchSpeed / AUTO_CALIBRATION_SEARCH_WINDOW_DEG * angleError;
			if (angularVelocity > maxAngularVelocity) angularVelocity = maxAngularVelocity;
			if (angularVelocity < -maxAngularVelocity) angularVelocity = -maxAngularVelocity;
			if (fabsf(angleError) <= AUTO_CALIBRATION_SEARCH_WINDOW_DEG)
				autoStartCalibrationAligning = true;
			if (autoStartCalibrationAligning)
			{
				if (angleError >= AUTO_CALIBRATION_SEARCH_WINDOW_DEG) autoStartCalibrationSearchDirection = 1;
				if (angleError <= -AUTO_CALIBRATION_SEARCH_WINDOW_DEG) autoStartCalibrationSearchDirection = -1;
				angularVelocity = autoStartCalibrationSearchDirection * searchSpeed;
			}
			setTargetAngularVelocity(angularVelocity);
		}
	}
	motorControlYawRate();
	motorCommandOutSynth(0, veloCtrl.pwm, yawRateCtrl.pwm);
}

///////////////////////////////////////////////////////////////////////////////////////
// モジュール名 setup
// 処理概要     走行前設定
// 引数         なし
// 戻り値       なし
///////////////////////////////////////////////////////////////////////////////////////
void setup(void)
{
	static uint8_t beforeBATLV;

	SchmittBatery(); // バッテリレベルを取得
	if (batteryLevel != beforeBATLV)
	{
		// バッテリレベルが変化したときに実行
		showBattery(); // バッテリ残量表示
	}

	// 左ホイールをロータリスイッチ代わりに使用する
	if (!testFlags.trace_test && !testFlags.motor_test)
	{
		if (abs(encClick) > WHEEL_CLICK)
		{
			if (encClick > WHEEL_CLICK)
			{
				pattern.display++;
				setupFlags.clickStart = 1;
			}
			else if (encClick < -WHEEL_CLICK)
			{
				pattern.display--;
				setupFlags.clickStart = -1;
			}

			if (pattern.display > HEX_SHORTCUT_PARAM)
				pattern.display = 0;
			else if (pattern.display < 0)
				pattern.display = HEX_SHORTCUT_PARAM;
			encClick = 0;
		}
	}
	else
	{
		encClick = 0;
	}

	// ページ番号表示
	if (pattern.display != pattern.beforeHex)
	{
		if (!modeDSP) // ディスプレイが無いとき番号をLEDで表示
		{
			led_out(pattern.display);
		}

		// ロータリスイッチ切替時に実行
		showBattery(); // バッテリ残量表示

		// ロータリスイッチ値を表示
		ssd1306_SetCursor(0, 3);
		ssd1306_printf(Font_6x8, "No.%x", pattern.display);

		ssd1306_FillRectangle(0, 15, 127, 63, Black); // メイン表示空白埋め
		ssd1306_FillRectangle(24, 0, 94, 13, Black);  // ヘッダ表示空白埋め
		ssd1306_SetCursor(28, 3);					  // ヘッダタイトル位置
	}

	// ディップスイッチで項目選択
	switch (pattern.display)
	{
	//------------------------------------------------------------------
	// スタート待ち
	//------------------------------------------------------------------
	case HEX_START:
	{
		setup_start(); // スタート待ち画面とキャリブレーションを制御
		break;
	}
	//------------------------------------------------------------------
	// パラメータ調整(通常トレース)
	//------------------------------------------------------------------
	case HEX_SPEED_PARAM:
	{
		setup_speed_param(); // 速度パラメータ調整
		break;
	}
	//------------------------------------------------------------------
	// ショートカット設定調整
	//------------------------------------------------------------------
	case HEX_SHORTCUT_PARAM:
	{
		setup_shortcut_param();
		break;
	}
	//------------------------------------------------------------------
	// センサテスト
	//------------------------------------------------------------------
	case HEX_SENSORS:
	{
		setup_sensors(); // センサ表示とテストメニューを制御
		break;
	}
	//------------------------------------------------------------------
	// Log analysis
	//------------------------------------------------------------------
	case HEX_LOG:
	{
		setup_log(); // ログ解析表示と操作を制御
		break;
	}
	//------------------------------------------------------------------
	// キャリブレーション(ラインセンサ)
	//------------------------------------------------------------------
	case HEX_CALIBRATION:
	{
		setup_calibration(); // キャリブレーション(ラインセンサ)
		break;
	}
	//------------------------------------------------------------------
	// ゲイン調整(直線トレース)
	//------------------------------------------------------------------
	case HEX_PID_TRACE:
	{
		setup_pid(&lineTraceCtrl, false); // ゲイン調整(直線トレース)
		break;
	}
	//------------------------------------------------------------------
	// ゲイン調整(直線トレース 角速度フィードバック)
	//------------------------------------------------------------------
	case HEX_PID_TRACE_OMEGA:
	{
		setup_pid(&lineTraceOmegaFBCtrl, false); // ゲイン調整(直線トレース)
		break;
	}
	//------------------------------------------------------------------
	// ゲイン調整(速度)
	//------------------------------------------------------------------
	case HEX_PID_SPEED:
	{
		setup_pid(&veloCtrl, true); // 速度PIDゲイン調整
		break;
	}

	default:
	{
		ssd1306_SetCursor(30, 5);
		ssd1306_printf(Font_6x8, "None      ");
		ssd1306_FillRectangle(0, 16, 127, 63, Black);

		break;
	}
	} // switch

	// 前回値更新
	pattern.beforeHex = pattern.display;
	beforeBATLV = batteryLevel;

	if (!modeDSP)
	{
		sendLED();
	}

	if (!testFlags.trace_test && !calibratIMU && ssd1306_IsReadyForSingleUpdate())
	{
		ssd1306_UpdateScreen(); // 連続DMA停止中だけ同期転送する
	}
}
///////////////////////////////////////////////////////////////////////////////////////
// モジュール名 data_select
// 処理概要     タクトスイッチで0,1に変化させる
// 引数         data: 変化させる変数 button: どのスイッチで変化させるか
// 戻り値       なし
///////////////////////////////////////////////////////////////////////////////////////
void data_select(uint8_t *data, uint8_t button)
{
	static uint8_t push = 0;

	if (swValTact == button)
	{
		if (*data == 1 && push == 0)
		{
			push = 1;
			*data = 0;
		}
		else if (*data == 0 && push == 0)
		{
			push = 1;
			*data = 1;
		}
	}
	else
	{
		push = 0;
	}
}
///////////////////////////////////////////////////////////////////////////////////////
// モジュール名 dataTuning
// 処理概要     タクトスイッチの方向と数値型を指定して値を加減する
// 引数         data: 調整対象の変数 add: 変化量 min: 最小値 max: 最大値 dir: 方向 UD/LR type: 型 int16_t/float
// 戻り値       なし
///////////////////////////////////////////////////////////////////////////////////////
void dataTuning(void *data, float add, float min, float max, uint8_t dir, uint8_t type)
{
	int16_t sign;
	uint16_t *cntSwitch;
	uint16_t *cntSwitchLong;
	int8_t *push;
	uint8_t swPlus;
	uint8_t swMinus;

	// max と min の差から加算方向を決定
	if (max - min > 0)
	{
		sign = 1;
	}
	else
	{
		sign = -1;
	}

	// 方向に応じて使用するスイッチとカウンタを設定
	if (dir == UD)
	{
		cntSwitch = &setupTimer.cntSwitchUD;
		cntSwitchLong = &setupTimer.cntSwitchUDLong;
		push = &pushUD;
		swPlus = SW_UP;     // 増加方向のスイッチ
		swMinus = SW_DOWN;  // 減少方向のスイッチ
	}
	else
	{
		cntSwitch = &setupTimer.cntSwitchLR;
		cntSwitchLong = &setupTimer.cntSwitchLRLong;
		push = &pushLR;
		swPlus = SW_RIGHT;  // 増加方向のスイッチ
		swMinus = SW_LEFT;  // 減少方向のスイッチ
	}

	// スイッチ入力に応じて値を更新
	if (*cntSwitch >= 50)        // 一定周期で判定
	{
		if (swValTact == swPlus || swValTact == swMinus)
		{
			(*cntSwitchLong)++; // 長押し時間を加算
			if (swValTact == swPlus)
			{
				// インクリメント処理
				if (*cntSwitchLong >= PUSHTIME)
				{ // 長押し時
					if (type == TYPE_FLOAT)
					{
						*(float *)data += sign * (float)add;
					}
					else
					{
						*(int16_t *)data += sign * (int16_t)add;
					}
				}
				else if (*push == 0)
				{ // 1回押し
					*push = 1;
					if (type == TYPE_FLOAT)
					{
						*(float *)data += sign * (float)add;
					}
					else
					{
						*(int16_t *)data += sign * (int16_t)add;
					}
				}
			}
			else if (swValTact == swMinus)
			{
				// デクリメント処理
				if (*cntSwitchLong >= PUSHTIME)
				{ // 長押し時
					if (type == TYPE_FLOAT)
					{
						*(float *)data -= sign * (float)add;
					}
					else
					{
						*(int16_t *)data -= sign * (int16_t)add;
					}
				}
				else if (*push == 0)
				{ // 1回押し
					*push = 1;
					if (type == TYPE_FLOAT)
					{
						*(float *)data -= sign * (float)add;
					}
					else
					{
						*(int16_t *)data -= sign * (int16_t)add;
					}
				}
			}
		}
		else
		{
			*push = 0;          // 押下状態をリセット
			*cntSwitchLong = 0; // 長押しカウンタをリセット
		}
		*cntSwitch = 0;             // 判定後にカウンタをリセット

		// 上限・下限を超えた場合の折り返し処理
		if (type == TYPE_FLOAT)
		{
			float *d = (float *)data;
			if (sign > 0)
			{
				if (*d > (float)max)
				{
					*d = (float)min;
				}
				else if (*d < (float)min)
				{
					*d = (float)max;
				}
			}
			else
			{
				if (*d > (float)min)
				{
					*d = (float)max;
				}
				else if (*d < (float)max)
				{
					*d = (float)min;
				}
			}
		}
		else
		{
			int16_t *d = (int16_t *)data;
			if (sign > 0)
			{
				if (*d > (int16_t)max)
				{
					*d = (int16_t)min;
				}
				else if (*d < (int16_t)min)
				{
					*d = (int16_t)max;
				}
			}
			else
			{
				if (*d > (int16_t)min)
				{
					*d = (int16_t)max;
				}
				else if (*d < (int16_t)max)
				{
					*d = (int16_t)min;
				}
			}
		}
	}
}
///////////////////////////////////////////////////////////////////////////////////////
// モジュール名 dataTuningUD
// 処理概要     上下方向でint16_t値を調整するラッパー
// 引数         data: 調整対象の変数 add: 変化量 min: 最小値 max: 最大値
// 戻り値       なし
///////////////////////////////////////////////////////////////////////////////////////
void dataTuningUD(int16_t *data, int16_t add, int16_t min, int16_t max)
{
	// 汎用関数へ上下方向とint16_t型を指定して委譲
	dataTuning(data, add, min, max, UD, TYPE_INT16);
}
///////////////////////////////////////////////////////////////////////////////////////
// モジュール名 dataTuningLR
// 処理概要     左右方向でint16_t値を調整するラッパー
// 引数         data: 調整対象の変数 add: 変化量 min: 最小値 max: 最大値
// 戻り値       なし
///////////////////////////////////////////////////////////////////////////////////////
void dataTuningLR(int16_t *data, int16_t add, int16_t min, int16_t max)
{
	// 汎用関数へ左右方向とint16_t型を指定して委譲
	dataTuning(data, add, min, max, LR, TYPE_INT16);
}
///////////////////////////////////////////////////////////////////////////////////////
// モジュール名 dataTuningUDF
// 処理概要     上下方向でfloat値を調整するラッパー
// 引数         data: 調整対象の変数 add: 変化量 min: 最小値 max: 最大値
// 戻り値       なし
///////////////////////////////////////////////////////////////////////////////////////
void dataTuningUDF(float *data, float add, float min, float max)
{
	// 汎用関数へ上下方向とfloat型を指定して委譲
	dataTuning(data, add, min, max, UD, TYPE_FLOAT);
}
///////////////////////////////////////////////////////////////////////////////////////
// モジュール名 setupNonDisp
// 処理概要     拡張ボードを接続していないときのセットアップ
// 引数         なし
// 戻り値       なし
///////////////////////////////////////////////////////////////////////////////////////
void setupNonDisp(void)
{
	static uint8_t mode = 0;

	switch (pattern.calibration)
	{
	case 1:
		setTargetSpeed(0);

		led_out(0x9);
		if (!initIMU)
		{
			led_out(0xe);
			break;
		}

		// スイッチ入力待ち
		if (swValMainTact == SW_TACT_L || swValMainTact == SW_TACT_R)
		{
			if (swValMainTact == SW_TACT_L)
			{
				mode = START_SERACH;
			}
			else if (swValMainTact == SW_TACT_R)
			{
				mode = START_OPTIMAL;
			}
			veloCtrl.Int = 0; // I成分リセット
			if (isLineSensorCalibrationValid())
			{
				// キャリブレーション実施済み
				setupFlags.start = 1;
			}
			else
			{
				// キャリブレーション未実施
				setupTimer.cntSetup1 = 0;
				enc1 = 0;
				powerLineSensors(1); // 先に点灯させて安定させる
				pattern.calibration = 2;
			}
		}
		break;

	case 2:
		// 開始準備
		if (setupTimer.cntSetup1 > 1000)
		{
			veloCtrl.Int = 0;		// I成分リセット
			imuVal.angle.z = 0.0f;	// 角度リセット
			yawRateCtrl.Int = 0.0f;	// I成分リセット
			setTargetSpeed(0);		 // 目標速度0[m/s]
			enc1 = 0;
			modeCalLinesensors = 1; // キャリブレーション開始
			pattern.calibration = 3;
		}
		break;

	case 3:
		// 左旋回
		setTargetAngularVelocity(CALIBRATIONSPEED);
		motorCommandOutSynth(0, veloCtrl.pwm, yawRateCtrl.pwm);
		if (imuVal.angle.z < -35.0f)
		{
			pattern.calibration = 4;
		}
		break;

	case 4:
		// 停止
		setTargetSpeed(0);
		motorCommandOutSynth(0, veloCtrl.pwm, 0);
		if (abs(encCurrentN) == 0)
		{
			pattern.calibration = 5;
		}
		break;

	case 5:
		// 右旋回
		setTargetAngularVelocity(-CALIBRATIONSPEED);
		motorCommandOutSynth(0, veloCtrl.pwm, yawRateCtrl.pwm);
		if (imuVal.angle.z > 35.0f)
		{
			pattern.calibration = 6;
		}
		break;

	case 6:
		// 停止
		setTargetSpeed(0);
		motorCommandOutSynth(0, veloCtrl.pwm, 0);
		if (abs(encCurrentN) == 0)
		{
			pattern.calibration = 7;
		}
		break;

	case 7:
		// 初期位置に戻る
		setTargetAngularVelocity(CALIBRATIONSPEED);
		motorCommandOutSynth(0, veloCtrl.pwm, yawRateCtrl.pwm);
		if (lSensor[5] < 1000)
		{
			finishLineSensorCalibration();
			pattern.calibration = 8;
		}
		break;

	case 8:
		// 停止
		motorCommandOutSynth(0, veloCtrl.pwm, 0);
		if (abs(encCurrentN) == 0)
		{
			powerLineSensors(0); // ラインセンサ消灯
			if (mode == START_OPTIMAL)
			{
				// 距離基準解析
				numPPADarry = readLogDistance(analyzedNumber);
				if (numPPADarry > 0)
				{
					optimalTrace = BOOST_DISTANCE;
					optimalIndex = 0;
				}
			}
			setupFlags.start = mode;
		}
		break;

	default:
		break;
	}
}
/////////////////////////////////////////////////////////////////////
// モジュール名 setupCount
// 処理概要     セットアップ用タイマを加算
// 引数         なし
// 戻り値       なし
/////////////////////////////////////////////////////////////////////
void setupCount(void)
{
	setupTimer.cntSetup1++;
	setupTimer.cntSetup2++;
	setupTimer.cntSwitchUD++;
	setupTimer.cntSwitchLR++;
}
///////////////////////////////////////////////////////////////////////////////////////
// モジュール名 wheelClick
// 処理概要     ホイールを短時間回転させクリック感を出す
// 引数         なし
// 戻り値       なし
///////////////////////////////////////////////////////////////////////////////////////
void wheelClick(void)
{
	static uint8_t cnt = 0;
	uint16_t pwm = 200;

	switch (pattern.click)
	{
	case 1:
		if (setupFlags.clickStart != 0)
		{
			pattern.click = 2;
		}
		break;

	case 2:
		motorCommandOut(-pwm * setupFlags.clickStart, 0);
		cnt++;
		if (cnt >= 3)
		{
			cnt = 0;
			pattern.click = 3;
		}
		break;

	case 3:
		motorCommandOut(pwm * setupFlags.clickStart, 0);
		cnt++;
		if (cnt >= 3)
		{
			cnt = 0;
			pattern.click = 4;
		}
		break;

	case 4:
		motorCommandOut(0, 0);
		setupFlags.clickStart = 0;
		pattern.click = 1;
		break;
	}
}
