Kageyana/robotrace_v2/robotrace_v2/Core/Src/pathFollower.c

//====================================//
// インクルード
//====================================//
#include "pathFollower.h"
#include "analysisDisplay.h"
#include "logSource.h"
#include "logPerformance.h"
#include "autoRun.h"
#include "calibrationConstants.h"
#include "PIDcontrol.h"
#include "SDcard.h"
#include "control.h"
#include "courseAnalysis.h"
#include "encoder.h"
#include "ff.h"
#include "lineSensor.h"
#include "sd_functions.h"
#include "slipDetection.h"
#include <math.h>
#include <stdlib.h>
#include <string.h>

#define PATH_SETTING_FILE                    "./setting/shortcut.txt"

#define PATH_CSV_LINE_SIZE                    RUN_ANALYSIS_LINE_SIZE

#define PATH_FLAG_CORRIDOR_RESERVED           0x01U
#define PATH_FLAG_CORRIDOR_APPLIED            0x02U
#define PATH_FLAG_CROSS_STRAIGHT              0x04U
#define PATH_FLAG_CORRIDOR_EXCLUDED           0x08U

typedef struct
{
    uint32_t expectedRows;
    bool closureValid;
} RouteSourceInfo;

typedef struct
{
	float x_mm;
	float y_mm;
	float heading_deg;
} PathPose;

typedef struct
{
	float lateral_mm;
	float forward_mm;
} PathLineObservation;

typedef struct
{
	float x_mm;
	float y_mm;
	float residual_mm;
	float normalX;
	float normalY;
} PathLineMatch;

#define lineRoute (runMemory.path.line)
#define driveRoute (runMemory.path.drive)
#define sourceRouteXY (runMemory.path.sourceXY)
#define driveRouteArcMm (runMemory.path.arcMm)
#define routeFlags (runMemory.path.flags)
#define routeMarkers (runMemory.path.markers)
#define whiteRoute (runMemory.path.white)
// 速度生成前のdrive側を短縮候補の累積反転数へ一時利用する。構造体・RAM量は変えない。
#define corridorTurnChanges(index) (driveRoute[(index)].speed_cms)
//====================================//
// グローバル変数の宣言、定義
//====================================//
// キャッシュは共有RAM上の延長前基準経路だけ。走行メタデータは従来どおり別保持。
static struct {
    bool valid;
    bool sourceRadiiValid;
    uint16_t baseCount;
    uint32_t epoch;
    LogBinaryHeader source;
    ShortcutSettings settings;
} routeCache;

//====================================//
// プロトタイプ宣言
//====================================//

/////////////////////////////////////////////////////////////////////
// モジュール名 pathPolicyAssociationAllowed
// 処理概要     経路候補の弧長と向きの許容範囲を判定する
// 引数         candidateArcMm/maximumArcMm: 候補弧長と上限[mm]
//              headingErrorDeg/maximumHeadingErrorDeg: 方位差と上限[deg]
// 戻り値       true: 条件成立 false: 条件不成立
/////////////////////////////////////////////////////////////////////
static bool pathPolicyAssociationAllowed(float candidateArcMm,
	float maximumArcMm, float headingErrorDeg, float maximumHeadingErrorDeg)
{
	return isfinite(candidateArcMm) && isfinite(maximumArcMm) &&
		isfinite(headingErrorDeg) && candidateArcMm <= maximumArcMm &&
		fabsf(headingErrorDeg) <= maximumHeadingErrorDeg;
}

/////////////////////////////////////////////////////////////////////
// モジュール名 pathPolicyPoseCorrectionAllowed
// 処理概要     位置と姿勢の補正量が許容範囲内か判定する
// 引数         positionCorrectionMm/maximumPositionCorrectionMm: 位置補正量と上限[mm]
//              headingCorrectionDeg/maximumHeadingCorrectionDeg: 角度補正量と上限[deg]
// 戻り値       true: 条件成立 false: 条件不成立
/////////////////////////////////////////////////////////////////////
static bool pathPolicyPoseCorrectionAllowed(float positionCorrectionMm,
	float headingCorrectionDeg, float maximumPositionCorrectionMm,
	float maximumHeadingCorrectionDeg)
{
	return isfinite(positionCorrectionMm) && isfinite(headingCorrectionDeg) &&
		positionCorrectionMm >= 0.0F && maximumPositionCorrectionMm >= 0.0F &&
		fabsf(headingCorrectionDeg) <= maximumHeadingCorrectionDeg &&
		positionCorrectionMm <= maximumPositionCorrectionMm;
}

/////////////////////////////////////////////////////////////////////
// モジュール名 pathPolicyComputeGoalExtension
// 処理概要     原点方向へのゴール延長点と必要点数を計算する
// 引数         endXmm/endYmm: 経路終端[mm], spacingMm: 点間隔[mm], availablePoints: 空き点数
//              goalXmm/goalYmm/extensionMm: 延長結果[mm], appendCount: 追加点数
// 戻り値       true: 条件成立 false: 条件不成立
/////////////////////////////////////////////////////////////////////
static bool pathPolicyComputeGoalExtension(float endXmm, float endYmm,
	float spacingMm, uint16_t availablePoints, float *goalXmm, float *goalYmm,
	float *extensionMm, uint16_t *appendCount)
{
	if (goalXmm == NULL || goalYmm == NULL || extensionMm == NULL || appendCount == NULL ||
		!isfinite(endXmm) || !isfinite(endYmm) || !isfinite(spacingMm) || spacingMm <= 0.0F)
	{
		return false;
	}
	float distanceToOriginMm = hypotf(endXmm, endYmm);
	float requiredExtensionMm = distanceToOriginMm * 0.5F;
	if (!isfinite(requiredExtensionMm) || requiredExtensionMm < 1.0F) return false;
	float requiredPointsF = ceilf(requiredExtensionMm / spacingMm);
	if (!isfinite(requiredPointsF) || requiredPointsF < 1.0F || requiredPointsF > availablePoints ||
		requiredPointsF > UINT16_MAX)
	{
		return false;
	}
	*goalXmm = endXmm * 0.5F;
	*goalYmm = endYmm * 0.5F;
	*extensionMm = requiredExtensionMm;
	*appendCount = (uint16_t)requiredPointsF;
	return true;
}

/////////////////////////////////////////////////////////////////////
// モジュール名 pathPolicySourceMetadataValid
// 処理概要     一次経路元の終了状態と校正条件を検証する
// 引数         versionSupported/closureValid/primaryMode/normalStop: 形式・終了状態
//              closureReason: 閉路理由, pulsePerMeter: 距離換算[pulse/m]
//              imuCalibrationValid/imuCalibrationSamples/imuCalibrationReadErrors: 校正状態
//              distanceScaleVerified: 距離検証, expectedRows: 行数
// 戻り値       true: 条件成立 false: 条件不成立
/////////////////////////////////////////////////////////////////////
static bool pathPolicySourceMetadataValid(bool versionSupported,
	bool closureValid, uint32_t closureReason, bool primaryMode, bool normalStop,
	uint32_t pulsePerMeter, bool imuCalibrationValid, uint32_t imuCalibrationSamples,
	uint32_t imuCalibrationReadErrors, bool distanceScaleVerified, uint32_t expectedRows)
{
	return versionSupported && closureValid && closureReason == 0U && primaryMode && normalStop &&
		pulsePerMeter == (uint32_t)CALIBRATED_ENCODER_PULSE_PER_METER && imuCalibrationValid &&
		imuCalibrationSamples == CALIBRATED_IMU_SAMPLE_COUNT &&
		imuCalibrationReadErrors == 0U && distanceScaleVerified && expectedRows > 0U;
}

/////////////////////////////////////////////////////////////////////
// モジュール名 pathPolicyGoalReached
// 処理概要     有効な経路終端の弧長へ到達したか判定する
// 引数         goalValid: 終端の有効性, routeIndex/routeCount: 経路位置と点数
//              currentArcMm/goalArcMm: 現在とゴールの弧長[mm]
// 戻り値       true: 条件成立 false: 条件不成立
/////////////////////////////////////////////////////////////////////
static bool pathPolicyGoalReached(bool goalValid, uint16_t routeIndex,
	uint16_t routeCount, uint16_t currentArcMm, uint16_t goalArcMm)
{
	return goalValid && routeIndex < routeCount && currentArcMm >= goalArcMm;
}

/////////////////////////////////////////////////////////////////////
// モジュール名 pathCacheMatches
// 処理概要     同一系列・検証済み元ログ・生成設定のキャッシュか確認する
// 引数         source: 全件検証済み識別情報, settings: 生成設定
// 戻り値       true: 再利用可能 false: 再生成が必要
/////////////////////////////////////////////////////////////////////
static bool pathCacheMatches(const LogBinaryHeader *source, const ShortcutSettings *settings)
{
    const ShortcutSettings *old = &routeCache.settings;
    return routeCache.valid && routeCache.sourceRadiiValid &&
        autoRunState.seriesActive && runMemoryOwner == RUN_MEMORY_PATH &&
        routeCache.epoch == autoRunSeriesGeneration() && routeCache.baseCount >= 2U &&
        routeCache.baseCount <= PATH_ROUTE_MAX_POINTS &&
        routeCache.source.number == source->number && routeCache.source.profile == source->profile &&
        routeCache.source.recordBytes == source->recordBytes && routeCache.source.rows == source->rows &&
        routeCache.source.metadataBytes == source->metadataBytes && routeCache.source.schema == source->schema &&
        routeCache.source.dataCrc == source->dataCrc && routeCache.source.metadataCrc == source->metadataCrc &&
        routeCache.source.schemaBytes == source->schemaBytes && routeCache.source.columns == source->columns &&
        routeCache.source.derivedVersion == source->derivedVersion &&
        old->maxLevel == settings->maxLevel && old->lookaheadBaseMm == settings->lookaheadBaseMm &&
        old->lookaheadPerMpsMm == settings->lookaheadPerMpsMm && old->kLateral_x100 == settings->kLateral_x100 &&
        old->kHeading_x100 == settings->kHeading_x100 && old->lineAlpha_x1000 == settings->lineAlpha_x1000 &&
        old->lineThetaGain_x1e9 == settings->lineThetaGain_x1e9;
}

static uint16_t routeCount = 0U;
static int16_t routeSourceLog = 0;
static uint8_t routeShortcutRequestedLevel = 0U;
static uint8_t routeShortcutLevel = 0U;
static uint8_t routeShortcutBuildStatus = PATH_SHORTCUT_BUILD_NOT_REQUESTED;
static uint8_t routeShortcutCorridorCount = 0U;
static float routeShortcutReductionMm = 0.0f;
static uint32_t routeGeometryCrc32 = 0U;
static ShortcutSettings routeGenerationSettings = {0U, 0U, 0U, 0U, 0U, 0U, 0U};
static ShortcutSettings runStartSettings = {0U, 0U, 0U, 0U, 0U, 0U, 0U};
static ShortcutSettings runGenerationSettings = {0U, 0U, 0U, 0U, 0U, 0U, 0U};
static int16_t runRouteSourceLog = 0;
static uint8_t runRouteRequestedLevel = 0U;
static uint8_t runRouteShortcutLevel = 0U;
static uint8_t runRouteShortcutBuildStatus = PATH_SHORTCUT_BUILD_NOT_REQUESTED;
static uint8_t runRouteShortcutCorridorCount = 0U;
static float runRouteShortcutReductionMm = 0.0f;
static uint16_t runRouteCount = 0U;
static uint32_t runRouteGeometryCrc32 = 0U;
static float runLoopPeriodMm = 0.0f;
static bool runStartSettingsValid = false;
static PathPose pathPose;
static PathFollowerState followerState = PATH_STATE_INACTIVE;
static uint16_t routeIndex = 0U;
static uint16_t lostCount = 0U;
static uint16_t rejoinCount = 0U;
static uint16_t lineLostCount = 0U;
static uint16_t pathBlendPermille = 1000U;
static float targetSpeedMps = 0.0f;
static float pathTravelMm = 0.0f;
static uint16_t pathGoalArcMm = 0U;
static bool pathGoalValid = false;
static bool currentLineValid = false;
static PathFusionFilter whiteFusionFilter;
static uint16_t routeMarkerCount = 0U;
static float routeLoopPeriodMm = 0.0f;
static PathObservationTrust observationTrust;
static float observationStepDistanceMm = 0.0f;
static float limitedTargetSpeedMps = 0.0f;

/////////////////////////////////////////////////////////////////////
// モジュール名 pathCrc32UpdateByte
// 処理概要     CRC32へ1バイトをリトルエンディアン順で追加する
// 引数         crc:現在のCRC, value:追加するバイト
// 戻り値       更新後のCRC
/////////////////////////////////////////////////////////////////////
static uint32_t pathCrc32UpdateByte(uint32_t crc, uint8_t value)
{
	crc ^= value;
	for (uint8_t bit = 0U; bit < 8U; bit++)
	{
		crc = (crc & 1U) ? ((crc >> 1U) ^ 0xEDB88320UL) : (crc >> 1U);
	}
	return crc;
}

/////////////////////////////////////////////////////////////////////
// モジュール名 pathCrc32UpdateU16LE
// 処理概要     16bit値を固定リトルエンディアン形式でCRC32へ追加する
// 引数         crc:現在のCRC, value:追加する16bit値
// 戻り値       更新後のCRC
/////////////////////////////////////////////////////////////////////
static uint32_t pathCrc32UpdateU16LE(uint32_t crc, uint16_t value)
{
	crc = pathCrc32UpdateByte(crc, (uint8_t)(value & 0xFFU));
	return pathCrc32UpdateByte(crc, (uint8_t)(value >> 8U));
}

/////////////////////////////////////////////////////////////////////
// モジュール名 pathComputeRouteGeometryCrc32
// 処理概要    生成済み点数と元経路・走行経路の整数XY座標からCRC32を計算する
// 引数         なし
// 戻り値       経路形状CRC32
/////////////////////////////////////////////////////////////////////
static uint32_t pathComputeRouteGeometryCrc32(void)
{
	uint32_t crc = 0xFFFFFFFFUL;
	crc = pathCrc32UpdateU16LE(crc, routeCount);
	for (uint16_t i = 0U; i < routeCount; i++)
	{
		crc = pathCrc32UpdateU16LE(crc, (uint16_t)lineRoute[i].x_mm);
		crc = pathCrc32UpdateU16LE(crc, (uint16_t)lineRoute[i].y_mm);
		crc = pathCrc32UpdateU16LE(crc, (uint16_t)driveRoute[i].x_mm);
		crc = pathCrc32UpdateU16LE(crc, (uint16_t)driveRoute[i].y_mm);
	}
	return crc ^ 0xFFFFFFFFUL;
}

// KiCad基板座標と実機のsensor[0]=左端、sensor[9]=右端を照合した受光中心横座標[mm]。
static const float pathSensorLateralMm[NUM_SENSORS] = {
	-41.70f, -35.04f, -27.29f, -18.68f, -9.49f,
	9.50f, 18.68f, 27.29f, 35.05f, 41.70f
};

// 中央受光中心の実測前方距離95mmとKiCad相対座標から求めた受光中心前方座標[mm]。
static const float pathSensorForwardMm[NUM_SENSORS] = {
	76.07f, 82.88f, 88.42f, 92.50f, 95.00f,
	95.00f, 92.50f, 88.42f, 82.88f, 76.07f
};

ShortcutSettings shortcutSettings = {0U, PATH_DEFAULT_LOOKAHEAD_BASE_MM,
	PATH_DEFAULT_LOOKAHEAD_PER_MPS_MM, PATH_DEFAULT_KLATERAL_X100,
	PATH_DEFAULT_KHEADING_X100, PATH_DEFAULT_LINE_ALPHA_X1000,
	PATH_DEFAULT_LINE_THETA_GAIN_X1E9};
float pathLogLinePointX_mm = 0.0f;
float pathLogLinePointY_mm = 0.0f;
uint8_t pathLogLineValid = 0U;
float pathLogErrorY_mm = 0.0f;
int16_t pathLogErrorHeading_cdeg = 0;
uint8_t pathLogState = PATH_STATE_INACTIVE;
float pathLogYawFF_dps = 0.0f;
float pathLogYawLateralFB_dps = 0.0f;
float pathLogYawHeadingFB_dps = 0.0f;
float pathLogLegalMargin_mm = 0.0f;
float pathLogLineMatchResidual_mm = 0.0f;
uint16_t pathLogPoseCorrection_um = 0U;
int16_t pathLogPoseCorrectionHeading_cdeg = 0;
uint16_t pathLogConfidencePermille = 1000U;
uint16_t pathLogObservationAgeMs = 0U;
PathCorrectionLog pathCorrectionLog;

/////////////////////////////////////////////////////////////////////
// モジュール名 pathWrapDeg
// 処理概要     角度を-180～180degへ正規化する
// 引数         angleDeg: 正規化前の角度[deg]
// 戻り値       正規化後の角度[deg]
/////////////////////////////////////////////////////////////////////
static float pathWrapDeg(float angleDeg)
{
	while (angleDeg > 180.0f) angleDeg -= 360.0f;
	while (angleDeg < -180.0f) angleDeg += 360.0f;
	return angleDeg;
}

/////////////////////////////////////////////////////////////////////
// モジュール名 pathPointDistance
// 処理概要     2点間の直線距離を算出する
// 引数         x0,y0,x1,y1: 2点の座標[mm]
// 戻り値       2点間距離[mm]
/////////////////////////////////////////////////////////////////////
static float pathPointDistance(float x0, float y0, float x1, float y1)
{
	float dx = x1 - x0;
	float dy = y1 - y0;
	return sqrtf((dx * dx) + (dy * dy));
}

/////////////////////////////////////////////////////////////////////
// モジュール名 pathBuildRouteArcLength
// 処理概要     指定経路の各点までの累積弧長を算出する
// 引数         route: 弧長を計算する整数座標の経路
// 戻り値       なし
/////////////////////////////////////////////////////////////////////
static void pathBuildRouteArcLength(const RoutePoint *route)
{
	memset(driveRouteArcMm, 0, sizeof(driveRouteArcMm));
	pathGoalArcMm = 0U;
	pathGoalValid = false;
	float accumulatedMm = 0.0f;
	for (uint16_t i = 1U; i < routeCount; i++)
	{
		accumulatedMm += pathPointDistance(route[i - 1U].x_mm, route[i - 1U].y_mm,
			route[i].x_mm, route[i].y_mm);
		float storedMm = fminf(accumulatedMm, (float)UINT16_MAX);
		driveRouteArcMm[i] = (uint16_t)lroundf(storedMm);
	}
	if (routeCount >= 2U)
	{
		pathGoalArcMm = driveRouteArcMm[routeCount - 1U];
		pathGoalValid = true;
	}
}

/////////////////////////////////////////////////////////////////////
// モジュール名 pathBuildDriveRouteArcLength
// 処理概要     実走行経路の累積弧長を確定する
// 引数         なし
// 戻り値       なし
/////////////////////////////////////////////////////////////////////
static void pathBuildDriveRouteArcLength(void)
{
	pathBuildRouteArcLength(driveRoute);
}

/////////////////////////////////////////////////////////////////////
// モジュール名 pathFloatToInt16
// 処理概要     浮動小数値をint16_t範囲へ飽和して丸める
// 引数         value: 変換前の値
// 戻り値       飽和・丸め後の値
/////////////////////////////////////////////////////////////////////
static int16_t pathFloatToInt16(float value)
{
	if (value > 32767.0f) return INT16_MAX;
	if (value < -32768.0f) return INT16_MIN;
	return (int16_t)lroundf(value);
}

/////////////////////////////////////////////////////////////////////
// モジュール名 pathReadSourceMetadata
// 処理概要     全CRC検証済みメタデータから経路元の妥当性を確認する
// 引数         file:読込ファイル, source:経路元情報の格納先
// 戻り値       true:有効な一次経路元 false:必要な検証情報なし
/////////////////////////////////////////////////////////////////////
static bool pathReadSourceMetadata(FIL *file, RouteSourceInfo *source)
{
    const char *metadata = logSourceMetadata(file);
    int32_t version, closure, reason, mode, stop, scale;
    int32_t calibrated, samples, errors, distanceVerified, expectedRows;
    if (!logMetadataReadInt(metadata, "pathSourceFormatVersion", &version) ||
        !logMetadataReadInt(metadata, "closureValid", &closure) ||
        !logMetadataReadInt(metadata, "closureReason", &reason) ||
        !logMetadataReadInt(metadata, "optimalTrace", &mode) ||
        !logMetadataReadInt(metadata, "emcStop", &stop) ||
        !logMetadataReadInt(metadata, "encoderPulsePerMeter", &scale) ||
        !logMetadataReadInt(metadata, "imuCalibrationValid", &calibrated) ||
        !logMetadataReadInt(metadata, "imuCalibrationSamples", &samples) ||
        !logMetadataReadInt(metadata, "imuCalibrationReadErrors", &errors) ||
        !logMetadataReadInt(metadata, "distanceScaleVerified", &distanceVerified) ||
        !logMetadataReadInt(metadata, "logExpectedRows", &expectedRows) ||
        expectedRows <= 0 || expectedRows > (int32_t)UINT16_MAX || reason < 0 || scale <= 0 ||
        samples < 0 || errors < 0) return false;
    source->expectedRows = (uint32_t)expectedRows;
    source->closureValid = pathPolicySourceMetadataValid(
        version == 1, closure == 1, (uint32_t)reason,
        mode == BOOST_NONE, stop == 0, (uint32_t)scale,
        calibrated == 1, (uint32_t)samples, (uint32_t)errors,
        distanceVerified == 1, source->expectedRows);
    return source->closureValid;
}

/////////////////////////////////////////////////////////////////////
// モジュール名 pathAppendRouteSample
// 処理概要     経路を20mm間隔で再標本化する
// 引数         xMm/yMm: 終点[mm], previousX/Y: 前点,
//              accumulated: 残距離[mm]
// 戻り値       true:追加成功 false:点数上限
/////////////////////////////////////////////////////////////////////
static bool pathAppendRouteSample(float xMm, float yMm,
	float *previousX, float *previousY, float *accumulated)
{
	float startX = *previousX;
	float startY = *previousY;
	float remaining = pathPointDistance(startX, startY, xMm, yMm);
	while (remaining > 0.0f && *accumulated + remaining >= PATH_ROUTE_SPACING_MM)
	{
		if (routeCount >= PATH_ROUTE_MAX_POINTS - PATH_GOAL_RESERVED_POINTS) return false;
		float needed = PATH_ROUTE_SPACING_MM - *accumulated;
		float ratio = needed / remaining;
		startX += (xMm - startX) * ratio;
		startY += (yMm - startY) * ratio;
		lineRoute[routeCount].x_mm = pathFloatToInt16(startX);
		lineRoute[routeCount].y_mm = pathFloatToInt16(startY);
		sourceRouteXY[routeCount] = (PathSourcePoint){startX, startY};
		routeCount++;
		remaining -= needed;
		*accumulated = 0.0f;
	}
	*accumulated += remaining;
	*previousX = xMm;
	*previousY = yMm;
	return true;
}

/////////////////////////////////////////////////////////////////////
// モジュール名 pathComputeHeadings
// 処理概要     経路点列から各点の接線方位を算出する
// 引数         route: 経路点列, count: 経路点数
// 戻り値       なし
/////////////////////////////////////////////////////////////////////
static void pathComputeHeadings(RoutePoint *route, uint16_t count)
{
	if (count < 2U) return;
	for (uint16_t i = 0U; i < count; i++)
	{
		uint16_t before = (i == 0U) ? 0U : (uint16_t)(i - 1U);
		uint16_t after = (i + 1U < count) ? (uint16_t)(i + 1U) : (uint16_t)(count - 1U);
		float dx = (float)route[after].x_mm - (float)route[before].x_mm;
		float dy = (float)route[after].y_mm - (float)route[before].y_mm;
		float heading = atan2f(dx, dy) * RAD2DEG;
		route[i].heading_cdeg = pathFloatToInt16(pathWrapDeg(heading) * 100.0f);
	}
}

/////////////////////////////////////////////////////////////////////
// モジュール名 pathSampleSourceXY
// 処理概要     丸め前の基準経路を既存地図と同じ弧長で補間する
// 引数         arcMm: 補間する弧長[mm]
// 戻り値       丸め前の座標[mm]
/////////////////////////////////////////////////////////////////////
static PathSourcePoint pathSampleSourceXY(float arcMm)
{
	uint16_t low = 0U, high = (uint16_t)(routeCount - 1U);
	while ((uint32_t)(high - low) > 1U)
	{
		uint16_t middle = (uint16_t)(low + (high - low) / 2U);
		if ((float)driveRouteArcMm[middle] <= arcMm) low = middle;
		else high = middle;
	}
	float length = (float)driveRouteArcMm[high] - driveRouteArcMm[low];
	float u = length > 0.0f ? (arcMm - (float)driveRouteArcMm[low]) / length : 0.0f;
	u = fminf(1.0f, fmaxf(0.0f, u));
	return (PathSourcePoint){
		sourceRouteXY[low].x_mm + (sourceRouteXY[high].x_mm - sourceRouteXY[low].x_mm) * u,
		sourceRouteXY[low].y_mm + (sourceRouteXY[high].y_mm - sourceRouteXY[low].y_mm) * u};
}

/////////////////////////////////////////////////////////////////////
// モジュール名 pathPrepareSourceRadii
// 処理概要     丸め前の接線方位から半径を求め、急旋回を保護して速度計画だけを平滑化する
// 引数         periodMm: 周回共通地図の周期[mm]。0は正規化なし
// 戻り値       true: 半径確定 false: 入力が非有限または周期不正
/////////////////////////////////////////////////////////////////////
static bool pathPrepareSourceRadii(float periodMm)
{
	routeCache.sourceRadiiValid = false;
	if (routeCount < 2U || !isfinite(periodMm) || periodMm < 0.0f) return false;
	PathSourcePoint closure = {0.0f, 0.0f};
	if (periodMm > 0.0f)
	{
		if (periodMm < PATH_FUSION_LOOP_MIN_MM || periodMm > PATH_FUSION_LOOP_MAX_MM ||
			periodMm >= (float)driveRouteArcMm[routeCount - 1U]) return false;
		closure = pathSampleSourceXY(periodMm);
		closure.x_mm -= sourceRouteXY[0].x_mm;
		closure.y_mm -= sourceRouteXY[0].y_mm;
	}
	for (uint16_t i = 0U; i < routeCount; i++)
	{
		PathSourcePoint point[5];
		for (int offset = -2; offset <= 2; offset++)
		{
			int index = (int)i + offset;
			if (index < 0) index = 0;
			if (index >= routeCount) index = (int)routeCount - 1;
			PathSourcePoint value = sourceRouteXY[index];
			if (periodMm > 0.0f)
			{
				float phase = fmodf((float)driveRouteArcMm[index], periodMm);
				value = pathSampleSourceXY(phase);
				value.x_mm -= closure.x_mm * (phase / periodMm);
				value.y_mm -= closure.y_mm * (phase / periodMm);
			}
			if (!isfinite(value.x_mm) || !isfinite(value.y_mm)) return false;
			point[offset + 2] = value;
		}
		uint16_t radius = INT16_MAX;
		float signedChangeRad = 0.0f;
		if (i > 0U && i + 1U < routeCount)
		{
			float h0 = atan2f(point[2].x_mm - point[0].x_mm,
				point[2].y_mm - point[0].y_mm) * RAD2DEG;
			float h1 = atan2f(point[4].x_mm - point[2].x_mm,
				point[4].y_mm - point[2].y_mm) * RAD2DEG;
			signedChangeRad = pathWrapDeg(h1 - h0) * DEG2RAD;
			float changeRad = fabsf(signedChangeRad);
			float dsMm = pathPointDistance(point[1].x_mm, point[1].y_mm,
				point[3].x_mm, point[3].y_mm);
			if (changeRad > 1.0e-4f && dsMm > 1.0f)
				radius = (uint16_t)lroundf(fminf((float)INT16_MAX, fmaxf(1.0f, dsMm / changeRad)));
		}
		// 平滑化が終わるまでは既存の半径欄を符号付き半径の作業領域にする。
		lineRoute[i].sourceRadius_mm = (uint16_t)(int16_t)(signedChangeRad < 0.0f ? -(int16_t)radius : (int16_t)radius);
	}
	const uint16_t halfWindow = PATH_ROC_FILTER_POINTS / 2U;
	int16_t window[PATH_ROC_FILTER_POINTS];
	for (uint16_t i = 0U; i < PATH_ROC_FILTER_POINTS; i++) window[i] = INT16_MAX;
	for (uint16_t i = 0U; i <= halfWindow && i < routeCount; i++) window[i + halfWindow] = (int16_t)lineRoute[i].sourceRadius_mm;
	for (uint16_t i = 0U; i < routeCount; i++)
	{
		uint16_t radius = (uint16_t)abs(window[halfWindow]);
		// 局所曲率自体にも前後2点が必要。端点の片側推定を広い窓へ混ぜない。
		if (i >= halfWindow + 2U && i + halfWindow + 2U < routeCount)
		{
			float curvature[PATH_ROC_FILTER_POINTS];
			bool gentle = true;
			for (uint16_t j = 0U; j < PATH_ROC_FILTER_POINTS; j++)
			{
				if ((float)abs(window[j]) < PLAN_ROC_FILTER_MIN_RADIUS_MM) gentle = false;
				curvature[j] = abs(window[j]) == INT16_MAX ? 0.0f : 1.0f / (float)window[j];
			}
			if (gentle)
			{
				float filtered = fabsf(filterPlanningCurvature(curvature, PATH_ROC_FILTER_POINTS));
				if (!isfinite(filtered)) return false;
				radius = filtered > 1.0f / (float)INT16_MAX ? (uint16_t)lroundf(1.0f / filtered) : INT16_MAX;
			}
		}
		lineRoute[i].sourceRadius_mm = radius;
		for (uint16_t j = 0U; j + 1U < PATH_ROC_FILTER_POINTS; j++) window[j] = window[j + 1U];
		window[PATH_ROC_FILTER_POINTS - 1U] = i + halfWindow + 1U < routeCount ?
			(int16_t)lineRoute[i + halfWindow + 1U].sourceRadius_mm : INT16_MAX;
	}
	routeCache.sourceRadiiValid = true;
	return true;
}

/////////////////////////////////////////////////////////////////////
// モジュール名 pathFollowerGetFilteredRocMm
// 処理概要     同じ経路インデックスのフィルタ済み一次半径をログ用に取得する
// 引数         index: 保存するoptimalIndex
// 戻り値       一次計画半径[mm]。計画なし・延長部・範囲外は0
/////////////////////////////////////////////////////////////////////
uint16_t pathFollowerGetFilteredRocMm(uint16_t index)
{
	if (runMemoryOwner != RUN_MEMORY_PATH || !routeCache.sourceRadiiValid ||
		index >= routeCache.baseCount || index >= routeCount) return 0U;
	return lineRoute[index].sourceRadius_mm;
}

/////////////////////////////////////////////////////////////////////
// モジュール名 pathCanUseSourceRadius
// 処理概要     指定した速度方針で一次経路の丸め前半径を利用できるか判定する
// 引数         index: 対象経路点, primaryCurvature: 短縮区間でも一次曲率を使用
// 戻り値       true: 丸め前半径を利用 false: 短縮・延長形状から再計算する
/////////////////////////////////////////////////////////////////////
static bool pathCanUseSourceRadius(uint16_t index, bool primaryCurvature)
{
	// 延長との接続では前後2点の形状が変わるため、従来の接線計算を使う。
	if (!routeCache.sourceRadiiValid || index + 2U >= routeCache.baseCount ||
		lineRoute[index].sourceRadius_mm == 0U) return false;
	if (primaryCurvature) return true;
	uint16_t begin = index > 2U ? (uint16_t)(index - 2U) : 0U;
	for (uint16_t i = begin; i <= index + 2U; i++)
		if ((routeFlags[i] & PATH_FLAG_CORRIDOR_APPLIED) != 0U) return false;
	return true;
}

/////////////////////////////////////////////////////////////////////
// モジュール名 pathSpeedRadiusMm
// 処理概要     速度計画と先行減速に使う曲率半径を同じ形状から取得する
// 引数         route: 経路点列, count: 経路点数, index: 対象点
//              primaryCurvature: 短縮区間でも一次曲率を使用
// 戻り値       曲率半径[mm]。-1は端点・クロス直線・曲率未検出
/////////////////////////////////////////////////////////////////////
static int16_t pathSpeedRadiusMm(const RoutePoint *route, uint16_t count, uint16_t index, bool primaryCurvature)
{
	if (index == 0U || index + 1U >= count ||
		(routeFlags[index] & PATH_FLAG_CROSS_STRAIGHT) != 0U) return -1;
	if (pathCanUseSourceRadius(index, primaryCurvature)) return (int16_t)lineRoute[index].sourceRadius_mm;
	float h0 = (float)route[index - 1U].heading_cdeg * 0.01f;
	float h1 = (float)route[index + 1U].heading_cdeg * 0.01f;
	float dHeadingRad = fabsf(pathWrapDeg(h1 - h0)) * DEG2RAD;
	float dsMm = pathPointDistance((float)route[index - 1U].x_mm, (float)route[index - 1U].y_mm,
		(float)route[index + 1U].x_mm, (float)route[index + 1U].y_mm);
	if (dHeadingRad > 1.0e-4f && dsMm > 1.0f) return pathFloatToInt16(dsMm / dHeadingRad);
	return -1;
}

/////////////////////////////////////////////////////////////////////
// モジュール名 pathApplyDecelLead
// 処理概要     半径減少率に応じて低い速度を手前へ広げ、減速開始を先行させる
// 引数         route: 経路点列, count: 経路点数, primaryCurvature: 短縮区間でも一次曲率を使用
// 戻り値       なし
/////////////////////////////////////////////////////////////////////
static void pathApplyDecelLead(RoutePoint *route, uint16_t count, bool primaryCurvature)
{
	float baseLeadMm = tgtParam.decelLeadMm;
	if (count <= 1U || !isfinite(baseLeadMm) || baseLeadMm <= 0.0f) return;
	int16_t previousRadius = INT16_MAX;
	for (uint16_t i = 1U; i < count; i++)
	{
		int16_t radius = pathSpeedRadiusMm(route, count, i, primaryCurvature);
		if (radius < 0) radius = INT16_MAX;
		if (route[i].speed_cms < route[i - 1U].speed_cms && radius < previousRadius)
		{
			// DISTANCEと同じ半径減少率。実経路距離を使い、必要距離を満たす点まで切り上げる。
			float changeRatio = (float)(previousRadius - radius) / (float)previousRadius;
			float leadMm = baseLeadMm * changeRatio;
			float shiftedMm = 0.0f;
			uint16_t j = i;
			while (j > 0U && shiftedMm < leadMm)
			{
				shiftedMm += pathPointDistance((float)route[j].x_mm, (float)route[j].y_mm,
					(float)route[j - 1U].x_mm, (float)route[j - 1U].y_mm);
				j--;
				if (route[j].speed_cms > route[i].speed_cms) route[j].speed_cms = route[i].speed_cms;
			}
		}
		previousRadius = radius;
	}
}

/////////////////////////////////////////////////////////////////////
// モジュール名 pathBuildSpeedProfile
// 処理概要     曲率と加減速制約から経路速度を設定する
// 引数         route: 経路点列, count: 経路点数, shortcutLevel: 短縮レベル
//              curvatureSpeed: trueでDISTANCE共通の曲率別速度を使用（短縮時も一次曲率を使用）
// 戻り値       なし
/////////////////////////////////////////////////////////////////////
static void pathBuildSpeedProfile(RoutePoint *route, uint16_t count, uint8_t shortcutLevel, bool curvatureSpeed)
{
	if (count == 0U) return;
	bool primaryCurvature = curvatureSpeed && shortcutLevel > 0U;
	float speedCap = (shortcutLevel == 0U) ? tgtParam.pathReplay : tgtParam.shortCut;
	if (speedCap <= 0.0f) speedCap = tgtParam.pathReplay;
	if (curvatureSpeed) speedCap = PATH_CURVE_MAX_SPEED_MPS;
	for (uint16_t i = 0U; i < count; i++)
	{
		float speed = curvatureSpeed ? fminf(speedCap, asignVelocity(INT16_MAX)) : speedCap;
		int16_t radius = pathSpeedRadiusMm(route, count, i, primaryCurvature);
		if (radius >= 0)
		{
			float curveSpeed = asignVelocity(radius);
			if (curvatureSpeed && !pathCanUseSourceRadius(i, primaryCurvature)) speed = fminf(speedCap, curveSpeed);
			else speed = fminf(speed, curveSpeed);
		}
		route[i].speed_cms = (uint16_t)lroundf(fmaxf(0.0f, speed) * 100.0f);
	}
	pathApplyDecelLead(route, count, primaryCurvature);
	if (curvatureSpeed)
	{
		// スタートマーカーまではsearch速度のため、先頭から加速制約を適用する。
		uint16_t startSpeed = (uint16_t)lroundf(fminf(PATH_CURVE_MAX_SPEED_MPS,
			fmaxf(0.0f, tgtParam.search)) * 100.0f);
		if (route[0].speed_cms > startSpeed) route[0].speed_cms = startSpeed;
	}

	for (uint16_t i = 1U; i < count; i++)
	{
		float previous = (float)route[i - 1U].speed_cms * 0.01f;
		float dsM = pathPointDistance((float)route[i - 1U].x_mm, (float)route[i - 1U].y_mm,
			(float)route[i].x_mm, (float)route[i].y_mm) * 0.001f;
		float limit = sqrtf(fmaxf(0.0f, (previous * previous) + (2.0f * tgtParam.acceleF * dsM)));
		if ((float)route[i].speed_cms * 0.01f > limit)
			route[i].speed_cms = (uint16_t)(curvatureSpeed ? floorf(limit * 100.0f) : lroundf(limit * 100.0f));
	}
	for (int32_t i = (int32_t)count - 2; i >= 0; i--)
	{
		float next = (float)route[i + 1].speed_cms * 0.01f;
		float dsM = pathPointDistance((float)route[i].x_mm, (float)route[i].y_mm,
			(float)route[i + 1].x_mm, (float)route[i + 1].y_mm) * 0.001f;
		float limit = sqrtf(fmaxf(0.0f, (next * next) + (2.0f * tgtParam.acceleD * dsM)));
		if ((float)route[i].speed_cms * 0.01f > limit)
			route[i].speed_cms = (uint16_t)(curvatureSpeed ? floorf(limit * 100.0f) : lroundf(limit * 100.0f));
	}
}

/////////////////////////////////////////////////////////////////////
// モジュール名 pathPrepareWhiteGoalExtension
// 処理概要     正規化前の観測を使い、ゴール延長点へ同じ周回位相の白線を割り当てる
// 引数         periodMm: 検証済みの一次周回周期[mm]
// 戻り値       true: 延長形状を準備済み false: 経路・延長形状が不適切
/////////////////////////////////////////////////////////////////////
static bool pathPrepareWhiteGoalExtension(float periodMm)
{
    if (routeCount < 3U || routeCount > PATH_ROUTE_MAX_POINTS) return false;
    float endX, endY;
    float sourceEndArcMm = (float)driveRouteArcMm[routeCount - 1U];
    if (!pathFusionLoopPoint(driveRoute, driveRouteArcMm, routeCount, periodMm,
        sourceEndArcMm, &endX, &endY)) return false;
    float goalX, goalY, extensionMm;
    uint16_t appendCount;
    uint16_t availablePoints = (uint16_t)(PATH_ROUTE_MAX_POINTS - routeCount);
    if (!pathPolicyComputeGoalExtension((float)pathFloatToInt16(endX), (float)pathFloatToInt16(endY),
        PATH_ROUTE_SPACING_MM, availablePoints, &goalX, &goalY, &extensionMm, &appendCount)) return false;
    for (uint16_t i = 0U; i < appendCount; i++)
    {
        float progressMm = sourceEndArcMm + fminf(extensionMm, PATH_ROUTE_SPACING_MM * (float)(i + 1U));
        // 欠測時は無効のまま残す。車軸経路の延長座標を白線観測として扱わない。
        (void)pathFusionWhiteLoopPoint(whiteRoute, driveRoute, driveRouteArcMm,
            routeCount, periodMm, progressMm, &whiteRoute[routeCount + i]);
    }
    return true;
}

/////////////////////////////////////////////////////////////////////
// モジュール名 pathExtendDriveRouteTowardOrigin
// 処理概要     一次走行終端と座標原点の中間点まで実走行経路を延長する
// 引数         shortcutLevel: 実走行経路へ適用済みの短縮レベル
//              curvatureSpeed: trueでDISTANCE共通の曲率別速度を使用
// 戻り値       true:延長成功 false:延長不可
/////////////////////////////////////////////////////////////////////
static bool pathExtendDriveRouteTowardOrigin(uint8_t shortcutLevel, bool curvatureSpeed)
{
	if (routeCount < 2U) return false;
	float endX = (float)driveRoute[routeCount - 1U].x_mm;
	float endY = (float)driveRoute[routeCount - 1U].y_mm;
	float goalExtensionMm = 0.0F;
	float goalX = 0.0F;
	float goalY = 0.0F;
	uint16_t appendCount = 0U;
	uint16_t availablePoints = (routeCount <= PATH_ROUTE_MAX_POINTS) ?
		(uint16_t)(PATH_ROUTE_MAX_POINTS - routeCount) : 0U;
	if (!pathPolicyComputeGoalExtension(endX, endY, PATH_ROUTE_SPACING_MM,
		availablePoints, &goalX, &goalY, &goalExtensionMm, &appendCount)) return false;
	float unitX = (goalX - endX) / goalExtensionMm;
	float unitY = (goalY - endY) / goalExtensionMm;
	float advancedMm = 0.0f;
	for (uint16_t i = 0U; i < appendCount; i++)
	{
		float nextAdvancedMm = fminf(goalExtensionMm,
			advancedMm + PATH_ROUTE_SPACING_MM);
		int16_t extensionX = pathFloatToInt16(endX + (unitX * nextAdvancedMm));
		int16_t extensionY = pathFloatToInt16(endY + (unitY * nextAdvancedMm));
		driveRoute[routeCount].x_mm = extensionX;
		driveRoute[routeCount].y_mm = extensionY;
		driveRoute[routeCount].heading_cdeg = 0;
		driveRoute[routeCount].speed_cms = 0U;
		lineRoute[routeCount].x_mm = extensionX;
		lineRoute[routeCount].y_mm = extensionY;
		lineRoute[routeCount].heading_cdeg = 0;
		lineRoute[routeCount].speed_cms = 0U;
		routeFlags[routeCount] = 0U;
		routeCount++;
		advancedMm = nextAdvancedMm;
	}
	pathComputeHeadings(lineRoute, routeCount);
	pathComputeHeadings(driveRoute, routeCount);
	pathBuildSpeedProfile(driveRoute, routeCount, shortcutLevel, curvatureSpeed);
	return true;
}

#if PATH_SHORTCUT_GEOMETRY_ENABLE
typedef struct
{
	uint16_t begin;
	uint16_t end;
	float saving_mm;
	bool valid;
} PathCorridorCandidate;

/////////////////////////////////////////////////////////////////////
// モジュール名 pathCorridorSmoothstep
// 処理概要     直線回廊の入口と出口を滑らかに接続する係数を算出する
// 引数         value: 0～1の進捗
// 戻り値       0～1の補間係数
/////////////////////////////////////////////////////////////////////
static float pathCorridorSmoothstep(float value)
{
	value = fminf(1.0f, fmaxf(0.0f, value));
	return value * value * (3.0f - (2.0f * value));
}

/////////////////////////////////////////////////////////////////////
// モジュール名 pathComputeCorridorHeadings
// 処理概要     直線回廊抽出用の接線方位と、候補を早期除外する旋回反転の累積値を算出する
// 引数         なし
// 戻り値       なし
/////////////////////////////////////////////////////////////////////
static void pathComputeCorridorHeadings(void)
{
	for (uint16_t i = 0U; i < routeCount; i++)
	{
		uint16_t before = (i > 2U) ? (uint16_t)(i - 2U) : 0U;
		uint16_t after = (i + 2U < routeCount) ? (uint16_t)(i + 2U) : (uint16_t)(routeCount - 1U);
		float dx = (float)lineRoute[after].x_mm - (float)lineRoute[before].x_mm;
		float dy = (float)lineRoute[after].y_mm - (float)lineRoute[before].y_mm;
		driveRoute[i].heading_cdeg = pathFloatToInt16(pathWrapDeg(atan2f(dx, dy) * RAD2DEG) * 100.0f);
	}
	// 速度計画を作る前のdrive側だけを一時利用する。line側の一次半径は保持する。
	uint16_t changes = 0U;
	int8_t previousSign = 0;
	for (uint16_t i = 0U; i < routeCount; i++)
	{
		if (i >= 2U && i + 2U < routeCount)
		{
			float beforeHeading = (float)driveRoute[i - 2U].heading_cdeg * 0.01f;
			float afterHeading = (float)driveRoute[i + 2U].heading_cdeg * 0.01f;
			float delta = pathWrapDeg(afterHeading - beforeHeading);
			if (fabsf(delta) >= PATH_CORRIDOR_TURN_THRESHOLD_DEG)
			{
				int8_t sign = (delta > 0.0f) ? 1 : -1;
				if (previousSign != 0 && sign != previousSign) changes++;
				previousSign = sign;
			}
		}
		corridorTurnChanges(i) = changes;
	}
}

/////////////////////////////////////////////////////////////////////
// モジュール名 pathCorridorRangeIsFree
// 処理概要     候補区間が既採用回廊の保護範囲や除外区間と重ならないことを確認する
// 引数         begin,end: 候補区間の先頭と終端index
// 戻り値       true:重なりなし false:重なりあり
/////////////////////////////////////////////////////////////////////
static bool pathCorridorRangeIsFree(uint16_t begin, uint16_t end)
{
	for (uint16_t i = begin; i <= end; i++)
	{
		if ((routeFlags[i] & (PATH_FLAG_CORRIDOR_RESERVED | PATH_FLAG_CORRIDOR_EXCLUDED)) != 0U) return false;
	}
	return true;
}

/////////////////////////////////////////////////////////////////////
// モジュール名 pathEvaluateCorridorCandidate
// 処理概要     一次経路の区間が直線回廊の抽出条件を満たすか評価する
// 引数         begin,end: 候補区間の先頭と終端index, savingMm:短縮量格納先[mm]
// 戻り値       true:候補成立 false:候補不成立
/////////////////////////////////////////////////////////////////////
static bool pathEvaluateCorridorCandidate(uint16_t begin, uint16_t end, float *savingMm)
{
	float dx = (float)lineRoute[end].x_mm - (float)lineRoute[begin].x_mm;
	float dy = (float)lineRoute[end].y_mm - (float)lineRoute[begin].y_mm;
	float chordLengthSquared = (dx * dx) + (dy * dy);
	if (chordLengthSquared <= 0.0f) return false;
	float chordHeadingDeg = atan2f(dx, dy) * RAD2DEG;
	float beginHeadingDeg = (float)driveRoute[begin].heading_cdeg * 0.01f;
	float endHeadingDeg = (float)driveRoute[end].heading_cdeg * 0.01f;
	if (fabsf(pathWrapDeg(beginHeadingDeg - chordHeadingDeg)) > PATH_CORRIDOR_HEADING_LIMIT_DEG ||
		fabsf(pathWrapDeg(endHeadingDeg - chordHeadingDeg)) > PATH_CORRIDOR_HEADING_LIMIT_DEG) return false;

	float sourceLength = 0.0f;
	for (uint16_t i = begin; i <= end; i++)
	{
		float pointX = (float)lineRoute[i].x_mm - (float)lineRoute[begin].x_mm;
		float pointY = (float)lineRoute[i].y_mm - (float)lineRoute[begin].y_mm;
		float progress = ((pointX * dx) + (pointY * dy)) / chordLengthSquared;
		if (progress < PATH_CORRIDOR_MIN_PROJECTION || progress > PATH_CORRIDOR_MAX_PROJECTION) return false;
		float projectedX = (float)lineRoute[begin].x_mm + (progress * dx);
		float projectedY = (float)lineRoute[begin].y_mm + (progress * dy);
		float offset = pathPointDistance(lineRoute[i].x_mm, lineRoute[i].y_mm, projectedX, projectedY);
		if (offset > PATH_CORRIDOR_CANDIDATE_MAX_OFFSET_MM) return false;
		if (i > begin)
		{
			sourceLength += pathPointDistance(lineRoute[i - 1U].x_mm, lineRoute[i - 1U].y_mm,
				lineRoute[i].x_mm, lineRoute[i].y_mm);
		}
	}

	uint8_t signChanges = 0U;
	int8_t previousSign = 0;
	for (uint16_t i = (uint16_t)(begin + 2U); i < (uint16_t)(end - 1U); i++)
	{
		float beforeHeading = (float)driveRoute[i - 2U].heading_cdeg * 0.01f;
		float afterHeading = (float)driveRoute[i + 2U].heading_cdeg * 0.01f;
		float delta = pathWrapDeg(afterHeading - beforeHeading);
		if (fabsf(delta) < PATH_CORRIDOR_TURN_THRESHOLD_DEG) continue;
		int8_t sign = (delta > 0.0f) ? 1 : -1;
		if (previousSign != 0 && sign != previousSign) signChanges++;
		previousSign = sign;
	}
	if (signChanges < PATH_CORRIDOR_MIN_SIGN_CHANGES) return false;

	*savingMm = sourceLength - sqrtf(chordLengthSquared);
	return *savingMm >= PATH_CORRIDOR_MIN_SAVING_MM;
}

/////////////////////////////////////////////////////////////////////
// モジュール名 pathFindBestCorridorCandidate
// 処理概要     未使用区間から短縮量が最大の直線回廊候補を取得する
// 引数         candidate:候補格納先
// 戻り値       true:候補あり false:候補なし
/////////////////////////////////////////////////////////////////////
static bool pathFindBestCorridorCandidate(PathCorridorCandidate *candidate)
{
	candidate->valid = false;
	for (uint16_t begin = PATH_CORRIDOR_END_GUARD_POINTS;
		begin + PATH_CORRIDOR_MIN_SPAN_POINTS + PATH_CORRIDOR_END_GUARD_POINTS < routeCount; begin++)
	{
		analysisDisplayPoll(); // 候補探索中も開始点ごとに表示更新の時刻を確認する。
		for (uint16_t span = PATH_CORRIDOR_MIN_SPAN_POINTS; span <= PATH_CORRIDOR_MAX_SPAN_POINTS; span++)
		{
			uint16_t end = (uint16_t)(begin + span);
			if (end + PATH_CORRIDOR_END_GUARD_POINTS >= routeCount) break;
			// spanは増加順なので、保護・除外点に達した後の長い候補もすべて不成立。
			if (!pathCorridorRangeIsFree(begin, end)) break;
			// 区間先頭より前からの反転を最大1回含み得る上界。下回る候補だけを除く。
			uint16_t possibleChanges = (uint16_t)(corridorTurnChanges(end - 2U) -
				corridorTurnChanges(begin + 2U));
			if (possibleChanges < PATH_CORRIDOR_MIN_SIGN_CHANGES) continue;
			float savingMm = 0.0f;
			if (!pathEvaluateCorridorCandidate(begin, end, &savingMm)) continue;
			uint16_t bestSpan = candidate->valid ? (uint16_t)(candidate->end - candidate->begin) : 0U;
			if (!candidate->valid || savingMm > candidate->saving_mm ||
				(savingMm == candidate->saving_mm && span > bestSpan))
			{
				candidate->begin = begin;
				candidate->end = end;
				candidate->saving_mm = savingMm;
				candidate->valid = true;
			}
		}
	}
	return candidate->valid;
}

/////////////////////////////////////////////////////////////////////
// モジュール名 pathCorridorCandidateMove
// 処理概要     候補点を直線回廊へ接続する補間変位を求める
// 引数         candidate: 候補区間, index: 経路点, moveX/moveY: 変位の格納先[mm]
// 戻り値       なし
/////////////////////////////////////////////////////////////////////
static void pathCorridorCandidateMove(const PathCorridorCandidate *candidate, uint16_t index,
	float *moveX, float *moveY)
{
	uint16_t span = (uint16_t)(candidate->end - candidate->begin);
	float progress = (float)(index - candidate->begin) / (float)span;
	float chordX = (float)lineRoute[candidate->begin].x_mm +
		((float)(lineRoute[candidate->end].x_mm - lineRoute[candidate->begin].x_mm) * progress);
	float chordY = (float)lineRoute[candidate->begin].y_mm +
		((float)(lineRoute[candidate->end].y_mm - lineRoute[candidate->begin].y_mm) * progress);
	float entryWeight = pathCorridorSmoothstep((float)(index - candidate->begin) /
		(float)PATH_CORRIDOR_TRANSITION_POINTS);
	float exitWeight = pathCorridorSmoothstep((float)(candidate->end - index) /
		(float)PATH_CORRIDOR_TRANSITION_POINTS);
	float weight = fminf(entryWeight, exitWeight);
	*moveX = (chordX - (float)lineRoute[index].x_mm) * weight;
	*moveY = (chordY - (float)lineRoute[index].y_mm) * weight;
}

/////////////////////////////////////////////////////////////////////
// モジュール名 pathCorridorCandidateFits
// 処理概要     候補全体の補間変位が採用上限内か確認する
// 引数         candidate: 候補区間, maximumOffsetMm: 採用する変位上限[mm]
// 戻り値       true: 全点が上限内 false: 区間全体を除外
/////////////////////////////////////////////////////////////////////
static bool pathCorridorCandidateFits(const PathCorridorCandidate *candidate, float maximumOffsetMm)
{
	for (uint16_t i = candidate->begin; i <= candidate->end; i++)
	{
		float moveX, moveY;
		pathCorridorCandidateMove(candidate, i, &moveX, &moveY);
		float move = hypotf(moveX, moveY);
		if (!isfinite(move) || move > maximumOffsetMm) return false;
	}
	return true;
}

/////////////////////////////////////////////////////////////////////
// モジュール名 pathApplyCorridorCandidate
// 処理概要     候補区間を直線へ寄せて入口と出口を60mmで滑らかに接続する
// 引数         candidate:適用する直線回廊候補
//              maximumOffsetMm: 合法余裕を含む変位上限[mm]
// 戻り値       なし
/////////////////////////////////////////////////////////////////////
static void pathApplyCorridorCandidate(const PathCorridorCandidate *candidate, float maximumOffsetMm)
{
	for (uint16_t i = candidate->begin; i <= candidate->end; i++)
	{
		float moveX, moveY;
		pathCorridorCandidateMove(candidate, i, &moveX, &moveY);
		float move = sqrtf((moveX * moveX) + (moveY * moveY));
		if (move > maximumOffsetMm)
		{
			moveX *= maximumOffsetMm / move;
			moveY *= maximumOffsetMm / move;
		}
		driveRoute[i].x_mm = pathFloatToInt16((float)lineRoute[i].x_mm + moveX);
		driveRoute[i].y_mm = pathFloatToInt16((float)lineRoute[i].y_mm + moveY);
		routeFlags[i] |= PATH_FLAG_CORRIDOR_APPLIED;
	}

	uint16_t reserveBegin = (candidate->begin > PATH_CORRIDOR_OVERLAP_GUARD_POINTS) ?
		(uint16_t)(candidate->begin - PATH_CORRIDOR_OVERLAP_GUARD_POINTS) : 0U;
	uint16_t reserveEnd = (candidate->end + PATH_CORRIDOR_OVERLAP_GUARD_POINTS < routeCount) ?
		(uint16_t)(candidate->end + PATH_CORRIDOR_OVERLAP_GUARD_POINTS) : (uint16_t)(routeCount - 1U);
	for (uint16_t i = reserveBegin; i <= reserveEnd; i++) routeFlags[i] |= PATH_FLAG_CORRIDOR_RESERVED;
}

/////////////////////////////////////////////////////////////////////
// モジュール名 pathSegmentsIntersect
// 処理概要     離れた2経路区間の交差を判定する
// 引数         route: 経路点列, i,j: 区間先頭インデックス
// 戻り値       true: 交差あり false: 交差なし
/////////////////////////////////////////////////////////////////////
static bool pathSegmentsIntersect(const RoutePoint *route, uint16_t i, uint16_t j)
{
	float ax = route[i].x_mm;
	float ay = route[i].y_mm;
	float bx = route[i + 1U].x_mm;
	float by = route[i + 1U].y_mm;
	float cx = route[j].x_mm;
	float cy = route[j].y_mm;
	float dx = route[j + 1U].x_mm;
	float dy = route[j + 1U].y_mm;
	float abC = ((bx - ax) * (cy - ay)) - ((by - ay) * (cx - ax));
	float abD = ((bx - ax) * (dy - ay)) - ((by - ay) * (dx - ax));
	float cdA = ((dx - cx) * (ay - cy)) - ((dy - cy) * (ax - cx));
	float cdB = ((dx - cx) * (by - cy)) - ((dy - cy) * (bx - cx));
	return ((abC > 0.0f && abD < 0.0f) || (abC < 0.0f && abD > 0.0f)) &&
		((cdA > 0.0f && cdB < 0.0f) || (cdA < 0.0f && cdB > 0.0f));
}

/////////////////////////////////////////////////////////////////////
// モジュール名 pathLength
// 処理概要     経路点列の全長を算出する
// 引数         route: 経路点列
// 戻り値       経路長[mm]
/////////////////////////////////////////////////////////////////////
static float pathLength(const RoutePoint *route)
{
	float length = 0.0f;
	for (uint16_t i = 1U; i < routeCount; i++)
	{
		length += pathPointDistance(route[i - 1U].x_mm, route[i - 1U].y_mm, route[i].x_mm, route[i].y_mm);
	}
	return length;
}
#endif

/////////////////////////////////////////////////////////////////////
// モジュール名 routeGenerateShortcut
// 処理概要     一次経路のスラローム区間を直線回廊へ置換する
// 引数         shortcutLevel:短縮レベル(1)
// 戻り値       true:短縮経路生成成功 false:再走行経路を使用
/////////////////////////////////////////////////////////////////////
bool routeGenerateShortcut(uint8_t shortcutLevel)
{
	memcpy(driveRoute, lineRoute, sizeof(RoutePoint) * routeCount);
	routeShortcutLevel = 0U;
	routeShortcutBuildStatus = PATH_SHORTCUT_BUILD_NOT_REQUESTED;
	routeShortcutCorridorCount = 0U;
	routeShortcutReductionMm = 0.0f;
	if (shortcutLevel == 0U) return false;
	if (routeCount < (PATH_CORRIDOR_MIN_SPAN_POINTS + (2U * PATH_CORRIDOR_END_GUARD_POINTS) + 1U))
	{
		routeShortcutBuildStatus = PATH_SHORTCUT_BUILD_NO_CORRIDOR;
		return false;
	}
#if !PATH_SHORTCUT_GEOMETRY_ENABLE
	(void)shortcutLevel;
	routeShortcutBuildStatus = PATH_SHORTCUT_BUILD_LEGAL_GEOMETRY_INVALID;
	return false;
#else
	if (shortcutLevel > PATH_LEVEL_MAX) shortcutLevel = PATH_LEVEL_MAX;
	float legalOffsetMm = PATH_LINE_HALF_WIDTH_MM + PATH_OCCUPIED_HALF_WIDTH_MM -
		PATH_TRACKING_ERROR_BUDGET_MM - PATH_LEGAL_RESERVE_MM;
	float maximumOffsetMm = fminf(PATH_CORRIDOR_MAX_OFFSET_MM, legalOffsetMm);
	if (!isfinite(maximumOffsetMm) || maximumOffsetMm <= 0.0f ||
		PATH_OUTER_RADIUS_MM + legalOffsetMm > PATH_BOARD_CLEARANCE_MM)
	{
		routeShortcutBuildStatus = PATH_SHORTCUT_BUILD_LEGAL_GEOMETRY_INVALID;
		return false;
	}

	// 一次ログ由来のクロス直線区間は短縮形状の再生成でも保持する。
	for (uint16_t i = 0U; i < PATH_ROUTE_MAX_POINTS; i++) routeFlags[i] &= PATH_FLAG_CROSS_STRAIGHT;
	pathComputeCorridorHeadings();
	while (routeShortcutCorridorCount < PATH_CORRIDOR_MAX_COUNT)
	{
		PathCorridorCandidate candidate;
		if (!pathFindBestCorridorCandidate(&candidate)) break;
		if (!pathCorridorCandidateFits(&candidate, maximumOffsetMm))
		{
			// 大きな膨らみを小区間へ切り直して再採用しない。補正抑止の保護域とは区別する。
			uint16_t begin = candidate.begin > PATH_CORRIDOR_OVERLAP_GUARD_POINTS ?
				(uint16_t)(candidate.begin - PATH_CORRIDOR_OVERLAP_GUARD_POINTS) : 0U;
			uint16_t end = candidate.end + PATH_CORRIDOR_OVERLAP_GUARD_POINTS < routeCount ?
				(uint16_t)(candidate.end + PATH_CORRIDOR_OVERLAP_GUARD_POINTS) : (uint16_t)(routeCount - 1U);
			for (uint16_t i = begin; i <= end; i++) routeFlags[i] |= PATH_FLAG_CORRIDOR_EXCLUDED;
			continue;
		}
		pathApplyCorridorCandidate(&candidate, maximumOffsetMm);
		routeShortcutCorridorCount++;
	}
	if (routeShortcutCorridorCount == 0U)
	{
		memcpy(driveRoute, lineRoute, sizeof(RoutePoint) * routeCount);
		routeShortcutBuildStatus = PATH_SHORTCUT_BUILD_NO_CORRIDOR;
		return false;
	}

	for (uint16_t i = 0U; i < routeCount; i++)
	{
		float offset = pathPointDistance(lineRoute[i].x_mm, lineRoute[i].y_mm,
			driveRoute[i].x_mm, driveRoute[i].y_mm);
		float roundedLimitMm = fminf(PATH_CORRIDOR_MAX_OFFSET_MM,
			maximumOffsetMm + PATH_CORRIDOR_OFFSET_TOLERANCE_MM);
		if (offset > roundedLimitMm)
		{
			memcpy(driveRoute, lineRoute, sizeof(RoutePoint) * routeCount);
			routeShortcutBuildStatus = PATH_SHORTCUT_BUILD_OFFSET_VIOLATION;
			return false;
		}
	}
	for (uint16_t i = 0U; i + 1U < routeCount; i++)
	{
		if ((i & 15U) == 0U) analysisDisplayPoll();
		for (uint16_t j = (uint16_t)(i + 3U); j + 1U < routeCount; j++)
		{
			if ((j & 127U) == 0U) analysisDisplayPoll(); // 長い内側ループでも円環を止めない。
			// 両線分の端点が一次経路のままなら、新しく交差することはない。
			if (((routeFlags[i] | routeFlags[i + 1U] | routeFlags[j] | routeFlags[j + 1U]) &
				PATH_FLAG_CORRIDOR_APPLIED) == 0U) continue;
			if (pathSegmentsIntersect(driveRoute, i, j) && !pathSegmentsIntersect(lineRoute, i, j))
			{
				memcpy(driveRoute, lineRoute, sizeof(RoutePoint) * routeCount);
				routeShortcutBuildStatus = PATH_SHORTCUT_BUILD_NEW_INTERSECTION;
				return false;
			}
		}
	}
	float sourceLength = pathLength(lineRoute);
	float shortcutLength = pathLength(driveRoute);
	routeShortcutReductionMm = sourceLength - shortcutLength;
	if (sourceLength <= 0.0f || routeShortcutReductionMm < PATH_CORRIDOR_MIN_SAVING_MM)
	{
		memcpy(driveRoute, lineRoute, sizeof(RoutePoint) * routeCount);
		routeShortcutBuildStatus = PATH_SHORTCUT_BUILD_INSUFFICIENT_REDUCTION;
		return false;
	}
	pathComputeHeadings(driveRoute, routeCount);
	pathBuildSpeedProfile(driveRoute, routeCount, shortcutLevel, false);
	routeShortcutLevel = shortcutLevel;
	routeShortcutBuildStatus = PATH_SHORTCUT_BUILD_SUCCESS;
	return true;
#endif
}

/////////////////////////////////////////////////////////////////////
// モジュール名 pathMarkCrossStraight
// 処理概要     クロス検出区間の前後を含む経路点へ曲率直線化フラグを設定する
// 引数         startMm/endMm: 一次経路上のクロス検出開始・終了距離[mm]
// 戻り値       なし
/////////////////////////////////////////////////////////////////////
static void pathMarkCrossStraight(float startMm, float endMm)
{
	float first = ceilf(fmaxf(0.0f, startMm - CROSS_STRAIGHT_MM) / PATH_ROUTE_SPACING_MM);
	float last = floorf((endMm + CROSS_STRAIGHT_MM) / PATH_ROUTE_SPACING_MM);
	if (first >= PATH_ROUTE_MAX_POINTS) return;
	uint16_t begin = (uint16_t)first;
	uint16_t end = (uint16_t)fminf(last, (float)(PATH_ROUTE_MAX_POINTS - 1U));
	for (uint16_t i = begin; i <= end; i++) routeFlags[i] |= PATH_FLAG_CROSS_STRAIGHT;
}

/////////////////////////////////////////////////////////////////////
// モジュール名 routeBuildFromLogImpl
// 処理概要     一次走行ログから20mm間隔の再走行経路を生成する
// 引数         logNumber:ログ番号, shortcutLevel:短縮レベル
//              curvatureMode: BOOST_NONEは定速上限、PATH_CURVE/SHORTCUT_CURVEは曲率別速度
// 戻り値       経路点数、負値はエラー
/////////////////////////////////////////////////////////////////////
static int16_t routeBuildFromLogImpl(int logNumber, uint8_t shortcutLevel, uint8_t curvatureMode)
{
    bool curvatureSpeed = curvatureMode != BOOST_NONE;
    FIL file;
    RouteSourceInfo columns;
    ShortcutSettings generationSettings = shortcutSettings;
    uint8_t requestedShortcutLevel = shortcutLevel;

    bool fileOpened = false;
    int16_t resultCode = -5;
    LogBinaryHeader source = {0};
    if ((patternTrace > 10U && patternTrace < 100U) || modeLOG) return -9;
    if (!sd_fatfs_lock(500U)) return -9;
    // キャッシュ判定前にも公開計画を止め、割込みから生成途中の配列を参照させない。
    optimalTrace = BOOST_NONE;
    numPPADarry = numPPAMarry = 0;
    pathGoalValid = false;
    followerState = PATH_STATE_INACTIVE;
    targetSpeedMps = 0.0f;

    if (logSourceOpen(&file, logNumber, LOG_SOURCE_PATH) != FR_OK) goto failed;
    fileOpened = true;
    if (!logSourceInfo(&file, &source)) { resultCode = -10; goto failed; }
    bool cached = pathCacheMatches(&source, &generationSettings);
    if (!pathReadSourceMetadata(&file, &columns)) { resultCode = -10; goto failed; }
    if (cached) {
        routeCount = routeCache.baseCount;
        memset(lineRoute + routeCount, 0, sizeof(RoutePoint) * (PATH_ROUTE_MAX_POINTS - routeCount));
        memset(driveRoute, 0, sizeof(driveRoute));
        for (uint16_t i = 0U; i < PATH_ROUTE_MAX_POINTS; i++) routeFlags[i] &= PATH_FLAG_CROSS_STRAIGHT;
        LOG_PERF_ADD(cacheHits, 1U);
    } else {
        if (!runMemoryPrepare(RUN_MEMORY_PATH)) { resultCode = -9; goto failed; }
        memset(lineRoute, 0, sizeof(lineRoute));
        memset(driveRoute, 0, sizeof(driveRoute));
        memset(routeFlags, 0, sizeof(routeFlags));
        routeCount = 1U;
        memset(whiteRoute, 0, sizeof(whiteRoute));
        routeMarkerCount = 0U;
        routeLoopPeriodMm = 0.0f;
        float previousX = 0.0f, previousY = 0.0f, totalLength = 0.0f;
        float fusedX = 0.0f, fusedY = 0.0f, accumulated = 0.0f;
        float lastX = 0.0f, lastY = 0.0f, previousPulse = 0.0f;
        uint32_t parsedRows = 0U;
        float previousCrossArc = 0.0f, previousCrossHeading = 0.0f;
        float loopIntervals[8];
        uint8_t loopIntervalCount = 0U;
        int32_t previousSourceMarker = 0;
        bool haveCross = false;
        bool inCross = false;
        float crossStartMm = 0.0f, crossEndMm = -CROSS_STRAIGHT_MM - 1.0f;
        LogSourceRow row;
        while (logSourceNext(&file, &row)) {
            float x = row.x, y = row.y, pulse = (float)row.encTotalOptimal;
            if (!isfinite(x) || !isfinite(y) || !isfinite(pulse) ||
                pulse < previousPulse) { resultCode = -11; goto failed; }
            totalLength += pathPointDistance(previousX, previousY, x, y);
            previousX = lastX = x; previousY = lastY = y; previousPulse = pulse;
            parsedRows++;
            if (!pathAppendRouteSample(x, y, &fusedX, &fusedY, &accumulated)) { resultCode = -7; goto failed; }
            if (!inCross && row.courseMarker == CROSSLINE)
            {
                crossStartMm = totalLength;
                inCross = true;
            }
            else if (inCross && row.courseMarker != CROSSLINE)
            {
                // 一次解析と同じく、最初の非クロス行を検出区間の終端とする。
                crossEndMm = totalLength;
                pathMarkCrossStraight(crossStartMm, crossEndMm);
                inCross = false;
            }
            if (isfinite(row.imuAngleZ))
            {
                PathFusionLine measured;
                if (pathFusionSenseLine(row.lineSensors, pathSensorLateralMm, pathSensorForwardMm, &measured))
                {
                    uint16_t point = (uint16_t)(routeCount - 1U);
                    float distance = pathPointDistance(x, y, lineRoute[point].x_mm, lineRoute[point].y_mm);
                    uint16_t quality = (uint16_t)lroundf(fminf(distance, 1000.0f) * 10.0f) + 1U;
                    if (distance <= PATH_FUSION_WHITE_SAMPLE_MAX_MM &&
                        (whiteRoute[point].valid == 0U || quality < whiteRoute[point].valid))
                    {
                        float heading = row.imuAngleZ * DEG2RAD;
                        whiteRoute[point] = (PathWhitePoint){
                            pathFloatToInt16(x + measured.lateralMm * cosf(heading) + measured.forwardMm * sinf(heading)),
                            pathFloatToInt16(y - measured.lateralMm * sinf(heading) + measured.forwardMm * cosf(heading)), quality};
                    }
                }
            }
            if (row.courseMarker > 0 && row.courseMarker <= 3 &&
                row.courseMarker != previousSourceMarker)
            {
                if (routeMarkerCount >= PATH_MARKER_CAPACITY || totalLength > UINT16_MAX)
                    { resultCode = -7; goto failed; }
                routeMarkers[routeMarkerCount++] = (PathMarkerAnchor){
                    .routeIndex = (uint16_t)(routeCount - 1U),
                    .arcMm = (uint16_t)lroundf(totalLength),
                    .x_mm = pathFloatToInt16(x), .y_mm = pathFloatToInt16(y),
                    .type = (uint8_t)row.courseMarker, .reserved = 0U};
                if (row.courseMarker == CROSSLINE && isfinite(row.imuAngleZ))
                {
                    float turn = fabsf(row.imuAngleZ - previousCrossHeading);
                    if (haveCross && turn > 300.0f && turn < 420.0f && loopIntervalCount < 8U)
                        loopIntervals[loopIntervalCount++] = totalLength - previousCrossArc;
                    previousCrossArc = totalLength;
                    previousCrossHeading = row.imuAngleZ;
                    haveCross = true;
                }
            }
            previousSourceMarker = row.courseMarker;
        }
        if (logSourceError(&file) || parsedRows == 0U || totalLength < PATH_ROUTE_SPACING_MM ||
            columns.expectedRows != parsedRows || previousPulse <= 0.0f ||
            fabsf(totalLength - (previousPulse / PULSE_MILLIMETER)) > fmaxf(50.0f, totalLength * 0.05f)) {
            resultCode = -11; goto failed;
        }
        if (inCross)
        {
            crossEndMm = totalLength;
            pathMarkCrossStraight(crossStartMm, crossEndMm);
        }
        if (pathPointDistance((float)lineRoute[routeCount - 1U].x_mm,
            (float)lineRoute[routeCount - 1U].y_mm, lastX, lastY) >= 0.5f) {
            if (routeCount >= PATH_ROUTE_MAX_POINTS - PATH_GOAL_RESERVED_POINTS) { resultCode = -7; goto failed; }
            lineRoute[routeCount].x_mm = pathFloatToInt16(lastX);
            lineRoute[routeCount].y_mm = pathFloatToInt16(lastY);
            sourceRouteXY[routeCount] = (PathSourcePoint){lastX, lastY};
            // 最終点だけは20mmの整数倍でない実際の終端距離で判定する。
            routeFlags[routeCount] = (totalLength >= crossStartMm - CROSS_STRAIGHT_MM &&
                totalLength <= crossEndMm + CROSS_STRAIGHT_MM) ? PATH_FLAG_CROSS_STRAIGHT : 0U;
            routeCount++;
        }
        if (routeCount < 2U) { resultCode = -11; goto failed; }
        {
            float period = pathFusionPeriod(loopIntervals, loopIntervalCount);
            // drive側の小数座標は半径確定まで保持し、その後だけ整数経路へ切り替える。
            pathBuildRouteArcLength(lineRoute);
            if (!pathPrepareSourceRadii(period)) { resultCode = -11; goto failed; }
            if (period > 0.0f)
            {
                // 元の1周目をdrive側に保全し、line側を周回共通の地図へ変換する。
                memcpy(driveRoute, lineRoute, sizeof(RoutePoint) * routeCount);
                pathBuildDriveRouteArcLength();
                // 元の一次位相・観測を保った状態で延長分も作り、キャッシュと共に保持する。
                if (!pathPrepareWhiteGoalExtension(period)) { resultCode = -16; goto failed; }
                if (!pathFusionNormalizeWhite(whiteRoute, driveRoute, driveRouteArcMm, routeCount, period))
                    { resultCode = -16; goto failed; }
                if (!pathFusionNormalizeLoop(lineRoute, driveRoute, driveRouteArcMm, routeCount, period))
                    { resultCode = -16; goto failed; }
                for (uint16_t marker = 0U; marker < routeMarkerCount; marker++)
                {
                    float markerX, markerY;
                    if (!pathFusionLoopPoint(driveRoute, driveRouteArcMm, routeCount, period,
                        routeMarkers[marker].arcMm, &markerX, &markerY))
                        { resultCode = -16; goto failed; }
                    routeMarkers[marker].x_mm = pathFloatToInt16(markerX);
                    routeMarkers[marker].y_mm = pathFloatToInt16(markerY);
                }
                routeLoopPeriodMm = period;
            }
        }
    }
    FRESULT closed = logSourceClose(&file);
    fileOpened = false;
    if (closed != FR_OK) { resultCode = -13; goto failed; }
    routeCache.valid = autoRunState.seriesActive;
    routeCache.source = source;
    routeCache.settings = generationSettings;
    routeCache.epoch = autoRunSeriesGeneration();
    routeCache.baseCount = routeCount;
	pathComputeHeadings(lineRoute, routeCount);
	memcpy(driveRoute, lineRoute, sizeof(RoutePoint) * routeCount);
	bool shortcutOk = false;
	if (requestedShortcutLevel > 0U && generationSettings.maxLevel == 0U)
	{
		routeShortcutLevel = 0U;
		routeShortcutBuildStatus = PATH_SHORTCUT_BUILD_DISABLED_BY_SETTING;
		routeShortcutCorridorCount = 0U;
		routeShortcutReductionMm = 0.0f;
	}
	else
	{
		if (shortcutLevel > generationSettings.maxLevel) shortcutLevel = generationSettings.maxLevel;
		shortcutOk = routeGenerateShortcut(shortcutLevel);
	}
	if (!shortcutOk)
	{
		pathBuildSpeedProfile(driveRoute, routeCount, 0U, false);
	}
	if (!pathExtendDriveRouteTowardOrigin(routeShortcutLevel, curvatureSpeed)) { resultCode = -15; goto failed; }
	pathBuildDriveRouteArcLength();
	routeSourceLog = (int16_t)logNumber;
	routeShortcutRequestedLevel = requestedShortcutLevel;
	routeGenerationSettings = generationSettings;
	routeGeometryCrc32 = pathComputeRouteGeometryCrc32();
	optimalTrace = curvatureSpeed ? curvatureMode : (shortcutOk ? BOOST_SHORTCUT : BOOST_PATH_REPLAY);
	indexSC = (int16_t)routeCount;
	optimalIndex = 0U;
	sd_fatfs_unlock();
	saveLogNumber((int16_t)logNumber);
	analyzedNumber = (int16_t)logNumber;
	return (int16_t)routeCount;
failed:
    if (fileOpened) (void)logSourceClose(&file);
    pathFollowerInvalidateRoute();
    optimalTrace = BOOST_NONE;
    sd_fatfs_unlock();
    return resultCode;
}

/////////////////////////////////////////////////////////////////////
// モジュール名 routeBuildFromLog
// 処理概要     検証済みログから経路を生成し経過時間を集計する
// 引数         logNumber: 一次ログ番号, shortcutLevel: 短縮レベル
// 戻り値       経路点数、失敗時は負のエラーコード
/////////////////////////////////////////////////////////////////////
int16_t routeBuildFromLog(int logNumber, uint8_t shortcutLevel)
{
    LOG_PERF_BEGIN(tick);
    int16_t result = routeBuildFromLogImpl(logNumber, shortcutLevel, BOOST_NONE);
    if (shortcutLevel > 0U) { LOG_PERF_END(shortcutMs, tick); }
    else { LOG_PERF_END(pathMs, tick); }
    return result;
}

/////////////////////////////////////////////////////////////////////
// モジュール名 routeBuildCurvatureFromLog
// 処理概要     PATHと同じ仮想ラインへDISTANCE共通の曲率別速度を設定する
// 引数         logNumber: 一次ログ番号
// 戻り値       経路点数、失敗時は負のエラーコード
/////////////////////////////////////////////////////////////////////
int16_t routeBuildCurvatureFromLog(int logNumber)
{
    LOG_PERF_BEGIN(tick);
    int16_t result = routeBuildFromLogImpl(logNumber, 0U, BOOST_PATH_CURVE);
    LOG_PERF_END(pathMs, tick);
    return result;
}

/////////////////////////////////////////////////////////////////////
// モジュール名 routeBuildShortcutCurvatureFromLog
// 処理概要     短縮経路へ一次走行の曲率別速度と共通の加減速制約を設定する
// 引数         logNumber: 一次ログ番号, shortcutLevel: 短縮レベル
// 戻り値       経路点数、失敗時は負のエラーコード
/////////////////////////////////////////////////////////////////////
int16_t routeBuildShortcutCurvatureFromLog(int logNumber, uint8_t shortcutLevel)
{
    LOG_PERF_BEGIN(tick);
    int16_t result = routeBuildFromLogImpl(logNumber, shortcutLevel, BOOST_SHORTCUT_CURVE);
    LOG_PERF_END(shortcutMs, tick);
    return result;
}

/////////////////////////////////////////////////////////////////////
// モジュール名 pathSenseLine
// 処理概要     単一ラインを検出し機体座標系の受光位置を推定する
// 引数         observation: 受光位置の格納先[mm]
// 戻り値       true: 有効な単一ライン false: 無効
/////////////////////////////////////////////////////////////////////
static bool pathSenseLine(PathLineObservation *observation)
{
	if (!isLineSensorCalibrationValid() || !lineSensorPower || lineSensorUpdateCount == 0U ||
		lineSensorUpdateAgeMs >= LS_UPDATE_STALE_MS) return false;
	PathFusionLine measured;
	if (!pathFusionSenseLine(lSensorCari, pathSensorLateralMm, pathSensorForwardMm, &measured))
		return false;
	observation->lateral_mm = measured.lateralMm;
	observation->forward_mm = measured.forwardMm;
	return true;
}

/////////////////////////////////////////////////////////////////////
// モジュール名 pathFindLineMatch
// 処理概要     検出ライン点に最も近い一次経路上の連続点を探索する
// 引数         sensorX_mm,sensorY_mm: 検出点世界座標[mm], nearest: 機体最近傍index,
//              maximumArcMm: 対応を許可する最大進捗[mm], match: 対応点の格納先
// 戻り値       true: 対応点あり false: 対応点なし
/////////////////////////////////////////////////////////////////////
static bool pathFindLineMatch(float sensorX_mm, float sensorY_mm, uint16_t nearest,
	float maximumArcMm, PathLineMatch *match)
{
	if (routeCount < 2U) return false;
	uint16_t begin = (nearest > PATH_LINE_MATCH_BACK_POINTS) ?
		(uint16_t)(nearest - PATH_LINE_MATCH_BACK_POINTS) : 0U;
	uint16_t forwardPoints = PATH_FUSION_WHITE_FORWARD_POINTS;
	uint16_t lastPoint = (nearest + forwardPoints < routeCount) ?
		(uint16_t)(nearest + forwardPoints) : (uint16_t)(routeCount - 1U);
	bool found = false;
	float bestDistanceSquared = 0.0f;
	for (uint16_t i = begin; i < lastPoint; i++)
	{
		float segmentHeadingError = pathWrapDeg(
			((float)lineRoute[i].heading_cdeg * 0.01f) - pathPose.heading_deg);
		if (!pathPolicyAssociationAllowed((float)driveRouteArcMm[i], maximumArcMm,
			segmentHeadingError, PATH_ASSOCIATION_HEADING_MAX_DEG)) continue;
		if (whiteRoute[i].valid == 0U || whiteRoute[i + 1U].valid == 0U) continue;
		float x0 = whiteRoute[i].x_mm;
		float y0 = whiteRoute[i].y_mm;
		float segmentX = whiteRoute[i + 1U].x_mm - x0;
		float segmentY = whiteRoute[i + 1U].y_mm - y0;
		float segmentLengthSquared = (segmentX * segmentX) + (segmentY * segmentY);
		if (segmentLengthSquared <= 1.0f) continue;
		float projection = (((sensorX_mm - x0) * segmentX) + ((sensorY_mm - y0) * segmentY)) /
			segmentLengthSquared;
		if (projection < 0.0f) projection = 0.0f;
		if (projection > 1.0f) projection = 1.0f;
		float candidateX = x0 + (segmentX * projection);
		float candidateY = y0 + (segmentY * projection);
		float residualX = sensorX_mm - candidateX;
		float residualY = sensorY_mm - candidateY;
		float distanceSquared = (residualX * residualX) + (residualY * residualY);
		if (!found || distanceSquared < bestDistanceSquared)
		{
			found = true;
			bestDistanceSquared = distanceSquared;
			match->x_mm = candidateX;
			match->y_mm = candidateY;
			float length = sqrtf(segmentLengthSquared);
			match->normalX = segmentY / length;
			match->normalY = -segmentX / length;
		}
	}
	if (!found) return false;
	match->residual_mm = sqrtf(bestDistanceSquared);
	return true;
}

/////////////////////////////////////////////////////////////////////
// モジュール名 pathFollowerResetCorrectionLog
// 処理概要     ログ保存成功時または走行初期化時に補正の区間集計をクリアする
// 引数         なし
// 戻り値       なし
/////////////////////////////////////////////////////////////////////
void pathFollowerResetCorrectionLog(void)
{
	pathCorrectionLog = (PathCorrectionLog){0};
	pathProgressResetLog();
}

/////////////////////////////////////////////////////////////////////
// モジュール名 pathFollowerInvalidateRoute
// 処理概要     共有RAM切替前に経路と追従状態を無効化する
// 引数         なし
// 戻り値       なし
/////////////////////////////////////////////////////////////////////
void pathFollowerInvalidateRoute(void)
{
    pathFollowerResetCorrectionLog();
    pathProgressReset();
    routeCache.valid = false;
    routeCache.sourceRadiiValid = false;
	routeCount = 0U;
	routeSourceLog = 0;
	routeMarkerCount = 0U;
	routeLoopPeriodMm = 0.0f;
	pathGoalValid = false;
	followerState = PATH_STATE_INACTIVE;
	targetSpeedMps = 0.0f;
	pathLogState = PATH_STATE_INACTIVE;
	pathLogErrorY_mm = 0.0f;
	pathLogErrorHeading_cdeg = 0;
	pathLogYawFF_dps = 0.0f;
	pathLogYawLateralFB_dps = 0.0f;
	pathLogYawHeadingFB_dps = 0.0f;
}

/////////////////////////////////////////////////////////////////////
// モジュール名 pathFollowerReset
// 処理概要     スタートマーカー基準で経路追従状態を初期化する
// 引数         なし
// 戻り値       なし
/////////////////////////////////////////////////////////////////////
void pathFollowerReset(void)
{
	pathFollowerResetCorrectionLog();
	pathProgressReset();
	if (runMemoryOwner != RUN_MEMORY_PATH)
	{
		pathFollowerInvalidateRoute();
		return;
	}
	memset(&pathPose, 0, sizeof(pathPose));
	routeIndex = 0U;
	lostCount = 0U;
	rejoinCount = 0U;
	lineLostCount = 0U;
	pathBlendPermille = 1000U;
	pathTravelMm = 0.0f;
	targetSpeedMps = (routeCount > 0U) ? (float)driveRoute[0].speed_cms * 0.01f : 0.0f;
	followerState = (routeCount > 1U) ? PATH_STATE_TRACKING : PATH_STATE_INACTIVE;
	pathLogLinePointX_mm = 0.0f;
	pathLogLinePointY_mm = 0.0f;
	pathLogLineValid = 0U;
	pathLogErrorY_mm = 0.0f;
	pathLogErrorHeading_cdeg = 0;
	pathLogState = (uint8_t)followerState;
	pathLogLegalMargin_mm = PATH_LINE_HALF_WIDTH_MM + PATH_OCCUPIED_HALF_WIDTH_MM;
	pathLogYawFF_dps = 0.0f;
	pathLogYawLateralFB_dps = 0.0f;
	pathLogYawHeadingFB_dps = 0.0f;
	pathLogLineMatchResidual_mm = 0.0f;
	pathLogPoseCorrection_um = 0U;
	pathLogPoseCorrectionHeading_cdeg = 0;
	pathObservationReset(&observationTrust);
	pathFusionFilterReset(&whiteFusionFilter);
	currentLineValid = false;
	observationStepDistanceMm = 0.0f;
	limitedTargetSpeedMps = targetSpeedMps;
	pathLogConfidencePermille = 1000U;
	pathLogObservationAgeMs = 0U;
}

/////////////////////////////////////////////////////////////////////
// モジュール名 pathFollowerUpdatePose1ms
// 処理概要     エンコーダとジャイロから1ms周期で自己位置を更新する
// 引数         encoderPulse:1ms移動パルス, gyroDegPerSec:角速度[deg/s]
// 戻り値       なし
/////////////////////////////////////////////////////////////////////
void pathFollowerUpdatePose1ms(int32_t encoderPulse, float gyroDegPerSec)
{
	if (followerState == PATH_STATE_INACTIVE || followerState == PATH_STATE_LOCALIZATION_LOST) return;
	if (!isfinite(gyroDegPerSec))
	{
		followerState = PATH_STATE_LOCALIZATION_LOST;
		targetSpeedMps = 0.0f;
		limitedTargetSpeedMps = 0.0f;
		pathLogState = PATH_STATE_LOCALIZATION_LOST;
		pathLogConfidencePermille = 0U;
		pathLogYawFF_dps = 0.0f;
		pathLogYawLateralFB_dps = 0.0f;
		pathLogYawHeadingFB_dps = 0.0f;
		setTargetAngularVelocity(0.0f);
		return;
	}
	const ShortcutSettings *settings = runStartSettingsValid ? &runStartSettings : &shortcutSettings;
	bool fusionActive = settings->lineAlpha_x1000 > 0U;
	float correctedGyro = gyroDegPerSec - (fusionActive ? whiteFusionFilter.biasRadPerSec * RAD2DEG : 0.0f);
	float middleHeading = pathPose.heading_deg + correctedGyro * 0.0005f;
	pathPose.heading_deg = pathWrapDeg(pathPose.heading_deg + correctedGyro * 0.001f);
	float distanceMm = (float)encoderPulse / PULSE_MILLIMETER;
	pathProgressPredict1ms(distanceMm, gyroDegPerSec * DEG2RAD);
	observationStepDistanceMm = distanceMm;
	if (distanceMm > 0.0f) pathTravelMm += distanceMm;
	float headingRad = pathPose.heading_deg * DEG2RAD;
	pathPose.x_mm += distanceMm * sinf(headingRad);
	pathPose.y_mm += distanceMm * cosf(headingRad);
	if (fusionActive) pathFusionFilterPredict(&whiteFusionFilter, distanceMm, middleHeading * DEG2RAD);
}

/////////////////////////////////////////////////////////////////////
// モジュール名 pathCurvatureAtArcWindow
// 処理概要     時間先行した弧長窓で接線方位の変化を平均し、曲率の過剰な先行を抑える
// 引数         nearest: 最近傍点、windowMm: 平均窓幅[mm]、measuredSpeedMps: 移動速度[m/s]
// 戻り値       符号付き曲率[rad/mm]。窓が成立しない場合は0
/////////////////////////////////////////////////////////////////////
static float pathCurvatureAtArcWindow(uint16_t nearest, float windowMm, float measuredSpeedMps)
{
	if (routeCount < 2U || nearest >= routeCount || !isfinite(windowMm) || windowMm <= 1.0f ||
		!isfinite(measuredSpeedMps)) return 0.0f;
	// m/s × msはmm。曲率窓の中心だけを旋回応答時間ぶん先行させる。
	float center = (float)driveRouteArcMm[nearest] +
		fmaxf(0.0f, measuredSpeedMps) * PATH_CURVE_YAW_PREVIEW_TIME_MS;
	if (!isfinite(center)) return 0.0f;
	float start = fmaxf(0.0f, center - windowMm * 0.5f);
	float end = fminf((float)driveRouteArcMm[routeCount - 1U], center + windowMm * 0.5f);
	if (end - start <= 1.0f) return 0.0f;
	uint16_t first = nearest;
	while (first > 0U && (float)driveRouteArcMm[first] > start) first--;
	while (first + 1U < routeCount && (float)driveRouteArcMm[first + 1U] <= start) first++;
	float changeDeg = 0.0f, coveredMm = 0.0f;
	for (uint16_t i = first; i + 1U < routeCount && (float)driveRouteArcMm[i] < end; i++)
	{
		float a = fmaxf(start, (float)driveRouteArcMm[i]);
		float b = fminf(end, (float)driveRouteArcMm[i + 1U]);
		float length = (float)driveRouteArcMm[i + 1U] - (float)driveRouteArcMm[i];
		if (b > a && length > 0.0f)
		{
			float deltaDeg = pathWrapDeg(
				((float)driveRoute[i + 1U].heading_cdeg - (float)driveRoute[i].heading_cdeg) * 0.01f);
			// 直線化した20mm区間は平均窓の距離に含め、旋回量だけを0にする。
			if ((routeFlags[i] & PATH_FLAG_CROSS_STRAIGHT) != 0U) deltaDeg = 0.0f;
			changeDeg += deltaDeg * ((b - a) / length);
			coveredMm += b - a;
		}
	}
	return coveredMm > 1.0f ? changeDeg * DEG2RAD / coveredMm : 0.0f;
}

/////////////////////////////////////////////////////////////////////
// モジュール名 pathFollowerUpdateTarget1ms
// 処理概要     最新自己位置から経路との偏差、目標速度と操舵角速度を更新する
// 引数         なし
// 戻り値       なし
/////////////////////////////////////////////////////////////////////
void pathFollowerUpdateTarget1ms(void)
{
	if (routeCount < 2U || followerState == PATH_STATE_INACTIVE || followerState == PATH_STATE_LOCALIZATION_LOST) return;
	const ShortcutSettings *activeSettings = runStartSettingsValid ? &runStartSettings : &shortcutSettings;
	uint16_t begin = (routeIndex > 2U) ? (uint16_t)(routeIndex - 2U) : 0U;
	uint16_t end = (routeIndex + 24U < routeCount) ? (uint16_t)(routeIndex + 24U) : (uint16_t)(routeCount - 1U);
	uint16_t nearest = routeIndex;
	float nearestDistance = pathPointDistance(pathPose.x_mm, pathPose.y_mm,
		driveRoute[routeIndex].x_mm, driveRoute[routeIndex].y_mm);
	float maximumArcMm = pathTravelMm + PATH_ASSOCIATION_PROGRESS_MARGIN_MM;
	bool associationValid = false;
	for (uint16_t i = begin; i <= end; i++)
	{
		float candidateHeadingError = pathWrapDeg(
			((float)driveRoute[i].heading_cdeg * 0.01f) - pathPose.heading_deg);
		if (!pathPolicyAssociationAllowed((float)driveRouteArcMm[i], maximumArcMm,
			candidateHeadingError, PATH_ASSOCIATION_HEADING_MAX_DEG)) continue;
		float distance = pathPointDistance(pathPose.x_mm, pathPose.y_mm, driveRoute[i].x_mm, driveRoute[i].y_mm);
		if (!associationValid || distance < nearestDistance)
		{
			nearestDistance = distance;
			nearest = i;
			associationValid = true;
		}
	}
	if (!associationValid)
	{
		nearest = routeIndex;
		nearestDistance = pathPointDistance(pathPose.x_mm, pathPose.y_mm,
			driveRoute[nearest].x_mm, driveRoute[nearest].y_mm);
	}
	routeIndex = nearest;
	optimalIndex = routeIndex;

	PathLineObservation observation = {0.0f, 0.0f};
	currentLineValid = pathSenseLine(&observation);
	// 短縮区間と前後100mmでは白線への引戻しを避け、短縮経路の追従を優先する。
	bool corridorLineCorrectionBlocked = routeShortcutLevel > 0U &&
		((routeFlags[nearest] & PATH_FLAG_CORRIDOR_RESERVED) != 0U);
	// 入口より前に白線退避へ入っていた場合も、短縮区間では白線追従を続けない。
	if (corridorLineCorrectionBlocked)
	{
		pathBlendPermille = 1000U;
		if (followerState == PATH_STATE_LINE_FALLBACK || followerState == PATH_STATE_REJOIN)
			followerState = PATH_STATE_LOCALIZATION_LOST;
	}
	PathLineMatch lineMatch = {(float)lineRoute[nearest].x_mm,
		(float)lineRoute[nearest].y_mm, 0.0f, 0.0f, 0.0f};
	float correctionStartX = pathPose.x_mm, correctionStartY = pathPose.y_mm;
	float whiteHeadingCorrectionDeg = 0.0f;
	bool lineMatchValid = false;
	pathLogPoseCorrection_um = 0U;
	pathLogPoseCorrectionHeading_cdeg = 0;
	if (currentLineValid && associationValid)
	{
		float poseHeadingRad = pathPose.heading_deg * DEG2RAD;
		float headingSin = sinf(poseHeadingRad);
		float headingCos = cosf(poseHeadingRad);
		float sensorX = pathPose.x_mm + (observation.lateral_mm * headingCos) +
			(observation.forward_mm * headingSin);
		float sensorY = pathPose.y_mm - (observation.lateral_mm * headingSin) +
			(observation.forward_mm * headingCos);
		lineMatchValid = pathFindLineMatch(sensorX, sensorY, nearest, maximumArcMm, &lineMatch);
		if (lineMatchValid && lineMatch.residual_mm <= PATH_LINE_MATCH_RESIDUAL_MAX_MM &&
			!corridorLineCorrectionBlocked)
		{
			float residualX = sensorX - lineMatch.x_mm;
			float residualY = sensorY - lineMatch.y_mm;
			float correctionX, correctionY;
			float sensorDerivativeX = (-observation.lateral_mm * headingSin) +
				(observation.forward_mm * headingCos);
			float sensorDerivativeY = (-observation.lateral_mm * headingCos) -
				(observation.forward_mm * headingSin);
			float quality = pathFusionSlipWeight(slipV2.result.longFast, slipV2.result.longSlow,
				slipV2.result.lateral, slipV2.result.yawDps, slipV2.result.flags,
				slipV2.result.valid != 0U);
			float residual = residualX * lineMatch.normalX + residualY * lineMatch.normalY;
			float derivative = sensorDerivativeX * lineMatch.normalX + sensorDerivativeY * lineMatch.normalY;
			float headingCorrectionRad = 0.0f;
			pathFusionFilterCorrect(&whiteFusionFilter, lineMatch.normalX, lineMatch.normalY,
				derivative, residual, quality, activeSettings->lineAlpha_x1000,
				activeSettings->lineThetaGain_x1e9, &correctionX, &correctionY, &headingCorrectionRad);
			float correctionDistance = fminf(PATH_LINE_POSITION_CORRECTION_MAX_MM, hypotf(correctionX, correctionY));
			float headingCorrectionDeg = headingCorrectionRad * RAD2DEG;
			headingCorrectionDeg = fminf(PATH_LINE_HEADING_CORRECTION_MAX_DEG,
				fmaxf(-PATH_LINE_HEADING_CORRECTION_MAX_DEG, headingCorrectionDeg));
			if (pathPolicyPoseCorrectionAllowed(correctionDistance, headingCorrectionDeg,
				PATH_LINE_POSITION_CORRECTION_MAX_MM, PATH_LINE_HEADING_CORRECTION_MAX_DEG))
			{
				pathPose.x_mm += correctionX;
				pathPose.y_mm += correctionY;
				pathPose.heading_deg = pathWrapDeg(pathPose.heading_deg + headingCorrectionDeg);
				pathLogPoseCorrection_um = (uint16_t)lroundf(correctionDistance * 1000.0f);
				pathLogPoseCorrectionHeading_cdeg = pathFloatToInt16(headingCorrectionDeg * 100.0f);
				whiteHeadingCorrectionDeg = headingCorrectionDeg;
			}
		}
	}
	bool freshLine = lineSensorPower && lineSensorUpdateCount != 0U &&
		lineSensorUpdateAgeMs < LS_UPDATE_STALE_MS;
	float tangentRad = (float)driveRoute[nearest].heading_cdeg * 0.01f * DEG2RAD;
	PathProgressInput progressInput = {
		.poseX_mm = pathPose.x_mm, .poseY_mm = pathPose.y_mm,
		.heading_rad = pathPose.heading_deg * DEG2RAD, .tangent_rad = tangentRad,
		.lateral_mm = observation.lateral_mm, .forward_mm = observation.forward_mm,
		.observationId = lineSensorUpdateCount, .nearest = nearest,
		.enabled = activeSettings->lineAlpha_x1000 > 0U && associationValid &&
			!corridorLineCorrectionBlocked && slipV2.result.flags == 0U &&
			(followerState == PATH_STATE_TRACKING || followerState == PATH_STATE_CAUTION),
		.lineValid = currentLineValid && freshLine
	};
	float progressCorrectionMm = pathProgressStep1ms(&progressInput, whiteRoute,
		driveRouteArcMm, routeFlags, routeCount,
		PATH_FLAG_CORRIDOR_RESERVED | PATH_FLAG_CROSS_STRAIGHT);
	// 先に適用した法線補正を優先し、全白線補正の0.2mm/1ms以内に収める。
	float remainingCorrectionMm = fmaxf(0.0f, PATH_LINE_POSITION_CORRECTION_MAX_MM -
		hypotf(pathPose.x_mm - correctionStartX, pathPose.y_mm - correctionStartY));
	progressCorrectionMm = fminf(remainingCorrectionMm,
		fmaxf(-remainingCorrectionMm, progressCorrectionMm));
	pathPose.x_mm += progressCorrectionMm * sinf(tangentRad);
	pathPose.y_mm += progressCorrectionMm * cosf(tangentRad);
	// 補正済み進捗の探索上限も同じ量だけ動かす。生車輪距離は変更しない。
	pathTravelMm = fmaxf(0.0f, pathTravelMm + progressCorrectionMm);
	maximumArcMm = pathTravelMm + PATH_ASSOCIATION_PROGRESS_MARGIN_MM;
	float whiteCorrectionX = pathPose.x_mm - correctionStartX;
	float whiteCorrectionY = pathPose.y_mm - correctionStartY;
	// 法線・前後補正を合わせた位置移動量を最終検査する。
	float totalCorrectionX = pathPose.x_mm - correctionStartX;
	float totalCorrectionY = pathPose.y_mm - correctionStartY;
	float totalCorrection = hypotf(totalCorrectionX, totalCorrectionY);
	float correctionScale = 1.0f;
	if (totalCorrection > PATH_LINE_POSITION_CORRECTION_MAX_MM)
	{
		float scale = PATH_LINE_POSITION_CORRECTION_MAX_MM / totalCorrection;
		correctionScale = scale;
		pathPose.x_mm = correctionStartX + totalCorrectionX * scale;
		pathPose.y_mm = correctionStartY + totalCorrectionY * scale;
		totalCorrection = PATH_LINE_POSITION_CORRECTION_MAX_MM;
	}
	pathLogPoseCorrection_um = (uint16_t)lroundf(totalCorrection * 1000.0f);
	pathProgressRecordApplied(progressCorrectionMm * correctionScale);
	pathTravelMm = fmaxf(0.0f, pathTravelMm - progressCorrectionMm * (1.0f - correctionScale));
	float whitePositionCorrectionMm = hypotf(whiteCorrectionX, whiteCorrectionY) * correctionScale;
	pathCorrectionLog.whitePosition_mm += whitePositionCorrectionMm;
	pathCorrectionLog.whiteHeading_deg += whiteHeadingCorrectionDeg;
	if (whitePositionCorrectionMm > 0.0f || whiteHeadingCorrectionDeg != 0.0f)
		pathCorrectionLog.whiteApplied = 1U;
	pathLogLineValid = currentLineValid ? 1U : 0U;
	pathLogLinePointX_mm = lineMatch.x_mm;
	pathLogLinePointY_mm = lineMatch.y_mm;
	pathLogLineMatchResidual_mm = lineMatchValid ? lineMatch.residual_mm : 0.0f;
	// 明部の存在と、自己位置を拘束できる白線照合を別々に監視する。
	bool visibleLine = false;
	for (uint8_t sensor = 0U; sensor < NUM_SENSORS; sensor++)
	{
		if (lSensorCari[sensor] >= PATH_SENSOR_ACTIVE_TH) visibleLine = true;
	}
	bool matchedLine = currentLineValid && associationValid && lineMatchValid &&
		lineMatch.residual_mm <= PATH_LINE_MATCH_RESIDUAL_MAX_MM;
	pathObservationStep1ms(&observationTrust, freshLine, visibleLine, matchedLine,
		observationStepDistanceMm);
	pathLogConfidencePermille = observationTrust.confidencePermille;
	pathLogObservationAgeMs = observationTrust.noMatchMs;
	nearestDistance = pathPointDistance(pathPose.x_mm, pathPose.y_mm,
		driveRoute[nearest].x_mm, driveRoute[nearest].y_mm);

	float lookaheadMm = (float)activeSettings->lookaheadBaseMm +
		((float)activeSettings->lookaheadPerMpsMm * targetSpeedMps);
	float nearestHeadingRad = (float)driveRoute[nearest].heading_cdeg * 0.01f * DEG2RAD;
	float nearestHeadingError = pathWrapDeg(
		((float)driveRoute[nearest].heading_cdeg * 0.01f) - pathPose.heading_deg);
	float dx = pathPose.x_mm - (float)driveRoute[nearest].x_mm;
	float dy = pathPose.y_mm - (float)driveRoute[nearest].y_mm;
	float lateralError = (dx * cosf(nearestHeadingRad)) - (dy * sinf(nearestHeadingRad));
	// 1msの自己位置更新で使用したエンコーダ移動量[mm/ms]は数値上m/sと等しい。
	float measuredSpeedMps = isfinite(observationStepDistanceMm) ?
		fminf(PATH_CURVE_MAX_SPEED_MPS, fmaxf(0.0f, observationStepDistanceMm)) : 0.0f;
	float curvature = pathCurvatureAtArcWindow(nearest, lookaheadMm, measuredSpeedMps);
	targetSpeedMps = (float)driveRoute[nearest].speed_cms * 0.01f;
	float feedForwardSpeedMps = measuredSpeedMps;
	float feedForwardDegPerSec = (feedForwardSpeedMps * 1000.0f) * curvature * RAD2DEG;
	float kLateral = (float)activeSettings->kLateral_x100 * 0.01f;
	float kHeading = (float)activeSettings->kHeading_x100 * 0.01f;
	float targetYawRate = feedForwardDegPerSec - (kLateral * lateralError) + (kHeading * nearestHeadingError);
	// 操舵式は維持し、同じ周期の符号付き成分を飽和前の診断値として保持する。
	pathLogYawFF_dps = feedForwardDegPerSec;
	pathLogYawLateralFB_dps = -(kLateral * lateralError);
	pathLogYawHeadingFB_dps = kHeading * nearestHeadingError;
	if (targetYawRate > 1800.0f) targetYawRate = 1800.0f;
	if (targetYawRate < -1800.0f) targetYawRate = -1800.0f;
	setTargetAngularVelocity(targetYawRate);
	log_targetAngularVelocity = (int32_t)targetYawRate;

	/*
	 * 先読み方位は曲率FFだけに使い、方位FB、ロスト判定、再合流判定には
	 * 最近傍経路点の接線方位差を使う。急カーブ手前で先読み方位差を
	 * 方位FBへ加えると、経路の接線が曲がる前から旋回して内側へ外れる。
	 */
	if (!associationValid || nearestDistance > PATH_LOST_DISTANCE_MM ||
		fabsf(nearestHeadingError) > PATH_LOST_HEADING_DEG)
	{
		if (lostCount < UINT16_MAX) lostCount++;
	}
	else
	{
		lostCount = 0U;
	}
	if ((followerState == PATH_STATE_TRACKING || followerState == PATH_STATE_CAUTION) &&
		lostCount >= PATH_LOST_TIME_MS)
	{
		if (currentLineValid && !corridorLineCorrectionBlocked)
		{
			followerState = PATH_STATE_LINE_FALLBACK;
			pathBlendPermille = 0U;
			lineLostCount = 0U;
		}
		else
		{
			followerState = PATH_STATE_LOCALIZATION_LOST;
		}
	}
	else if (followerState == PATH_STATE_LINE_FALLBACK)
	{
		if (!currentLineValid)
		{
			if (lineLostCount < UINT16_MAX) lineLostCount++;
			if (lineLostCount >= PATH_LINE_LOST_TIME_MS) followerState = PATH_STATE_LOCALIZATION_LOST;
		}
		else
		{
			lineLostCount = 0U;
			if (nearestDistance < PATH_REJOIN_DISTANCE_MM && fabsf(nearestHeadingError) < PATH_REJOIN_HEADING_DEG)
			{
				if (rejoinCount < UINT16_MAX) rejoinCount++;
				if (rejoinCount >= PATH_REJOIN_TIME_MS)
				{
					followerState = PATH_STATE_REJOIN;
					pathBlendPermille = 0U;
				}
			}
			else
			{
				rejoinCount = 0U;
			}
		}
	}
	else if (followerState == PATH_STATE_REJOIN)
	{
		if (pathBlendPermille + PATH_REJOIN_BLEND_STEP >= 1000U)
		{
			pathBlendPermille = 1000U;
			followerState = PATH_STATE_TRACKING;
			lostCount = 0U;
			rejoinCount = 0U;
		}
		else
		{
			pathBlendPermille += PATH_REJOIN_BLEND_STEP;
		}
	}

	if (observationTrust.lost ||
		(corridorLineCorrectionBlocked && followerState == PATH_STATE_LOCALIZATION_LOST))
	{
		followerState = PATH_STATE_LOCALIZATION_LOST;
		targetSpeedMps = 0.0f;
		limitedTargetSpeedMps = 0.0f;
		setTargetAngularVelocity(0.0f);
		pathLogYawFF_dps = 0.0f;
		pathLogYawLateralFB_dps = 0.0f;
		pathLogYawHeadingFB_dps = 0.0f;
	}
	else
	{
		if (observationTrust.caution && followerState == PATH_STATE_TRACKING)
			followerState = PATH_STATE_CAUTION;
		else if (!observationTrust.caution && followerState == PATH_STATE_CAUTION)
			followerState = PATH_STATE_TRACKING;
		if (observationTrust.caution && currentLineValid && !corridorLineCorrectionBlocked &&
			observationTrust.noMatchMs >= PATH_OBSERVATION_MATCH_CAUTION_MS &&
			(followerState == PATH_STATE_TRACKING || followerState == PATH_STATE_CAUTION))
		{
			followerState = PATH_STATE_LINE_FALLBACK;
			pathBlendPermille = 0U;
			lineLostCount = 0U;
		}
		float desiredSpeed = targetSpeedMps;
		// 有効な白線照合が戻るまで加速を保留し、計画上の減速は維持する。
		if (!matchedLine)
			desiredSpeed = fminf(desiredSpeed, limitedTargetSpeedMps);
		if (observationTrust.caution || followerState == PATH_STATE_LINE_FALLBACK ||
			followerState == PATH_STATE_REJOIN)
			desiredSpeed = fminf(desiredSpeed, fminf(tgtParam.search,
				PATH_OBSERVATION_CAUTION_SPEED_MPS));
		float acceleration = fminf(20.0f, fmaxf(0.0f, tgtParam.acceleF)) * 0.001f;
		float deceleration = fminf(20.0f, fmaxf(0.0f, tgtParam.acceleD)) * 0.001f;
		if (observationTrust.caution && deceleration <= 0.0f) deceleration = 0.020f;
		limitedTargetSpeedMps = fminf(limitedTargetSpeedMps + acceleration,
			fmaxf(limitedTargetSpeedMps - deceleration, desiredSpeed));
		targetSpeedMps = fmaxf(0.0f, limitedTargetSpeedMps);
		// 全経路モードで減速中も現在の移動速度へFFを合わせる。
		feedForwardSpeedMps = measuredSpeedMps;
		pathLogYawFF_dps = feedForwardSpeedMps * 1000.0f * curvature * RAD2DEG;
		targetYawRate = pathLogYawFF_dps + pathLogYawLateralFB_dps + pathLogYawHeadingFB_dps;
		targetYawRate = fminf(1800.0f, fmaxf(-1800.0f, targetYawRate));
		setTargetAngularVelocity(targetYawRate);
		log_targetAngularVelocity = (int32_t)targetYawRate;
	}
	float lineOffset = pathPointDistance(lineRoute[nearest].x_mm, lineRoute[nearest].y_mm,
		driveRoute[nearest].x_mm, driveRoute[nearest].y_mm);
	pathLogErrorY_mm = lateralError;
	pathLogErrorHeading_cdeg = pathFloatToInt16(nearestHeadingError * 100.0f);
	pathLogState = (uint8_t)followerState;
	pathLogLegalMargin_mm = PATH_LINE_HALF_WIDTH_MM + PATH_OCCUPIED_HALF_WIDTH_MM -
		lineOffset - PATH_TRACKING_ERROR_BUDGET_MM;
}

/////////////////////////////////////////////////////////////////////
// モジュール名 pathFollowerGetStatus
// 処理概要     経路追従状態を返す
// 引数         なし
// 戻り値       経路追従状態
/////////////////////////////////////////////////////////////////////
PathFollowerState pathFollowerGetStatus(void) { return followerState; }
/////////////////////////////////////////////////////////////////////
// モジュール名 pathFollowerGetPathBlendPermille
// 処理概要     経路操舵の混合率を返す
// 引数         なし
// 戻り値       経路操舵混合率[permille]
/////////////////////////////////////////////////////////////////////
uint16_t pathFollowerGetPathBlendPermille(void) { return pathBlendPermille; }
/////////////////////////////////////////////////////////////////////
// モジュール名 pathFollowerGetTargetSpeedMps
// 処理概要     現在の経路目標速度を返す
// 引数         なし
// 戻り値       目標速度[m/s]
/////////////////////////////////////////////////////////////////////
float pathFollowerGetTargetSpeedMps(void) { return targetSpeedMps; }
/////////////////////////////////////////////////////////////////////
// モジュール名 pathFollowerLineIsValid
// 処理概要     位置補正用ライン検出の有効状態を返す
// 引数         なし
// 戻り値       true: 有効 false: 無効
/////////////////////////////////////////////////////////////////////
bool pathFollowerLineIsValid(void) { return currentLineValid; }
/////////////////////////////////////////////////////////////////////
// モジュール名 pathRouteCount
// 処理概要     現在の経路点数を返す
// 引数         なし
// 戻り値       経路点数
/////////////////////////////////////////////////////////////////////
uint16_t pathRouteCount(void) { return routeCount; }
/////////////////////////////////////////////////////////////////////
// モジュール名 pathFollowerGoalReached
// 処理概要     一次走行終端と原点の中間点への到達を判定する
// 引数         なし
// 戻り値       true:停止開始位置へ到達 false:走行途中
/////////////////////////////////////////////////////////////////////
bool pathFollowerGoalReached(void)
{
	if (routeIndex >= routeCount) return false;
	return pathPolicyGoalReached(pathGoalValid, routeIndex, routeCount,
		driveRouteArcMm[routeIndex], pathGoalArcMm);
}
/////////////////////////////////////////////////////////////////////
// モジュール名 pathRouteSourceLog
// 処理概要     経路生成元のログ番号を返す
// 引数         なし
// 戻り値       ログ番号
/////////////////////////////////////////////////////////////////////
int16_t pathRouteSourceLog(void) { return routeSourceLog; }
/////////////////////////////////////////////////////////////////////
// モジュール名 pathRouteShortcutLevel
// 処理概要     適用済みショートカットレベルを返す
// 引数         なし
// 戻り値       ショートカットレベル
/////////////////////////////////////////////////////////////////////
uint8_t pathRouteShortcutLevel(void) { return routeShortcutLevel; }

/////////////////////////////////////////////////////////////////////
// モジュール名 pathRouteShortcutBuildStatus
// 処理概要     Level 1経路生成結果を取得する
// 引数         なし
// 戻り値       PathShortcutBuildStatus
/////////////////////////////////////////////////////////////////////
uint8_t pathRouteShortcutBuildStatus(void) { return routeShortcutBuildStatus; }

/////////////////////////////////////////////////////////////////////
// モジュール名 pathRouteShortcutCorridorCount
// 処理概要     生成した直線回廊数を取得する
// 引数         なし
// 戻り値       直線回廊数
/////////////////////////////////////////////////////////////////////
uint8_t pathRouteShortcutCorridorCount(void) { return routeShortcutCorridorCount; }

/////////////////////////////////////////////////////////////////////
// モジュール名 pathRouteShortcutReductionMm
// 処理概要     Level 1経路の全長短縮量を取得する
// 引数         なし
// 戻り値       短縮量[mm]
/////////////////////////////////////////////////////////////////////
float pathRouteShortcutReductionMm(void) { return routeShortcutReductionMm; }

/////////////////////////////////////////////////////////////////////
// モジュール名 pathRouteLoopPeriodMm
// 処理概要     周回共通地図に使用した一次の周期を取得する
// 引数         なし
// 戻り値       周期[mm]、共通化なしは0
/////////////////////////////////////////////////////////////////////
float pathRouteLoopPeriodMm(void) { return routeLoopPeriodMm; }

/////////////////////////////////////////////////////////////////////
// モジュール名 pathRunLoopPeriodMm
// 処理概要     走行開始時に固定した周回地図の周期を返す
// 引数         なし
// 戻り値       周回周期[mm]、未生成時0
/////////////////////////////////////////////////////////////////////
float pathRunLoopPeriodMm(void) { return runLoopPeriodMm; }

/////////////////////////////////////////////////////////////////////
// モジュール名 pathFollowerGyroBiasDps
// 処理概要     白線から推定した追加のジャイロずれを返す
// 引数         なし
// 戻り値       温度補正後の残留ジャイロずれ[deg/s]
/////////////////////////////////////////////////////////////////////
float pathFollowerGyroBiasDps(void) { return whiteFusionFilter.biasRadPerSec * RAD2DEG; }

/////////////////////////////////////////////////////////////////////
// モジュール名 pathFollowerCaptureRunStartSettings
// 処理概要     走行開始時のショートカット設定と経路生成情報を固定する
// 引数         なし
// 戻り値       なし
/////////////////////////////////////////////////////////////////////
void pathFollowerCaptureRunStartSettings(void)
{
	runStartSettings = shortcutSettings;
	runStartSettingsValid = true;
	runRouteSourceLog = 0;
	runRouteRequestedLevel = 0U;
	runRouteShortcutLevel = 0U;
	runRouteShortcutBuildStatus = PATH_SHORTCUT_BUILD_NOT_REQUESTED;
	runRouteShortcutCorridorCount = 0U;
	runRouteShortcutReductionMm = 0.0f;
	runRouteCount = 0U;
	runRouteGeometryCrc32 = 0U;
	runLoopPeriodMm = 0.0f;
	runGenerationSettings = (ShortcutSettings){0U, 0U, 0U, 0U, 0U, 0U, 0U};
	if (isPathRunMode(optimalTrace))
	{
		runRouteSourceLog = routeSourceLog;
		runRouteRequestedLevel = routeShortcutRequestedLevel;
		runRouteShortcutLevel = routeShortcutLevel;
		runRouteShortcutBuildStatus = routeShortcutBuildStatus;
		runRouteShortcutCorridorCount = routeShortcutCorridorCount;
		runRouteShortcutReductionMm = routeShortcutReductionMm;
		runRouteCount = routeCount;
		runRouteGeometryCrc32 = routeGeometryCrc32;
		runLoopPeriodMm = routeLoopPeriodMm;
		runGenerationSettings = routeGenerationSettings;
	}
}

/////////////////////////////////////////////////////////////////////
// モジュール名 pathRouteGenerationSettings
// 処理概要     経路生成成功時に保存したショートカット設定を返す
// 引数         なし
// 戻り値       経路生成時設定
/////////////////////////////////////////////////////////////////////
ShortcutSettings pathRouteGenerationSettings(void) { return routeGenerationSettings; }

/////////////////////////////////////////////////////////////////////
// モジュール名 pathRunStartSettings
// 処理概要     走行開始時に固定したショートカット設定を返す
// 引数         なし
// 戻り値       走行開始時設定
/////////////////////////////////////////////////////////////////////
ShortcutSettings pathRunStartSettings(void) { return runStartSettings; }

/////////////////////////////////////////////////////////////////////
// モジュール名 pathRunGenerationSettings
// 処理概要     走行開始時に固定した経路生成時設定を返す
// 引数         なし
// 戻り値       経路生成時設定
/////////////////////////////////////////////////////////////////////
ShortcutSettings pathRunGenerationSettings(void) { return runGenerationSettings; }

/////////////////////////////////////////////////////////////////////
// モジュール名 pathRunRouteSourceLog
// 処理概要     走行開始時に固定した経路元ログ番号を返す
// 引数         なし
// 戻り値       ログ番号。不明または非PATH走行は0
/////////////////////////////////////////////////////////////////////
int16_t pathRunRouteSourceLog(void) { return runRouteSourceLog; }

/////////////////////////////////////////////////////////////////////
// モジュール名 pathRunRouteRequestedLevel
// 処理概要     走行開始時に固定した要求ショートカットレベルを返す
// 引数         なし
// 戻り値       要求レベル
/////////////////////////////////////////////////////////////////////
uint8_t pathRunRouteRequestedLevel(void) { return runRouteRequestedLevel; }

/////////////////////////////////////////////////////////////////////
// モジュール名 pathRunRouteShortcutLevel
// 処理概要     走行開始時に固定した採用ショートカットレベルを返す
// 引数         なし
// 戻り値       採用レベル
/////////////////////////////////////////////////////////////////////
uint8_t pathRunRouteShortcutLevel(void) { return runRouteShortcutLevel; }

/////////////////////////////////////////////////////////////////////
// モジュール名 pathRunRouteShortcutBuildStatus
// 処理概要     走行開始時に固定した経路生成結果を返す
// 引数         なし
// 戻り値       生成結果
/////////////////////////////////////////////////////////////////////
uint8_t pathRunRouteShortcutBuildStatus(void) { return runRouteShortcutBuildStatus; }

/////////////////////////////////////////////////////////////////////
// モジュール名 pathRunRouteShortcutCorridorCount
// 処理概要     走行開始時に固定した直線回廊数を返す
// 引数         なし
// 戻り値       回廊数
/////////////////////////////////////////////////////////////////////
uint8_t pathRunRouteShortcutCorridorCount(void) { return runRouteShortcutCorridorCount; }

/////////////////////////////////////////////////////////////////////
// モジュール名 pathRunRouteShortcutReductionMm
// 処理概要     走行開始時に固定した経路短縮量を返す
// 引数         なし
// 戻り値       短縮量[mm]
/////////////////////////////////////////////////////////////////////
float pathRunRouteShortcutReductionMm(void) { return runRouteShortcutReductionMm; }

/////////////////////////////////////////////////////////////////////
// モジュール名 pathRunRouteCount
// 処理概要     走行開始時に固定した経路点数を返す
// 引数         なし
// 戻り値       経路点数
/////////////////////////////////////////////////////////////////////
uint16_t pathRunRouteCount(void) { return runRouteCount; }

/////////////////////////////////////////////////////////////////////
// モジュール名 pathRunRouteGeometryCrc32
// 処理概要     走行開始時に固定した経路形状CRC32を返す
// 引数         なし
// 戻り値       経路形状CRC32。不明または非PATH走行は0
/////////////////////////////////////////////////////////////////////
uint32_t pathRunRouteGeometryCrc32(void) { return runRouteGeometryCrc32; }

/////////////////////////////////////////////////////////////////////
// モジュール名 pathRunRouteExportMatches
// 処理概要     停止後の共有経路が走行開始時の計画に一致するか確認する
// 引数         なし
// 戻り値       true: 一致、false: 経路無効または不一致
/////////////////////////////////////////////////////////////////////
bool pathRunRouteExportMatches(void)
{
	return !modeLOG && runMemoryOwner == RUN_MEMORY_PATH &&
		runRouteCount >= 2U && runRouteCount <= PATH_ROUTE_MAX_POINTS &&
		routeCount == runRouteCount && routeSourceLog == runRouteSourceLog &&
		routeCache.source.number == (uint32_t)runRouteSourceLog &&
		pathComputeRouteGeometryCrc32() == runRouteGeometryCrc32;
}

/////////////////////////////////////////////////////////////////////
// モジュール名 pathRunRouteExportPoint
// 処理概要     停止後のログ出力用に実際の計画経路の点をコピーする
// 引数         index: 点番号、planned: 計画経路点の出力先[mm]
// 戻り値       true: コピー成功、false: 使用中または不正な経路・引数
/////////////////////////////////////////////////////////////////////
bool pathRunRouteExportPoint(uint16_t index, RoutePoint *planned)
{
	if (modeLOG || runMemoryOwner != RUN_MEMORY_PATH || routeCount != runRouteCount ||
		routeSourceLog != runRouteSourceLog || index >= runRouteCount ||
		planned == NULL) return false;
	*planned = driveRoute[index];
	return true;
}

/////////////////////////////////////////////////////////////////////
// モジュール名 writeShortcutSettings
// 処理概要     ショートカット設定を固定CSV形式でSDカードへ保存する
// 引数         なし
// 戻り値       なし
/////////////////////////////////////////////////////////////////////
void writeShortcutSettings(void)
{
	FIL file;
	if (f_open(&file, PATH_SETTING_FILE, FA_CREATE_ALWAYS | FA_WRITE) == FR_OK)
	{
		f_printf(&file, "%u,%03u,%03u,%04u,%04u,%03u,%04u",
			shortcutSettings.maxLevel, shortcutSettings.lookaheadBaseMm,
			shortcutSettings.lookaheadPerMpsMm, shortcutSettings.kLateral_x100,
			shortcutSettings.kHeading_x100, shortcutSettings.lineAlpha_x1000,
			shortcutSettings.lineThetaGain_x1e9);
		f_close(&file);
	}
}

/////////////////////////////////////////////////////////////////////
// モジュール名 readShortcutSettings
// 処理概要     ショートカット設定を部分反映し、不正時は修復する
// 引数         なし
// 戻り値       なし
/////////////////////////////////////////////////////////////////////
void readShortcutSettings(void)
{
	FIL file;
	char text[64] = {0};
	int values[7] = {PATH_DEFAULT_MAX_LEVEL, PATH_DEFAULT_LOOKAHEAD_BASE_MM,
		PATH_DEFAULT_LOOKAHEAD_PER_MPS_MM, PATH_DEFAULT_KLATERAL_X100,
		PATH_DEFAULT_KHEADING_X100, PATH_DEFAULT_LINE_ALPHA_X1000,
		PATH_DEFAULT_LINE_THETA_GAIN_X1E9};
	const int defaults[7] = {PATH_DEFAULT_MAX_LEVEL, PATH_DEFAULT_LOOKAHEAD_BASE_MM,
		PATH_DEFAULT_LOOKAHEAD_PER_MPS_MM, PATH_DEFAULT_KLATERAL_X100,
		PATH_DEFAULT_KHEADING_X100, PATH_DEFAULT_LINE_ALPHA_X1000,
		PATH_DEFAULT_LINE_THETA_GAIN_X1E9};
	const int minimums[7] = {0, PATH_LOOKAHEAD_BASE_MIN_MM, 0, 0, 0, 0, 0};
	const int maximums[7] = {PATH_LEVEL_MAX, PATH_LOOKAHEAD_BASE_MAX_MM,
		PATH_LOOKAHEAD_SPEED_MAX_MM, PATH_KLATERAL_MAX_X100,
		PATH_KHEADING_MAX_X100, PATH_LINE_ALPHA_MAX_X1000,
		PATH_LINE_THETA_GAIN_MAX_X1E9};
	shortcutSettings = (ShortcutSettings){PATH_DEFAULT_MAX_LEVEL,
		PATH_DEFAULT_LOOKAHEAD_BASE_MM, PATH_DEFAULT_LOOKAHEAD_PER_MPS_MM,
		PATH_DEFAULT_KLATERAL_X100, PATH_DEFAULT_KHEADING_X100,
		PATH_DEFAULT_LINE_ALPHA_X1000, PATH_DEFAULT_LINE_THETA_GAIN_X1E9};
	bool repair = false;
	int parsed = 0;
	if (f_open(&file, PATH_SETTING_FILE, FA_OPEN_EXISTING | FA_READ) == FR_OK)
	{
		if (f_gets(text, sizeof(text), &file) != NULL)
		{
			parsed = sscanf(text, "%d,%d,%d,%d,%d,%d,%d", &values[0], &values[1], &values[2],
				&values[3], &values[4], &values[5], &values[6]);
		}
		else repair = true;
		f_close(&file);
	}
	else repair = true;

	bool present[7];
	for (uint8_t i = 0U; i < 7U; i++) present[i] = (int)i < parsed;
	repair = sdRepairSparseSettings(values, present, defaults,
		minimums, maximums, 7U) || repair;
	shortcutSettings.maxLevel = (uint8_t)values[0];
	shortcutSettings.lookaheadBaseMm = (uint16_t)values[1];
	shortcutSettings.lookaheadPerMpsMm = (uint16_t)values[2];
	shortcutSettings.kLateral_x100 = (uint16_t)values[3];
	shortcutSettings.kHeading_x100 = (uint16_t)values[4];
	shortcutSettings.lineAlpha_x1000 = (uint16_t)values[5];
	shortcutSettings.lineThetaGain_x1e9 = (uint16_t)values[6];
	if (repair) writeShortcutSettings();
}
