Kageyana/robotrace_v2/robotrace_v2/Core/Inc/log_schema.h

#ifndef LOG_SCHEMA_H_
#define LOG_SCHEMA_H_
//====================================//
// インクルード
//====================================//
#include <stdint.h>
#include "slipDetection.h"
#include "SDcard.h"
#include "battery.h"
#include "motor.h"
#include "pathFollower.h"
//====================================//
// シンボル定義
//====================================//
// CSV列の定義を順番どおりに集中管理。
// STOREDはバイナリに保存、DERIVEDはCSV変換時に計算。RLOG v2の列定義もここから生成する。
// 通常は軽量プロファイルで走行比較に必要な列だけを残す。
// 詳細デバッグ列が必要な場合は、ビルド定義でLOG_SCHEMA_PROFILE_LIGHT=0にする。
// STORED(type, name, fmt, expr) or DERIVED(type, name, fmt, expr)
#ifndef LOG_SCHEMA_PROFILE_LIGHT
#define LOG_SCHEMA_PROFILE_LIGHT 1
#endif

#define LOG_FIELD_LIST_CORE(STORED, DERIVED) \
	STORED(U16, cntlog, "%d", (uint16_t)cntRun) \
	STORED(U16, encCurrentN, "%d", (uint16_t)encCurrentN) \
	STORED(S16, encCurrentL, "%d", encCurrentL) \
	STORED(S16, encCurrentR, "%d", encCurrentR) \
	STORED(S32, encTotalL, "%ld", (int32_t)encTotalL) \
	STORED(S32, encTotalR, "%ld", (int32_t)encTotalR) \
	STORED(F32, gyroVal_Z, "%f", imuVal.gyro.z) \
	STORED(F32, acceleVal_X, "%f", imuVal.accele.x) \
	STORED(F32, acceleVal_Y, "%f", imuVal.accele.y) \
	STORED(F32, acceleVal_Z, "%f", imuVal.accele.z) \
	STORED(U8, courseMarker, "%d", courseMarkerLog) \
	STORED(U32, encTotalOptimal, "%d", (uint32_t)encTotalOptimal) \
	DERIVED(F32, ROC, "%f", log_roc) \
	STORED(U16, targetSpeed, "%d", targetSpeed) \
	STORED(U16, optimalIndex, "%d", (uint16_t)optimalIndex) \
	STORED(S16, lineTraceCtrl, "%d", (int16_t)lineTraceOmegaFBCtrl.pwm) \
	STORED(S16, targetAngularvelo, "%d", (int16_t)log_targetAngularVelocity) \
	STORED(U16, batteryVoltage_mV, "%d", (uint16_t)(batteryVoltage_V * 1000.0f)) \
	STORED(S16, motorVoltageCmdL_mV, "%d", (int16_t)(motorVoltageCmdL_V * 1000.0f)) \
	STORED(S16, motorVoltageCmdR_mV, "%d", (int16_t)(motorVoltageCmdR_V * 1000.0f)) \
	STORED(U32, encCurrentCorr_p, "%d", (uint32_t)Control_GetEncCurrentCorr_p()) \
	STORED(U16, lSensorCari0, "%d", lSensorCari[0]) \
	STORED(U16, lSensorCari1, "%d", lSensorCari[1]) \
	STORED(U16, lSensorCari2, "%d", lSensorCari[2]) \
	STORED(U16, lSensorCari3, "%d", lSensorCari[3]) \
	STORED(U16, lSensorCari4, "%d", lSensorCari[4]) \
	STORED(U16, lSensorCari5, "%d", lSensorCari[5]) \
	STORED(U16, lSensorCari6, "%d", lSensorCari[6]) \
	STORED(U16, lSensorCari7, "%d", lSensorCari[7]) \
	STORED(U16, lSensorCari8, "%d", lSensorCari[8]) \
	STORED(U16, lSensorCari9, "%d", lSensorCari[9]) \
	DERIVED(F32, x, "%f", log_x) \
	DERIVED(F32, y, "%f", log_y)

#define LOG_FIELD_LIST_DEBUG(STORED, DERIVED) \
	STORED(U8, markerSensor, "%d", (uint8_t)markerSensor) \
	STORED(U8, sgMarkerCount, "%d", (uint8_t)SGmarker) \
	STORED(U32, encRightMarker_p, "%d", (uint32_t)encRightMarker) \
	STORED(U8, patternTrace, "%d", (uint8_t)patternTrace) \
	STORED(F32, motorCurrentL, "%f", motorCurrentL) \
	STORED(F32, motorCurrentR, "%f", motorCurrentR) \
	STORED(U8, straightPendingAttempt, "%d", (uint8_t)straightMarkerPendingLog) \
	STORED(U8, lineTraceOmegaFBCtrlkp, "%d", (uint8_t)lineTraceOmegaFBCtrl.kp)
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
