Kageyana/robotrace_v2/(commit log)

2023-08-02 reRo杯で走らなかった
2023-08-02 電子回路図を追加
    [BOM-robotrace_v2_Extended_UI.csv, BOM-robotrace_v2_Linesensor.csv, BOM-robotrace_v2_Sidemarker.csv, BOM-robotrace_v2_main.csv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]
2023-08-10 ラインセンサ以外のAD変換もDMA送信するようにした
2023-08-13 ゴールマーカー検出方法を変更（reRoコースを完走した）
2023-08-13 gitignore更新
2023-08-14 キャリブレーション時の旋回動作成功 バッテリ電圧計測にヒステリシスをもたせた モータ電流値を[A]で表示させた
2023-08-16 ゲイン調整画面を見やすくなるように改良
2023-08-19 ログの保存を走行終了後に一括で行うようにした
2023-08-19 ログファイルが作成されない問題を修正した
2023-09-01 セットアップ画面でログの解析ができるようにした
2023-09-02 リセット時にmicroSDが読み込めない問題を修正
2023-09-08 ディスプレイなしで1次、2次走行できるようにした
2023-09-09 2次走行解析できた(同じログ番号でも結果が変わる時がある) 例外処理時にディスプレイ表示するようにした
2023-09-10 2023草の根大会最終
2023-09-23 コース解析時のフリーズを修正
2023-09-24 2023北陸信越大会 1次、2次走行を完走した
2023-09-27 BMI088の加速度センサを使用できるようになった
2023-10-01 角速度のキャリブレーション関数を追加(動作した)
2023-10-01 不要コメントアウト削除
2023-10-01 ラインセンサのキャリブレーション挙動を変更 首振り→1回転
2023-10-01 スタートマーカー検出時に角度リセットするようにした
2023-11-01 コース解析が失敗する問題を修正 IMUとSPIを共有しているため競合していた
2023-11-01 ディレクトリ作成関数を追加 相対パス指定に変更
2023-11-18 5msごとに座標計算しながら2次走行できた
2023-11-29 軌道追従しているような動きをした
2023-12-01 走行ログの内容をショートカット用に変更
2023-12-02 ゲインの記録機能追加 ログ選択画面の選択できないログ番号がある問題を修正
2023-12-02 ショートカット走行できた
2023-12-06 走行中にログの保存ができた
2023-12-08 ログを走行終了後にSDカードに書き込むようにした(走行中書き込みは難しい) IMUから取得する角速度をyaw軸のみにした
2023-12-08 不要コード削除 手動キャリブレーション追加
2023-12-09 ラインセンサオフセット値をSDカードに保存、読み出しできるようにした
2023-12-09 一定距離ごとにログ取るようにした
2023-12-09 コース解析ができない問題を修正 配列の要素数を超えていた
2023-12-09 左ホイールをロータリスイッチの代替として使用できるようにした
2023-12-16 目標速度をSDカードに記録するようにした 目標速度の2倍の速度のとき緊急停止するようにした
2023-12-17 ログを走行中SDカードにバイナリ保存できるようにした
2023-12-17 走行後にログバイナリデータをテキストCSVファイルに変換して保存するようにした
2024-01-03 駆動モータの電流を計測するようにした
2024-01-04 PWMをログに追加 ログの構成をマクロ変数で変えられるようにした
2024-01-04 バッテリ残量の表示バグを修正
2024-01-04 インデントをスペースからタブに変更
2024-01-06 ホイールクリックの挙動を修正
2024-02-10 ログがRAM保存式の時正常に記録されない問題を修正
2024-02-11 クロスラインの位置を記録するようにした
2024-02-11 トレース時、制御量が1000を超える場合、内輪の制御量を減らす処理を復活
2024-02-11 2次走行できるようになった(距離補正あり)
2024-02-12 距離補正の基準をクロスラインの位置のみにした
2024-02-12 距離補正処理を修正（4回連続2次走行完走）
2024-02-12 IMUのキャリブレーション時間を変更
2024-02-16 オートスタートできた
2024-02-17 直線後のカーブマーカーを距離補正に使用する
2024-02-17 ラインセンサ要因の緊急停止追加 隠し目標速度を調整できるようにした 距離補正のマーカー探しを変更
2024-02-18 スタートマーカーのみ検知方法を変更（判定距離短くした）
2024-02-19 曲率1000,1300時のパラメータを追加 マイクロマウス2023で1次、2次走行を完走
2024-07-03 ショートカットテスト
2024-07-03 v25からコード移植 エラー排除
2024-07-04 LEDをフルカラーに色を変えることができた
2024-07-06 led_outを追加
2024-07-06 コード整形
2024-07-07 ラインセンサ動作確認
2024-07-07 エンコーダが動いた
2024-07-07 駆動モータ動いた
2024-07-07 吸引モータ動いた
2024-07-07 メインボード上のスイッチが動いた
2024-07-07 マーカーセンサ動いた
2024-07-09 OLEDディスプレイ、5方向タクトスイッチ、電源電圧読み取り、IMUが動いた
2024-07-10 角速度を1msごとに取得
2024-07-13 SDスイッチが動いた
2024-07-13 モータテスト後にページが移動する問題を修正 初期化の成否を表示するようにした
2024-07-14 モータ電流計測式修正
2024-07-14 AD値、エンコーダ値の取得をcontrolに集約(ライブリの依存関係を減らすため)
2024-07-14 前回コミットの動作確認
2024-07-14 起動時の画面挙動を変更 要素ごとに表示、LED点灯するように変更
2024-07-14 RGBLEDの点灯テストを追加
2024-07-15 ベンチマークコースを1周した
2024-07-27 走行中ログ書き込みを試してみた
2024-07-29 走行中ログ書き込みの負荷を減らそうとした(できなかった)
2024-08-04 ログの保存を浮動小数点でできるようにした(文字列に変換してから保存)
2024-08-04 ログ解析を浮動小数点ログに対応させた
2024-08-07 sdカード未挿入の警告を追加
2024-08-31 logの選択方法を改変中
2024-09-22 ログ選択のコードを簡略化
2024-09-23 ログ選択の操作性を向上
2024-09-28 ショートカット走行処理修正(走らない)
2024-09-29 2024北陸信越大会で完走した
2025-08-27 SDカードの通信をDMA化(DAM有効のみ)
2025-08-30 docs: add api comments for dma helpers
2025-08-30 vscode設定を変更
2025-08-30 fix: use tabs for logging buffer code
    [SDcard.c]
2025-08-30 setup_sensorsでbeforeHEXを利用可能に
2025-08-30 エラー修正
2025-08-30 Fix PID trace setup indentation
    [setup.c]
2025-08-30 fix: リングバッファ処理のインデントとコメントを整理
2025-08-30 docs: add comments to speed PID setup
2025-08-30 インデント調整
2025-08-30 setup_pid_angularの宣言整理とコメント追加
2025-08-30 setup_pid_angleのゲイン表示コメント追加
2025-08-30 Add comment for distance PID initialization
2025-08-30 Make setup_speed_param static and fix indentation
    [setup.c]
2025-08-30 refactor: comment calibration setup
2025-08-30 setup_startのコメント追加とインデント修正
2025-08-30 ログバッファ制御のコメント追記
2025-08-30 readLogDistanceの曲率判定を修正
2025-08-30 Avoid HAL_Delay in log buffer wait
    [SDcard.c]
2025-08-30 sensorTestTable から説明文字列を削除
2025-08-30 Handle f_readdir errors in createLog
    [SDcard.c]
2025-08-30 Add comments for sortROC allocation failure
    [courseAnalysis.c]
2025-08-30 fix: reset ring buffer accumulators
    [courseAnalysis.c]
2025-08-30 Document ring buffer accumulator reset
    [courseAnalysis.c]
2025-08-30 不要なコメントを削除
2025-08-30 SDカード送信処理にコメントを追加し.cproject変更を取り消し
2025-08-30 ビルド最適化をO→O2に変更
2025-08-30 readLogDistanceのコメントを整理
2025-08-30 コメント修正
2025-08-30 fix: setLogStrのバッファ型を修正
2025-08-30 createDirでディレクトリを閉じる処理を追加
2025-08-31 誤記修正
2025-08-31 writeLogPutsのエラー処理からprintfを削除
2025-08-31 SDtest関数にSPI待ちのタイムアウト処理を追加
2025-08-31 インデントの変更は不要です調整
2025-08-31 Fix typo in SD card buffer macros
    [SDcard.c, SDcard.h]
2025-08-31 fix: correct f_read pointer usage
    [SDcard.c]
2025-08-31 createLogのエラー出力にprintfを使用しないよう修正
2025-08-31 センサテスト列挙体周りのコメントを補足
2025-08-31 style: fix sensor test helper indentation
    [setup.c]
2025-08-31 エラー修正、インデント調整
2025-08-31 Add short HAL_Delay when waiting for log buffer
    [SDcard.c]
2025-08-31 速度パラメータ処理を構造体とループに置換
2025-08-31 Handle f_getfree failure in SD card init
    [SDcard.c]
2025-08-31 SDカード書き込み処理のエラーチェック追加
2025-08-31 Log SD open errors in initLog
    [SDcard.c]
2025-08-31 Handle f_readdir errors in getFileNumbers
    [SDcard.c, SDcard.h]
2025-08-31 構造体によるタイマ・フラグ整理
2025-08-31 writeLogBufferPutsにコメントを追加
2025-08-31 writeLogPutsで書き込みサイズ検証を追加
2025-08-31 一時ファイルの書き込みエラーでログファイルが生成されない問題を修正
2025-08-31 sendSD を volatile 指定し割込み共有コメントを追加
2025-08-31 ログバッファを2個構成に戻しリングバッファ化を取り消し
2025-08-31 インデント、コメント修正
2025-08-31 fix: run log write task only while running
    [control.c, timer.c, timer.h]
2025-08-31 ポインタ直接書き込み処理にコメントを追加
2025-09-01 Document accelerometer correction steps
    [BMI088.c, timer.c]
2025-09-02 RX671のコードと統一
2025-09-05 RX671とコード統一 SPI速度を落として安定性向上
2025-09-05 I2CのDMAを有効化
2025-09-05 Move I2C DMA completion callback to main
2025-09-06 I2CのDMAをCircularモードにした
2025-09-06 ssd1306がDMA転送で動いた
2025-09-06 初期化関数中のディスプレイ更新を1回にした
2025-09-06 DMA完了待ち前にフラグをリセット
2025-09-06 不要な処理を削除
2025-09-06 走行中はDMAによる画面更新を停止
2025-09-06 停止処理のcaseを分けて可読性向上
2025-09-06 表示バグを修正
2025-09-06 モーターPWMの飽和防止処理を追加
2025-09-06 PWM 0時の出力停止コメントを追加
2025-09-06 motorPwmOutSynthのコメントにyrPwmとdPwmの説明を追加
2025-09-06 tPwm 0 条件分岐にコメント追加
2025-09-06 MOTOR_AD_WINDOWのチェックにコメント追加
2025-09-07 motorpwmをログに追加 エンコーダカウントの割り込み時間判定を無効化
2025-09-07 ソフトウェアリセットを実装 ログファイルが生成されない
2025-09-07 5msエンコーダ累積処理の追加
2025-09-07 ソフトウェアリセット時にファイルナンバーが更新されない問題を修正
2025-09-07 ソフトウェアリセット時にディスプレイが更新されない問題を修正
2025-09-07 getFileNumbersのファイル番号を昇順ソート
2025-09-07 ログ/プロットファイルのエラーコードを個別化
2025-09-07 ショートカット座標バッファ上限超過時にエラー番号-7を設定
2025-09-07 calcXYciesのコメントを既存スタイルに合わせて修正
2025-09-07 不要なコメントの削除
2025-09-07 calcXYciesのエラー処理を修正
2025-09-07 getFileNumbersで重複番号を排除
2025-09-07 getFileNumbersで番号を重複なく昇順に格納
2025-09-07 getFileNumbersでファイル番号を昇順にソート
2025-09-07 パス名をダブルクォーテーション二変更
2025-09-07 ショートカット計算時の距離計算バグを修正
2025-09-07 ショートカット軌跡生成不良を修正
2025-09-07 V1基板で使用していたSPI競合を避けるためのフラグを削除
2025-09-07 加速度センサの使用をマクロでせて治できるようにした IMUの取得周期を1kHzにした
2025-09-07 コースマーカー処理の関数化
2025-09-07 エラー時はログ番号保存とフラグ設定をスキップ
2025-09-07 プロット解析処理の条件分岐を削除
2025-09-13 processMarkerEventの処理高速化
2025-09-13 ログデータ減らした
2025-09-13 ラインセンサのキャリブレーション機能を強化
2025-09-14 マーカー通過時に距離補正が働かない問題を修正
2025-09-14 途中でゴール判定になる問題を修正
2025-09-14 tPwmが負のとき制御量が増大ズル問題を修正
2025-09-15 vscode extensionver2.0に対応
2025-09-15 c intelisenseのエラー警告を解除
2025-09-15 vscodeのtaskでビルド＋書き込みをできるようにした
2025-09-15 user_diskio.cにSDカードの処理追加(上書きされた処理を戻した)
2025-09-16 左エンコーダのパルス数を右エンコーダに合わせた
2025-09-16 ホイールクリックのカウント数をマクロ化
2025-09-16 角速度のゲインを調整
2025-09-16 センサ重み付け設定をマクロ化
2025-09-16 calcROCの角度換算係数を定数化
2025-09-16 calcROCの絶対値計算を符号判定に変更
2025-09-16 不要な処理を移動
2025-09-17 writeLogBufferPutsのバッファ切替を事前判定
2025-09-18 SD書き込み処理のDMA完了待ち改善
2025-09-20 センサの重みを変更
2025-09-20 CSピンの出力速度をvery Highに設定
2025-09-21 FATFSの低レイヤーライブラリをDMA対応に変更
2025-09-21 cntSendのリセット処理を追加
2025-09-21 fix: SD書き込み中のログバッファ保護
2025-09-21 endLogの無限ループ防止対応
2025-09-22 走行後に一時ファイルを削除するように変更
2025-09-22 IMUのSPI通信速度を22.5MBits/sに変更した
2025-09-22 DMAの割り込み優先度を変更
2025-09-23 CubeIDEでデバックできるようにした CubeMXのiocファイルをインポートした
2025-09-23 緊急停止カウントの初期化関数追加 走行終了後のログ処理をフラグが立っているときだけ処理にした ログファイル名生成を簡略化
2025-09-23 オートスタートで使用するログ番号を変数化
2025-09-23 コース解析時のprintfを停止
2025-09-23 距離解析の件数と境界調整
2025-09-23 ログ解析エラー処理の改善
2025-09-23 readLogDistance の中央値算出処理を最適化
2025-09-23 scanfでfloatを使えるようにした コース解析が復活した
2025-09-23 ショートカット走行時はラインセンサによる緊急停止を無効化
2025-09-24 エンコーダのパルス数を修正
2025-09-24 printf/scanfのfloat対応をREADMEに追記
2025-09-28 スタートゴールマーカーの検出処理の可読性向上
2025-09-28 ログに保存されるマーカーの読み飛ばし防止追加
2025-09-29 クラスラインのご検出処理修正
2025-09-29 マーカー検出距離を修正
2025-09-29 重複していた処理を削除 距離補正をマーカー通過時からマーカー検出時に変更
2025-09-29 LOG_RUNNING_WRITEが有効のとき不要な処理をプリプロセッサで除外
2025-10-01 ベンチマークコースで周回回数を増やす
2025-10-04 距離補正処理をROC基準に戻した
2025-10-04 コメントの追加とインデント修正
2025-10-04 DEBUG_CORRの削除
2025-10-04 タイヤをLMワイドに変更したためPALSE_METER更新 ラインセンサの重み付けを変更
2025-10-04 バッテリ電圧を算出できるようにした
2025-10-05 速度フィードフォワード係数の設定機能を拡張
2025-10-05 表示を修正
2025-10-05 DWT初期化後のバッテリ電圧を共有
2025-10-05 目標速度変更時のみフィードフォワード計算を更新
2025-10-05 目標速度変更時のフィードフォワード更新を調整
2025-10-05 フィードフォワード再計算の条件整理
2025-10-05 コメント整理
2025-10-16 vscode拡張機能をアップデート
2025-10-27 光変調を実装
2025-10-27 2次走行持のスタート直後に目標速度が下がる現象を修正
2025-10-28 クロスライン通過時のPID制御安定化
2025-10-29 クロスライン判定の精度向上
2025-10-29 クロスライン保持ロジックのヒステリシス対応
2025-10-29 閾値調整
2025-10-31 クロスライン通過処理を打ち消し
2025-10-31 緊急停止()ラインセンサ)を有効化
2025-11-02 vscode拡張機能アップデート
2025-11-03 緊急停止条件を修正
2025-11-05 AD変換遅延処理が正しい秒数で遅延しない問題を修正
2025-11-07 PID制御の安定性向上 光変調高速化
2025-11-07 機体3Dモデルを追加
    [robotrace_v2 v86.step]
2025-11-08 マーカーセンサの光変調実装
2025-11-08 光変調周波数10kHz
2025-11-09 光変調周波数5kHz
2025-11-09 光変調周波数2kHz
2025-11-09 マーカーセンサがオフにならない問題を修正
2025-11-10 ライントレース制御に角速度FBを追加
2025-11-11 ソフトウェアリセット時にログが保存できない問題を修正
2025-11-15 ソフトウェアリセット後にマーカーを検知できない区間がある問題を修正
2025-11-15 PIDゲイン初期値を現状のゲインに変更
2025-11-15 オートスタートの2走目移行にマーカーが読めない問題を修正
2025-11-22 不要処理を停止するようにした
2025-11-22 1次走行用のゲインを用意
2025-11-22 ゲイン修正
2025-11-23 クロスライン通過時にPゲインを下げて機体がブレないようにした
2025-11-24 ログに電流値を追加
2025-11-24 クロスライン通過時のゲインを変更
2025-11-24 ログが400個以上でソフトウェアリセットが機能しなくなる問題を解決
2025-11-24 ログファイルが300以上のときファイル数過多の警告を出すようにした
2025-11-24 不要変数、警告を削減のため型変更
2025-12-05 回路図を最新版に更新
    [BOM-robotrace_v2_Extended_UI.csv, BOM-robotrace_v2_Linesensor.csv, BOM-robotrace_v2_Sidemarker.csv, BOM-robotrace_v2_main.csv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]
2025-12-05 回路図pdf更新
    [linesensor.dxf]
2025-12-05 加速度センサを有効化 SPI通信速度を11.25MBits/sに制限
2025-12-06 X,Y加速度をログに保存するようにした
2025-12-06 BMI088の加速度キャリブレーションを追加
2025-12-07 速度計算関数追加
2025-12-07 重力基準を保持する加速度キャリブレーション修正
2025-12-07 Fix calibrationIMU closing brace
    [BMI088.c]
2025-12-12 スリップ検出機能の追加と関連パラメータの定義を行い、ログ出力にスリップ情報を追加
2025-12-13 1次走行のゲインを修正
2025-12-13 スリップ検出に使う加速度をyaw軸角速度で補正した
2025-12-14 ライン追跡制御から角速度成分を除外
2025-12-14 クロスライン距離の定義を変更し、SDカードのログ出力を更新。緊急停止条件を調整し、タイマーのログ出力を改善。角速度FBライントレースの目標値を現在値とスケールを合わせた
2025-12-14 SDカードのログ出力を更新し、角速度制御のパラメータを調整。クロスライン検出の状態管理を改善。
2025-12-15 SDカードのログ出力のバッファサイズを更新し、緊急停止条件を改善。ラインセンサの状態管理を強化。
2025-12-17 マーカー処理状態をクリアする関数を追加。緊急停止条件のラインセンサーのカウントを明確に分け、関連する変数名を更新。
2025-12-18 ログ出力の加速度パラメータを更新し、スリップ検出のサンプリングウィンドウを短縮。IMU初期化状態に基づくスリップ検出の条件を改善。
2025-12-20 SDカードのログ出力設定を更新し、センサ値のログ出力を整理。マーカーセンサ処理状態をクリアする関数を追加し、緊急停止フラグの管理を改善。
2025-12-20 ログヘッダーに新しい関数を追加し、制御パラメータを記録する機能を強化
2025-12-21 ヘッダにパラメータ追加
2025-12-24 ログヘッダーに制御パラメータを追加し、フォーマットを修正
2025-12-24 緊急停止処理を改善し、機体停止時の速度制御を追加
2025-12-24 クロスライン検出機能を追加し、関連する定義を整理。緊急停止処理におけるクロスライン状態の管理を改善。
2025-12-25 速度パラメータを調整し、クロスライン検出状態の変数名を変更。
2025-12-27 ログ用の速度制御iP成分とフィードフォワード成分を追加し、SDカードのログ出力を更新。PWM制限を1000に修正。
2025-12-27 ライントレース制御正規化の変更を取り消し
2025-12-28 左右モーターの独立制御を追加し、速度制御ゲインを同期。ターゲット速度に基づくPWM出力を調整。
2025-12-29 制御ループ内のコメントアウトされたコードを整理し、モーター出力の呼び出しを修正。タイマー割り込みでのモーター制御速度の更新を追加。
2025-12-29 ログ用の速度制御iP成分とフィードフォワード成分を削除し、SDカードのログ出力を更新。ライン制御と速度制御の処理を整理。直線時にゲインを下げるようにした
2025-12-29 速度計画ログ出力のフラグを追加し、SDカードへの記録処理を条件付きで実行するように修正
2025-12-29 速度パラメータの変更、ROCに基づくゲイン切り替えの実装、SDカードログ出力の更新
2025-12-29 SDカードログ出力の構成を修正し、加速度値を追加。タイマー割り込みでのログ出力を更新。
2025-12-30 スリップ検出パラメータを更新し、IMUおよびエンコーダの加速度処理を改善。ログ出力にターゲット速度を追加。
2025-12-30 スリップ検出の閾値を追加し、関連するログ出力を更新。SDカードのログサイズを調整し、FATFSのexFATサポートを有効化。
2025-12-30 一時ファイル終了処理を追加し、スリップ指標のLPF係数を変更。ログ保存処理を改善し、FATFSのロック設定を更新。
2026-01-02 スリップ検出の閾値を更新し、ログ出力の浮動小数点数の数を減少。SDカードへのログ出力処理を改善。
2026-01-02 Add lateral slip detection and logging
    [SDcard.c, SDcard.h, control.c, control.h, timer.c]
2026-01-02 Separate longitudinal and lateral slip metrics
    [SDcard.c, control.c, timer.c]
2026-01-02 Adjust slip low-accel gating and logging
    [control.c]
2026-01-04 関数名をcheckROCからchangeGainに変更し、ROCに応じたゲイン切り替え処理を明確化
2026-01-04 SDカードログの設定を更新し、lineTraceCtrl.kpのログを追加
2026-01-04 ソフトリセットの再実行に対応
2026-01-04 Fix reset gain state in PID control
    [PIDcontrol.c]
2026-01-05 Interrupt1ms関数内のupdateSlipDetection呼び出しを重複削除
2026-01-07 SDカードおよびバッテリー管理のロギング機能を改善し、ADC設定を更新 ADCの基準電圧をVrefintから取得
2026-01-08 モーター電流センサのキャリブレーション機能を追加し、ADCサンプリング時間を短縮
2026-01-08 MOTOR_AD_WINDOWの値を64から32に変更し、モーター電流の移動平均計算を最適化
2026-01-10 スリップ検出機能にモータ電流によるノイズ補正を追加し、関連する定数を定義。motor.cのデータ型を修正。
2026-01-10 横スリップ検出の惰性ゲート追加
2026-01-11 横スリップ検出の初期化と電流LPF整理
2026-01-11 PWM LPF定数追加と重複include修正
2026-01-11 電流LPF係数と補正ゲインの値を調整し、閾値スケール上限を更新
2026-01-11 スリップ検出の電流条件付き整理
2026-01-11 横スリップゲートの分岐整理
2026-01-11 ヒステリシス更新のカウンタ初期化
2026-01-12 距離補正スケールとログを追加
2026-01-12 距離補正を常時有効にする
2026-01-12 BMI088.hのCOEFF_DPDを-0.996Fに修正し、SDcard.cのログヘッダーのサイズを2048に増加、control.cのスリップ距離補正パラメータを微調整、setup.cの加速度パラメータの最大値を20.0に変更
2026-01-13 1msカウンタ更新の条件整理
2026-01-14 スタートリセット完了待ち制御
2026-01-14 パルス補正ログ列を追加
2026-01-14 スタートリセットACK待ち追加
2026-01-14 距離ログのパルス版整理
2026-01-15 スタートリセットACKとログ引数整合
2026-01-15 ログ列名と型整合を修正
2026-01-17 スタート通過時リセットを割り込みで実施
2026-01-17 スタートリセット要求APIを削除
2026-01-17 スタート通過時にカウンタ初期化
2026-01-17 マーカー補正のパルス同期を追加
2026-01-17 スリップ距離補正パラメータを追加し、関連する未使用の変数を削除
2026-01-17 スリップ検出の閾値管理を整理
2026-01-17 スリップ距離補正パラメータの追加と関連する変数の整理、ログ出力の修正
2026-01-17 スリップ検出パラメータの調整と関連する関数の修正
2026-01-17 横滑り判定の早期化対応
2026-01-17 横滑り判定の電流ゲート追加
2026-01-17 横滑りON判定の瞬時電流ゲート化
2026-01-17 横滑りON判定の瞬時ゲート整理
2026-01-17 横滑りON判定の連続電流ゲート追加
2026-01-18 横滑りON判定の瞬時電流和の下限を0.25Aから0.50Aに変更し、スリップ距離補正処理のIRQ管理を削除
2026-01-18 緊急停止処理のモータ停止タイミングを変更
2026-01-18 スリップ距離補正機能の強化とエンコーダ補正の追加 - LOG_NUM_32BITを4から5に変更 - スリップ距離補正パラメータの調整 - calcXYcie関数の引数を変更 - 補正後の現在速度を管理するencCurrentCorr_pを追加 - ログ出力にencCurrentCorr_pを追加
2026-01-18 パラメータ変更して誤検知現減少
2026-01-21 Use encPulse for slip distance
    [control.c, courseAnalysis.c, courseAnalysis.h, encoder.c, encoder.h]
2026-01-21 Fix speed units in slip analysis
    [courseAnalysis.c]
2026-01-21 スリップ解析の速度単位を修正
2026-01-22 ログ作成時の一覧更新を追加
2026-01-24 ログ保存後の自動解析更新を安全化
2026-01-24 ログ保存成否判定の条件を修正
2026-01-24 パラメータ更新
2026-01-24 スタートマーカー検出のロジックを改善
2026-01-24 パラメータ修正
2026-01-24 ログ記録のスキーマを導入し、ログバッファの書き込み処理を簡素化
2026-01-24 ログの順番を変更
2026-01-25 ゴールマーカーの読み取り回数を3から5に変更し、速度計画ログの書き出し機能を追加
2026-01-25 SD読み取りのデバッグ情報を追加し、ログ記録処理を改善
2026-01-26 問題は解決していません。 SDカード関連の機能を強化し、ロック機能を追加。セクター数取得機能を実装し、エラーハンドリングを改善。
2026-01-30 fix: ?????SD????I/O????
    - ????????????????
    - readLogDistance/Slip???????1????????
    - FatFs????try_lock??IRQ???
    - CSD???????????????
    - CTRL_SYNC?SD_Sync???
    - ????????????????????1??
    - SD SPI?????ready??/??/????????
    [SDcard.c, SDcard.h, courseAnalysis.c, sd_diskio_spi.c, sd_functions.c, sd_functions.h, sd_spi.c, sd_spi.h]
2026-01-30 ログを走行中書き込み専用に統一
    - LOG_RUNNING_WRITE の条件分岐を撤去
    - 走行中書き込みの経路に整理
    - 未定義時の処理を削除
2026-01-31 feat: SDカードのログバッファ管理を改善し、フラッシュ処理を追加
2026-01-31 fix: ゴールマーカーの読み取り回数を2回に変更し、移動距離計算関数を追加
2026-01-31 fix: calcDlMm関数を速度と経過時間に基づいて移動距離を算出するように修正し、ROCの閾値を更新
2026-02-01 fix: ゴールマーカーの読み取り回数を5回に変更し、ラインセンサの外れ判定を150に更新 feat: 直線判定の状態を管理するための変数を追加し、関連するロジックを実装
    [control.h, courseAnalysis.c, courseAnalysis.h, emergencyStop.h, log_schema.h, timer.c]
2026-02-04 fix: ゴールマーカーの読み取り回数を3回に変更し、スリップ解析の閾値を更新
2026-02-06 feat: ログ番号管理機能を追加し、保存済みログ番号の読み書きを実装 一定数でログを削除する機能を追加
2026-02-11 SDカードの安定性向上
2026-02-11 fix: ゴールマーカーの読み取り回数を2回に変更し、曲率半径計算用変数を追加
2026-02-14 fix: 曲率半径の閾値を800mmに変更し、マーカー探索幅を拡大
2026-02-15 先行減速距離のパラメータを追加し、関連する関数を実装
2026-02-15 ゲイン変更関連のパラメータを追加し、直線判定の閾値を修正 直線、カーブのゲイン切り替え処理を距離で判定するように変更
2026-02-15 fix: PID制御用ゲインとセンサ重み係数の調整、カーブ用ゲインの条件を変更
2026-02-15 曲率半径の閾値を統一し、ゲイン変更処理を改善
2026-02-17 距離補正関連の定数をヘッダに移動、エンコーダのカウント取得処理を整理
2026-02-18 ゲイン変更関連のパラメータを追加し、カーブ進入と復帰判定の処理を改善
2026-02-21 ゴールマーカーの読み取り回数を変更し、カーブおよび直線用ゲイン切替えの閾値を調整
2026-02-23 カウントダウン時間を5000から2000に変更
2026-03-07 BMI088valからimuValへのIMU変数使用の再構成
    - emergencyStop.c内のジャイロ値参照を更新し、imuValを使用するように変更。
    - setup.c内の角度および加速度参照をBMI088valからimuValに変更。
    - timer.c内の温度割り当てを調整し、BMI088val.tempをimuVal.tempに格納するように変更。
2026-03-14 IMU関連の定数と関数を移動し、旋回中心補正機能を実装
2026-03-21 スリップ検出機能の改善とログ出力の拡張 - スリップ判定の有効条件とカウント許可条件を追加 - スリップ関連の新しいデータをログに記録 - スリップ判定の初期化処理を修正
    [SDcard.c, control.c, control.h, log_schema.h]
2026-06-28 .gitignoreにanaliysisディレクトリを追加し、PIDcontrol.hのホイール径を24.0fから23.5fに修正、SDcard.cにautoStartとemcStopのログ出力を追加、timer.cのタイマー割り込みの概要を更新
2026-06-28 コミットメッセージ方針を追記
2026-06-28 未実装タスクのログ情報と設定修復を実装
2026-06-28 バッテリ電圧の異常値を修正
2026-08-09 モータ出力を電圧指令化
2026-08-19 採用済み制御と2次ログ解析をmainへ反映
2026-08-19 回路データとSTEPを更新
    [robotrace_v2_Extended_UI.step, robotrace_v2_Linesensor.step, robotrace_v2_main_v2.kicad_pcb, robotrace_v2_main_v2.kicad_sch, robotrace_v2_main_v2.step]
2026-08-22 robotrace_v2 の実装履歴を追加
    - AGENTS.md から移行した実装履歴を記録するための新しい Markdown ファイルを作成しました。
    - 2026年6月28日から2026年8月16日までの間に実施された、PID パラメータの調整、ロギングの改善、速度制御戦略の変更など、さまざまな変更点を記録しました。
    - 主な変更点としては、識別子の正規化、追加のログヘッダーの出力、スリップ検出および制御パラメータに対する各種調整などが挙げられます。
2026-09-04 PATH REPLAYとショートカット経路追従を実装
2026-09-05 失敗事例をリポジトリ内で管理
2026-09-05 Gitマージ失敗事例を記録
2026-09-06 広いコース走行ログと速度設定を記録
2026-09-06 ログ解析環境の失敗事例を更新
2026-09-06 ゴールマーカーを読む回数を3から2に変更
2026-09-26 一次走行のIMU温度補正と実測距離換算をmainへ反映
    CSVメタデータと列名を分離し、新旧ログ読込を両立。IMU位置オフセットを採用値へ更新。ショートカット制御は含めない。
2026-09-26 走行前カウントダウンを3秒にしてIMU校正開始条件を有効化
2026-09-26 ゴールマーカー回数を6周設定に合わせる
2026-09-26 SD設定でオートスタートの走行方式を選択できるようにする
2026-09-26 オートスタート設定とCSV解析のPCテストを追加
2026-09-26 オートスタート設定の運用手順と失敗事例を記録
2026-09-26 ゴールマーカーを読む回数を7から2に変更
2026-09-26 PATH系走行と終端処理をmain仕様へ統合
2026-09-26 shortcut設定の列スケール表記を修正
2026-09-27 一次走行のゴール位置と経路検証を修正
2026-09-27 SLIP解析の再読込とSD待機を改善
2026-09-27 一次経路の閉路判定を60mmへ緩和
2026-09-29 SDログの512B整列書き込みとSkill・失敗事例を統合
2026-09-29 ログ取得間隔を5mmに変更
2026-09-30 ログ列を整理し左右エンコーダ・校正済みラインセンサー・3軸加速度を記録
2026-10-01 機体3Dデータをv3に更新
    [robotrace_v2 v86.step, robotrace_v3.STEP]
2026-10-03 失敗事例の記録方法を更新し、ログビューワーに関する情報を追加
2026-10-03 基板の3Dモデルを追加 機体3Dモデルにsidemarkersensorを追加 main_v2基板を更新
    [robotrace_v2_Sidemarker.step, robotrace_v2_main_v2.kicad_pcb, robotrace_v2_main_v2.step]
2026-10-03 IMU前後オフセットyIの独立検証結果を保存
    [anchor_summary.csv, axle_anchors.csv, extended_curves.csv, extended_summary.csv, extra_checks.csv, gyro_sensitivity.csv, health.csv, individual_optima.csv]
2026-10-03 ローカル検証用testsを管理対象から除外
2026-10-03 走行前校正を待機後の5秒100サンプルへ変更し開始時の積算値をリセット
2026-10-03 IMU温度とXY角速度およびXYZ姿勢角をログへ追加
2026-10-03 ログのXY座標を累積距離と保存済みIMU角度から計算
2026-10-03 BMI088のSPI2通信速度を5.625MHzへ変更
2026-10-03 BMI088のリセット待機と加速度電源設定および設定読戻しを修正
2026-10-03 走行ログの周回ずれとIMUおよびタイヤ速度の段階比較結果を保存
    [12879_recovered_xy.csv, 12880_recovered_xy.csv, 12881_recovered_xy.csv, 12882_recovered_xy.csv, 12883_recovered_xy.csv, 12884_recovered_xy.csv, 12888_components.csv, anchor_rejections.csv]
2026-10-03 IMUとログの現行仕様および検証時の失敗と再発防止策を記録
2026-10-03 実機比較用の割り込み計測と変更前検証手順を追加
2026-10-03 制御演算を単精度へ統一して比較検証を追加
2026-10-03 走行後のELF照合と計測ON版書き込み手順を明確化
2026-10-03 計測ON版の書き込みとUSB再接続復旧を記録
2026-10-03 float化の採用判断と反復計測結果を記録
2026-10-03 UI・描画・設定保存・CSV読取の演算を単精度化
2026-10-03 追加float版の実走行12928～12932を検証記録
2026-10-03 追加float化版の採用判断を記録
2026-10-04 Coreの文字化けコメントを修正
2026-10-04 未使用の角度・距離PIDと関連設定を削除
2026-10-04 連続走行ログをバイナリ保存と終了時CSV一括変換へ変更
2026-10-04 手動走行のタイム表示をCSV変換完了後へ移動
2026-10-04 一括変換後の実走行5本を検証するスクリプトを追加
2026-10-04 走行方式別の配列を共通化してRAMを約37KiB削減
2026-10-04 CSV進捗表示を非同期DMA化して変換待ち時間を短縮
2026-10-04 SDなしでもUI校正後に手動走行を開始できるよう修正
2026-10-04 オートスタート前の旋回校正とライン復帰を追加
2026-10-04 自動校正の重複処理と診断用変数を整理
2026-10-04 全ログ分類と安全な移動計画の適用機能を追加
2026-10-04 .gitignoreの分析ディレクトリ設定を修正し、関連ドキュメントに新しい解析結果を追加
2026-10-07 複数速度ログで時間応答・左右換算差・実効幅を分離検証
2026-10-08 Yaw EKF幾何解析 Phase 1: sensor_geometry.csv
    [sensor_geometry.csv]
2026-10-11 BMI088前後加速度の符号を修正し通常ログに左右電流を追加
2026-10-12 ベンチマークコースを追加しYaw解析の検証記録を更新
2026-10-12 exFATファイルの断片管理初期化漏れを修正しログ復旧を確認
2026-10-13 ラインセンサーADCの取得位相と公開処理を保護し周期欠測での更新停止を修正
2026-10-13 ADC位相競合と周期欠測のホスト回帰テストを追加
2026-10-13 ADC実機検証と旋回ゲイン調整後の完走結果を記録
2026-10-14 IMU接線補正の診断スナップショットを追加
    既存の補正式を維持し、同周期の角加速度・適用済み接線項・有効状態を診断側へ渡す。校正開始とIMU初期化でスナップショットを無効化する。
2026-10-14 スリップSHADOW診断と旧ログ6形式の互換読込を追加
    10/30ms縦残差、横残差、車輪差とジャイロの旋回整合、横接線補正候補を従来制御と独立して記録する。通常72列・詳細87列を使用し、旧バイナリの形式識別と原本保持、長いCSV列名、走行別校正メタデータを整備する。保存済み版2の両窓ANDを維持し、Fast単独化は後続コミットへ分離する。
2026-10-14 縦SHADOW判定を閾値と継続時間を維持してFast単独へ変更
    縦ON・OFFの両窓ANDからLongSlowだけを外し、10/8m/s²・3/5ms・窓・残差計算を維持する。版3とfast_onlyでログを識別し、LongSlowと両窓ピークは診断へ残す。ホスト回帰・4構成ビルドと初回実走13252〜13256の確認を記録する。従来制御へは適用しない。
2026-10-14 ライン校正の旋回速度を-500deg/sへ変更
    既存の未コミット変更を独立して保存し、CALIBRATIONSPEEDの-800から-500への変更にAGENTS.mdの手順を合わせる。復帰・探索・制動条件は維持する。
2026-10-14 走行ログの残差解析と再発防止手順を記録
    旋回過渡・直線加減速の残差を分けて評価した結果と、CAD参照、ログ列名、電流品質、ホスト精度、解析前提、Windows実行環境の注意点を保存する。確認済み対処と実機未解決事項を区別してSkillと失敗記録へ反映する。
2026-10-14 Skill実行前の共通確認と更新時の失敗対策を追加
2026-10-14 ログ解析と制御調整およびハード確認Skillへ再発防止を反映
2026-10-14 SD設定とST-LinkデバッグSkillへ再発防止を反映
2026-10-14 Skill更新方針と全失敗事例の対応表を記録
2026-10-15 ログ処理性能診断とSD転送集計の基盤を追加
2026-10-15 共有ログバッファの先読みとCRC計算を高速化
2026-10-15 CSV出力をまとめて書き込み連続領域を事前確保
2026-10-15 PATHの経路検証と再標本化を統合して走査を削減
2026-10-15 同一連続走行のPATH基準経路をSHORTCUTで再利用
2026-10-15 ログ高速化の保存手順と互換性検証および実機測定を記録
2026-10-15 SD性能検証の失敗記録と書込デバッグ手順へ再発防止を反映
2026-10-15 機体の自動CSV変換を廃止し番号付きbinを保持する
2026-10-15 bin保存とPC側CSV変換の手順および実カード検証を記録
2026-10-15 PC変換と常駐起動の失敗記録および再発防止手順を更新
2026-10-15 ログを自己記述RLOG v2へ移行し旧6形式の読込を廃止
2026-10-15 自己記述ログの実カード検証と移行手順および再発防止を記録
2026-10-15 ログ処理性能診断とSD転送集計の基盤を追加
    (cherry picked from commit 12b87df716be77435e2075cc5eebd70cd26b5a95)
2026-10-15 共有ログバッファの先読みとCRC計算を高速化
    (cherry picked from commit 3016428c95369700da61ba3dff159a47e4917c6b)
2026-10-15 CSV出力をまとめて書き込み連続領域を事前確保
    (cherry picked from commit 9f736b0deba40bb827fc10d37c4edf143a84e9fa)
2026-10-15 PATHの経路検証と再標本化を統合して走査を削減
    (cherry picked from commit 1e2fa524b8fad56ea4c04e725aa6a26ea3c0d79d)
2026-10-15 同一連続走行のPATH基準経路をSHORTCUTで再利用
    (cherry picked from commit af22383541401dd7cd5082d0f65a941234a588b2)
2026-10-15 ログ高速化の保存手順と互換性検証および実機測定を記録
    (cherry picked from commit 2c1773c2b777c3d281de81d40d65b7f1950e64a0)
2026-10-15 SD性能検証の失敗記録と書込デバッグ手順へ再発防止を反映
    (cherry picked from commit 427ee375725cc24224a513f5244a211ab9952ae9)
2026-10-15 機体の自動CSV変換を廃止し番号付きbinを保持する
    (cherry picked from commit 1ed234b6ddff820e8c553ae99834d87e08219ccd)
2026-10-15 bin保存とPC側CSV変換の手順および実カード検証を記録
    (cherry picked from commit 4527377a977336a0e571485ac70149301daecde5)
2026-10-15 PC変換と常駐起動の失敗記録および再発防止手順を更新
    (cherry picked from commit b809f515725b872e98493c12e39f2a500321952e)
2026-10-15 ログを自己記述RLOG v2へ移行し旧6形式の読込を廃止
    (cherry picked from commit 129d24bd78ab9b13e35b984dbaab4780dd118c17)
2026-10-15 自己記述ログの実カード検証と移行手順および再発防止を記録
    (cherry picked from commit 682c9a602d08bdcae311a24d9ceb7a0e78264098)
2026-10-15 mainのログ列を保って校正メタデータと長い列名の保存を統合
2026-10-15 CSV確定の共有違反と実ログ復旧および再発防止を記録
2026-10-17 ログXYを生エンコーダ距離基準へ変更し解析手順を更新
2026-10-17 ログXYを生エンコーダ距離基準へ変更し解析手順を更新
    (cherry picked from commit d0906298110f2da43cabf46e1e7fcd2dea267630)
2026-10-18 手動二次走行の一次参照ログ番号を保存
    有効な距離計画・経路の一次参照を走行開始時に固定し、既存primaryLogNumberへ保存する。手動属性とログ列・レコード長は維持する。
2026-10-18 スリップ評価のXY基準と動画校正条件を明文化
    一次基準のX差と最大Y差±20mmで先行判定し、動画の確実性と走行単位・局所ラベルを分ける。レンズ高680mmと機体マーカー寸法を記録する。
2026-10-18 横候補の時間応答を整合しON閾値6.5を採用
    横候補だけに角加速度と同じ係数0.8のLPFを追加し、ON6.5/OFF4.5・3/5msとする。従来制御・共通IMUは維持する。ON5.2時の実C回帰・4構成ビルドと、6.5時の実走確認・ユーザー採用判断を区別して記録する。6.5への変更後はユーザー指定によりテスト・ビルド未実施。
2026-10-18 ログ解析とビルドの失敗記録と再発防止を更新
    動画の所属・ROI・欠測、XY基準の適格性、途中無効区間、対象系列、共有ヘッダ改行、float比較とメモリ集計の手順を記録しSkillへ反映する。未確定の実機原因はopenを維持する。
2026-10-18 未確定SDログの部分復旧と原本保全手順を記録
    未確定tmpの原本保全・過去断片の識別・仮定付き部分抽出を正常変換と分離する。保存未確定の実機原因は未解決として保持する。
2026-10-21 縦スリップ調査での推測パス再発防止を記録
2026-10-24 スリップ判定をV2へ統一しSLIP走行へ接続
2026-10-24 横スリップログの重複列を削除し有効性列を整理
2026-10-24 横スリップのON閾値6.7を採用し仕様を同期
2026-10-24 スリップ評価の到達点と調査中断時の課題を記録
2026-10-24 SD保存調査とビルド・解析の再発防止手順を記録
2026-10-24 未使用処理を削除しセンサー角度計算の境界を修正
2026-10-24 機体側CSV変換を廃止しバイナリ保存へ統一
2026-10-24 旧CSV読込を廃止し型付きバイナリ解析APIへ統合
2026-10-24 未使用の距離指令引数dCmdをモーター合成APIから削除
2026-10-24 PID調整画面の表示と編集処理を共通化
2026-10-24 速度パラメータの構造体と保存順とUI定義を集約
2026-10-24 SLIPとPATHのメタデータ読込と整数検証を共通化
2026-10-24 整理後の回帰検証と仕様書と再発防止手順を整備
2026-10-25 validationをGit管理対象から外しローカル検証用にする
2026-10-25 未使用APIと旧モードを廃止し左右速度PIDと横スリップ統計を整理
2026-10-25 校正基準と速度メタデータを共通化しbst500初期値を修正
2026-10-25 ログ読込とPATH補助処理の所属を整理
2026-10-25 ログ書込バッファの実装をSDcardへ統合
2026-10-25 Coreのセクション見出しを統一し新規ファイルの規約を追加
2026-10-25 調整パラメータを各モジュールのヘッダへ集約し説明を追加
2026-10-25 ショートカット設定のUI調整とログ記録を追加し画面のちらつきを修正
2026-10-25 スリップログを簡素化し判定フラグ集計と経路診断を追加
    有効性・無効理由・区間統計を保存項目から削除し、SLIP計画を判定フラグの記録件数で集計する。
    横偏差・方位偏差・追従状態と飽和前の操舵3成分をログへ追加し、仕様と実行手順を更新する。
    確認: Debug/Release・通常/詳細の4構成ビルド、保存・CRC・故障注入・PC変換・計画生成回帰。
2026-10-25 PATHとショートカットの経路更新を1ms周期へ変更
    自己位置積分後に経路探索・白線補正・目標更新を毎周期実行し、同じ周期のPIDへ反映する。
    退避・再合流の待ち時間を維持し、既存SD補正係数と補正上限を1ms分へ時間換算する。
    経路制御版を18とし、ログ診断の更新周期、仕様、Skill、検証の再発防止手順を更新する。
    確認: Debug/Release・通常/詳細の4構成、状態遷移・補正換算・保存/CRC/PC変換、ADC割り込み競合回帰。
2026-10-25 経路点の再標本化距離間隔を40mmから20mmに変更
2026-10-26 仮想ラインの曲率に応じたPATH_CURVE走行を追加
2026-10-26 LOG画面で四方式を選択して解析できるよう変更
2026-10-26 PATH_CURVEの周回ずれと動画照合の知見を記録
2026-10-26 全ラインセンサーの完全逸脱で緊急停止するよう変更
2026-10-31 停止後も速度ゼロのモーター制御出力を2秒保持する
    通常ゴールと緊急停止で、平均速度ゼロの初回検出後もPIDの停止出力を2秒継続する。
    HAL_Delayを追加せず、保持後に出力ゼロとログ保存へ進む。
2026-10-31 白線取得を優先し制御フレーム固定と割込み時間計測を追加する
    TIM3とADCの取得をTIM6より優先し、制御中の公開値を固定して完了時に一括公開する。
    計測ON構成へIRQ全体時間・周期保留・ADC更新間隔の診断を追加する。
2026-10-31 白線地図と自己位置融合を導入し旋回フィードフォワードを実速度へ合わせる
    一次走行の白線観測と周期地図を用い、観測信頼度に応じた減速・停止と位置・方位・gyroずれの融合を行う。
    PATH_CURVEの旋回FFを実移動速度と弧長平均曲率に合わせる。
2026-10-31 版21で白線未照合中の再加速を保留する
    PATH_CURVEで有効な白線照合がない間、目標速度の増加を保留する。
    予定減速と照合復帰後の設定加速度による加速、既存停止条件を維持する。
2026-10-31 走行解析と実機検証の記録および再発防止手順を整理する
    動画とログ・保持RAMの照合、実機検証の範囲と未確認事項を記録する。
    既知のツール・解析・デバッグ失敗を再発防止手順へ反映する。
2026-10-31 版21を最終採用として記録し開発環境の参照先を修正する
    ユーザー指定の最終採用を制御21・推定器3・旋回FF2・未照合加速保留1として明記する。
    版22と追加9走を採用対象から外し、実機復元は接続待ちとして記録する。
    ルートを開いた際のCMake参照先を現在のワークスペース内へ修正する。
2026-10-31 PATH解析を35mのコース長に対応
2026-10-31 走行判定パラメータを調整しBIN保存失敗の調査記録を追加
2026-11-01 PATHとSHORTCUTの経路制御をPATH_CURVEと共通化
2026-11-01 PATH_FUSION_MAX_WIDTHの値を6から5に修正
2026-11-01 白線とマーカーの補正診断ログを分離する
2026-11-01 クロス検出区間の前後を速度計画と旋回FFで直線扱いする
2026-11-01 丸め前の経路座標から速度計画の曲率半径を求める
2026-11-01 ゴール確認後に通常ライン追従で減速停止する
2026-11-01 通常停止と緊急停止の保持時間を1秒へ短縮する
2026-11-01 走行ログ調査の記録と実行前確認手順を更新する
2026-11-01 経路走行に先行減速を追加しビルドを2構成に統一する
2026-11-01 速度目標を16bit化して直線加速時の折り返しを修正する
2026-11-01 ログ解析の再発防止に関する文書を追加し、バッテリー電圧のLPF係数を調整パラメータとして定義を更新。緊急停止処理概要のコメントを修正。
2026-11-01 走行ログを方式別に分離し計画ROCによるゲイン切替へ変更する
    - 一次・DISTANCE・SLIPへライン診断を追加し、PATH系の専用列と保存・読込形式を分離する
    - DISTANCE/SLIPのゲイン切替を計画ROCだけで判定し、ログへ切替方式版を記録する
    - 左右速度PIDの起動時・UI編集時のゲイン同期を修正し、左右輪速度目標の上限を約5m/sへ更新する
    - 開始カウントダウンを3秒、校正開始を2秒後とし、IMU校正取得を10ms間隔へ短縮する
    - 運用仕様、ログ診断の説明、解析・検証の再発防止手順を更新する
    検証: 現在の全ソースでDebug/Releaseの全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
2026-11-01 ショートカットの変位上限を50mmにし大変位区間の再採用を防ぐ
2026-11-01 一次曲率で速度を変えるSHORTCUT_CURVE走行を追加
2026-11-01 ログ解析・検索の再発防止手順とプル競合の記録を追加
2026-11-01 走行前解析に円環アニメーションと秒単位の経過時間を追加
2026-11-02 解析画面の開始終了時にDMA転送元と描画順序を保護
2026-11-02 ショートカット解析の不成立候補と不変線分の重複検査を削減
2026-11-02 11月1日の全一次33本でショートカット高速化の計画一致を検証
2026-11-02 PATH解析の経路容量を拡張しロード画面の表示条件を修正
2026-11-02 PATH系ログに停止後の計画XY保存を追加
    既存XYの列位置を維持し、計画経路XYだけを停止後にまとめて補完する。一次XYの保存・再読込・専用保持配列は設けず、CRC検証を維持する。
    保存仕様、検証手順、走行ログ解析と失敗事例の記録を更新する。Debug・Releaseビルドと通常・詳細形式の保存検証を確認済み。
2026-11-02 解析中のローディングアニメーションを滑らかに更新
2026-11-02 高速直線の角速度正規化をDISTANCEログ14本で検証
2026-11-02 走行モード別に速度・ラインPIDと速度FFゲインを分離
2026-11-03 計画ROCの平滑化とログ出力を追加
    大半径区間の計画曲率を対称平均し、急旋回と経路端を保護する。
    filteredROC_mmを保存して現在位置の計画半径を確認できるようにし、14102の初回実ログ確認を記録する。
    ライン角速度目標の速度倍率上限と、マーカーなし進捗補正案・検証手順・再発防止文書を含める。
    Debug/Releaseビルド、通常・詳細の実writer/reader・全CRC・既存列一致を確認済み。
    14102の実C再生成照合と元bin全CRCは未実施。
2026-11-03 白線履歴による経路進捗補正とSD診断ログを追加
    PATH系のslip診断列を除外し、初回実走の診断結果を記録する。
